awong-dev/pager/firmware/README.md

# School Pager Firmware

ESP-IDF 5.x project for the Walter device (ESP32-S3 + Sequans LTE-M modem).

**Status (8 Oct 2026): firmware v1.1.0 runs on the bench pager `sora1` (Soracom SIM).** Tag `v1.1.0`
was cut 8 Oct 2026 (the version string is `git describe`, so a tagged build reports `v1.1.0` and a
later commit `v1.1.0-N-g<sha>`); the release image is published to the OTA bucket. `rc1` runs a beta-82
build. What is measured and what is still an
estimate is tracked in `docs/HARDWARE_TESTING.md` ("Seen working on hardware" and "Not yet seen
working"). A `PENDING_HW` marker in the code means an estimate that has not been measured on a device.
See the measurement checklists and "Residual risks" section below before flashing a real device.
`docs/PROTOCOL.md` §12 has two still-open protocol decisions
(broker free-tier verification, LWT/clean-session) that aren't firmware bugs but do affect what
`net.cpp` can promise.

## Hardware

Rewired 30 Sep 2026; CardKB moved to IO5/IO4 on 3 Oct 2026; right header reworked 5 Oct 2026
(CardKB SDA/SCL IO10/IO9; wake button moved from IO1 to IO8) and again 8 Oct 2026 (button
hardware removed; LIS3DH moved to SCL IO18 / SDA IO17 / INT1 IO16). `main/pins.h` is the single
source of truth for every GPIO below;
nothing else in the firmware hardcodes a pin.

| Part | Role | Interface / power |
|---|---|---|
| Walter module (DPTechnics) | ESP32-S3-WROOM-1-N16R2 + Sequans GM02SP LTE-M modem + GNSS | — |
| Adafruit eInk Breakout Friend, panel Orient Display AES128296A00-2.9ENRS (SSD1680-compatible, 296×128; replaced the GDEY029T94-FT01 on 4 Oct 2026; partial-waveform OTP unverified, see HARDWARE_TESTING.md) | E-paper display | SPI via the GPIO matrix, 4 MHz: SCK IO2, MISO IO42, MOSI IO41, ECS IO40, D/C IO39, RST IO13, BUSY IO11; SRCS IO38 held high (SRAM unused); SDCS not wired. ENA IO12 is the Friend's regulator enable (active-high, pulled up on the Friend): low = panel unpowered. Friend VIN from the power board's always-on "3V" rail, not Walter VIN or Walter 3V3-OUT. |
| M5Stack CardKB | Keyboard | I2C_NUM_0 addr 0x5F, SDA IO10 / SCL IO9, scanned by the `kbd` task every 10 ms (see "Keyboard task" below). VCC from Walter's own switched 3V3-OUT (header pin 26, gated by IO0), so it switches with the attentive window independently of the display. |
| Adafruit LIS3DH breakout | Motion wake | I2C_NUM_1 addr 0x18 (SDO/SA0 open), SDA IO17 / SCL IO18; INT1 → IO16 (push-pull, active-high, 3.3 V, the only ext1 wake). VIN from the power board's always-on "3V" rail (not gated by any Walter GPIO), so it stays alive through every rail_off() and every light sleep/reset. |
| Push button (REMOVED 8 Oct 2026; disabled in firmware since 6 Oct, `PAGER_WAKE_BUTTON_ENABLED 0`; the shake replaces it) | — | No hardware. IO8 (header pin 23) is free. |
| Adafruit 6092 (bq25185 + TLV62569) power board + 3.7 V 2500 mAh LiPo (Adafruit 328) | Power | Board "4.5V" (SYS) → Walter VIN; board always-on "3V" buck → Friend VIN + LIS3DH VIN |

### Carrier v0.2

`hardware/carrier` replaces the breakouts. The firmware detects it at boot from the accelerometer
WHO_AM_I (0x33 breadboard, 0x11 carrier; `board` console command, NVS `board`/`kind` overrides).
Pins that differ (full design: `docs/CARRIER_V02_FIRMWARE_DESIGN.md`):

| Pin | Breadboard | Carrier v0.2 |
|---|---|---|
| IO12 | Friend ENA (display regulator) | FL_PWM (front light, high = on) |
| IO38 | Friend SRAM CS, held high | CHG_STAT1 (BQ25185, open-drain input) |
| IO42 | Friend MISO | CHG_STAT2 (input) |
| IO8 | free | EXT_LED (high = on) |
| IO4 | free | FL_BTN (active-low) |
| IO6 / IO7 | free | PIEZ_P / PIEZ_N |
| IO15 | free | VBUS_DET (high = USB present) |
| I2C | CardKB @0x5F (I2C_NUM_0), LIS3DH @0x18 (I2C_NUM_1) | adds DRV2605L @0x5A (I2C_NUM_0, gated), MAX17048 @0x36 (I2C_NUM_1); accel is a LIS2DW12 clone |
| Console | USB-Serial/JTAG | UART0 IO43/IO44 via CP2102N (see Build) |

### Walter header map

Top view, USB-C at the top, datasheet pin numbers. Left column is the display side, right column
is the input side.

```
                                        ┌─────── USB-C ───────┐
                  (unused)  RESET   1 ──┤                     ├── 28  VIN      ◄── power board SYS (4.5V) out
                  (unused)  IO44    2 ──┤                     ├── 27  GND      ◄── common ground (Friend, CardKB, LIS3DH, power board)
                  (unused)  IO43    3 ──┤                     ├── 26  3V3-OUT  ──► CardKB VCC (switched by IO0)
       CardKB supply gate  IO0     4 ──┤                     ├── 25  IO10     ◄─► CardKB SDA
                Friend ENA  IO12    5 ──┤                     ├── 24  IO9      ──► CardKB SCL
               Friend BUSY  IO11    6 ──┤                     ├── 23  IO8      (unused; button removed 8 Oct)
                Friend RST  IO13    7 ──┤        Walter       ├── 22  IO18     ──► LIS3DH SCL
               Friend SRCS  IO38    8 ──┤      (top view)     ├── 21  IO17     ◄─► LIS3DH SDA
                Friend D/C  IO39    9 ──┤                     ├── 20  IO16     ◄── LIS3DH INT1
                Friend ECS  IO40   10 ──┤                     ├── 19  IO15     (unused)
               Friend MOSI  IO41   11 ──┤                     ├── 18  IO7      (unused)
               Friend MISO  IO42   12 ──┤                     ├── 17  IO6      (unused)
                Friend SCK  IO2    13 ──┤                     ├── 16  IO5      (unused)
                  (unused)  IO1    14 ──┤                     ├── 15  IO4      (unused)
                                        └────────┤ SIM ├────────┘

   Off-board wires:  power board 3V ──► Friend VIN, LIS3DH VIN (always on)
                     all GNDs to Walter GND; no capacitors on the distribution board
```

Per-peripheral view of the same wiring:

| eInk Friend pin | Walter pin | | CardKB (Grove) | Walter pin | | LIS3DH breakout | Walter pin |
|---|---|---|---|---|---|---|---|
| VIN | power board 3V (off-board, always on) | | VCC | 26 3V3-OUT | | VIN | power board 3V (off-board, always on) |
| GND | 27 GND | | GND | 27 GND | | GND | 27 GND |
| ENA | 5 IO12 | | SDA | 25 IO10 | | SDA | 21 IO17 |
| SCK | 13 IO2 | | SCL | 24 IO9 | | SCL | 22 IO18 |
| MISO | 12 IO42 | | | | | INT1 | 20 IO16 |
| MOSI | 11 IO41 | | | | | SDO/SA0 | open (addr 0x18) |
| ECS | 10 IO40 | | | | | | |
| D/C | 9 IO39 | | | | | | |
| SRCS | 8 IO38 | | | | | | |
| SDCS | — | | | | | | |
| RST | 7 IO13 | | | | | | |
| BUSY | 6 IO11 | | | | | | |

Walter-internal, never available: IO14/IO48 (modem UART RX/TX), IO21/IO47 (RTS/CTS), IO45
(modem reset), IO46 (LTE_WAKE0), IO19/IO20 (USB), IO3 (strapping, testpoint only). IO44/IO43 are
UART0 and unused (the console is USB Serial/JTAG).

### Power domains

- **Power board always-on "3V".** The Adafruit 6092 (bq25185 + TLV62569) power board's buck
  output feeds the eInk Friend's VIN and the LIS3DH breakout's VIN directly, off-board, never
  gated by any Walter GPIO. Neither loses power across an ESP32 reset or any light sleep;
  `accel_init()` still re-programs the LIS3DH every boot (a chip-side reset, not a supply one).
  The board's "4.5V" (SYS) output feeds Walter VIN itself.
- **Walter 3V3-OUT (header pin 26, switched by IO0) and the Friend's ENA (IO12) — two gates,
  one rail.** `rail.c`'s `rail_on()`/`rail_off()` drive both together: IO0 switches the CardKB's
  VCC, ENA switches the Friend's MIC5225-3.3 regulator, which powers the panel only. Both are off
  outside the attentive window; the CardKB reboots on every rail-on (hence ui.c's boot guard) and
  the panel RAM is restored from the shadow frame by `disp_note_power_loss()`. Before dropping
  either gate the firmware drives the CardKB SDA/SCL and the display SPI pads low so the ESP32
  never back-feeds the unpowered parts.
- **USB power.** Walter ties USB-C VBUS to VIN, so VIN is 5 V on the bench (in place of the power
  board's SYS output). Nothing downstream of the Friend/LIS3DH/CardKB gates is referenced to VIN
  any more.

## Device behaviour contract

These are the project's fixed constraints. `docs/PROTOCOL.md` is authoritative for anything that
crosses the wire; this section covers the device-local behaviour the protocol doc does not specify.

- **SIM budget**: 100 MB/month data, 100 SMS/month. The pager sends SMS only through the modem path
  (`cfg.sms`, `sms.c`), which the US Mobile line did not carry (7 Oct 2026); the Soracom preset refuses
  it. Relay SMS runs through the family's bridge phone on the server, not on the pager (Twilio removed 9 Oct 2026, last at 05ec3ed). It keeps one
  persistent TLS+MQTT session and never reconnects on a timer.
- **Power**: the device sleeps most of the day. In **sleep mode** the modem uses eDRX (target
  20.48 s cycle) and the ESP32 light-sleeps; delivery within ~30 s is acceptable. In **active
  mode** the modem stays connected and messages must show within 5 s.
- **Modes**: boot in sleep mode. Enter active mode on an incoming message or a shake plus a key (the IO8 button was retired 6 Oct 2026); leave
  it after 10 minutes with no keyboard activity. The 10-minute timeout runs from mode
  *entry*, not from the last activity. The CardKB is read by the `kbd` task
  (see "Keyboard task" below), not by the main loop.
- **Display refresh**: partial refresh for the message pane. Full refreshes come from the refresh
  policy (`refreshpol.c`), not from a fixed count. Its defaults, relaxed 7 Oct 2026, are a floor of
  40 partials, an 8 s idle gap, a ceiling of 120 partials and a pre-sleep minimum of 6 (`refreshpol.h`).
- **Display orientation**: `disp_flip` (NVS, default off; console `flip on|off|status`, or the
  Device screen's "Rotate display" row)
  180-degree-rotates the whole 296x128 image at blit time, so every screen/partial/toast reads
  upside down together — not a per-screen setting.
- **Message bodies** are at most 160 characters.
- The vendored `walter-modem` component is patched only as recorded in its `PATCHES.md`. Anything the
  vendor API cannot express is either worked around in our own code or documented as a limitation.

## Carrier and bearer

The SIM picks a carrier preset (`firmware/main/carrier.c`, `carrier_effective()`), by IMSI prefix,
ICCID prefix or EF_GID1. A preset gives the APN, PDP credentials, the bearer and whether modem SMS
may be sent.

- **US Mobile Dark Star** and the other existing presets: bearer `direct`, no PDP auth.
- **Soracom** (`soracom.io`): matched by IMSI prefix `311588` or ICCID prefix `8942310`. PAP user
  `sora`, password `sora`, sent as `AT+CGAUTH=1,1,"sora","sora"` after `definePDPContext`. Bearer
  `beam`; modem SMS is refused.
- **`direct`**: TLS from the modem to the bundle's host and port, as before.
- **`beam`**: plain MQTT to `beam.soracom.io:1883`; Soracom Beam opens the TLS leg to EMQX. The
  bundle's host, port and CA URL are ignored, `/status` reports `tls: "proxy"`, and CA pushes are
  refused. See `docs/SORACOM_DESIGN.md` §3.

Verified on the bench 8 Oct 2026 on the `sora1` unit, on both bearers. Direct: PAP attach with roaming
on 310410 in about 17 s, eDRX granted, provisioning direct. Beam: plain MQTT to `beam.soracom.io:1883`,
session usable 17.4 s after boot, provisioning through Beam. Results: `docs/SORACOM_DESIGN.md` §6.

Console: `bearer [auto|direct|beam]` (NVS `carrier/bearer`) overrides the bearer for A/B tests. The
override is read at boot. `carrier` shows what was detected and what is in force. Gotchas are in
`docs/GOTCHAS.md`.

## Dependencies

- ESP-IDF 5.x
- `dptechnics/walter-modem` v1.5.0, vendored in `components/dptechnics__walter-modem/` (upstream
  commit `51b16ce`) with local patches 1.1-1.22 listed in that directory's `PATCHES.md`. Do not re-sync
  from upstream without re-reading the vendor source and re-applying the patches (each is marked
  `// PAGER PATCH:`). Two separate conclusions in `docs/PROTOCOL.md` turned out to depend on which
  version was actually checked out.
- Display driver (SSD1680): custom, in-tree (`main/ui.c`) — no external component. See
  `docs/PROTOCOL.md` §6 for why (the one registry candidate found requires a newer ESP-IDF than
  this project builds against).

## Hardware Acceptance Tests

- Sleep-mode current: PENDING_HW
- Acceptance test (message latency): PENDING_HW
- Full list of what to check on first hardware bring-up: the measurement checklists below (M1-M23)
  and the "Residual risks" section's cheapest-experiment column, roughly in priority order.

## Keyboard task (`kbd`, 9 Oct 2026)

The CardKB is scanned by a static FreeRTOS task, `kbd` (`ui.c`; priority 2, floating across both cores). It
polls every 10 ms while the keyboard rail is on and past the 1300 ms boot guard. While the rail is
off it blocks on a rail notification. The task is the only CardKB read path: `ui_poll_keyboard()`
and the refresh-time poll hook are deleted, and the main loop does not touch the CardKB. Keys go
to the input queue (`input.c`, 32 deep). A queue-full drop logs at WARN. Design and review
history: `docs/TASK_kbtask.md`. Why the main loop must not read the CardKB: `docs/GOTCHAS.md`.

- **Console:** `i2cscan` and `kbtime` pause the task and resume it after. `i2cscan swap` re-inits
  the bus only with the rail on.
- **Light sleep:** the task is parked around `esp_light_sleep_start()`, so a sleep never starts in
  the middle of an I2C read.
- **Main loop wake (10 Oct 2026):** the awake loop's 100 ms wait is `input_wait_event(100)`
  (`input.c`): a task-notification wait on the `modes_run()` task that `push_event()` signals after
  every successful enqueue, so a keystroke is seen at once; with nothing happening the period is
  still 100 ms. At the sleep edge `net_sleep()` parks `kbd`, then returns false (no sleep, no
  wake/RTS state touched; modes.c re-arms the awake window and loops) if `input_pending()`.
- **Wake status refresh (10 Oct 2026):** `ui_wake_status_refresh()` (two modem round trips) is
  deferred: the awake edge sets `s_wake_status_pending`, and `modes_run()` runs it right after that
  pass's `ui_render()`. The refreshed battery/RSSI show on the next partial.
- **Status:** built 9 Oct 2026. Burst verification is **pending** (the bench check below). On the
  bench unit sora1, the CardKB currently does not answer at 0x5F (`docs/GOTCHAS.md`), so no
  keystroke result from sora1 counts until that is fixed.

**Bench: keyboard burst test.** The owner types `abcdefgh` fast, three times in each scenario, on
each flash (the baseline, then the new build). Capture the `ui: CardKB: 0x..` DEBUG lines
(0x61-0x68):

- A. screen awake, idle chat;
- B. right after a shake, starting at the first draw (keys typed during the 1.3 s boot guard are
  lost on both builds, because the CardKB is still booting);
- C. within 2 s of sending a message.

Expected on the new build: 8 of 8 in A, B and C, and no `input event queue full` lines. The
baseline is expected to drop about the first and last keys in B and C. Also expect `kbd: task
started` at boot, `kbd: paused (rail off)` after about 120 s idle, and `kbd: boot guard` then
`kbd: polling` about 1300 ms after a shake.

## Measurement checklist: network and power (PENDING_HW unless a row says resolved)

These rows were written before any device was attached. A row marked **Resolved** has a bench result
in the handoff or the design docs. The other rows are still a number `net.cpp`/`modes.c` either
assumes or logs enough to compute, not yet measured. See `docs/PROTOCOL.md` §6.5, §8.2-§8.4 for the
arithmetic these numbers feed.

| # | What to measure | Why it matters |
|---|---|---|
| M1 | Sleep-mode average current, `T`=5s | Validates the ~1.8-2.1 mA / 43-50 mAh/day estimate (§8.4) |
| M2 | Per-wake awake time / current | Validates the ~50 ms, ~40 mA assumptions behind §8.2's `I_light(T)` model |
| M3 | End-to-end latency: `send.py` timestamp -> serial log line | Validates the 27.3 s (sleep) / 4.3 s (active) worst-case budget (§6.5) |
| M4 | Granted eDRX/PTW from `WALTER_MODEM_NETWORK_EVENT_EDRX_RECEIVED` | Assert granted eDRX == requested `"0010"` (20.48s); logged by `net.cpp`'s network event handler, and now confirmed on a real SIM and carrier. **Resolved 8 Oct 2026:** granted on AT&T 310410 (Soracom SIM on `sora1`): `+CEDRXRDP: 4,"0010","0010","0001"` (`docs/SORACOM_DESIGN.md` §6 B). |
| M5 | RTS hold-off: does the Sequans queue URCs while CTS is deasserted, or drop them? | The single riskiest assumption in the whole sleep design (§8.3); `net_sleep()`'s RTS choreography was unverified end to end. **Resolved 23-24 Sep 2026:** the modem queues URCs while CTS is deasserted and releases them only when the host speaks (23 Sep 17:50). The RTS pin was excluded from light-sleep pad isolation (`gpio_sleep_sel_dis()`, ab5927c); a `sleeptest 3` window then delivered a page 9 s after the relay stamped it, and the release build acked through sleep. See `docs/SLEEP_URC_DESIGN.md` §1 and `docs/RCA_SLEEP_URC.md`. |
| M6 | `MEMORY_FULL` event count over 24h | Direct evidence the wake-and-drain cycle is losing messages; counted in RTC (`mqtt_memfull_count`) but never exercised against real traffic |
| M7 | Does the modem send PINGREQ autonomously at the configured keepalive? | **Resolved on the wire 14-15 Oct 2026** (`PINGREQ.md`): yes, at 60-1200 s. AT&T silently drops idle flows between 240 and 360 s, so a longer keepalive's PINGREQ never arrives there |
| M8 | Clean-session behaviour across an ESP32-only reset (modem session survives?) | PROTOCOL.md §12 item 4 - the highest-value follow-up experiment; unresolved and load-bearing for whether §8.3(b) (deep sleep + forced redelivery) is ever worth revisiting |
| M16 | I²C CardKB polling (the `kbd` task in `ui.c`, which feeds `input_feed_key()`, F6.2) across repeated 100 ms light-sleep cycles | `DEVICE_PLAN.md` §10's own open assumption: whether the CardKB and its I2C bus survive `net_sleep()`'s light-sleep re-entry without a dropped or garbled byte while the composer is open. The plan's own cheapest experiment is "one afternoon with M1's current trace" |
| M17 | UI-awake window current draw (active mode, composer open, CardKB scanned every 10 ms by the `kbd` task, `PAGER_UI_AWAKE_S`=30s) | Validates `DEVICE_PLAN.md` §5.7's ≈ 7 mAh/day-at-20-interactions estimate and the "one more AT round trip per UI wake (signal + battery), ≈ 100 ms at 40 mA" it is built on |
| M18 | `bars_from_rssi_dbm()` bucket thresholds (`ui.c`: dBm ≥ -85/-95/-105/-115 → 4/3/2/1/0 bars) against a real cell | The dBm conversion itself is settled in source (F3.4: `WalterModem::getRSSI()`/AT+CSQ, `dBm = -113 + raw*2`, `raw==99` guarded off as "no reading" — `net.cpp`'s `net_get_rssi()`); the bucket boundaries chosen for the status-bar icon are engineering estimates that have never been seen against a live signal |
| M19 | `segs_from_batt_mv()` LiPo threshold calibration (`ui.c`: 4000/3850/3700/3550 mV → 4/3/2/1/0 segments) | `DEVICE_PLAN.md` §10: these thresholds were picked, not derived from a real discharge curve under the device's own load; pairs with M15's voltage-reading check |

Also unresolved and not measurable without hardware: whether the modem/broker silently clamp
a 1800s MQTT keepalive, and whether the carrier's NAT tolerates a 1800s idle TCP flow
(PROTOCOL.md §6.2). Partly measured since (`PINGREQ.md`, 15 Oct 2026): AT&T drops an idle flow
between 240 and 360 s; Soracom direct holds ≥1800 s; a 1200 s clamp through
Beam/EMQX is still open.

## Measurement checklist: display and input (PENDING_HW unless a row says resolved)

Same rule as above. The panel has been driven on the glass since 22 Sep 2026 (see
`docs/HARDWARE_TESTING.md`); the rows here are left as written.

| # | What to measure | Why it matters |
|---|---|---|
| M9 | DejaVu Sans / Noto Sans CJK SC legibility on the actual panel, at 12 px and 16 px | F6.1 replaced the earlier hand-authored 5x7 font with real pre-rasterised Noto Sans + Noto Sans CJK SC glyphs (`tools/mkassets.py`) at both sizes, packed into a 597,128-byte (583 KiB) `assets.bin` — comfortably under the 1 MiB `assets` partition (`partitions.csv`) — and already rendered to PNG on the host (`make png`) for eyeballing, but never seen on the actual e-paper panel. `DEVICE_PLAN.md` §10 flags 12 px CJK specifically as the assumption to check first ("Host-side PNG first, then M9 on glass; the fallback is 14 px for `normal`"). Separately, and not a panel-legibility question: `mkassets.py`'s own docstring notes its CJK glyph selection uses code-point order as a frequency stand-in (no offline GB2312 frequency table was available), so a few common hanzi are expected to render as tofu regardless of how legible the font itself is — don't conflate the two failure modes when reading the first photograph. **Update 2026-09-24 (TASK_ui_finish.md Do #2):** the Latin/Greek/Cyrillic face is now DejaVu Sans, not Noto Sans (`tools/fonts/dejavu/`, `build/images/assets-dejavu.bin`, 598,261 bytes) — this M9 row's own "never seen on the actual panel" caveat now applies to DejaVu specifically, not just CJK; the CJK face itself is unchanged. **Update 12 Oct 2026:** an emoji-capable asset-only variant is `build/images/assets-dejavu-emoji.bin` (DejaVu symbols + 3 aliases + Noto Emoji `tools/fonts/notoemoji/` wght 600 at 10/13 px + zero-width ZWJ/VS/skin-tone blanks; same format, works with the published app); build with `python3 tools/mkassets.py --lang sc --sans-font tools/fonts/dejavu/DejaVuSans.ttf --cjk-font ~/Library/Fonts/NotoSansCJK.ttc --emoji-font tools/fonts/notoemoji/NotoEmoji-wght.ttf --emoji-axes "wght=600" --emoji-px "12=10,16=13" --baseline "12=13,16=18" -o build/images/assets-dejavu-emoji.bin`, test sheet via `make emoji_png ASSETS=<image>` (not yet seen on the panel). |
| M10 | SSD1680 `0x22` display-update-control-2 values (`0xF7` full, `0xFF` partial) | Carried forward from PROTOCOL.md §6 as "inferred, not verified from the datasheet PDF" — this firmware transcribes them unchanged and adds no independent verification. |
| M11 | BUSY pin polarity (assumed active-high) | `ui.c`'s `disp_wait_busy()` assumes BUSY=1 means busy, a common but unconfirmed SSD1680 breakout convention for this exact panel. If wrong, every refresh will either return immediately (garbage on screen) or hit the 15s timeout and mark the display dead every boot. |
| M12 | SSD1680 partial-refresh RAM continuity across a VCC_EN power cycle | `ui.c` deliberately keeps `PAGER_PIN_DISP_VCC_EN` enabled continuously after `ui_init()` rather than gating it off between every refresh (PROTOCOL.md §8.4's "~0 mA between refreshes" assumption), because power-cycling the panel would very likely wipe the controller's internal old/new RAM planes that partial refresh diffs against — this could not be confirmed against a datasheet. The real display-domain current is therefore higher than §8.4's "~0 mA" figure by an unquantified amount until this is measured. |
| M13 | CardKB byte stream during real typing, including arrow keys and a held key | Confirms `input_decode_key()`'s table (F6.2, exhaustively host-tested over 0x00-0xFF in `firmware/host/test_input.c` but never against real hardware): `0x00`=no key, `0x20`-`0x7E`=printable, `0x08`=backspace, `0x09`=tab, `0x0D`=enter, `0x1B`=esc, and — the two `DEVICE_PLAN.md` §10 rows this line exists to settle — arrow codes `0xB4`/`0xB5`/`0xB6`/`0xB7`=left/up/down/right, and whether the CardKB holds the last key until read (the "key held until read" assumption that would enable key-to-wake; `input.h`'s `input_feed_key()` entry point for this is written but not yet called from anywhere, pending this measurement). Also separately confirms PROTOCOL.md §9.4's own open assumption that the CardKB never emits multi-byte sequences. |
| M14 | Partial-refresh timing per the 20-partial/1-full cadence | Confirms the 20-partial cadence (see "Device behaviour contract" above) doesn't visibly ghost/degrade the panel before the scheduled full refresh, and feeds PROTOCOL.md §6.5's M7 (partial refresh must complete in <1.5s). |
| M15 | `getVoltage()`/`AT+SQNVMON` reading vs. a multimeter across the actual battery | PROTOCOL.md §12 item 6: `net_get_battery_mv()` now publishes a real reading in `/status`'s `batt_mv`, inferred from Walter's public schematics to track `VBAT` rather than a fixed regulated rail, but never confirmed against real hardware. 5-minute check on first bring-up. |
| M20 | Typing ~50 mixed characters on the CardKB, timed against a stopwatch | `DEVICE_PLAN.md` §10: is this acceptable to a non-developer? First bring-up check; if not, revisit the input design (the Wi-Fi portal fallback is withdrawn; Wi-Fi removed, owner 16 Oct 2026). |

## Measurement checklist: firmware timing and storage (PENDING_HW unless a row says resolved)

Same rule as above. None of these three has a recorded bench result (the M21 figure is host-CPU only).
They come from `DEVICE_PLAN.md` §10 rows
that explicitly call for a device-side timing measurement (as opposed to the CPU-speed/host-only
numbers already available, cited below for comparison).

| # | What to measure | Why it matters |
|---|---|---|
| M21 | PBKDF2-HMAC-SHA256 timing on the actual ESP32-S3, 10 000 iterations (`lock.c`'s `lock_pbkdf2()`, via `mbedtls_pkcs5_pbkdf2_hmac_ext`) | `DEVICE_PLAN.md` §10 estimates ≈ 50-100 ms on the S3. The only number measured so far is **20.5 ms for 10 000 iterations on the host CPU** (F6.5, `firmware/host/test_lock.c`'s `test_pbkdf2_round_trip_and_timing()`, printed as `PBKDF2 (10000 iterations, host CPU): %.1f ms`) — this is explicitly a host-CPU number, not the S3's (no hardware crypto acceleration assumed, different core), and must not be read as an on-device result. Adjust the iteration count to land near 100 ms once the real number is in, per §10's own instruction. |
| M22 | NVS blob write time for a 320-byte blob (`msg.c`'s `msgq` namespace, full-fidelity reply/unread bodies moved off RTC in F6.4) | `DEVICE_PLAN.md` §10: must complete well under the 100 ms composer poll and never block the modem event task (it runs on the main task either way, so a slow write is a composer-lag bug, not a crash). No host-side substitute exists — NVS write timing is real-flash-dependent. |
| M23 | `esp_partition_mmap()` boot-time cost for the `assets` partition (`gfx.c`'s `gfx_init()`) | Static facts are already known and require no hardware: the partition is 1 MiB (`partitions.csv`, `0x100000`) and the real payload is 597,128 bytes (583 KiB, F6.1's `assets.bin`), so there is no size-fit risk. `gfx.c`'s own comment claims the mmap "draws no additional current and reads nothing until a glyph is blitted" — that is a design argument, not a measurement. What is still unmeasured: the actual wall-clock cost of the `esp_partition_mmap()` call itself at boot, and whether mapping ~583 KiB of flash consumes MMU page-table capacity the app's own IROM/DROM mappings need (two 2 MiB OTA slots already share that budget). |

## Build

Set up ESP-IDF, then:

```bash
idf.py build
```

Two images exist because the ESP-IDF REPL is bound to one console device at compile time
(`esp_console_new_repl_usb_serial_jtag` needs `CONFIG_ESP_CONSOLE_USB_SERIAL_JTAG`,
`esp_console_new_repl_uart` needs `CONFIG_ESP_CONSOLE_UART_DEFAULT`). The breadboard build above
uses the Walter's USB-JTAG port; the carrier v0.2 build uses UART0 (the carrier's CP2102N):

```bash
idf.py -B build-carrier -DSDKCONFIG=build-carrier/sdkconfig -DSDKCONFIG_DEFAULTS="sdkconfig.defaults;sdkconfig.carrier" build
```

`-DSDKCONFIG=build-carrier/sdkconfig` keeps the carrier's generated config out of the shared
`firmware/sdkconfig`; without it the carrier build silently reuses the breadboard config and the
UART0 console is not applied.

The board (breadboard vs carrier) is chosen at runtime, not by the image (`board` console command).

## Residual risks

A design review against `net.cpp` / `modes.c` / `msg.c` / `ui.c` as committed.
Build verified clean on `espressif/idf:release-v5.2` (`idf.py set-target esp32s3 && idf.py build`,
exit 0, only the vendor's own Kconfig style warning). `sizeof(pager_rtc_t)` = **928 B** from
`build/school_pager.map` (`.rtc.data.0` under `libmain.a`), inside the 1184 B ceiling of
PROTOCOL.md §9.1; the `_Static_assert` at `modes.c:138` is present and passing. `T` = 5 s sleep /
2 s active (`modes.c:45-46`), post-wake yield 50 ms ≥ the 30 ms floor (`modes.c:47`), keepalive
1800 s, eDRX `"0010"`/`"0001"`, PSM disabled, cert slot 12 / TLS profile 2 — all match the doc.

**This list was written against source before any hardware was attached.** It is reasoning, not
measurement, and it is not updated item by item. Check `.overnight-handoff.md` and
`docs/HARDWARE_TESTING.md` before acting on one. Ranked by risk to battery life and message latency, as written.

### Already fixed (both rebuilt clean)
- `net.cpp` + `net.h` + `modes.c`: `net_modem_busy()` interlock. `_eventProcessingTask` is
  priority 4 and `modes_run()` is priority 1, so every time the MQTT event handler blocks
  (`mqttReceive()`'s AT round trip, `ui.c`'s 10 ms `disp_wait_busy()` poll) `modes_run()` is
  scheduled and could call `esp_light_sleep_start()` — forcing RTS high *mid-response* instead of
  at an idle moment. That turns M5 ("does the Sequans queue or drop when CTS is deasserted") from
  a latency question into a message-loss one, on essentially every inbound message. `skip_sleep`
  now includes `net_modem_busy()`. Cost ≈ 0.02 mAh per message of 40 mA busy-polling (estimate).
- `modes.c:345-356` `on_incoming_message()`: copy `out->id` before rendering. `out` points into
  `msg.c`'s `s_thread`, which `thread_insert_locked()` memmoves; a reply submitted from the main
  task during the render would have made the `shown` ack carry the reply's `u_...` id.

### R1 — F4 hard-resets the modem on loss of *coverage*, not just on a wedged modem (battery, data, latency)
`net_check()` (`net.cpp:484-493`) returns false both when `checkComm()` fails **and** when the
registration state is not HOME/ROAMING. `run_modem_health_check()` (`modes.c:444-474`) treats that
as "modem unresponsive" and calls `net_recover_modem()` → `WalterModem::reset()` → full re-attach
→ new ~5 kB TLS handshake. A student indoors in a dead zone therefore gets a modem hard reset
every 10 minutes (the rate limit), each one destroying the persistent session the SIM budget
requires us to protect. Spec for the fix: `net_check()` should report *comm* only; add a separate
`net_is_registered()`; F4 resets only on `checkComm()` failure, and a registration loss is simply
waited out (the modem re-attaches on its own) with a counter in `/status`. Cheapest check: no
hardware needed — put the device in a Faraday bag / pull the antenna and watch for `modem_resets`
climbing in the serial log.

### R2 — a held or stuck button busy-polls at full power indefinitely (battery)

**Moot as of 8 Oct 2026:** the button hardware was removed, and `PAGER_WAKE_BUTTON_ENABLED` has been 0 since 6 Oct 2026, so the button cannot be held. Kept for the record.

`BTN_HELD` (`modes.c:585-589`) only exits when the button is released, and `modes_run()`'s
`skip_sleep` keeps `net_sleep()` out for as long as the FSM is not IDLE (`modes.c:704`). There is
no tickless idle in `sdkconfig.defaults`, so that is ~40 mA continuously: a button wedged in a
backpack flattens a 1500 mAh cell in roughly 1.5 days. (A worse version of this — a
level-triggered ext1 wake spinning `esp_light_sleep_start()` — is already fixed; the held-button
case is still a full-power loop.) It also makes the F4 health check fire every ~1.2 s instead of every
5 min, because that check counts wake cycles, not time (`modes.c:771-774`). Fix spec: add a
`BTN_STUCK` state entered after ~5 s in `BTN_HELD`, and a `net_sleep()` variant that arms the
button's ext1 wake on the release level (low, since the 3 Oct 2026 rewiring made the button
active-high) so the device can light-sleep while the button is down.
Cheapest check: tape the button down and watch the serial log's wake-cycle counter rate.

### R3 — display VCC is never gated off, and the panel is never put to sleep (battery)
`ui_shutdown()` (`ui.c:573`) is the only caller of `disp_power_off()` and **has no call site
anywhere in the firmware** — so the panel's VCC gate (now the eInk Friend's ENA on IO12; IO15 at the time) is driven on at `ui_init()` and stays on forever, and the
SSD1680 never receives its `0x10` deep-sleep command in normal operation. `ui.c:228-235`'s own
comment claims the rail is "gated off between refreshes", and PROTOCOL.md §8.4 budgets the display
at "~0 mA" on that basis. M12 already records the deliberate reason (a VCC cycle would wipe the
controller RAM planes that partial refresh diffs against), so this is a known trade, not a
surprise — but the size of the penalty is still unknown and it sits directly on the 1.8-2.1 mA
budget. Mitigating evidence: both `0x22` update sequences (`0xF7` full, `0xFF` partial) have the
disable-analog/disable-clock bits set, so the booster and oscillator should stop after each
refresh, leaving only standby leakage. Cheapest check: M1's current trace with the panel attached
vs. detached — one measurement answers it. If it is material, the fix is to issue `0x10`/`0x01`
(deep sleep mode 1) after each refresh and hardware-reset + re-init before the next, keeping VCC
on; only re-verify that the RAM planes survive it.

### R4 — `ui.c` has no cross-task mutual exclusion (crash / corrupt display)
`ui_render_thread()` / `ui_render_message_pane()` / `ui_show_toast()` run on **two** tasks:
`_eventProcessingTask` via `on_incoming_message()` (`modes.c:363`) and `modes_run()`'s task via the
button FSM, composer and toasts. They share `s_fb_new`/`s_fb_old`/`s_partial_count` and one
`spi_device_handle_t` with no lock (`ui.c:48-55`). A render is preemptible at every
`disp_wait_busy()` `vTaskDelay`, so two renders can interleave their SSD1680 command streams. The
likely trigger is exactly the common case: a message arrives while the student is pressing the
button. Expect a garbled panel or an SPI driver abort. Fix spec: one static mutex in `ui.c` taken
by every public entry point (never held across a call back into `msg.c`/`modes.c`).

### R5 — a message render occupies the modem's event task for 0.3-1.5 s, or up to 30 s if BUSY hangs (latency, message loss)
`on_incoming_message()` runs on `_eventProcessingTask` and synchronously does a full e-paper
refresh (`modes.c:363` → `ui.c:591`). While it runs, no other MQTT event is dispatched:
`_DISCONNECTED` edges are delayed, and further `_MESSAGE` events queue in the modem — which is
what `MEMORY_FULL` (M6) reports. Worst case, with a mis-wired BUSY pin (M11), each refresh path
burns two 15 s timeouts plus a re-init before `mark_display_dead()` latches, i.e. ~30 s of dead
event task for the first message. Fix spec: hand the render to `modes_run()` via a flag
(`s_render_pending`), leave the event handler doing ingest + dedup only, and move the
`msg_mark_shown()` call to after the render on the main task — which also preserves §4's
"ack only after BUSY deasserts". Cheapest check: log `esp_timer` deltas around
`ui_render_message_pane()` and around the handler; M7/M14 collect the same numbers.

### R6 — `msg_thread_at()` / `msg_newest_unread()` return unlocked pointers into a ring that moves (wrong-id ack, garbled render)
`msg.c:635-652` are the only accessors that do **not** take the lock that `msg.h`'s header comment
says guards `s_thread`, and they hand out raw `msg_t*`. `ui.c`'s `render_thread_frame()`
(`ui.c:440-466`) dereferences them across a multi-hundred-millisecond render, and
`button_action_short()` (`modes.c:531`) copies an id out of one, while the event task can memmove
the whole ring under both. Worst outcome is a `read` ack for the wrong id; most likely outcome is
one garbled line on screen. Fix spec: take the lock inside those accessors and return a
caller-supplied *copy*, not a pointer.

### R7 — `shown` is acked even when nothing was shown (false delivery reporting)
If `ui_init()` failed or a BUSY timeout latched `s_display_dead`, `ui_render_message_pane()`
returns immediately (`ui.c:593-595`) and `modes.c` still calls `msg_mark_shown()`. The parent is
then told the student saw a message that was never rendered — PROTOCOL.md §4 defines `shown` as
"after the e-paper refresh completes (BUSY deasserted), never before". Running headless is
correct; lying about `shown` is not. Options, none free: suppress the `shown` ack
while headless (the relay then re-publishes forever), or add a `disp` field to `/status` (a schema
change, so it needs an owner). Decide before a parent relies on the delivered state.

### R8 — retained `/status` is **not settable** from `walter-modem` v1.5.0 (parent-visible staleness)
`WalterModem::mqttPublish()` emits `AT+SQNSMQTTPUBLISH=0,<topic>,<qos>,<len>`
(`src/proto/WalterMQTT.cpp:97-103`) — there is no retain argument anywhere in the public API.
PROTOCOL.md §2 and §5 mark `/status` **retained = true (fixed)**, and §5.3 keys the relay's
behaviour on "a retained `offline`". §12 item 3 currently lists only LWT and clean session as
unreachable; **retain is a third one and should be added to it.** Consequence today: after a relay
restart the parent UI has no device state until the next event-driven publish or the ≤3600 s
heartbeat (§5.4d) — and the heartbeat is suppressed entirely while the device has no network clock
(`modes.c:253-256`), which is also the case where the device is least healthy. Cheapest check:
30 minutes with the Sequans AT manual, same session as §12 item 3's raw-`AT+SQNSMQTTCFG`
experiment for the LWT; if the AT command has a retain field, both are fixable via `sendCmd()`.

### R9 — a full refresh can land inside the message-delivery path (latency)
`set_mode()` → `ui_render_thread()` → `refresh_cadence()` (`ui.c:402-409`) does a **full** refresh
every 20th partial, and the sleep→active edge caused by an incoming message goes through exactly
that path (`modes.c:357`). PROTOCOL.md §6.5 budgets 0.5-1.5 s for the refresh against 2.7 s of
total margin; a 296x128 SSD1680 full refresh is typically 2-4 s at room temperature and colder at
a bus stop in winter. Sleep-mode worst case then lands at ~30-32 s, i.e. outside target. Also note
`ui_render_message_pane()` calls `partial_refresh()` directly and bypasses the cadence check, so
the full refresh tends to fire from whichever path happens to be a message. M7/M14 measure the two
refresh times; if the full refresh exceeds ~1.5 s, defer it (e.g. run it on the active→sleep
transition, never on the inbound path).

### R10 — `msg_pump()` can drop a `read` ack it raced with, and "published" is not "PUBACK'd" (ack loss)
`msg_pump()` (`msg.c:549-576`) drops the lock across `publish_ack()` and then clears `a->in_use`.
If `msg_mark_read()` upserted the same slot during that window (student presses the button while
the `shown` ack is in flight), the upgrade to `read` is silently discarded and the thread stays at
`shown` forever. Separately, and already documented at `msg.c:538-545`: `net_publish()` returning
true means the library accepted the call, not that a PUBACK arrived, so §4.1 rule 6's
"3 attempts then drop" retry counts attempts that may never have reached the broker. Fix spec for
the first: re-read the slot's `state` after re-acquiring the lock and only clear `in_use` if it
still matches what was published.

### R11 — ext1 pull-down across light sleep is unverified (battery, phantom presses)
The button pull-down is configured digitally (`input_init()`, `input.c`) but ext1 wake keeps
the RTC peripheral domain powered and reads the pad through RTC IO, whose own pull settings
default to off. If the digital pull-down is not in force during light sleep and there is no
external pull-down on IO8, the pin floats and the device wakes constantly (battery) with phantom
short presses (UX). I am not certain either way for light sleep on the ESP32-S3 and will not guess.
Cheapest check: log `esp_sleep_get_wakeup_cause()` after every `net_sleep()` and count non-timer
wakes over an idle hour; if it is real, the fix is one `rtc_gpio_pullup_en()` call, no GPIO change.

### R12 — the RX path mallocs (message loss under fragmentation)
`msg_ingest_down()` parses with cJSON (`msg.c:231`) on the event task. PROTOCOL.md §3.3's stated
reason for the 640-byte cap is that "the device never mallocs on the RX path"; it does. Low
probability on a 512 kB part, but the failure mode is silent (parse fails → counted as malformed →
message never acked, never rendered). Cheapest check: log the heap low-water mark in the `/status`
heartbeat and watch it over a 24 h soak.

### R13 — a boot that fails to attach has no retry path of its own (battery, availability)
`modes_boot()` increments `g_rtc.attach_fail_cycles` on a failed `net_init()` (`modes.c:638`) and
**nothing ever reads it again**; `modes_run()` only ever retries `net_session_up()`. A device
powered on out of coverage recovers only via R1's modem-reset path — the most expensive action in
the design — and only in sleep mode. Fix spec: retry `net_init()` on the F1 backoff schedule
before ever escalating to a reset, and delete or use the dead counter.

### R14 — `net_init()` / `net_recover_modem()` block the whole loop for up to 300 s (availability)
The attach wait (`net.cpp:350-362`) is a 300 s `vTaskDelay` loop on the caller's task. Called from
`run_modem_health_check()` it stalls `modes_run()`: no button FSM, no composer polling, no
`msg_pump()`, no light sleep for up to five minutes. The student sees a dead pager and 40 mA.
Cheapest check: falls out of R1's Faraday-bag test.

### R15 — F4 never runs in active mode, and counts cycles rather than time
`modes.c:771-774` gates the health check on `mode == SLEEP`, so a modem that wedges during an
active window is not noticed for up to 10 minutes, and the "every 60 wakes" period varies from
5 min (sleep) to 2 min (active) to ~1.2 s (R2's stuck button). Prefer a monotonic timestamp.
Low impact on its own; listed because it interacts with R1 and R2.

### `NEEDS HUMAN DECISION` items, current as of the last commit
- **§12 item 3 (LWT + clean session + retained `/status` not settable): still open.** Nothing
  worked around any of the three; `net.cpp` registers no will and passes no session flag, because
  the API has neither. All three would be settled (or not) by the same look at the Sequans AT
  manual plus the `sendCmd()` fallback PROTOCOL.md §12 already proposes.
- **§12 item 6 (battery voltage): resolved, one experiment remains.** `net.cpp` now reads the
  modem's own `AT+SQNVMON` supply-rail voltage via `WalterModem::getVoltage()` and reports it as
  `batt_mv` (`modes.c`'s `build_status_json()`), with a last-known-good fallback so a failed AT
  round trip never blocks a `/status` publish. This needed no GPIO change — see PROTOCOL.md §12
  item 6 for the schematic-based reasoning that this rail tracks the battery, not a fixed 3.3V
  rail. **Still open**: that reasoning is inference from Walter's public schematics, not a
  confirmed fact about Walter's own unpublished internal routing — compare `getVoltage()`'s reading
  against a multimeter on first hardware bring-up (5 min, M15 in the checklist above).
- **§12 item 2 (broker free-tier limits): overtaken by production, not re-checked.** Production runs on
  EMQX Cloud Serverless (`infra/README.md` §10), and the firmware keepalive is 480 s, 1200 s on the
  Soracom preset (`carrier.c`, PROTOCOL.md §6.2). Whether the free tier gives QoS 1 both ways, a retained topic and a
  persistent session is not recorded in the sources; confirm before relying on it.
