awong-dev/pager/docs/V02_DESIGN.md

# v0.2: modem library, replay counter, CA trust, location, device SMS

The specification of what v0.2 added, cited by section number from the code. For the big picture
read `OVERVIEW.md`; for what has been seen working on hardware, `HARDWARE_TESTING.md`; for what is
missing, `ROADMAP.md`. Where this differs from `PROTOCOL.md` or `DEVICE_PLAN.md` it records an
owner decision, and those documents have been edited to match.

Conventions: `UNVERIFIED` means "could not be tested on hardware while writing this; the code must
fail safe and log clearly". Hardware facts are for the Sequans GM02SP `LR8.2.1.0-61488`.

## 0. Ground rules

- Nothing here may break the receive path: attach → TLS → MQTT → verify → render →
  ack. Every new feature fails *open* for paging: if location, SMS or a CA push goes wrong, pages
  still arrive.
- The relay must keep accepting a v0.1 pager (no new field is required from the device; unknown
  `/status` fields from a newer device must not make an older relay reject the envelope, so **add
  the relay's acceptance of new fields before any firmware that sends them is flashed**).
- All new device→relay and relay→device messages are signed like every other envelope.
- New CBOR keys are allocated in §7 and nowhere else.

## 1. Vendored modem library

`dptechnics/walter-modem` v1.5.0 moves from the component manager (`managed_components/`,
git-ignored, hash-checked, cannot be patched) to a tracked local component,
`firmware/components/dptechnics__walter-modem/` (`src/`, `CMakeLists.txt`, `Kconfig`, `LICENSE`,
`README.md`, `CHANGELOG.md`; **no `examples/`**). The DPTechnics 5-clause licence permits
modified source redistribution with the notice retained and use restricted to Walter boards; keep
`LICENSE` and every file header. Remove the dependency from `main/idf_component.yml`, add the
component to `main`'s `REQUIRES`, delete `dependencies.lock` entries for it. Add
`firmware/components/dptechnics__walter-modem/PATCHES.md` listing every local change, each marked
with a `// PAGER PATCH:` comment in the source, so a future upstream update can re-apply them.

Patches:

1. **NULL command crash.** In `_processModemRSP()` after `after_processing_logic:`, never call
   `_finishModemCMD(NULL, ...)`. With no command pending, free the buffer and return.
2. **Receive bounds.** Wherever a response is copied into `cmd->payload`
   (`memcpy(cmd->payload, rspStr, cmd->payloadSize)` and siblings), copy at most the bytes
   actually present in the `WalterModemBuffer` and never more than `payloadSize`. `mqttReceive()`
   and `socketReceive` must not claim more than was delivered. If a payload larger than one
   buffer cannot be reassembled, fail the command cleanly.
3. **TLS profile range.** Kconfig `WALTER_MODEM_MAX_TLS_PROFILES`: allow up to 6 (the modem's real
   limit, `spId` 1-6). Profile 1 stays BlueCherry's, 2 is MQTT, **3 is the CA fetch** (§4.4).
4. **SMS** (§6): `smsSend()`, an SMS event handler for `+CMTI`, `smsRead()`, `smsDelete()`.

## 2. Firmware bug fixes

1. **Render queue.** `s_render_pending` (`modes.c`) is a single slot; a burst overwrites it and the
   earlier messages are never marked `shown`. After a successful `ui_incoming()` render, mark
   **every** `MSG_ACK_UNSHOWN` down message `shown` (`msg_mark_all_unshown()` already exists for
   the unlock path). The pending-ack queue is 8 deep (`MSG_PENDING_ACKS_MAX`); acks that do not
   fit must be retried on later cycles, not lost: keep marking until none are `UNSHOWN`.
2. **Epoch copy.** `ident_store()` must update the in-memory `s_ident` on success, so
   `ident_get_n_epoch()` is current immediately after a bump.
3. **Connect watchdog.** A connect that produces neither CONNECTED nor DISCONNECTED within 60 s:
   `mqttDisconnect()`, count it, back off as a transient failure. Three in a row:
   `net_recover_modem()`. This engine can wedge silently.
4. **Empty CA slot.** `UNVERIFIED` whether the MQTT engine does TLS when the named slot is empty.
   Make it not matter: when no CA is pinned, make sure slot 12 holds *a* certificate. Embed ISRG
   Root X2 (790 bytes PEM, public, EC, long-lived) in the firmware as a placeholder; on
   `net_init()` and in the bootstrap path, if nothing has been written this power session and the
   slot is not known to hold a cert, write the placeholder. It is never validated against
   (validation is off in that mode). One NVRAM write per device lifetime in practice: remember in
   NVS (`ident` namespace, key `slot12`) that the slot is populated.
5. **Oversize receive.** With patch 1.2, a `/down` or boot message larger than the library can
   deliver is logged at INFO with its size and counted as oversize; it must not corrupt memory.
6. **Log what is dropped.** "malformed down message dropped" becomes INFO (it was DEBUG and cost
   an evening). Include the length and first byte.
7. Keep `nettest`, `mqtttest`, the setup-stage logging and `PAGER_DEBUG_NO_LIGHT_SLEEP`. Add, in
   that debug build only, the console REPL in **normal** mode too (its own task, 16 kB stack), so
   diagnostics can run on a provisioned pager without erasing its identity. New debug commands:
   `gnsstest <seconds>`, `cafetch <url> <sha256hex>`, `smstest <number> <text>`.

## 3. Replay counter: keep it, widen the epoch (owner question, decided)

Question from the owner: is the counter needed at all, given TLS, and given that 4096 cold boots
is a realistic lifetime with a flaky battery?

- TLS covers only pager↔broker, and only when the server is authenticated. §4 makes that
  authentication optional and adds a deliberate fallback to *no* validation, so TLS cannot be the
  replay defence. The HMAC exists because the broker is a third party and the webhook is a shared
  secret; the counter is what stops that same party (or an on-path attacker during a fallback)
  replaying an old signed "come to the office now" page. The relay dedups `/up` by message id for
  ever, so `/up` replays are already harmless; the exposure is `/down`, where the pager's dedup
  ring is 16 ids in RTC memory and is lost on a cold boot.
- So the counter stays, but its failure mode must not be "pager silently dead". The 12-bit epoch
  was exactly that: guaranteed exhaustion.

**Change:** `n = (epoch << 20) | lo` stays, `lo` stays 20 bits, **`epoch` becomes 32 bits** and `n`
becomes a 52-bit unsigned integer (< 2^53, exact in JSON and in a Firestore int64). 4 billion cold
boots. CBOR encodes it at minimal length, so nothing grows until the epoch passes 4095.

- Firmware: `n` is `uint64_t` end to end on the up path (`auth_next_up_n`, signing, CBOR writer).
  `ident_t.n_epoch` becomes `uint32_t`; NVS key `n_epoch` (u16) is read for migration, the value
  is then kept in a new key `n_epoch32` (u32). On a wrap of `lo`, or on a cold boot, bump and
  persist (already implemented for u16). The down path may stay `uint32_t` internally (the relay's
  `downN` counts by one) but must *parse* a uint64 without rejecting it.
- Relay: `wire.py` accepts `0 <= n < 2**53`; the window code already uses Python ints; Firestore
  `upN` is an int64. `tools/authvectors.json` gains vectors with `n` above 2^32, and
  `pager_client.py` and the firmware host test consume them.
- `PROTOCOL.md` §3.1 (`n` row) and §14 (counter text) and `DEVICE_PLAN.md` §2.5 edited to match.
- Still parked: the signed resync handshake (`DEVICE_PLAN.md` §2.5 note). With a 32-bit epoch it
  is only needed if NVS itself is lost, and then the identity is gone too.

## 4. CA trust

### 4.1 Trust states (firmware)

`unpinned` (no CA in the identity; validation off) · `pinned` (CA set, last connect validated) ·
`broken` (CA set, validation failed, running with validation off). `broken` is one byte in NVS
(`ident` namespace, key `tls_broken`), cleared only by a connect that validates.

### 4.2 Fallback

On `NET_MQTT_RC_TLS_FAIL` while `pinned`: one more validated attempt, then reconfigure profile 2
with validation **off, slot 12 still named**, enter `broken`, connect. While `broken`, the first
connect after each 24 h boundary (and the first after a cold boot) is attempted validated; success
returns to `pinned`. `-8` also fires for non-certificate handshake failures, so the UI text is
"server not verified", never "attack".

### 4.3 Reporting

- `/status` gains optional `tls` (`unpinned`/`pinned`/`broken`) and `ca_fp` (first 16 hex chars of
  the SHA-256 of the pinned CA PEM, absent when unpinned).
- Pager status bar: a padlock icon when `pinned`, a **broken padlock** when `broken`, nothing when
  `unpinned`. Two new 12×12 icons in `gfx` (follow the existing icon mechanism in `gfx.h`).
- Relay: persist both on `devices/{id}`; log `SECURITY tls-broken device=…` on the transition into
  `broken`. Web: a chip per device on *Admin → Devices* (pinned / not verified / unpinned, plus
  `ca_fp`), tolerant of the fields being absent.

### 4.4 CA delivery: a pointer, fetched and hash-checked

The CA never travels inline again (a Let's Encrypt or Google root does not fit the modem
library's 1540-byte buffer; see `GOTCHAS.md`).

- **Relay** serves `GET /ca/{sha256hex}.pem`, public, no auth, `text/plain`, immutable cache
  headers, 404 unless the hash is one it knows. It knows the CA from `BROKER_CA_PEM`, else from
  `ca_resolve.get_broker_ca_pem()` (wire that resolver in at last), and keeps every CA it has
  ever served in Firestore `cas/{sha256hex}` so an old pointer keeps resolving. The public base
  URL comes from a new setting `PUBLIC_BASE_URL` (Terraform: the Cloud Run service URL).
- **Bootstrap bundle** carries `ca_url` + `ca_sha` instead of `ca` (both absent = unpinned). The
  firmware still accepts an inline `ca` (a v0.1-era bundle), preferring the pointer.
- **Push:** `/down` `kind:"cfg"` with `cfg.ca = {url, sha}`; `url` = `""` means un-pin. Admin-only
  `POST /api/admin/devices/{id}/ca` with body `{"action": "push"|"unpin"}`; like `cfg.lock`, only
  the newest unacked cfg is re-published.
- **Fetch (firmware, `cafetch.c`)**: a TLS socket on **TLS profile 3** (validation off, slot 12
  named), `GET <path> HTTP/1.1` with `Host` and `Connection: close`, read in ≤1500-byte chunks,
  follow no redirects, cap the body at 4096 bytes, require status 200, verify SHA-256 with
  mbedtls, require the body to contain exactly one PEM certificate. Trust comes from the hash,
  which arrived signed (or inside the encrypted bundle), so the transport needs no authentication.
  `UNVERIFIED`: a second socket while the MQTT session is up.
- **Apply, two-phase**: write the new CA to **slot 13**, disconnect, point profile 2 at slot 13
  with validation on, connect. CONNECTED within the watchdog → commit (`ident_store` the PEM and
  hash, copy to slot 12, state `pinned`, ack the cfg `shown`). Anything else → restore the
  previous profile and state, reconnect, **do not ack** (the relay re-publishes on the next online
  edge; after 3 failed applies of the same `sha` the pager acks it anyway and logs, so a bad CA
  cannot loop for ever). Un-pin: clear the identity's CA, validation off, state `unpinned`, ack.
- Setup uses the same fetch, over the bootstrap attach, before the identity is stored. A fetch
  failure during setup fails setup with "cannot reach broker" (never silently unpinned).

## 5. Location

Request-driven, short, always backed off. Owner guidance: the pager spends many hours a day inside
a building with no sky; even one attempt an hour is wasted there without evidence of movement; a
failed or wrong fix is an acceptable answer; battery matters more.

- **Dispatch**: `kind:"loc_req"` intercepted in `on_incoming_message()` after signature
  verification, before `msg_ingest_down_cbor()`; answered regardless of lock state; never a thread
  entry; never `shown`/`read`-acked. Works identically in sleep and active mode (it is just a
  `/down` message; do not switch the mode to active for it and do not wake the display).
- **Answer on `/loc`** exactly per `PROTOCOL.md` §13.2, signed, QoS 1, id `l_` + 8 hex.
- **Attempt budget**: `LOC_ATTEMPT_S = 20` normally; `LOC_FIRST_ATTEMPT_S = 40` for the first
  attempt after a cold boot or after assistance data was refreshed (no ephemeris in the receiver
  yet). Never longer. One attempt in flight; requests arriving meanwhile share its result.
- **Backoff**: after a failed attempt no new attempt is allowed for `backoff`: **5 min, doubling,
  capped at 12 h** (5, 10, 20, 40, 80, 160, 320, 640, 720 min). Reset to zero by a successful
  fix. A request inside the backoff is answered at once, without powering GNSS: the last fix with
  `cached:true` if one exists from this power session, else `loc:null, err:"no_fix"`. Worst case
  for a pager left in a drawer: about nine attempts on day one, then two a day, 20 s each.
- **Triggers that reset the backoff** (they never start an attempt by themselves):
  1. *Tracking-area or cell change* reported in `+CEREG` (the library's network event). Debounce:
     ignore changes within 10 min of the last one, because a stationary indoor modem flaps
     between cells.
  2. *Sustained motion* from the LIS3DH (I2C 0x18, INT1 on IO2): motion interrupts spanning at
     least 60 s within a 3 min window. Probe the chip at boot; if it is absent (it may not be
     wired yet) log once and run without it. Configure its low-power 10 Hz mode with the
     interrupt on a high-pass threshold; the ESP32 wakes on IO2 via `ext1` alongside the button's
     `ext0`.
  3. *Charger/USB power present*, if detectable: skip.
  A reset puts the backoff at zero but leaves a **floor of 10 min since the last attempt**, so a
  child walking between classrooms all day cannot turn every request into an attempt.
- **Battery floor**: below 3.55 V (LiPo, `batt_mv`), never power GNSS; answer cached/`no_fix`.
- **Route to the radio: in place only** (owner decision, 26 Sep 2026,
  `LOCATION_TRACKING_DESIGN.md`): ask for a fix while attached, in the eDRX idle gap, through the
  library `gnss*` API. **Any failure** — `LTE_CONCURRENCY` refusal, timeout, no fix, confidence
  > 100, failed assistance refresh — ends the attempt and produces a cell answer
  (`loc:null, err:"no_fix", cell`); there is no second route and no retry. The `CFUN=4` window
  (route 2) is removed: it left the pager unreachable ~2.5 min per fix. A PSM window stays rejected
  (`LOCATION_TRACKING_DESIGN.md` §8).
- **Assistance (mandatory)**: before any attempt, if the last refresh is ≥ 2 h old or
  `gnssGetAssistanceStatus()` says it is due, `gnssUpdateAssistance()` first, while connected. A
  failed refresh is a failed attempt. The refresh counts inside `PROTOCOL.md` §13.3 item 2's 60 s.
  Log the bytes it costs.
- **Accept only a good fix**: confidence ≤ 100 (the vendor demo's threshold); map it to `acc`.
- **`/status`**: `loc_min_s` = 600 (the floor), `loc_period_s` = 0 (no unsolicited fixes), and new
  `loc_backoff_s` = seconds until the next attempt is allowed (0 = now). With location tracking on
  (`LOCATION_TRACKING_DESIGN.md`), `loc_period_s` = 3600 (the maximum gap between unsolicited cell
  reports) and `loc_move_s` = the GNSS-while-moving interval (600, 0 = off).
- **Relay/protocol**: §13.3 item 1 is amended: the device's window is the growing backoff above,
  reported in `/status`; the relay's own mirrored 60 s rule is unchanged. `tools/pager_client.py`
  answers `loc_req` the same way (a `--loc lat,lon` option, else `no_fix`) so the e2e suite covers
  the lifecycle. On a `no_fix` answer the pager sends its serving cell (PROTOCOL.md §13.2, envelope
  key 49 `cell`), and the relay resolves it to a coarse position via pluggable geolocation (Google
  Geolocation API or OpenCelliD), stored as a fix with `src: "cell"`. This gives a coarse answer
  indoors; GNSS improves accuracy outdoors but is not the only source.

## 6. Device-direct SMS

Owner decision (2026-09-20): the pager may send and receive SMS directly through the modem, to a
**parent-managed allow-list of phone numbers**, as a delivery path that does not depend on the
relay. This reverses `PROTOCOL.md` §7.3's "no device-side SMS path"; edit it.

- **Who controls the list**: only the device's owner (or an admin), through Family → Contacts and the member's approved list. The pager has
  no UI to add, edit or remove a number. Max 8 entries `{name ≤ 16 chars, phone E.164}`.
  Stored on `devices/{id}.smsContacts`; delivered as `/down` `cfg` with `cfg.sms = [{n, p}, …]`
  (whole list each time, newest-wins, acked `shown` on apply). The pager keeps it in NVS.
- **Sending**: SMS contacts appear in the recipient picker and as `@name` in the composer, tagged
  `sms`. A message to one goes out with `smsSend()`; GSM 7-bit when every character is in the
  basic alphabet (≤160), otherwise UCS-2 (≤70 characters; the composer shows the tighter limit).
  No concatenated SMS. The thread entry shows `sent` / `FAILED` like any other reply.
- **Receiving**: `+CMTI` → read, delete from the SIM, then: sender on the list → insert into the
  thread as from that contact and alert like any message; sender not on the list → **never
  shown**, logged as `blocked`.
- **Audit, non-negotiable**: every SMS in either direction, including blocked ones, produces a
  signed `/up` envelope `kind:"sms_log"` with `id` (`s_` + 8 hex), `ts`, `peer` (E.164), `dir`
  (`out`/`in`), `st` (`sent`/`failed`/`recv`/`blocked`), `body`, `sms_ts`. QoS 1. If the pager is
  offline it is queued in NVS (same durability as an unsent reply, at least 16 entries, oldest
  dropped last resort with a counter reported in `/status`) and sent when the session is back. An
  SMS is **sent first, logged second**: the point of this path is that it works without the relay.
- **Relay**: `sms_log` is stored under `devices/{id}/smsLog/{logId}` (dedup on id), is not routed
  to anyone and is not a thread entry. Owner/admin API: `GET /api/devices/{id}/sms-log`,
  `GET/PUT /api/devices/{id}/sms-contacts` (PUT validates E.164, max 8, pushes the cfg).
  Firestore rules: readable by the device's owner and admins only.
- **Web**: on the device's page, an *SMS contacts* editor and an *SMS log* table (time, direction,
  number/name, status, text), blocked entries highlighted.
- **Owner decision 7 Oct 2026:** this is the only SMS path; the relay has no SMS backend. The list is
  derived, not hand-edited: the member's approved Family → Contacts plus, for an `open`/`any_sms`
  member, every family contact (max 8, by name). Contact names are unique per family because the
  pager matches by name. *(8 Oct 2026: this modem path now serves members without a relay SMS number; `cfg.sms` is pushed empty for members with a relay number who send/receive through it instead.)*
- `UNVERIFIED`: SMS on the production SIM at all (a Google Fi data-only SIM may not carry SMS);
  the modem's `+CMTI` behaviour under eDRX; text-mode UCS-2 on this firmware. `smstest` exists to
  find out. Everything fails safe: an SMS that cannot be sent is a `FAILED` thread entry plus an
  `sms_log` with `st:"failed"`.

**Malformed uploads leave a trail.** If a signature-verified `sms_log` from a registered, non-revoked device cannot be stored normally (the envelope does not decode, or a field such as `peer`/`dir`/`st`/`id`/`body` is invalid), the relay still writes `smsLog/bad_<sha256(unsigned)[:12]>` (deterministic, so a retry does not duplicate) with `malformed:true`, `reason`, `ts` (relay receive time), `rawHex` (unsigned bytes, capped at 512) and best-effort `peer`/`dir`/`st`/`msgId` pulled from the raw bytes; `body` is null. For undecodable payloads this applies only when the bytes contain `sms_log`. `GET /api/devices/{id}/sms-log` returns these rows with `malformed:true` and `reason`/`rawHex` (normal rows: `malformed:false`); `dir`/`peer`/`st`/`body` may be null on a flagged row.

## 7. Wire additions (the only place new keys are allocated)

Envelope keys:

| Key | Name | Type | Where |
|---|---|---|---|
| 39 | `tls` | tstr | `/status` |
| 40 | `ca_url` | tstr | bootstrap bundle |
| 41 | `ca_sha` | bstr(32) | bootstrap bundle |
| 42 | `ca_fp` | tstr(16) | `/status` |
| 43 | `loc_backoff_s` | int | `/status` |
| 44 | `peer` | tstr | `/up` `sms_log` |
| 45 | `dir` | tstr | `/up` `sms_log` |
| 46 | `st` | tstr | `/up` `sms_log` |
| 47 | `sms_ts` | int | `/up` `sms_log` |
| 48 | `sms_lost` | int | `/status` (audit entries dropped, normally 0) |
| 50 | `link` | int | `/status` (MQTT-session generation within a boot — §9.5; key 49 is `cell`) |
| 60 | `why` | tstr | `/loc`, unsolicited only: `still`/`cell`/`move`/`gnss`/`stop` (`LOCATION_TRACKING_DESIGN.md` §3; keys 51–59 are allocated in `PROTOCOL.md` §10) |
| 61 | `loc_move_s` | int | `/status` (GNSS-while-moving interval, 0 = off) |

`kind` gains `sms_log` (`/up`). `cfg` sub-map: `lock=0` (existing), **`ca=1`** `{url=0 tstr,
sha=1 bstr(32)}`, **`sms=2`** array of `{n=0 tstr name, p=1 tstr phone}`. In JSON the same names
are used; `ca_sha`/`sha` are base64url without padding, like `sig`.

`n` (key 12): uint, now up to 2^53-1 (§3).

## 8. Verification

- Firmware: `make -C firmware/host test` (add tests: counter ≥ 2^32 vectors, location backoff with
  a fake clock, SMS GSM-7/UCS-2 encoding and allow-list, CA fetch HTTP parsing and hash check,
  trust-state transitions, cfg `ca`/`sms` decode). `idf.py build` clean in both normal and
  `PAGER_DEBUG_NO_LIGHT_SLEEP` configurations.
- Relay: `pytest` (emulators), ruff; new tests for every new route and ingest kind; e2e scenarios
  `locate`, `ca_push`, `sms_log` with `pager_client.py`.
- Web: `npm run build`, lint.
- Hardware, by a person: everything marked `UNVERIFIED`, using the debug console.

## 9. Session liveness: the modem sends no PINGREQ (corrected 15 Oct 2026, see §9.1)

### 9.1 The finding (measured 2026-09-21, AT&T via US Mobile Dark Star)

> **Correction (15 Oct 2026, `PINGREQ.md`).** The modem does send PINGREQ at the keepalive. Idle
> probe sessions (modem `UE8.2.1.0`, eDRX, light sleep) against a capture broker: on AT&T it pinged
> at 60 and 240 s; at 360 s (twice) and 480 s no PINGREQ reached the broker and the capture showed
> the flow already dead (close_notify retransmitted, no ACK, no RST). On Soracom direct it pinged on
> the same connection at 360, 600, 900, 1200 and 1800 s. So the 21 Sep result below is
> real, but its cause is AT&T's network silently dropping idle TCP flows somewhere in 240–360 s,
> before the 480 s ping; the modem gets no RST and raises no URC. Item 1's 10–13 min "second
> killer" is the same cut. Items 2–4 stand. The host re-SUBSCRIBE (§9.2) stays the only liveness
> check, now with per-carrier timing.

`AT+SQNSMQTTCONNECT`'s fourth argument is documented as "Maximum period (in seconds) allowed
between communications with the broker. If no other messages are being exchanged, this parameter
controls the rate at which the client sends ping messages to the broker" (Monarch 2 AT manual,
`AT+SQNSMQTTCONNECT`). **On `LR8.2.1.0-61488` it does not.** Three consecutive idle sessions with
`keepalive=480` (confirmed negotiated by the broker) sent **no PINGREQ at the 8-minute mark**:
EMQX's `recv_pkt` for the client stayed at 1 (the CONNECT) for the whole session
(`build/bench-logs/r2-keepalive-poll.log`, sessions starting `02:35:20Z`, `02:51:37Z`,
`03:09:47Z`; polled every 30 s). The one `recv_pkt` 1→2 step was the device's own hourly
`/status` heartbeat, not a ping — it came with `recv_msg` 0→1, `recv_oct` +143 (a 113-byte
PUBLISH) and a 4-byte reply (PUBACK); a SUBSCRIBE would be ~28 octets with `recv_msg` unchanged
and a 5-byte SUBACK.

Consequences, in order of severity:

1. **Two independent killers of an idle flow.** The broker drops the client at 1.5 × keepalive
   (720 s; measured 12.4 min for session 2). Separately, something in the path kills the flow at
   **10–13 min** regardless: with `keepalive=1800` sessions still died in 10–13 min, far short of
   45 min, so this is not the broker. Assumed carrier NAT idle timeout (INFERRED).
2. **After a silent resume the pager is deaf.** The modem reconnects on its own ~6 min later and
   emits `+SQNSMQTTONCONNECT:0,0` with no preceding `AT+SQNSMQTTCONNECT` from us
   (`build/bench-logs/r2-keepalive-serial.log:646`, `:1566`). The AT manual is explicit: "If the
   MQTT connection was dropped by the server and automatically resumed by the modem … the MCU must
   re-subscribe to carry on receiving MQTT messages." Our handler tries, but
   `WalterModem::mqttSubscribe()` returns `OK` **without sending anything** when the topic is
   already in its local table (`src/proto/WalterMQTT.cpp:120-123`), and only `mqttConnect()` ever
   frees that table (`:86-88`) — which a modem-initiated resume never calls. Measured: no
   `AT+SQNSMQTTSUBSCRIBE` was sent in the whole 40-minute log, for either resume.
3. **No disconnect is ever reported.** No `+SQNSMQTTONDISCONNECT` in 40 minutes over three broker
   drops. The handler logs on every rc (`net.cpp:382-387`), so the URC simply is not raised.
   `s_mqtt_connected` therefore stays `true` from boot: no disconnect edge, no F1/F3 backoff, no
   `net_session_up()`, and no rising edge — which is why three resumes produced **no**
   `published /status online`, and the relay's §5.3 re-publish of unacked pages never ran.
4. **The session is not persistent.** While the client was gone, EMQX's `/clients/{id}` returned
   404 rather than a disconnected session, so the broker keeps nothing: the subscription and any
   queued QoS 1 `/down` are discarded on every drop (INFERRED from the 404s). Clean-session is not
   settable on this firmware; the vendor added `AT+SQNSMQTTCFG=…[,<retain>[,<clear>]]` only in
   `LR8.2.3.1-65130` (Sequans forum topic 606).

### 9.2 Decision

The host must keep the flow warm itself. **After `N` seconds of uplink silence, re-SUBSCRIBE to
`pager/{id}/down`** via a raw `AT+SQNSMQTTSUBSCRIBE`. Since 15 Oct 2026 `N` and the MQTT keepalive
are per carrier preset (`carrier.h` `mqtt_ping_s` / `mqtt_keepalive_s`), fixed per session at
connect: **Soracom (Beam and direct) `N` = 840 s, keepalive 1200 s; US Mobile Dark Star, Automatic,
Carrier default and custom or unknown APNs `N` = 240 s, keepalive 480 s.** Bootstrap keepalive stays
60 s. (Originally `PAGER_MQTT_PING_S` = 300 s and keepalive 480 s for all.)

Why a re-SUBSCRIBE and not a publish: the SUBACK proves the round trip (a QoS 0 publish proves
nothing), it needs no ACL change and no relay-side tolerance (the broker rule forwards `/up`,
`/status`, `/loc`, `boot/+/up` only), and it is *also* the repair item 2 above requires, so one
mechanism fixes both. It is safe to repeat: EMQX replaces the subscription, and `/down` is
published with `retain=False` (`relay/app/broker.py:193`), so no page is re-delivered.
Rejected: TCP keepalive (the library's socket `keep_alive` is "currently unused",
`WalterModem.h:5223`, and the built-in MQTT client has no socket handle anyway); reconnecting on a
9-minute timer (160 TLS handshakes/day ≈ 800 kB and ~80 mAh/day — worse on both axes);
a modem firmware upgrade (a forum report of RF loss after `LR8.2.1.0` → `LR8.2.2.1` makes that a
bench experiment, not a plan).

Originally `N` = 300 s halved the shortest observed death (10.5 min) and left 420 s of margin to the
broker's 720 s timeout. **Updated 15 Oct 2026:** AT&T's measured idle cut is 240–360 s, so 300 s was
not proven safe; 240 s is the longest proven AT&T value, and 2 × 240 < 720 keeps one missed ping
survivable. Soracom holds idle flows ≥1200 s, so it gets Beam's ceiling, keepalive 1200 s, with
`N` = 840 s: 2 × 840 < 1800, and a dead session goes unnoticed for at most ~15 min. An unknown
carrier gets the AT&T pair. "Broker declares a truly dead pager offline" is ≤12 min (AT&T and
others) or ≤30 min (Soracom).

### 9.3 Cost

| Term | Number | Assumption |
|---|---|---|
| Per ping | ~0.1 mAh (estimate) | §6.2's RRC figure: ~3 s at ~120 mA. **The weakest number here** — an RRC release tail of 10 s instead of 3 s would make it 0.28 mAh |
| Pings/day | ~103 (Soracom) / 360 (AT&T) worst case | 86400/840 and 86400/240 with no other uplink (was 288 at 300 s); every publish resets the timer |
| **Energy** | **~10 mAh/day → 0.43 mA (Soracom); ~36 mAh/day → 1.5 mA (AT&T)** | was ~28.8 mAh/day → 1.2 mA at 300 s; replaces `PROTOCOL.md` §8.4's 0.75 mA keepalive line |
| Sleep-mode total | 3.95–4.45 mA → **95–107 mAh/day** → 23–26 days on 2500 mAh LiPo | computed at the old 1.2 mA ping term; §8.4's other terms unchanged |
| Data | 360 × ~0.17 kB ≈ **61 kB/day** (AT&T); ~103 × ~0.17 kB ≈ 18 kB/day (Soracom, less over Beam with no TLS framing) | SUBSCRIBE ~28 B + SUBACK 5 B, each +29 B TLS +40 B TCP/IP (§7.1); the 10 MB bar holds |

If the per-ping measurement comes back at ≥0.25 mAh, raise Soracom's `N` toward its measured idle
survival; AT&T has no headroom above 240 s (cut at 240–360 s).

### 9.4 Mechanism

1. `net.cpp` tracks `s_last_uplink_us` (set on every successful publish and on every SUBACK) and
   a `s_resub_pending` flag.
2. `+SQNSMQTTONCONNECT` while the firmware already believes it is connected = a modem-initiated
   resume: log it, set `s_resub_pending`, do not touch `s_mqtt_connected` (nothing else is broken —
   publishes still work).
3. `net_service_session()`, called once per wake-and-drain iteration from `modes.c` (the ESP32 is
   already awake every 5 s in sleep mode, §8 — the timer check is free), sends the raw
   `AT+SQNSMQTTSUBSCRIBE=0,"pager/{id}/down",1` when `s_resub_pending`, or when
   `now - s_last_uplink_us >= N`. Skipped while the coverage duty cycle owns the radio and during
   a CA-apply trial (location route 2, the third suppression, was removed 26 Sep 2026 with the
   `CFUN=4` route, §5) — the suppressions the reconnect path already honours.
4. The `SUBSCRIBED` event clears the pending flag and, if it closed a resume, raises a
   **session-restart edge** so `modes.c` runs the existing `catrust_on_mqtt_connected()` +
   `publish_status_online()` block (`loc_flush_pending_answer()` goes with route 2, §5).
5. No SUBACK within 30 s (two wake cycles plus RRC setup) = the session is dead: mark
   disconnected and raise the ordinary disconnect edge, so F1/F3 backoff and `net_session_up()`
   run. `mqttConnect()` frees the topic table, so the subscribe after a real reconnect is a
   normal one. **This is the early death detection the firmware lacks today** — ≤30 s instead of
   the modem's ~6 min.

No new wake source; no new RTC state (`s_last_uplink_us` and the flags live in RAM, which the
5 s light sleep retains, and after a reset the session is rebuilt from scratch anyway).

### 9.5 Relay (P2, after the above)

A resume still leaves a ≤10 s window with no subscription at the broker, and a QoS 1 `/down`
published into it is discarded (§9.1 item 4). The relay re-publishes unacked pages only on a
`session` change or an offline→online edge (`relay/app/ingest.py:647-650`), and `session` is a
cold-boot id (§5.1), so a resume triggers neither. Fix: `/status` gains optional **`link`**
(key 50, §7) — a counter incremented on every MQTT session within a boot — and the relay treats a
changed `link` exactly like a changed `session`. Optional field, so an older relay is unaffected.

### 9.6 What to measure

1. **The ping works.** 2 h idle with the change: broker `recv_pkt` rises every ~`N` s, `connected_at`
   never changes, and a page sent at t+90 min arrives. This is the acceptance test.
2. **Per-ping energy.** Current trace across one ping: peak, duration to RRC release, mAh. Feeds
   §9.3 and decides whether the per-carrier `N` values survive.
3. **The real idle-death time.** `keepalive=1800` (removes the broker as a killer), no host ping,
   poll the broker every 10 s: gives the carrier's timeout directly, and with it the largest `N`
   that is safe. Run per carrier (AT&T today, T-Mobile/Google Fi next). **Done 14-15 Oct 2026 for
   AT&T (cut 240–360 s) and Soracom direct (≥1800 s)** with a capture broker
   (`PINGREQ.md`); Beam and T-Mobile remain.
4. **The resume repair.** Force a drop (broker-side kick), confirm `AT+SQNSMQTTSUBSCRIBE` goes out
   within one wake cycle, `+SQNSMQTTONSUBSCRIBE` returns, `/status online` is published, and a page
   sent 10 s later arrives.
