awong-dev/pager/docs/WIFI_DESIGN.md

# WiFi as an alternate MQTT transport

**Status:** design, nothing implemented. Companion task file: `docs/WIFI_TASKS.md`.
**Goal:** carry the same MQTT session — same broker, same client id, same credentials, same four
topics — over the ESP32-S3's own WiFi station instead of the Sequans modem, so that **the relay and
the web app need no change**. LTE-M stays the default and the fallback.
**Owner framing (2026-09-23):** "wifi is a cost-saving option. It is okay to require the user
actively turn it on instead of searching." The saving being bought is **LTE-M data and SIM cost**,
not latency and — see §3 — not obviously battery either. Every number below says which.

Conventions follow `PROTOCOL.md`: `(estimate)`, `(IDF doc)` = a figure read out of
`~/src/esp/esp-idf/docs` on this machine, `UNVERIFIED` = a hardware fact with a named experiment.

---

## 0. The three facts this design turns on

1. **WiFi is not free on battery.** ESP-IDF's own ESP32-S3 numbers
   (`docs/zh_CN/api-guides/sleep-current/esp32s3_summary.inc`, included by the English
   `low-power-mode.rst`, which is untranslated): an associated station at 160 MHz costs
   **40.1 / 38.7 / 38.2 mA** (DTIM 1 / 3 / 10) in plain Modem-sleep, **20.7 / 19.9 / 19.5 mA** with
   DFS, and **2.45 / 1.33 / 0.93 mA** with *automatic* Light-sleep. Only the third column is
   survivable: 38 mA on a 2500 mAh cell is **2.7 days**. Automatic light sleep needs
   `CONFIG_PM_ENABLE`, which is **off today** (`firmware/sdkconfig:918`).
2. **Manual light sleep and an associated station are mutually exclusive** as ESP-IDF documents it:
   "Wi-Fi connections are not maintained in Deep-sleep or Light-sleep mode"
   (`docs/en/api-reference/system/sleep_modes.rst:49-51`); the supported way to keep a connection
   is Modem-sleep + *automatic* light sleep. `net_sleep()` (`firmware/main/net.cpp:1315`) is a
   manual `esp_light_sleep_start()`. **UNVERIFIED:** whether a manual light sleep with
   `esp_sleep_enable_wifi_wakeup()` and `ESP_PD_DOMAIN_MODEM` kept on preserves the association in
   practice on IDF 5.x. Experiment in §9, 30 minutes on the bench; it decides whether task W9 is a
   day or a week.
3. **WiFi removes the two ugliest parts of the LTE path.** esp-mqtt sends real PINGREQs, so
   `V02_DESIGN.md` §9's 300 s re-SUBSCRIBE (≈28.8 mAh/day, ≈49 kB/day) is not needed; and there is
   no RTS hold-off, so the 200 ms wake-and-drain window (≈1.6 mA) is not needed either. Delivery
   latency on WiFi is ~1 s, not 27 s.

---

## 1. Transport seam

`net.h` stays the API `modes.c` sees. **No function in `net.h` gains a transport parameter.** The
dispatch is internal, on a single `s_active_xport` variable that only one function writes.

**Split the MQTT session out of `net.cpp`, do not rewrite it.** New files:

| File | Contents |
|---|---|
| `net_xport.h` | `typedef struct { bool (*up)(void); void (*down)(void); bool (*publish)(const char*, uint8_t*, uint16_t, uint8_t); void (*service)(void); void (*status)(net_mqtt_status_t*); ... } net_xport_ops_t;` plus `net_xport_t { NET_XPORT_LTE, NET_XPORT_WIFI }` |
| `xport_lte.cpp` | **moved verbatim** from `net.cpp`: `net_session_up/down`, `net_publish*`, `pager_mqtt_event_handler`, `net_service_session`, `classify_mqtt_rc`, the `s_resub_*`/`s_connect_guard`/`publish_quiet` state. Same code, new home, one review diff that is a pure move. |
| `xport_wifi.c` | esp-mqtt over `esp_tls`/mbedtls on the STA. Plain C. |
| `wifi_sta.c/.h` | `esp_netif` + `esp_wifi` bring-up, association, RSSI, scan. No MQTT. |
| `wifi_policy.c/.h` | **pure** selection state machine (§2). Host-tested. |
| `wificred.c/.h` | **pure** parser + NVS store (§4). Host-tested. |

**Stay in `net.cpp`, LTE-only, untouched:** `net_init`, `net_recover_modem`, `net_check`,
`net_get_clock`, `net_get_battery_mv`, `net_get_rssi`, `net_sleep` (see below), every `net_gnss_*`,
`net_radio_*`, `net_sms_*`, `net_get_cell_info`, `net_ca_fetch_*`, `net_write_ca*`,
`net_tls_configure`, `net_bootstrap_*`, `net_check_sim`. WiFi never touches the modem.

**Dispatched through the seam (signatures unchanged):** `net_session_up`, `net_session_down`,
`net_publish`, `net_publish_raw`, `net_get_mqtt_status`, `net_ack_disconnect_edge`,
`net_ack_session_restart_edge`, `net_service_session`, `net_modem_busy`, `net_connect_in_flight`,
`net_connect_fail_streak_maxed`, `net_take_memfull_delta`, `net_take_oversize_delta`,
`net_publish_quiet_wait_ms`. `net_set_msg_cb` registers one callback that both transports call.

**New, small:** `net_xport_t net_xport_active(void)` (for `/status`), `bool net_wifi_set_enabled(bool)`,
`void net_set_lte_suppressed(bool)`.

**What `modes.c` must not know:** which transport is up, TLS profiles vs mbedtls, keepalive vs
re-SUBSCRIBE, association state, DHCP, scan. Its only edits are three lines:

1. `/status` gains `xport` (§6).
2. The `net_service_session()` call site (`modes.c:2305`) drops its
   `!s_coverage_owns_radio && !s_loc_suppress && !s_ca_apply_suppress` guard and instead calls
   `net_set_lte_suppressed(...)` with the same expression. Those three suppressions are about the
   *modem*; they must not silence the WiFi transport's service tick.
3. `net_sleep(interval_ms)` is unchanged at the call site but becomes transport-aware inside (§3).

**LTE semantics stay exactly as they are** when `s_active_xport == NET_XPORT_LTE`: the connect
guard, the 30 s no-SUBACK death detector, the 300 s re-SUBSCRIBE, `s_disconnect_edge`,
`s_session_restart_edge`. Nothing in `xport_lte.cpp` changes behaviour.

### esp-mqtt equivalents

| LTE mechanism | WiFi equivalent |
|---|---|
| Per-carrier keepalive (`carrier.c`: 1200 s Soracom, 480 s others); the modem does ping, but carrier NATs can kill an idle flow silently (PINGREQ.md, 15 Oct 2026) | `esp_mqtt_client_config_t.session.keepalive = 60`, `disable_keepalive = false`. esp-mqtt really does ping. 60 s also survives any home NAT. |
| Raw re-SUBSCRIBE liveness ping (per carrier: 840 s Soracom, 240 s others) | **not implemented.** `service()` on WiFi only runs the policy tick and the connect timeout. |
| `net_connect_guard` 30 s "no CONNECTED/SUBSCRIBED" | keep it, verbatim — same struct, armed on `esp_mqtt_client_start()`, cleared on `MQTT_EVENT_SUBSCRIBED`. |
| `WALTER_MODEM_MQTT_EVENT_CONNECTED` → subscribe from the handler | `MQTT_EVENT_CONNECTED` → `esp_mqtt_client_subscribe(pager/{id}/down, 1)`. Same "connected is not usable, SUBSCRIBED is" rule: `mqtt_connected` is set only in `MQTT_EVENT_SUBSCRIBED`. |
| `NET_MQTT_RC_TRANSIENT` | `MQTT_EVENT_DISCONNECTED`; `MQTT_ERROR_TYPE_CONNECTION_REFUSED` with `connect_return_code` 0x01/0x02/0x03. |
| `NET_MQTT_RC_PERMANENT` | `connect_return_code` 0x04 (bad user/pass) / 0x05 (not authorized) — the `AUTH`/`ACL_DENIED` analogue. |
| `NET_MQTT_RC_TLS_FAIL` | `MQTT_ERROR_TYPE_TCP_TRANSPORT` with a non-zero `esp_tls_stack_err`/`esp_tls_cert_verify_flags`. Feeds `catrust_on_mqtt_tls_fail()` **only to report**, never to un-validate (§5). |
| `s_disconnect_edge` / `session_restart_edge` | identical flags, set from the esp-mqtt event handler. A WiFi reassociation that survives the TCP session is invisible; one that does not raises an ordinary disconnect edge. No "silent resume" case exists — esp-mqtt never reconnects behind our back because **`disable_auto_reconnect = true`**: `modes.c`'s F1/F3 backoff stays the single owner of reconnect policy, which is also what keeps two sessions from ever existing. |
| `publish_quiet` gate (display corruption) | same gate, armed in `publish()`, cleared on `MQTT_EVENT_PUBLISHED`. WiFi TX bursts are the same class of supply event as LTE ones (§8). |
| oversize drop (`> 640 B`) | esp-mqtt fragments payloads larger than `buffer.size`. Set `buffer.size = 1024` so a 640-byte envelope is never split; if `total_data_len != data_len` anyway, count it as oversize and drop, exactly like `net.cpp:455`. |

**LWT:** the modem cannot set one (`PROTOCOL.md` §6.1); esp-mqtt can. **Do not set it in phase 1.**
An LWT from a dropped WiFi session arrives at the broker's keepalive timeout (~90 s) and would
overwrite a newer retained `online` published from LTE. Making it safe needs a relay-side ordering
rule on `/status`; that is a separate change, recorded here, not taken.

---

## 2. Selection policy

Pure state machine in `wifi_policy.c`, no I/O, host-tested. Inputs: `user_enabled`, `have_creds`,
`sta_associated`, `rssi_dbm`, `now_us`, `wifi_fail_count`, `lte_session_ok`. Output: a desired
transport plus one action (`SCAN`, `ASSOCIATE`, `MQTT_UP`, `SWITCH_TO_LTE`, `NONE`).

- **Default is LTE.** WiFi is never preferred unless `user_enabled` is true (console, device menu,
  or `cfg.wifi.en`, §4). No background discovery at all in phase 1.
- **Prefer WiFi** when: `user_enabled && have_creds && sta_associated && rssi >= -70 dBm` and the
  CA is pinned (§5).
- **Fall back to LTE** on any of: 3 consecutive failures of {association, DHCP, TLS handshake, MQTT
  CONNECT}; 2 MQTT disconnects within 120 s; `rssi < -80 dBm` continuously for 30 s; loss of
  association for 20 s.
- **Hysteresis.** Entry needs −70 dBm, exit needs −80 dBm for 30 s (10 dB + 30 s of dwell). After a
  fallback, the next WiFi attempt is allowed only after a backoff of **10 / 30 / 60 minutes,
  capped**, reset by a successful 10-minute WiFi session or by any user toggle. This is the
  anti-flap: a switch costs one TLS handshake on each side (~5 kB of LTE data when going back).
- **The switch itself is one function** (`net_xport_switch(to)`): bring the *old* transport's MQTT
  session down and wait for its DISCONNECTED (bounded 2 s), then bring the new one up. A hard
  invariant, asserted: at most one MQTT client object exists at a time. EMQX kicks the older
  session on a client-id collision, which would show up as a delivery gap, so this is not merely
  tidy (§8).

**The modem while WiFi carries the session: stay attached, drop only the MQTT session.**
Numbers from `V02_DESIGN.md` §8.4/§9.3: the LTE terms are eDRX paging **0.2–0.5 mA**, modem idle
floor **0.01–0.05 mA**, and the host liveness ping **~1.2 mA**. Dropping the MQTT session removes
the 1.2 mA term (the big one) and all 49 kB/day of ping data. `CFUN=4` would remove a further
**0.2–0.5 mA (5–13 mAh/day)** but costs device-direct SMS (`V02_DESIGN.md` §6), the cell-change
location trigger (§5 trigger 1), the `/loc` `cell` sub-map, and turns fallback into a full
re-attach. **Decision: stay attached.** Revisit as a phase-3 flag only if a measured paging term
lands at the top of that range and the owner is not using SMS.

---

## 3. Power

All figures per day on a 2500 mAh LiPo cell. Today's LTE-only baseline is **4.0–4.5 mA →
95–107 mAh/day → 23–26 days** (`V02_DESIGN.md` §9.3).

| Configuration | ESP32+WiFi | Modem | MQTT keepalive | Total | Days |
|---|---|---|---|---|---|
| (a) WiFi, no `CONFIG_PM_ENABLE`, Modem-sleep only | 38.2 mA (IDF doc, DTIM10) | 0.2–0.5 | in the 38 | **≈38.5 mA → 925 mAh/day** | **2.7** |
| (b) WiFi, `PM_ENABLE` + DFS, no light sleep | 19.5 mA (IDF doc, DTIM10) | 0.2–0.5 | in the 19.5 | ≈20 mA → 480 mAh/day | 5 |
| (c) **WiFi, `PM_ENABLE` + auto light sleep, `WIFI_PS_MAX_MODEM`, listen_interval 10** | 0.93 mA (IDF doc, DTIM10) | 0.2–0.5 | 0.17 (est.) | **≈1.3–1.6 mA → 31–38 mAh/day** | **65–80** |
| (d) same, `WIFI_PS_MIN_MODEM` (active mode) | 2.45 mA (IDF doc, DTIM1) | 0.2–0.5 | 0.17 | ≈2.8–3.1 mA | — |
| (e) LTE today | 2.6 | 0.2–0.5 + 1.2 | — | 4.0–4.5 mA | 23–26 |

Keepalive estimate: 1440 PINGREQ/day × ~100 ms of radio at ~100 mA = 4 mAh/day = 0.17 mA
(estimate — measure it). The IDF rows are Espressif devkit measurements, not this board: the Walter
module, the e-paper domain and the CardKB pull-ups are all extra and are **not** in those numbers.

**Conclusion.** (a) and (b) are not battery configurations. So:

- **Phase 1 (a): WiFi runs only while the pager is on USB/charger power, or on the bench.** The
  console turns it on; nothing turns it on by itself. This is enough to bench the whole transport.
- **Phase 2 (c): `CONFIG_PM_ENABLE` + automatic light sleep is what makes WiFi usable on battery**,
  and it is also a **2.5–3× win over LTE** (31–38 vs 95–107 mAh/day) — if the modem UART survives
  it. That is the risk, not the WiFi part: with `PM_ENABLE` the APB clock moves and the system
  light-sleeps on its own, so `net.cpp`'s hand-rolled RTS choreography must be replaced by an
  `ESP_PM_NO_LIGHT_SLEEP` lock held around every AT transaction and while `net_modem_busy()` or
  `net_connect_in_flight()` is true. `esp_sleep_enable_uart_wakeup()` on the modem UART is the
  other half.
- **`net_sleep()` becomes transport-aware.** On LTE: today's code, unchanged. On WiFi: never call
  `esp_light_sleep_start()` — phase 1 does `vTaskDelay(ms)` (CPU on, USB alive, ≈38 mA); phase 2
  does `vTaskDelay(ms)` too and lets the PM framework light-sleep underneath it. `modes.c`'s call
  site does not change either way.
- The 200 ms `PAGER_POST_WAKE_YIELD_MS` exists only for the modem's held URCs
  (`GOTCHAS.md`, "Pages never arrive while the pager sleeps"). On WiFi it can drop to ~20 ms.

### 3b. Is sniffing for a known SSID ever sensible?

Assumptions, all `(estimate)` and all to be measured: radio-on current during a dwell **100 mA**
(IDF's S3 tables report 113–120 mA as the *max* with the radio active, so 100 mA is the honest
middle); `esp_wifi_start()` + PHY init/cal + stop overhead **200 ms at 80 mA**; US country code =
**11 channels**; default dwell **120 ms/channel** (`docs/en/api-guides/wifi.rst:567`); a passive
single-channel dwell of **150 ms** (one beacon interval is 102.4 ms) once the home channel has been
cached in NVS from the first successful association.

Per scan: single cached channel, passive = **0.009 mAh**. All 11 channels, active = **0.041 mAh**.

| Trigger | Scans/day | Single channel | All channels | % of the 100 mAh/day budget |
|---|---|---|---|---|
| on every 5 s wake | 17280 | 149 mAh | 709 mAh | **149% / 709% — ruled out outright** |
| every 60 s | 1440 | 12.4 mAh | 59 mAh | 12% / 59% |
| every 5 min | 288 | 2.5 mAh | 11.8 mAh | 2.5% / 12% |
| **every 15 min** | 96 | **0.83 mAh** | 3.9 mAh | **0.8%** / 4% |
| every 60 min | 24 | 0.21 mAh | 0.98 mAh | 0.2% / 1% |
| on `+CEREG` cell change (10-min debounce, `V02_DESIGN.md` §5 trigger 1) | 10–30 typical, 144 cap | 0.09–0.27 (1.2 cap) | 0.4–1.2 (5.9 cap) | 0.1–0.3% / 0.4–1.2% |
| on motion-settle (LIS3DH, sustained motion then 60 s quiet) | 10–20 | 0.09–0.18 | 0.4–0.8 | ~0.2% / ~0.8% |

**Verdict.** Sniffing *is* sensible, at a <1% budget hit, but only in the trigger-driven shape:
**scan when the serving cell changes or motion settles — both already have debounced triggers in
the firmware — plus a 15-minute single-cached-channel fallback while un-associated.** Combined
≈1–2 mAh/day, 1–2%. Scanning on the 5 s wake costs more than the entire current budget and is
ruled out permanently. Use a **passive** scan: it emits no probe request, so it produces no TX
burst, which matters given §8's supply-sag history. All of this is **phase 2, off by default**,
behind `cfg.wifi.scan_s` (0 = never scan; the manual-only default the owner asked for).

---

## 4. Provisioning

Three ways in, one store.

**Store.** NVS namespace `wifi`, separate from `ident` so a credential rotation never risks the
identity. Keys: `en` (u8), `n` (u8, 0–2), `s0`/`p0`, `s1`/`p1` (str), `ch0`/`ch1` (u8, the cached
home channel from the last successful association). **Up to 2 networks** (home and one other —
more is a UI problem, not a firmware one). SSID ≤32 bytes, PSK 8–63 bytes. **WPA2-PSK only**:
`threshold.authmode = WIFI_AUTH_WPA2_PSK`. WPA3-SAE is compiled in already
(`sdkconfig:1097-1098`) and a WPA2/WPA3 transition AP will associate as WPA2, so this costs
nothing; open and WEP networks are refused outright. Enterprise is out of scope.

**(1) `cfg` push** (`PROTOCOL.md` §10, `firmware/main/cfg.c`). New sub-map key `wifi = 3`:

```
cfg.wifi  = { en = 0 (bool), nets = 1 (array, <=2 of { s = 0 (tstr), p = 1 (tstr) }) }
```

Whole list every time, newest-wins, acked `shown` once written to NVS — identical to `cfg.sms`'s
contract (`PROTOCOL.md` §3.6). Size: 2 maximal entries ≈ 210 B CBOR, ≈ 250 B JSON, against the
640 B envelope cap — fits with room. `nets` absent means "leave the stored networks alone, apply
`en` only", so the web app can toggle WiFi without re-sending the PSK. `nets: []` clears them.
Relay work is one route and one validator; web work is one panel (`WIFI_TASKS.md` W7/W8).

**Security rules, non-negotiable:**
- A PSK is **never** in `/status`, never in any log line at any level, never in a `/loc` or `/up`
  envelope. `wificred.c` has no printing function; the console prints `<set>`/`<unset>`.
- The relay **refuses to push `cfg.wifi.nets`** to a device whose last `/status` reported
  `tls: "broken"` or `tls: "unpinned"` (`PROTOCOL.md` §5.1) — that is exactly the state in which
  the `/down` path is not confidential. `en` alone may still be pushed. This is the one new relay
  rule this design asks for.
- NVS is not encrypted on this device today. Recorded as a known limit, same as the broker
  password already stored in `ident`.

**(2) Setup console**, debug build only (`main.c`'s REPL): `wifi set <ssid> <psk>`, `wifi clear`,
`wifi on|off`, `wifi status` (prints SSID, RSSI, IP, transport, never the PSK), `wifi scan`.

**(3) Device menu** (`scr_device.c`): a WiFi row showing `off` / `<ssid> −62 dBm` / `LTE`, and an
on/off toggle. No text entry — there is no on-device SSID/PSK editor, deliberately (`DEVICE_PLAN.md`
§3.0 already rejected a SoftAP portal at "~450 kB of Wi-Fi stack"; that cost is now being paid for
a different reason, but the portal still is not worth it).

---

## 5. TLS

- **Reuse the CA bytes `catrust` already stores.** `ident_get_ca()` returns the pinned PEM
  NUL-terminated (`firmware/main/ident.h:95`); hand it straight to
  `esp_mqtt_client_config_t.broker.verification.certificate`. No second copy in the image, no
  `BROKER_CA_PEM` constant, and a `cfg.ca` push therefore repoints *both* transports at once.
- **Verification is mandatory and there is no plaintext fallback, ever.** This is a deliberate
  asymmetry with LTE: `V02_DESIGN.md` §4.2 lets the modem fall back to an *unvalidated* connect so
  that pages keep arriving, because on LTE that is the only path. On WiFi there is always another
  path — LTE — so an unverifiable broker is a **reason to switch transport**, not to lower the bar.
- Consequently **WiFi requires `catrust_get_state() == CATRUST_PINNED`.** `unpinned` (no CA in the
  identity at all) and `broken` both make the WiFi transport unavailable and the policy stays on
  LTE. Rejected alternative: ship ESP-IDF's certificate bundle
  (`CONFIG_MBEDTLS_CERTIFICATE_BUNDLE`, ~30–50 kB) as a fallback trust store — it would work
  against EMQX Cloud's public CA, but it introduces a second, weaker trust model and a `/status`
  `tls` value with two meanings. One rule is better.
- A WiFi TLS failure is reported (`NET_MQTT_RC_TLS_FAIL`, logged, counted) but **must not** call
  `catrust_on_mqtt_tls_fail()`'s state machine — that machine's job is to decide whether to give up
  validating on LTE, and a failure on a different transport is not evidence about the modem.
- TLS 1.2 minimum, SNI on (esp-tls does this from the hostname), no client certificate.

---

## 6. `/status`

Add **`xport`** (tstr, `lte` | `wifi`), **CBOR envelope key 52**, optional, `/status` only. Written
next to `link` in `build_status_cbor()` (`firmware/main/modes.c:691`).

`link` (key 50) already increments on every MQTT session within a boot and the relay already treats
a changed `link` like a changed `session` (`relay/app/ingest.py:649-658`). A transport switch *is* a
new MQTT session, so it bumps `link`, so **the relay's re-publish-on-link-change logic keeps working
with no change at all**. `xport` is display and diagnosis only — the relay stores it on
`devices/{id}` and the web app shows a chip. Reusing `link` alone was considered and rejected: it
cannot say *which* transport, which is the first thing anyone debugging a delivery gap wants.

Relay change: accept and persist `xport` (`relay/app/wire.py`, `relay/app/wirecbor.py` key 52,
`relay/app/ingest.py`), plus the `cfg.wifi` push route and its `tls == pinned` guard (§4). Per
`V02_DESIGN.md` §0, **the relay accepts the field before any firmware that sends it is flashed.**

---

## 7. Bench plan

1. **First WiFi session.** Debug build, pager on USB. `wifi set <ssid> <psk>` → `wifi on`. Expect,
   in order: `wifi: associating`, `wifi: got ip 192.168.x.y rssi -NN`, `xport: LTE -> WIFI`,
   `MQTT connect issued` from the WiFi transport, `MQTT session usable (subscribed to ...)`,
   `published /status online`. Then `tools/bench/send_test_page.py` → the page renders in **under
   2 s** (against 27 s worst case on LTE). Capture with `tools/bench/serial_capture.py`, foreground,
   bounded.
2. **Forced fallback.** Turn the AP off. Expect within 20 s: association lost → 3 failed re-associates
   → `xport: WIFI -> LTE` → LTE `MQTT connect issued` → `published /status online` with a bumped
   `link`. Send a page; it arrives over LTE. Turn the AP back on: nothing happens for 10 minutes
   (the policy backoff), then WiFi is retried.
3. **No double session.** `tools/bench/poll_emqx_client.py` every 5 s across both switches:
   `/clients/{id}` must never show two entries, and `connected_at` must change exactly once per
   switch. A collision shows as EMQX kicking the older client — the single most likely delivery
   bug in this design.
4. **Power.** Current trace on the battery rail, three 10-minute windows: LTE idle (baseline,
   expect 4.0–4.5 mA), WiFi idle phase 1 (expect ~38 mA — confirms §3(a) and why phase 2 exists),
   WiFi idle phase 2 with `PM_ENABLE` (expect 1.3–1.6 mA). Also one trace across a single scan
   (§3b) and one across a single WiFi publish (peak current, for §8).
5. **Data.** `poll_emqx_loop.py` byte counters over an hour on each transport: LTE ≈4.4 kB/h from
   pings alone, WiFi ≈0 on the SIM. That is the cost case, measured.

---

## 8. Risks

- **Supply sag / coexistence.** The e-paper controller reset three times during LTE uplink bursts
  on 2026-09-22. WiFi TX peaks (IDF's own tables show 113–120 mA maxima on a devkit; a real
  20 dBm TX burst is higher) are the same class of event. Mitigations, in order: reuse the existing
  `publish_quiet` gate for the WiFi transport so no panel SPI runs during a publish; never refresh
  the panel while associating or scanning; cap TX power with
  `esp_wifi_set_max_tx_power(52)` (13 dBm) — a real lever that trades range for peak current, and
  a home AP is close. **UNVERIFIED** whether the two radios on this module share an antenna path;
  no schematic statement was found in this repo. Cheapest check: associate and attach at once and
  watch RSSI on both.
- **Flash.** App is **0xa1730 (661 kB) of 0x200000 (2 MB)** today. WiFi libs + lwIP ≈350–450 kB,
  esp-tls/X.509/TLS record layer ≈120–180 kB (mbedtls is already linked for HKDF/PBKDF2/SHA but not
  the handshake), esp-mqtt ≈20 kB → **estimated 1.15–1.3 MB, ~40% headroom left**. Two 2 MB OTA
  slots and a 16 MB part, so no partition change. W0 measures the real delta before anything else
  is built.
- **RAM.** WiFi wants ~50–60 kB of heap on top of the ~23 kB of `.bss` already spent on the thread
  ring and the two frame buffers (`PROTOCOL.md` §9.5). 512 kB total, so it fits, but the current
  `sdkconfig` is generous (`ESP_WIFI_STATIC_RX_BUFFER_NUM=10`, `DYNAMIC_TX_BUFFER_NUM=32`) — trim
  to 6/16 if W0's heap watermark is uncomfortable.
- **Two clients, one client id.** EMQX kicks the older session on a collision, so a botched switch
  looks exactly like "pages stopped arriving" with both sides believing they are connected. The
  single-`s_active_xport`-writer rule, the bounded wait for DISCONNECTED, and
  `disable_auto_reconnect = true` are all there for this one failure. Bench step 3 is its test.
- **`CONFIG_PM_ENABLE` regressions.** It changes APB frequency and introduces automatic light
  sleep for *everything*, including the modem UART, the e-paper SPI and the CardKB I²C. This is the
  riskiest single change in the plan and is why it is a late, separately-benched task (W9/W10) with
  an A/B runtime flag rather than a prerequisite.
- **Latency is not the win.** WiFi delivery is ~1 s, but the pager's own e-paper refresh is
  0.45–1.5 s and the `shown` ack waits for BUSY (`PROTOCOL.md` §4). Do not sell WiFi as a latency
  feature; sell it as data cost, and as battery only after §9's experiment settles.

---

## 9. The one experiment that changes the plan

**Question:** does a manual `esp_light_sleep_start()` keep a WiFi association alive on IDF 5.x if
`esp_sleep_enable_wifi_wakeup()` is armed and `ESP_PD_DOMAIN_MODEM` is left on?

**Why it matters:** if yes, phase 2 is a small change to `net_sleep()` and `CONFIG_PM_ENABLE` is
never needed — the whole `PM_ENABLE` risk (W9) evaporates. If no, W9 is the only route to a
battery-viable WiFi.

**Cheapest experiment (~30 min, debug build, bench):** associate, connect MQTT, publish `/status`;
then `esp_sleep_enable_wifi_wakeup()` + `esp_sleep_pd_config(ESP_PD_DOMAIN_MODEM, ESP_PD_OPTION_ON)`
+ `esp_light_sleep_start()` for 5 s, ten times in a row. After each wake print
`esp_wifi_sta_get_ap_info()`'s return and the RSSI. Have the relay send a page during sleep cycle 6.
Pass = association survives all ten, the MQTT session is still up, and the page arrives. Do this
**before** W9 (it is task W5's last verify step in `WIFI_TASKS.md`).

Two smaller unknowns, same treatment: (a) whether the AP's DTIM is 1 or 3 (read it from
`wifi_ap_record_t` after association — it decides which row of §3's table applies); (b) the real
per-PINGREQ energy at keepalive 60 s, which is the only estimate in §3's winning row.

---

## 10. 2026-09-23: what the first W6 bench session changed (RAM, catrust, retry storm)

Sources: `build/bench-logs/phaseAG-wifi.log`, `phaseAG-wifioff.log`, `phaseAF-boot.log`;
`firmware/build/school_pager.elf` at `ea05271`; two builds made for this section under the
session scratchpad. Numbers marked `(measured)` come from one of those; `(estimate)` still names
its assumption and, now, the log line that will replace it.

### 10.1 The flash and the RAM the pager actually has

- **WiFi is in the debug image only, today** `(measured)`. Every caller of `wifi_sta_start()` /
  `net_xport_switch(NET_XPORT_WIFI)` is the console, and the console block is inside
  `#ifdef PAGER_DEBUG_NO_LIGHT_SLEEP` (`firmware/main/main.c:1113-1300`), so `--gc-sections` drops
  `esp_wifi`, `esp-tls`, mbedtls' TLS record layer and `esp-mqtt` from a release build entirely.
  Release app image **642,128 B (31 % of the 2 MB slot)**, no `esp_wifi_init` symbol; debug app
  image **1,239,200 B (59 %)**. The delta — **597 kB** — is the measured answer to §8's
  "490–650 kB" flash estimate. Consequence to plan for: the first non-console way to turn WiFi on
  (W3's `cfg.wifi`, or the device menu) moves that 597 kB and the whole RAM budget below into the
  **release** image too. That is the moment this section's configuration stops being optional.
- Static DRAM, debug image `(measured)`: `.dram0.data` 37,988 B + `.dram0.bss` **198,768 B**;
  `.iram0.text` 99,499 B. Heap left over: **132,684 B in three regions** (77,608 + 22,308 + 32,768;
  `phaseAF-boot.log:20-22`), no PSRAM. Free at `modes_boot()`: **80,212 B**
  (`phaseAF-boot.log:54`) — the other ~52 kB goes to the 16 kB main-task stack, the modem library,
  NVS, the console REPL and the event loop.
- Both cache levers are already spent or nearly free: `CONFIG_ESP32S3_INSTRUCTION_CACHE_16KB` is
  already set. `CONFIG_ESP32S3_DATA_CACHE_32KB` → `16KB` would add **one more 16 KiB DRAM region**
  at `0x3C000000` (`esp-idf/components/heap/port/esp32s3/memory_layout.c:94-99`) at the cost of
  halving the flash-rodata cache for *both* transports. **Held in reserve, not taken.**

### 10.2 Why `mbedtls_ssl_setup` returned `-0x7F00`

`MBEDTLS_ERR_SSL_ALLOC_FAILED`. With `CONFIG_MBEDTLS_ASYMMETRIC_CONTENT_LEN=y`,
`IN_CONTENT_LEN=16384` and `OUT_CONTENT_LEN=4096`, that one call wants **one contiguous 16,685 B
block** plus a second of 4,397 B, before any certificate is parsed. Peak at the handshake, old
configuration `(estimate)`:

| Term | Bytes | Note |
|---|---|---|
| mbedtls in buffer | 16,685 | **one contiguous block** — this is the alloc that failed |
| mbedtls out buffer | 4,397 | contiguous |
| esp-mqtt task stack + in/out buffers | ~8,200 | `MQTT_TASK_STACK` 6144 + 2 × `buffer.size` 1024 |
| pinned CA + peer chain as `mbedtls_x509_crt` | ~8,000 | EMQX leaf + one DigiCert intermediate, ~2.8 kB DER |
| ECDHE (secp256r1) + RSA-2048 verify working set | ~5,000 | transient |
| ssl context / config / entropy / ctr_drbg | ~2,000 | |
| **peak** | **≈44 kB** | of which 16,685 B must be one block |

Against it: `esp_wifi` + lwIP take **45–52 kB** `(estimate)` of the 80,212 B — 10 × 1600 B static RX
buffers (16,000), 5 static RX mgmt buffers, the 6,656 B driver task stack, PHY/RF calibration, the
3,072 B tcpip task, netif/DHCP, and WPA3-SAE state. That leaves **≈32 kB free** and a largest block
well under 16,685 B. The handshake could not start. Nothing about TLS was wrong.

**The estimate is now instrumented, not inferred.** `firmware/main/wifi_sta.c:124-129` logs
`heap free=… largest_8bit_block=…` the instant the driver is up, and
`firmware/main/xport_wifi.c:317-319` logs the same pair immediately before
`esp_mqtt_client_start()`. Those two lines decide between "not enough total" and "not enough
contiguous" without another guess. (`main.c:1009`'s existing heap line sits *after* the
`!st.mqtt_connected` early return, so the failing path never reached it.)

### 10.3 The configuration, and the honest verdict

Committed to `firmware/sdkconfig.defaults` (WiFi-path-only: `grep -n 'esp_tls\|mbedtls_ssl'
firmware/main/*.c*` finds no user outside `xport_wifi.c`'s error reporting — LTE does TLS inside
the Sequans modem, and `setup.c`/`auth.c` use mbedtls for HKDF/HMAC/SHA only, so **none of it can
regress LTE**):

| Symbol | Was | Now | Effect |
|---|---|---|---|
| `MBEDTLS_SSL_IN_CONTENT_LEN` | 16384 | **8192** | contiguous need 16,685 → **8,493 B** |
| `MBEDTLS_SSL_OUT_CONTENT_LEN` | 4096 | **2048** | 4,397 → 2,349 B |
| `MBEDTLS_DYNAMIC_BUFFER` | n | **y** | both buffers become per-record and are freed when idle; turns the two rows above from a peak into a transient |
| `MBEDTLS_CERTIFICATE_BUNDLE` | y (FULL) | **n** | **64,057 B of flash** (`build/esp-idf/mbedtls/x509_crt_bundle`), no RAM effect. §5 already rejects the bundle as a trust store and nothing calls `esp_crt_bundle_attach()` |
| `ESP_WIFI_STATIC_RX_BUFFER_NUM` | 10 | **6** | −6,400 B, permanently, at `esp_wifi_init()` |
| `ESP_WIFI_DYNAMIC_RX_BUFFER_NUM` | 32 | **12** | a cap: −~32 kB off the burst peak |
| `ESP_WIFI_DYNAMIC_TX_BUFFER_NUM` | 32 | **12** | a cap: −~30 kB off the TX peak |

The WiFi buffer numbers sit between ESP-IDF's own ESP32-S3 "Default" (8/32/32, 183.9 kB available)
and "Minimum" (3/6/6, 273.6 kB) ranks (`esp-idf/docs/en/api-guides/wifi.rst`, "How to Configure
Parameters"); `ESP_WIFI_RX_BA_WIN=6` stays legal (that table's rule: BA win ≤ min(2 × static_rx,
dynamic_rx) = min(12, 12)). Throughput is irrelevant here — one ≤640 B message every few minutes.
`MBEDTLS_DYNAMIC_FREE_CONFIG_DATA` is **not** set: its own Kconfig help says the caller must
re-register the certificate and key afterwards, which is a correctness risk on the reconnect path
for ~2 kB. `IN_CONTENT_LEN=4096` is **not** taken: EMQX's flight is ~3.3 kB, so 4096 has no margin
for a broker certificate rotation that adds a chain link; 8192 has 2.5×.

**Predicted after these changes** `(estimate — the two new log lines settle it)`: free after the
driver is up **≈38.6 kB**; handshake peak **≈27–32 kB**; margin **≈7–12 kB**. That fits, and it is
also the honest bad news:

> **WiFi TLS does not fit alongside the current static footprint with the ≥ 40 kB of headroom this
> review was asked for.** `sdkconfig` alone buys a thin pass. The 40 kB target needs 194 kB of
> `.bss` to give back ~31 kB, and two items carry all of it:
>
> - `firmware/main/msg.c:712` `static msg_t decoded[MSG_THREAD_DEPTH]` — **13,056 B**, used once,
>   inside the boot-time msghist restore. Heap-allocate and free it there: **+13.1 kB**, permanently.
> - five static `ident_t` scratch copies, **4,460 B each = 22,300 B**: `ident.c:133`,
>   `modes.c:489`, `setup.c:752`, `catrust.c:405`, `catrust.c:514`. Every one is a scratch buffer
>   inside one function, all on the main/console task, none reentrant with another. Collapse to one
>   shared scratch: **+17.8 kB**.
>
> Together **+30.9 kB** → free after the driver is up ≈**69 kB**, margin ≈**37–42 kB**. Both also
> hand the LTE-only release image the same 31 kB. Next tier if ever needed, in order:
> `cafetch.c:495 s_parser` 4,644 B (live only during a CA fetch), `setup.c:630 s_bundle_buf` +
> `setup.c:741 plain` 8,192 B (setup only), `catrust.c:320 s_apply_pem` + `setup.c:772 fetched_pem`
> 8,194 B (PEM scratch). `disp.c:57/:64`'s `s_fb_old`/`s_fb_snap` (9,472 B) are the e-paper diff
> planes and are **not** candidates.

Two open questions this section does not answer, with their cheapest experiments:
**(a)** does EMQX serverless honour RFC 6066 `max_fragment_length`? If it does, a 512 B fragment
makes `IN_CONTENT_LEN` a non-issue at any static footprint. Laptop-only check, no hardware:
`openssl s_client -maxfraglen 512 -connect <host>:8883` and look for the extension echoed in the
ServerHello. **UNVERIFIED.** **(b)** the exact `esp_wifi` + lwIP heap cost on this board — the two
new log lines, one `wifi on`.

### 10.4 Two firmware defects the session exposed

1. **A WiFi TLS failure drove the LTE CA state machine.** `xport_wifi.c` never calls
   `catrust_on_mqtt_tls_fail()` — but `modes.c`'s `handle_mqtt_loss()` (`modes.c:1497-1518`) calls
   it *for* any transport that reports `NET_MQTT_RC_TLS_FAIL`, which is what produced
   `modes: TLS handshake failed while pinned` (`phaseAG-wifi.log:262`) from an ESP32-side heap
   failure. One more failure would have run `net_tls_configure(slot, false)` on the **modem** and
   written `ident_set_tls_broken()` — i.e. `/status tls:"broken"`, which per §4 then refuses
   `cfg.wifi.nets` pushes. A WiFi RAM problem would have downgraded the LTE security posture and
   locked out WiFi provisioning. **§5's rule is therefore about the class reported, not only about
   who calls what**: the WiFi transport reports `NET_MQTT_RC_TRANSIENT` and keeps the TLS detail in
   its own log line and a counter (`xport_wifi.c:190-212`). This holds for `verify_flags != 0` too:
   a certificate the ESP32 cannot verify is still not evidence about the modem.
2. **A failed WiFi connect never backed off.** With `network.disable_auto_reconnect = true`,
   esp-mqtt's client task parks in `MQTT_STATE_WAIT_RECONNECT` after a failed connect and the client
   *handle* stays allocated (`esp-idf/components/mqtt/esp-mqtt/mqtt_client.c:1661-1680`). `wifi_up()`
   returned `true` for that handle, so `net_session_up()` reported success: `modes.c:2493`'s
   `up_ok` path never reaches `schedule_backoff()`, `next_session_retry_us` stayed in the past, and
   no connect guard was armed so `net_connect_in_flight()` (`modes.c:2486`) did not hold the branch
   either → **one retry log line per 100 ms loop pass for 75 s, and a WiFi transport that could not
   recover without `wifi off`**. Fixed where the lie was told, not in `modes.c`: `wifi_up()` now
   reaps a client that is neither connected nor in flight and issues a real connect
   (`xport_wifi.c:242-262`), so every WiFi attempt is observable to the existing 5/15/60/300 ladder
   exactly like `xport_lte.cpp`'s. §2's "3 consecutive failures → LTE" is now real too, counted on
   `MQTT_EVENT_DISCONNECTED`-without-SUBSCRIBED and acted on in `wifi_service_session()`
   (the only WiFi code that runs on `modes.c`'s task, which matters because
   `esp_mqtt_client_stop()` may not be called from the esp-mqtt event handler).
   **No `modes.c` edit was needed.**

Two costs this creates, both bounded and both worth a line in the next bench report:
`esp_mqtt_client_stop()` waits on `STOPPED_BIT` while the parked task is inside a poll of
`wait_timeout_ms / 2 / portTICK_PERIOD_MS` = 500 ticks, so **`wifi_down()` can block its caller up
to ~5 s** — once per retry, on the main loop, while WiFi is already down. If that shows up as a
delivery delay, `esp_mqtt_client_reconnect()` is the cheaper reap (no task churn, no 5 s wait) and
the fix becomes one line instead of a destroy/recreate. Second: after the §2 fallback, `modes.c`'s
`backoff_index` still holds whatever WiFi grew it to, so a *failing* LTE bring-up after a fallback
could wait out up to 300 s; the bring-up inside `net_xport_switch()` itself is immediate.

### 10.5 Corrections to earlier sections

- §4's "a WPA2/WPA3 transition AP will associate as WPA2" is **false on this AP** `(measured)`:
  `phaseAG-wifi.log:67` reports `security: WPA3-SAE` with `threshold.authmode = WIFI_AUTH_WPA2_PSK`
  set — the threshold is a floor, not a ceiling. `CONFIG_ESP_WIFI_ENABLE_WPA3_SAE` must stay `y`,
  and SAE's association-time heap is part of §10.2's WiFi term.
- §3's DTIM question is answered for this AP `(measured)`: `DTIM period = 1`, beacon 102400 µs
  (`phaseAG-wifi.log:73`), with `ps type: 1` (`WIFI_PS_MIN_MODEM`) and `li: 10`. So the §3 rows to
  plan against are the **DTIM 1** columns: 40.1 mA plain Modem-sleep, 2.45 mA with automatic light
  sleep — not the DTIM 10 figures row (c) quotes. `wifi status` still prints `dtim: n/a`.
  Re-read §3's conclusion with that substitution: phase 2 lands at ≈2.8–3.1 mA, which is **better
  than LTE's 4.0–4.5 mA but not the 2.5–3× win** row (c) claims.
- `WIFI_DESIGN.md` §8's "trim to 6/16 if W0's heap watermark is uncomfortable" is superseded by
  §10.3's table (6/12/12).
- `firmware/sdkconfig` **overrides** `sdkconfig.defaults` — an existing one keeps whatever it had
  (the same trap `CONFIG_WALTER_MODEM_MAX_TLS_PROFILES` documents in that file). It is why W5's own
  `CONFIG_ESP_WIFI_SOFTAP_SUPPORT=n` / `CONFIG_WS_TRANSPORT=n` were still `y` in the phaseAG image,
  and why they are worth **58,828 B of `.flash.text`** the moment the file is regenerated
  `(measured)`. Delete `firmware/sdkconfig` and `idf.py reconfigure` before the next bench build.
