awong-dev/pager/hardware/carrier/HANDOFF-v0.2.md

# Cassette / faceplate changes — summary (21 Oct 2026, late evening; uncommitted, for owner review)

Brief: make the carrier screw-mountable for the 3D-printed display cassette. Everything below is folded into the
v0.2c layout work (same pipeline, same files); nothing committed.

## 24 Oct 2026 early: outline closed, silk tidied, GND pours added (on the owner's hand-routed board 97e6cea)
- **Outline** rebuilt as one closed loop: x 74.3..113.15, y 57.4..106.3, SIM notch x 81.407..91.745 / y 89.916..106.3,
  1 mm corner arcs, tin arc top-left kept. The two 0.03 mm gaps and the stray stubs are gone.
- **Silk**: 51 0402/LGA parts now use `pager-carrier:*_NoSilk` footprints (library copies of the KiCad parts with the
  outline removed, so no lib-mismatch warnings); schematic Footprint fields updated to match. J6's silk box now stops
  short of the shield pads (library + board). Reference text re-placed for U3 U4 U5 U6 J2 J3 J7; hidden where no clear
  spot exists (U1 U2 U7 J4 J5 SW2). Stale "USB" / "KBD" / "SW2 travel" board texts deleted.
- **Pours**: GND on F.Cu and B.Cu, clearance 0.2, min width 0.2, thermal reliefs (gap 0.25, spoke 0.3), islands
  removed. Three stitching vias added where a top-side GND group had no path to the plane: (101.58, 85.84),
  (76.9, 83.3) and one on the U3 side. B.Cu is one plane piece apart from a 7.7 mm2 pocket under U4 fenced by the
  AON/AWK I2C jogs.
- DRC 278 -> 28. Left for the owner: 4 clearance errors (3V3 vs U7-SW at 93.3,80.2; EINK_BUSY vs GND track at
  97.7,87.8), H1/H2/H3 parked at the origin (6 errors), 4 hole-to-hole warnings between vias at (84.7,81.0),
  (91.2,75.3)/(91.7,75.9)/(92.5,75.8), (93.1,69.8)/(93.5,70.3); unrouted VBUS (R23) and ACC_INT1 (missing via at
  84.7,80.1); 8 self-overlap silk warnings inside the library SW2 and Q4 footprints; M1 lib mismatch.

## 22 Oct 2026 pm: J7 battery connector -> JST SH, netclasses for the hand layout
- **J7 BATTERY is now JST SH SM02B-SRSS-TB** (side entry, 2.9 mm tall, 1 A/contact), LCSC **C160402** (extended,
  79k in stock 22 Oct 2026), same part family as J3/J4/J5. Replaces the 5.5 mm PH S2B-PH-SM4-TB that collided with the
  display back; that open item is closed. Schematic + board footprint swapped (board J7 at 115.5, 84.75, 3D model from
  the KiCad library). Pad 1 = VBAT (+), pad 2 = GND, as before; check the battery lead polarity when crimping.
- Netclasses (commit 3b36a5f): Default 0.15/0.15, PWR 0.4 (VBUS, U5-IN, SYS, SYS_SW, VBAT), PWR_MED 0.25 (frontlight,
  haptic, 3V3_AWK, EXT_LED, buck SW node); one via 0.5/0.3 everywhere (JLC 2-layer minimum).
- Owner is redoing the layout by hand, all parts on the top side; the committed routing is a reference only.
- Noticed, not changed: J2 CARDKB has the SH SM04B footprint but MPN/LCSC say PH S4B-PH-SM4-TB (C265102). One of the
  two is wrong; SH 4-pin would be SM04B-SRSS-TB, LCSC C160404.

## Autorouter alternatives (assessed 22 Oct 2026, owner asked about OrthoRoute-Metal)
OrthoRoute (bbenchoff) is a GPU PathFinder router that lays a Manhattan lattice on many inner layers for backplanes
and BGA escapes; its README says "not a general-purpose PCB autorouter", and the PCBWorld benchmark (Song et al.)
measured a 1-2 % clean-pass rate / 30-51 % routability on ordinary boards. OrthoRoute-Metal (ParkWardRR) is only an
Apple-Metal port of its shortest-path kernel. On a 2-layer board with no inner lattice layers it cannot do better
than Freerouting here, so it was not tried. Freerouting stays the tool; its remaining gaps are hand-finished.

KiCadRoutingTools (atomic14, Rust A*, reads .kicad_pcb; scratchpad krt_src + ocpvenv) was tried three times on the
same base (22 Oct 2026, 00:00-00:10): defaults -> 7 open signal links but 10 micro-vias 0.25/0.15, 0.1 mm clearances,
tracks in the hole annuli and at the edge (its "fab tier ladder" escalates past JLC standard); JLC floors pinned with a
--fab-overrides file at 0.2 mm clearance -> 22 open; on the Freerouting routing copy (grown pads, 0.15 mm, via margin
1.3) -> 16 open + 41 track-to-via-hole (0.33 mm) violations, which it cannot express (one clearance value). Verdict:
not better than Freerouting under JLC rules; keep Freerouting + hand finishing. Recipe kept in scratchpad krt/ (jlc_fab*.txt,
annulus_zones.py adds board-level copies of the H1-H3 keep-outs, which KRT needs because it ignores footprint rule areas).

## Final state at 00:40 PDT 22 Oct 2026 (end of the overnight session)
Board = commit bd66a45: Freerouting top-biased variant 17 (via cost 20, B.Cu trace cost 2.2/4.0) + redundant GND via
pruning (19 removed, 17 kept) + grid repair of the five test-point links and a few others + pour-island stitching
(85 stitch vias added; thin them by hand if too many). **DRC 0 errors; 9 unconnected: 4 GND pour islands and 5 signal
links: Q1A-E1, U1-VBUS, U7-MODE, Q1B-B2, Q1B-E2** (all short, bottom side around U1/Q1 and under U7). Was 18 open +
TPs unrouted at bedtime. STEP re-exported. Snapshots: scratchpad layout2/pcb_run12_tpfix.kicad_pcb (final),
pcb_run10_bias_v17, pcb_run11_pruned. Freerouting settings file restored to defaults.
Pipeline fixes tonight: mkdsn_2.py keeps on-board test points routable (only parked ones are detached);
fixnet_tp.py = fixnet2 that also repairs TP pads; gndprune.py (verified pruning); biasrun.sh / freerouting.bias.json.
Not committed: pager-carrier.kicad_pro / .kicad_prl show edits (via size list, designators) that KiCad made in your
session, not mine; commit or discard as you like. J7 PH header height (5.5 mm) is still the open mechanical question.

## Morning summary (22 Oct 2026, automated)
```
23:53 variant 2: errors 0, open signal links 22 (295 wires)
23:55 variant 3: errors 1, open signal links 20 (263 wires)
23:58 variant 4: errors 0, open signal links 24 (266 wires)
00:00 variant 5: errors 0, open signal links 19 (300 wires)
best: variant -1 with 18 open (owner cut the plain trials to 4)
no plain variant beat 18; board unchanged
threshold to beat: 18 open links
00:03 variant 12: errors 0, open signal links 24 (283 wires)
00:07 variant 13: errors 0, open signal links 29 (245 wires)
00:09 variant 14: errors 2, open signal links 15 (313 wires)
00:12 variant 15: errors 0, open signal links 24 (290 wires)
00:14 variant 16: errors 2, open signal links 20 (286 wires)
00:18 variant 17: errors 0, open signal links 15 (316 wires)
best: variant 17 with 15 open (current board: 18)
installed board: errors 0 unconnected 20 {'GND': 6, 'TP': 5, 'VBUS': 1, 'Net-(Q1A-E1)': 2, 'Net-(U1-VBUS)': 2, 'Net-(U7-MODE)': 1, 'Net-(Q1B-B2)': 1, 'Net-(Q1B-E2)': 2}
committed 84e20c7 Carrier: top-biased re-route (via cost 20, B.Cu trace cost x2.2), Freerouting variant 17 (15 open signal links, was 18)
baseline unconnected: 20
removed 19 redundant GND vias: [(79.47, 71.3, ['C15.2']), (92.85, 63.46, ['R2.2']), (98.05, 59.14, ['R6.2']), (89.79, 65.51, ['U1.25']), (89.31, 72.05, ['R27.2']), (89.66, 58.2, ['R29.2']), (106.52, 69.89, ['Q3.2']), (80.14, 63.4, ['R31.2']), (92.08, 61.14, ['SW1.2']), (95.06, 62.4, ['R4.2']), (84.0, 72.8, ['U5.11']), (87.97, 69.0, ['C13.2']), (108.8, 82.92, ['C17.2']), (112.4, 82.85, ['J7.2']), (
kept 17 (needed for pour continuity): [['C6.2'], ['C10.2'], ['C11.2'], ['J2.1'], ['C9.2'], ['J4.2'], ['U6.9'], ['J1.2'], ['C16.2'], ['C8.2'], ['C1.2'], ['SW1.2'], ['R38.2'], ['R36.2'], ['R25.2'], ['C12.2'], ['R12.2']]
after prune: errors 0 unconnected 20 {'GND': 6, 'TP': 5, 'VBUS': 1, 'Net-(Q1A-E1)': 2, 'Net-(U1-VBUS)': 2, 'Net-(U7-MODE)': 1, 'Net-(Q1B-B2)': 1, 'Net-(Q1B-E2)': 2}
```
Redundant GND vias (pad already on the pour, verified one by one with a connectivity rebuild) were pruned on the
final board; the ones kept are needed for pour continuity. Snapshots: scratchpad layout2/pcb_run9_*, pcb_run10_*, pcb_run11_pruned.

## Night of 21/22 Oct 2026 (owner asleep): optimisation pass + ten more trials
- Committed: 3a4011e (USB-C model upright, pours refilled, owner's VBUS_DET to 0.127 mm), bacfce7 (switch model
  re-saved in mm via OpenCascade so the STEP export includes it; scratchpad ocpvenv + convstep.py).
- **Route "optimisation" pass rejected**: exporting the routed board with only the hand-routed nets + VBUS_DET
  fixed and letting Freerouting re-route/optimise the rest gave the same segment count and corner histogram
  (863 segments, 62 right angles vs 853/61) plus 2 shorts and 2 clearance errors. The jaggedness is inherent to
  Freerouting's output; smoothing needs a clearance-aware geometry pass (not written) or hand clean-up in KiCad.
  Useful numbers for that: 84 segments < 0.15 mm, 61 right-angle corners, 497 45-degree corners.
- **Ten more trials** (overnight.sh, seeds 2-11) on a pre-route base rebuilt from the owner's board (test points
  placed, VBUS_DET hand route and the board's GND items kept as fixed). Each variant is fully restored, poured and
  DRC'd; the best (0 errors, fewest open signal links) is installed, STEP re-exported, snapshotted as
  scratchpad layout2/pcb_run9_overnight_v<k>.kicad_pcb and committed. Log: scratchpad layout2/overnight.log.
  If no variant beats 18 open links nothing is installed.

## What changed
- **SW2 power switch**: MSK12C02 (right-angle knob) -> **C&K JS102011SAQN**, top-actuated SMD SPDT slide switch,
  LCSC **C221660** (extended part, 369 in stock on 21 Oct 2026). Body 9.0 x 3.6 mm, 2.0 mm housing, **3.2 mm overall
  with the 1.5 mm knob** (datasheet 3.5 max). Travel along X (silk text "SW2 travel <-->" below it). Footprint
  `Button_Switch_SMD:SW_SPDT_CK_JS102011SAQN` (KiCad lib; 3 gull-wing pads 1.25 x 2.5 on 2.5 mm pitch + two 0.9 mm
  locating pegs). 3D model: owner's `JS102011SAQN--3DModel-Eagle-1.STEP` copied to `pager-carrier.3dshapes/`
  (inch model, rotate -90 about X, no offset; pegs/feet verified on the pads by render). Schematic symbol value,
  footprint, MPN, LCSC and datasheet updated in power_components.kicad_sch.
- **Top-strip zone** (hinge side), left to right after the H1 hole: **J6 USB-C, SW1 (KMR2 button), SW2** — one
  contiguous zone. Courtyard extents: x 80.0..108.5, y 57.8..66.6 (J6 80.0..91.8 x 58.8..62.8; SW1 92.1..97.8 x 58.9..62.6; SW2 98.4..108.5 x 57.8..66.6) (board frame; the plate's step-down window goes over this).
  SW2 sits right of the Walter's header column because its 8.8 mm-deep courtyard would otherwise cover Walter pin 1.
- **Keyboard header J2** stays the topmost header of the right-edge column (hinge side): J2 at (117.1, 61.65),
  cable opening at the board edge x 120.5, so the cable turns straight into the plate's channel at kx 117-127.
  Column top->bottom: J2, J1, J7, J3, J4, J5, all facing +X.
- **Board grew to x 120.5** (was 115) to fit the two right-side holes beside the header column; outline otherwise as
  v0.2c (y 57.4..108.4, keepout step at y 106.3 over the Walter, SIM eject hole at (86.25, 93.2)).
- **Cassette screw holes H1-H3**: footprint `pager-carrier:MountingHole_2.2mm_M2_Cassette` = 2.2 mm NPTH + 4.5 mm
  courtyard both sides + 4.5 mm rule areas on F.Cu and B.Cu (no tracks/vias/pour). Schematic symbols H1-H3
  (Mechanical:MountingHole, not in BOM) in core_components.kicad_sch. DRC rules "Cassette standoff annulus H1..H3"
  (physical_hole_clearance 1.15 mm from the hole edge = 4.5 mm annulus, copper layers) added to pager-carrier.kicad_dru.
  **Hole centres (plate datum, board frame / Fusion frame):**
  | hole | board (x, y) | Fusion world (x, y) = (ky-101.27, kx-2.03) | where |
  |---|---|---|---|
  | H1 | (77.40, 60.90) | (-40.37, 75.37) | tin-corner end of the top strip, left of J6 |
  | H2 | (111.20, 59.95) | (-41.32, 109.17) | top edge, between SW2 and J2 |
  | H3 | (111.20, 105.85) | (4.58, 109.17) | bottom edge, left of J5 |
  H2/H3 could not go into the right-edge corners: the six headers fill the whole right edge (50.2 of 51 mm), so the
  holes sit 9.3 mm in from the right edge, on the top/bottom edges (allowed by the owner's "board may grow / headers
  need not be flush" note). H1 is as close to the tin corner as the arc + 0.3 mm edge rule allows.
- **Height check (step 5)**, from the STEP models (carrier top = z 10.6): outside the top strip everything is <= 1.25 mm
  (C6/C7 0805) except **J7 JST PH S2B-PH-SM4-TB: 5.5 mm tall -> top at z 16.1, above the display glass back (15.5)**.
  Not changed (part choice): swap it for a 2-pin SH (SM02B-SRSS-TB, 2.9 mm, 1 A, same as J3-J5, needs the battery
  lead re-terminated) or move the battery header into the top strip. Walter header pins: 5 mm -> trim (see note).
  Top strip: USB-C 6.5 mm (z 17.1), SW2 3.2 mm, SW1 1.9 mm, SH headers 2.96 mm.
- **F.Fab note** at (97, 103.5): trim the 28 Walter header pins flush with the solder fillets after soldering.
- **3D models added** (owner-supplied, in pager-carrier.3dshapes): MAX17048 (U6, rotate -90 X), JST PH (J7, rotate
  -90 X, offset y -4.45), JS102011SAQN (SW2). The USB-C real model was restored (the working copy had reverted to
  the placeholder).

## Verification
- ERC (kicad-cli sch erc, in hardware/carrier): before 0 violations -> after 0 violations.
- DRC: before (run-6 raw board) 15 clearance + 5 solder-mask-bridge errors, 20 unconnected; after: 0 errors (warnings only: 199 silk overlaps of 0402 outlines, 21 silk over copper, 4 silk-edge, 6 dangling vias, 1 lib mismatch); 28 unconnected = 11 parked TPs + 3 GND islands + 14 signal links: 3V3 x4, Q1B-E2 x3, Q1A-E1 x2, U1-VBUS x2, VBUS_DET, Q1B-B2, BRG_3V3 (all local, bottom side around U1/Q1 and the 3V3 rail near U7/U4).
  TP1-TP11 unconnected is the accepted pre-existing state. Annulus check: the three per-hole rules in pager-carrier.kicad_dru report no violation on the final board (pours and tracks are kept out by the footprint rule areas on both layers); the earlier draft rule flagged the hole's own courtyard, hence the copper-only, other-footprint-only form.
- STEP: `kicad-cli pcb export step` -> hardware/carrier/out/pager-carrier-v02c-cassette.step.
- Routing: re-routed from scratch (Freerouting, run 8, net-order variant 1 of 2 after the U7 ground via was removed; an earlier run with that via left SYS_SW entirely unrouted), light post-processing only (pours, no stitch/repair);
  remaining opens listed under DRC are for hand finishing, as agreed.

## Files touched (all uncommitted)
pager-carrier.kicad_pcb (snapshot: scratchpad layout2/pcb_run8_cassette_final.kicad_pcb), pager-carrier.kicad_dru,
power_components.kicad_sch (SW2), core_components.kicad_sch (H1-H3 + MountingHole lib symbol),
pager-carrier.pretty/MountingHole_2.2mm_M2_Cassette.kicad_mod (new), pager-carrier.3dshapes/ (SW_SPDT_CK_JS102011SAQN.step,
MAX17048_TDFN-8_2x2mm.step, JST_PH_S2B-PH-SM4-TB.step new; USB-C restored), out/pager-carrier-v02c-cassette.step (new).
Pipeline: scratchpad layout2 (base_v02c.py builds v02base.kicad_pcb from v01 + SW2 swap + H1-H3 + notes + models;
plan2.py anchors; handroute2.py corner routes follow J6; minipost.sh = light post-processing).

## Not met / to decide
- Hole positions H2/H3 are on the top/bottom edges 9.3 mm in from the right edge, not in the right-edge corners (the
  header column fills that edge). If you want true corner holes, the column must shrink (J7 -> SH saves 3.4 mm) or
  the board must grow further.
- J7 (JST PH, 5.5 mm) exceeds the 2.9 mm height limit outside the top strip and would touch the display back; part
  choice left to you.
- 14 signal links + 3 GND islands remain for hand routing (list above); Freerouting could not close them in the
  bottom-side bridge area.

---

# Carrier board v0.2c — handoff addendum (21 Oct 2026, afternoon)

Read this section first; the v0.2b notes below still describe the tools, but the outline, decisions and pipeline
location changed. Session scratchpad: `/private/tmp/claude-501/-Users-albert-src-pager/30499713-6299-4751-a029-fb918966b264/scratchpad/layout2/`
(scripts re-pointed there; `geom.py` = v0.2c outline, `plan2.py` = anchors, `clean.py` draws the outline + eject hole +
WiFi keep-out rule area, `handroute2.py` = 2-layer USB-C corner + BQ25185 escapes + BRG_3V3, `prep2.sh`/`search2.sh`/
`post2.sh`/`final_check2.sh` as before). Snapshots of the v0.2b versions: `geom_v02b.py`, `plan_v02b.py`, `clean_v02b.py`.

## Owner decisions (21 Oct pm, binding)
- Only hard constraint: fit the Altoids tin. X: board edge at the Walter's edge (74.3), not just hugging the header.
  Right edge may grow a little (now 115.0). The e-ink sits above the carrier: the board may extend under it.
- Y: into the WiFi keepout "only a little"; prefer covering the SIM holder with a pin-eject hole over covering the keepout.
  v0.2c: y 57.4..108.4 on the right strip (x > 99.2), 106.3 (= keepout line) over the Walter; the band y > 106.3 is a
  no-copper rule area. SIM notch removed; 2.0 mm eject hole at (86.25, 93.2) over the holder's inner end — **verify
  against the physical Walter** (card inserted from the antenna end, push-pull holder, 1.95 mm under it).
- The M8 antenna stub enters the far long wall right of the Walter (x > 99.2); exact x range not given, so the right
  strip's far edge stays at 108.4 (4.9 mm from the wall). Ask before growing it.
- Still: 2 layers only, six cable headers face +X on the right edge, keep v0.2 uncommitted until reviewed.

## Tin geometry (from "Assembled v0.1.step", replaces the eyeballed R19 arc)
Mapping STEP world -> KiCad: kx = world_y + 2.03, ky = world_x + 101.27. Tin inner walls y 56.13 / 113.32, end wall
x 68.47 (tin runs to x 160.8); all corners R 13.22 inner, the two near the Walter centred (81.69, 69.35) and (81.69, 100.1).
Board arc: centre (81.69, 69.35), R 12.22 (1 mm margin); the bottom-left corner (74.3, 108.4) is inside the lower arc.
Walter datasheet: 3.3 mm carrier-to-Walter gap, 1.95 mm under the SIM holder; keepout 24.8 x 6 mm from the antenna end.

## Placement (plan2.py)
Right edge top->bottom: J2 (111.6, 61.65), J1 (111.6, 72.85), J7 (109.8, 84.75), J3 (111.6, 92.65), J4 (111.6, 98.85),
J5 (111.6, 105.05), all rot 90 (JST SH cable opening is +y in footprint coords -> +x). Top strip J6/SW2/SW1 unchanged.
Q1 auto-reset cluster moved to the bottom next to Walter pin 1 (Q1 (94.0, 63.2) B). U5 at (84.0, 71.6), C13 right above
it (86.0, 69.0). Bridge channel y > 92 between the rows kept free of auto parts; bottom side reserved over the SIM holder.
KiCad flips footprints top/bottom (mirror y) — plan2.rot_xy now models that.

## USB-C corner, 2 layers (handroute2.py)
VBUS ties A4-B9 / B4-A9 straight on F; D+ row tie = 0.15 mm F diagonal between the rows (from the pad edges, 0.23 mm to
the neighbours); D- row tie B7 -> V4 (81.2, 58.5) -> B.Cu -> VD (79.4, 65.0) -> F through the middle of D1 into pad 1;
A6/A7 down on F into D1.3/D1.1; D1.4/D1.6 -> VA/VB -> B.Cu -> U1.3/U1.4; D1.5 -> VC (router continues); A9 -> VA9 -> U1.7;
BRG_3V3 hand-routed C9 -> U1.6/U1.5 (the router could not reach them). Pre-route DRC: 0 errors.

## State handed over 21 Oct 2026 ~22:00 PDT (owner finishes by hand)
`pager-carrier.kicad_pcb` = run 6 / Freerouting variant 9, **raw**: router output + hand routes + GND pours, no stitching,
no repair passes (snapshot: scratchpad layout2/pcb_run6_v9_raw.kicad_pcb). DRC: 0 errors; 11 parked TPs; open:
SYS_SW x7 (whole net: M1.28, Q4.3, C6/C7, U7.2, R13, R35, R37, C19), Q1A-E1 x2, VBUS, SYS, U1-VBUS, U7-MODE, Q4-G,
U7-VSET, Q1B-E2 (1 each), GND x3 (islands; stitching was skipped). **Root cause of SYS_SW:** the GND via + stub added
above U7 pin 1 (88.45, 75.65) walls off U7 pin 2 (SYS_SW) in the routing copy, so every variant dropped the net —
delete that via/stub (or move it left of pin 1) before re-routing, or route SYS_SW by hand into pin 2 from the left.
Runs 3-5 were wasted by (a) GND-link keep-outs blocking neighbouring pins (fixed: thin keep-outs, mkdsn_2.py) and
(b) editing search2.sh while it ran (corrupted run 5's post-processing). Run 2's board (4 opens) was overwritten.
Lesson recorded in memory: snapshot every run, never edit a running pipeline script.

## Routing runs
Run 1 (old C13/VD): 6 variants, 9 unrouted at the router, after re-insertion 0 DRC errors and 11 open signal connections
(BRG_3V3 x6 unreachable, VBUS x2, CHG_STAT2, VBUS_DET, Q1A-B1) — far better than v0.2b's 7-14 whole nets.
Run 2 (search_c2.log): in progress at hand-off time; see the end of that log / final_check2.sh.

## USB-C 3D model
GCT's real STEP (TraceParts usb4235-03-c.stp) is now `pager-carrier.3dshapes/USB_C_Receptacle_GCT_USB4235_Vertical.step`
with `(rotate (xyz -90 0 0))` in both the library footprint and the board's embedded copy; renders upright on its pads.

---

# Carrier board v0.2 — handoff (21 Oct 2026)

Read this first in a fresh session. It replaces everything learned in the 21 Oct session about the v0.2 layout.

## Goal

Re-lay-out the Walter kid-pager carrier (hardware/carrier, KiCad 10.0.6) as small as possible. v0.1 (63 × 46 mm,
2-layer, fully routed, DRC clean) is committed at 85414e1 / tag `v0.1-carrier`. v0.2 is NOT committed; do not
commit it until the owner reviews it. Never run gen/build.py main, gen/carrier_pcb.py or finish_pcb.py carrier
(they overwrite the hand-edited carrier). Only the panel board is still generated.

## Owner decisions (binding)

- **2 layers only.** Width may grow to the right. If routing still fails after ~6 pipeline iterations, abort and rediscuss.
- The hat may cover the **full Walter width** (x 74.3..99.2); no benefit in hugging the pin rows.
- **No header may face the top or bottom edge** (the board is nearly flush with both tin walls). All six cable
  headers (J1 panel, J2 keyboard, J3 haptic, J4 LED, J5 piezo, J7 battery) face +X on the right edge.
- **Top-left corner must follow the tin's rounded end-wall corner** with a manufacturing margin. From the owner's
  STEP the corner radius is ~15–20 mm; the chosen arc is concentric with centre (87.7, 74.1), radius 19 (1 mm margin).
- The right strip (x > 99.2) overhangs the Walter and sits flush on the battery: **no bottom-side parts there.**
  Bottom-side parts are fine inside the Walter shadow (≤ ~1.1 mm tall: 0402/0603/QFN/VSSOP/SOT).
- Switches SW1/SW2 and the vertical USB-C J6 stay in the top strip (hinge edge), beside the display's footprint.
- Test points TP1–TP11 stay parked off-board (DRC shows them unconnected; that is accepted).
- Open question for the owner: keep the vertical GCT USB4235 (custom footprint, now with a placeholder box STEP in
  pager-carrier.3dshapes; fetch GCT's real STEP when online) or switch to a horizontal library part (GCT USB4105,
  3.2 mm, plug through a wall slot).

## Mechanical facts

- Altoids bottom ~94 × 60 × 21 mm. The Walter (55 × 24.8) sits crosswise at one end, **header side up**, components
  facing down onto the 2500 mAh battery; the carrier is a hat on the Walter's pins, ~2.5–3.4 mm above its back
  (back = nano-SIM holder + test pads). E-ink in the middle on top, CardKB in the lid, M8 antenna stub 2–3 mm into
  the non-hinge long wall.
- Board frame (KiCad mm): Walter header rows at x 77.85 / 95.63, pads y 66.93..99.95 (1.7/1.02 THT); Walter body
  x 74.3..99.2, y 57.2..112.3; SIM holder under x 81.4..91.1, y 91.2..103.6 → SIM notch x 80.9..92.96, open to the
  bottom edge, starting at y 90.0 (owner's v0.1 notch started at 85.47; shortened to free the bridge over the pins
  for routing — mention it in the report).
- Tin walls in board frame: hinge-side long wall y ≈ 54.1, far long wall y ≈ 114.1, end wall x ≈ 67.7.
- v0.2b outline (geom.py): x 74.3..113.0, y 57.4..108.4, 1 mm convex corners, tin arc at the top-left.

## Where things are

- Pipeline: session scratchpad `/private/tmp/claude-501/-Users-albert-src-pager/<session>/scratchpad/layout2/`
  (if the scratchpad is gone, the scripts must be recreated; the 21 Oct session id was df4dc366-ba40-4c7e-83de-0bfb3a07db72).
  Key scripts: `geom.py` (outline), `plan.py` (anchors + numpy auto-placer → placement.json), `clean.py` +
  `apply_place.py` (v01.kicad_pcb → placed.kicad_pcb), `handroute2.py` (scripted escapes), `gndvias.py`,
  `mkdsn_2.py` (routing copy: GND/TP detached, pads grown +0.05/side so the router's 0.15 clearance gives 0.2
  track-to-pad, GND vias → keep-outs, inset outline), `prep2.sh` → `search2.sh` (Freerouting net-order variants,
  `SEEDS="0 1 2 3 4 5" MP=60`) → `post2.sh` (SES import, re-insert pre-routed items, padreach, pours, fixnet2 ×3,
  stitch2 ×4, sliverfix, gndclean, final DRC) → `final_check2.sh`. Freerouting jar: scratchpad/freerouting/freerouting-2.5.0.jar.
- The project board file currently holds the 4-layer attempt (0 DRC errors, 5 open nets). The 2-layer v0.1 is in git.
- Memory notes: carrier-v02-dense.md, carrier-layout-pipeline.md, carrier-kicad-hand-edited.md.

## State of v0.2b (2-layer, new outline) — what is done / not done

Done: geom.py with the new outline + tin arc; clean.py draws it and sets 2 copper layers; mkdsn_2/fixnet2 back to
2-layer. NOT done: plan.py anchors for the new outline; handroute2.py 2-layer USB-C corner; any routing run.

Placement plan for plan.py (anchors are (x, y, rot, side)):
- Top strip: J6 (82.7, 60.79, 0) — the tin arc clears it; SW2 (93.3, 60.7), SW1 (100.85, 60.7); Q1 auto-reset
  cluster (Q1 r180, R39, R7, R8) in the now-free top-right (x 103..113, y 58..65).
- Right edge, facing +X, top to bottom: J2 7.9, J1 13.9, J7 9.3, J3 5.9, J4 5.9, J5 5.9 (48.8 mm; place SH at
  x = 113 − 3.3, the PH2 J7 at x = 113 − 5.15).
- Between the rows (top): D1 ESD under J6, C13/R23, U5 BQ25185 + R26/R27/R25/R24 stack (x 87.6) + C15, Q4,
  C6/C7, U7 + L1 + C8 + R36/R37, U4 + C12. Shift U5 ~2 mm lower than before (to y ≈ 71.6) to free the band under D1
  for the D1→U1 vias. Keep y > 84.3 between the rows free (the bridge over the pins is the channel for the leg nets).
- Bottom (inside the Walter shadow): U1 CP2102N (≈ 85.9, 65.8), U2 LVC (≈ 91.6, 67.0, r180) with ≥1 mm between
  their courtyards, R3, C9, C4, R14, R4, R6, R15/R16 next to the Walter pins 24/25, C11 under U3 pin 1.
- Keep the left strip x < 77 free of parts on both sides (routing channel to the leg pins).
- Right strip top side: U3 DRV2605, Q2/Q3/R12/R9/R10/R13 front-light driver near J1 pins 9/10, R11, U6 + C16/C17
  beside J7, R21 near J4, R19/R20/R22 near J5.

Hand routes that must exist before the router (handroute2.py):
- BQ25185 escapes (0.4 mm pitch): IN up to C13, STAT1/ISET/ILIM/TS with vertical-first jogs to the R stack
  (R26 r180 so its STAT1 pad faces U5), SYS to C15, VBAT and CHG_STAT2 to vias.
- USB-C corner, 2-layer topology: A4↔B9 and B4↔A9 VBUS ties (vertical, between the rows); A9 → via → U1 pin 7;
  A6 → via → D1.3 and A7 → via → D1.1 on top; B6/B7 → vias above the B row; the two row ties cross, so D− ties
  on B.Cu under the rows and D+ ties on B.Cu looping around the connector's LEFT end (x ≈ 76.5, keep y ≥ 59.6 there
  because of the tin arc); CC2 → R29 above the B row; CC1 → via → R31 on the bottom (top side has no room);
  VBUS to D1.5 from below between the D+/D− vias; D1.4/D1.6 → vias → U1 pins 3/4 (enter QFN pads along their axis).
  Iterate with prep2.sh + DRC (≈1 min per cycle) until the pre-route board has 0 errors, then route.

## Tool gotchas (all verified)

- pcbnew: one LoadBoard per process; don't iterate GetTracks after Remove(); `PAD.GetLayer()` ignores the
  footprint flip — use `pad.IsOnLayer(B_Cu)`; `GetParent()` is a container, use `GetParentFootprint()`.
- kicad-cli DRC must run inside hardware/carrier (project-local .kicad_pro/.kicad_dru); elsewhere it uses defaults.
- KiCad's SES import deletes all existing tracks/vias → re-insert pre-routed items (dump to JSON first).
- Freerouting 2.5: chaotic per net order (run 6 variants); `(type power)` is ignored; an exported `(plane …)` zone
  is honoured; a full-layer `(keepout` blocks vias; it routes to the enlarged pads so some wire ends stop ~0.05 mm
  short (padreach.py); fixed wires near enlarged pads count as "violations" but are harmless.
- The JLC rules (pager-carrier.kicad_dru): track-pad 0.2, track-track 0.127 (net class 0.15), track-PTH hole 0.33,
  edge 0.3, hole-hole 0.5. Entering a 0.5 mm-pitch QFN pad with a 0.2 track along the pad axis is fine (0.275).
