awong-dev/pager/.overnight-handoff.md

# Overnight handoff — bridge phone (8→9 Oct 2026)

**Morning of 9 Oct 2026 (owner awake):** "remove twilio again" → commit 663168e (Twilio last present at
05ec3ed; Deploy run 37959279240 succeeded, so the TWILIO_* secrets are destroyed). "implement whats app,
both tiers" → WhatsApp is a third bridge source (WA1–WA9 in docs/BRIDGE_PHONE_DESIGN.md): DMs phone-keyed
through the held/approve path, groups through the Chat subscribe flow, tier 2 DM via wa.me, tier 2 group
via accessibility search by title (best-effort). Commit 8209141; relay 1291 tests, e2e 14 scenarios, Android
41 unit tests. Nothing WhatsApp has run on a phone.

**Afternoon 9 Oct 2026 (owner left mid-session):** CardKB keyboard scan moved to its own task (`kbd`, ui.c; spec
docs/TASK_kbtask.md, survey of other main-loop gaps at its end). Main-loop polling deleted per owner. Bench (sora1):
boots, `kbd: task started cpu1 prio2 period 10ms` at 1.06 s, boot guard -> polling at +1306 ms, loop period
unchanged (~100 ms), no crash. **sora1's CardKB does not answer on I2C** (`i2cscan` 0 devices, baseline and new
build alike), so the real burst test is yours: with a working keyboard type `abcdefgh` fast three times (screen
awake; right after a shake; within 2 s of sending) and expect all eight `CardKB: 0x..` DEBUG lines each time.
Pre-existing bench bug seen: `battstat reboot` spun for 60 s until the task watchdog reset the chip (the RTC WDT
it arms did not fire); not touched. The debug build (no light sleep) is left flashed on the bench unit.

**Evening 9 Oct 2026 (owner away):** "Make the two fixes" -> 897edbb: `/bridge/pair` 409s on a number held by any
member or other bridge (checked before the code is consumed, so the code survives), `get_by_sms_number(prefer_owner=)`,
transactional `record_channel`; 1303 relay tests. Firmware 9e29d50: `kbd` task floats (tskNO_AFFINITY) and wakes the
main loop via task notification (no more 100 ms wait), `net_sleep()` skips a sleep if input is queued at the edge,
wake status refresh deferred until after the first draw (41 ms measured after the first looptime line). Bench smoke on
sora1 passed (injected keys only; CardKB still silent). Architect evaluation of "network work in floating tasks" and
"UI on CPU1" requested: see `docs/TASK_cores_eval.md` (recommendation: neither now). On-demand OTA deltas landed as 4911fd3 (OTA_DESIGN D12): relay generates `fw-cache/` deltas at push time,
Terraform adds the 7-day lifecycle rule and the relay SA's objectCreator grant on the next deploy. First real
on-demand push is yours to verify (Update firmware on a device running an older published build; the dialog
says "delta (made at push)"). Soracom SIM enrollment from the admin UI landed (62e5ea8, rename 32bbcbb): Admin -> Devices -> "Soracom SIMs";
SAM user `relay` key uploaded to Secret Manager, ENABLE_SORACOM_SECRETS=true; both account SIMs already in pager-beam.
rc1 is on beta-82 (pre-Soracom): put the old SIM back, OTA to v1.1.0 (bootloader precondition unrecorded), then swap.

You went to bed after "Google Voice only setup should be possible." Everything below was done
autonomously; every decision taken without you is listed under **Decisions you may want to reverse**.

## What landed (23 commits on main, pushed as 05ec3ed; Deploy run 37905076487 completed successfully 9 Oct 2026 ~01:35 PDT: Terraform apply, hosting, rules + indexes)
- **Design:** `docs/BRIDGE_PHONE_DESIGN.md` (15 decisions, server-architect review applied, orchestrator
  decisions O1–O8 with O1 revised for Voice-only) and `docs/BRIDGE_PHONE_TASKS.md`.
- **Relay (B1–B10):** `bridges` store + pairing codes + bearer auth; `/bridge/*` (pair, events, outbox,
  ack, heartbeat); `bridge` backend kind with the Twilio→bridge transport switch keyed on the member's
  `smsNumber` matching a bridge SIM **or** Voice number; shared inbound text core for Twilio, SIM and
  Voice; Chat conversations (seen/held rows, one `chat_unknown` alert per conversation, subscribe /
  ignore / patch / pause / unsubscribe, roster nicks as `sndr`, groups as `t:"grp"`, DMs as `t:"chat"`);
  family bridges API; server-only rules; `tools/bridge_sim.py` + compose service; e2e `bridge` and
  `bridge_voice`. Code review (14 findings) fixed in B10. **1334 relay tests pass** (1217 before).
- **Web (W1–W6):** Family → Devices "Bridge phones" (pair code panel, SIM/Voice numbers, Voice-only chip,
  accept SIM, reassign, unpair); `/family/chat?uid=` Google Chat tab (subscribe dialog with O5 policy
  gating, roster editor, seen/ignored list, Add by link); `chat_unknown` alert card; address book chips.
  Lint, tsc, build green. **Not exercised against a live relay**, only the e2e-tested backend.
- **Android (A1–A8):** `bridge-android/` Kotlin app, `app.kidpager.bridge`. Builds; **30 unit tests pass**;
  APK at `bridge-android/app/build/outputs/apk/debug/app-debug.apk` (poll-only, FCM off).
  **Never run on a phone.**
- **Docs:** README status, ROADMAP, OVERVIEW, relay/README runbook + phone checklist, GOTCHAS (before-first-
  unlock, Voice contact names), PROTOCOL two additive notes, SERVER_PLAN D4 answered, TWILIO_ACCOUNTS parked.
- **Toolchain on this Mac:** JDK 17 (`/opt/homebrew/opt/openjdk@17`), Android SDK at `~/Library/Android/sdk`
  (platform 35, build-tools 35/34). `JAVA_HOME` must point at 17 for Gradle.

## Your steps (in order)
1. **Deploy is done** (success). It included `firestore.indexes.json` (two new `outbox` collection-group field
   overrides for the tick's stale-fail and sweep queries); nothing to do unless the relay logs show index errors.
2. **Firebase Android app** (for push wakes; optional — poll-only works with ≤60 s outbound latency):
   Firebase console → Add Android app `app.kidpager.bridge` → save `bridge-android/app/google-services.json`
   → rebuild. The build picks FCM up automatically.
3. **Phone setup** (checklist in `bridge-android/README.md` and relay/README "Bridge phones"): sign in the
   child's Google account, Chat + Voice installed with notifications on, **empty contacts list**, screen
   lock **None**, DND off, grant notification access / default SMS role / battery exemption / accessibility,
   enter relay URL + SIM and/or Voice number, pair with the 8-digit code from Family → Devices.
4. **First bench run** of the phone: the README lists what to verify (listener → `bridge in` log line,
   SIM text both ways, Chat alert → subscribe → group page with sender, tier-2 reply on a cold thread,
   Add by link inspect). Expect selector fixes in `Targets.kt` and field fixes in `NotificationMapper.kt`
   (shortcutId, Voice number source, own-message heuristic) — all flagged "verify on bench" in the README.

## Decisions you may want to reverse
- **O2** No long-poll from the phone (Cloud Run cost); 60-s poll + optional FCM.
- ~~**O3** Welcome text skipped for bridge numbers.~~ Moot: welcome text gone with Twilio.
- **O5** Outbound people rule `none` → Subscribe forces read-only instead of 409.
- ~~**O6** STOP numbers not blocked on the bridge SIM.~~ Moot: no opt-out registry any more.
- ~~**Twilio stays** for non-bridge numbers; docs/history/TWILIO_ACCOUNTS_DESIGN.md parked, not deleted.~~ Owner reversed this
  9 Oct 2026 ("remove twilio again"): Twilio removed; last present at commit 05ec3ed.
- **Reassign** unsubscribes every Chat conversation of that bridge (review fix 1), rather than migrating.
- **Group participants are names only** until "Add as contact" (needs a known DM or a pasted link).
- **Held Voice texts** approved later reply on the member's default channel (the hold row has no channel).
- Twilio inbound records no `via` channel (backend's call; avoids a write per Twilio text).

## Known gaps
- Delivery chips cannot tell Voice from Chat (deliveries carry no source). Small relay change if wanted.
- Web never run against a live relay; the simulator exists if you want a manual pass:
  `tools/bridge_sim.py` (see relay/README).
- The docs agent's e2e teardown ran `docker compose down -v`, which removed a `relay-firebase-1`
  emulator container that was running before the session. Restart it if you were using it.
- `relay/pyproject.toml` gained ruff F811 per-file ignores for tests importing `tests/bridge_world.py` fixtures.

## Where to look
Design `docs/BRIDGE_PHONE_DESIGN.md` · tasks `docs/BRIDGE_PHONE_TASKS.md` · relay runbook `relay/README.md`
"Bridge phones" · phone `bridge-android/README.md` · e2e `tools/e2e_v2.py bridge bridge_voice`.
