awong-dev/pager/PRIVACY.md

# Pager SMS Program Privacy Policy

**Operated by:** Albert Wong ("Pager")
**Contact:** awong.dev@gmail.com
**Last updated:** October 9, 2026

This policy covers the Pager SMS test program, in which Albert Wong relays text messages between a Pager device and the mobile phones of people who have agreed to take part.

## What we collect from SMS participants

If you have agreed to receive text messages from Pager, the only information we collect about you is:

- Your mobile phone number
- The content of the text messages you send to and receive from the Pager program

We do not collect any other information about you. We do not collect your location, contacts, or device information.

## How we use it

Your phone number and message content are used only to deliver messages between you and the Pager device you are communicating with, and to operate, test, and debug the Pager program.

## How long we keep it

Message content is retained for one week by default. Retention may be configured for up to one month. Your phone number is retained for as long as you are an opted-in participant.

## Sharing

We do not sell or share your SMS opt-in data or personal information with third parties for marketing purposes.

Your data is processed only by the infrastructure providers needed to run the program: the bridge phone that carries your texts (SMS delivery; Twilio removed 9 Oct 2026, last at 05ec3ed), Google Cloud and Firebase (hosting and storage), EMQX (message broker), and Soracom (device connectivity). These providers process data solely to deliver the service.

## Opting out

Texts come from a family's own phone number, person to person, so there is no automated keyword system. Reply to the family directly and ask them to stop, or block the number on your phone. A family admin can also block a number from the web app, after which no pager in that family can text it.

## Changes

Updates to this policy will be posted at this location.
