awong-dev/pager/TERMS.md

# Pager SMS Program Terms and Conditions

**Program name:** Pager
**Operated by:** Albert Wong
**Contact:** awong.dev@gmail.com
**Last updated:** October 8, 2026

## Program description

Pager is a test program run by Albert Wong. If you have agreed to participate, you will receive two-way conversational text messages relayed from a Pager device, such as messages coordinating where and when to meet, and your replies will be relayed back to that device. Messages are written by people, not generated automatically.

## Message frequency

Message frequency varies. Messages typically arrive in bursts on days when you are coordinating with the Pager user.

## Costs

Message and data rates may apply.

## Help and opt-out

**Reply HELP to any message for help, or email awong.dev@gmail.com.**

**Reply STOP to any message to opt out. You will receive one final confirmation message and no further messages.**

## Privacy

Your information is handled as described in our Privacy Policy: https://github.com/awong-dev/pager/blob/main/PRIVACY.md

## Carrier disclaimer

Mobile carriers are not liable for delayed or undelivered messages.

## Changes

Updates to these terms will be posted at this location.
