awong-dev/pager/docs/DEVICE_PLAN.md

# DEVICE_PLAN.md — device provisioning, device authentication, and the on-device UI

**Status:** design plan, nothing here is implemented. The task-by-task execution plan derived
from it is `docs/DEVICE_TASKS.md`. `docs/PROTOCOL.md` stays authoritative for the
wire; every wire change this plan needs is listed in §8 as an edit to that document and is made
there *first* when the phase that needs it starts. `docs/SERVER_PLAN.md` is the reference for the
server side this plan extends.

**Scope.** Six device-UI requirements and one security requirement:

1. status indicator for battery and LTE signal;
2. a device screen that shows and completes provisioning of *this* device;
3. an address book the student can add recipients to, including SMS numbers, where **the server
   approves every entry** before it becomes routable;
4. recipient selection when composing;
5. selection among active chats;
6. inside a chat, scrollable history and a composer;
7. a stronger authentication and authorization scheme between device and relay than the MQTT
   password the broker checks today, sized against bytes per message;
8. a device lock with a passcode, auto-locking after a configurable number of minutes.

**Conventions.** Same as `PROTOCOL.md`: `(see rationale)` marks a choice made here; `NEEDS HUMAN
DECISION` marks something that needs a paid service, an irreversible step, or a product judgement;
`UNVERIFIED` marks a hardware or vendor-library fact assumed but not confirmed, each with the
cheapest experiment. Line references to the vendor component are against `walter-modem` **v1.5.0**.

---

## 1. Where things stand (what this plan builds on)

Read from the working tree on 2026-09-15. These are the facts that constrain the design; none of
them is a criticism of the code, which is a faithful implementation of the v1 protocol.

**Trust today.**
- The broker is meant to authenticate the device by username/password over TLS and to enforce
  per-device topic ACLs (`PROTOCOL.md` §2). **Neither is provisioned anywhere**: `tools/e2e_v2.py`
  and `infra/README.md` both say the local EMQX accepts anonymous connections and enforces no ACLs,
  and `POST /api/admin/devices` (`relay/app/routers/admin.py:242-277`) stores a password hash it
  never pushes to the broker.
- The relay authenticates the *broker* with one shared header (`X-Relay-Webhook-Key`,
  `relay/app/broker.py:105-115`) and then **trusts the device id parsed off the topic**
  (`relay/app/ingest.py:52-57`; `SERVER_PLAN.md` §5.3 says so explicitly). The only per-device checks
  are "device doc exists" and "not revoked". Anyone holding the webhook key, the broker's REST
  publish key, or broker admin access can therefore forge any device's `/up`, `/status` and `/loc`,
  and can publish any `/down`.
- Replay protection is idempotency only: `wireIds`, `locWireIds`, and monotonic delivery states.
  Those are bounded by retention (4 weeks by default), after which an old envelope replays cleanly.

**Firmware today.**
- Credentials, device id, broker host and the CA are `static constexpr` in `net.cpp:56-94` with a
  "do not flash as-is" comment. There is **no NVS** in the firmware at all
  (`firmware/main/CMakeLists.txt` requires only `json driver esp_timer`).
- The display driver, font, framebuffer, composer and one hardcoded screen all live in `ui.c`. The
  font is a hand-authored 5×7, **upper-case only** (`ui.c:73-75` upcases), 6 px advance → 49
  columns. There is no screen, scroll, cursor, invert or icon primitive.
- The CardKB is polled only while the composer is open (`ui.c:676-678`); every byte ≥ 0x80 (arrows,
  Esc, Tab on the CardKB) is dropped (`ui.c:703-729`). The one button multiplexes cancel /
  mark-read / open-composer.
- Messages are one flat 10-deep ring with no `to` field (`msg.h:88-98`); `publish_reply()` never
  emits `to` (`msg.c:511-534`). The device has no notion of a recipient, an alias, or a chat.
- `/status` omits `rssi`; nothing in `net.cpp` reads signal strength. Battery is read once per
  `/status` publish only.
- RTC memory: 928 B used of 1184 B → **≈256 B headroom** for anything that must survive a reset.
- Rendering runs synchronously on whichever task calls it, including the modem's event task
  (`firmware/README.md` R4, R5, R6). Any multi-screen UI has to fix that first.

**Server today.** Every recipient is a `users/{uid}` with a unique alias; a phone number is only ever
a delivery *backend* (`users/{uid}/backends/{bid}` with `kind:'sms'`) attached to a user, never a
recipient in its own right. The allow-list is admin-only, replace-all, with no pending/request
concept (`PUT /api/admin/allowlist`). `devices/{d}` is **owner-readable** under `firestore.rules`,
so nothing secret may be stored in it. The repo already has the two idioms this plan reuses: a
server-only collection with no rules `match` block (`phoneIndex`, `smsVerifyCodes`, …) and a
single-use code that is read-then-deleted (`gchatLinkCodes`).

---

## 2. Device authentication and authorization

### 2.1 Threat model, stated so the byte budget has something to be sized against

| # | Threat | Today | After this plan |
|---|---|---|---|
| T1 | Passive eavesdropping on the air / Internet path | TLS to the broker | unchanged |
| T2 | Someone with **broker admin / REST-publish access** forges a `/down` to the student ("pickup behind the mall") | possible | device rejects unsigned or badly signed `/down` |
| T3 | Someone with broker access or the **webhook key** forges `/up` (fake "on my way"), `/loc` (fake position), `/status` | possible | relay rejects; logged as a security event |
| T4 | Replay of a captured envelope after the dedup marker has been retention-swept | possible | per-device monotonic counter with a sliding window |
| T5 | Cross-device / cross-topic replay (device A's ack on topic B, an `/up` payload on `/status`) | wrong-device ack check only | key is per device and the topic is inside the MAC |
| T6 | Stolen device | full impersonation until revoked | unchanged — `revokedAt` + broker credential removal is the answer; NVS encryption raises the bar for key extraction (§2.7) |
| T7 | Relay database leak | leaks password hashes | leaks the per-device MAC keys (symmetric). Accepted; §2.8 says why, and what Ed25519 would buy |
| T8 | Someone who can talk to the broker guessing a device's key | n/a | 2⁻⁶⁴ per attempt, rate-limited and alarmed at the relay |

The broker's password + ACL stays as the **first** gate (it stops junk before it costs the relay a
Cloud Run invocation, and it is what limits who can even *attempt* T8). The signature is the
**second**, end-to-end gate that the relay verifies itself, so the broker and the webhook key stop
being trust anchors. Both gates are needed; neither replaces the other.

### 2.2 Options considered, with bytes

All sizes are the extra bytes on the payload, before TLS/TCP framing (which does not change: the
same number of records is sent). `n` is the replay counter of §2.4, present in every option except
the first. Two columns because the wire is **CBOR** for devices (decided; §2.4) and JSON stays for
tooling and debugging.

| Option | Extra bytes / envelope, CBOR | …JSON | Defends | Verdict |
|---|---|---|---|---|
| A. Broker password + TLS only (status quo, once actually provisioned) | 0 | 0 | T1 | not enough: T2–T5 all remain |
| B. **HMAC-SHA256, tag truncated to 64 bits** + counter | **≈ 15** (`n` 2–6, `sig` 10) | ≈ 33 | T1–T5, T8 | **chosen** |
| C. HMAC-SHA256, 128-bit tag + counter | ≈ 23 | ≈ 44 | same, 2⁻¹²⁸ | 8 bytes buys nothing once forgery attempts are rate-limited |
| D. Ed25519 signature + counter | ≈ 71 | ≈ 101 | B + T7, non-repudiation | 4–5× the tag bytes for a threat (relay DB leak) that already yields the broker keys and the whole thread store; a `/down` would need a relay signing key and the device a 32 B public key. Kept as the documented upgrade path (§2.8) |
| E. AEAD (ChaCha20-Poly1305), nonce = counter | ≈ 17 (bstr body, no base64 in CBOR) | ≈ 22 + ⅓ of `body` | B + confidentiality from the broker | body becomes opaque to the relay's pre-store validation; nothing in the threat model needs it yet. Same key, same counter, so it can be added later without re-provisioning (§2.8) |

*(see rationale for B over C: a 64-bit tag is the smallest size NIST SP 800-107 accepts without
extra conditions, the relay counts and rate-limits verification failures per device, and a forger
has to get each attempt past the broker's password gate first. And for not going **below** 8
bytes: 4 bytes would save ≈ 0.8 kB/day — under 0.5 % of an exchange once framing is counted — at
the price of a 2⁻³² forgery bound that is only acceptable if the relay's failure counter and
lockout are configured and never disabled, and a lockout an attacker who can publish as the
device can trip on purpose. Sixty-four bits needs none of that reasoning. And for not going
**above** 8: the only forgery oracle is the relay itself, online, so 2⁶³ expected attempts is
infeasible even with the failure counter removed, truncation length has no bearing on recovering
the 256-bit key, and OSCORE (RFC 8613) — the IETF security layer for exactly this class of
device — defaults to a 64-bit tag. Twelve bytes would spend the same 4 bytes per envelope as the
4-byte option, in the other direction, for nothing measurable.)*

### 2.3 Key material

- `K_dev`: 32 random bytes, generated by the relay when the device is created, returned **exactly
  once** in the provisioning bundle (§3), stored server-side in a **server-only** collection
  `deviceSecrets/{deviceId}` (§2.6) — never in `devices/{d}`, which the owner's browser can read.
- One key per device, used in both directions. The topic is part of the MAC input, which is what
  separates directions and topics; no derived per-direction keys *(see rationale: one HMAC per
  message and one 32-byte blob on the device is simpler than an HKDF step for a property the topic
  binding already gives).*
- The MQTT password stays a separate secret. It is the broker's business; rotating one does not
  require rotating the other.
- Rotation is a new setup code (§3.5): the person types it on the device and the bootstrap fetch
  replaces the key. Silent over-the-air rotation would need a `cfg` down message carrying a key
  encrypted under the old one; not designed here.
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
