awong-dev/pager/hardware/carrier/production/bom.csv

Designator | Footprint | Quantity | Value | LCSC Part #
C1 | 0603 | 1 | 4.7uF | C19666
C10, C11 | 0402 | 2 | 1uF | C52923
C12, C14, C17, C18, C2, C3, C5, C9 | 0402 | 8 | 100nF | C1525
C13 | 0603 | 1 | 1uF/25V | C15849
C15, C16, C19 | 0402 | 3 | 10uF | C15525
C4 | 0402 | 1 | 4.7uF | C23733
C6, C7 | 0805 | 2 | 100uF | C141660
C8 | 0603 | 1 | 10uF | C19702
D1 | SOT-666 | 1 | USBLC6-2P6 | C2827693
J1 | JST_SH_SM08B-SRSS-TB_1x08-1MP_P1.00mm_Horizontal | 1 | PANEL | C160407
J2 | JST_SH_SM04B-SRSS-TB_1x04-1MP_P1.00mm_Horizontal | 1 | CARDKB | C160404
J3 | JST_SH_SM02B-SRSS-TB_1x02-1MP_P1.00mm_Horizontal | 1 | HAPTIC | C160402
J4 | JST_SH_SM02B-SRSS-TB_1x02-1MP_P1.00mm_Horizontal | 1 | EXT_LED | C160402
J5 | JST_SH_SM02B-SRSS-TB_1x02-1MP_P1.00mm_Horizontal | 1 | PIEZ | C160402
J6 | USB_C_Receptacle_ShouHan_TYPE-C-16PLT-H6.5_Vertical | 1 | TYPE-C 16PLT-H6.5 | C3151748
J7 | JST_SH_SM02B-SRSS-TB_1x02-1MP_P1.00mm_Horizontal | 1 | BATTERY | C160402
J8 | JST_SH_SM02B-SRSS-TB_1x02-1MP_P1.00mm_Horizontal | 1 | FRONTLIGHT | C160402
L1 | L_Murata_DFE201610P_NoSilk | 1 | 2.2uH | C5832344
M1 | Walter_Module_2x14_THT | 1 | Walter | Walter (DPTechnics)
Q1 | SOT-363_SC-70-6 | 1 | UMH3N | C62892
Q2 | SOT-323_SC-70 | 1 | SI1308EDL | C469327
Q3 | SOT-323_SC-70 | 1 | MMST3904 | C54879
Q4 | SOT-23 | 1 | AO3401A | C15127
R1 | 0402 | 1 | 22k | C25768
R10, R34, R37, R4, R5, R6 | 0402 | 6 | 100k | C25741
R11, R23, R39 | 0402 | 3 | 0R | C17168
R12 | 0603 | 1 | 15R | C22810
R14, R24, R26, R28, R30, R7, R8 | 0402 | 7 | 10k | C25744
R15, R16, R17, R18 | 0402 | 4 | 4.7k | C25900
R19, R20 | 0402 | 2 | 220R | C25091
R2 | 0402 | 1 | 47k | C25792
R21 | 0402 | 1 | 330R | C25104
R22, R32 | 0402 | 2 | 1M | C26083
R25 | 0402 | 1 | 18k | C25762
R27 | 0402 | 1 | 604R | C8369
R29, R31 | 0402 | 2 | 5.1k | C25905
R3, R9 | 0402 | 2 | 1k | C11702
R33 | 0402 | 1 | 56k | C25796
R38 | 0402 | 1 | 267k | C270622
SW1 | SW_Push_1P1T_NO_CK_KMR2 | 1 | KMR221GLFS | C72443
SW2 | SW_SPDT_ShouHan_MSS12C02LS_TopActuated | 1 | MSS12C02LS-HB2.0 | C3008584
U1 | QFN-24-1EP_4x4mm_P0.5mm_EP2.6x2.6mm | 1 | CP2102N-A02-GQFN24 | C969151
U2 | VSSOP-8_2.3x2mm_P0.5mm | 1 | SN74LVC2G126DCUR | C2652104
U3 | TSSOP-10_3x3mm_P0.5mm | 1 | DRV2605LDGSR | C527464
U4 | LGA-12_2x2mm_P0.5mm_NoSilk | 1 | LIS2DW12TR-MS | C50385411
U5 | BQ25185_WSON-10_DLH0010A_2.2x2mm_P0.4mm_EP0.9x1.5mm | 1 | BQ25185DLHR | C19725033
U6 | TDFN-8-1EP_2x2mm_P0.5mm_EP0.8x1.2mm | 1 | MAX17048G+T10 | C2682616
U7 | TPS62840_VSON-HR-8_DLC0008B_1.5x2mm_P0.5mm | 1 | TPS62840DLCR | C2071859
