awong-dev/pager/hardware/carrier/out/pager-carrier-bom.csv

Reference | Value | Footprint | MPN | LCSC | DNP | Qty
C1,C11,C16,C18,C19,C21,C24 | 100nF | Capacitor_SMD:C_0603_1608Metric | CL10B104KB8NNNC | C14663 |  | 7
C2 | 10uF/25V | Capacitor_SMD:C_0805_2012Metric | CL21A106KAYNNNE | C15850 |  | 1
C3 | 1uF/25V | Capacitor_SMD:C_0603_1608Metric | CL10A105KA8NNNC | C15849 |  | 1
C4 | 22uF | Capacitor_SMD:C_0805_2012Metric | CL21A226MAQNNNE | C45783 |  | 1
C5,C7,C8,C14,C20,C22,C23 | 10uF | Capacitor_SMD:C_0603_1608Metric | CL10A106KP8NNNC | C19702 |  | 7
C6 | 22nF | Capacitor_SMD:C_0603_1608Metric | CL10B223KB8NNNC | C21122 |  | 1
C9 | 1nF | Capacitor_SMD:C_0603_1608Metric | CL10B102KB8NNNC | C1588 |  | 1
C10 | 1uF | Capacitor_SMD:C_0603_1608Metric | CL10A105KA8NNNC | C15849 |  | 1
C12,C13 | 100uF | Capacitor_SMD:C_0805_2012Metric | GRM21BR60J107ME15L | C141660 |  | 2
C15,C17 | 4.7uF | Capacitor_SMD:C_0603_1608Metric | CL10A475KP8NNNC | C19666 |  | 2
C25,C27 | 1uF | Capacitor_SMD:C_0603_1608Metric | CL10A105KA8NNNC | C15849 | DNP | 2
C26 | 100nF | Capacitor_SMD:C_0603_1608Metric | CL10B104KB8NNNC | C14663 | DNP | 1
D4 | USBLC6-2SC6 | Package_TO_SOT_SMD:SOT-23-6 | USBLC6-2SC6 | C7519 |  | 1
D5 | RED | LED_SMD:LED_0603_1608Metric | KT-0603R | C2286 | DNP | 1
F1 | 2A PTC | Fuse:Fuse_1206_3216Metric | 1206L200/16SR | C151163 |  | 1
H1,H2,H3,H4 | M2 | MountingHole:MountingHole_2.2mm_M2 |  |  |  | 4
J1 | USB4235 | pager-carrier:USB_C_Receptacle_GCT_USB4235_Vertical | USB4235-03-C |  |  | 1
J2 | BATTERY | Connector_JST:JST_PH_S2B-PH-SM4-TB_1x02-1MP_P2.00mm_Horizontal | S2B-PH-SM4-TB | C295747 |  | 1
J3 | PANEL | Connector_JST:JST_SH_SM10B-SRSS-TB_1x10-1MP_P1.00mm_Horizontal | SM10B-SRSS-TB | C160409 |  | 1
J4 | CARDKB | Connector_JST:JST_PH_S4B-PH-SM4-TB_1x04-1MP_P2.00mm_Horizontal | S4B-PH-SM4-TB | C265102 |  | 1
J6 | MSG_LED | Connector_JST:JST_SH_SM02B-SRSS-TB_1x02-1MP_P1.00mm_Horizontal | SM02B-SRSS-TB | C160402 | DNP | 1
J7 | HAPTIC | Connector_JST:JST_SH_SM02B-SRSS-TB_1x02-1MP_P1.00mm_Horizontal | SM02B-SRSS-TB | C160402 | DNP | 1
JP1 | auto-boot | Jumper:SolderJumper-2_P1.3mm_Bridged_RoundedPad1.0x1.5mm |  |  |  | 1
L2 | 2.2uH | Inductor_SMD:L_Murata_DFE201610P | TFM201610ALMA-2R2MTAA | C404810 |  | 1
M1 | Walter | pager-carrier:Walter_Module_2x14_THT | Walter (DPTechnics) |  |  | 1
Q1 | DMG2305UX-7 | Package_TO_SOT_SMD:SOT-23 | DMG2305UX-7 | C150470 |  | 1
Q2 | UMH3N | Package_TO_SOT_SMD:SOT-363_SC-70-6 | UMH3N | C62892 |  | 1
Q4 | 2N7002 | Package_TO_SOT_SMD:SOT-23 | 2N7002 | C8545 |  | 1
R1,R2 | 5.1k | Resistor_SMD:R_0603_1608Metric | 0603WAF5101T5E | C23186 |  | 2
R3 | 56k | Resistor_SMD:R_0603_1608Metric | 0603WAF5602T5E | C23206 |  | 1
R4,R16,R24,R25,R35,R36 | 100k | Resistor_SMD:R_0603_1608Metric | 0603WAF1003T5E | C25803 |  | 6
R5,R6,R17,R20 | 0R | Resistor_SMD:R_0603_1608Metric | 0603WAF0000T5E | C21189 |  | 4
R7,R18 | 0R | Resistor_SMD:R_0603_1608Metric | 0603WAF0000T5E | C21189 | DNP | 2
R8,R12,R13,R14,R26,R27,R28 | 10k | Resistor_SMD:R_0603_1608Metric | 0603WAF1002T5E | C25804 |  | 7
R9 | 18k | Resistor_SMD:R_0603_1608Metric | 0603WAF1802T5E | C25810 |  | 1
R10 | 13k | Resistor_SMD:R_0603_1608Metric | 0603WAF1302T5E | C22797 | DNP | 1
R11 | 604R | Resistor_SMD:R_0603_1608Metric | 0603WAF6040T5E | C32183 |  | 1
R15 | 2.2M | Resistor_SMD:R_0603_1608Metric | 0603WAF2204T5E | C22938 |  | 1
R19 | 267k | Resistor_SMD:R_0603_1608Metric | RM06FTN2673 | C188011 |  | 1
R21 | 1k | Resistor_SMD:R_0603_1608Metric | 0603WAF1001T5E | C21190 |  | 1
R22 | 22.1k | Resistor_SMD:R_0603_1608Metric | RC0603FR-0722K1L | C137768 |  | 1
R23 | 47.5k | Resistor_SMD:R_0603_1608Metric | 0603WAF4752T5E | C23061 |  | 1
R29,R30,R31,R32 | 4.7k | Resistor_SMD:R_0603_1608Metric | 0603WAF4701T5E | C23162 |  | 4
R33 | 33R | Resistor_SMD:R_1206_3216Metric | 1206W4F330JT5E | C18005 |  | 1
R34 | 100R | Resistor_SMD:R_0603_1608Metric | 0603WAF1000T5E | C22775 |  | 1
R37 | 330R | Resistor_SMD:R_0603_1608Metric | 0603WAF3300T5E | C23138 | DNP | 1
R38 | 1k | Resistor_SMD:R_0603_1608Metric | 0603WAF1001T5E | C21190 | DNP | 1
R39 | 100k | Resistor_SMD:R_0603_1608Metric | 0603WAF1003T5E | C25803 | DNP | 1
SW1 | JS102011SAQN | Button_Switch_SMD:SW_SPDT_CK_JS102011SAQN | JS102011SAQN | C221660 |  | 1
SW2 | SKQGAFE010 | Button_Switch_SMD:SW_SPST_SKQG_WithoutStem | SKQGAFE010 | C202424 |  | 1
TP1,TP2 | GND | TestPoint:TestPoint_Pad_1.0x1.0mm |  |  |  | 2
TP3 | SYS | TestPoint:TestPoint_Pad_1.0x1.0mm |  |  |  | 1
TP4 | SYS_SW | TestPoint:TestPoint_Pad_1.0x1.0mm |  |  |  | 1
TP5 | VBAT | TestPoint:TestPoint_Pad_1.0x1.0mm |  |  |  | 1
TP6 | 3V3 | TestPoint:TestPoint_Pad_1.0x1.0mm |  |  |  | 1
TP7 | 3V3_EPD | TestPoint:TestPoint_Pad_1.0x1.0mm |  |  |  | 1
TP8 | ESP_TX0 | TestPoint:TestPoint_Pad_1.0x1.0mm |  |  |  | 1
TP9 | ESP_RX0 | TestPoint:TestPoint_Pad_1.0x1.0mm |  |  |  | 1
TP10 | ESP_EN | TestPoint:TestPoint_Pad_1.0x1.0mm |  |  |  | 1
TP11 | KBD_PWR_N | TestPoint:TestPoint_Pad_1.0x1.0mm |  |  |  | 1
TP12 | TP_IO1 | TestPoint:TestPoint_Pad_1.0x1.0mm |  |  |  | 1
TP13 | FL_BTN | TestPoint:TestPoint_Pad_1.0x1.0mm |  |  |  | 1
TP14 | TP_IO5 | TestPoint:TestPoint_Pad_1.0x1.0mm |  |  |  | 1
U1 | BQ25185DLHR | pager-carrier:BQ25185_WSON-10_DLH0010A_2.2x2mm_P0.4mm_EP0.9x1.5mm | BQ25185DLHR | C19725033 |  | 1
U3 | TPS62840DLCR | pager-carrier:TPS62840_VSON-HR-8_DLC0008B_1.5x2mm_P0.5mm | TPS62840DLCR | C2071859 |  | 1
U4 | TPS22917DBV | Package_TO_SOT_SMD:SOT-23-6 | TPS22917DBVR | C2681320 |  | 1
U5 | CP2102N-A02-GQFN24 | Package_DFN_QFN:QFN-24-1EP_4x4mm_P0.5mm_EP2.6x2.6mm | CP2102N-A02-GQFN24 | C969151 |  | 1
U6 | SN74LVC2G126DCUR | Package_SO:VSSOP-8_2.3x2mm_P0.5mm | SN74LVC2G126DCUR |  |  | 1
U7 | LIS2DW12TR | Package_LGA:LGA-12_2x2mm_P0.5mm | LIS2DW12TR | C189624 |  | 1
U9 | DRV2605LDGSR | Package_SO:TSSOP-10_3x3mm_P0.5mm | DRV2605LDGSR | C527464 | DNP | 1
U10 | MAX17048G+T10 | Package_DFN_QFN:TDFN-8-1EP_2x2mm_P0.5mm_EP0.8x1.2mm | MAX17048G+T10 | C2682616 |  | 1
