awong-dev/pager/hardware/carrier/panel/production/bom.csv

Designator | Footprint | Quantity | Value | LCSC Part #
C1 | 0402 | 1 | 10uF | C15525
C10, C3, C4, C7, C8, C9 | 0603 | 6 | 1uF/25V | C15849
C11 | 0603 | 1 | 4.7uF | C19666
C2, C6 | 0402 | 2 | 1uF | C52923
C5 | 0805 | 1 | 4.7uF/25V | C1779
D1, D2, D3 | D_SOD-123 | 3 | B5819W | C8598
J1 | HRS_FH34SRJ-24S-0.5SH_50_ | 1 | FH34SRJ-24S-0.5SH_50_ | C324726
J2 | JST_SH_SM08B-SRSS-TB_1x08-1MP_P1.00mm_Horizontal | 1 | CARRIER | C160407
J3 | HRS_FH34SRJ-6S-0.5SH_50_ | 1 | FH34SRJ-6S-0.5SH_50_ | C224194
J5 | JST_SH_SM02B-SRSS-TB_1x02-1MP_P1.00mm_Horizontal | 1 | FRONTLIGHT | C160402
L1 | L_Sunlord_SWPA3015S | 1 | 47uH | C83435
Q5 | SOT-323_SC-70 | 1 | SI1308EDL | C469327
R4 | 0603 | 1 | 2.2R | C22939
R6, R7 | 0402 | 2 | 10k | C25744
R8 | 0402 | 1 | 1M | C26083
