awong-dev/pager/hardware/carrier/panel/out/pager-panel-bom.csv

Reference | Value | Footprint | MPN | LCSC | DNP | Qty
C1 | 10uF | Capacitor_SMD:C_0603_1608Metric | CL10A106KP8NNNC | C19702 |  | 1
C2,C6 | 1uF | Capacitor_SMD:C_0603_1608Metric | CL10A105KA8NNNC | C15849 |  | 2
C3,C4,C7,C8,C9,C10 | 1uF/25V | Capacitor_SMD:C_0603_1608Metric | CL10A105KA8NNNC | C15849 |  | 6
C5,C11 | 4.7uF/25V | Capacitor_SMD:C_0805_2012Metric | CL21B475KAQNNNE | C1779 |  | 2
D1,D2,D3 | MBR0530 | Diode_SMD:D_SOD-123 | MBR0530 | C82046 |  | 3
J1 | GDEY029T94 FPC | pager-carrier:Hirose_FH34SRJ-24S-0.5SH_1x24-1MP_P0.50mm_Horizontal | FH34SRJ-24S-0.5SH(50) | C324726 |  | 1
J2 | CARRIER | Connector_JST:JST_SH_SM10B-SRSS-TB_1x10-1MP_P1.00mm_Horizontal | SM10B-SRSS-TB | C160409 |  | 1
J3 | FL-A FPC (FL03) | pager-carrier:Hirose_FH34SRJ-6S-0.5SH_1x06-1MP_P0.50mm_Horizontal | FH34SRJ-6S-0.5SH(50) | C224194 |  | 1
J4 | FL-B FPC (Orient) | pager-carrier:Hirose_FH34SRJ-6S-0.5SH_1x06-1MP_P0.50mm_Horizontal | FH34SRJ-6S-0.5SH(50) | C224194 | DNP | 1
L1 | 47uH | Inductor_SMD:L_Sunlord_SWPA3015S | SWPA3015S470MT |  |  | 1
Q5 | AO3400A | Package_TO_SOT_SMD:SOT-23 | AO3400A | C20917 |  | 1
R1,R2 | 0R | Resistor_SMD:R_0603_1608Metric | 0603WAF0000T5E | C21189 |  | 2
R3,R5 | 0R | Resistor_SMD:R_0603_1608Metric | 0603WAF0000T5E | C21189 | DNP | 2
R4 | 2.2R | Resistor_SMD:R_0603_1608Metric | 0603WAF2R20T5E |  |  | 1
R6,R7 | 10k | Resistor_SMD:R_0603_1608Metric | 0603WAF1002T5E | C25804 |  | 2
R8 | 1M | Resistor_SMD:R_0603_1608Metric | 0603WAF1004T5E | C22935 |  | 1
