awong-dev/pager/hardware/carrier/pager-carrier.csv

Reference | Qty | Value | DNP | Exclude from BOM | Exclude from Board | Exclude from Simulation | Exclude from Position Files | Footprint | Datasheet
C2,C34,C35,C37,C39,C42,C46 | 7 | 100nF |  |  |  |  | ${EXCLUDE_FROM_POS_FILES} | Capacitor_SMD:C_0402_1005Metric | ~
C9 | 1 | 1uF/25V |  |  |  |  | ${EXCLUDE_FROM_POS_FILES} | Capacitor_SMD:C_0603_1608Metric | ~
C10 | 1 | 22nF |  |  |  |  | ${EXCLUDE_FROM_POS_FILES} | Capacitor_SMD:C_0402_1005Metric | ~
C15,C16 | 2 | 100uF |  |  |  |  | ${EXCLUDE_FROM_POS_FILES} | Capacitor_SMD:C_0805_2012Metric | ~
C18,C19,C47 | 3 | 10uF |  |  |  |  | ${EXCLUDE_FROM_POS_FILES} | Capacitor_SMD:C_0402_1005Metric | ~
C38 | 1 | 10uF |  |  |  |  | ${EXCLUDE_FROM_POS_FILES} | Capacitor_SMD:C_0603_1608Metric | ~
C33 | 1 | 4.7uF |  |  |  |  | ${EXCLUDE_FROM_POS_FILES} | Capacitor_SMD:C_0603_1608Metric | ~
C36 | 1 | 4.7uF |  |  |  |  | ${EXCLUDE_FROM_POS_FILES} | Capacitor_SMD:C_0402_1005Metric | ~
C41,C44 | 2 | 1uF | DNP |  |  |  | ${EXCLUDE_FROM_POS_FILES} | Capacitor_SMD:C_0402_1005Metric | ~
D5 | 1 | USBLC6-2P6 |  |  |  |  | ${EXCLUDE_FROM_POS_FILES} | Package_TO_SOT_SMD:SOT-666 | https://www.st.com/resource/en/datasheet/usblc6-2.pdf
J5 | 1 | PANEL |  |  |  |  | ${EXCLUDE_FROM_POS_FILES} | Connector_JST:JST_SH_SM10B-SRSS-TB_1x10-1MP_P1.00mm_Horizontal | ~
J9 | 1 | CARDKB |  |  |  |  | ${EXCLUDE_FROM_POS_FILES} | Connector_JST:JST_SH_SM04B-SRSS-TB_1x04-1MP_P1.00mm_Horizontal | ~
J10 | 1 | HAPTIC | DNP |  |  |  | ${EXCLUDE_FROM_POS_FILES} | Connector_JST:JST_SH_SM02B-SRSS-TB_1x02-1MP_P1.00mm_Horizontal | ~
J11 | 1 | EXT_LED | DNP |  |  |  | ${EXCLUDE_FROM_POS_FILES} | Connector_JST:JST_SH_SM02B-SRSS-TB_1x02-1MP_P1.00mm_Horizontal | ~
J12 | 1 | PIEZ | DNP |  |  |  | ${EXCLUDE_FROM_POS_FILES} | Connector_JST:JST_SH_SM02B-SRSS-TB_1x02-1MP_P1.00mm_Horizontal | ~
J13 | 1 | USB4235 |  |  |  |  | ${EXCLUDE_FROM_POS_FILES} | pager-carrier:USB_C_Receptacle_GCT_USB4235_Vertical | https://www.usb.org/sites/default/files/documents/usb_type-c.zip
J14 | 1 | BATTERY |  |  |  |  | ${EXCLUDE_FROM_POS_FILES} | Connector_JST:JST_PH_S2B-PH-SM4-TB_1x02-1MP_P2.00mm_Horizontal | ~
JP3 | 1 | auto-boot |  |  |  |  | ${EXCLUDE_FROM_POS_FILES} | Jumper:SolderJumper-2_P1.3mm_Bridged_RoundedPad1.0x1.5mm | ~
L3 | 1 | 2.2uH |  |  |  |  | ${EXCLUDE_FROM_POS_FILES} | Inductor_SMD:L_Murata_DFE201610P | ~
M2 | 1 | Walter |  |  |  |  | ${EXCLUDE_FROM_POS_FILES} | pager-carrier:Walter_Module_2x14_THT | https://www.quickspot.io/datasheet/walter_datasheet.pdf
Q2 | 1 | AO3401A |  |  |  |  | ${EXCLUDE_FROM_POS_FILES} | Package_TO_SOT_SMD:SOT-23 | http://www.aosmd.com/pdfs/datasheet/AO3401A.pdf
Q6 | 1 | UMH3N |  |  |  |  | ${EXCLUDE_FROM_POS_FILES} | Package_TO_SOT_SMD:SOT-363_SC-70-6 | http://rohmfs.rohm.com/en/products/databook/datasheet/discrete/transistor/digital/emh3t2r-e.pdf
Q7 | 1 | SI1308EDL |  |  |  |  | ${EXCLUDE_FROM_POS_FILES} | Package_TO_SOT_SMD:SOT-323_SC-70 | https://www.vishay.com/docs/73390/si1308edl.pdf
Q8 | 1 | MMST3904 |  |  |  |  | ${EXCLUDE_FROM_POS_FILES} | Package_TO_SOT_SMD:SOT-323_SC-70 | https://www.onsemi.com/pdf/datasheet/pzt3904-d.pdf
R6,R21,R74 | 3 | 0R |  |  |  |  | ${EXCLUDE_FROM_POS_FILES} | Resistor_SMD:R_0402_1005Metric | ~
R7,R27 | 2 | 5.1k |  |  |  |  | ${EXCLUDE_FROM_POS_FILES} | Resistor_SMD:R_0402_1005Metric | ~
R10,R23,R25,R26,R56,R57,R62 | 7 | 10k |  |  |  |  | ${EXCLUDE_FROM_POS_FILES} | Resistor_SMD:R_0402_1005Metric | ~
R22 | 1 | 18k |  |  |  |  | ${EXCLUDE_FROM_POS_FILES} | Resistor_SMD:R_0402_1005Metric | ~
R24 | 1 | 604R |  |  |  |  | ${EXCLUDE_FROM_POS_FILES} | Resistor_SMD:R_0402_1005Metric | ~
R28 | 1 | 2.2M |  |  |  |  | ${EXCLUDE_FROM_POS_FILES} | Resistor_SMD:R_0402_1005Metric | ~
R50 | 1 | 22.1k |  |  |  |  | ${EXCLUDE_FROM_POS_FILES} | Resistor_SMD:R_0402_1005Metric | ~
R51 | 1 | 47.5k |  |  |  |  | ${EXCLUDE_FROM_POS_FILES} | Resistor_SMD:R_0402_1005Metric | ~
R52,R58 | 2 | 1k |  |  |  |  | ${EXCLUDE_FROM_POS_FILES} | Resistor_SMD:R_0402_1005Metric | ~
R53,R54,R55,R59,R72,R75 | 6 | 100k |  |  |  |  | ${EXCLUDE_FROM_POS_FILES} | Resistor_SMD:R_0402_1005Metric | ~
R60 | 1 | 15R |  |  |  |  | ${EXCLUDE_FROM_POS_FILES} | Resistor_SMD:R_0603_1608Metric | ~
R61 | 1 | 0R |  |  |  |  | ${EXCLUDE_FROM_POS_FILES} | Resistor_SMD:R_0402_1005Metric | ~
R63,R64,R65,R66 | 4 | 4.7k |  |  |  |  | ${EXCLUDE_FROM_POS_FILES} | Resistor_SMD:R_0402_1005Metric | ~
R67,R68 | 2 | 220R | DNP |  |  |  | ${EXCLUDE_FROM_POS_FILES} | Resistor_SMD:R_0402_1005Metric | ~
R69 | 1 | 330R | DNP |  |  |  | ${EXCLUDE_FROM_POS_FILES} | Resistor_SMD:R_0402_1005Metric | ~
R70 | 1 | 1M | DNP |  |  |  | ${EXCLUDE_FROM_POS_FILES} | Resistor_SMD:R_0402_1005Metric | ~
R71 | 1 | 56k |  |  |  |  | ${EXCLUDE_FROM_POS_FILES} | Resistor_SMD:R_0402_1005Metric | ~
R73 | 1 | 0R | DNP |  |  |  | ${EXCLUDE_FROM_POS_FILES} | Resistor_SMD:R_0402_1005Metric | ~
R76 | 1 | 267k |  |  |  |  | ${EXCLUDE_FROM_POS_FILES} | Resistor_SMD:R_0402_1005Metric | ~
SW3 | 1 | SKQGAFE010 |  |  |  |  | ${EXCLUDE_FROM_POS_FILES} | Button_Switch_SMD:SW_SPST_SKQG_WithoutStem | ~
SW4 | 1 | JS102011SAQN |  |  |  |  | ${EXCLUDE_FROM_POS_FILES} | Button_Switch_SMD:SW_SPDT_CK_JS102011SAQN | ~
TP12 | 1 | AWK_EN_N |  |  |  |  | ${EXCLUDE_FROM_POS_FILES} | TestPoint:TestPoint_Pad_1.0x1.0mm | ~
TP13 | 1 | TP_IO1 |  |  |  |  | ${EXCLUDE_FROM_POS_FILES} | TestPoint:TestPoint_Pad_1.0x1.0mm | ~
TP14 | 1 | TP_IO5 |  |  |  |  | ${EXCLUDE_FROM_POS_FILES} | TestPoint:TestPoint_Pad_1.0x1.0mm | ~
TP15 | 1 | FL_BTN |  |  |  |  | ${EXCLUDE_FROM_POS_FILES} | TestPoint:TestPoint_Pad_1.0x1.0mm | ~
TP16 | 1 | 3V3_AWK |  |  |  |  | ${EXCLUDE_FROM_POS_FILES} | TestPoint:TestPoint_Pad_1.0x1.0mm | ~
TP17 | 1 | GND |  |  |  |  | ${EXCLUDE_FROM_POS_FILES} | TestPoint:TestPoint_Pad_1.0x1.0mm | ~
TP18 | 1 | VBUS |  |  |  |  | ${EXCLUDE_FROM_POS_FILES} | TestPoint:TestPoint_Pad_1.0x1.0mm | ~
TP19 | 1 | SYS |  |  |  |  | ${EXCLUDE_FROM_POS_FILES} | TestPoint:TestPoint_Pad_1.0x1.0mm | ~
TP20 | 1 | SYS_SW |  |  |  |  | ${EXCLUDE_FROM_POS_FILES} | TestPoint:TestPoint_Pad_1.0x1.0mm | ~
TP21 | 1 | VBAT |  |  |  |  | ${EXCLUDE_FROM_POS_FILES} | TestPoint:TestPoint_Pad_1.0x1.0mm | ~
TP22 | 1 | 3V3 |  |  |  |  | ${EXCLUDE_FROM_POS_FILES} | TestPoint:TestPoint_Pad_1.0x1.0mm | ~
U2 | 1 | BQ25185DLHR |  |  |  |  | ${EXCLUDE_FROM_POS_FILES} | pager-carrier:BQ25185_WSON-10_DLH0010A_2.2x2mm_P0.4mm_EP0.9x1.5mm | https://www.ti.com/lit/ds/symlink/bq25185.pdf
U4 | 1 | TPS62840DLCR |  |  |  |  | ${EXCLUDE_FROM_POS_FILES} | pager-carrier:TPS62840_VSON-HR-8_DLC0008B_1.5x2mm_P0.5mm | https://www.ti.com/lit/ds/symlink/tps62840.pdf
U12 | 1 | CP2102N-A02-GQFN24 |  |  |  |  | ${EXCLUDE_FROM_POS_FILES} | Package_DFN_QFN:QFN-24-1EP_4x4mm_P0.5mm_EP2.6x2.6mm | https://www.silabs.com/documents/public/data-sheets/cp2102n-datasheet.pdf
U13 | 1 | SN74LVC2G126DCUR |  |  |  |  | ${EXCLUDE_FROM_POS_FILES} | Package_SO:VSSOP-8_2.3x2mm_P0.5mm | http://www.ti.com/lit/sg/scyt129e/scyt129e.pdf
U14 | 1 | DRV2605LDGSR | DNP |  |  |  | ${EXCLUDE_FROM_POS_FILES} | Package_SO:TSSOP-10_3x3mm_P0.5mm | https://www.ti.com/lit/ds/symlink/drv2605l.pdf
U15 | 1 | LIS2DW12TR |  |  |  |  | ${EXCLUDE_FROM_POS_FILES} | Package_LGA:LGA-12_2x2mm_P0.5mm | https://www.st.com/resource/en/datasheet/lis2dw12.pdf
U16 | 1 | MAX17048G+T10 |  |  |  |  | ${EXCLUDE_FROM_POS_FILES} | Package_DFN_QFN:TDFN-8-1EP_2x2mm_P0.5mm_EP0.8x1.2mm | https://www.analog.com/media/en/technical-documentation/data-sheets/max17048-max17049.pdf
