awong-dev/pager/hardware/carrier/out/pager-carrier-v02c-cassette.step

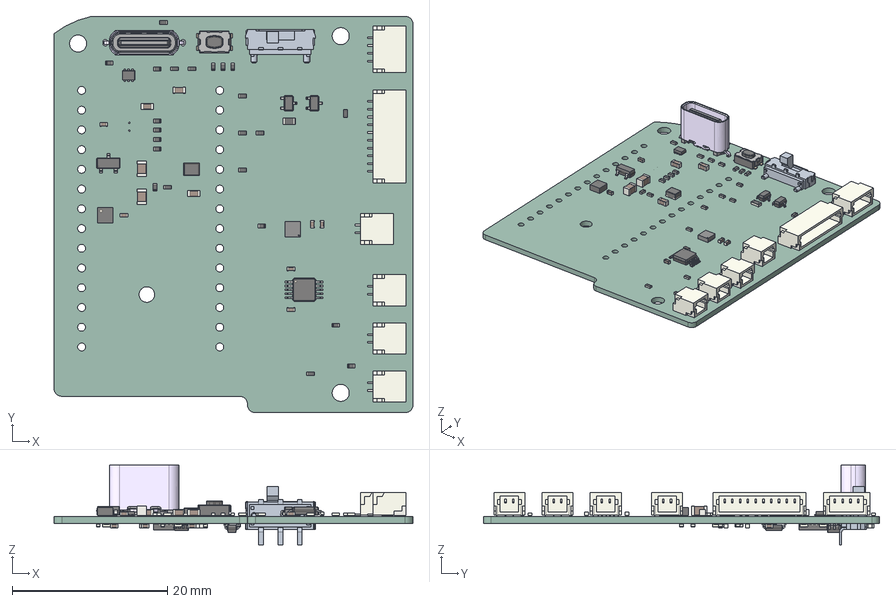
[picture p1: CAD file, 2026-10-22]
hardware/carrier/out/pager-carrier-v02c-cassette.step
46.2 x 51.0 x 10.3 mm
MAX17048G+T10
C_0402_1005Metric x 14
R_0402_1005Metric x 38
JST_SH_SM02B-SRSS-TB_1x02-1MP_P1.00mm_Horizontal x 4
SOT_666
C_0603_1608Metric x 3
C_0805_2012Metric x 2
SOT-323_SC-70 x 2
L_Murata_DFE201610P
TSSOP-10_3x3mm_P0.5mm
LGA_12_2x2mm_P05mm
R_0603_1608Metric
JST_SH_SM04B-SRSS-TB_1x04-1MP_P1.00mm_Horizontal
JST_SH_SM10B-SRSS-TB_1x10-1MP_P1.00mm_Horizontal
SOT-23
SW_Push_1P1T_NO_CK_KMR2
QFN-24-1EP_4x4mm_Pitch0.5mm
VSSOP-8_2.3x2mm_P0.5mm
SOT-363_SC-70-6
pager-carrier_PCB
