awong-dev/pager/hardware/carrier/pager-carrier.step

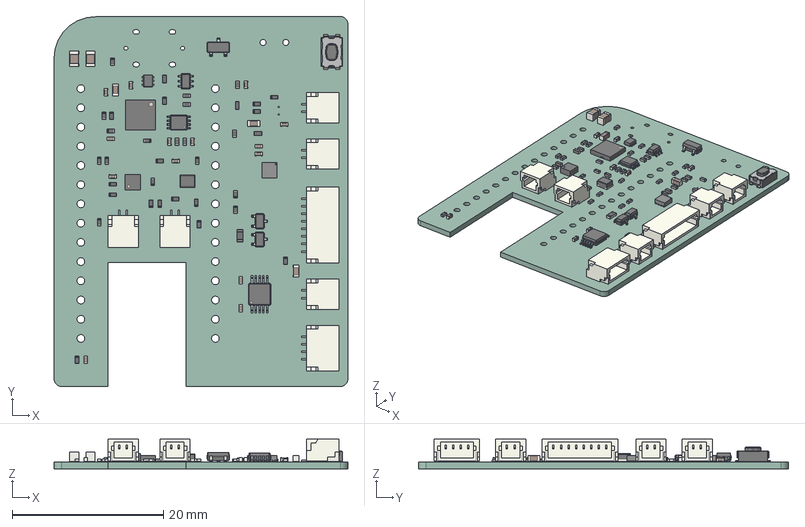
[picture p2: CAD file, 2026-10-26]
hardware/carrier/pager-carrier.step
38.9 x 48.9 x 3.96 mm
JST_SH_SM02B-SRSS-TB_1x02-1MP_P1.00mm_Horizontal x 5
C_0402_1005Metric x 14
C_0603_1608Metric x 3
MAX17048G+T10
R_0402_1005Metric x 35
C_0805_2012Metric x 2
SOT_666
SOT-323_SC-70 x 2
TSSOP-10_3x3mm_P0.5mm
SW_Push_1P1T_NO_CK_KMR2
LGA_12_2x2mm_P05mm
R_0603_1608Metric
JST_SH_SM04B-SRSS-TB_1x04-1MP_P1.00mm_Horizontal
L_Murata_DFE201610P
SOT-363_SC-70-6
JST_SH_SM08B-SRSS-TB_1x08-1MP_P1.00mm_Horizontal
VSSOP-8_2.3x2mm_P0.5mm
SOT-23
QFN-24-1EP_4x4mm_Pitch0.5mm
pager-carrier-unsaved-export-LWU9kY_PCB
