awong-dev/pager/hardware/carrier/panel/pager-panel.step

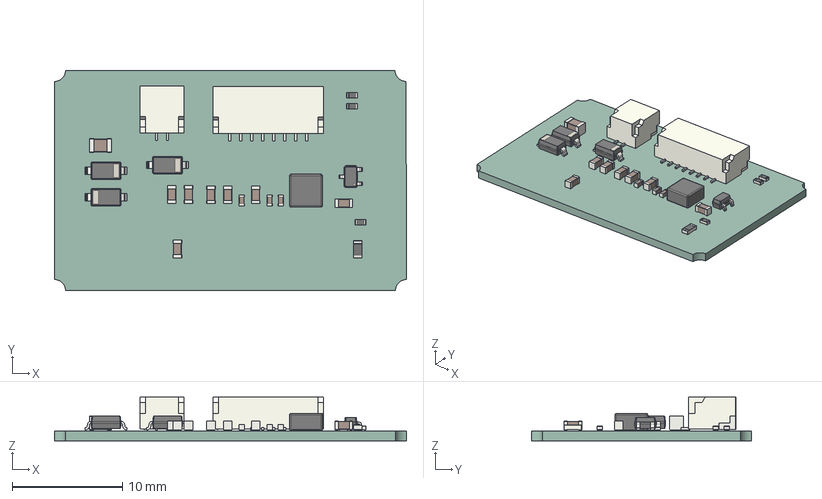
[picture p3: CAD file, 2026-10-26]
hardware/carrier/panel/pager-panel.step
32.0 x 20.0 x 3.96 mm
a65073d4-8551-11ed-a139-00155d22e2d7_part
a650750a-8551-11ed-a139-00155d22e2d7_part
a650758c-8551-11ed-a139-00155d22e2d7_part
C_0603_1608Metric x 7
JST_SH_SM08B-SRSS-TB_1x08-1MP_P1.00mm_Horizontal
JST_SH_SM02B-SRSS-TB_1x02-1MP_P1.00mm_Horizontal
R_0402_1005Metric x 3
C_0402_1005Metric x 3
D_SOD-123 x 3
SOT-323_SC-70
C_0805_2012Metric
R_0603_1608Metric
pager-panel_PCB
