awong-dev/pager/hardware/enclosure/out/panel_board_placed.step

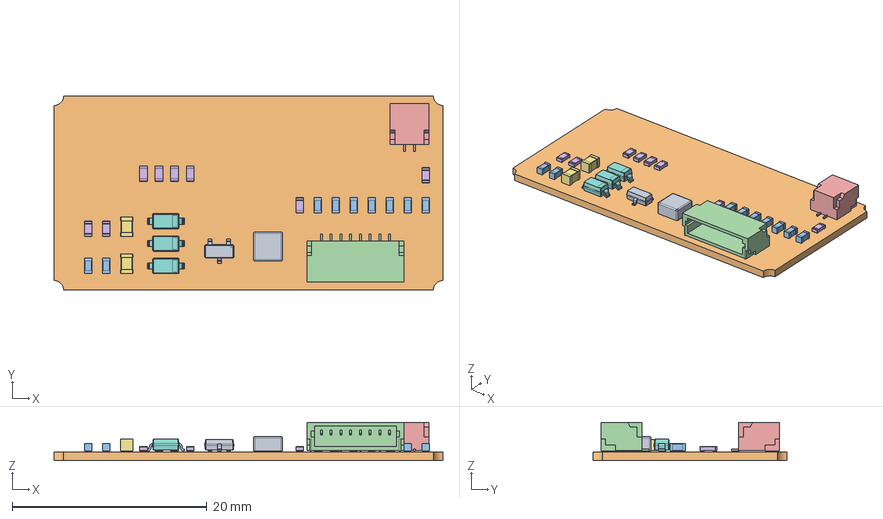
[picture p4: CAD file, 2026-10-24]
hardware/enclosure/out/panel_board_placed.step
40.0 x 20.0 x 3.96 mm
