awong-dev/pager/hardware/enclosure/out/slider_cap.step

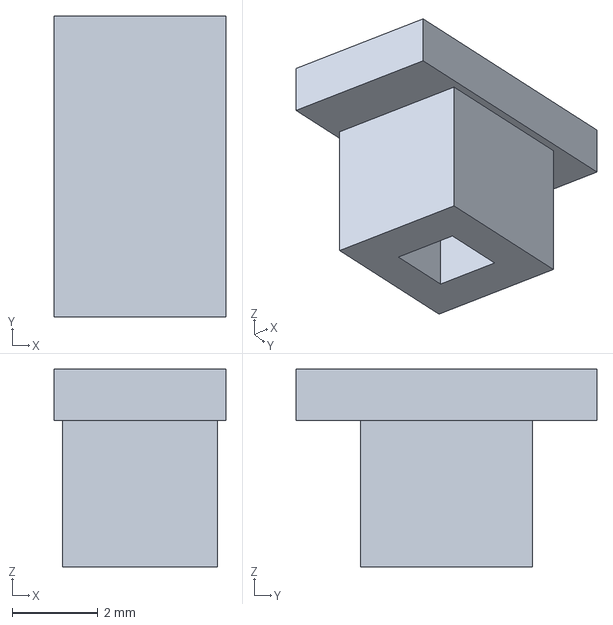
[picture p5: CAD file, 2026-10-24]
hardware/enclosure/out/slider_cap.step
4.00 x 7.00 x 4.60 mm
