awong-dev/pager/hardware/enclosure/out/fl_cap_print.stl

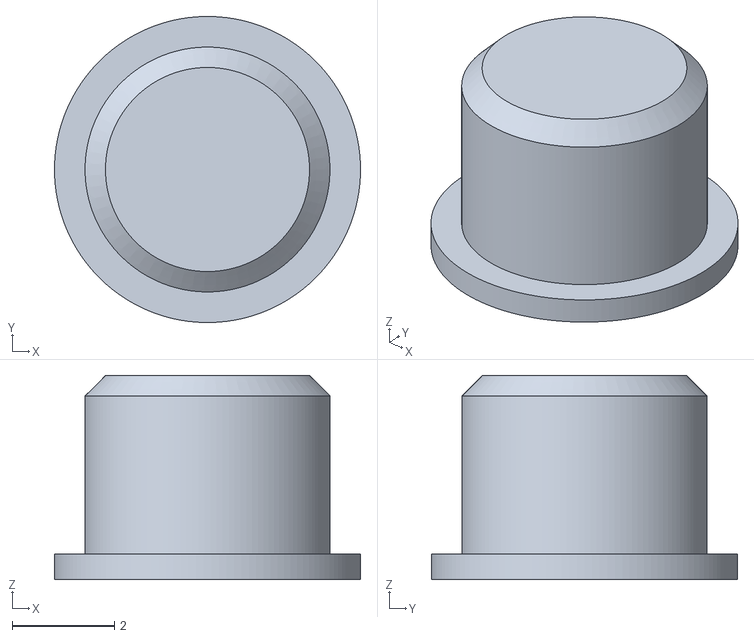
[picture p6: CAD file, 2026-10-24]
hardware/enclosure/out/fl_cap_print.stl
6.00 x 6.00 x 4.00
