awong-dev/pager/hardware/enclosure/out/faceplate_print.stl

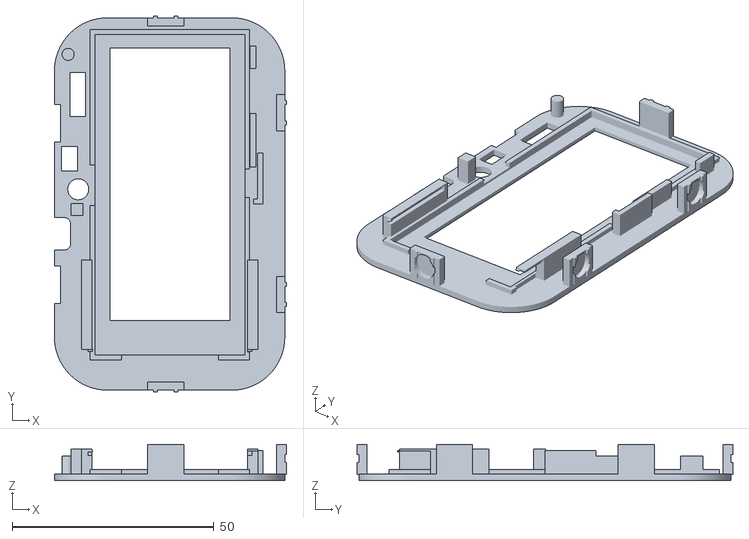
[picture p7: CAD file, 2026-10-24]
hardware/enclosure/out/faceplate_print.stl
57.5 x 93.1 x 9.00
