awong-dev/pager/hardware/enclosure/out/carrier_placed.step

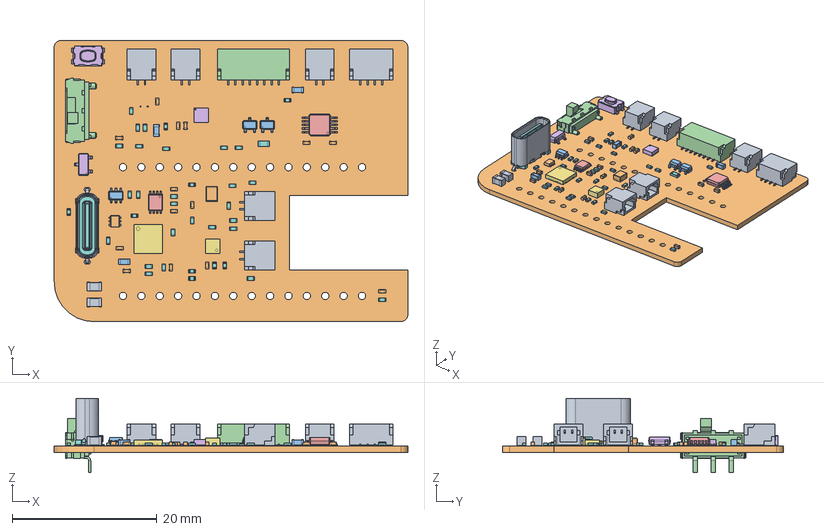
[picture p8: CAD file, 2026-10-24]
hardware/enclosure/out/carrier_placed.step
48.9 x 38.9 x 10.3 mm
