awong-dev/pager/hardware/carrier/Assembled v0.1.step

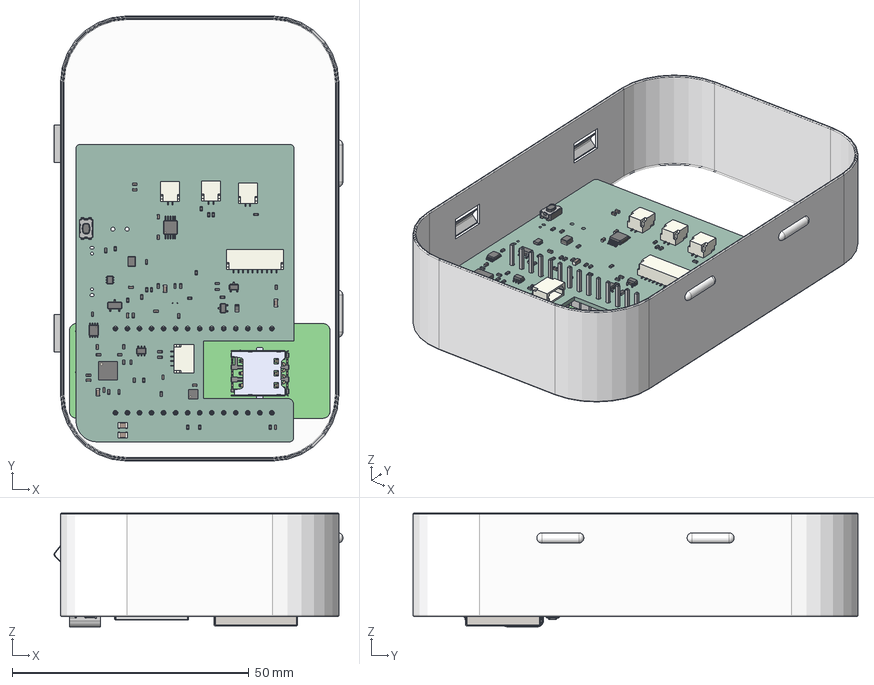
[picture p9: CAD file, 2026-10-22, an earlier design]
hardware/carrier/Assembled v0.1.step
61.0 x 93.9 x 24.0 mm
Altoids bottom lid
C_0402_1005Metric_14 x 14
R_0402_1005Metric_38 x 38
JST_SH_SM02B-SRSS-TB_1x02-1MP_P1.00mm_Horizontal_3 x 3
SOT_666
C_0603_1608Metric_3 x 3
C_0805_2012Metric_2 x 2
SOT-323_SC-70_2 x 2
L_Murata_DFE201610P_1
TSSOP-10_3x3mm_P0.5mm_1
QFN-24-1EP_4x4mm_Pitch0.5mm
LGA_12_2x2mm_P05mm
R_0603_1608Metric_1
VSSOP-8_2.3x2mm_P0.5mm_1
JST_SH_SM04B-SRSS-TB_1x04-1MP_P1.00mm_Horizontal_1
SOT-363_SC-70-6_1
JST_SH_SM10B-SRSS-TB_1x10-1MP_P1.00mm_Horizontal_1
SOT-23_1
SW_Push_1P1T_NO_CK_KMR2_1
pager-carrier-unsaved-export-rROF7T_PCB
