awong-dev/pager/(list of files, cad)

Other CAD files:
hardware/carrier/Assembled.step
hardware/enclosure/out/Assembled.step
hardware/enclosure/out/fl_cap.step
hardware/enclosure/out/slider_cap_print.stl
hardware/enclosure/out/faceplate.step
hardware/carrier/Assembled V0.2.step
