awong-dev/pager/hardware/carrier/core_components.pdf

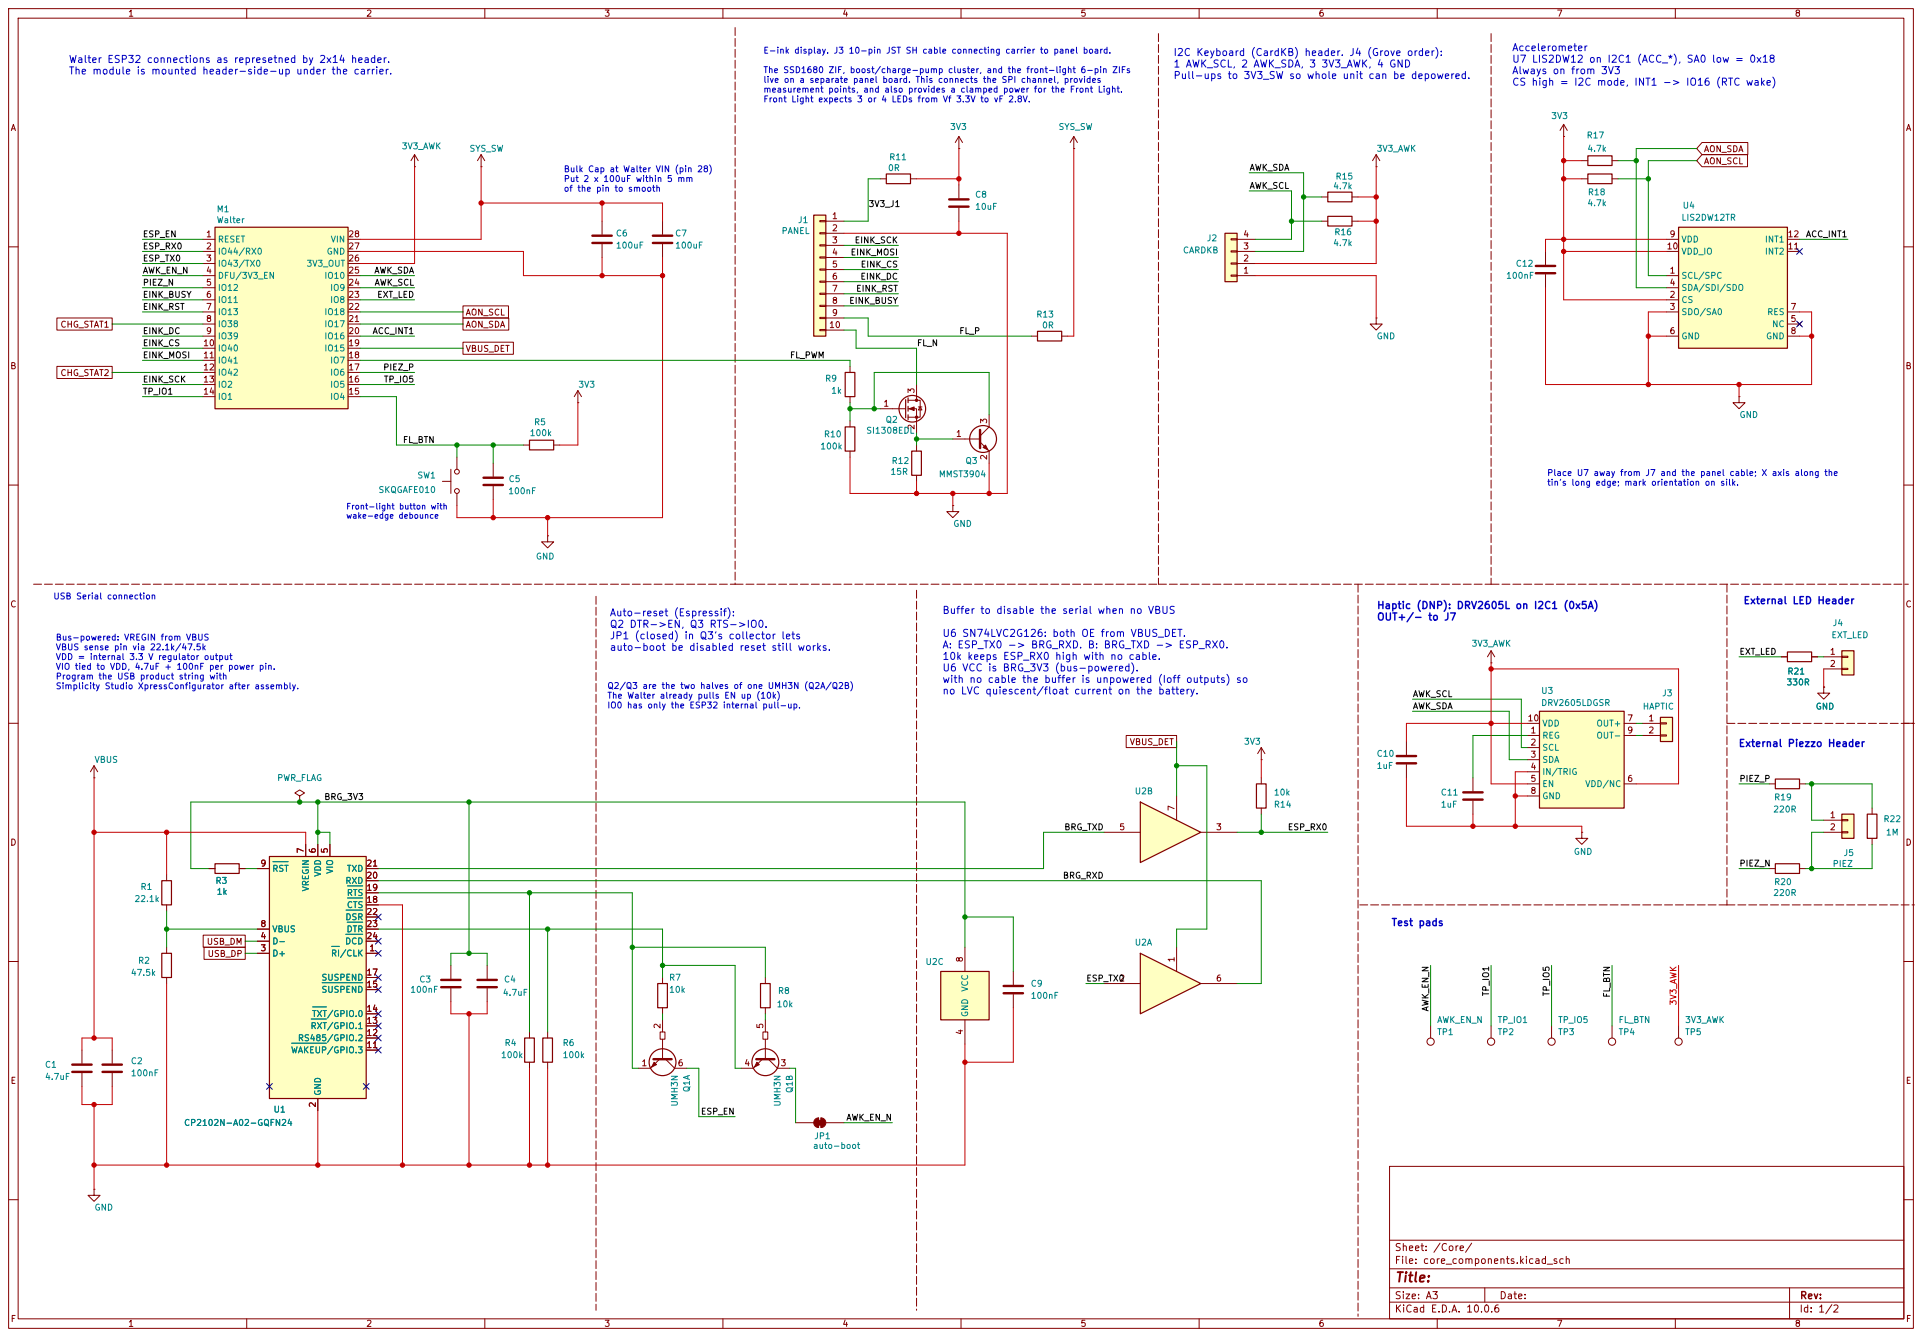
[picture p10: page 1]

CS high = I2C mode, INT1 -> IO16 (RTC wake) E-ink display. J3 10-pin JST SH cable connecting carrier to panel board. The SSD1680 ZIF, boost/charge-pump cluster, and the front-light 6-pin ZIFs

Walter ESP32 connections as represetned by 2x14 header.
The module is mounted header-side-up under the carrier. USB Serial connection Bus-powered: VREGIN from VBUS

of the pin to smooth

tin's long edge; mark orientation on silk. External LED Header

Auto-reset (Espressif):
Q2 DTR->EN, Q3 RTS->IO0.
JP1 (closed) in Q3's collector lets
auto-boot be disabled reset still works.

Buffer to disable the serial when no VBUS

Haptic (DNP): DRV2605L on I2C1 (0x5A) OUT+/- to J7

U6 SN74LVC2G126: both OE from VBUS_DET.
A: ESP_TX0 -> BRG_RXD. B: BRG_TXD -> ESP_RX0.
10k keeps ESP_RX0 high with no cable.
U6 VCC is BRG_3V3 (bus-powered).
with no cable the buffer is unpowered (Ioff outputs) so
no LVC quiescent/float current on the battery.

VBUS sense pin via 22.1k/47.5k VDD = internal 3.3 V regulator output VIO tied to VDD, 4.7uF + 100nF per power pin.

IO0 has only the ESP32 internal pull-up.

Size: A3 | Rev: | F Date:
KiCad E.D.A. 10.0.6 | Id: 1/2

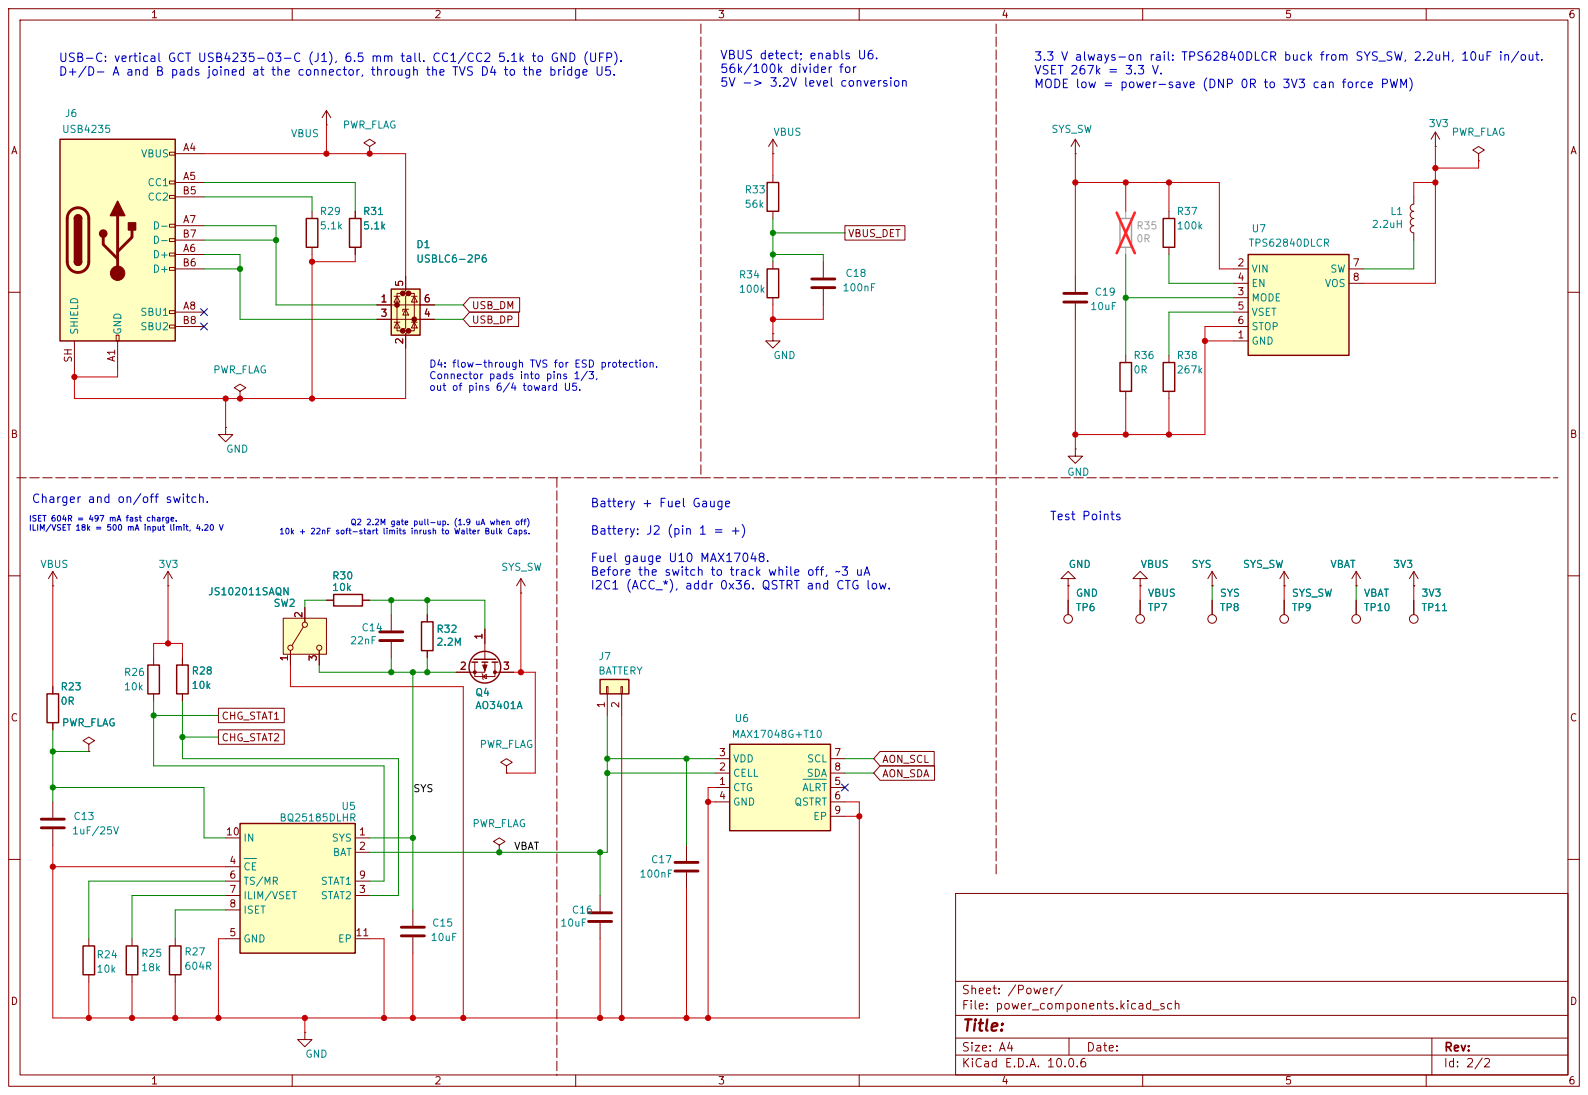
[picture p11: page 2]

Q2 2.2M gate pull-up. (1.9 uA when off) 10k + 22nF soft-start limits inrush to Walter Bulk Caps. USB-C: vertical GCT USB4235-03-C (J1), 6.5 mm tall. CC1/CC2 5.1k to GND (UFP).
D+/D- A and B pads joined at the connector, through the TVS D4 to the bridge U5.

VSET 267k = 3.3 V.
MODE low = power-save (DNP 0R to 3V3 can force PWM)

ISET 604R = 497 mA fast charge.
VBUS C13

Fuel gauge U10 MAX17048.
Before the switch to track while off, ~3 uA
I2C1 (ACC_*), addr 0x36. QSTRT and CTG low.
VBUS C16

ISET 8

Size: A4 | Rev:
KiCad E.D.A. 10.0.6 | Id: 2/2
