awong-dev/pager/hardware/carrier/out/pager-carrier-board.pdf

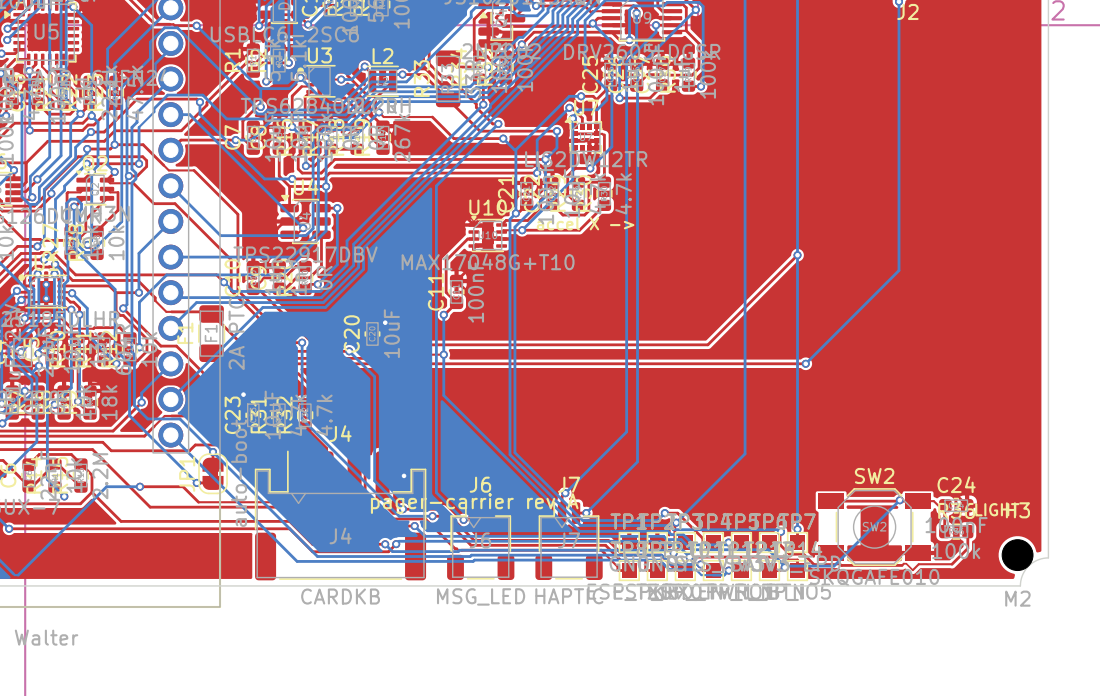
[picture p12: page 1]

Size: A4 | Rev:
KiCad E.D.A. 10.0.6 | Id: 1/1
