awong-dev/pager/hardware/carrier/out/pager-carrier-schematic.pdf

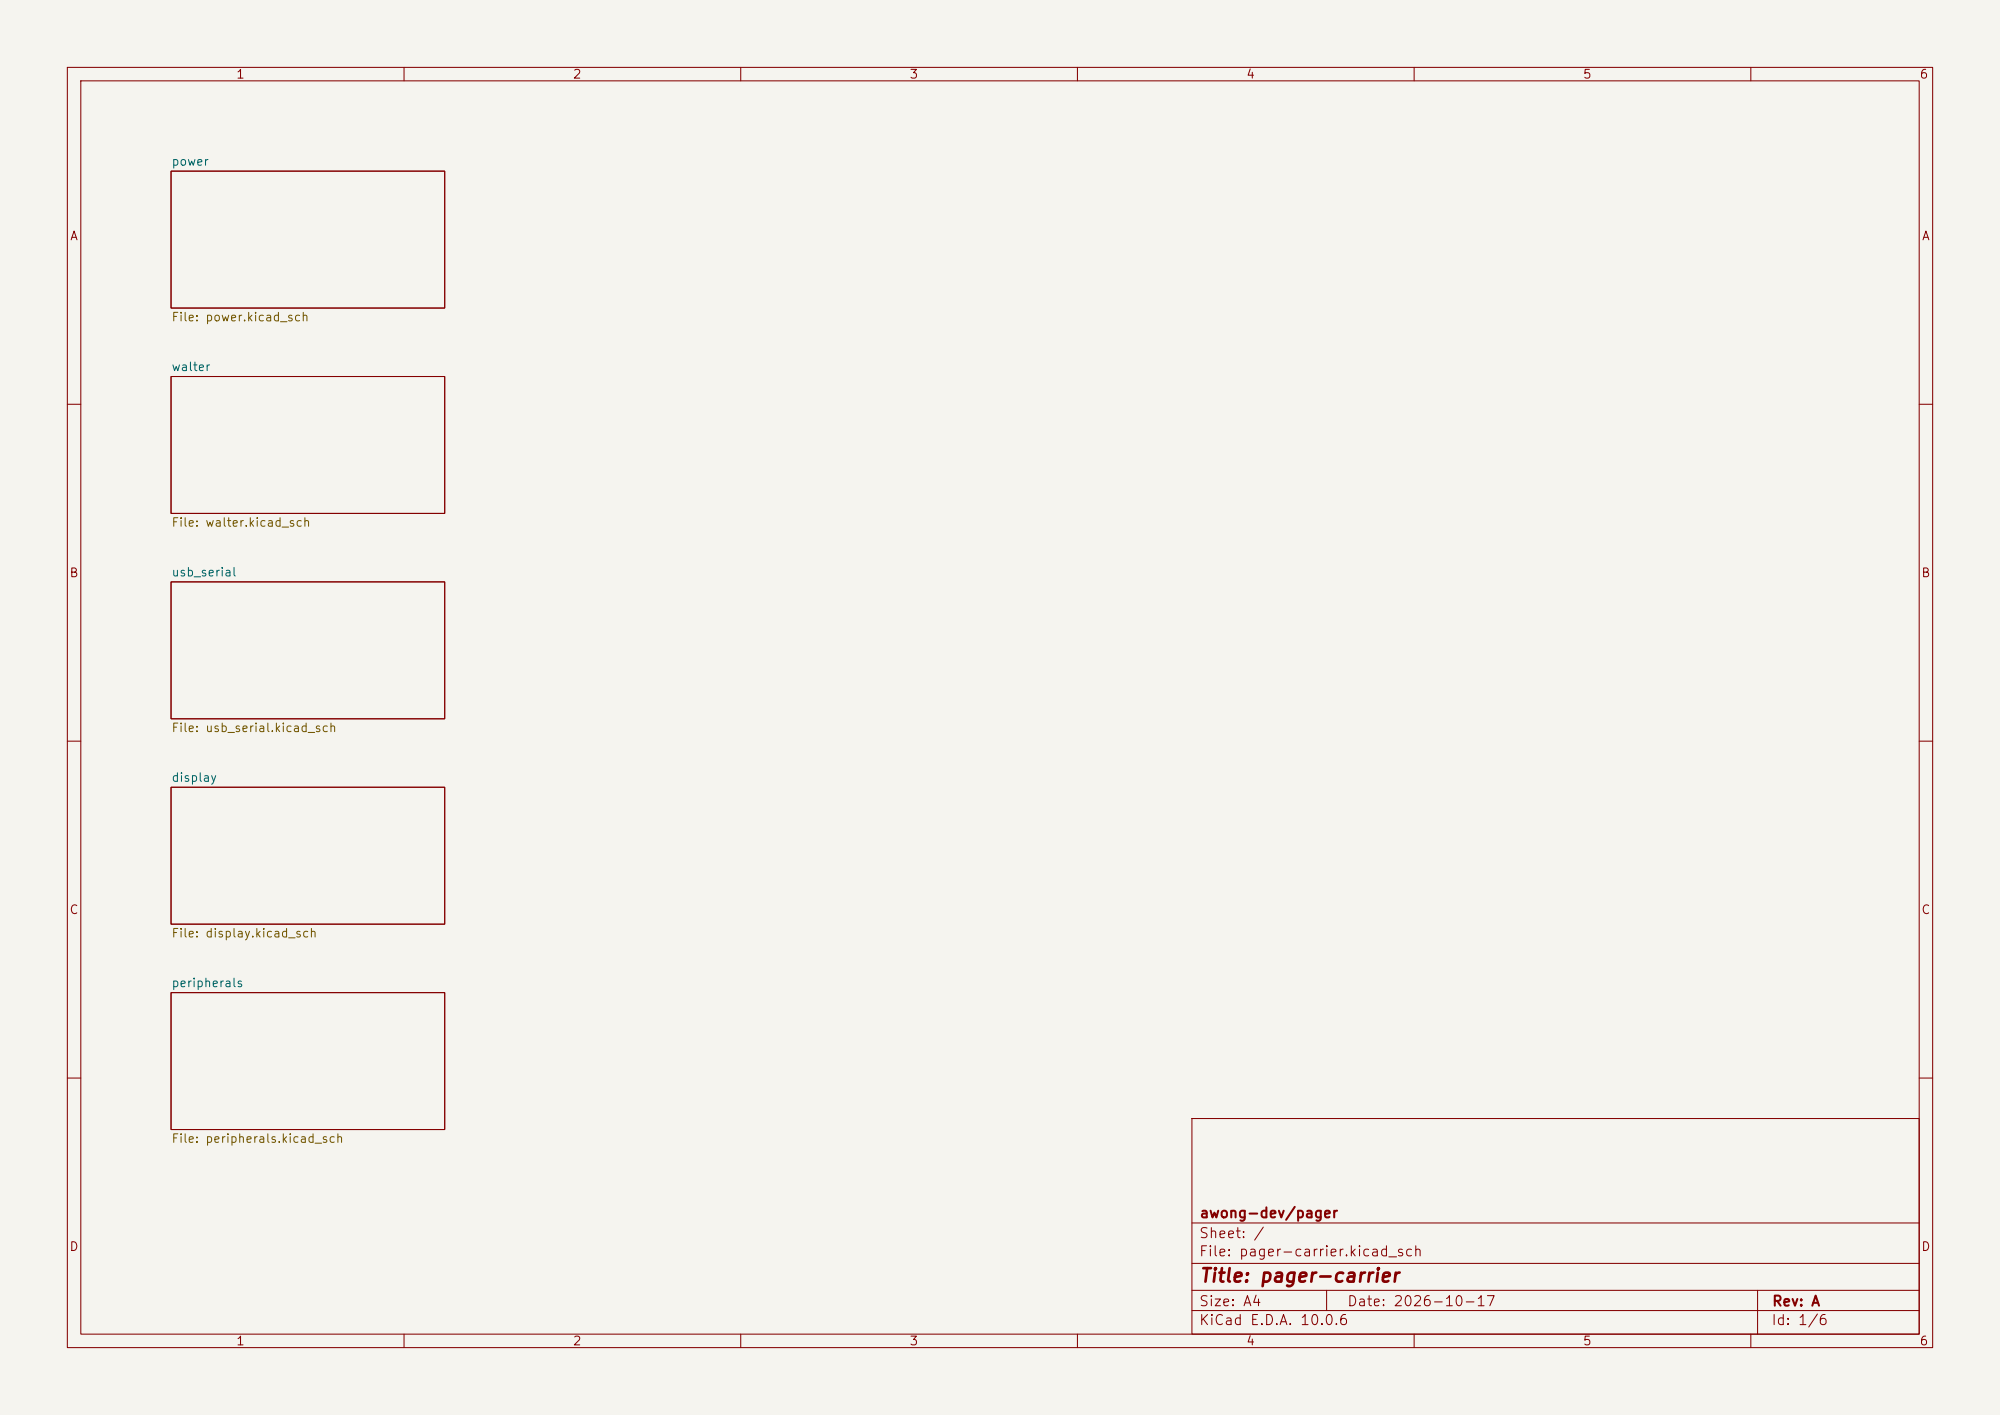
[picture p13: page 1]

power File: power.kicad_sch walter File: walter.kicad_sch

Size: A4 | Rev: A
KiCad E.D.A. 10.0.6 | Id: 1/6

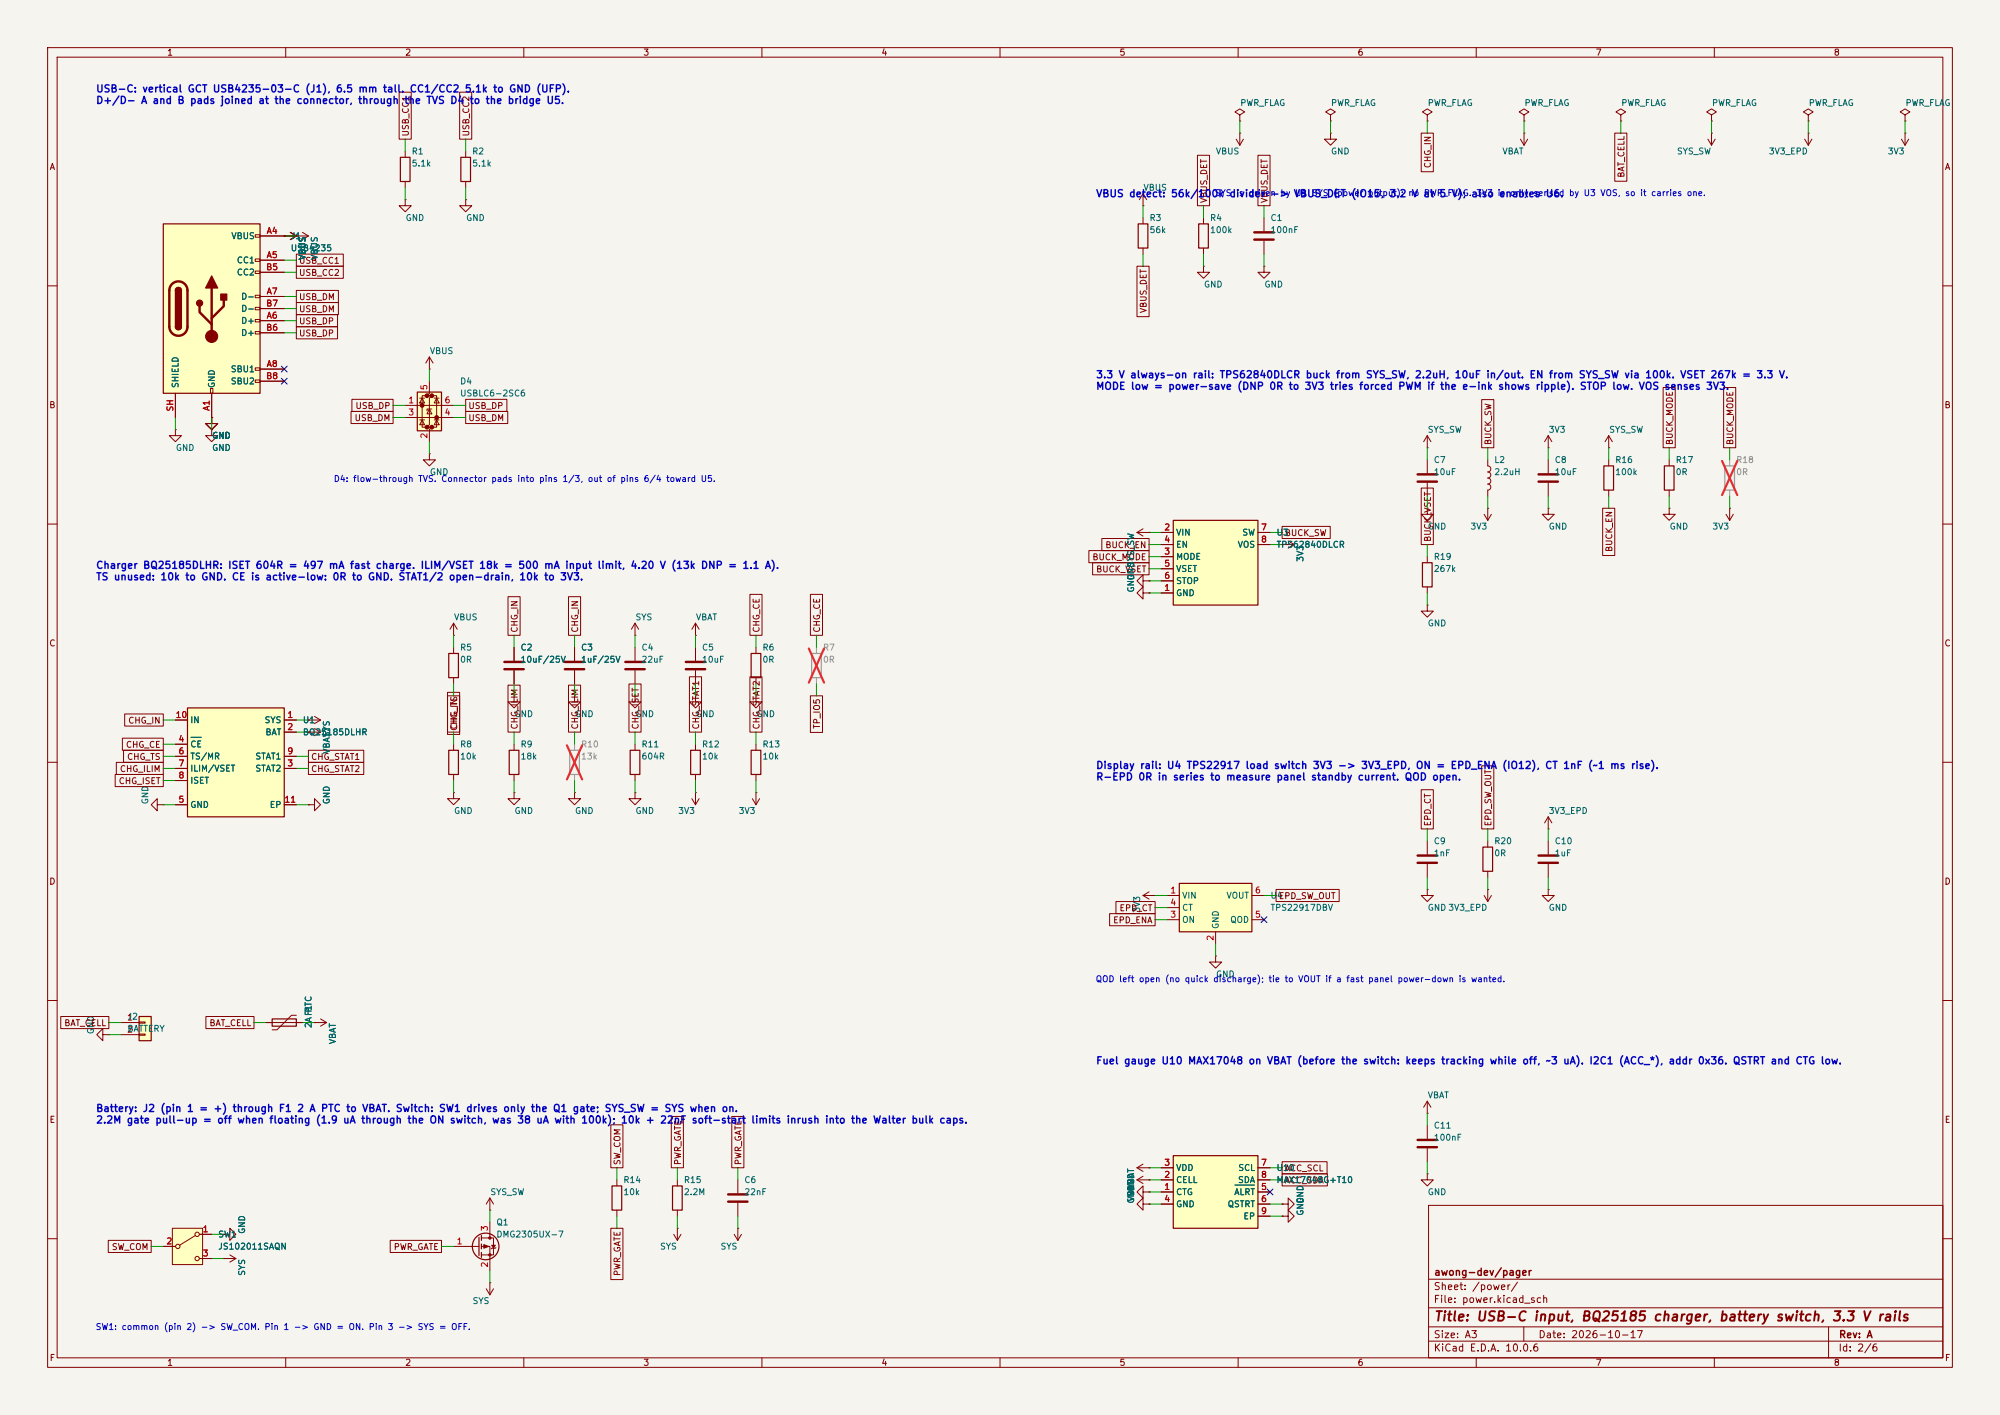
[picture p14: page 2]

3.3 V always-on rail: TPS62840DLCR buck from SYS_SW, 2.2uH, 10uF in/out. EN from SYS_SW via 100k. VSET 267k = 3.3 V.

Display rail: U4 TPS22917 load switch 3V3 -> 3V3_EPD, ON = EPD_ENA (IO12), CT 1nF (~1 ms rise).

CHG_ILIM
R-EPD 0R in series to measure panel standby current. QOD open. SW1: common (pin 2) -> SW_COM. Pin 1 -> GND = ON. Pin 3 -> SYS = OFF. Battery: J2 (pin 1 = +) through F1 2 A PTC to VBAT. Switch: SW1 drives only the Q1 gate; SYS_SW = SYS when on. 2.2M gate pull-up = off when floating (1.9 uA through the ON switch, was 38 uA with 100k); 10k + 22nF soft-start limits inrush into the Walter bulk caps.

awong-dev/pager
Sheet: /power/
File: power.kicad_sch
Title: USB-C input, BQ25185 charger, battery switch, 3.3 V rails

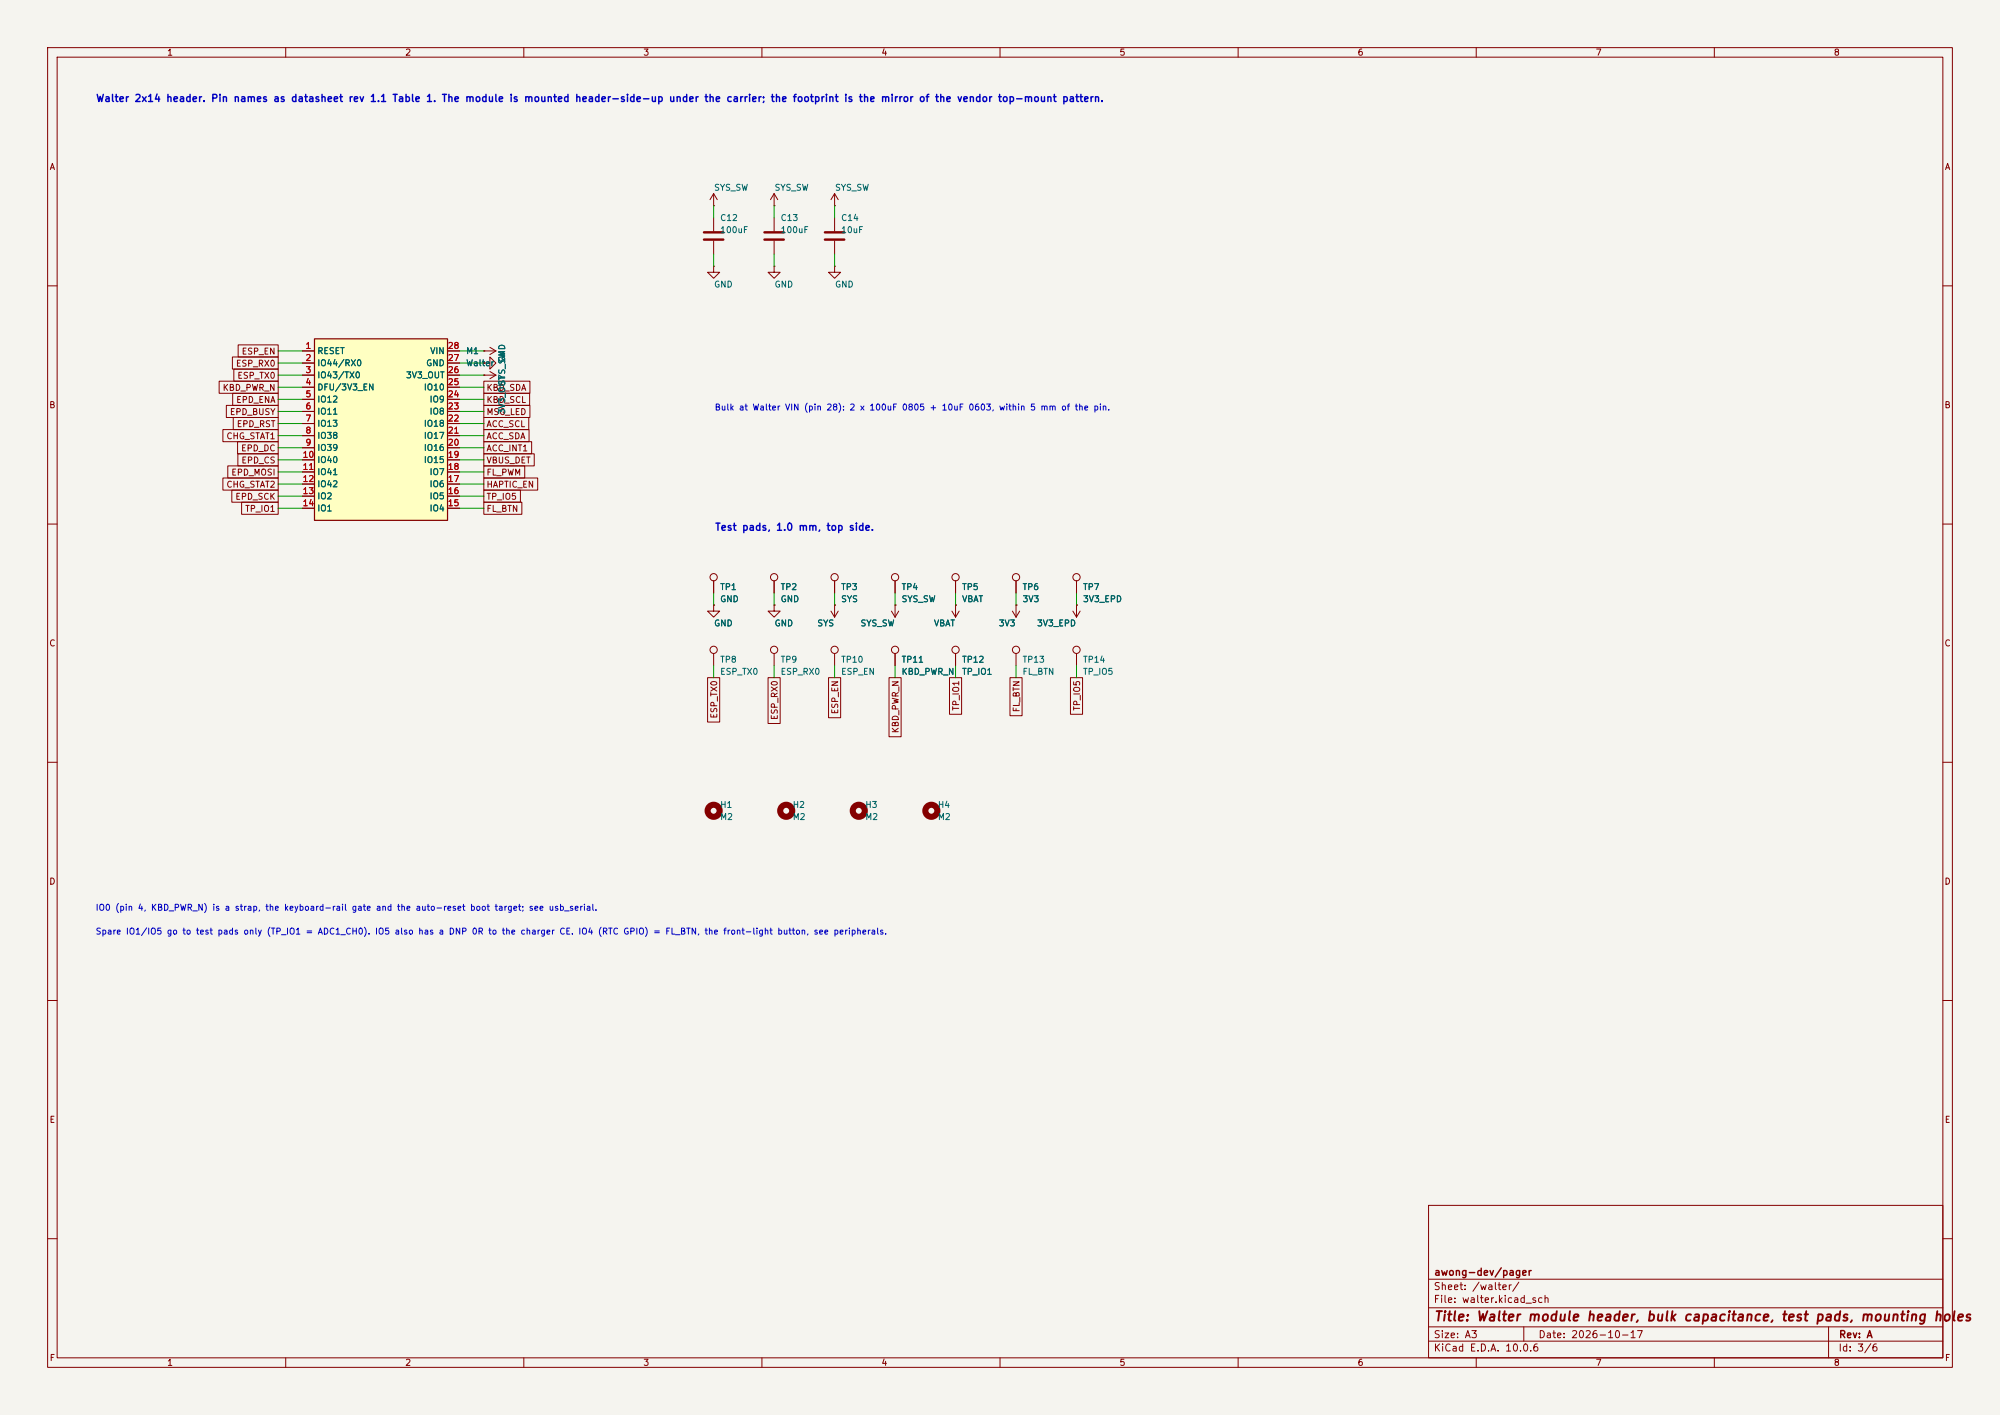
[picture p15: page 3]

Walter 2x14 header. Pin names as datasheet rev 1.1 Table 1. The module is mounted header-side-up under the carrier; the footprint is the mirror of the vendor top-mount pattern.

VBAT VBAT M1 Walter RESET 1

Test pads, 1.0 mm, top side. GND

IO0 (pin 4, KBD_PWR_N) is a strap, the keyboard-rail gate and the auto-reset boot target; see usb_serial. Spare IO1/IO5 go to test pads only (TP_IO1 = ADC1_CH0). IO5 also has a DNP 0R to the charger CE. IO4 (RTC GPIO) = FL_BTN, the front-light button, see peripherals.

awong-dev/pager
Sheet: /walter/
File: walter.kicad_sch
Title: Walter module header, bulk capacitance, test pads, mounting holes

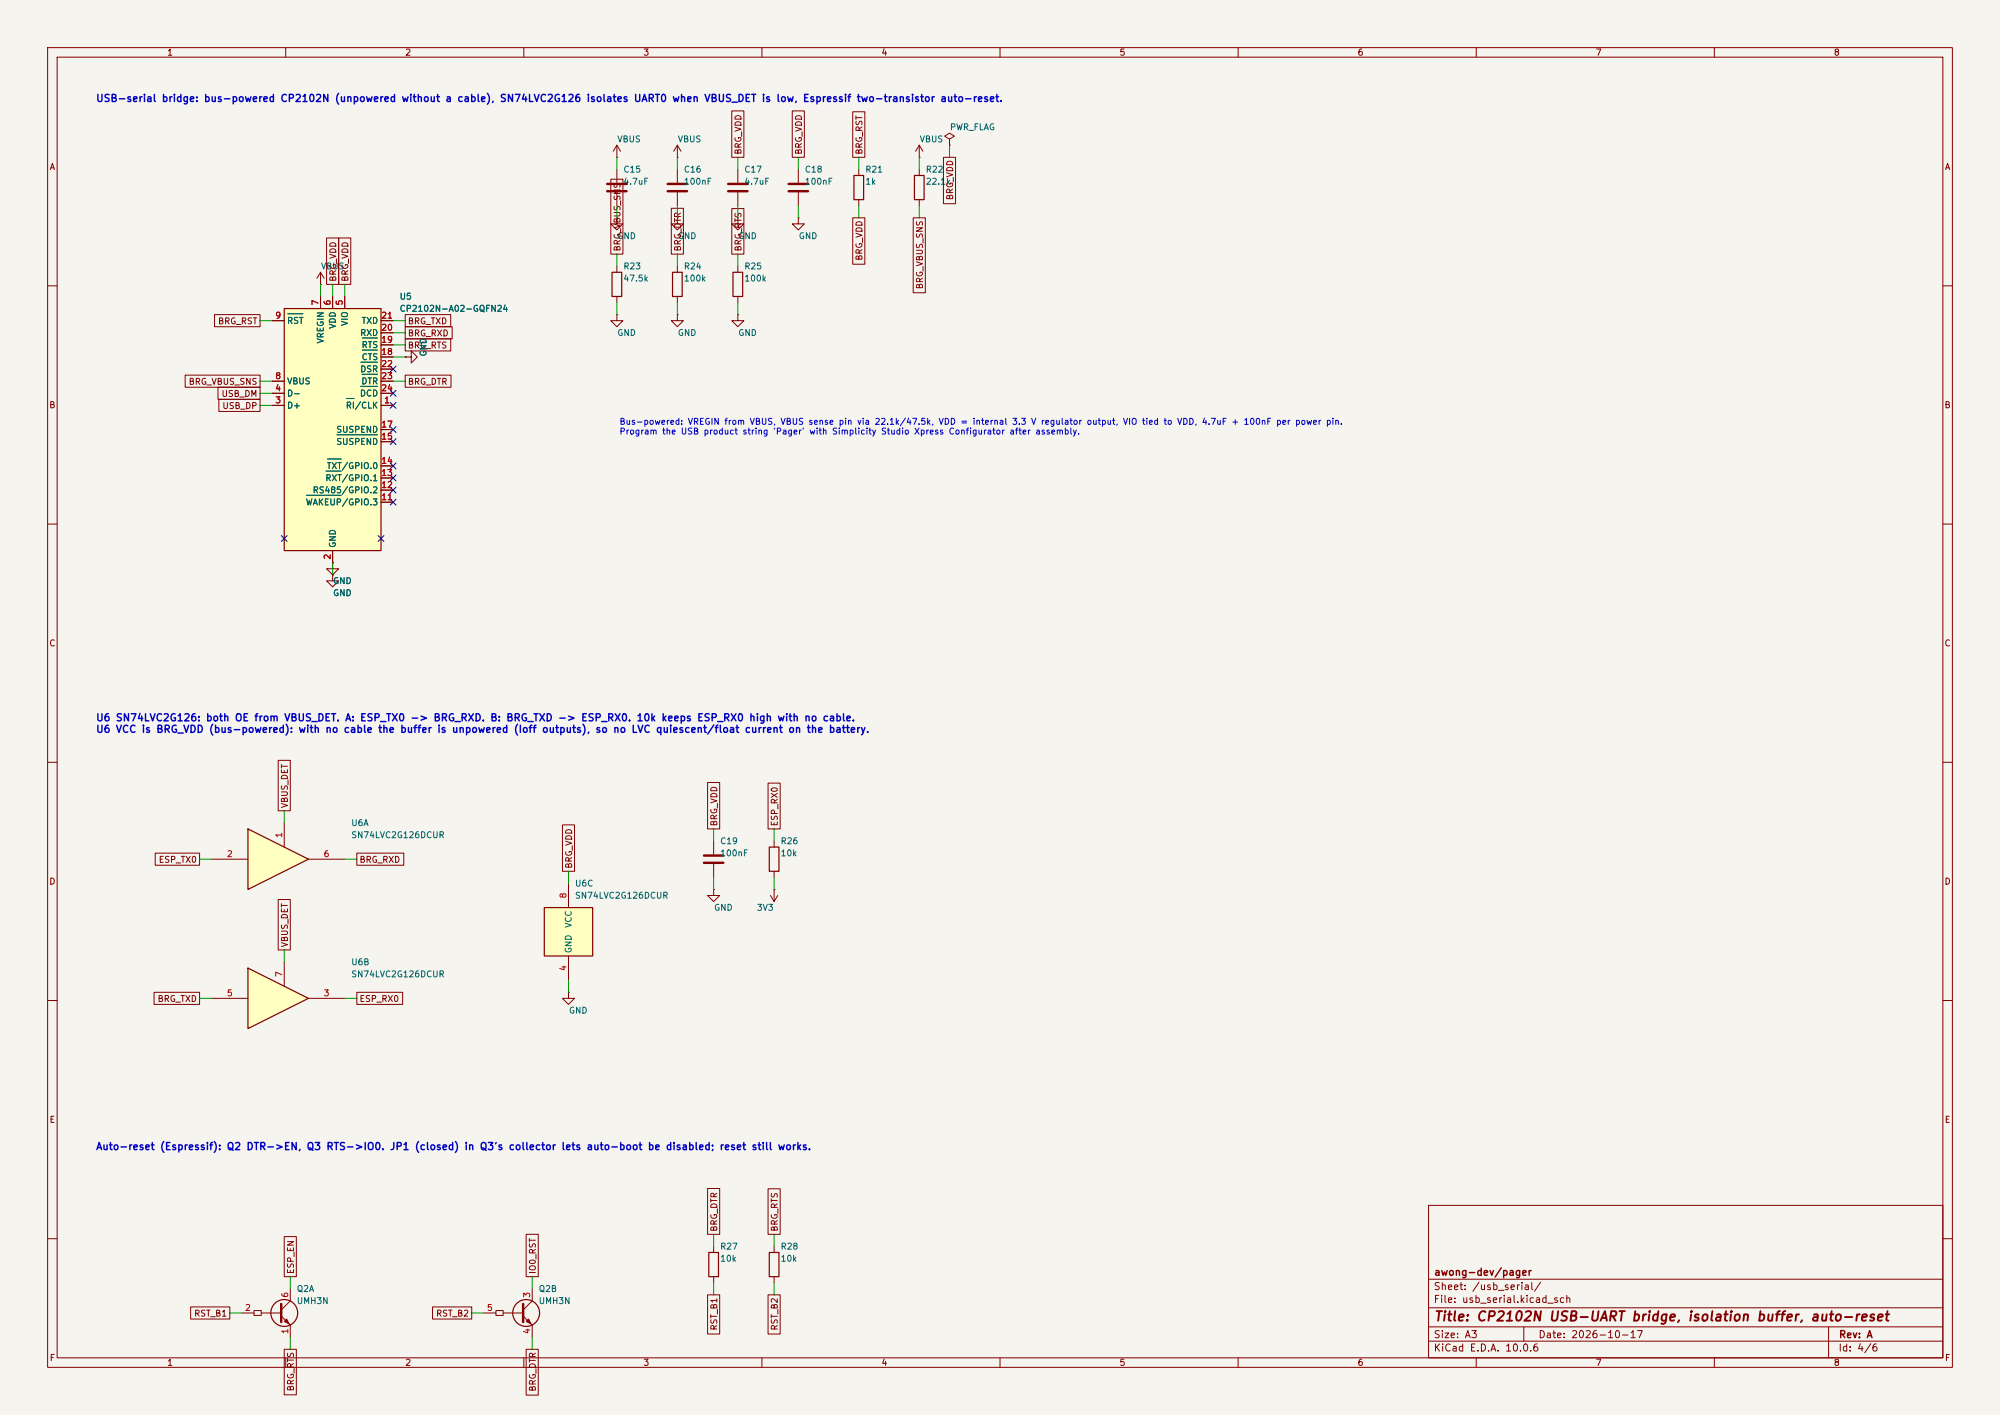
[picture p16: page 4]

USB-serial bridge: bus-powered CP2102N (unpowered without a cable), SN74LVC2G126 isolates UART0 when VBUS_DET is low, Espressif two-transistor auto-reset.
RST_B2 BRG_VDD ESP_EN BRG_RTS BRG_VBUS_SNS

SUSPEND 15 SUSPEND 17 CTS 18 RTS 19 RXD 20 TXD 21 DSR 22 DTR 23 DCD 24 U5CP2102N-A02-GQFN24 GND

Bus-powered: VREGIN from VBUS, VBUS sense pin via 22.1k/47.5k, VDD = internal 3.3 V regulator output, VIO tied to VDD, 4.7uF + 100nF per power pin.
Program the USB product string 'Pager' with Simplicity Studio Xpress Configurator after assembly.

U6 SN74LVC2G126: both OE from VBUS_DET. A: ESP_TX0 -> BRG_RXD. B: BRG_TXD -> ESP_RX0. 10k keeps ESP_RX0 high with no cable.
U6 VCC is BRG_VDD (bus-powered): with no cable the buffer is unpowered (Ioff outputs), so no LVC quiescent/float current on the battery.

Auto-reset (Espressif): Q2 DTR->EN, Q3 RTS->IO0. JP1 (closed) in Q3's collector lets auto-boot be disabled; reset still works.

awong-dev/pager
Sheet: /usb_serial/
File: usb_serial.kicad_sch
Title: CP2102N USB-UART bridge, isolation buffer, auto-reset

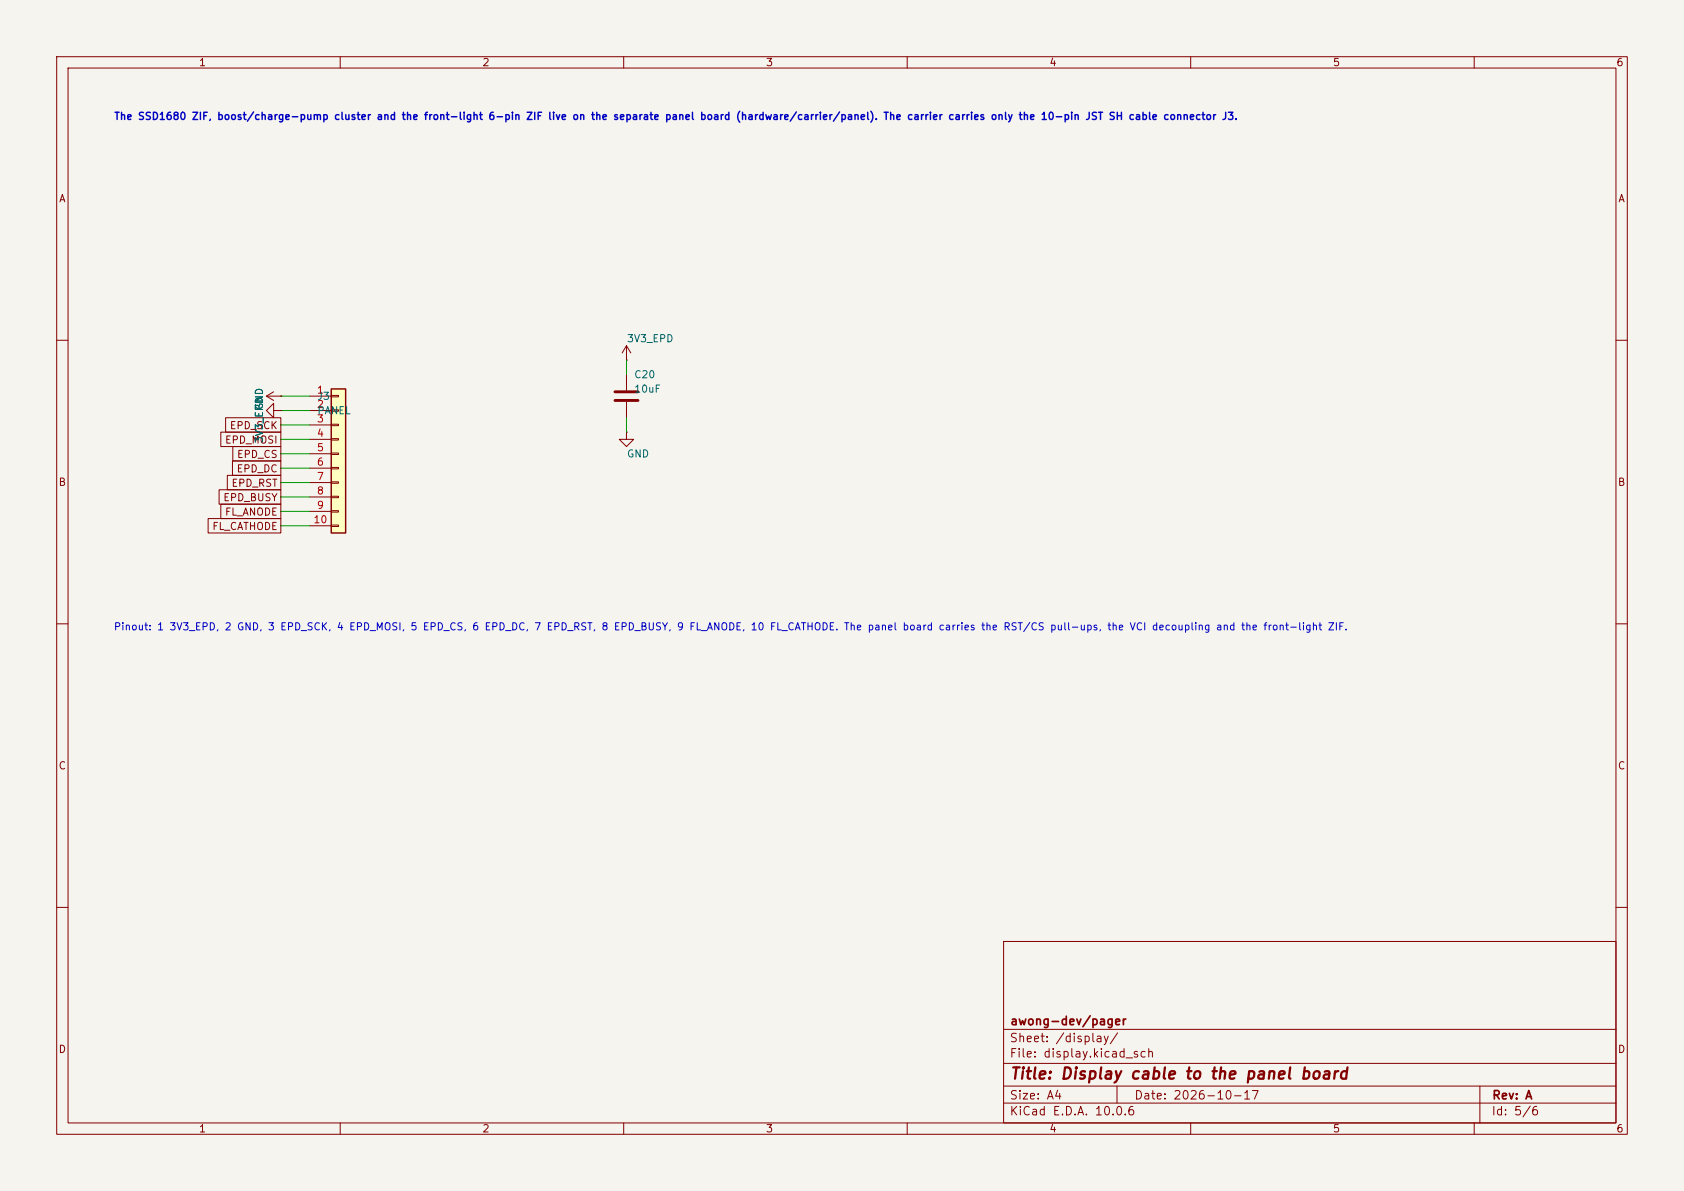
[picture p17: page 5]

The SSD1680 ZIF, boost/charge-pump cluster and the front-light 6-pin ZIF live on the separate panel board (hardware/carrier/panel). The carrier carries only the 10-pin JST SH cable connector J3. 3V3_EPDGND

FL_CATHODE Pinout: 1 3V3_EPD, 2 GND, 3 EPD_SCK, 4 EPD_MOSI, 5 EPD_CS, 6 EPD_DC, 7 EPD_RST, 8 EPD_BUSY, 9 FL_ANODE, 10 FL_CATHODE. The panel board carries the RST/CS pull-ups, the VCI decoupling and the front-light ZIF.

awong-dev/pager
Sheet: /display/
File: display.kicad_sch
Title: Display cable to the panel board

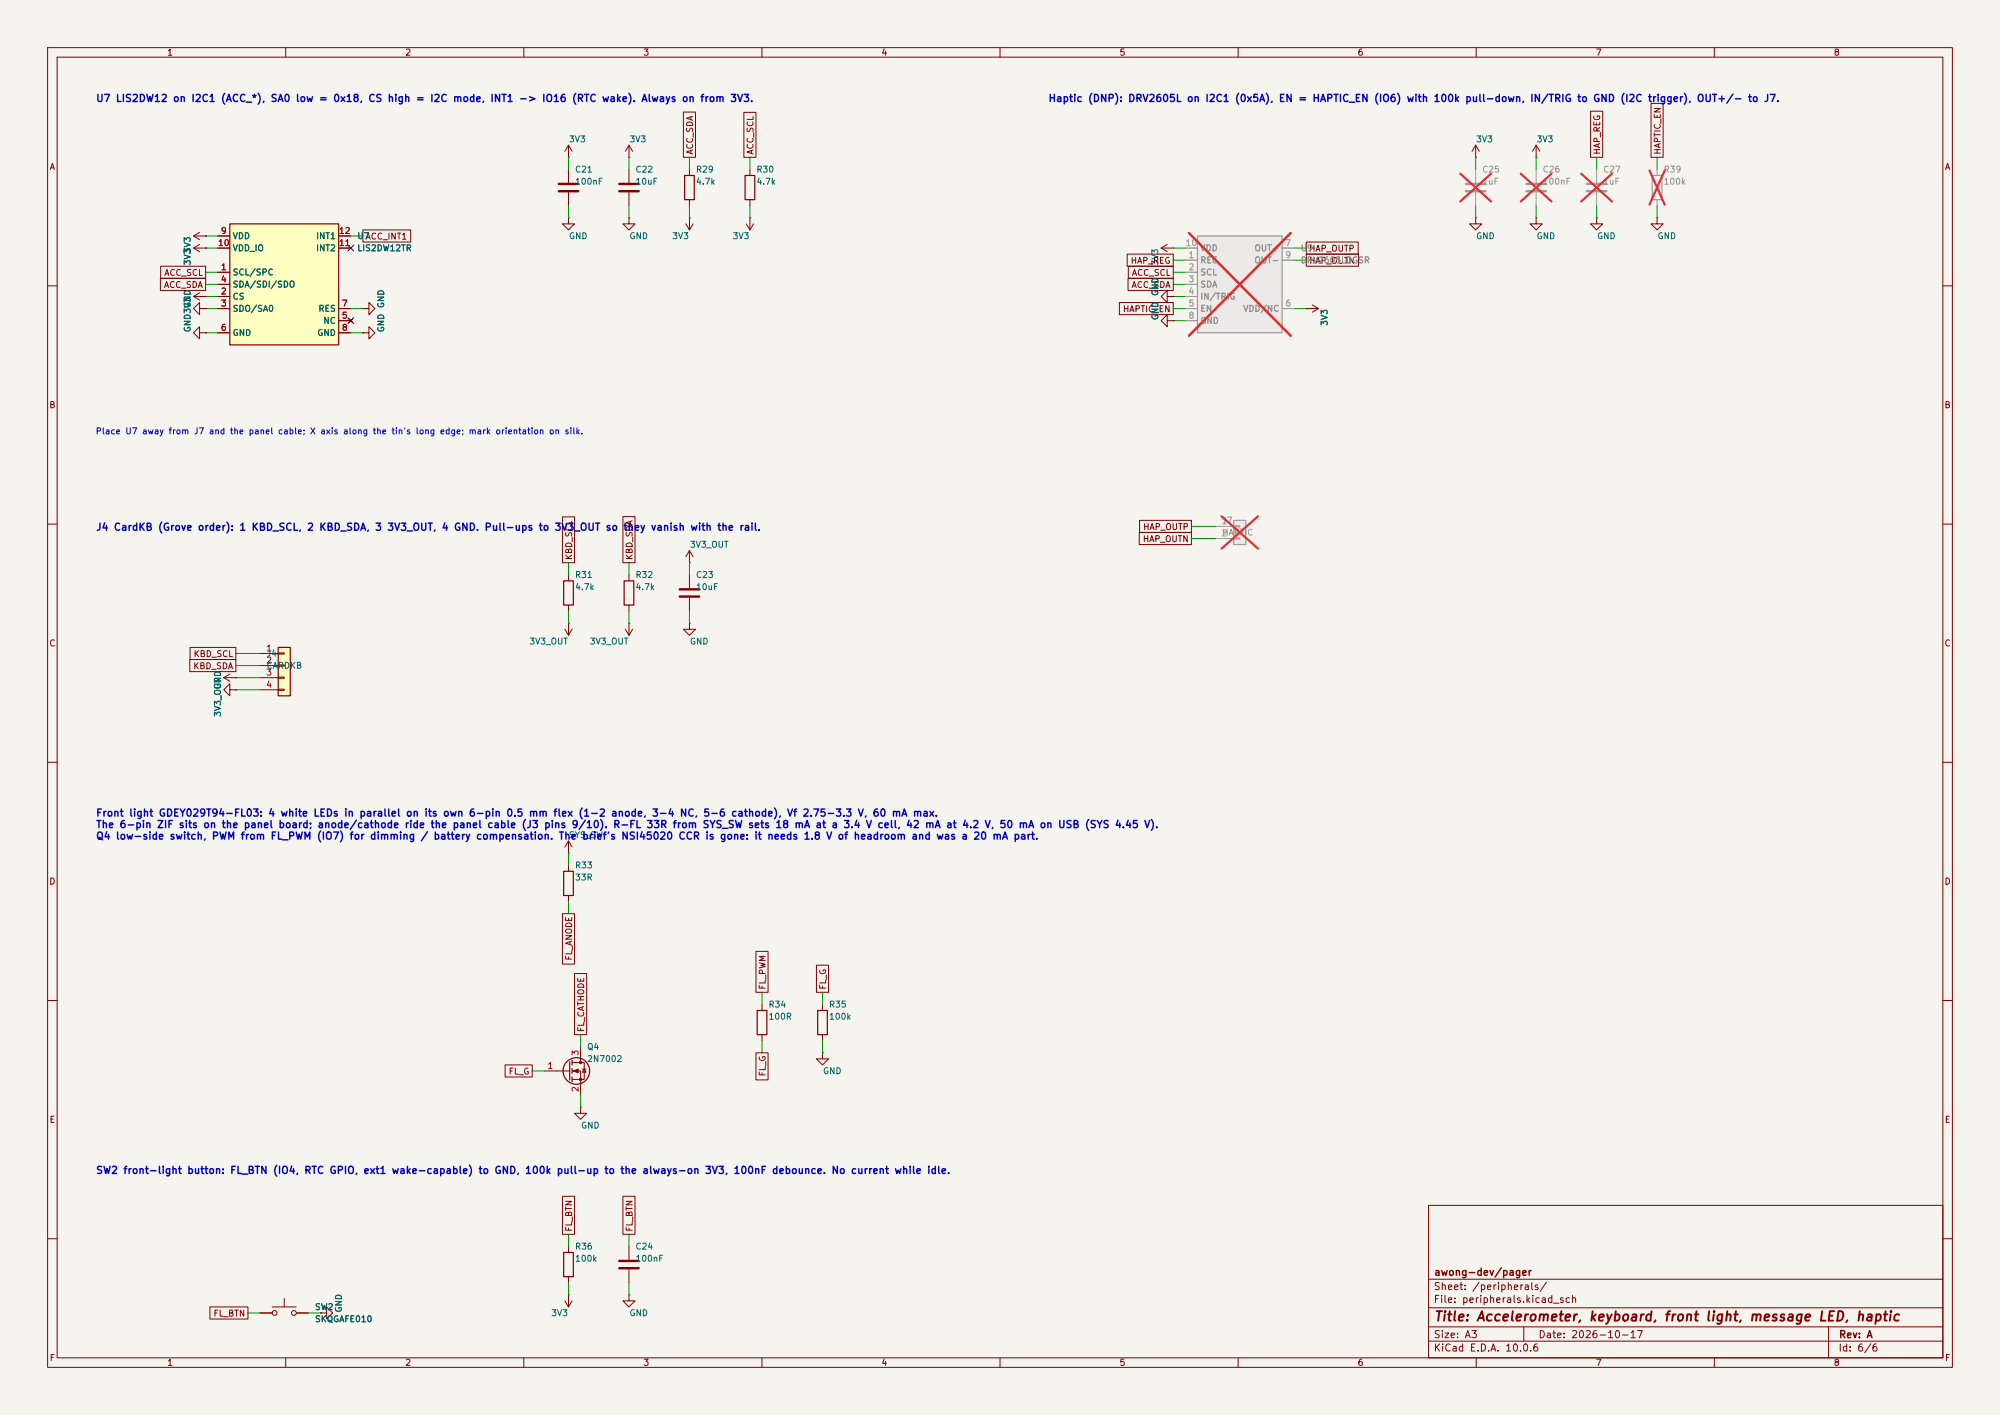
[picture p18: page 6]

Haptic (DNP): DRV2605L on I2C1 (0x5A), EN = HAPTIC_EN (IO6) with 100k pull-down, IN/TRIG to GND (I2C trigger), OUT+/- to J7. Place U7 away from J7 and the panel cable; X axis along the tin's long edge; mark orientation on silk. U7 LIS2DW12 on I2C1 (ACC_*), SA0 low = 0x18, CS high = I2C mode, INT1 -> IO16 (RTC wake). Always on from 3V3.

Front light GDEY029T94-FL03: 4 white LEDs in parallel on its own 6-pin 0.5 mm flex (1-2 anode, 3-4 NC, 5-6 cathode), Vf 2.75-3.3 V, 60 mA max. The 6-pin ZIF sits on the panel board; anode/cathode ride the panel cable (J3 pins 9/10). R-FL 33R from SYS_SW sets 18 mA at a 3.4 V cell, 42 mA at 4.2 V, 50 mA on USB (SYS 4.45 V). Q4 low-side switch, PWM from FL_PWM (IO7) for dimming / battery compensation. The brief's NSI45020 CCR is gone: it needs 1.8 V of headroom and was a 20 mA part.

SW2 front-light button: FL_BTN (IO4, RTC GPIO, ext1 wake-capable) to GND, 100k pull-up to the always-on 3V3, 100nF debounce. No current while idle.

awong-dev/pager
Sheet: /peripherals/
File: peripherals.kicad_sch
Title: Accelerometer, keyboard, front light, message LED, haptic
