awong-dev/pager/hardware/carrier/panel/out/pager-panel-board.pdf

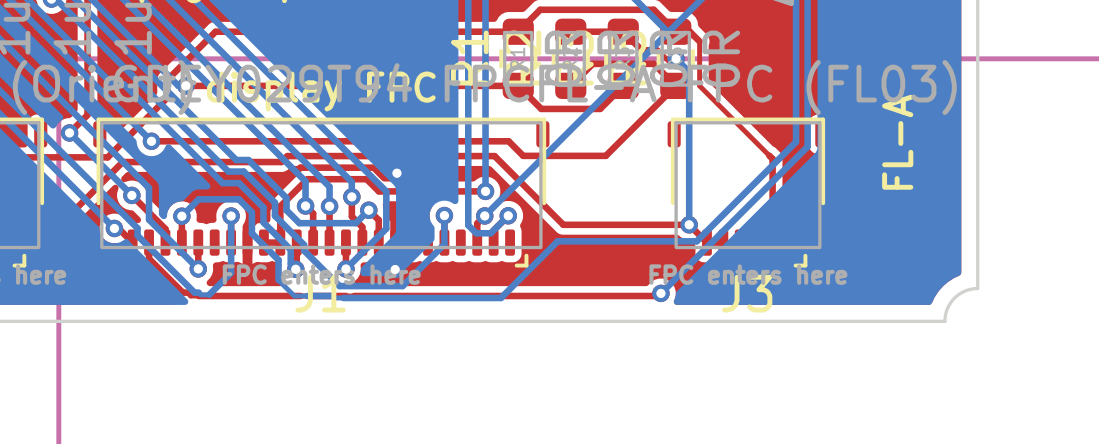
[picture p19: page 1]

FPC enters here MBR0530 D3 CARRIER

Size: A4 | Rev:
KiCad E.D.A. 10.0.6 | Id: 1/1
