awong-dev/pager/hardware/carrier/panel/out/pager-panel-schematic.pdf

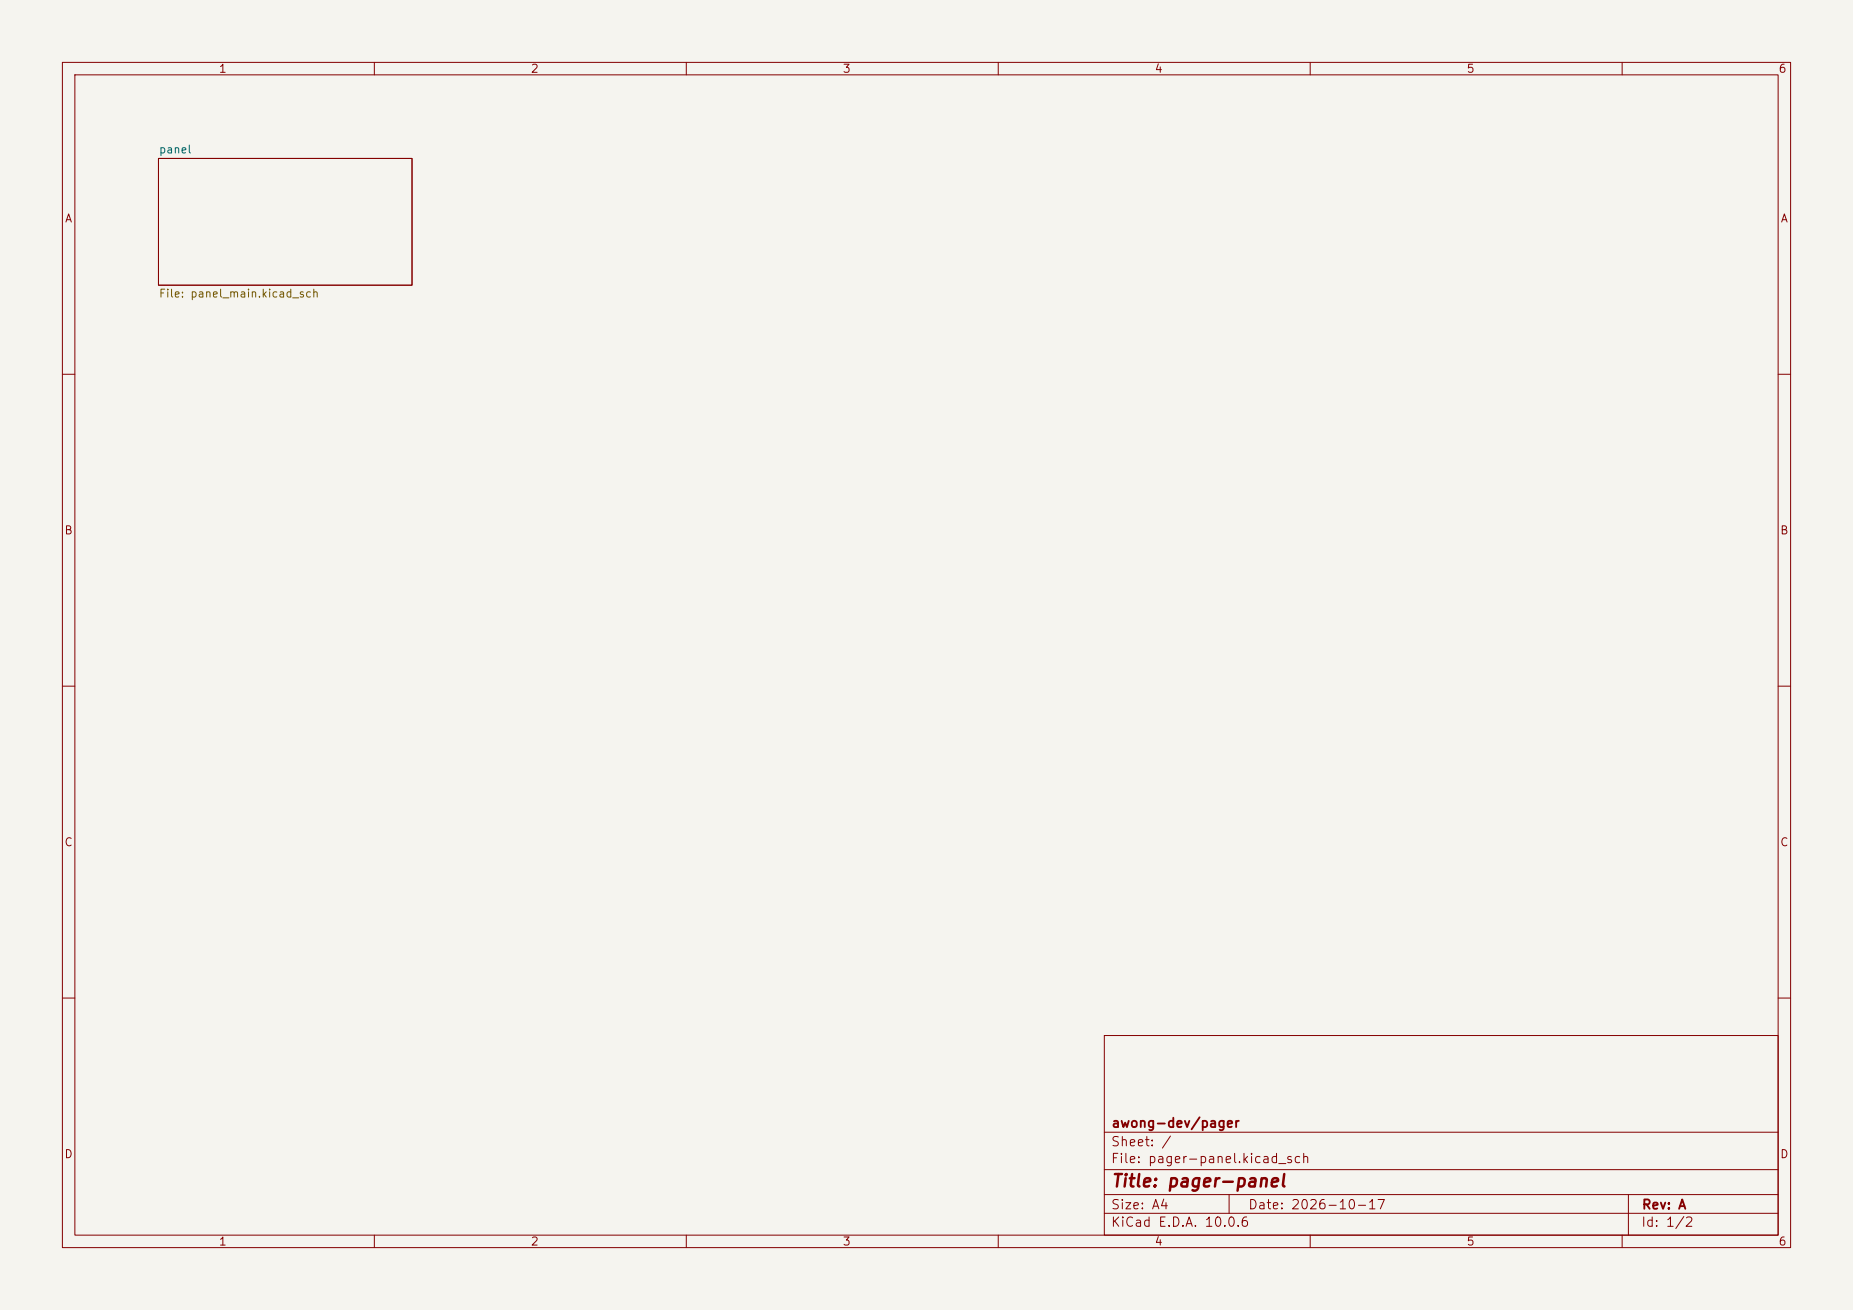
[picture p20: page 1]

Size: A4 | Rev: A
KiCad E.D.A. 10.0.6 | Id: 1/2

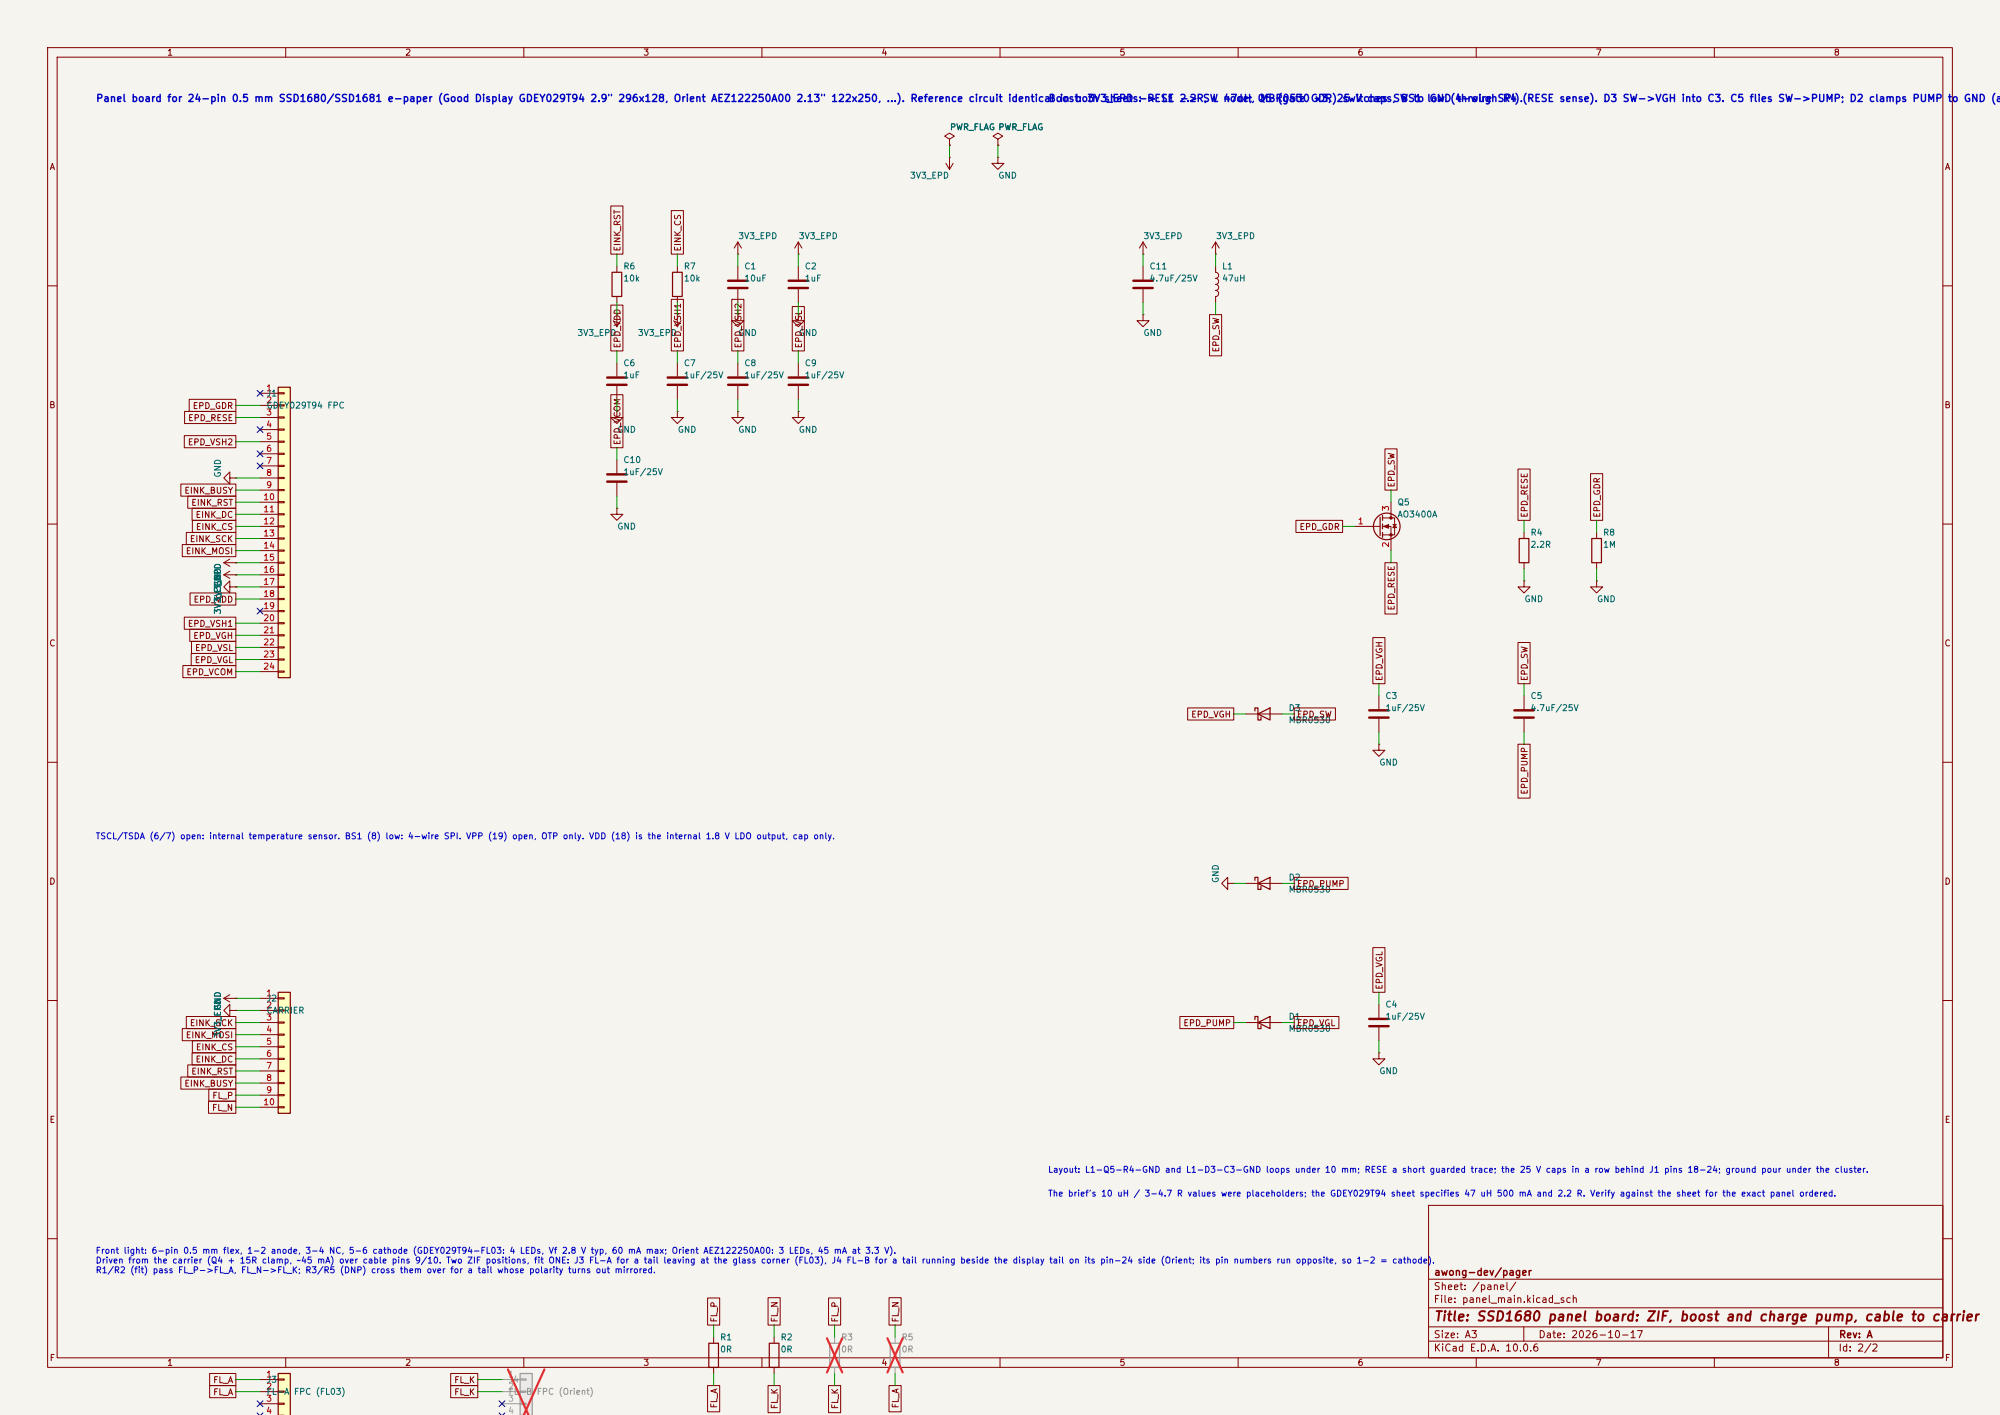
[picture p21: page 2]

Panel board for 24-pin 0.5 mm SSD1680/SSD1681 e-paper (Good Display GDEY029T94 2.9" 296x128, Orient AEZ122250A00 2.13" 122x250, ...). Reference circuit identical in both sheets: RESE 2.2R, L 47uH, MBR0530 x3, 25 V caps, BS1 low (4-wire SPI).

Boost: 3V3_EPD -> L1 -> SW node; Q5 (gate GDR) switches SW to GND through R4 (RESE sense). D3 SW->VGH into C3. C5 flies SW->PUMP; D2 clamps PUMP to GND (anode PUMP); D1 pumps PUMP into VGL (anode VGL) with C4.

R1/R2 (fit) pass FL_P->FL_A, FL_N->FL_K; R3/R5 (DNP) cross them over for a tail whose polarity turns out mirrored. 3V3_EPDGND GND 3V3_EPD

awong-dev/pager GND

Front light: 6-pin 0.5 mm flex, 1-2 anode, 3-4 NC, 5-6 cathode (GDEY029T94-FL03: 4 LEDs, Vf 2.8 V typ, 60 mA max; Orient AEZ122250A00: 3 LEDs, 45 mA at 3.3 V). Driven from the carrier (Q4 + 15R clamp, ~45 mA) over cable pins 9/10. Two ZIF positions, fit ONE: J3 FL-A for a tail leaving at the glass corner (FL03), J4 FL-B for a tail running beside the display tail on its pin-24 side (Orient; its pin numbers run opposite, so 1-2 = cathode).

Sheet: /panel/
File: panel_main.kicad_sch
Title: SSD1680 panel board: ZIF, boost and charge pump, cable to carrier

Size: A3 | Rev: A | F Date: 2026-10-17
KiCad E.D.A. 10.0.6 | Id: 2/2
