awong-dev/pager/(list of files, drawings)

Other design files:
hardware/carrier/out/pager-carrier.dsn
hardware/carrier/panel/out/pager-panel.dsn
