awong-dev/pager/hardware/carrier/pager-carrier.kicad_pcb

## KiCad design hardware/carrier/pager-carrier.kicad_pcb (2026-11-13)

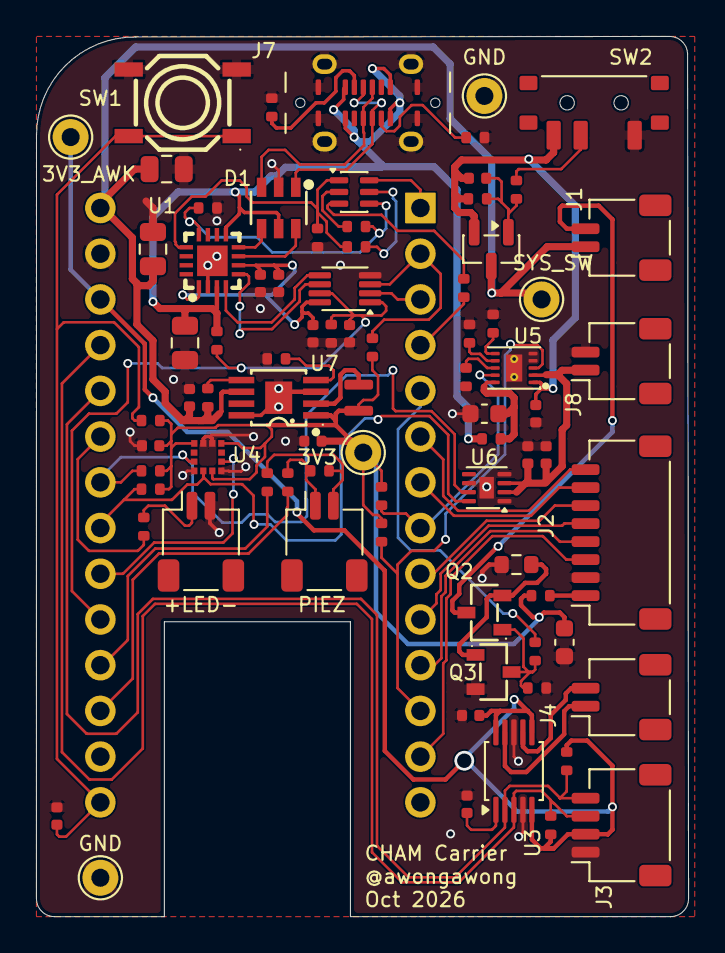
[picture p22: board pager-carrier.kicad_pcb from above]

Board: 2 copper layers, 36.2 x 48.9 mm, 81 parts (0 on the bottom side), 63 nets.

Parts:
C1: 10uF; C_0805_2012Metric
C2: 0.1uF; C_0402_1005Metric_NoSilk
C3, C9, C10: 1uF; C_0402_1005Metric_NoSilk
C4, C8, C11, C13, C16, C17: 100nF; C_0402_1005Metric_NoSilk
C5, C6: 22uF; C_0805_2012Metric
C7: 10uF; C_0603_1608Metric
C12: 1uF; C_0603_1608Metric
C14, C15, C18, C19: 10uF; C_0402_1005Metric_NoSilk
D1: USBLC6-2SC6_C2687116; SOT-23-6_L2.9-W1.6-P0.95-LS2.8-BL
J1, J4, J5, J6, J8: Conn_01x02; JST_SH_SM02B-SRSS-TB_1x02-1MP_P1.00mm_Horizontal
J2: Conn_01x08; JST_SH_SM08B-SRSS-TB_1x08-1MP_P1.00mm_Horizontal
J3: Conn_01x04; JST_SH_SM04B-SRSS-TB_1x04-1MP_P1.00mm_Horizontal
J7: USB_C_Receptacle_USB2.0_16P; USB_C_Receptacle_ShouHan_TYPE-C-16PLT-H6.5_Vertical
L1: 2.2uH; L_Murata_DFE201610P_NoSilk
M1: Walter; Walter_Module_2x14_THT
Q1: UMH3N; SOT-363_SC-70-6
Q2: AO3400A; SOT-23-3_L2.9-W1.3-P1.90-LS2.4-BR
Q3: MMBT3904-C20526; SOT-23-3_L2.9-W1.3-P1.90-LS2.4-BR
Q4: AO3401A; SOT-23
R1, R2, R3, R9, R31, R32: 100k; R_0402_1005Metric_NoSilk
R4, R5, R11, R21, R23, R25, R27: 10k; R_0402_1005Metric_NoSilk
R6, R7, R20: 0R; R_0402_1005Metric_NoSilk
R8: 1k; R_0402_1005Metric_NoSilk
R10: 15R; R_0603_1608Metric
R12, R13, R14, R15, R26, R28: 4.7k; R_0402_1005Metric_NoSilk
R16, R17, R18: 220R; R_0402_1005Metric_NoSilk
R19, R29: 1M; R_0402_1005Metric_NoSilk
R22: 18k; R_0402_1005Metric_NoSilk
R24: 620R; R_0402_1005Metric_NoSilk
R30, R33: 51k; R_0402_1005Metric_NoSilk
SW1: TS-1187A-S16; SW-SMD_4P-L5.2-W5.2-P3.70-LS6.4
SW2: SW_SPDT; SW_SPDT_ShouHan_MSS12C02LS_TopActuated
TP1: 3V3; TestPoint_THTPad_D2.0mm_Drill1.0mm
TP2: SYS_SW; TestPoint_THTPad_D2.0mm_Drill1.0mm
TP3, TP5: GND; TestPoint_THTPad_D2.0mm_Drill1.0mm
TP4: 3V3_AWK; TestPoint_THTPad_D2.0mm_Drill1.0mm
U1: CH343P; TQFN-16_L3.0-W3.0-P0.50-BL-EP1.7
U2: 74LVC2G126; VSSOP-8_2.3x2mm_P0.5mm
U3: DRV2605LDGSR; TSSOP-10_3x3mm_P0.5mm
U4: LIS2DW12TR-MS; LGA-12_2x2mm_P0.5mm_NoSilk
U5: BQ25185DLHR; BQ25185_WSON-10_DLH0010A_2.2x2mm_P0.4mm_EP0.9x1.5mm
U6: MAX17048G+T10; TDFN-8-1EP_2x2mm_P0.5mm_EP0.8x1.2mm
U7: TPS62842DGRR; HVSSOP-8_L3.0-W3.0-P0.65-LS4.9-BL-EP

Connections:
3V3: C7.1, C11.1, C19.1, L1.2, R3.2, R7.1, R11.2, R14.1, R15.1, R23.1, R25.1, TP1.1 (1_1), U4.3 (VDDIO), U4.7 (VDD), U4.10 (CS), U7.1 (VOS)
3V3_AWK: C9.1, J3.2, M1.26 (3V3_OUT), R12.1, R13.1, TP4.1 (1_1), U3.5 (EN), U3.6 (VDD/NC), U3.10 (VDD)
/Core/3V3_J1: J2.1, R7.2
/Core/ACC_INT1: M1.20 (IO16), U4.5 (INT1)
/Core/AWK_EN_N: M1.4 (DFU/3V3_EN), R6.2
/Core/AWK_SCL: J3.4, M1.24 (IO9), R13.2, U3.2 (SCL)
/Core/AWK_SDA: J3.3, M1.25 (IO10), R12.2, U3.3 (SDA)
/Core/BRG_3V3: C2.2, C3.2, C8.1, U1.1 (VIO), U1.6 (V3), U2.8 (VCC)
/Core/BRG_RXD: U1.5 (RXD), U2.6
/Core/BRG_TXD: U1.4 (TXD), U2.5
/Core/EINK_BUSY: J2.8, M1.6 (IO11)
/Core/EINK_CS: J2.5, M1.10 (IO40)
/Core/EINK_DC: J2.6, M1.9 (IO39)
/Core/EINK_MOSI: J2.4, M1.11 (IO41)
/Core/EINK_RST: J2.7, M1.7 (IO13)
/Core/EINK_SCK: J2.3, M1.13 (IO2)
/Core/ESP_EN: M1.1 (RESET), Q1.6 (C1)
/Core/ESP_RX0: M1.2 (IO44/RX0), R11.1, U2.3
/Core/ESP_TX0: M1.3 (IO43/TX0), U2.2
/Core/EXT_LED: M1.23 (IO8), R18.1
/Core/FL_BTN: C4.1, M1.15 (IO4), R3.1, SW1.1, SW1.2
/Core/FL_N: J1.2, Q2.3 (D)
/Core/FL_PWM: M1.5 (IO12), R8.1
/Core/PIEZ_N: M1.18 (IO7), R17.1
/Core/PIEZ_P: M1.17 (IO6), R16.1
/Power/SW: L1.1, U7.2 (SW)
/Power/SYS: C13.2, C14.1, Q4.2 (S), R29.2, SW2.3 (C), U5.1 (SYS)
/Power/SYS_GATE: C13.1, Q4.1 (G), R27.2, R29.1
/Power/VBAT: C15.1, C16.1, J8.1, U5.2 (BAT), U6.2 (CELL), U6.3 (VDD)
/Power/VSET: R33.1, U7.4 (VSET)
AON_SCL: M1.22 (IO18), R15.2, U4.12 (SCL), U6.7 (SCL)
AON_SDA: M1.21 (IO17), R14.2, U4.2 (SDA), U6.8 (SDA)
CHG_STAT1: M1.8 (IO38), R23.2, U5.9 (STAT1)
CHG_STAT2: M1.12 (IO42), R25.2, U5.3 (STAT2)
GND: C1.2, C2.1, C3.1, C4.2, C5.2, C6.2, C7.2, C8.2, C9.2, C10.2, C11.2, C12.2, C14.2, C15.2, C16.2, C17.2, C18.2, C19.2, D1.2 (GND), J2.2, J3.1, J5.2, J7.A1 (GND), J7.A12 (GND), J7.B1 (GND), J7.B12 (GND), J7.SH (SHIELD), J8.2, M1.27 (GND), Q3.2 (E), R1.2, R2.2, R9.2, R10.2, R21.2, R22.2, R24.2, R26.2, R28.2, R31.2, R33.2, SW1.3, SW1.4, SW2.1 (A), TP3.1 (1_1), TP5.1 (1_1), U1.2 (GND), U1.17 (EP), U2.4 (GND), U3.4 (IN/TRIG), U3.8 (GND), U4.1 (SDO/SA0), U4.4 (NC(GND)), U4.8 (GNDIO), U4.9 (GND), U5.4 (~CE), U5.5 (GND), U5.11 (EP), U6.1 (CTG), U6.4 (GND), U6.6 (QSTRT), U6.9 (EP), U7.3 (MODE), U7.8 (GND), U7.9 (EP)
unnamed: D1.1 (I/O1), J7.A6 (D+), J7.B6 (D+)
unnamed: D1.3 (I/O2), J7.A7 (D-), J7.B7 (D-)
unnamed: J4.1, U3.9 (OUT-)
unnamed: J4.2, U3.7 (OUT+)
unnamed: J5.1, R18.2
unnamed: J6.1, R16.2, R19.2
unnamed: J6.2, R17.2, R19.1
unnamed: J7.A5 (CC1), R28.1
unnamed: J7.B5 (CC2), R26.1
unnamed: Q1.2 (B1), R4.2
unnamed: Q1.1 (E1), R2.1, R5.1, U1.13 (RTS)
unnamed: Q1.5 (B2), R5.2
unnamed: Q1.3 (C2), R6.1
unnamed: Q1.4 (E2), R1.1, R4.1, U1.12 (DTRTNOW)
unnamed: Q2.1 (G), Q3.3 (C), R8.2, R9.1
unnamed: Q2.2 (S), Q3.1 (B), R10.1
unnamed: R27.1, SW2.2 (B)
unnamed: C10.1, U3.1 (REG)
unnamed: R22.1, U5.7 (ILIM/VSET)
unnamed: C12.1, R20.2, U5.10 (IN)
unnamed: R24.1, U5.8 (ISET)
unnamed: R21.1, U5.6 (TS/MR)
unnamed: R32.2, U7.5 (EN)
SYS_SW: C5.1, C6.1, C18.1, J1.1, M1.28 (VIN), Q4.3 (D), R32.1, TP2.1 (1_1), U7.6 (VIN)
USB_DM: D1.4 (I/O2), U1.8 (UD-)
USB_DP: D1.6 (I/O1), U1.7 (UD+)
VBUS: C1.1, D1.5 (VBUS), J7.A4 (VBUS), J7.A9 (VBUS), J7.B4 (VBUS), J7.B9 (VBUS), R20.1, R30.1, U1.3 (VDD5), U1.9 (VBUS)
VBUS_DET: C17.1, M1.19 (IO15), R30.2, R31.1, U2.1, U2.7
