awong-dev/pager/hardware/carrier/panel/pager-panel.kicad_pcb

## KiCad design hardware/carrier/panel/pager-panel.kicad_pcb (2026-11-13)

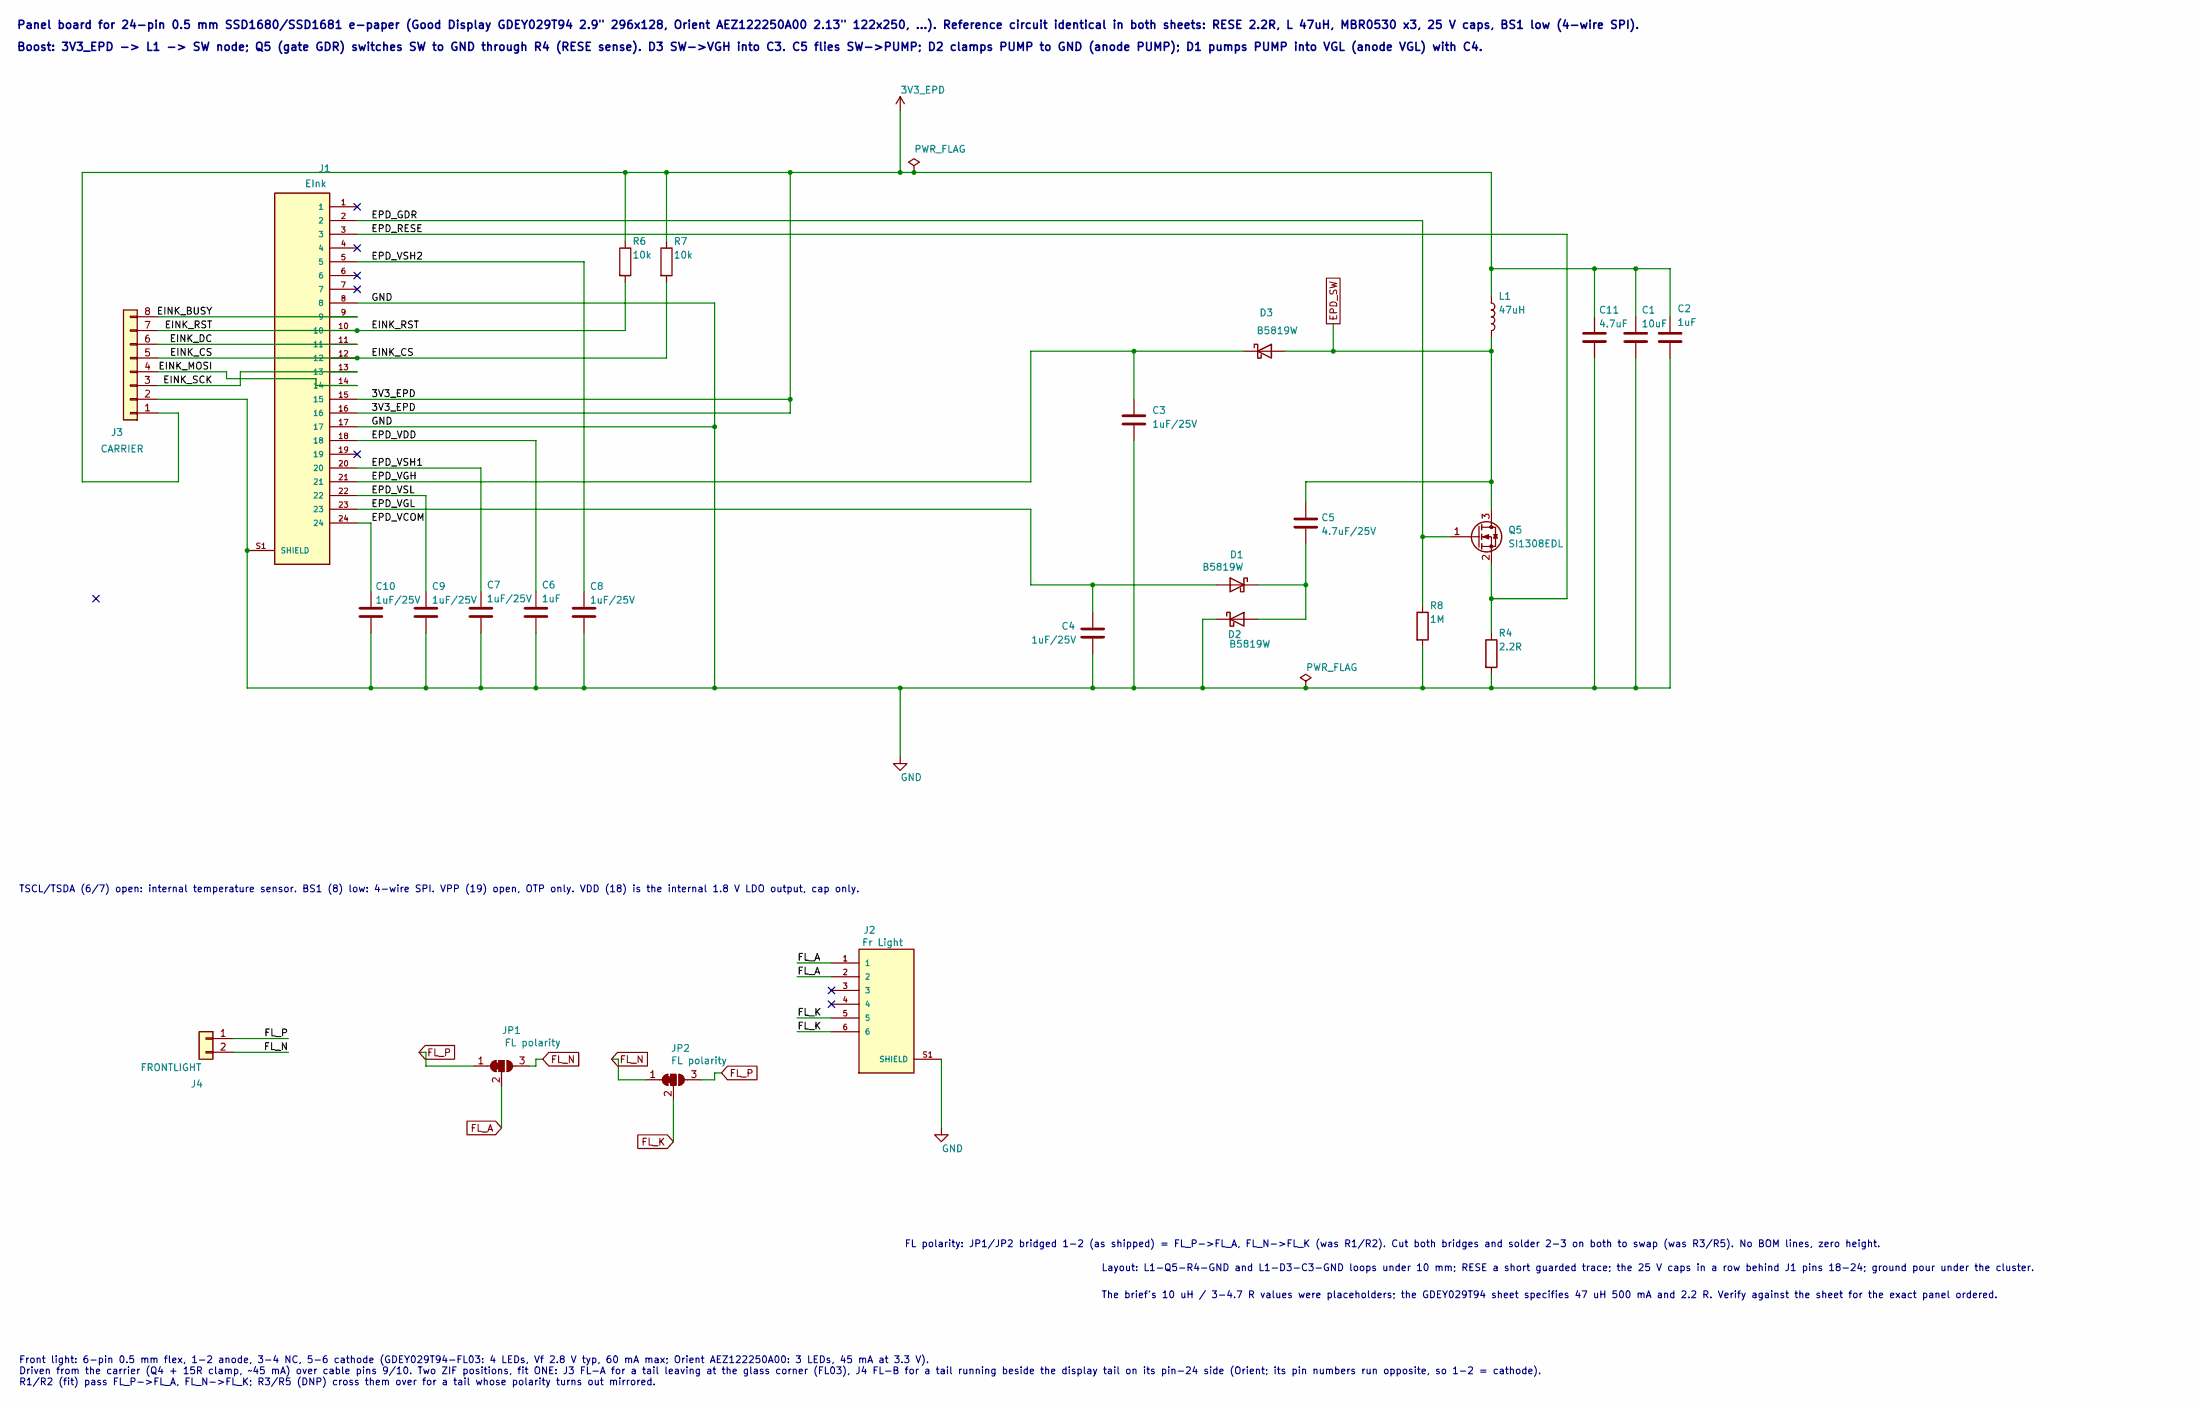
[picture p23: schematic pager-panel.kicad_sch]

Parts:
C1: 10uF; C_0402_1005Metric; MPN CL05A106MQ5NUNC; LCSC C15525
C2, C6: 1uF; C_0402_1005Metric; MPN CL05A105KA5NQNC; LCSC C52923
C3, C4, C7, C8, C9, C10: 1uF/25V; C_0603_1608Metric; MPN CL10A105KA8NNNC; LCSC C15849
C5: 4.7uF/25V; C_0805_2012Metric; MPN CL21B475KAQNNNE; LCSC C1779
C11: 4.7uF; C_0603_1608Metric; MPN CL10A475KP8NNNC; LCSC C19666
D1, D2, D3: B5819W; D_SOD-123; MPN B5819W; LCSC C8598
J1: EInk; HRS_FH34SRJ-24S-0.5SH_50_; MPN FH34SRJ-24S-0.5SH(50); LCSC C324726
J2: Fr Light; HRS_FH34SRJ-6S-0.5SH_50_; MPN FH34SRJ-6S-0.5SH(50); LCSC C224194
J3: CARRIER; JST_SH_SM08B-SRSS-TB_1x08-1MP_P1.00mm_Horizontal; MPN SM08B-SRSS-TB; LCSC C160407
J4: FRONTLIGHT; JST_SH_SM02B-SRSS-TB_1x02-1MP_P1.00mm_Horizontal; MPN SM02B-SRSS-TB; LCSC C160402
JP1, JP2: FL polarity; SolderJumper-3_P1.3mm_Bridged12_RoundedPad1.0x1.5mm
L1: 47uH; L_Sunlord_SWPA3015S; MPN SWPA3015S470MT; LCSC C83435
Q5: SI1308EDL; SOT-323_SC-70; MPN SI1308EDL-T1-GE3; LCSC C469327
R4: 2.2R; R_0603_1608Metric; MPN 0603WAF2R20T5E; LCSC C22939
R6, R7: 10k; R_0402_1005Metric; MPN 0402WGF1002TCE; LCSC C25744
R8: 1M; R_0402_1005Metric; MPN 0402WGF1004TCE; LCSC C26083

Connections:
3V3_EPD: C1.1, C2.1, C11.1, J1.15, J1.16, J3.1, L1.1, R6.1, R7.1
/EINK_BUSY: J1.9, J3.8
/EINK_CS: J1.12, J3.5, R7.2
/EINK_DC: J1.11, J3.6
/EINK_MOSI: J1.14, J3.4
/EINK_RST: J1.10, J3.7, R6.2
/EINK_SCK: J1.13, J3.3
/EPD_GDR: J1.2, Q5.1 (G), R8.1
/EPD_RESE: J1.3, Q5.2 (S), R4.1
/EPD_VCOM: C10.1, J1.24
/EPD_VDD: C6.1, J1.18
/EPD_VGH: C3.1, D3.1 (K), J1.21
/EPD_VGL: C4.1, D1.2 (A), J1.23
/EPD_VSH1: C7.1, J1.20
/EPD_VSH2: C8.1, J1.5
/EPD_VSL: C9.1, J1.22
EPD_SW: C5.1, D3.2 (A), L1.2, Q5.3 (D)
FL_A: J2.1, J2.2, JP1.2 (C)
FL_K: J2.5, J2.6, JP2.2 (C)
FL_N: J4.2, JP1.3 (B), JP2.1 (A)
FL_P: J4.1, JP1.1 (A), JP2.3 (B)
GND: C1.2, C2.2, C3.2, C4.2, C6.2, C7.2, C8.2, C9.2, C10.2, C11.2, D2.1 (K), J1.8, J1.17, J1.S1 (SHIELD), J1.S2 (SHIELD), J2.S1 (SHIELD), J2.S2 (SHIELD), J3.2, R4.2, R8.2; also elsewhere on the board
unnamed: C5.2, D1.1 (K), D2.2 (A)

Notes on the sheet:
Front light: 6-pin 0.5 mm flex, 1-2 anode, 3-4 NC, 5-6 cathode (GDEY029T94-FL03: 4 LEDs, Vf 2.8 V typ, 60 mA max; Orient AEZ122250A00: 3 LEDs, 45 mA at 3.3 V). Driven from the carrier (Q4 + 15R clamp, ~45 mA) over cable pins 9/10. Two ZIF positions, fit ONE: J3 FL-A for a tail leaving at the glass 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
TSCL/TSDA (6/7) open: internal temperature sensor. BS1 (8) low: 4-wire SPI. VPP (19) open, OTP only. VDD (18) is the internal 1.8 V LDO output, cap only.
Panel board for 24-pin 0.5 mm SSD1680/SSD1681 e-paper (Good Display GDEY029T94 2.9" 296x128, Orient AEZ122250A00 2.13" 122x250, ...). Reference circuit identical in both sheets: RESE 2.2R, L 47uH, MBR0530 x3, 25 V caps, BS1 low (4-wire SPI).
Layout: L1-Q5-R4-GND and L1-D3-C3-GND loops under 10 mm; RESE a short guarded trace; the 25 V caps in a row behind J1 pins 18-24; ground pour under the cluster.
FL polarity: JP1/JP2 bridged 1-2 (as shipped) = FL_P->FL_A, FL_N->FL_K (was R1/R2). Cut both bridges and solder 2-3 on both to swap (was R3/R5). No BOM lines, zero height.
Boost: 3V3_EPD -> L1 -> SW node; Q5 (gate GDR) switches SW to GND through R4 (RESE sense). D3 SW->VGH into C3. C5 flies SW->PUMP; D2 clamps PUMP to GND (anode PUMP); D1 pumps PUMP into VGL (anode VGL) with C4.
The brief's 10 uH / 3-4.7 R values were placeholders; the GDEY029T94 sheet specifies 47 uH 500 mA and 2.2 R. Verify against the sheet for the exact panel ordered.

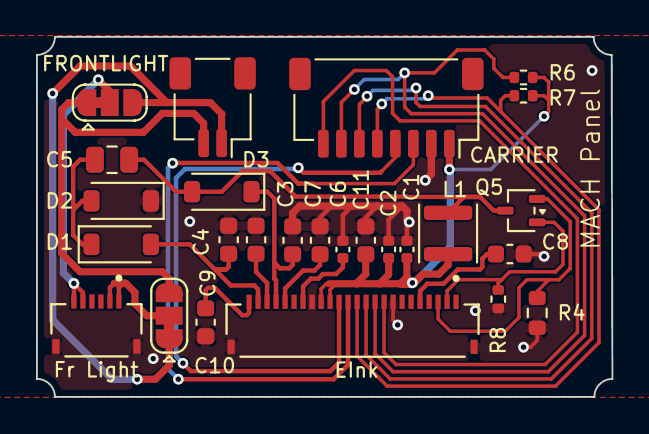
[picture p24: board pager-panel.kicad_pcb from above]

Board: 2 copper layers, 32.0 x 20.0 mm, 27 parts (1 on the bottom side), 23 nets.

Other parts of the board:
TP1: GND; TestPoint_Pad_D1.0mm

Their connections:
GND: TP1.1; also elsewhere on the board
