awong-dev/pager/firmware/main/main.c

#include <stdlib.h>
#include <string.h>
#include <time.h> /* setenv("TZ", ...)/tzset(), app_main()'s own Do #7 (TASK_ui_round2.md) */

#include "esp_console.h"
#include "esp_log.h"
#include "nvs_flash.h"
#include "nvs.h"
#include "esp_system.h"
#include "esp_sleep.h"
#include "esp_timer.h" // esp_timer_get_time(), cmd_railcycle()'s elapsed-ms measurement
#include "esp_rom_sys.h" // esp_rom_delay_us(), `rts fc`'s CTS sampling loop (debug build only)
#include "freertos/FreeRTOS.h"
#include "freertos/task.h"

#include "driver/gpio.h"
#include "driver/rtc_io.h"
#include "soc/gpio_reg.h"
#include "soc/io_mux_reg.h"
#include "soc/rtc_cntl_reg.h"
#include "soc/rtc_io_reg.h"
#include "driver/i2c.h"

#include <stdio.h>

#include "accel.h"
#include "battstat.h"
#include "board.h"
#include "buzzer.h"
#include "extled.h"
#include "frontlight.h"
#include "haptic.h"
#include "tunes.h"
#include "cafetch.h"
#include "catrust.h"
#include "mbedtls/sha256.h"
#include "ota.h"
#include "flightrec.h" // docs/SLEEP_PAGE_LOSS_BRIEF.md §6 item A; no-op stubs outside a debug build
#include "ident.h"
#include "watchdog.h"
#include "carrier.h"
#include "disp.h"
#include "gfx.h"
#include "input.h"
#include "loc.h"
#include "lock.h" // round 4: `attn` debug console command reads lock_is_set()/lock_is_locked()
#include "modes.h"
#include "refreshpol.h"
#include "net.h"
#include "pins.h"
#include "rail.h"
#include "setup.h"
#include "sms.h"
#include "ui.h"
#include "fuel.h"

static const char *TAG = "school_pager";

/* docs/DEVICE_TASKS.md F3.5: `setup <code>` over the USB serial console.
 * argtable3-free by design — the setup code itself contains a space
 * (" @ "), so this just re-joins every argv past argv[0] with single spaces,
 * which recovers the original string whether or not the caller quoted it
 * (docs/DEVICE_PLAN.md §3.1's `format_code()` never emits runs of more than
 * one space). */
#define SETUP_CMD_LINE_MAX 128

static int cmd_setup(int argc, char **argv)
{
    if (argc < 2) {
        printf("usage: setup <code>\n");
        return 1;
    }

    char code[SETUP_CMD_LINE_MAX];
    size_t len = 0;
    for (int i = 1; i < argc; i++) {
        if (i > 1) {
            if (len + 1 >= sizeof(code)) {
                printf("setup code too long\n");
                return 1;
            }
            code[len++] = ' ';
        }
        size_t alen = strlen(argv[i]);
        if (len + alen >= sizeof(code)) {
            printf("setup code too long\n");
            return 1;
        }
        memcpy(code + len, argv[i], alen);
        len += alen;
    }
    code[len] = '\0';

    // setup_run() esp_restart()s on success and never returns here; a false
    // return means it already logged/toasted one of the four
    // DEVICE_PLAN.md §3.2 error strings and the person may retry.
    if (!setup_run(code)) {
        printf("setup failed; see the SETUP log line above, retry with a fresh code if needed\n");
        return 1;
    }
    return 0; // unreachable: setup_run() only returns by not returning (esp_restart())
}

#ifdef PAGER_DEBUG_NO_LIGHT_SLEEP
// TEMPORARY diagnostic command: `nettest <host> <port>` dials a plain TCP
// socket (no TLS) via net_check_tcp() -- see that function's own doc
// comment in net.h for why. Remove once the broker-connect issue is
// root-caused. Debug build only (PAGER_DEBUG_NO_LIGHT_SLEEP): docs/
// ROADMAP.md's "temporary diagnostics" no longer ship in the release
// binary.
static int cmd_nettest(int argc, char **argv)
{
    esp_log_level_set("WalterModem", ESP_LOG_DEBUG); // raw AT TX:/RX: trace
    if (argc < 3 || argc > 4) {
        printf("usage: nettest <host> <port> [udp|tls|<bytes>]\n");
        return 1;
    }
    long port = strtol(argv[2], NULL, 10);
    if (port <= 0 || port > 65535) {
        printf("bad port\n");
        return 1;
    }
    bool udp = (argc == 4) && (strcmp(argv[3], "udp") == 0);
    bool tls = (argc == 4) && (strcmp(argv[3], "tls") == 0);
    long pad = (argc == 4 && !udp && !tls) ? strtol(argv[3], NULL, 10) : 0;
    bool ok = (pad > 0) ? net_check_tcp_sized(argv[1], (uint16_t) port, (size_t) pad)
                        : net_check_tcp(argv[1], (uint16_t) port, udp, tls);
    printf("nettest: %s\n", ok ? "CONNECTED" : "FAILED (see log above)");
    return ok ? 0 : 1;
}

// TEMPORARY diagnostic command: `mqtttest <host> <port>` issues a real
// AT+SQNSMQTTCONNECT (TLS, VALIDATION_NONE, dummy credentials) via
// net_check_mqtt() -- see net.h. Remove together with nettest. Debug build
// only (PAGER_DEBUG_NO_LIGHT_SLEEP), same as nettest above.
static int cmd_mqtttest(int argc, char **argv)
{
    esp_log_level_set("WalterModem", ESP_LOG_DEBUG); // raw AT TX:/RX: trace
    if (argc < 3 || argc > 4) {
        printf("usage: mqtttest <host> <port> [ca|noneca|emptyca|plain]\n");
        return 1;
    }
    long port = strtol(argv[2], NULL, 10);
    if (port <= 0 || port > 65535) {
        printf("bad port\n");
        return 1;
    }
    int tls_mode = 0;
    if (argc == 4 && strcmp(argv[3], "ca") == 0) tls_mode = 1;
    if (argc == 4 && strcmp(argv[3], "noneca") == 0) tls_mode = 2;
    if (argc == 4 && strcmp(argv[3], "emptyca") == 0) tls_mode = 3;
    if (argc == 4 && strcmp(argv[3], "plain") == 0) tls_mode = 4;
    bool ok = net_check_mqtt(argv[1], (uint16_t) port, tls_mode);
    printf("mqtttest: %s\n", ok ? "CONNECTED" : "NOT CONNECTED (see log above)");
    // RCA_SLEEP_PUBLISH.md §3 instrumentation: a natural place to glance at
    // the vendored library's four "orphaned prompt" counters (PATCHES.md
    // 1.12) alongside a manual MQTT probe.
    net_pager_counters_t pc = net_get_pager_counters();
    printf("modem counters: datatx_retx=%u prompt_orphan=%u buf_drop_queue=%u buf_drop_pool=%u\n",
           (unsigned) pc.datatx_retx, (unsigned) pc.prompt_orphan, (unsigned) pc.buf_drop_queue,
           (unsigned) pc.buf_drop_pool);
    return ok ? 0 : 1;
}

// Debug build only: raw AT passthrough.
// Debug build only: `sleeptest <minutes> [yield_ms] [interval_ms]` opens a
// window of real light sleep (modes.c); `sleeptest` alone prints the report
// again. yield_ms overrides the post-wake yield (default
// PAGER_POST_WAKE_YIELD_MS, 200); interval_ms overrides the wake interval
// (default: 2000/5000 by mode) -- task 3's "how long must the pager stay
// awake after a wake to receive a held URC" question. Either override may be
// given as 0, which means "use the build default" (the same thing omitting it
// does), so the documented `sleeptest 6 0 0` form works.
static int cmd_sleeptest(int argc, char **argv)
{
    if (argc == 1) {
        modes_debug_sleeptest_report();
        // docs/SLEEP_PAGE_LOSS_BRIEF.md §6 item A: let the bench operator
        // know a byte-level dump is available without having to guess.
        uint32_t n = flightrec_count();
        if (n > 0) {
            printf("flightrec: %u records held, run `flightrec` to dump\n", (unsigned) n);
        }
        return 0;
    }
    long m = strtol(argv[1], NULL, 10);
    if (m < 1 || m > 120) {
        printf("usage: sleeptest [<minutes 1..120> [yield_ms 0|30..10000] "
               "[interval_ms 0|200..60000] [probe_wait_ms 0|100..15000] "
               "[wake0_ms 0|0..2000]]   (0 = build default)\n");
        return 1;
    }
    long yield_ms = 0;    // 0 = use PAGER_POST_WAKE_YIELD_MS
    long interval_ms = 0; // 0 = use the normal active/sleep interval
    // 0 means "keep the build default" for both overrides, exactly as
    // modes_debug_sleeptest_start() already treats them (modes.c's
    // s_st_yield_ms/s_st_interval_ms are only applied when non-zero) and as
    // docs/RCA_SLEEP_PUBLISH.md §3's own console sequence assumes. Before
    // this, `sleeptest 6 0 0` was rejected by the range checks below and the
    // documented command line did not run at all.
    if (argc >= 3) {
        yield_ms = strtol(argv[2], NULL, 10);
        if (yield_ms != 0 && (yield_ms < 30 || yield_ms > 10000)) {
            printf("usage: sleeptest <minutes> [yield_ms 0|30..10000] [interval_ms 0|200..60000]\n");
            return 1;
        }
    }
    if (argc >= 4) {
        interval_ms = strtol(argv[3], NULL, 10);
        if (interval_ms != 0 && (interval_ms < 200 || interval_ms > 60000)) {
            printf("usage: sleeptest <minutes> [yield_ms 0|30..10000] [interval_ms 0|200..60000]\n");
            return 1;
        }
    }
    // S18 (docs/SLEEP_URC_DESIGN.md §10): the bound on how long each wake
    // holds RTS asserted waiting for the URC drain probe's answer. Only has
    // an effect together with a long interval_ms (modes.c's
    // PAGER_PROBE_WAIT_MIN_INTERVAL_MS), so the experiment is
    // `sleeptest 6 0 20000 4000`.
    long probe_wait_ms = 0; // 0 = use PAGER_PROBE_WAIT_MS
    if (argc >= 5) {
        probe_wait_ms = strtol(argv[4], NULL, 10);
        if (probe_wait_ms != 0 && (probe_wait_ms < 100 || probe_wait_ms > 15000)) {
            printf("usage: sleeptest <minutes> [yield_ms 0|30..10000] [interval_ms 0|200..60000] "
                   "[probe_wait_ms 0|100..15000] [wake0_ms 0..2000]\n");
            return 1;
        }
    }
    // docs/SLEEP_PAGE_LOSS_BRIEF.md §6 item F: 0 (default) leaves IO46
    // untouched, today's behaviour.
    long wake0_ms = 0;
    if (argc >= 6) {
        wake0_ms = strtol(argv[5], NULL, 10);
        if (wake0_ms < 0 || wake0_ms > 2000) {
            printf("usage: sleeptest <minutes> [yield_ms 0|30..10000] [interval_ms 0|200..60000] "
                   "[probe_wait_ms 0|100..15000] [wake0_ms 0..2000]\n");
            return 1;
        }
    }
    modes_debug_sleeptest_start((uint32_t) m, (uint32_t) yield_ms, (uint32_t) interval_ms,
                                (uint32_t) probe_wait_ms, (uint32_t) wake0_ms);
    return 0;
}

static int cmd_at(int argc, char **argv)
{
    if (argc < 2) {
        printf("usage: at <command>   e.g. at AT+CIMI  (quote arguments containing commas or spaces)\n");
        return 1;
    }
    char line[160];
    size_t n = 0;
    if (argv[1][0] == '+') { // `at +CIMI` and `at AT+CIMI` both work
        n += (size_t) snprintf(line, sizeof(line), "AT");
    }
    for (int i = 1; i < argc && n + 1 < sizeof(line); i++) {
        n += (size_t) snprintf(line + n, sizeof(line) - n, "%s%s", (i > 1) ? " " : "", argv[i]);
    }
    esp_log_level_set("WalterModem", ESP_LOG_DEBUG);
    bool ok = net_debug_at(line);
    printf("at: %s\n", ok ? "OK" : "ERROR/timeout");
    return ok ? 0 : 1;
}

// docs/SLEEP_PAGE_LOSS_BRIEF.md §6 item A: `flightrec` dumps the flight
// recorder ring (flightrec.h); `flightrec clear` resets it (same effect a
// fresh `sleeptest` start has) without dumping. Debug build only.
static int cmd_flightrec(int argc, char **argv)
{
    if (argc == 2 && strcmp(argv[1], "clear") == 0) {
        flightrec_clear();
        printf("flightrec: cleared\n");
        return 0;
    }
    if (argc != 1) {
        printf("usage: flightrec [clear]\n");
        return 1;
    }
    flightrec_dump();
    return 0;
}

// docs/SLEEP_PAGE_LOSS_BRIEF.md §6 items B/D: `rts <0|1|fc>` -- an awake,
// on-demand version of net_sleep()'s own RTS choreography, for the
// interface-wake-latency experiment. `rts 0`/`rts 1`: flow control off,
// RTS driven to that level as a plain GPIO (net_debug_rts(), net.cpp).
// `rts fc`: hardware CTS/RTS flow control restored, then CTS sampled every
// 1 ms for 300 ms (esp_rom_delay_us()), printing the initial level and
// every transition with its ms offset -- flightrec_cts_level() is a plain
// gpio_get_level() read, meaningful with or without a recording open.
static int cmd_rts(int argc, char **argv)
{
    if (argc != 2) {
        printf("usage: rts <0|1|fc>\n");
        return 1;
    }
    if (strcmp(argv[1], "0") == 0) {
        net_debug_rts(0);
        printf("rts: flow control off, RTS=0\n");
        return 0;
    }
    if (strcmp(argv[1], "1") == 0) {
        net_debug_rts(1);
        printf("rts: flow control off, RTS=1\n");
        return 0;
    }
    if (strcmp(argv[1], "fc") == 0) {
        net_debug_rts(2);
        int last = flightrec_cts_level();
        printf("rts: flow control restored; cts@0ms=%d\n", last);
        for (int ms = 1; ms <= 300; ms++) {
            esp_rom_delay_us(1000);
            int lvl = flightrec_cts_level();
            if (lvl != last) {
                printf("rts: cts@%dms=%d\n", ms, lvl);
                last = lvl;
            }
        }
        return 0;
    }
    printf("usage: rts <0|1|fc>\n");
    return 1;
}

// docs/SLEEP_PAGE_LOSS_BRIEF.md §6 item F: `wake0 <0|1|z>` -- IO46
// (LTE_WAKE0, pins.h's PAGER_PIN_WAKE0) driven low/high, or set back to a
// floating input. Independent of `sleeptest`'s own wake0_ms pulse
// (modes.c) -- this is the awake, on-demand version of the same
// experiment.
static int cmd_wake0(int argc, char **argv)
{
    if (argc != 2) {
        printf("usage: wake0 <0|1|z>\n");
        return 1;
    }
    if (strcmp(argv[1], "z") == 0) {
        gpio_config_t cfg = {
            .pin_bit_mask = 1ULL << PAGER_PIN_WAKE0,
            .mode = GPIO_MODE_INPUT,
            .pull_up_en = GPIO_PULLUP_DISABLE,
            .pull_down_en = GPIO_PULLDOWN_DISABLE,
            .intr_type = GPIO_INTR_DISABLE,
        };
        gpio_config(&cfg);
        printf("wake0: input, no pull\n");
        return 0;
    }
    if (strcmp(argv[1], "0") == 0 || strcmp(argv[1], "1") == 0) {
        gpio_set_direction((gpio_num_t) PAGER_PIN_WAKE0, GPIO_MODE_OUTPUT);
        gpio_set_level((gpio_num_t) PAGER_PIN_WAKE0, argv[1][0] - '0');
        printf("wake0: output %c\n", argv[1][0]);
        return 0;
    }
    printf("usage: wake0 <0|1|z>\n");
    return 1;
}

// `cts` -- print the current CTS level (IO47). Debug build only.
static int cmd_cts(int argc, char **argv)
{
    (void) argc;
    (void) argv;
    printf("cts: %d\n", flightrec_cts_level());
    return 0;
}

// Round 4 (bug report 25 Sep ~3am PDT, the attentive-edge fix): `attn` --
// bench visibility into modes.c's attentive window without waiting for the
// coarse, edge-only "wake cadence:" log line. `attentive` and `in_use` are
// printed as two separate fields per the task brief, but both read
// modes_in_use() -- modes.c's attentive_now() is the single source of truth
// both modes_run()'s attentive_service() and modes_in_use() call (round 4:
// no longer two hand-kept-in-sync copies), so they are the same value by
// construction; printed twice anyway so a bench log line matches what was
// asked for without the reader having to know that. Debug build only.
static int cmd_attn(int argc, char **argv)
{
    (void) argc;
    (void) argv;
    int64_t age_us = modes_debug_last_input_age_us();
    bool in_use = modes_in_use();
    printf("attn: last_input_age=%lld.%03llds attentive=%d in_use=%d locked=%d (lock_set=%d)\n",
           (long long) (age_us / 1000000), (long long) ((age_us / 1000) % 1000), (int) in_use,
           (int) in_use, (int) lock_is_locked(), (int) lock_is_set());
    return 0;
}

// Bench diagnostic (round 6, defect 1 triage, architect hypothesis 8a):
// `railcycle` -- drive the display/CardKB gated rails off exactly the
// way sleep entry does (modes.c's `if (attentive) rail_on(); else
// rail_off();` branch, this same file's rail.h include; the LIS3DH is on
// the power board's always-on "3V" rail and is untouched by this), hold it off 2s
// (long enough for the SSD1680 to actually lose its RAM/registers if it is
// going to, well past a "still back-powered through RST/DC/CS" near-miss),
// then bring it back up exactly the way the EXT0 (button) wake path does
// (ui_ensure_powered(), modes.c's rule (b)) and call ui_render() (which
// itself calls ui_ensure_powered() first, a no-op here since already on).
// Times only the rail_on()+ui_render() leg, i.e. the part a real button
// wake would pay after 2+ minutes asleep, and prints it alongside whatever
// the AT-trace-adjacent disp.c BUSY log already showed inline above it, so
// a bench read does not have to correlate two separate log lines by hand.
// Debug build only, same gating as `attn` above.
static int cmd_railcycle(int argc, char **argv)
{
    // Round 7 realism pass: `railcycle [seconds]` — seconds defaults to 2,
    // matching the original bench probe; pass a larger value (e.g. 150, ~2.5
    // min) to reproduce the "asleep 2+ minutes" scenario defect 1 actually
    // reported, rather than the acute 2s near-miss the first round tested.
    // The off-duration itself makes no electrical difference to rail_off()
    // (rail.c drives both gates to their off level once and is done;
    // nothing times out or degrades while they sit there) — it only changes
    // how long the
    // SSD1680 has been unpowered, which is the variable defect 1's own "2+
    // min" claim is actually about.
    //
    // What this command does and does not reproduce, checked against the
    // real sleep-entry/EXT0-wake path (modes.c modes_run(), rail.c, disp.c):
    // rail_off() itself is exactly the sleep-entry call (same function, same
    // ui_kb_bus_release() side effect on the I2C pins); rail_on() via
    // ui_ensure_powered() is exactly the EXT0-wake call (same function,
    // same ui_kb_bus_restore() side effect, same disp_note_power_loss()).
    // The display's RST/DC/CS pins are untouched by either rail_off() or
    // rail_on() in the real firmware — disp_gpio_init()'s own comment notes
    // they are deliberately excluded from ESP-IDF's sleep GPIO isolation
    // (gpio_sleep_sel_dis()) so they hold whatever level they were last
    // driven to (RST idle-high post-reset, DC whatever the last SPI byte
    // needed, CS SPI-peripheral-muxed) straight through a light sleep with
    // no code of this module's own re-driving them — so a bench call with no
    // real light sleep in between (this build never light-sleeps) leaves
    // those three pins in exactly the same state a real sleep/wake cycle
    // would: whatever disp_pre_refresh_reset()/disp_hw_reset() last set,
    // unchanged. Nothing here calls gpio_hold_en()/gpio_hold_dis() because
    // nothing in rail.c/disp.c does either — the mechanism this firmware
    // actually relies on is gpio_sleep_sel_dis() (opt out of isolation), not
    // an RTC GPIO hold latch. What this command does NOT reproduce: the
    // actual esp_light_sleep_start() call itself (irrelevant to the four
    // display/rail pins specifically, since they are excluded from
    // isolation either way) and the surrounding modes_run() loop context
    // (attentive-window bookkeeping, wake_is_input's now-shortened yield,
    // the input-event drain that would normally trigger the render) — this
    // command calls ui_render() directly instead, which is a reasonable
    // proxy for whatever render eventually happens post-wake, not a replay
    // of the whole loop iteration.
    long secs = 2;
    if (argc >= 2) {
        secs = strtol(argv[1], NULL, 10);
        if (secs < 0) {
            printf("usage: railcycle [seconds]\n");
            return 1;
        }
    }
    printf("railcycle: rail_off() for %lds\n", secs);
    rail_off();
    vTaskDelay(pdMS_TO_TICKS((uint32_t) secs * 1000));
    printf("railcycle: rail_on() + ui_render()\n");
    int64_t t0 = esp_timer_get_time();
    ui_ensure_powered(); // same call the EXT0 wake path makes (modes.c)
    ui_render();
    int64_t elapsed_ms = (esp_timer_get_time() - t0) / 1000;
    printf("railcycle: elapsed=%lld ms (rail_on + ui_render) busy_timeout_count=%u\n",
           (long long) elapsed_ms, (unsigned) disp_busy_timeout_count());
    return 0;
}

// Round 7, authorized: `btn` / `btn long` -- push a simulated button press
// through input.c's own queue (input_feed_button_short()/_long(), input.h),
// the same INPUT_EVT_BTN_DOWN+SHORT/LONG pair a real IO8 press resolves to
// and the same modes_run() drain path consumes (set_mode(ACTIVE, ...) on
// BTN_DOWN, ui_on_button_short()/ui_on_button_long() on the resolving
// event) -- there is no console equivalent of the physical debounce/hold
// timing, only of its outcome. Needed because scr_lock.c's unlock entry is
// deliberately reachable ONLY from a button short press ("Keys typed in
// state (a) are ignored ... unlocking starts ONLY from an IO8 short press",
// scr_lock.c's own comment) -- `key` alone cannot open the passcode field.
// Debug build only, same gating as `attn`/`railcycle`.
// Bench-only: `gpio <n> [sample <ms>]` -- read a pad level without touching
// its configuration. `sample` polls every 10 ms and reports high/low counts
// and transitions, so a floating pad shows as mixed and a stuck pad as
// all-one-level (added 5 Oct 2026 while chasing IO8 reading high).
// 5 Oct 2026 bench instrument (debug build): the button pad IO8 read 1 via
// gpio_get_level() while a meter had 0 V on header pin 23. Dump everything
// that decides what the digital read sees: IO MUX (function/pulls/input
// enable/sleep-select), RTC IO (rtc mux select, pulls, input enable), the
// RTC pad hold bit, the raw GPIO_IN bit, and both level readers.
static int cmd_padinfo(int argc, char **argv)
{
    (void) argc;
    (void) argv;
    uint32_t rtc = REG_READ(RTC_IO_TOUCH_PAD8_REG);
    uint32_t hold = REG_READ(RTC_CNTL_PAD_HOLD_REG);
    uint32_t mux = REG_READ(IO_MUX_GPIO8_REG);
    uint32_t in = REG_READ(GPIO_IN_REG);
    printf("padinfo IO8: gpio_get_level=%d rtc_gpio_get_level=%u GPIO_IN.bit8=%u\n",
           gpio_get_level((gpio_num_t) 8), (unsigned) rtc_gpio_get_level((gpio_num_t) 8),
           (unsigned) ((in >> 8) & 1u));
    printf("  RTC_IO_TOUCH_PAD8=0x%08x rtc_mux_sel=%u rtc_fun_ie=%u rue=%u rde=%u rtc_fun_sel=%u\n",
           (unsigned) rtc, (unsigned) !!(rtc & RTC_IO_TOUCH_PAD8_MUX_SEL),
           (unsigned) !!(rtc & RTC_IO_TOUCH_PAD8_FUN_IE), (unsigned) !!(rtc & RTC_IO_TOUCH_PAD8_RUE),
           (unsigned) !!(rtc & RTC_IO_TOUCH_PAD8_RDE),
           (unsigned) ((rtc >> RTC_IO_TOUCH_PAD8_FUN_SEL_S) & 3u));
    printf("  RTC_CNTL_PAD_HOLD=0x%08x pad8_hold=%u\n", (unsigned) hold,
           (unsigned) !!(hold & RTC_CNTL_TOUCH_PAD8_HOLD));
    printf("  IO_MUX_GPIO8=0x%08x mcu_sel=%u fun_ie=%u fun_pu=%u fun_pd=%u slp_sel=%u\n",
           (unsigned) mux, (unsigned) ((mux >> MCU_SEL_S) & 7u), (unsigned) !!(mux & FUN_IE),
           (unsigned) !!(mux & FUN_PU), (unsigned) !!(mux & FUN_PD), (unsigned) !!(mux & SLP_SEL));
    gpio_dump_io_configuration(stdout, 1ULL << 8);
    return 0;
}

// Companion: force IO8 back to a plain digital input with pull-down (hold off,
// digital mux, gpio_config as input_init() does) and dump again.
static int cmd_padfix(int argc, char **argv)
{
    rtc_gpio_hold_dis((gpio_num_t) 8);
    rtc_gpio_deinit((gpio_num_t) 8);
    gpio_config_t cfg = {
        .pin_bit_mask = 1ULL << 8,
        .mode = GPIO_MODE_INPUT,
        .pull_up_en = GPIO_PULLUP_DISABLE,
        .pull_down_en = GPIO_PULLDOWN_ENABLE,
        .intr_type = GPIO_INTR_DISABLE,
    };
    gpio_config(&cfg);
    printf("padfix: hold_dis + rtc_gpio_deinit + gpio_config(input, pull-down) applied to IO8\n");
    return cmd_padinfo(argc, argv);
}

// Refresh policy tuning (refreshpol.h): `refresh [floor N|ceil N|idle S|gap MS|psmin N|status]`.
// Knobs persist to NVS "disp" so they carry into the release build. Power effect: none.
static int cmd_refresh(int argc, char **argv)
{
    refreshpol_t *p = refreshpol_global();
    if (argc >= 3) {
        int v = atoi(argv[2]);
        if (v < 0) {
            printf("refresh: value must be >= 0\n");
            return 1;
        }
        if (strcmp(argv[1], "floor") == 0) p->floor = (uint32_t) v;
        else if (strcmp(argv[1], "ceil") == 0) p->ceiling = (uint32_t) v;
        else if (strcmp(argv[1], "idle") == 0) p->idle_s = (uint32_t) v;
        else if (strcmp(argv[1], "gap") == 0) p->gap_ms = (uint32_t) v;
        else if (strcmp(argv[1], "psmin") == 0) p->presleep_min = (uint32_t) v;
        else {
            printf("usage: refresh [floor N|ceil N|idle S|gap MS|psmin N|status]\n");
            return 1;
        }
        refreshpol_save_nvs();
    } else if (argc == 2 && strcmp(argv[1], "status") != 0) {
        printf("usage: refresh [floor N|ceil N|idle S|gap MS|psmin N|status]\n");
        return 1;
    }
    printf("refresh: dirty=%u floor=%u ceil=%u idle=%us gap=%ums psmin=%u\n", (unsigned) p->dirty,
           (unsigned) p->floor, (unsigned) p->ceiling, (unsigned) p->idle_s, (unsigned) p->gap_ms,
           (unsigned) p->presleep_min);
    return 0;
}

static int cmd_gpio(int argc, char **argv)
{
    if (argc < 2) {
        printf("usage: gpio <0-48> [sample <ms<=5000>]\n");
        return 1;
    }
    int n = atoi(argv[1]);
    if (n < 0 || n > 48) {
        printf("gpio: pin out of range\n");
        return 1;
    }
    printf("gpio %d: level=%d\n", n, gpio_get_level((gpio_num_t) n));
    if (argc >= 4 && strcmp(argv[2], "sample") == 0) {
        int ms = atoi(argv[3]);
        if (ms < 10) ms = 10;
        if (ms > 5000) ms = 5000;
        int hi = 0, lo = 0, trans = 0, last = -1;
        for (int t = 0; t < ms; t += 10) {
            int l = gpio_get_level((gpio_num_t) n);
            if (l) hi++; else lo++;
            if (last >= 0 && l != last) trans++;
            last = l;
            vTaskDelay(pdMS_TO_TICKS(10));
        }
        printf("gpio %d: %d ms sampled: high=%d low=%d transitions=%d\n", n, ms, hi, lo, trans);
    }
    return 0;
}

static int cmd_btn(int argc, char **argv)
{
    bool is_long = (argc >= 2) && (strcmp(argv[1], "long") == 0);
    if (is_long) {
        input_feed_button_long();
        printf("btn: long press simulated (BTN_DOWN, BTN_LONG)\n");
    } else {
        input_feed_button_short();
        printf("btn: short press simulated (BTN_DOWN, BTN_SHORT)\n");
    }
    return 0;
}

// Round 9 resume, bench-only: `lockclear`/`lockset` -- temporarily drop and
// restore the passcode so a real-sleep display test can use an incoming
// test page as the render trigger. ui_incoming()'s steal branch (ui.c) only
// fires for Home/Chat/greeting/was-asleep, and modes_alert_incoming()
// deliberately skips render_pending_set() entirely while locked (F6.5:
// "no `shown` published for a body received while locked") -- so a locked
// device never renders on an incoming page at all, by design, and cannot
// exercise disp.c's power-loss recovery path that way. Bench-only, not
// meant to leave the passcode off; restore with `lockset asdf` (never
// printed/logged) right after the test.
static int cmd_lockclear(int argc, char **argv)
{
    (void) argc;
    (void) argv;
    lock_clear_passcode();
    printf("lockclear: passcode cleared, device unlocked\n");
    return 0;
}

static int cmd_lockset(int argc, char **argv)
{
    if (argc != 2) {
        printf("usage: lockset <passcode>\n");
        return 1;
    }
    bool ok = lock_set_passcode(argv[1], strlen(argv[1]));
    printf("lockset: %s\n", ok ? "passcode set" : "failed (4-16 printable chars required)");
    return ok ? 0 : 1;
}

// Round 9 (the "6s from tap to password: on a real sleep wake" defect):
// `railsettle [ms]` -- read or set rail.c's universal post-rail-on settle
// (rail_debug_set_settle_ms()), for the bench sweep (15/20/30/50ms) on one
// flash instead of five separate builds.
static int cmd_railsettle(int argc, char **argv)
{
    if (argc < 2) {
        printf("railsettle: current = %u ms\n", (unsigned) rail_debug_get_settle_ms());
        return 0;
    }
    long ms = strtol(argv[1], NULL, 10);
    if (ms < 0) {
        printf("usage: railsettle <ms>\n");
        return 1;
    }
    rail_debug_set_settle_ms((uint32_t) ms);
    printf("railsettle: set to %ld ms\n", ms);
    return 0;
}

// `dispbusytrace` -- arm the one-shot ~200ms BUSY transition trace
// (disp_debug_arm_busy_trace(), disp.h) for the next power-loss recovery.
static int cmd_dispbusytrace(int argc, char **argv)
{
    (void) argc;
    (void) argv;
    disp_debug_arm_busy_trace();
    printf("dispbusytrace: armed for the next power-loss recovery\n");
    return 0;
}

// `kbtime [cycles]` -- owner's round 9 fallback ("measure it if the fuse
// setting can't be determined"): rail_off(), settle 2s fully off, then
// rail_on() with rail.c's own settle FORCED TO ZERO (so this measures the
// raw, undelayed time) and a tight I2C probe of the CardKB address
// (PAGER_I2C_ADDR_CARDKB, pins.h) every ~1ms up to 300ms, recording when it
// first ACKs. Repeats `cycles` times (default 5) and restores whatever
// rail.c settle was configured before this command ran. Bench aid: tells a
// genuinely slow CardKB boot from a wiring/address fault the same way
// i2cscan does, just timed against the rail edge instead of a one-shot scan.
static int cmd_kbtime(int argc, char **argv)
{
    int cycles = 10; // owner, round 9 resume: "about 10 cycles"
    if (argc >= 2) {
        cycles = (int) strtol(argv[1], NULL, 10);
        if (cycles < 1) {
            cycles = 1;
        }
    }
    int64_t sum_ms = 0;
    long long min_ms = -1, max_ms = -1;
    int got = 0;
    // Round 9 resume: ui_debug_pause_kb_poll(true) stops modes_run()'s own
    // concurrent kbd-task CardKB read from touching I2C_NUM_0 for the
    // duration -- the actual fix for the contention the first attempt at
    // this measurement hit ("CardKB: I2C read failed post-restore" on
    // every cycle, both sides reinitializing the driver at once). Settle
    // forced to 0 so t0 is the raw rail_on() call, not rail_on()-plus-
    // whatever settle padding is configured -- this measures the CardKB's
    // own boot time in isolation, which is what sets the guard's floor.
    uint32_t saved_settle = rail_debug_get_settle_ms();
    rail_debug_set_settle_ms(0);
    ui_debug_pause_kb_poll(true);
    for (int i = 0; i < cycles; i++) {
        rail_off();
        vTaskDelay(pdMS_TO_TICKS(2000));
        int64_t t0 = esp_timer_get_time();
        rail_on();
        int64_t ack_us = -1;
        bool reinit_done = false;
        while (esp_timer_get_time() - t0 < 8000000) { // 8s: wide enough to find the real ceiling
            i2c_cmd_handle_t cmd = i2c_cmd_link_create();
            i2c_master_start(cmd);
            i2c_master_write_byte(cmd, (uint8_t) ((PAGER_I2C_ADDR_CARDKB << 1) | I2C_MASTER_WRITE),
                                   true);
            i2c_master_stop(cmd);
            esp_err_t err = i2c_master_cmd_begin(I2C_NUM_0, cmd, pdMS_TO_TICKS(2));
            i2c_cmd_link_delete(cmd);
            if (err == ESP_OK) {
                ack_us = esp_timer_get_time() - t0;
                break;
            }
            // Round 9 resume finding: the bus does not reliably answer on
            // the very first i2c_kb_init() after rail_on() -- every attempt
            // NACKs (ESP_FAIL) for the whole window without this, yet
            // the kbd task's own production recovery (ui.c: delete +
            // re-init the driver after a few failed reads, "the bus could
            // have been left mid-transaction when the rail dropped") is
            // exactly what makes real keystrokes work after a real wake
            // (round 8 log: "I2C read failed post-restore... re-initializing
            // the driver" followed by "answering again"). Mirrors that same
            // one-shot recovery here, at the same ~50ms trigger point, so
            // this measures the real end-to-end time a keystroke would
            // need -- not an idealized number a production wake never gets.
            if (!reinit_done && esp_timer_get_time() - t0 >= 50000) {
                reinit_done = true;
                ui_kb_i2c_reinit(); // exactly the kbd task's own one-shot recovery
            }
            vTaskDelay(pdMS_TO_TICKS(1)); // owner: "probe... every 1ms"
        }
        if (ack_us < 0) {
            printf("kbtime: cycle %d: CardKB never acked within 8000ms (reinit_done=%d)\n", i + 1,
                   (int) reinit_done);
        } else {
            if (reinit_done) {
                printf("kbtime: cycle %d: needed the bus re-init\n", i + 1);
            }
            long long ack_ms = ack_us / 1000;
            printf("kbtime: cycle %d: CardKB first ACK at +%lld ms\n", i + 1, ack_ms);
            sum_ms += ack_ms;
            got++;
            if (min_ms < 0 || ack_ms < min_ms) {
                min_ms = ack_ms;
            }
            if (ack_ms > max_ms) {
                max_ms = ack_ms;
            }
        }
        vTaskDelay(pdMS_TO_TICKS(500)); // let this cycle settle before the next rail_off()
    }
    ui_debug_pause_kb_poll(false);
    rail_debug_set_settle_ms(saved_settle);
    if (got > 0) {
        printf("kbtime: min=%lld ms max=%lld ms avg=%lld ms over %d/%d cycle(s) acked\n", min_ms,
               max_ms, (long long) (sum_ms / got), got, cycles);
    }
    return 0;
}

#endif

// `carrier` -- the pager-side APN choice (carrier.h). Available in Setup mode
// (it must be, the APN is needed before anything can be fetched) and in the
// debug build's normal-mode console.
//   carrier              list the presets, mark the current one
//   carrier <n>          choose preset n
//   carrier custom <apn> any other APN
static int cmd_carrier(int argc, char **argv)
{
    if (argc == 1) {
        // SIM identity as the firmware reads it, then the preset it resolves to.
        char imsi[20], gid1[40], iccid[24];
        bool have = net_sim_identity(imsi, sizeof(imsi), gid1, sizeof(gid1), iccid, sizeof(iccid));
        printf("sim: imsi=%s gid1=%s iccid=%s\n", have && imsi[0] ? imsi : "-", gid1[0] ? gid1 : "-",
               iccid[0] ? iccid : "-");
        const carrier_preset_t *inforce = carrier_effective(imsi, gid1, iccid, NULL);
        carrier_bearer_ovr_t ovr = carrier_bearer_override_get();
        printf("bearer: %s -> %s\n", carrier_bearer_ovr_name(ovr),
               carrier_bearer_resolve(inforce, ovr) == CARRIER_BEARER_BEAM ? "beam" : "direct");
        printf("pdp auth: %s\n", carrier_auth_name(inforce ? inforce->auth_proto : CARRIER_AUTH_NONE));
        bool is_auto = carrier_get_mode() == CARRIER_MODE_AUTO;
        int cur = is_auto ? CARRIER_PRESET_AUTO
                          : (carrier_get_apn()[0] == '\0' ? CARRIER_PRESET_BLANK
                                                          : carrier_preset_index_for(carrier_get_apn()));
        for (size_t i = 0; i < carrier_preset_count(); i++) {
            const carrier_preset_t *p = carrier_preset_at(i);
            printf(" %c %u  %-22s %s\n", ((int) i == cur) ? '*' : ' ', (unsigned) i, p->label,
                   i == CARRIER_PRESET_AUTO ? "(detect from the SIM)" : (p->apn[0] ? p->apn : "(blank)"));
        }
        if (cur < 0) {
            printf(" *    custom                 %s\n", carrier_get_apn());
        }
        {
            const carrier_preset_t *d = carrier_detect(imsi, gid1, iccid);
            printf("detected: %s\n", d ? d->label : "(none)");
        }
        printf("carrier <n> | carrier custom <apn>\n");
        return 0;
    }
    bool ok = false;
    if (argc == 3 && strcmp(argv[1], "custom") == 0) {
        ok = carrier_set_custom(argv[2]);
    } else if (argc == 2) {
        char *end = NULL;
        long n = strtol(argv[1], &end, 10);
        ok = (end && *end == '\0' && n >= 0) && carrier_select_preset((size_t) n);
    }
    if (!ok) {
        printf("carrier: not a preset number or a valid APN\n");
        return 1;
    }
    printf("carrier: %s. Used from the next attach: run `setup <code>` now, or restart.\n",
           carrier_get_label());
    return 0;
}

// `bearer [auto|direct|beam]` -- NVS override of the carrier's MQTT bearer
// (carrier.h); read once at the next attach. Bare `bearer` shows it.
static int cmd_bearer(int argc, char **argv)
{
    if (argc == 2) {
        carrier_bearer_ovr_t o = CARRIER_BEARER_OVR_AUTO;
        if (strcmp(argv[1], "direct") == 0) {
            o = CARRIER_BEARER_OVR_DIRECT;
        } else if (strcmp(argv[1], "beam") == 0) {
            o = CARRIER_BEARER_OVR_BEAM;
        } else if (strcmp(argv[1], "auto") != 0) {
            printf("usage: bearer [auto|direct|beam]\n");
            return 1;
        }
        if (!carrier_bearer_override_set(o)) {
            printf("bearer: NVS write failed\n");
            return 1;
        }
    } else if (argc != 1) {
        printf("usage: bearer [auto|direct|beam]\n");
        return 1;
    }
    printf("bearer override: %s (beam is honoured only when the carrier in force is a Beam preset); "
           "used from the next attach\n",
           carrier_bearer_ovr_name(carrier_bearer_override_get()));
    return 0;
}

// `wake`: arm the UI-awake window so the CardKB is polled (a bench with no
// button). `key <text>`: feed bytes as if typed; "\n" = enter, "\e" = esc.
static int cmd_wake(int argc, char **argv)
{
    (void) argc;
    (void) argv;
    input_arm_awake();
    printf("wake: UI awake; the keyboard is polled now\n");
    return 0;
}

static int cmd_key(int argc, char **argv)
{
    input_arm_awake();
    for (int i = 1; i < argc; i++) {
        if (i > 1) {
            input_feed_key(' ');
        }
        for (const char *p = argv[i]; *p; p++) {
            if (p[0] == '\\' && p[1] == 'n') {
                input_feed_key(0x0D);
                p++;
            } else if (p[0] == '\\' && p[1] == 'e') {
                input_feed_key(0x1B);
                p++;
            } else {
                input_feed_key((uint8_t) *p);
            }
        }
    }
    return 0;
}

// `i2cscan`: probe every 7-bit address on the keyboard bus (IO10/IO9) and
// print who ACKs. Bench aid: tells wiring faults from a dead keyboard.
static int cmd_i2cscan(int argc, char **argv)
{
    bool swap = (argc >= 2) && (strcmp(argv[1], "swap") == 0);
    // 5 Oct 2026: `i2cscan accel` scans the LIS3DH's own bus (I2C_NUM_1,
    // accel.c installs the driver at boot) -- wire vs. wedged-chip triage.
    bool accel = (argc >= 2) && (strcmp(argv[1], "accel") == 0);
    i2c_port_t port = accel ? I2C_NUM_1 : I2C_NUM_0;
    if (!accel) {
        ui_debug_pause_kb_poll(true); // kbd task owns I2C_NUM_0 otherwise; power effect: none
    }
    int sda = accel ? PAGER_PIN_ACCEL_SDA : (swap ? PAGER_PIN_KB_SCL : PAGER_PIN_KB_SDA);
    int scl = accel ? PAGER_PIN_ACCEL_SCL : (swap ? PAGER_PIN_KB_SDA : PAGER_PIN_KB_SCL);
    if (swap) {
        i2c_driver_delete(I2C_NUM_0);
        i2c_config_t conf = {
            .mode = I2C_MODE_MASTER,
            .sda_io_num = sda,
            .scl_io_num = scl,
            .sda_pullup_en = GPIO_PULLUP_ENABLE,
            .scl_pullup_en = GPIO_PULLUP_ENABLE,
            .master.clk_speed = 100000,
        };
        i2c_param_config(I2C_NUM_0, &conf);
        i2c_driver_install(I2C_NUM_0, conf.mode, 0, 0, 0);
    }
    int found = 0, nack = 0, timeout = 0, other = 0;
    for (uint8_t a = 0x08; a <= 0x77; a++) {
        i2c_cmd_handle_t cmd = i2c_cmd_link_create();
        i2c_master_start(cmd);
        i2c_master_write_byte(cmd, (uint8_t) ((a << 1) | I2C_MASTER_WRITE), true);
        i2c_master_stop(cmd);
        esp_err_t err = i2c_master_cmd_begin(port, cmd, pdMS_TO_TICKS(20));
        i2c_cmd_link_delete(cmd);
        if (err == ESP_OK) {
            printf("i2cscan: device at 0x%02x%s\n", a,
                   a == PAGER_I2C_ADDR_CARDKB ? " (CardKB)" : a == PAGER_I2C_ADDR_LIS3DH ? " (LIS3DH)" : "");
            found++;
        } else if (err == ESP_FAIL) {
            nack++; // nobody answered: a normal empty address
        } else if (err == ESP_ERR_TIMEOUT) {
            timeout++; // the bus never completed: a line held low or floating
        } else {
            other++;
            if (other == 1) {
                printf("i2cscan: error %s at 0x%02x\n", esp_err_to_name(err), a);
            }
        }
    }
    printf("i2cscan: %d device(s) on SDA=IO%d SCL=IO%d; %d no-answer, %d timeout, %d other. "
           "Lines idle: SDA=%d SCL=%d (1 = pulled up, as they should be)\n",
           found, sda, scl, nack, timeout, other, gpio_get_level((gpio_num_t) sda),
           gpio_get_level((gpio_num_t) scl));
    if (swap) {
        if (rail_is_on()) {
            ui_kb_i2c_reinit(); // back to the real pins (driver was reinstalled on the swapped ones)
        } else {
            ui_kb_bus_release(); // rail off: no driver on dead pins; drive the bus low again
        }
    }
    if (!accel) {
        ui_debug_pause_kb_poll(false); // kbd task resumes
    }
    if (timeout > 0) {
        printf("i2cscan: timeouts mean a line is stuck: check for a short, a swapped pair, or a "
               "keyboard powered from the wrong rail\n");
    }
    return 0;
}

static void register_input_cmds(void)
{
    const esp_console_cmd_t scan_cmd = {
        .command = "i2cscan",
        .help = "i2cscan -- list the devices that answer on the keyboard I2C bus",
        .hint = NULL,
        .func = &cmd_i2cscan,
    };
    ESP_ERROR_CHECK(esp_console_cmd_register(&scan_cmd));
    const esp_console_cmd_t wake_cmd = {
        .command = "wake",
        .help = "wake -- arm the UI-awake window so the keyboard is polled",
        .hint = NULL,
        .func = &cmd_wake,
    };
    ESP_ERROR_CHECK(esp_console_cmd_register(&wake_cmd));
    const esp_console_cmd_t key_cmd = {
        .command = "key",
        .help = "key <text> -- type text as if on the keyboard (\\n enter, \\e esc)",
        .hint = NULL,
        .func = &cmd_key,
    };
    ESP_ERROR_CHECK(esp_console_cmd_register(&key_cmd));
}

// `board` -- which PCB variant this is (board.h). `board auto|breadboard|carrier` persists the
// choice (NVS board/kind); reboot to apply. Power effect: none (one NVS write when setting).
static int cmd_board(int argc, char **argv)
{
    if (argc == 2) {
        board_kind_t k = BOARD_AUTO;
        if (strcmp(argv[1], "breadboard") == 0) {
            k = BOARD_BREADBOARD;
        } else if (strcmp(argv[1], "carrier") == 0) {
            k = BOARD_CARRIER_V02;
        } else if (strcmp(argv[1], "auto") != 0) {
            printf("board [auto|breadboard|carrier]\n");
            return 1;
        }
        printf("%s\n", board_set_kind(k) ? "saved; reboot to apply" : "save failed");
        return 0;
    }
    uint8_t who = 0;
    bool who_ok = board_who_am_i(&who);
    printf("board: %s (%s), stored kind %d\n", board_name(), board_source_name(), (int) board_stored_kind());
    if (who_ok) {
        printf("WHO_AM_I: 0x%02x\n", (unsigned) who);
    } else {
        printf("WHO_AM_I: read failed\n");
    }
    if (board_is_carrier()) {
        int vbus, s1, s2;
        board_read_charger_pins(&vbus, &s1, &s2);
        printf("IO%d VBUS_DET=%d  IO%d CHG_STAT1=%d  IO%d CHG_STAT2=%d\n", PAGER_PIN_VBUS_DET, vbus,
               PAGER_PIN_CHG_STAT1, s1, PAGER_PIN_CHG_STAT2, s2);
    }
    return 0;
}

#ifdef PAGER_DEBUG_NO_LIGHT_SLEEP
// fuel [quick|shutdown] -- carrier battery gauge (fuel.h). Debug console only.
static int cmd_fuel(int argc, char **argv)
{
    if (!board_has_fuel_gauge()) {
        printf("fuel: no gauge on this board (%s)\n", board_name());
        return 1;
    }
    if (argc > 1 && strcmp(argv[1], "quick") == 0) {
        printf("fuel: quick-start %s\n", fuel_quick_start() ? "sent" : "failed");
        return 0;
    }
    if (argc > 1 && strcmp(argv[1], "shutdown") == 0) {
        int vbus, s1, s2;
        fuel_pins(&vbus, &s1, &s2);
        printf("fuel: running the low-battery Shutdown now (IO15=%d: %s)\n", vbus,
               vbus ? "USB present, so it will restart after the screen draws" : "unplugged, deep sleep until USB is plugged in");
        modes_power_off_lowbatt();
    }
    fuel_t f;
    bool ok = fuel_read(&f);
    int vbus, s1, s2;
    fuel_pins(&vbus, &s1, &s2);
    if (ok) {
        printf("fuel: %d mV  %d%%  crate %c%d.%03d %%/h  state %s\n", f.mv, f.pct, f.crate_milli < 0 ? '-' : '+',
               (f.crate_milli < 0 ? -f.crate_milli : f.crate_milli) / 1000,
               (f.crate_milli < 0 ? -f.crate_milli : f.crate_milli) % 1000, fuel_state_name(fuel_state()));
    } else {
        printf("fuel: gauge read failed\n");
    }
    printf("IO%d VBUS_DET=%d  IO%d CHG_STAT1=%d  IO%d CHG_STAT2=%d\n", PAGER_PIN_VBUS_DET, vbus,
           PAGER_PIN_CHG_STAT1, s1, PAGER_PIN_CHG_STAT2, s2);
    return ok ? 0 : 1;
}
#endif // PAGER_DEBUG_NO_LIGHT_SLEEP

static void register_carrier_cmd(void)
{
    const esp_console_cmd_t board_cmd = {
        .command = "board",
        .help = "board [auto|breadboard|carrier] -- show the PCB variant, or set it (reboot to apply)",
        .hint = NULL,
        .func = &cmd_board,
    };
    ESP_ERROR_CHECK(esp_console_cmd_register(&board_cmd));
    const esp_console_cmd_t carrier_cmd = {
        .command = "carrier",
        .help = "carrier [<n> | custom <apn>] -- choose the carrier APN (presets are built in)",
        .hint = NULL,
        .func = &cmd_carrier,
    };
    ESP_ERROR_CHECK(esp_console_cmd_register(&carrier_cmd));
    const esp_console_cmd_t bearer_cmd = {
        .command = "bearer",
        .help = "bearer [auto|direct|beam] -- override how MQTT reaches the broker (see `carrier`)",
        .hint = NULL,
        .func = &cmd_bearer,
    };
    ESP_ERROR_CHECK(esp_console_cmd_register(&bearer_cmd));
}


// ---- Carrier v0.2 peripheral consoles: buzz / haptic / light / led (no-ops with a message on the breadboard).
// All run on the console task. Power effect: each drives its peripheral while it runs; nothing persists
// except `light <pct>` (NVS board/fl_duty) and `haptic cfg` (NVS haptic).
static int cmd_buzz(int argc, char **argv)
{
    if (!board_has_piezo()) {
        printf("no piezo on this board\n");
        return 0;
    }
    if (argc >= 2 && strcmp(argv[1], "off") == 0) {
        buzzer_stop();
    } else if (argc >= 2 && strcmp(argv[1], "msg") == 0) {
        buzzer_play(BUZZ_NEW_MSG);
    } else if (argc >= 2 && strcmp(argv[1], "mario") == 0) {
        size_t n = argc >= 3 ? (size_t) atoi(argv[2]) : TUNE_MARIO_DEFAULT_NOTES;
        printf("mario: %u notes\n", (unsigned) (n > TUNE_MARIO_NOTES ? TUNE_MARIO_NOTES : n));
        buzzer_play_mario(n);
    } else if (argc >= 3 && atoi(argv[1]) > 0) {
        buzzer_note_t one = {.hz = (uint16_t) atoi(argv[1]), .ms = (uint16_t) atoi(argv[2])};
        buzzer_play(&one, 1);
    } else {
        printf("buzz <hz> <ms> | msg | mario [n] | off\n");
        return 1;
    }
    return 0;
}

static int cmd_haptic(int argc, char **argv)
{
    if (!board_has_haptic()) {
        printf("no haptic driver on this board\n");
        return 0;
    }
    char line[160];
    if (argc >= 2 && strcmp(argv[1], "status") == 0) {
        haptic_status(line, sizeof(line));
        printf("%s\n", line);
    } else if (argc >= 2 && strcmp(argv[1], "calibrate") == 0) {
        haptic_calibrate(line, sizeof(line));
        printf("%s\n", line);
    } else if (argc >= 5 && strcmp(argv[1], "cfg") == 0) {
        printf("%s\n", haptic_set_cfg((uint32_t) atoi(argv[2]), (uint32_t) atoi(argv[3]), (uint32_t) atoi(argv[4]))
                           ? "saved"
                           : "bad values");
    } else if (argc >= 2 && strcmp(argv[1], "msg") == 0) {
        printf("%s\n", haptic_play(HAPTIC_NEW_MSG) ? "ok" : "failed (rail off or no chip)");
    } else if (argc >= 2 && atoi(argv[1]) > 0) {
        printf("%s\n", haptic_play(atoi(argv[1])) ? "ok" : "failed (rail off or no chip)");
    } else {
        printf("haptic <effect> | msg | calibrate | status | cfg <rated_mv> <clamp_mv> <f_hz>\n");
        return 1;
    }
    return 0;
}

static int cmd_light(int argc, char **argv)
{
    if (!board_has_frontlight()) {
        printf("no front light on this board\n");
        return 0;
    }
    if (argc >= 2 && strcmp(argv[1], "on") == 0) {
        frontlight_set(true);
    } else if (argc >= 2 && strcmp(argv[1], "off") == 0) {
        frontlight_off();
    } else if (argc >= 2 && atoi(argv[1]) >= 1 && atoi(argv[1]) <= 100) {
        frontlight_set_pct((uint8_t) atoi(argv[1]));
        frontlight_set(true);
    } else {
        printf("light on|off|<duty%%>   (now %s, %u%%)\n", frontlight_is_on() ? "on" : "off",
               (unsigned) frontlight_get_pct());
        return argc >= 2 ? 1 : 0;
    }
    return 0;
}

static int cmd_led(int argc, char **argv)
{
    if (!board_has_ext_led()) {
        printf("no external LED on this board\n");
        return 0;
    }
    if (argc >= 2 && strcmp(argv[1], "on") == 0) {
        extled_hold(true);
    } else if (argc >= 2 && strcmp(argv[1], "off") == 0) {
        extled_hold(false);
    } else if (argc >= 2 && strcmp(argv[1], "pulse") == 0) {
        extled_pulse(true);
    } else if (argc >= 2 && strcmp(argv[1], "breath") == 0) {
        extled_pulse(false);
    } else {
        printf("led on|off|pulse|breath\n");
        return 1;
    }
    return 0;
}

static void register_peripheral_cmds(void)
{
    static const esp_console_cmd_t cmds[] = {
        {.command = "buzz", .help = "buzz <hz> <ms> | msg | mario [n] | off -- carrier piezo", .hint = NULL, .func = &cmd_buzz},
        {.command = "haptic", .help = "haptic <effect> | msg | calibrate | status | cfg <rated_mv> <clamp_mv> <f_hz>", .hint = NULL, .func = &cmd_haptic},
        {.command = "light", .help = "light on|off|<duty%> -- carrier front light", .hint = NULL, .func = &cmd_light},
        {.command = "led", .help = "led on|off|pulse|breath -- carrier external LED", .hint = NULL, .func = &cmd_led},
    };
    for (size_t i = 0; i < sizeof(cmds) / sizeof(cmds[0]); i++) {
        ESP_ERROR_CHECK(esp_console_cmd_register(&cmds[i]));
    }
}

// No modem/radio access of its own; starts the USB-serial REPL task that
// waits for a person to type `setup <code>` (docs/DEVICE_PLAN.md §3.2 step
// 5's Setup mode). Power effect: none beyond the idle CPU/UART-RX floor
// until a command is typed — everything that actually touches the modem
// happens inside setup_run() (setup.c), not here.
static void start_setup_console(void)
{
    esp_console_repl_t *repl = NULL;
    esp_console_repl_config_t repl_config = ESP_CONSOLE_REPL_CONFIG_DEFAULT();
    repl_config.prompt = "pager>";
    // Default (4096) overflows: confirmed on real hardware -- `setup <code>`
    // crashed (Guru Meditation LoadProhibited, corrupted-pointer signature
    // several frames deep in vfprintf/xRingbufferSend) on the very first
    // ESP_LOGI call inside ui_init()->gfx_init(), before setup_run() even
    // reaches its own mbedtls AES-GCM/HKDF and MQTT work, which use
    // meaningfully more stack still.
    repl_config.task_stack_size = 16384;

    // esp_console_new_repl_uart() binds to UART0's own RX/TX pins, a
    // physically separate peripheral from the native USB-Serial/JTAG port
    // this board's single USB connector actually exposes (confirmed on
    // real hardware: typing `setup <code>` over the flashing/monitor cable
    // reached nowhere -- the REPL's stdin was listening on unconnected
    // UART0 pins the whole time). USB-Serial/JTAG is this project's
    // sdkconfig CONFIG_ESP_CONSOLE_SECONDARY_USB_SERIAL_JTAG, already used
    // for boot/log output; using it here too makes the console reachable
    // over the same cable used to flash and monitor.
#if CONFIG_ESP_CONSOLE_USB_SERIAL_JTAG
    esp_console_dev_usb_serial_jtag_config_t usb_config =
        ESP_CONSOLE_DEV_USB_SERIAL_JTAG_CONFIG_DEFAULT();
    ESP_ERROR_CHECK(esp_console_new_repl_usb_serial_jtag(&usb_config, &repl_config, &repl));
#else // carrier build (sdkconfig.carrier): UART0 -> CP2102N is the primary console
    esp_console_dev_uart_config_t uart_config = ESP_CONSOLE_DEV_UART_CONFIG_DEFAULT();
    ESP_ERROR_CHECK(esp_console_new_repl_uart(&uart_config, &repl_config, &repl));
#endif

    esp_console_register_help_command();

    const esp_console_cmd_t setup_cmd = {
        .command = "setup",
        .help = "setup <code> -- docs/DEVICE_PLAN.md section 3.2 bootstrap fetch from a typed setup code",
        .hint = NULL,
        .func = &cmd_setup,
    };
    ESP_ERROR_CHECK(esp_console_cmd_register(&setup_cmd));
    register_carrier_cmd();
    register_input_cmds();
    register_peripheral_cmds();

#ifdef PAGER_DEBUG_NO_LIGHT_SLEEP
    // Debug build only: docs/ROADMAP.md's "temporary diagnostics" no longer
    // ship in the release binary's Setup console.
    const esp_console_cmd_t nettest_cmd = {
        .command = "nettest",
        .help = "nettest <host> <port> -- TEMPORARY: plain TCP (no TLS) connectivity probe",
        .hint = NULL,
        .func = &cmd_nettest,
    };
    ESP_ERROR_CHECK(esp_console_cmd_register(&nettest_cmd));

    const esp_console_cmd_t mqtttest_cmd = {
        .command = "mqtttest",
        .help = "mqtttest <host> <port> -- TEMPORARY: modem MQTT-engine TLS connect probe",
        .hint = NULL,
        .func = &cmd_mqtttest,
    };
    ESP_ERROR_CHECK(esp_console_cmd_register(&mqtttest_cmd));

    // Bench: read the SIM on an unprovisioned unit (same handler as the normal-mode console).
    const esp_console_cmd_t at_cmd = {
        .command = "at",
        .help = "at <command> -- send one raw AT command; the reply shows in the AT trace",
        .hint = NULL,
        .func = &cmd_at,
    };
    ESP_ERROR_CHECK(esp_console_cmd_register(&at_cmd));
#endif

    ESP_ERROR_CHECK(esp_console_start_repl(repl));
}

#ifdef PAGER_DEBUG_NO_LIGHT_SLEEP
// v0.2 §2.7 (docs/V02_DESIGN.md item 7): the same USB-serial REPL Setup mode
// uses (start_setup_console()), but reachable in normal (provisioned) mode
// too -- PAGER_DEBUG_NO_LIGHT_SLEEP builds only -- so `nettest`/`mqtttest`
// diagnostics can run against a provisioned pager's real SIM/APN without
// erasing its identity to get back into Setup mode first. Deliberately does
// NOT register `setup`: re-running it here would overwrite the very
// identity being diagnosed.
//
// Caveat, debug-build-only and worth stating plainly: nettest/mqtttest both
// call net_bootstrap_attach() (net.cpp), which is documented as safe to
// share process-global state with the production session (s_down_topic,
// the MQTT event handler registration) only because bootstrap and
// production "never run in the same power cycle" outside of this REPL. Once
// this REPL exists in normal mode, that stops being strictly true: running
// either command while the production MQTT session is up re-attaches the
// modem (setOpState(NO_RF) then FULL) and, for mqtttest, repoints
// s_down_topic at a test topic, which will disrupt (and, for mqtttest,
// mis-subscribe) live paging until the next full reconnect. Acceptable for
// a debug build that already carries CMakeLists.txt's "never ship a build
// made this way" warning and is only ever run by a person deliberately
// diagnosing a bench unit, not for anything that reaches a real pager in
// the field.
//
// Own task (esp_console_start_repl() spawns one internally and returns;
// this function does not block app_main()), 16 kB stack -- same overflow
// finding start_setup_console() documents (ui_init()/gfx_init()'s first
// ESP_LOGI call overflowed the default 4 kB stack).
//
// `gnsstest <seconds>` (docs/V02_DESIGN.md §2.7/§5) and `cafetch <url>
// <sha256hex>` (§4.4, this task) are added below. `smstest <number> <text>`
// still depends on §6 (SMS), not started by this task -- left for the task
// that adds it.
//
// Power effect: none beyond the idle CPU/UART-RX floor until a command is
// typed, same as start_setup_console(); nettest/mqtttest's own modem use is
// documented at their definitions above; gnsstest's is documented at
// loc_debug_run() (loc.h).

// v0.2 §5: `gnsstest <seconds>` -- runs one location-fix attempt through the
// exact same route/state-machine code a real loc_req uses, bypassing the
// backoff/battery-floor gate. Blocks this console task (never modes_run()'s
// -- see loc_debug_run()'s own doc comment) until the attempt finishes or
// `seconds` elapses.
static int cmd_gnsstest(int argc, char **argv)
{
    if (argc != 2) {
        printf("usage: gnsstest <seconds>\n");
        return 1;
    }
    long seconds = strtol(argv[1], NULL, 10);
    if (seconds <= 0 || seconds > 120) {
        printf("seconds must be 1..120\n");
        return 1;
    }
    bool ok = loc_debug_run((uint32_t) seconds);
    printf("gnsstest: %s (see the log above for confidence/satellite/session detail)\n",
           ok ? "FIX" : "no fix / refused / already running - see log");
    return ok ? 0 : 1;
}

// LOCATION_TRACKING_DESIGN.md §9 test plan (task F3): `loctrack on|off` --
// A/B switch for the whole background tracker (STILL/MOVING classifier,
// report scheduler, GNSS-while-moving schedule), so it can be A/B'd on one
// flash. Bare `loctrack` prints the current setting. RAM-only, no modem/
// sleep-state effect of its own (loc_set_track_enabled()'s own doc comment).
// docs/GNSS_DISABLE_DESIGN.md D7: `gnss [on|off]` -- bare form prints, with an
// argument persists loc/gnss to NVS (one NVS write, no modem effect).
static int cmd_gnss(int argc, char **argv)
{
    if (argc == 2 && (strcmp(argv[1], "on") == 0 || strcmp(argv[1], "off") == 0)) {
        if (!loc_set_gnss_enabled(strcmp(argv[1], "on") == 0)) {
            printf("gnss: NVS write failed\n");
            return 1;
        }
    } else if (argc != 1) {
        printf("usage: gnss [on|off]\n");
        return 1;
    }
    printf("gnss: %s\n", loc_gnss_enabled() ? "on" : "off");
    return 0;
}

static int cmd_loctrack(int argc, char **argv)
{
    if (argc == 1) {
        printf("loctrack: %s\n", loc_get_track_enabled() ? "on" : "off");
        return 0;
    }
    if (argc != 2 || (strcmp(argv[1], "on") != 0 && strcmp(argv[1], "off") != 0)) {
        printf("usage: loctrack [on|off]\n");
        return 1;
    }
    loc_set_track_enabled(strcmp(argv[1], "on") == 0);
    printf("loctrack: %s\n", loc_get_track_enabled() ? "on" : "off");
    return 0;
}

// LOCATION_TRACKING_DESIGN.md §9 test plan (task F3): `locmove <s>` -- the
// GNSS-while-moving interval (0 = off). Bare `locmove` prints the current
// value. RAM-only (loc_set_move_gnss_s()'s own doc comment).
static int cmd_locmove(int argc, char **argv)
{
    if (argc == 1) {
        printf("locmove: %us\n", (unsigned) loc_get_move_gnss_s());
        return 0;
    }
    if (argc != 2) {
        printf("usage: locmove [<seconds>]\n");
        return 1;
    }
    long seconds = strtol(argv[1], NULL, 10);
    if (seconds < 0) {
        printf("locmove: seconds must be >= 0 (0 disables GNSS-while-moving)\n");
        return 1;
    }
    loc_set_move_gnss_s((uint32_t) seconds);
    printf("locmove: %us%s\n", (unsigned) seconds, seconds == 0 ? " (off)" : "");
    return 0;
}

// Owner request, 2026-09-20: `coverage` -- prints the coverage duty-cycle
// policy's current state. Plain reads only, no modem/sleep-state effect.
static int cmd_coverage(int argc, char **argv)
{
    (void) argc;
    (void) argv;
    modes_coverage_debug_print();
    return 0;
}

// v0.2 §4.4: `cafetch <url> <sha256hex>` -- runs the CA fetch only (no
// apply), via catrust_debug_cafetch()/cafetch_run_blocking(). Blocks this
// console task (never modes_run()'s -- see catrust_debug_cafetch()'s own
// doc comment) for up to the fetch's own 30s budget.
static int cmd_cafetch(int argc, char **argv)
{
    if (argc != 3) {
        printf("usage: cafetch <url> <sha256hex>\n");
        return 1;
    }
    bool ok = catrust_debug_cafetch(argv[1], argv[2]);
    printf("cafetch: %s (see the log above for bytes/http_status/elapsed/mqtt_survived detail)\n",
           ok ? "OK (hash matched)" : "FAILED - see log");
    return ok ? 0 : 1;
}

// docs/OTA_DESIGN.md section 7.2: `otafetch <url> <size>` -- streams the object through cafetch's body sink
// into a sink that only hashes and counts (no flash writes), resuming with Range after a broken transfer
// exactly like ota.c does. Prints bytes, elapsed_ms, B/s, short-read count, resumes, sha16 and
// mqtt_survived. Blocks this console task (never modes_run()'s) for up to 900 s.
typedef struct {
    mbedtls_sha256_context sha;
    size_t n;
} otafetch_sink_t;

static bool otafetch_sink(void *arg, const uint8_t *data, size_t len)
{
    otafetch_sink_t *s = (otafetch_sink_t *) arg;
    mbedtls_sha256_update(&s->sha, data, len);
    s->n += len;
    return true;
}

static int cmd_otafetch(int argc, char **argv)
{
    if (argc != 3) {
        printf("usage: otafetch <url> <size>\n");
        return 1;
    }
    size_t total = (size_t) strtoul(argv[2], NULL, 10);
    if (total == 0) {
        printf("otafetch: size must be > 0\n");
        return 1;
    }
    if (cafetch_in_progress() || ota_transfer_active()) {
        printf("otafetch: a fetch is already in progress\n");
        return 1;
    }
    net_mqtt_status_t before = { 0 }, after = { 0 };
    net_get_mqtt_status(&before);
    otafetch_sink_t s;
    mbedtls_sha256_init(&s.sha);
    mbedtls_sha256_starts(&s.sha, 0);
    s.n = 0;
    int shorts = 0, resumes = 0;
    bool ok = false;
    int64_t t0 = esp_timer_get_time();
    for (;;) {
        if (!cafetch_begin_stream(argv[1], s.n, total - s.n, otafetch_sink, &s)) {
            break;
        }
        cafetch_status_t st;
        while ((st = cafetch_poll(esp_timer_get_time())) == CAFETCH_PENDING) {
            vTaskDelay(pdMS_TO_TICKS(20)); // FreeRTOS primitive, not a busy-wait
        }
        if (st == CAFETCH_OK) {
            cafetch_end();
            ok = (s.n == total);
            break;
        }
        bool transport = false, was_short = false;
        cafetch_fail_info(NULL, NULL, &transport, &was_short);
        cafetch_end();
        if (was_short) {
            shorts++;
        }
        if (!transport || s.n >= total || ++resumes > 20) {
            break;
        }
    }
    uint32_t ms = (uint32_t) ((esp_timer_get_time() - t0) / 1000);
    uint8_t h[32];
    mbedtls_sha256_finish(&s.sha, h);
    mbedtls_sha256_free(&s.sha);
    net_get_mqtt_status(&after);
    printf("otafetch: %s bytes=%u elapsed_ms=%u B/s=%u short=%d resumes=%d sha16=%02x%02x%02x%02x%02x%02x%02x%02x "
           "mqtt_survived=%d\n",
           ok ? "OK" : "FAILED", (unsigned) s.n, (unsigned) ms, (unsigned) (ms ? (uint64_t) s.n * 1000u / ms : 0),
           shorts, resumes, h[0], h[1], h[2], h[3], h[4], h[5], h[6], h[7],
           (int) (before.mqtt_connected && after.mqtt_connected));
    return ok ? 0 : 1;
}

// v0.2 §6 (docs/V02_DESIGN.md, this task): `smstest <number> <text>` -- sends
// one SMS bypassing the allow-list (an arbitrary number), via
// sms_debug_send() (main/sms.c). Blocks this console task (never
// modes_run()'s) for the AT+CMGS round trip; still produces an audit entry
// (sms_debug_send()'s own doc comment: the audit trail has no debug
// carve-out).
static int cmd_smstest(int argc, char **argv)
{
    if (argc != 3) {
        printf("usage: smstest <number> <text>\n");
        return 1;
    }
    bool ok = sms_debug_send(argv[1], argv[2]);
    printf("smstest: %s (see the log above for the encoding chosen and the raw modem result)\n",
           ok ? "OK" : "FAILED - see log");
    return ok ? 0 : 1;
}

// v0.2 §6: `smslist` -- logs the allow-list and the audit queue depth
// (sms.c's own sms_debug_list() does the ESP_LOGI calls).
static int cmd_smslist(int argc, char **argv)
{
    (void) argc;
    (void) argv;
    sms_debug_list();
    printf("smslist: see the log above\n");
    return 0;
}

// A2 (docs/DEVICE_NEXT_TASKS.md): `acceltest` -- LIS3DH register/sample
// dump and runtime tuning, entirely through accel.h's accel_debug_*() API
// (this file never touches I2C or the LIS3DH's registers directly). Every
// form re-probes WHO_AM_I first (accel_debug_status()'s own contract), so
// the owner can wire the chip and start typing without a reboot -- if it
// now answers and had not been configured yet, this prints that once.
// Runs on this console task; the IDF I2C driver is per-port mutexed, so
// concurrent kbd task / accel_poll() (modes_run()'s task) is safe.
// `acceltest samples 600` blocks THIS task (never modes_run()'s) for ~60s
// (one sample per ODR period, 40ms at the default 25Hz).
static const char *ACCELTEST_USAGE =
    "acceltest                 -- WHO_AM_I, CTRL_REG1-5, INT1/INT2 CFG/THS/DURATION/SRC, THS in mg, "
    "the shake settings and counters, the refractory setting, edges reported, and ext1 wake count\n"
    "acceltest samples <n>     -- n (1..600) live x/y/z samples paced at the current ODR, plus "
    "INT1_SRC/INT2_SRC when an IA bit is set\n"
    "acceltest ths <0-127>     -- write INT1_THS, echo the read-back\n"
    "acceltest dur <0-127>     -- write INT1_DURATION, echo the read-back\n"
    "acceltest ths2 <0-127>    -- write INT2_THS, echo the read-back\n"
    "acceltest dur2 <0-127>    -- write INT2_DURATION, echo the read-back\n"
    "acceltest shake on|off    -- shake-to-wake on (default) or off (IA2 off the pin, classifier idle)\n"
    "acceltest shake <n 1-50> <gap_ms 20-2000> <span_ms 0-5000> <holdoff_s 0-600> -- classifier settings\n"
    "acceltest cfg <ctrl1> <ctrl4> -- write CTRL_REG1 and CTRL_REG4 (0-255, hex ok, e.g. 0x2F 0x00)\n"
    "acceltest refr <seconds>  -- set A1's refractory window (0 = off, reproduces the wake storm)\n"
    "acceltest budget spent|full -- set the accel reboot budget (spent: the ladder ends in the halt screen)\n"
    "acceltest fail <n> [pend] -- fail the next n INT1/INT2_SRC reads in accel_poll() (recovery ladder test); pend = only while a shake chain is pending; 0 cancels\n";

static int cmd_acceltest(int argc, char **argv)
{
    accel_debug_status_t st;
    bool newly_configured = false;
    bool present = accel_debug_status(&st, &newly_configured);
    if (newly_configured) {
        printf("acceltest: LIS3DH now answers WHO_AM_I -- configured\n");
    }

    if (argc == 1) {
        if (!present) {
            printf("acceltest: not present (WHO_AM_I read: %s)\n", esp_err_to_name(accel_debug_last_err()));
            return 1;
        }
        printf("acceltest: present=1 WHO_AM_I=0x%02x\n", (unsigned) st.who_am_i);
        printf("acceltest: CTRL_REG1=0x%02x CTRL_REG2=0x%02x CTRL_REG3=0x%02x CTRL_REG4=0x%02x "
               "CTRL_REG5=0x%02x\n",
               (unsigned) st.ctrl_reg1, (unsigned) st.ctrl_reg2, (unsigned) st.ctrl_reg3,
               (unsigned) st.ctrl_reg4, (unsigned) st.ctrl_reg5);
        printf("acceltest: INT1_CFG=0x%02x INT1_THS=0x%02x (%u mg) INT1_DURATION=0x%02x "
               "INT1_SRC=0x%02x\n",
               (unsigned) st.int1_cfg, (unsigned) st.int1_ths, (unsigned) st.ths_mg,
               (unsigned) st.int1_duration, (unsigned) st.int1_src);
        printf("acceltest: INT2_CFG=0x%02x INT2_THS=0x%02x (%u mg) INT2_DURATION=0x%02x "
               "INT2_SRC=0x%02x\n",
               (unsigned) st.int2_cfg, (unsigned) st.int2_ths, (unsigned) st.ths2_mg,
               (unsigned) st.int2_duration, (unsigned) st.int2_src);
        printf("acceltest: shake=%s n=%u gap=%ums span=%ums holdoff=%us candidates=%u rejected=%u "
               "fired=%u\n",
               st.shake_enabled ? "on" : "off", (unsigned) st.shake_n, (unsigned) st.shake_gap_ms,
               (unsigned) st.shake_span_ms, (unsigned) (st.shake_holdoff_ms / 1000),
               (unsigned) st.shake_candidates, (unsigned) st.shake_rejected,
               (unsigned) st.shake_fired);
        printf("acceltest: refractory=%llds edges_reported=%u ext1_wakes=%u\n",
               (long long) (st.refractory_us / 1000000), (unsigned) st.edges_reported,
               (unsigned) st.ext1_wakes);
        return 0;
    }

    if (strcmp(argv[1], "samples") == 0) {
        if (argc != 3) {
            printf("usage: acceltest samples <n>\n");
            return 1;
        }
        char *end = NULL;
        long n = strtol(argv[2], &end, 10);
        if (!end || *end != '\0' || n < 1 || n > 600) {
            printf("acceltest: n must be 1..600\n");
            return 1;
        }
        if (!present) {
            printf("acceltest: not present (WHO_AM_I read: %s)\n", esp_err_to_name(accel_debug_last_err()));
            return 1;
        }
        uint32_t period_ms = accel_debug_sample_period_ms();
        for (long i = 0; i < n; i++) {
            int16_t x_mg = 0, y_mg = 0, z_mg = 0;
            uint8_t src = 0, src2 = 0;
            if (!accel_debug_sample(&x_mg, &y_mg, &z_mg, &src, &src2)) {
                printf("acceltest: sample %ld: I2C read failed\n", i);
            } else {
                printf("acceltest: x=%d y=%d z=%d mg\n", (int) x_mg, (int) y_mg, (int) z_mg);
                if ((src & 0x40) || (src2 & 0x40)) { // IA
                    printf("acceltest: INT1_SRC=0x%02x INT2_SRC=0x%02x\n", (unsigned) src,
                           (unsigned) src2);
                }
            }
            vTaskDelay(pdMS_TO_TICKS(period_ms)); // one sample per ODR period
        }
        return 0;
    }

    if (strcmp(argv[1], "ths") == 0) {
        if (argc != 3) {
            printf("usage: acceltest ths <0-127>\n");
            return 1;
        }
        char *end = NULL;
        long v = strtol(argv[2], &end, 10);
        if (!end || *end != '\0' || v < 0 || v > 127) {
            printf("acceltest: ths must be 0..127\n");
            return 1;
        }
        uint8_t readback = 0;
        if (!accel_debug_set_ths((uint8_t) v, &readback)) {
            printf("acceltest: not present, or the write failed\n");
            return 1;
        }
        printf("acceltest: INT1_THS=0x%02x (%u mg)\n", (unsigned) readback,
               (unsigned) readback * 16);
        return 0;
    }

    if (strcmp(argv[1], "dur") == 0) {
        if (argc != 3) {
            printf("usage: acceltest dur <0-127>\n");
            return 1;
        }
        char *end = NULL;
        long v = strtol(argv[2], &end, 10);
        if (!end || *end != '\0' || v < 0 || v > 127) {
            printf("acceltest: dur must be 0..127\n");
            return 1;
        }
        uint8_t readback = 0;
        if (!accel_debug_set_dur((uint8_t) v, &readback)) {
            printf("acceltest: not present, or the write failed\n");
            return 1;
        }
        printf("acceltest: INT1_DURATION=0x%02x\n", (unsigned) readback);
        return 0;
    }

    if (strcmp(argv[1], "ths2") == 0 || strcmp(argv[1], "dur2") == 0) {
        bool is_ths = argv[1][0] == 't';
        if (argc != 3) {
            printf("usage: acceltest %s <0-127>\n", argv[1]);
            return 1;
        }
        char *end = NULL;
        long v = strtol(argv[2], &end, 10);
        if (!end || *end != '\0' || v < 0 || v > 127) {
            printf("acceltest: %s must be 0..127\n", argv[1]);
            return 1;
        }
        uint8_t readback = 0;
        if (!(is_ths ? accel_debug_set_ths2((uint8_t) v, &readback)
                     : accel_debug_set_dur2((uint8_t) v, &readback))) {
            printf("acceltest: not present, or the write failed\n");
            return 1;
        }
        if (is_ths) {
            accel_debug_status_t st2;
            accel_debug_status(&st2, NULL);
            printf("acceltest: INT2_THS=0x%02x (%u mg)\n", (unsigned) readback,
                   (unsigned) st2.ths2_mg);
        } else {
            printf("acceltest: INT2_DURATION=0x%02x\n", (unsigned) readback);
        }
        return 0;
    }

    if (strcmp(argv[1], "shake") == 0) {
        if (argc == 3 && (strcmp(argv[2], "on") == 0 || strcmp(argv[2], "off") == 0)) {
            bool on = argv[2][1] == 'n';
            accel_debug_set_shake(on);
            printf("acceltest: shake=%s\n", on ? "on" : "off");
            return 0;
        }
        if (argc != 6) {
            printf("usage: acceltest shake on|off | acceltest shake <n 1-50> <gap_ms 20-2000> "
                   "<span_ms 0-5000> <holdoff_s 0-600>\n");
            return 1;
        }
        long vals[4];
        for (int k = 0; k < 4; k++) {
            char *end = NULL;
            vals[k] = strtol(argv[2 + k], &end, 10);
            if (!end || *end != '\0') {
                printf("acceltest: shake arguments must be numbers\n");
                return 1;
            }
        }
        if (vals[0] < 1 || vals[0] > 50 || vals[1] < 20 || vals[1] > 2000 || vals[2] < 0 ||
            vals[2] > 5000 || vals[3] < 0 || vals[3] > 600) {
            printf("acceltest: n 1-50, gap_ms 20-2000, span_ms 0-5000, holdoff_s 0-600\n");
            return 1;
        }
        accel_debug_set_shake_cfg((uint8_t) vals[0], (uint16_t) vals[1], (uint16_t) vals[2],
                                  (uint32_t) vals[3]);
        printf("acceltest: shake n=%ld gap=%ldms span=%ldms holdoff=%lds\n", vals[0], vals[1],
               vals[2], vals[3]);
        return 0;
    }

    if (strcmp(argv[1], "cfg") == 0) {
        if (argc != 4) {
            printf("usage: acceltest cfg <ctrl1> <ctrl4>\n");
            return 1;
        }
        char *e1 = NULL, *e4 = NULL;
        long c1 = strtol(argv[2], &e1, 0);
        long c4 = strtol(argv[3], &e4, 0);
        if (!e1 || *e1 != '\0' || !e4 || *e4 != '\0' || c1 < 0 || c1 > 255 || c4 < 0 || c4 > 255) {
            printf("acceltest: ctrl1 and ctrl4 must be 0..255 (hex ok)\n");
            return 1;
        }
        if (!accel_debug_set_cfg((uint8_t) c1, (uint8_t) c4)) {
            printf("acceltest: not present, the write failed, or the read-back differs\n");
            return 1;
        }
        printf("acceltest: CTRL_REG1=0x%02x CTRL_REG4=0x%02x\n", (unsigned) c1, (unsigned) c4);
        return 0;
    }

    if (strcmp(argv[1], "refr") == 0) {
        if (argc != 3) {
            printf("usage: acceltest refr <seconds>\n");
            return 1;
        }
        char *end = NULL;
        long v = strtol(argv[2], &end, 10);
        if (!end || *end != '\0' || v < 0) {
            printf("acceltest: seconds must be >= 0 (0 disables the refractory guard)\n");
            return 1;
        }
        accel_debug_set_refractory_s((uint32_t) v);
        printf("acceltest: refractory=%lds\n", v);
        return 0;
    }

    if (strcmp(argv[1], "budget") == 0 && argc >= 3) {
        accel_debug_set_budget_spent(strcmp(argv[2], "spent") == 0);
        printf("acceltest: accel reboot budget %s\n", strcmp(argv[2], "spent") == 0 ? "spent (2/2)" : "full (0/2)");
        return 0;
    }
    if (strcmp(argv[1], "fail") == 0) {
        // Debug-only: fail the next n INT1/INT2_SRC reads in accel_poll() (recovery ladder test).
        char *end = NULL;
        long v = argc >= 3 ? strtol(argv[2], &end, 10) : -1;
        if (argc < 3 || !end || *end != '\0' || v < 0 || v > 100000) {
            printf("acceltest: fail <n 0-100000> [pend]\n");
            return 1;
        }
        accel_debug_inject_fail((uint32_t) v, argc >= 4 && strcmp(argv[3], "pend") == 0);
        printf("acceltest: next %ld accel_poll() reads will fail%s\n", v,
               (argc >= 4 && strcmp(argv[3], "pend") == 0) ? " (only while a shake chain is pending)" : "");
        return 0;
    }

    printf("%s", ACCELTEST_USAGE);
    return 1;
}

// Bench harness for the garbled-bands bug (disp.c's partial_refresh_locked()
// comment, docs task-disp-fix.md): a deterministic, keyboard-free,
// network-free reproduction. Paints a known pattern and drives
// disp_partial_refresh()/disp_full_refresh() directly instead of typing on
// the CardKB, so the bench can correlate "the band that went wrong" (a
// screen-x range) against disp.c's own "partial: native rows ..." log line
// with nothing else moving. No modem/sleep-state effect; every refresh call
// below has its own documented panel-VCC power effect at its definition in
// disp.c.
#define DISPTEST_COL_PX 8
#define DISPTEST_MAX_STEP (GFX_SCREEN_W / DISPTEST_COL_PX) /* n must be < this */
#define DISPTEST_SEQ_MAX_COUNT 36
#define DISPTEST_SEQ_MIN_MS 200
#define DISPTEST_SEQ_MAX_MS 5000

static const char *DISPTEST_USAGE =
    "disptest                     -- same as `disptest info`\n"
    "disptest info                -- print again-mode, partial count, disp_dirty_rows()\n"
    "disptest again <0|1>         -- set the partial-write-again A/B flag\n"
    "disptest lut [0|1]           -- show/set (persisted) the host-written partial LUT A/B flag (0x32 "
    "WF_PARTIAL_2IN9 + 0x22=0xCF vs. today's 0x22=0xFF)\n"
    "disptest tp0a [N]            -- show/set (persisted, 1..31) host LUT group-0 phase-A frames (default 7)\n"
    "disptest bars                -- paint the baseline pattern and FULL refresh\n"
    "disptest step <n>            -- invert the 8px screen column at x=n*8 (full height), then "
    "ONE partial refresh; n must be 0..(GFX_SCREEN_W/8 - 1)\n"
    "disptest seq [n0] [n1] [ms]  -- `step` for n = n0..n1, ms apart (defaults 2 12 1500; "
    "count clamped to 36, ms clamped to 200..5000)\n"
    "disptest full                -- force one full refresh of whatever is in the framebuffer\n"
    "disptest black|white         -- paint every pixel one colour and full refresh (wiring check)\n"
    "disptest swreset             -- fault injector: send SW reset (0x12) alone, wait BUSY, "
    "nothing else -- leaves the controller on power-on register defaults (23 Sep field failure)\n"
    "NOTE: do not use `wake` or `key` while disptest is running -- the UI render task would "
    "repaint over the test pattern.\n";

// Baseline test pattern: 8px black, 8px white, repeating across the full
// 296px screen width, full screen height. Nested gfx_set_pixel() loops --
// gfx.h has no filled-rect primitive (gfx_rect() is an outline only).
static void disptest_paint_bars(void)
{
    gfx_clear();
    for (int x0 = 0; x0 < GFX_SCREEN_W; x0 += 2 * DISPTEST_COL_PX) {
        for (int dx = 0; dx < DISPTEST_COL_PX && x0 + dx < GFX_SCREEN_W; dx++) {
            for (int y = 0; y < GFX_SCREEN_H; y++) {
                gfx_set_pixel(x0 + dx, y, true);
            }
        }
    }
}

// One `disptest step`/`seq` iteration: invert the n'th 8px screen column
// (full height) and fire ONE partial refresh. Prints the screen-x range and
// the native-row range gfx_set_pixel()'s x -> (GFX_FB_ROWS-1)-x mirror maps
// it to, so the log reads as "asked for x 16..23 => native rows 272..279"
// right next to disp.c's own "partial: native rows ..." line for the same
// request.
static void disptest_step(int n)
{
    int x = n * DISPTEST_COL_PX;
    int x_hi = x + DISPTEST_COL_PX - 1;
    int native_lo = (GFX_FB_ROWS - 1) - x_hi;
    int native_hi = (GFX_FB_ROWS - 1) - x;
    printf("disptest: step %d asked for x %d..%d => native rows %d..%d\n", n, x, x_hi, native_lo,
           native_hi);
    gfx_invert_rect(x, 0, DISPTEST_COL_PX, GFX_SCREEN_H);
    disp_partial_refresh();
}

static int cmd_disptest(int argc, char **argv)
{
    if (argc < 2 || strcmp(argv[1], "info") == 0) {
        printf("disptest: again=%d lut=%d partial_count=%u dirty_rows=%d\n",
               (int) disp_partial_write_again(), (int) disp_get_partial_lut(),
               (unsigned) disp_partial_count(), disp_dirty_rows());
        return 0;
    }
    if (strcmp(argv[1], "again") == 0) {
        if (argc != 3 || (strcmp(argv[2], "0") != 0 && strcmp(argv[2], "1") != 0)) {
            printf("usage: disptest again <0|1>\n");
            return 1;
        }
        disp_set_partial_write_again(strcmp(argv[2], "1") == 0);
        printf("disptest: again=%d\n", (int) disp_partial_write_again());
        return 0;
    }
    if (strcmp(argv[1], "lut") == 0) {
        if (argc == 2) {
            printf("disptest: lut=%d (%s)\n", (int) disp_get_partial_lut(),
                   disp_get_partial_lut() ? "host LUT" : "OTP");
            return 0;
        }
        if (argc != 3 || (strcmp(argv[2], "0") != 0 && strcmp(argv[2], "1") != 0)) {
            printf("usage: disptest lut [0|1]\n");
            return 1;
        }
        disp_set_partial_lut(strcmp(argv[2], "1") == 0);
        printf("disptest: lut=%d\n", (int) disp_get_partial_lut());
        return 0;
    }
    if (strcmp(argv[1], "tp0a") == 0) {
        if (argc == 2) {
            printf("disptest: tp0a=%u\n", (unsigned) disp_get_lut_tp0a());
            return 0;
        }
        char *end = NULL;
        long v = argc == 3 ? strtol(argv[2], &end, 10) : 0;
        if (argc != 3 || *end != '\0' || v < 1 || v > 31 || !disp_set_lut_tp0a((uint8_t) v)) {
            printf("usage: disptest tp0a [1..31]\n");
            return 1;
        }
        printf("disptest: tp0a=%u\n", (unsigned) disp_get_lut_tp0a());
        return 0;
    }
    if (strcmp(argv[1], "bars") == 0) {
        if (argc != 2) {
            printf("usage: disptest bars\n");
            return 1;
        }
        disptest_paint_bars();
        disp_full_refresh();
        printf("disptest: bars painted, full refresh done\n");
        return 0;
    }
    if (strcmp(argv[1], "step") == 0) {
        if (argc != 3) {
            printf("usage: disptest step <n>\n");
            return 1;
        }
        char *end = NULL;
        long n = strtol(argv[2], &end, 10);
        if (!end || *end != '\0' || n < 0 || n >= DISPTEST_MAX_STEP) {
            printf("disptest: n must be 0..%d\n", DISPTEST_MAX_STEP - 1);
            printf("usage: disptest step <n>\n");
            return 1;
        }
        disptest_step((int) n);
        return 0;
    }
    if (strcmp(argv[1], "seq") == 0) {
        if (argc > 5) {
            printf("usage: disptest seq [n0] [n1] [ms]\n");
            return 1;
        }
        long n0 = 2, n1 = 12, ms = 1500;
        char *end = NULL;
        if (argc >= 3) {
            n0 = strtol(argv[2], &end, 10);
            if (!end || *end != '\0') {
                printf("usage: disptest seq [n0] [n1] [ms]\n");
                return 1;
            }
        }
        if (argc >= 4) {
            n1 = strtol(argv[3], &end, 10);
            if (!end || *end != '\0') {
                printf("usage: disptest seq [n0] [n1] [ms]\n");
                return 1;
            }
        }
        if (argc >= 5) {
            ms = strtol(argv[4], &end, 10);
            if (!end || *end != '\0') {
                printf("usage: disptest seq [n0] [n1] [ms]\n");
                return 1;
            }
        }
        if (n0 < 0 || n0 >= DISPTEST_MAX_STEP || n1 < 0 || n1 >= DISPTEST_MAX_STEP || n1 < n0) {
            printf("disptest: n0/n1 must be 0..%d with n1 >= n0\n", DISPTEST_MAX_STEP - 1);
            printf("usage: disptest seq [n0] [n1] [ms]\n");
            return 1;
        }
        if (n1 - n0 + 1 > DISPTEST_SEQ_MAX_COUNT) {
            n1 = n0 + DISPTEST_SEQ_MAX_COUNT - 1;
            printf("disptest: clamped to %d steps (n0=%ld n1=%ld)\n", DISPTEST_SEQ_MAX_COUNT, n0,
                   n1);
        }
        if (ms < DISPTEST_SEQ_MIN_MS) {
            ms = DISPTEST_SEQ_MIN_MS;
        } else if (ms > DISPTEST_SEQ_MAX_MS) {
            ms = DISPTEST_SEQ_MAX_MS;
        }
        printf("disptest: seq n=%ld..%ld, %ld ms apart\n", n0, n1, ms);
        for (long n = n0; n <= n1; n++) {
            disptest_step((int) n);
            if (n != n1) {
                vTaskDelay(pdMS_TO_TICKS(ms));
            }
        }
        return 0;
    }
    if (strcmp(argv[1], "full") == 0) {
        if (argc != 2) {
            printf("usage: disptest full\n");
            return 1;
        }
        disp_full_refresh();
        printf("disptest: full refresh done\n");
        return 0;
    }
    if (strcmp(argv[1], "black") == 0 || strcmp(argv[1], "white") == 0) {
        // Wiring sanity check (owner, 24 Sep): the dumbest possible image,
        // every pixel one colour, then a full refresh. Anything but a
        // uniform panel afterwards is the SPI/DC/RST/BUSY path, not the
        // renderer.
        if (argc != 2) {
            printf("usage: disptest black|white\n");
            return 1;
        }
        gfx_clear();
        if (argv[1][0] == 'b') {
            gfx_invert_rect(0, 0, GFX_SCREEN_W, GFX_SCREEN_H);
        }
        disp_full_refresh();
        printf("disptest: %s painted, full refresh done\n", argv[1]);
        return 0;
    }
    if (strcmp(argv[1], "swreset") == 0) {
        if (argc != 2) {
            printf("usage: disptest swreset\n");
            return 1;
        }
        disp_fault_inject_swreset();
        printf("disptest: swreset sent (SW reset only, no re-init) -- controller now on "
               "power-on register defaults\n");
        return 0;
    }
    printf("%s", DISPTEST_USAGE);
    return 1;
}

// Owner request: persistent 180-degree display rotation so the pager can be
// read upside down (NVS `disp_flip`, disp.c's disp_get_flip()/
// disp_set_flip()). `flip on`/`off` persists immediately and forces one
// full refresh right away (disp_set_flip() itself does not refresh — see
// its own comment) so the new orientation is visible as a single clean
// frame instead of partials tearing between old and new. `flip status`
// only reads, no refresh. Registered the same way as every other config
// command here (carrier/lockset) — no debug-build gating.
static int cmd_flip(int argc, char **argv)
{
    if (argc == 2 && strcmp(argv[1], "status") == 0) {
        printf("flip: %s\n", disp_get_flip() ? "on" : "off");
        return 0;
    }
    if (argc == 2 && (strcmp(argv[1], "on") == 0 || strcmp(argv[1], "off") == 0)) {
        bool on = strcmp(argv[1], "on") == 0;
        disp_set_flip(on);
        disp_full_refresh(); // power effect: ~2-4s panel refresh, disp_full_refresh()'s own comment
        printf("flip: %s (full refresh done)\n", on ? "on" : "off");
        return 0;
    }
    printf("usage: flip on|off|status\n");
    return 1;
}

static int cmd_airplane(int argc, char **argv)
{
    if (argc == 2 && strcmp(argv[1], "status") == 0) {
        printf("airplane: stored %s, this boot %s\n", net_airplane_stored() ? "on" : "off",
               net_airplane() ? "on" : "off");
        return 0;
    }
    if (argc == 2 && (strcmp(argv[1], "on") == 0 || strcmp(argv[1], "off") == 0)) {
        net_set_airplane(strcmp(argv[1], "on") == 0); // power effect: one NVS write; applies at next boot
        printf("airplane: %s (takes effect at the next boot)\n", net_airplane_stored() ? "on" : "off");
        return 0;
    }
    printf("usage: airplane on|off|status\n");
    return 1;
}

// docs/BATTERY_STATS_DESIGN.md §7: `battstat` prints the live window (seconds) with the dt vs sl+aw check and
// the per-wake awake ms; `battstat reboot` prints it, then hard-resets to prove the RTC_NOINIT window survives.
static int cmd_battstat(int argc, char **argv)
{
    if (argc > 2 || (argc == 2 && strcmp(argv[1], "reboot") != 0)) {
        printf("usage: battstat [reboot]\n");
        return 1;
    }
    char line[320];
    battstat_format(line, sizeof(line));
    printf("%s\n", line);
    if (argc == 2) {
        fflush(stdout);
        watchdog_hard_reset(); // power effect: reboots the ESP32; the modem keeps its state
    }
    return 0;
}

static void start_normal_console(void)
{
    esp_console_repl_t *repl = NULL;
    esp_console_repl_config_t repl_config = ESP_CONSOLE_REPL_CONFIG_DEFAULT();
    repl_config.prompt = "pager>";
    repl_config.task_stack_size = 16384;

#if CONFIG_ESP_CONSOLE_USB_SERIAL_JTAG
    esp_console_dev_usb_serial_jtag_config_t usb_config =
        ESP_CONSOLE_DEV_USB_SERIAL_JTAG_CONFIG_DEFAULT();
    ESP_ERROR_CHECK(esp_console_new_repl_usb_serial_jtag(&usb_config, &repl_config, &repl));
#else // carrier build (sdkconfig.carrier): UART0 -> CP2102N is the primary console
    esp_console_dev_uart_config_t uart_config = ESP_CONSOLE_DEV_UART_CONFIG_DEFAULT();
    ESP_ERROR_CHECK(esp_console_new_repl_uart(&uart_config, &repl_config, &repl));
#endif

    esp_console_register_help_command();

    const esp_console_cmd_t nettest_cmd = {
        .command = "nettest",
        .help = "nettest <host> <port> -- TEMPORARY: plain TCP (no TLS) connectivity probe",
        .hint = NULL,
        .func = &cmd_nettest,
    };
    ESP_ERROR_CHECK(esp_console_cmd_register(&nettest_cmd));

    const esp_console_cmd_t mqtttest_cmd = {
        .command = "mqtttest",
        .help = "mqtttest <host> <port> -- TEMPORARY: modem MQTT-engine TLS connect probe",
        .hint = NULL,
        .func = &cmd_mqtttest,
    };
    ESP_ERROR_CHECK(esp_console_cmd_register(&mqtttest_cmd));

    const esp_console_cmd_t sleeptest_cmd = {
        .command = "sleeptest",
        .help = "sleeptest [<minutes> [yield_ms] [interval_ms] [probe_wait_ms] [wake0_ms]] -- really "
                 "light-sleep for a while (optionally overriding the post-wake yield, the wake "
                 "interval, the probe wait, and pulsing IO46/WAKE0 on every wake), then report "
                 "what arrived; bare `sleeptest` re-prints the last report plus the flightrec "
                 "summary if one is held",
        .hint = NULL,
        .func = &cmd_sleeptest,
    };
    ESP_ERROR_CHECK(esp_console_cmd_register(&sleeptest_cmd));

    const esp_console_cmd_t at_cmd = {
        .command = "at",
        .help = "at <command> -- send one raw AT command; the reply shows in the AT trace",
        .hint = NULL,
        .func = &cmd_at,
    };
    ESP_ERROR_CHECK(esp_console_cmd_register(&at_cmd));

    const esp_console_cmd_t flightrec_cmd = {
        .command = "flightrec",
        .help = "flightrec [clear] -- dump (or reset) the flight recorder's raw UART/wake/probe/"
                 "sleep ring (docs/SLEEP_PAGE_LOSS_BRIEF.md §6 item A)",
        .hint = NULL,
        .func = &cmd_flightrec,
    };
    ESP_ERROR_CHECK(esp_console_cmd_register(&flightrec_cmd));

    const esp_console_cmd_t rts_cmd = {
        .command = "rts",
        .help = "rts <0|1|fc> -- awake RTS/CTS experiment: 0/1 = flow control off, RTS driven low/"
                 "high; fc = flow control restored, CTS sampled for 300 ms",
        .hint = NULL,
        .func = &cmd_rts,
    };
    ESP_ERROR_CHECK(esp_console_cmd_register(&rts_cmd));

    const esp_console_cmd_t wake0_cmd = {
        .command = "wake0",
        .help = "wake0 <0|1|z> -- drive IO46/LTE_WAKE0 low/high, or float it as an input",
        .hint = NULL,
        .func = &cmd_wake0,
    };
    ESP_ERROR_CHECK(esp_console_cmd_register(&wake0_cmd));

    const esp_console_cmd_t cts_cmd = {
        .command = "cts",
        .help = "cts -- print the current CTS (IO47) level",
        .hint = NULL,
        .func = &cmd_cts,
    };
    ESP_ERROR_CHECK(esp_console_cmd_register(&cts_cmd));

    const esp_console_cmd_t attn_cmd = {
        .command = "attn",
        .help = "attn -- print the attentive window's raw state (last_input_age, attentive, "
                 "in_use, locked/lock_set), for bench diagnosis of the attentive edge",
        .hint = NULL,
        .func = &cmd_attn,
    };
    ESP_ERROR_CHECK(esp_console_cmd_register(&attn_cmd));

    const esp_console_cmd_t railcycle_cmd = {
        .command = "railcycle",
        .help = "railcycle [seconds] -- rail_off() (sleep-entry style), wait <seconds> (default "
                 "2), rail_on()+ui_render() (EXT0-wake style), print elapsed ms; bench triage "
                 "for defect 1 (architect hypothesis 8a, back-powered display during rail-off) "
                 "-- use a larger seconds value (e.g. 150) to reproduce a real 2+ minute sleep",
        .hint = NULL,
        .func = &cmd_railcycle,
    };
    ESP_ERROR_CHECK(esp_console_cmd_register(&railcycle_cmd));

    const esp_console_cmd_t gpio_cmd = {
        .command = "gpio",
        .help = "gpio <n> [sample <ms>] -- read a pad level (and poll it) without reconfiguring it",
        .hint = NULL,
        .func = &cmd_gpio,
    };
    ESP_ERROR_CHECK(esp_console_cmd_register(&gpio_cmd));

    const esp_console_cmd_t refresh_cmd = {
        .command = "refresh",
        .help = "refresh [floor N|ceil N|idle S|gap MS|psmin N|status] -- full-refresh policy knobs (persist to NVS)",
        .hint = NULL,
        .func = &cmd_refresh,
    };
    ESP_ERROR_CHECK(esp_console_cmd_register(&refresh_cmd));

    const esp_console_cmd_t padinfo_cmd = {
        .command = "padinfo",
        .help = "padinfo -- dump IO8's IO MUX / RTC IO / hold registers and both level readers",
        .hint = NULL,
        .func = &cmd_padinfo,
    };
    ESP_ERROR_CHECK(esp_console_cmd_register(&padinfo_cmd));
    const esp_console_cmd_t padfix_cmd = {
        .command = "padfix",
        .help = "padfix -- IO8: hold off, digital mux, input+pull-down, then padinfo",
        .hint = NULL,
        .func = &cmd_padfix,
    };
    ESP_ERROR_CHECK(esp_console_cmd_register(&padfix_cmd));

    const esp_console_cmd_t btn_cmd = {
        .command = "btn",
        .help = "btn [long] -- push a simulated IO8 button press (BTN_DOWN + BTN_SHORT, or "
                 "BTN_LONG with `long`) through input.c's real event queue, same path a "
                 "physical press takes downstream; needed to reach scr_lock.c's passcode entry "
                 "from the console",
        .hint = NULL,
        .func = &cmd_btn,
    };
    ESP_ERROR_CHECK(esp_console_cmd_register(&btn_cmd));

    const esp_console_cmd_t lockclear_cmd = {
        .command = "lockclear",
        .help = "lockclear -- bench-only: clear the passcode so a real-sleep render test can "
                 "use an incoming page as the trigger (ui_incoming() never renders while "
                 "locked); restore with `lockset <passcode>` after",
        .hint = NULL,
        .func = &cmd_lockclear,
    };
    ESP_ERROR_CHECK(esp_console_cmd_register(&lockclear_cmd));

    const esp_console_cmd_t lockset_cmd = {
        .command = "lockset",
        .help = "lockset <passcode> -- bench-only: set/restore the passcode",
        .hint = NULL,
        .func = &cmd_lockset,
    };
    ESP_ERROR_CHECK(esp_console_cmd_register(&lockset_cmd));

    const esp_console_cmd_t railsettle_cmd = {
        .command = "railsettle",
        .help = "railsettle [ms] -- read or set rail.c's universal post-rail-on settle delay "
                 "(round 9 bench sweep: 15/20/30/50ms)",
        .hint = NULL,
        .func = &cmd_railsettle,
    };
    ESP_ERROR_CHECK(esp_console_cmd_register(&railsettle_cmd));

    const esp_console_cmd_t dispbusytrace_cmd = {
        .command = "dispbusytrace",
        .help = "dispbusytrace -- arm a one-shot ~200ms BUSY transition trace for the next "
                 "power-loss recovery (round 9)",
        .hint = NULL,
        .func = &cmd_dispbusytrace,
    };
    ESP_ERROR_CHECK(esp_console_cmd_register(&dispbusytrace_cmd));

    const esp_console_cmd_t kbtime_cmd = {
        .command = "kbtime",
        .help = "kbtime [cycles] -- measure how long after rail-on the CardKB first ACKs on "
                 "I2C, averaged over `cycles` (default 5) off/on cycles (round 9)",
        .hint = NULL,
        .func = &cmd_kbtime,
    };
    ESP_ERROR_CHECK(esp_console_cmd_register(&kbtime_cmd));

    register_carrier_cmd();
    register_input_cmds();
    register_peripheral_cmds();

    const esp_console_cmd_t gnsstest_cmd = {
        .command = "gnsstest",
        .help = "gnsstest <seconds> -- one location-fix attempt, bypassing backoff/battery floor",
        .hint = NULL,
        .func = &cmd_gnsstest,
    };
    ESP_ERROR_CHECK(esp_console_cmd_register(&gnsstest_cmd));

    const esp_console_cmd_t loctrack_cmd = {
        .command = "loctrack",
        .help = "loctrack [on|off] -- A/B switch for the background location tracker "
                "(docs/LOCATION_TRACKING_DESIGN.md); bare form prints the current setting",
        .hint = NULL,
        .func = &cmd_loctrack,
    };
    ESP_ERROR_CHECK(esp_console_cmd_register(&loctrack_cmd));

    const esp_console_cmd_t gnss_cmd = {
        .command = "gnss",
        .help = "gnss [on|off] -- persist the cfg.loc.gnss flag (docs/GNSS_DISABLE_DESIGN.md); "
                "bare form prints it",
        .hint = NULL,
        .func = &cmd_gnss,
    };
    ESP_ERROR_CHECK(esp_console_cmd_register(&gnss_cmd));

    const esp_console_cmd_t locmove_cmd = {
        .command = "locmove",
        .help = "locmove [<seconds>] -- GNSS-while-moving interval, 0 = off; bare form prints the "
                "current value",
        .hint = NULL,
        .func = &cmd_locmove,
    };
    ESP_ERROR_CHECK(esp_console_cmd_register(&locmove_cmd));

    const esp_console_cmd_t coverage_cmd = {
        .command = "coverage",
        .help = "coverage -- print the coverage duty-cycle policy's state (registered/dark-for/"
                "phase/step/next-action)",
        .hint = NULL,
        .func = &cmd_coverage,
    };
    ESP_ERROR_CHECK(esp_console_cmd_register(&coverage_cmd));

    const esp_console_cmd_t cafetch_cmd = {
        .command = "cafetch",
        .help = "cafetch <url> <sha256hex> -- fetch-only CA-over-HTTPS probe (V02_DESIGN.md §4.4), no apply",
        .hint = NULL,
        .func = &cmd_cafetch,
    };
    ESP_ERROR_CHECK(esp_console_cmd_register(&cafetch_cmd));

    const esp_console_cmd_t otafetch_cmd = {
        .command = "otafetch",
        .help = "otafetch <url> <size> -- stream an OTA object into a hash+count sink (no flash writes): "
                "bytes, B/s, short reads, resumes, sha16 (OTA_DESIGN.md section 7.2)",
        .hint = NULL,
        .func = &cmd_otafetch,
    };
    ESP_ERROR_CHECK(esp_console_cmd_register(&otafetch_cmd));

    const esp_console_cmd_t smstest_cmd = {
        .command = "smstest",
        .help = "smstest <number> <text> -- send one SMS bypassing the allow-list (V02_DESIGN.md §6)",
        .hint = NULL,
        .func = &cmd_smstest,
    };
    ESP_ERROR_CHECK(esp_console_cmd_register(&smstest_cmd));

    const esp_console_cmd_t smslist_cmd = {
        .command = "smslist",
        .help = "smslist -- print the SMS allow-list and audit queue depth",
        .hint = NULL,
        .func = &cmd_smslist,
    };
    ESP_ERROR_CHECK(esp_console_cmd_register(&smslist_cmd));

    const esp_console_cmd_t acceltest_cmd = {
        .command = "acceltest",
        .help = "acceltest [samples <n>|ths|dur|ths2|dur2 <0-127>|shake on|off|<n> <gap> <span> <holdoff_s>|cfg <c1> <c4>|refr <seconds>] -- LIS3DH "
                 "register/sample dump and runtime tuning (docs/DEVICE_NEXT_TASKS.md A2); run "
                 "`acceltest` with no args for the full usage",
        .hint = NULL,
        .func = &cmd_acceltest,
    };
    ESP_ERROR_CHECK(esp_console_cmd_register(&acceltest_cmd));

    const esp_console_cmd_t disptest_cmd = {
        .command = "disptest",
        .help = "disptest [info|again <0|1>|lut [0|1]|bars|step <n>|seq [n0] [n1] [ms]|full|"
                 "swreset] -- "
                 "deterministic e-paper partial-refresh bench harness (docs task-disp-fix.md); "
                 "run `disptest` with no args for the full usage. NOTE: do not use `wake` or "
                 "`key` while this is running -- the UI render task would repaint over the test "
                 "pattern.",
        .hint = NULL,
        .func = &cmd_disptest,
    };
    ESP_ERROR_CHECK(esp_console_cmd_register(&disptest_cmd));

    const esp_console_cmd_t flip_cmd = {
        .command = "flip",
        .help = "flip on|off|status -- persist and apply a 180-degree display rotation (NVS "
                 "disp_flip) so the pager can be read upside down; `on`/`off` force one full "
                 "refresh immediately",
        .hint = NULL,
        .func = &cmd_flip,
    };
    ESP_ERROR_CHECK(esp_console_cmd_register(&flip_cmd));
    const esp_console_cmd_t airplane_cmd = {
        .command = "airplane",
        .help = "airplane on|off|status -- NVS net/airplane: hold the modem in reset and skip all "
                "network bring-up; takes effect at the next boot",
        .hint = NULL,
        .func = &cmd_airplane,
    };
    ESP_ERROR_CHECK(esp_console_cmd_register(&airplane_cmd));
    const esp_console_cmd_t battstat_cmd = {
        .command = "battstat",
        .help = "battstat [reboot] -- live battery-stats window (BATTERY_STATS_DESIGN.md): dt vs sl+aw and "
                "per-wake awake ms; `reboot` hard-resets afterwards to check the window survives",
        .hint = NULL,
        .func = &cmd_battstat,
    };
    ESP_ERROR_CHECK(esp_console_cmd_register(&battstat_cmd));
    const esp_console_cmd_t fuel_cmd = {
        .command = "fuel",
        .help = "fuel [quick|shutdown] -- carrier gauge: mV, percent, crate, charger state, raw IO levels; "
                "`quick` = MAX17048 quick-start; `shutdown` runs the low-battery Shutdown on purpose",
        .hint = NULL,
        .func = &cmd_fuel,
    };
    ESP_ERROR_CHECK(esp_console_cmd_register(&fuel_cmd));

    ESP_ERROR_CHECK(esp_console_start_repl(repl));
    ESP_LOGD(TAG, "debug console REPL started in normal mode (PAGER_DEBUG_NO_LIGHT_SLEEP)");
}
#endif

void app_main(void)
{
    ESP_LOGI(TAG, "school_pager boot");
#ifdef PAGER_OTA_TEST_ABORT
    // Bench-only rollback test image: panic before anything could mark this slot valid.
    ESP_LOGE(TAG, "PAGER_OTA_TEST_ABORT build: aborting on purpose so the bootloader rolls back");
    vTaskDelay(pdMS_TO_TICKS(300));
    abort();
#endif

    // TASK_ui_round2.md Do #7: local time for every on-glass HH:MM (status
    // clock, Home/Chat rows) — hardcoded per owner 25 Sep 2026; a cfg field
    // later. Set once, here, before anything below can call localtime_r()
    // (ui.c's ui_format_hhmm()/compute_status_clock_text()): tzset() only
    // needs to have run once by the time any localtime_r() call happens, not
    // specifically "after the network seeds the clock" — the network clock
    // itself (net.cpp's configure_session()) is just an epoch value with no
    // TZ concept of its own, so setting this once, early, at boot already
    // covers every render both before and after that seed arrives, without
    // a second call site inside net.cpp. No modem or sleep-state effect: an
    // env var + a libc timezone-table load.
    setenv("TZ", "PST8PDT,M3.2.0,M11.1.0", 1);
    tzset();

    watchdog_boot(); // logs why we reset and where the loop was; arms the RTC watchdog

    // docs/SLEEP_PAGE_LOSS_BRIEF.md §6 item A: installs the library's UART
    // trace hook (PATCHES.md 1.17) before any path below can reach
    // WalterModem::begin() (net_check_sim() in the IDENT-missing branch
    // just below, or modes_boot() otherwise) -- the hook itself is inert
    // (every flightrec_* call is a no-op) until a `sleeptest` window arms
    // recording, so this is safe this early. No modem/sleep-state effect:
    // one PSRAM allocation and one function-pointer store. No-op stub
    // outside a debug build.
    flightrec_init();

    // Owner request, beta feedback 2026-09-23: flag a crash/watchdog/brownout
    // reset in the status bar until the first key press (ui.c's
    // GFX_ICON_CRASH slot) -- set here, before ui_init() even runs, since the
    // flag only gates a render-time icon, not any ui.c init ordering. No
    // modem or sleep-state effect.
    if (watchdog_last_reset_was_crash()) {
        ESP_LOGI(TAG, "boot crash indicator: %s", watchdog_last_reset_reason_str());
        ui_set_crash_indicator(true);
    }

    // NVS init only; no modem/radio access, no power effect beyond the
    // flash read/erase-and-retry below (DEVICE_PLAN.md §3.4/§2.7). Moved ahead of
    // rail_init() (6 Nov 2026) because board_init() reads the board kind from NVS.
    esp_err_t nvs_err = nvs_flash_init();
    if (nvs_err == ESP_ERR_NVS_NO_FREE_PAGES || nvs_err == ESP_ERR_NVS_NEW_VERSION_FOUND) {
        ESP_ERROR_CHECK(nvs_flash_erase());
        nvs_err = nvs_flash_init();
    }
    ESP_ERROR_CHECK(nvs_err);

    // Decides breadboard vs carrier (board.h) before anything touches IO12/IO38/IO42.
    // Power effect: one I2C read on the always-on bus, at most one NVS write.
    board_init();
    fuel_init(); // carrier only: release the IO15 ext1 hold, charger pins as inputs, log MAX17048 VERSION

    rail_init(); // 3V3 peripheral rail on -- must precede any display/I2C use; rail.h

    if (!ident_load()) {
        // No valid identity in NVS: docs/DEVICE_TASKS.md F3.5, Setup mode.
        // Reuses scr_greeting.c (the same "Hi ...!" banner shown post-setup)
        // as a generic pre-provisioning splash, with a status footer that
        // walks booting -> sim missing/found -> shutting down -- added at
        // the user's request so a device sitting on a shelf with no SIM
        // fitted yet shows *something* legible instead of the noise-pattern
        // blank shadow plane a never-painted panel shows.
        //
        // The SIM check runs unconditionally, once, every boot (not gated
        // behind a console command) -- the user's explicit choice over
        // waiting for a person to notice and type something first. It is a
        // single net_check_sim() call, never retried: also the user's
        // explicit choice over a periodic recheck loop, since nothing about
        // a missing SIM changes without a person physically opening the
        // device, and this design never deep sleeps (§8.3) to wake back up
        // for one anyway.
        //
        // start_setup_console() still always runs afterward regardless of
        // the SIM result: `setup <code>` is the one and only way this device
        // ever leaves this branch (a fresh net_bootstrap_attach() inside
        // setup_run() will simply fail its own way if the SIM is genuinely
        // absent), and typing it requires nothing this check could have
        // broken.
        ESP_LOGI(TAG, "IDENT missing; starting Setup mode console");

        bool ui_ok = ui_init();
        if (ui_ok) {
            scr_greeting_set_mode(GREETING_HELLO);
            scr_greeting_set_status("booting");
            ui_push(&g_scr_greeting);
            ui_render_boot();
        }
        modes_fuel_boot_check(); // carrier: low unplugged battery goes to Shutdown; the modem is not started yet

        bool sim_ok = net_check_sim();
        ESP_LOGI(TAG, "SIM check: %s", sim_ok ? "found" : "missing");
        if (ui_ok) {
            scr_greeting_set_status(sim_ok ? "type: setup <code>" : "sim missing");
            ui_render();
        }

        if (!sim_ok) {
            // Best-effort pause so "sim missing" is actually readable before
            // the panel moves on -- not a retry wait, just legibility.
            vTaskDelay(pdMS_TO_TICKS(4000));
            if (ui_ok) {
                scr_greeting_set_status("shutting down");
                ui_render();
            }
        }

        // net_check_sim() leaves the modem parked at NO_RF (no RRC, no
        // teardown call) rather than touching it further here -- harmless,
        // since net_bootstrap_attach() (setup_run(), setup.c) unconditionally
        // re-issues setOpState(NO_RF) then setOpState(FULL) itself on the
        // way to a real attach, regardless of the opstate it finds. Power
        // effect from here: current stays at the CPU-idle-loop floor (plus
        // the modem's own NO_RF floor) until a person types `setup <code>`.
        start_setup_console();
        for (;;) {
            vTaskDelay(pdMS_TO_TICKS(1000));
        }
    }
    ESP_LOGI(TAG, "IDENT %s sig=%d claimed=%d", ident_get_dev_id(),
             (ident_get_flags() & IDENT_FLAG_REQ_SIG) ? 1 : 0, ident_get_claimed() ? 1 : 0);

#ifdef PAGER_DEBUG_NO_LIGHT_SLEEP
    // v0.2 §2.7: see start_normal_console()'s own comment. Started before
    // modes_boot()/modes_run() (which never returns) so the console task
    // exists for the rest of the device's life; esp_console_start_repl()
    // does not block here.
    start_normal_console();
    esp_log_level_set("ui", ESP_LOG_DEBUG); // 4 Oct 2026: raw CardKB bytes (ui.c's ESP_LOGD "CardKB: 0x..") for the wrong-character report
#endif

    // modes_boot() decides cold-boot vs. reset-recovery internally by
    // validating the RTC struct (PROTOCOL.md §9); it is the only wake-cause
    // dispatch that happens at app_main() entry, because this design never
    // deep sleeps (§8.3) - a light-sleep wake never re-runs app_main() at
    // all, it just resumes inside modes_run()'s loop.
    modes_boot();
    modes_run(); // never returns
}
