awong-dev/pager/firmware/main/modes.c

// modes.c — mode state machine, RTC memory contract, wake-and-drain loop,
// button/key event dispatch.
//
// Authority: docs/PROTOCOL.md §4.1 (ack rules), §5.4 (status cadence), §8
// (wake sources), §9 (RTC memory), §11 (mode funnel).
//
// modes.c is the only place that touches the RTC struct and the only place
// that changes `mode` (funnelled through set_mode(), per §11). It drains
// input.c's event queue and wires msg.c/ui.c together; input.c itself owns
// the button GPIO/FSM and the CardKB key decode table (F6.2,
// docs/DEVICE_PLAN.md §5.3).
//
// All power-effect comments are PENDING_HW.

#include "modes.h"
#include "msg.h"
#include "net.h"
#include "watchdog.h"
#include "ui.h"
#include "disp.h" // S12: disp_busy_timeout_count() for the sleeptest report; rail gate: disp_note_power_loss()
#include "flightrec.h" // docs/SLEEP_PAGE_LOSS_BRIEF.md §6 item A; no-op outside a debug build's sleeptest window
#include "board.h"
#include "pins.h" // PAGER_PIN_WAKE0, the sleeptest wake0_ms experiment (§6 item F)
#include "battstat.h" // docs/BATTERY_STATS_DESIGN.md: time-in-state counters, /status key 68 `bs`
#include "refreshpol.h"
#include "gfx.h"
#include <time.h>
#include "buzzer.h"
#include "haptic.h"
#include "frontlight.h"
#include "extled.h"
#include "rail.h" // docs/ROADMAP.md rail gate (owner, 24 Sep 10:30 pm PDT): rail_on()/rail_off()

// F6.2 (docs/DEVICE_PLAN.md §5.3): CardKB decode + button FSM (+BTN_STUCK)
// + the UI-awake window + one input event queue, moved out of this file
// and ui.c respectively. ime.h is included (but not yet called from
// anywhere - see its own module comment) purely so idf.py build actually
// compiles the header; F6.3 wires the first real text field to it.
#include "input.h"
#include "ime.h"

// F3.6 (docs/PROTOCOL.md §14, §10 keymap; docs/DEVICE_PLAN.md §2.5/§2.7):
// signing, the CBOR /status codec, and the auth_rtc_t sub-struct embedded
// below.
#include "auth.h"
#include "cbor.h"
#include "ident.h"

// F6.5 (docs/DEVICE_PLAN.md §5.8): the passcode lock — RTC fields and the
// restart->locked and defer-shown-while-locked wiring below. Its `cfg.lock`
// sub-map handler is now reached through cfg.c's dispatcher (below), not
// called directly from this file (v0.2 §4.4: a single `cfg` push can also
// carry `ca`, cfg.c is what decodes the envelope once and hands each
// sub-map to its own owner).
#include "lock.h"

// v0.2 §4.4 (docs/V02_DESIGN.md, docs/V02_DESIGN.md §4): the `cfg` envelope
// dispatcher (cfg.c) and CA trust state/fallback/two-phase-apply (catrust.c)
// — the `cfg` interception ahead of msg_ingest_down_cbor() (same slot the
// old direct lock_ingest_cfg_cbor() call used to occupy), the `/status`
// `tls`/`ca_fp` fields below, and catrust_service() driven from this file's
// own wake-and-drain loop, alongside loc_service()/accel_poll().
#include "cfg.h"
#include "catrust.h"

// F7.1 (docs/DEVICE_PLAN.md §4.3): book.c's NVS-backed address book — the
// `kind:"book"` dispatch ahead of msg_ingest_down_cbor() (alongside lock.c's
// `cfg` dispatch, same interception pattern), and the real `bv` for
// build_status_cbor() below. book.c has no RTC sub-struct of its own (see
// book.h's module comment) — it only needs the EXISTING g_rtc.auth binding,
// wired via book_bind() in modes_boot().
#include "archive.h"
#include "book.h"
#include "ota.h"       // docs/OTA_DESIGN.md: cfg.ota job, status fields, ota_service() below
#include "cafetch.h"   // cafetch_in_progress() for the OTA start gate
#include "bookpull.h" // v0.4 §3.7: bookpull_bind()/bookpull_service() below, alongside catrust's own

// v0.2 §5 (docs/V02_DESIGN.md, docs/PROTOCOL.md §3.2/§13): loc.c's
// `kind:"loc_req"` dispatch ahead of msg_ingest_down_cbor() (same
// interception slot as lock.c/book.c above), its own tiny RTC-resident route
// hint (loc_rtc_t, embedded below), and its `/status` fields
// (loc_min_s/loc_period_s/loc_backoff_s). accel.c's LIS3DH poll is driven
// from modes_run()'s loop alongside input_poll() (the CardKB is read by ui.c's kbd task).
#include "accel.h"
#include "loc.h"

// Owner request, 2026-09-20: coverage.c's own duty-cycle policy (pure,
// host-tested, see coverage.h's own module comment) — this file is the only
// caller of net_radio_off()/net_radio_on()/net_session_down() on its behalf,
// same "policy decides, modes.c/net.c act" split loc.c's route 2 established.
#include "coverage.h"

// v0.2 §6 (docs/V02_DESIGN.md, docs/PROTOCOL.md §3.6): sms.c's device-direct
// SMS allow-list/audit/send-receive state machine, driven from this file's
// own wake-and-drain loop (sms_service(), alongside loc_service()/
// accel_poll()/catrust_service() above) and from cfg.c's `cfg.sms`
// dispatch. No RTC sub-struct of its own (allow-list + audit queue both
// live in NVS, per this task's own "prefer NVS/RAM" instruction) — sms_bind()
// only hands over the shared cross-task mutex, same two-argument pattern
// catrust_bind() uses.
#include "sms.h"

#include <assert.h>
#include <stdbool.h>
#include <stddef.h>
#include <stdint.h>
#include <stdarg.h>
#include <stdio.h>
#include <string.h>

#include "driver/gpio.h" // PAGER_DEBUG_NO_LIGHT_SLEEP's sleeptest wake0_ms experiment (§6 item F) only
#include "esp_attr.h"
#include "esp_app_desc.h" // esp_app_get_description(): the `fw` status field
#include "esp_log.h"
#include "esp_random.h"
#include "esp_rom_crc.h"
#include "esp_sleep.h"
#include "esp_system.h"
#include "nvs.h"
#include "esp_private/esp_clk.h" /* esp_clk_rtc_time() */
#include "esp_timer.h"
#include "freertos/FreeRTOS.h"
#include "freertos/semphr.h"
#include "freertos/task.h"
#include "fuel.h"       // carrier fuel gauge + charger pins (docs/CARRIER_V02_FIRMWARE_DESIGN.md §4)
#include "driver/rtc_io.h" // rtc_gpio_hold_dis(): IO15 ext1 wake pad of modes_power_off()

static const char *TAG = "modes";

// ---------------------------------------------------------------------------
// Compile-time constants. PAGER_WAKE_INTERVAL_* / PAGER_ACTIVE_IDLE_TIMEOUT_S
// are deliberately named to match PROTOCOL.md §8.2 so they can be retuned
// against a real current trace without touching logic.
// ---------------------------------------------------------------------------

// 24 Sep 2026 (docs/SLEEP_URC_DESIGN.md §10, bench phaseAO): the modem
// releases a held page URC only when it accepts a host command, and it does
// not accept one inside a 200 ms window after RTS is re-asserted. The one
// configuration that delivered both mid-window pages with no session loss
// was a 20 s cadence with the post-wake probe held open until answered
// (wait_for_probe_answer(), armed at intervals >= PAGER_PROBE_WAIT_MIN_INTERVAL_MS).
// Both modes use an interval that arms it. Typical delivery ~26-47 s;
// measured asleep 83% (SLEEP), estimated ~190 mAh/day at a 3 s modem answer.
// PROTOCOL.md §8.2's T=5 s / T=2 s are superseded by this until a cheaper
// wake (WAKE0/IO46, or RTS asserted through sleep) is proven.
#define PAGER_WAKE_INTERVAL_SLEEP_MS 20000u  // T=20s sleep mode (was 5 s)
#define PAGER_WAKE_INTERVAL_ACTIVE_MS 20000u // T=20s active mode too: the only configuration that delivered both pages (phaseAV); 10 s lost a page on the release (phaseAW)
// pump_blocked no longer keys on ui_awake/btn_busy/btn_stuck (see its doc
// comment above), so msg_pump() now runs on every loop iteration once
// connected, not just once per wake-and-drain cycle. On the 2s/5s wake
// cadence this limit never binds; on the 100ms UI-awake busy-poll cadence
// it caps the pump rate at 5 Hz instead of one AT transaction per 100ms.
#define PAGER_PUMP_MIN_INTERVAL_US (200 * 1000)
// Owner request, 2026-09-20: nothing to receive while unregistered (no MQTT
// session at all) -- sleep mode's own wake interval can lengthen well past
// the registered T=5s without costing any latency that matters, since there
// is nothing to poll for. Still keeps the button (ext1) wake via net_sleep()
// unchanged. UNVERIFIED exact current saving (see coverage.h's own estimate
// block); 30s is a conservative middle ground, not a measured optimum.
#define PAGER_WAKE_INTERVAL_UNREGISTERED_MS 30000u
// docs/ROADMAP.md "24 Sep evening finding" / rail hold task: the 20 s wake
// cadence above is tuned for URC delivery, not for a person typing right
// now. Once the rail hold (main.c board_power_init()) keeps the keyboard
// powered through sleep, a key/button event or an ext1 wake starts a
// PAGER_ATTENTIVE_S window in which the wake interval is shortened to this
// instead, so the next keypress is picked up promptly rather than after up
// to 20 s. 1000 ms is well below PAGER_PROBE_WAIT_MIN_INTERVAL_MS (10000 ms),
// so it does NOT arm wait_for_probe_answer()'s wait -- the probe stays
// fire-and-forget, only the fixed PAGER_POST_WAKE_YIELD_MS awake per
// attentive wake, which is the point (§10's wait is for amortising a long
// cadence; a short one has nothing to amortise). Power effect: up to
// PAGER_ATTENTIVE_S / (PAGER_WAKE_INTERVAL_ATTENTIVE_MS / 1000) wakes per
// window at the normal per-wake awake cost, instead of one -- a real but
// bounded and input-gated increase, same shape as the UI-awake busy-poll
// cadence already costs.
#define PAGER_WAKE_INTERVAL_ATTENTIVE_MS 1000u
// How long the attentive cadence stays armed after the last input.
#define PAGER_ATTENTIVE_S 120
// How long the pager stays awake, with RTS asserted, after each timer wake.
// Measured on hardware 2026-09-21 (`sleeptest`, GM02SP LR8.2.1.0): while RTS is
// deasserted the modem HOLDS its URCs (nothing is lost), but with 50 ms awake
// it never hands them over: pages sent to a sleeping pager were not received
// at all, across a whole boot. With 150 ms they were delivered during real
// light sleep (35 s and 136 s after sending, against a 20.48 s eDRX cycle, so
// 150 is probably marginal). 200 ms until it has been bisected and the long
// tail explained. Power effect: 200 ms per 5 s wake = 4% awake, against the
// 1% the design assumed; this is now the dominant term of the sleep budget.
// UNVERIFIED: the minimum, and whether an AT poke right after the wake would
// let it be shorter (docs/ROADMAP.md).
#define PAGER_POST_WAKE_YIELD_MS 200u
// UI-first fix (25 Sep, "10s from tap to `password:`"): an EXT1 wake IS
// real user input (input_note_button_wake() above already seeds the button
// FSM with it), and input.c's arm_awake_window() (called from the same wake
// path, modes_run()'s `input_note_button_wake()` call above and input_poll()'s own
// resolution below) arms a PAGER_UI_AWAKE_S (119 s, input.c) window in which
// every subsequent loop iteration has ui_awake==true, so skip_sleep is true
// and the loop never calls net_sleep() again for that whole window --
// RTS/hardware flow control stays asserted (net.cpp's net_sleep() is the only
// place that forces RTS high) for far longer than PAGER_PROBE_WAIT_MS (15 s)
// ever would. Whatever this wake's net_urc_probe() (just above) is waiting
// on gets all the time it needs from that ordinary busy-poll cadence, not
// from wait_for_probe_answer()'s dedicated wait -- so skipping the wait (and
// cutting the yield) on an input wake loses no URC-delivery guarantee, it
// only stops blocking the render behind a wait that was never necessary in
// the first place. L4/F7's >=30ms floor below is still respected. Power
// effect: an EXT1 wake stays awake ~40 ms here instead of up to
// PAGER_POST_WAKE_YIELD_MS + PAGER_PROBE_WAIT_MS (~15.2 s) before it does
// anything else -- more current for those 40 ms (no change, this iteration
// was already fully awake), far less current summed over the old wait, which
// is gone entirely on this path.
#define PAGER_INPUT_WAKE_YIELD_MS 40u
// S18 (docs/SLEEP_URC_DESIGN.md §10). The yield above is a fixed guess; this
// is the bound on the *conditional* extra awake time that keeps RTS asserted
// until the drain probe has actually been answered. The modem only releases a
// held URC once it accepts a command, and (phaseAD/phaseAK) it does not
// accept one within 200 ms of the host re-asserting RTS, so a 200 ms window
// delivers nothing: 95% asleep and zero pages. Waiting for the answer costs
// real current -- see the duty table in §10 -- which is why it is bounded and
// why it is only armed on a lengthened wake cadence.
#define PAGER_PROBE_WAIT_MS 15000u
// Armed only when this wake's interval is at least this long. At the 5 s
// SLEEP / 2 s ACTIVE cadence a 4 s wait would be a 44-67% duty cycle, which
// is not a power budget, it is a wall socket; the wait only makes sense
// paired with a cadence long enough to amortise it (§10's table recommends
// 20 s). Keying on interval_ms rather than on g_rtc.mode is deliberate: it
// means `sleeptest <min> 0 20000` exercises the wait in BOTH modes, so the
// second page of a window -- which lands after the first has already forced
// ACTIVE mode for 10 minutes -- is measured under the same policy as the
// first. With the shipped 5000/2000 constants this gate is closed and the
// release image behaves exactly as it does today.
#define PAGER_PROBE_WAIT_MIN_INTERVAL_MS 10000u
// S18's own accounting (see wait_for_probe_answer() below). Declared here so
// modes_debug_sleeptest_start() can clear them; counted in release builds too,
// since the wait itself is release behaviour once the cadence is lengthened.
#ifdef PAGER_DEBUG_NO_LIGHT_SLEEP
static uint32_t s_probe_wait_ms_override = 0; // sleeptest arg 4, 0 = build default
// docs/SLEEP_PAGE_LOSS_BRIEF.md §6 item F: sleeptest arg 5, 0 = pin
// untouched (today's behaviour). GPIO_NUM_46/PAGER_PIN_WAKE0 is configured
// as an output the first time this is non-zero and stays that way for the
// rest of the boot (main.c's `wake0` command may also reconfigure it --
// see that command's own comment).
static uint32_t s_st_wake0_ms = 0;
static bool s_wake0_configured = false;
#endif
static uint32_t s_probe_wait_n = 0, s_probe_wait_giveups = 0;
static int64_t s_probe_wait_total_us = 0, s_probe_wait_max_us = 0;
#define PAGER_ACTIVE_IDLE_TIMEOUT_S (10 * 60) // 10 min, firmware/README.md
#define PAGER_STATUS_HEARTBEAT_S 3600u         // §5.4(d)
#define PAGER_CHECKCOMM_EVERY_N_WAKES 60u      // F4: ~5 min at T=5s
#define PAGER_MODEM_RESET_MIN_INTERVAL_US ((int64_t) 10 * 60 * 1000000) // F4 rate limit
// docs/OTA_DESIGN.md section 5: `fw` is the app descriptor's version string (the project version /
// git describe baked in by the build), truncated to 16 characters. Filled once, on first use.
static const char *fw_version_str(void)
{
    static char s_fw[17];
    if (s_fw[0] == '\0') {
        const esp_app_desc_t *d = esp_app_get_description();
        strncpy(s_fw, d ? d->version : "?", sizeof(s_fw) - 1);
        s_fw[sizeof(s_fw) - 1] = '\0';
        if (s_fw[0] == '\0') {
            s_fw[0] = '?';
        }
    }
    return s_fw;
}

// F6.2: the button FSM itself (short/long/BTN_STUCK, debounce, long-press
// threshold) moved to input.c; this is only the outer loop's own polling
// granularity while input_button_busy() is true (needs to be frequent
// enough for input.c's debounce/hold-duration timing to resolve well - see
// input.c's PAGER_BTN_DEBOUNCE_MS/PAGER_BTN_LONG_PRESS_MS).
#define PAGER_BTN_POLL_MS 20u

// F1/F3 backoff schedule: 5s, 15s, 60s, 300s, then steady at 300s.
static const uint32_t k_backoff_s[] = { 5, 15, 60, 300 };
#define PAGER_BACKOFF_STEPS (sizeof(k_backoff_s) / sizeof(k_backoff_s[0]))

// ---------------------------------------------------------------------------
// RTC memory contract (PROTOCOL.md §9). The dedup/ack/
// reply/unread state lives in msg_rtc_t (msg.h), embedded here as a
// nested `msg` field; modes.c remains the sole owner of the enclosing
// struct, its magic/crc32 pair and rtc_save() (§9.3), and hands msg.c a
// typed pointer plus lock/unlock/save callbacks via msg_bind_rtc().
//
// The measured 7003-byte walter-modem RTC footprint (see
// sdkconfig.defaults) leaves only ~1184 of the 8192-byte RTC_SLOW region
// for this struct, far short of what storing full message bodies here would
// need. §9.3 resolves that by keeping full bodies out of RTC entirely (they
// live in msg.c's RAM-resident s_thread, §9.5) and only mirroring the
// single newest-unread message plus small id-only queues in RTC.
// ---------------------------------------------------------------------------

#define PAGER_ID_MAX_LEN 17 // 16 chars + NUL, PROTOCOL.md §1/§3.1

// magic encodes both validity and a layout version tag (per CLAUDE.md's RTC
// convention: "a version tag and a CRC"). Bump it on any layout change: a
// stale-but-CRC-valid struct read across an incompatible change would
// otherwise decode as garbage.
// F3.6: bumped 2 -> 3 for the new `auth` (auth_rtc_t, +12 B) field below,
// docs/DEVICE_PLAN.md §2.7's "RTC changes".
// F6.4: bumped 3 -> 4 — msg_rtc_t's pending_up/unread sub-structs dropped
// their inline bodies (moved to NVS namespace `msgq`, docs/PROTOCOL.md
// §9.2-§9.4) and pending_up/unread gained/lost fields; a stale layout-3
// struct would otherwise decode msg_pending_up_t.to as garbage bytes that
// used to be the middle of a body.
// F6.5: bumped 4 -> 5 — new `lock` field (lock_rtc_t, +16 B, docs/PROTOCOL.md
// §9.3's table row); a stale layout-4 struct has no such field at all, so
// reading it unversioned would decode 16 bytes of whatever used to be past
// the end of the old struct as `locked`/`fail_count`/`backoff_until_us`.
// v0.2 §5: bumped 5 -> 6 — new `loc` field (loc_rtc_t, +8 B, PROTOCOL.md
// §9.3's table row): the single route-to-the-radio byte loc.c remembers
// (V02_DESIGN.md §5). Everything else location-related is deliberately
// RAM-only (loc.h's own module comment), so this is the whole addition.
// Beta feedback, 2026-09-23: bumped 6 -> 7 — lock_rtc_t shrank 16 -> 8 B
// (`fail_count`/`backoff_until_us` dropped along with the wrong-passcode
// retry lockout, docs/DEVICE_PLAN.md §5.8/lock.h's own comment); a stale
// layout-6 struct would decode 8 bytes of whatever now follows `lock` in
// memory as its old `fail_count`/`backoff_until_us`.
#define PAGER_RTC_MAGIC 0x50475237u // "PGR" + layout version 7

typedef enum {
    PAGER_MODE_SLEEP = 0,
    PAGER_MODE_ACTIVE = 1,
} pager_mode_t;

typedef enum {
    MODE_REASON_BOOT = 0,
    MODE_REASON_BUTTON,
    MODE_REASON_INCOMING_MSG,
    MODE_REASON_IDLE_TIMEOUT,
} pager_mode_reason_t;

typedef struct {
    uint32_t magic;
    uint32_t crc32;

    uint32_t boot_count;
    char session_id[12]; // "s_" + 8 hex + NUL, PROTOCOL.md §1

    uint8_t mode; // pager_mode_t
    // This is a MONOTONIC deadline (esp_timer_get_time()
    // microseconds), not wall-clock epoch seconds. Comparing against
    // approx_epoch() would not work: it reads 0 until the network
    // clock arrives (§3.5) — combined with the "!=0" guard on the exit
    // check, that meant a device with no clock yet never left active mode
    // (stuck at 7-17mA instead of 1.8-2.1mA), and then the window could
    // slam shut instantly once epoch time first became available and
    // happened to already exceed the stale deadline computed against 0.
    // A monotonic clock has no "not available yet" state, so this class of
    // bug cannot recur here.
    int64_t active_until_us;

    uint32_t status_pub_count;
    int64_t last_status_epoch;

    msg_rtc_t msg; // PROTOCOL.md §9.3 — owned in layout by modes.c, in
                    // behaviour by msg.c via msg_bind_rtc().

    uint32_t mqtt_memfull_count; // §8.4 M6, cumulative
    uint32_t oversize_drop_count; // F6, cumulative

    uint32_t modem_resets;         // F4, cumulative
    int64_t last_modem_reset_us;   // esp_timer_get_time() at last reset, for the 10min rate limit

    uint32_t attach_fail_cycles; // F1
    uint32_t wake_cycle_count;   // drives the "every 60 wakes" F4 check

    auth_rtc_t auth; // PROTOCOL.md §14.2/§9.3, DEVICE_PLAN.md §2.5/§2.7 —
                      // owned in layout by modes.c, in behaviour by auth.c
                      // via the pointer msg_bind_auth() hands msg.c and the
                      // direct &g_rtc.auth uses in this file's own /status
                      // publish path below.

    lock_rtc_t lock; // PROTOCOL.md §9.3, DEVICE_PLAN.md §5.8 — owned in
                      // layout by modes.c, in behaviour by lock.c via the
                      // pointer lock_bind_rtc() hands it in modes_boot().

    loc_rtc_t loc; // v0.2 §5 (docs/V02_DESIGN.md, PROTOCOL.md §9.3) — owned
                    // in layout by modes.c, in behaviour by loc.c via the
                    // pointer loc_bind() hands it in modes_boot().
} pager_rtc_t;

// F6.5: sizeof(pager_rtc_t) was 512 bytes (see firmware/build/school_pager.map's
// `.rtc.data.0` entry for esp-idf/main/libmain.a(modes.c.obj), PROTOCOL.md
// §9.1's own methodology) before this change.
// v0.2 §5: +8 B for the new `loc` field (loc_rtc_t) -> 520 bytes, 664 B
// under the 1184-byte budget below. modes_boot()'s own ESP_LOGI of
// sizeof(g_rtc) is the authoritative figure — see the report this task
// ships with for the number it actually printed.
_Static_assert(sizeof(pager_rtc_t) <= 1184,
               "pager_rtc_t exceeds the measured 1184-byte RTC_SLOW budget "
               "left after walter-modem's own ~7003 bytes (PROTOCOL.md §9.1)");

RTC_DATA_ATTR static pager_rtc_t g_rtc;

// Guards g_rtc against the race between the wake-and-drain loop below and
// the MQTT MESSAGE callback (WalterModem's _eventProcessingTask), and is
// reused (msg.h's header comment explains why) to guard msg.c's RAM-resident
// thread/composer state too. Statically allocated: no heap use after init.
static StaticSemaphore_t s_rtc_mutex_buf;
static SemaphoreHandle_t s_rtc_mutex;

static void rtc_lock(void) { xSemaphoreTake(s_rtc_mutex, portMAX_DELAY); }
static void rtc_unlock(void) { xSemaphoreGive(s_rtc_mutex); }

static bool s_was_mqtt_connected = false;
static bool s_wake_status_pending = false; // ui_wake_status_refresh() owed after the next render
static bool s_ui_awake_prev = false; // F6.3: edge-detects input_awake() for ui_wake_status_refresh()

#ifdef PAGER_DEBUG_NO_LIGHT_SLEEP
// TASK_looptime.md: awake-loop timing, debug builds only. RAM-only statics,
// modes_run()'s task only (same reasoning s_ui_awake_prev above uses).
// s_dbg_looptime_prev_us is the esp_timer_get_time() this same loop reached
// its one marked point (just below bool ui_awake_now = input_awake();) on
// the PREVIOUS iteration, awake or not — so the first iteration after a
// UI-awake edge-in still reports a real (large) period spanning however
// long the device was asleep, which is deliberate: that is the iteration
// where the first-key cost (including ui_wake_status_refresh()) is paid and
// this task wants it visible, not folded into "rest" as zero. No power
// effect of its own (RAM reads only).
static int64_t s_dbg_looptime_prev_us = 0;
// Rate limit for the steady-state (non-edge-in) log line — see the log call
// site's own comment for why the edge-in iteration bypasses this.
static int64_t s_dbg_looptime_last_log_us = 0;
#endif

// Rail hold task (docs/ROADMAP.md "24 Sep evening finding"): esp_timer_get_time()
// of the most recent key event, button short/long event, or ext1 wake.
// RAM-only, modes_run()'s task only (same reasoning s_ui_awake_prev above
// uses) -- the attentive window is a UX nicety, not state that needs to
// survive a reset, so it is deliberately not in g_rtc/RTC_DATA_ATTR.
//
// TASK_ui_round2.md Do #6: starts at -(PAGER_ATTENTIVE_S+1)*1e6, not 0 —
// esp_timer_get_time() itself starts near 0 at boot, so a literal 0 here
// made `now - s_last_input_us` (modes_in_use()/modes_run()'s own `attentive`
// local, both below) read as a small, in-window value for the whole first
// PAGER_ATTENTIVE_S (120s) of every boot, spuriously treating "no input
// seen yet" as "attentive" (rail held on, 1s wake cadence) until the first
// real key/button/ext1 event. This sentinel is far enough in the past
// that `now - s_last_input_us` already exceeds PAGER_ATTENTIVE_S*1e6 on the
// very first modes_run() iteration, so the window reads closed at boot and
// s_attentive_prev's own edge-detect (below) never fires a spurious
// attentive-true edge before the first real input.
static int64_t s_last_input_us = -(int64_t) (PAGER_ATTENTIVE_S + 1) * 1000000;
// Edge-detects the attentive/normal cadence transition so the ESP_LOGI below
// fires once per transition, not once per attentive wake.
static bool s_attentive_prev = false;

// Sleep indicator (owner, 5 Oct 2026): the release build has no console, so
// the glass shows "zz" in the status bar while in the normal 20 s sleep
// cadence, and on the next awake stretch the number of ext1 wakes that
// happened meanwhile (an interrupt storm shows as a large count). One extra
// partial per sleep-stretch entry (after each awake stretch), none per 20 s
// cycle. Pages arriving asleep render while s_sleep_shown is still true.
static bool s_sleep_shown = false;
static uint32_t s_sleep_entry_ext1 = 0;
static uint32_t s_last_sleep_ext1_wakes = 0;

bool modes_sleep_indicator(void)
{
    return s_sleep_shown;
}

uint32_t modes_last_sleep_ext1_wakes(void)
{
    return s_last_sleep_ext1_wakes;
}

// Key-render coalescing removed 4 Oct 2026 (TASK_keylat.md): it added up to
// ~300ms of latency per keystroke. The bug it was written against (a key
// typed mid-refresh was lost outright) is prevented by ui.c's kbd task,
// which polls the CardKB independently of this loop; a key that arrives
// during a refresh is queued by that task and drained on
// the next modes_run() iteration, where it renders together with whatever
// else drained that iteration.

// v0.2 §9.5/§7 key 50: per-MQTT-session counter within this boot, incremented
// in the rising-edge block below on every session start (including a
// modem-initiated resume the firmware repaired, `st.session_restart_edge`)
// before publish_status_online() runs, so the session's first online status
// already carries the new value. RAM-only by design (§9.5 doesn't need it to
// survive a reset: a reset starts a new boot and the relay's `session` id
// changes too, which already forces the re-publish this counter is for).
// No modem/sleep-state effect of its own — a plain counter read/write.
static uint32_t s_mqtt_link_counter = 0;

// v0.2 bug fix #3 (docs/V02_DESIGN.md §2.3): connect watchdog. mqttConnect()
// can "wedge silently" -- neither CONNECTED nor DISCONNECTED ever fires
// (GOTCHAS.md documents this engine doing exactly that for the
// original `setup` hang). s_connect_attempt_us records when the outstanding
// attempt was issued (0 = none outstanding) so modes_run() can notice 60s
// of silence and force the issue instead of retrying (or doing nothing)
// forever. s_connect_watchdog_count is consecutive silent timeouts, reset by
// any real CONNECTED/DISCONNECTED event. Both RAM-only, same reasoning as
// s_was_mqtt_connected above: this design never deep sleeps, and a watchdog
// timeout mid-boot after a real reset just becomes an ordinary F3 backoff
// retry, nothing needs to survive a reset here.
static int64_t s_connect_attempt_us = 0;
static uint32_t s_connect_watchdog_count = 0;
#define PAGER_CONNECT_WATCHDOG_US ((int64_t) 60 * 1000000) // §2.3: 60s

// Rate limit for msg_pump(), now that pump_blocked no longer keys on
// ui_awake/btn_busy/btn_stuck (see that variable's doc comment): 0 means "no
// call yet, run immediately". RAM-only, same reasoning as
// s_connect_attempt_us above.
static int64_t s_next_pump_us = 0;

// v0.2 §4.4: catrust.c's own independent suppression window — see modes.h's
// own doc comment (modes_set_ca_apply_suppress()).
static volatile bool s_ca_apply_suppress = false;

void modes_set_ca_apply_suppress(bool suppress)
{
    if (suppress != s_ca_apply_suppress) {
        ESP_LOGI(TAG, "CA apply %s the ordinary MQTT reconnect/F4 health-check machinery",
                 suppress ? "suppressing" : "releasing");
    }
    s_ca_apply_suppress = suppress;
}

// Owner request, 2026-09-20: coverage.c's duty-cycle policy state + the one
// RAM flag that mirrors "the radio is deliberately off right now" for every
// other module to check (modes_coverage_owns_radio(), modes.h). RAM-only,
// same reasoning as s_ca_apply_suppress above: this design
// never deep sleeps, so nothing here needs to survive a reset — a reboot
// mid-cycle just restarts the policy from GRACE_S, the same conservative
// default coverage_policy_init() gives a cold boot anyway.
static coverage_policy_t s_coverage;
static volatile bool s_coverage_owns_radio = false;

bool modes_coverage_owns_radio(void) { return s_coverage_owns_radio; }

void modes_note_motion_reset(void) { coverage_on_motion(&s_coverage); }

void modes_coverage_debug_print(void)
{
    bool registered = (net_unregistered_for_s() == 0);
    uint32_t dark_s = net_unregistered_for_s();
    uint32_t remaining_s = coverage_phase_remaining_s(&s_coverage, esp_timer_get_time());
    const char *phase_str = (s_coverage.phase == COVERAGE_PHASE_OFF)
                                 ? "OFF (radio deliberately off)"
                             : (s_coverage.phase == COVERAGE_PHASE_SEARCH)
                                 ? "SEARCH (radio full, hunting)"
                                 : "NONE (registered, or still inside the grace window)";
    printf("coverage: registered=%d dark_for=%us phase=%s off_step=%u/3 (%us) next_action_in=%us "
           "owns_radio=%d last_dark=%us cycles=%u\n",
           (int) registered, (unsigned) dark_s, phase_str, (unsigned) coverage_off_step_index(&s_coverage),
           (unsigned) s_coverage.off_period_s, (unsigned) remaining_s, (int) s_coverage_owns_radio,
           (unsigned) coverage_last_dark_s(&s_coverage), (unsigned) s_coverage.cycles);
}

// ---------------------------------------------------------------------------
// RTC helpers
// ---------------------------------------------------------------------------

static uint32_t rtc_compute_crc(void)
{
    // CRC over everything except the magic+crc32 header itself.
    const uint8_t *start = (const uint8_t *) &g_rtc.boot_count;
    size_t len = sizeof(g_rtc) - offsetof(pager_rtc_t, boot_count);
    return esp_rom_crc32_le(0, start, len);
}

static bool rtc_is_valid(void)
{
    return g_rtc.magic == PAGER_RTC_MAGIC && g_rtc.crc32 == rtc_compute_crc();
}

static void rtc_save(void)
{
    g_rtc.magic = PAGER_RTC_MAGIC;
    g_rtc.crc32 = rtc_compute_crc();
}

static void gen_session_id(char *out, size_t out_size)
{
    // "s_" + 8 lowercase hex, PROTOCOL.md §1.
    snprintf(out, out_size, "s_%08x", (unsigned) esp_random());
}

static void rtc_cold_init(void)
{
    memset(&g_rtc, 0, sizeof(g_rtc));
    g_rtc.boot_count = 1;
    gen_session_id(g_rtc.session_id, sizeof(g_rtc.session_id));
    g_rtc.mode = (uint8_t) PAGER_MODE_SLEEP;
    rtc_save();
}

// Best-effort wall clock; returns 0 if the network clock was never obtained
// (PROTOCOL.md §3.5 - the caller must then treat ts as 0, not retry SNTP).
static int64_t approx_epoch(void)
{
    int64_t e;
    if (net_get_clock(&e)) {
        return e;
    }
    return 0;
}

// ---------------------------------------------------------------------------
// F3.6 (docs/PROTOCOL.md §14/§2.7): NVS persistence for the /up,/status,/loc
// counter's epoch half. Called only when auth_next_up_n() reports `up_lo`
// just wrapped (~once per 1M signed publishes) — never on the hot path.
// ---------------------------------------------------------------------------

static void on_auth_epoch_wrap(void)
{
    // Power effect: one NVS (flash) write. No modem or sleep-state effect.
    // ident_t has no per-field setter, so this snapshots every getter into a
    // scratch copy, bumps n_epoch, and writes the whole struct back via
    // ident_store() (same contract setup.c's own first-time write uses).
    // ident_scratch() is the one shared 4,460 B
    // buffer, not a private static; released before every return below.
    ident_t *snap = ident_scratch();
    strncpy(snap->dev_id, ident_get_dev_id(), sizeof(snap->dev_id) - 1);
    strncpy(snap->mqtt_pw, ident_get_mqtt_pw(), sizeof(snap->mqtt_pw) - 1);
    memcpy(snap->kdev, ident_get_kdev(), sizeof(snap->kdev));
    strncpy(snap->host, ident_get_host(), sizeof(snap->host) - 1);
    snap->port = ident_get_port();
    strncpy(snap->ca, ident_get_ca(), sizeof(snap->ca) - 1);
    snap->ca_len = ident_get_ca_len();
    strncpy(snap->apn, ident_get_apn(), sizeof(snap->apn) - 1);
    snap->flags = ident_get_flags();
    strncpy(snap->label, ident_get_label(), sizeof(snap->label) - 1);
    memcpy(snap->ca_hash, ident_get_ca_hash(), sizeof(snap->ca_hash));
    snap->n_epoch = (uint16_t) (ident_get_n_epoch() + 1);
    snap->claimed = ident_get_claimed();

    if (!ident_store(snap)) {
        ESP_LOGI(TAG, "failed to persist n_epoch=%u after up_lo wrap (§2.5) - "
                      "next boot's replay window may see a gap",
                 (unsigned) snap->n_epoch);
    } else {
        ESP_LOGI(TAG, "n_epoch bumped to %u after up_lo wrap (§14.2)", (unsigned) snap->n_epoch);
    }
    ident_scratch_release();
}

// ---------------------------------------------------------------------------
// Status (/status) publishing - PROTOCOL.md §5, §14.
// ---------------------------------------------------------------------------

// PROTOCOL.md §10 envelope keymap — the subset this file writes for /status.
#define STK_V 0
#define STK_TS 2
#define STK_N 12
#define STK_BV 14
#define STK_STATE 21
#define STK_MODE 22
#define STK_BATT_MV 23
#define STK_RSSI 24
#define STK_SESSION 25
#define STK_FW 26
#define STK_LOC_PERIOD_S 27
#define STK_LOC_MIN_S 28
#define STK_LOC_BACKOFF_S 43 // v0.2 §7
#define STK_CAR 70 // docs/SORACOM_DESIGN.md 3.4: carrier preset label (<= 24 B)
#define STK_TEMP_DC 71 // modem temperature, tenths of a degree C (signed), omitted until a reading exists
#define STK_GNSS 69 // docs/GNSS_DISABLE_DESIGN.md D4: cfg.loc.gnss as applied (0/1)
#define STK_LOC_MOVE_S 61 // LOCATION_TRACKING_DESIGN.md §5 P3, this task: the `locmove` runtime
                          // tunable (0 = GNSS-while-moving off)
#define STK_TLS 39           // v0.2 §4.3/§7: "unpinned"/"pinned"/"broken"
#define STK_CA_FP 42         // v0.2 §4.3/§7: absent when unpinned
#define STK_SMS_LOST 48      // v0.2 §6/§7: sms_log audit entries dropped for lack of NVS space
#define STK_LINK 50           // v0.2 §9.5/§7: MQTT-session generation within this boot
// /status key 52 (`xport`) retired (Wi-Fi removed, owner 16 Oct 2026), do not reuse.
// Crash diagnostics so a crash can be read off the relay when the USB port
// stays dead after a watchdog/panic reset (it only re-enumerates after a
// power cycle) -- watchdog.c's watchdog_boot() computes all three. NOTE: the
// task that requested these asked for keys 52/53/54, but 52 was already
// the retired xport key above (PROTOCOL.md §9.5's key table); using it again would put
// two different fields under the same CBOR map key. Took the next free keys,
// 53/54/55, instead -- flagged for server-architect review alongside the
// PROTOCOL.md rows below.
#define STK_RST 53             // esp_reset_reason_t of this boot (watchdog_last_reset_reason())
#define STK_STAGE 54           // previous boot's stage breadcrumb, 0 if none (watchdog_last_reset_stage())
#define STK_ABN 55             // abnormal resets since power-on (watchdog_abnormal_reset_count())
#define STK_BPULL 58           // v0.4 §3.7/§5.1: book-pull capability gate — present (1) once Do
                               // steps 1-5 are all in, per this task's own instruction; absent
                               // means the relay keeps sending the legacy full `/down book`.
// wdt-stage8, added 25 Sep 2026, pending server-architect review (docs/PROTOCOL.md §5.1/§10):
// previous boot's stalled-command breadcrumb (watchdog_last_stall_cmd()), omitted when empty.
#define STK_STALLCMD 59
// docs/OTA_DESIGN.md section 5 (envelope keys 62-67): the running image id and the OTA job. Display only,
// except `img` (the relay's delta-vs-full choice) and `ota` (the capability gate).
#define STK_IMG 62     // 16 hex chars of the running image id; always present once ota_boot() ran
#define STK_OTA 63     // 1 = cfg.ota supported and a rollback bootloader is confirmed
#define STK_OTA_T 64   // 16 hex chars of the job target
#define STK_OTA_ST 65  // wait/dl/ready/inst/ok/fail/rb
#define STK_OTA_PCT 66 // 0-100
#define STK_OTA_ERR 67 // short error code, omitted when none
#define STK_AST 72     // font source: 0 = no assets_ota row, 1 = factory, 2 = assets_ota (docs/ASSETS_OTA_DESIGN.md section 3)
#define STK_AST_ID 73  // 16 hex chars of the active font image, only when ast == 2

#define PAGER_RSSI_UNSET (-1000) // outside net_get_rssi()'s valid [-113,-51] range

// Last known-good battery/RSSI readings, so a single failed AT command
// doesn't block a /status publish. Plain static (not RTC_DATA_ATTR): this
// design never deep sleeps, only light sleeps, and light sleep retains
// ordinary RAM (same reasoning net.cpp's own module-static state uses).
// Reset to the fallback below only on a real reboot.
static int s_last_batt_mv = 0;              // 0 = no good reading yet this boot (raw mV, unclamped: ~5200 on USB)
static int s_last_pct = -1;                 // carrier gauge percent, -1 = no reading (breadboard: always -1)
static int s_last_charge_state = 0;         // fuel_state_t (carrier); FUEL_ON_BATTERY on the breadboard
static bool s_gauge_fresh = false;          // set by refresh_batt_mv() when it did a new gauge read (fuel_shutdown_check())
static int64_t s_last_gauge_us = 0;         // esp_timer time of the last gauge I2C read, 0 = none yet
static int s_last_temp_dc = 0;              // modem temperature, tenths of C; valid only if s_have_temp
static bool s_have_temp = false;
static int s_last_rssi_dbm = PAGER_RSSI_UNSET; // unset = no good reading yet this boot

// `v` MUST be non-negative for cbor_w_uint(); dBm readings are not, so
// /status's `rssi` field needs the signed form.
static bool cbor_w_int(cbor_w_t *w, uint32_t key, int64_t v)
{
    return (v < 0) ? cbor_w_nint(w, key, v) : cbor_w_uint(w, key, (uint64_t) v);
}

// F6.3 (docs/DEVICE_PLAN.md §5.4): factored out of build_status_cbor() so
// the status bar's UI-wake refresh (ui_wake_status_refresh(), below) shares
// the exact same fetch-with-fallback logic instead of duplicating it - one
// AT round trip each, no RRC of its own beyond net_get_battery_mv()/
// net_get_rssi()'s own documented cost (net.h).
static void refresh_batt_mv(void)
{
    if (board_has_fuel_gauge()) {
        // Carrier: the MAX17048 replaces AT+SQNVMON (same s_last_batt_mv, so /status key 23 and every
        // consumer follow). One I2C read set (~1 ms, no modem), at most one per 10 s; the charger pins
        // are plain GPIO reads and always refreshed. A failed read invalidates the percent (no shutdown
        // decision on stale data) but keeps the last good mV.
        s_last_charge_state = (int) fuel_state();
        int64_t now = esp_timer_get_time();
        if (s_last_gauge_us != 0 && now - s_last_gauge_us < 10 * 1000000LL) {
            return;
        }
        s_last_gauge_us = now;
        s_gauge_fresh = true;
        fuel_t f;
        if (fuel_read(&f) && f.mv > 0) {
            s_last_batt_mv = f.mv;
            s_last_pct = f.pct;
            battstat_note_mv(f.mv);
        } else {
            s_last_pct = -1;
        }
        return;
    }
    // Raw AT+SQNVMON millivolts, reported as measured (owner, 14 Oct 2026). A failed or zero read
    // is "no reading": it never overwrites the last good value.
    int batt_mv;
    if (net_get_battery_mv(&batt_mv) && batt_mv > 0) {
        s_last_batt_mv = batt_mv;
        battstat_note_mv(batt_mv); // window minimum for `bs.mvn` (battstat ignores values outside 2000..5000)
    }
}

// Modem temperature, tenths of C, same cadence and failure rule as the battery (one bounded AT
// round trip; a failure keeps the last good value, and none yet means key 71 is omitted).
static void refresh_temp_dc(void)
{
    int dc;
    if (net_get_temp_dc(&dc)) {
        s_last_temp_dc = dc;
        s_have_temp = true;
    }
}

static int refresh_rssi_dbm(void)
{
    int rssi_dbm;
    if (!net_get_rssi(&rssi_dbm)) {
        rssi_dbm = (s_last_rssi_dbm != PAGER_RSSI_UNSET) ? s_last_rssi_dbm : -113;
    } else {
        s_last_rssi_dbm = rssi_dbm;
    }
    return rssi_dbm;
}

// F6.3 (docs/DEVICE_PLAN.md §5.4/§5.7): "Read at every /status publish...
// and at every UI wake" / "Battery... at every UI wake and hourly" - this
// is the one new AT round trip per UI wake §5.7 budgets (~100ms at 40mA).
// Called from modes_run() on the sleep->awake edge of input_awake(). The
// "hourly" half rides the existing maybe_publish_heartbeat() cadence
// instead of a second timer (build_status_cbor() below calls the same two
// refresh_*() functions on every /status publish, including the ~hourly
// heartbeat) - a separate hourly-only timer would just re-read the same
// cache for no reason whenever a network clock is available; the one gap
// this leaves is a device with *both* no UI activity *and* no network
// clock for a long stretch (heartbeat suppressed, PROTOCOL.md §3.5),
// accepted as a minor cosmetic staleness rather than a second always-on
// timer for that edge case.
static void ui_wake_status_refresh(void)
{
    refresh_batt_mv();
    refresh_temp_dc();
    refresh_rssi_dbm();
}

// Round 4 (bug report 25 Sep ~3am PDT, the attentive-edge fix): the single
// source of truth for "is the pager inside its PAGER_ATTENTIVE_S (120s)
// attentive window" - previously duplicated (modes_in_use() below, and a
// separate `attentive` local in modes_run()'s loop, "kept in sync by hand,
// not shared" per that comment's own words) - now both call this one
// function instead. Plain RAM read, no modem/sleep-state effect of its own.
static bool attentive_now(void)
{
    return (esp_timer_get_time() - s_last_input_us) < (int64_t) PAGER_ATTENTIVE_S * 1000000;
}

// TASK_clock.md Do #2: "in use" for the status bar's live clock is the
// attentive window (PAGER_ATTENTIVE_S = 120s from the last key/button/ext1
// event, s_last_input_us above), NOT input.c's shorter PAGER_UI_AWAKE_S (119 s)
// input_awake() UI-awake window ui_awake_now/render_now gate off of below --
// the rail hold task keeps the display/CardKB rail on for the whole of the
// attentive window (see the `if (attentive) rail_on()` comment further down
// this file), so a status-bar partial refresh is safe for the full 120s,
// not just the first 30. Same predicate modes_run()'s own attentive_service()
// call uses each iteration (attentive_now() above, round 4: no longer
// duplicated by hand) - plain RAM read, no modem/sleep-state effect of its own.
bool modes_in_use(void)
{
    return attentive_now();
}

// Bench diagnostic (round 4, `attn` debug console command, main.c): raw
// microsecond age of the last recorded key/button/ext1 event, so a
// bench session can watch s_last_input_us tick up (or, if it never does,
// see exactly what is re-arming it) without guessing from the "wake
// cadence:" log's coarse edge-only transitions. Plain RAM read.
int64_t modes_debug_last_input_age_us(void)
{
    return esp_timer_get_time() - s_last_input_us;
}

// F6.3: status-bar/Device-screen getters (modes.h) - plain cache reads, no
// AT round trip of their own; see modes.h's own doc comment.
int modes_get_rssi_dbm(void) { return (s_last_rssi_dbm != PAGER_RSSI_UNSET) ? s_last_rssi_dbm : -113; }
int modes_get_batt_mv(void) { return s_last_batt_mv; } // raw mV; 0 = no reading yet (check modes_batt_mv_known())
// s_last_batt_mv stays 0 until net_get_battery_mv() (AT+SQNVMON) returns a non-zero reading, see
// refresh_batt_mv() above; callers must treat 0 as "unknown", not as a voltage.
bool modes_batt_mv_known(void) { return s_last_batt_mv != 0; }
int modes_get_batt_pct(void) { return s_last_pct; }          // -1 = unknown (always on the breadboard)
int modes_get_charge_state(void) { return s_last_charge_state; } // fuel_state_t
bool modes_get_temp_dc(int *temp_dc)
{
    if (temp_dc && s_have_temp) {
        *temp_dc = s_last_temp_dc;
    }
    return s_have_temp;
}
const char *modes_get_fw_version(void) { return fw_version_str(); }
const char *modes_get_session_id(void) { return g_rtc.session_id; }
uint32_t modes_get_memfull_count(void) { return g_rtc.mqtt_memfull_count; }
uint32_t modes_get_oversize_drop_count(void) { return g_rtc.oversize_drop_count; }
uint32_t modes_get_modem_resets(void) { return g_rtc.modem_resets; }

// F3.6: builds the CBOR /status envelope (docs/PROTOCOL.md §2.4/§10), adding
// `rssi` (now published every time, §5.1) and `bv` (book version; F7.1:
// book_get_bv() — 0 until the first `book` has ever been applied, which is
// exactly what makes §4.3's "relay sees `bv` lower than `bookVersion` ->
// push again" rule self-heal a factory reset or a never-provisioned
// device), then signs it with auth_sign() when ident's IDENT_FLAG_REQ_SIG
// is set. No modem or sleep-state effect of its own beyond the
// net_get_battery_mv()/net_get_rssi() AT round trips already documented at
// their call sites (book_get_bv() is a plain RAM read, no NVS I/O).
// The window snapshot the last build_status_cbor() encoded; publish_status_online() commits it (subtracts
// it from the counters) only when the publish succeeds. Loop task only.
static bs_snap_t s_bs_snap;
static bool s_bs_have = false;

static bool build_status_cbor(uint8_t *out, size_t cap, size_t *out_len, const char *state)
{
    int64_t ts = approx_epoch();
    const char *mode_str = (g_rtc.mode == (uint8_t) PAGER_MODE_ACTIVE) ? "active" : "sleep";

    // batt_mv/rssi_dbm: F6.3 factored these out into refresh_batt_mv()/
    // refresh_rssi_dbm() (above) so the status bar's UI-wake refresh could
    // share the exact fetch-with-fallback logic instead of duplicating it —
    // net.cpp's AT+SQNVMON/AT+CSQ reads, falling back to the last
    // known-good value and finally to a fixed placeholder, never blocking
    // or failing this publish.
    refresh_batt_mv();
    refresh_temp_dc();
    const bool have_batt = s_last_batt_mv != 0;
    const int batt_mv = s_last_batt_mv;
    const bool have_temp = s_have_temp;
    const int temp_dc = s_last_temp_dc;
    int rssi_dbm = refresh_rssi_dbm();

    bool signed_env = (ident_get_flags() & IDENT_FLAG_REQ_SIG) != 0;

    // v0.2 §4.3: `tls` is always present (one of unpinned/pinned/broken);
    // `ca_fp` only when a CA is actually pinned (PINNED or BROKEN) — "absent
    // when unpinned". Both are plain reads of already-resident state (ident's
    // cached ca_len/ca_hash and catrust.c's own RAM-cached broken flag), no
    // AT round trip or NVS I/O of their own.
    // SORACOM_DESIGN 3.4: on the LTE xport over the Beam bearer TLS ends at Beam ("proxy").
    const bool via_beam = net_bearer_beam();
    const char *tls_str = via_beam ? "proxy" : catrust_state_name(catrust_get_state());
    char ca_fp[17];
    bool have_ca_fp = !via_beam && catrust_get_ca_fp(ca_fp);
    // key 70 `car`: preset label, <= 24 printable ASCII, absent when no preset is in force.
    char car[25];
    snprintf(car, sizeof(car), "%s", net_carrier_label());
    const bool have_car = car[0] != '\0';

    // wdt-stage8 (docs/PROTOCOL.md §5.1/§10 key 59, pending server-architect
    // review): previous boot's stalled-command breadcrumb, "" when there was
    // none -- plain read of watchdog.c's this-boot-only static, no AT round
    // trip or NVS I/O of its own.
    const char *stall_cmd = watchdog_last_stall_cmd();
    bool have_stall_cmd = stall_cmd[0] != '\0';

    // v0.2 §5/§7: +3 for loc_period_s/loc_min_s/loc_backoff_s (loc.c's own
    // getters — plain reads of already-resident policy state, no AT round
    // trip of their own beyond what batt_mv/rssi above already cost).
    // LOCATION_TRACKING_DESIGN.md §5 P3: +1 for loc_move_s (key 61), same
    // "plain read" cost class.
    uint32_t nfields = 8 + 3 + 1 + 1 + 1 + 1 + 3 + 1; // + gnss (key 69, GNSS_DISABLE_DESIGN.md D4), + tls, + sms_lost, + link,
                                          // + loc_move_s, + rst/stage/abn;
                                          // v,state,mode,rssi, (batt_mv and temp_dc are optional, counted above)
                                          // session,ts,fw,bv,loc_period_s,loc_min_s,loc_backoff_s,
                                          // tls,sms_lost,link,loc_move_s,rst,stage,abn
    if (have_batt) {
        nfields += 1; // key 23 batt_mv: omitted until the modem has returned a reading this boot
    }
    if (have_temp) {
        nfields += 1; // key 71 temp_dc: likewise
    }
    if (have_ca_fp) {
        nfields += 1;
    }
    if (have_car) {
        nfields += 1; // key 70 car
    }
    if (have_stall_cmd) {
        nfields += 1; // wdt-stage8: STK_STALLCMD key 59, omitted when empty
    }
    // docs/OTA_DESIGN.md section 5: img (when known), ota gate, and the job fields while a job exists.
    ota_status_t ost;
    ota_get_status(&ost);
    bool have_ota_err = ost.have_job && ost.err != OTA_ERR_NONE;
    if (ost.img[0] != '\0') {
        nfields += 1;
    }
    if (ost.gate) {
        nfields += 1;
    }
    nfields += 1; // key 72 ast: always sent
    if (ost.ast == 2) {
        nfields += 1; // key 73 ast_id
    }
    if (ost.have_job) {
        nfields += 3; // ota_t, ota_st, ota_pct
        nfields += have_ota_err ? 1 : 0;
    }
    // docs/BATTERY_STATS_DESIGN.md B5: key 68 `bs`, CBOR-only (this function only ever writes CBOR), once the
    // window holds at least 1 s. Snapshot taken here, committed by publish_status_online() on success.
    battstat_snapshot(&s_bs_snap);
    s_bs_have = s_bs_snap.dt >= 1;
    if (s_bs_have) {
        nfields += 1;
    }
    if (signed_env) {
        nfields += 1; // v0.4 §3.7/§5.1: `bpull` — see its own cbor_w_uint() call below for the gate
        nfields += 2; // n (written below) + sig (appended by auth_sign())
    }

    cbor_w_t w;
    cbor_w_init(&w, out, cap);
    cbor_w_map(&w, nfields);
    cbor_w_uint(&w, STK_V, 1);
    cbor_w_tstr(&w, STK_STATE, state, strlen(state));
    cbor_w_tstr(&w, STK_MODE, mode_str, strlen(mode_str));
    if (have_batt) {
        cbor_w_uint(&w, STK_BATT_MV, (uint64_t) batt_mv);
    }
    if (have_temp) {
        cbor_w_int(&w, STK_TEMP_DC, temp_dc);
    }
    cbor_w_int(&w, STK_RSSI, rssi_dbm);
    cbor_w_tstr(&w, STK_SESSION, g_rtc.session_id, strlen(g_rtc.session_id));
    cbor_w_uint(&w, STK_TS, (uint64_t) ts);
    cbor_w_tstr(&w, STK_FW, fw_version_str(), strlen(fw_version_str()));
    cbor_w_uint(&w, STK_BV, book_get_bv()); // §4.3: book version, F7.1
    cbor_w_uint(&w, STK_LOC_PERIOD_S, loc_get_period_s()); // v0.2 §5: always 0, periodic fixes parked
    cbor_w_uint(&w, STK_LOC_MIN_S, loc_get_min_s());        // v0.2 §5: the 10-minute trigger floor
    cbor_w_uint(&w, STK_LOC_BACKOFF_S, loc_get_backoff_remaining_s()); // v0.2 §7 key 43
    cbor_w_uint(&w, STK_LOC_MOVE_S, loc_get_move_gnss_s()); // LOCATION_TRACKING_DESIGN.md §5 P3 key 61
    cbor_w_uint(&w, STK_GNSS, loc_gnss_enabled() ? 1 : 0); // docs/GNSS_DISABLE_DESIGN.md D4 key 69
    cbor_w_tstr(&w, STK_TLS, tls_str, strlen(tls_str));                // v0.2 §4.3
    if (have_ca_fp) {
        cbor_w_tstr(&w, STK_CA_FP, ca_fp, strlen(ca_fp));              // v0.2 §4.3
    }
    cbor_w_uint(&w, STK_SMS_LOST, sms_get_lost_count());               // v0.2 §6/§7 key 48
    // v0.2 §9.5/§7 key 50: always present because build_status_cbor() is
    // only ever reached with mqtt_connected already true (every caller
    // guards on it, and the rising-edge block below increments the counter
    // before its own call), so s_mqtt_link_counter is always >= 1 here.
    cbor_w_uint(&w, STK_LINK, s_mqtt_link_counter);

    // Crash diagnostics (docs/PROTOCOL.md §9.5 keys 53/54/55): so a crash
    // can be diagnosed from the relay when the USB port is dead (it never
    // re-enumerates after a watchdog or panic reset, only after a power
    // cycle). Plain reads of watchdog.c's this-boot-only statics/RTC
    // counter, no AT round trip or NVS I/O of their own.
    cbor_w_uint(&w, STK_RST, (uint64_t) (unsigned) watchdog_last_reset_reason());
    cbor_w_uint(&w, STK_STAGE, (uint64_t) (unsigned) watchdog_last_reset_stage());
    cbor_w_uint(&w, STK_ABN, (uint64_t) watchdog_abnormal_reset_count());
    if (have_stall_cmd) {
        cbor_w_tstr(&w, STK_STALLCMD, stall_cmd, strlen(stall_cmd)); // wdt-stage8, key 59
    }

    // docs/OTA_DESIGN.md section 5: plain reads of ota.c's RAM state, no AT round trip or NVS I/O.
    if (ost.img[0] != '\0') {
        cbor_w_tstr(&w, STK_IMG, ost.img, strlen(ost.img));
    }
    if (ost.gate) {
        cbor_w_uint(&w, STK_OTA, 1);
    }
    cbor_w_uint(&w, STK_AST, ost.ast);
    if (ost.ast == 2) {
        cbor_w_tstr(&w, STK_AST_ID, ost.ast_id, strlen(ost.ast_id));
    }
    if (ost.have_job) {
        const char *ost_st = ota_state_str(ost.state);
        cbor_w_tstr(&w, STK_OTA_T, ost.target, strlen(ost.target));
        cbor_w_tstr(&w, STK_OTA_ST, ost_st, strlen(ost_st));
        cbor_w_uint(&w, STK_OTA_PCT, ost.pct);
        if (have_ota_err) {
            const char *ost_err = ota_err_str(ost.err);
            cbor_w_tstr(&w, STK_OTA_ERR, ost_err, strlen(ost_err));
        }
        if (ost.state == OTA_ST_OK || ost.state == OTA_ST_RB) {
            ota_status_included();
        }
    }

    if (have_car) {
        cbor_w_tstr(&w, STK_CAR, car, strlen(car));
    }
    if (s_bs_have) {
        battstat_encode(&w, &s_bs_snap);
    }

    // v0.4 §3.7/§5.1: "sends `bpull: 1` in every online `/status`" — gated on
    // `signed_env` (IDENT_FLAG_REQ_SIG) the same way book pull itself is
    // gated: the relay only ever nudges a device whose `authMode` is `hmac`
    // (§3.7's capability gate), and every §14.7 request/response this
    // firmware sends depends on K_dev signing being live. Present with
    // value 1 only, never present-but-0 (matches every other "optional,
    // display/diagnosis" §5.1 field's own convention of omitting rather
    // than sending a false-ish value).
    if (signed_env) {
        cbor_w_uint(&w, STK_BPULL, 1);
    }

    if (!signed_env) {
        *out_len = w.len;
        return !w.err;
    }

    // §14.2: n for /up,/status,/loc; RTC-resident in g_rtc.auth (this file
    // owns that storage directly, unlike msg.c which goes through the
    // msg_bind_auth() pointer).
    bool wrapped = false;
    rtc_lock();
    uint64_t n = auth_next_up_n(&g_rtc.auth, ident_get_n_epoch(), &wrapped);
    rtc_save();
    rtc_unlock();
    cbor_w_uint(&w, STK_N, n);
    if (w.err) {
        return false;
    }
    if (wrapped) {
        on_auth_epoch_wrap();
    }

    char topic[48];
    snprintf(topic, sizeof(topic), "pager/%s/status", net_get_device_id());
    size_t len = w.len;
    if (!auth_sign(topic, out, &len, cap)) {
        return false;
    }
    *out_len = len;
    return true;
}

#define PAGER_STATUS_PUBLISH_DEFER_MAX_MS 30000
// Set by set_mode() (event task or loop task), consumed by modes_run().
static volatile bool s_status_publish_pending = false;
static volatile int64_t s_status_publish_pending_since_us = 0;

static void publish_status_online(void)
{
    uint8_t buf[480] /* 14 Oct 2026: 448 -> 480 for bs sa/sr/sp (+18 B worst case = 440 B total); 7 Oct 2026: OTA fields (278 B max) + bs counters (121 B max) = 399 B; was 384; + ast/ast_id 23 B = 422 B */; // 256 before the OTA fields (img + ota + ota_t/st/pct/err add up to ~75 B)
    size_t len = 0;
    if (!build_status_cbor(buf, sizeof(buf), &len, "online")) {
        ESP_LOGI(TAG, "status CBOR build failed (buffer too small or auth_sign failed)");
        return;
    }
    char topic[48];
    snprintf(topic, sizeof(topic), "pager/%s/status", net_get_device_id());

    if (net_publish_raw(topic, buf, (uint16_t) len, 1)) {
        rtc_lock();
        g_rtc.status_pub_count++;
        g_rtc.last_status_epoch = approx_epoch();
        rtc_unlock();
        if (s_bs_have) {
            battstat_commit(&s_bs_snap); // window carried: subtract it, sq++
            s_bs_have = false;
        }
        ESP_LOGI(TAG, "published /status online (mode=%s, %u B)",
                 g_rtc.mode == (uint8_t) PAGER_MODE_ACTIVE ? "active" : "sleep", (unsigned) len);
        ota_on_status_published(true); // rollback confirmation + end-of-job bookkeeping
    } else {
        ESP_LOGI(TAG, "publish /status online failed");
    }
}

// F6.3 (docs/DEVICE_PLAN.md §5.5): Device screen's "Re-sync address book"
// bullet — "publishes a /status now (it carries bv), which is the sync
// trigger." Refuses (returns false, no publish) if the session is not
// currently connected, same guard set_mode() already applies before
// calling publish_status_online() on a real mode edge.
// Halt screen text lines (see modes_accel_halt()). Power effect: none.
static void halt_screen_paint(const accel_halt_info_t *h)
{
    char l[80];
    gfx_clear();
    gfx_text(4, 2, GFX_FONT_LARGE, "Shake sensor failed (I2C)");
    gfx_hline(0, GFX_SCREEN_W - 1, 21);
    int y = 25;
    snprintf(l, sizeof(l), "read %s failed: %s (0x%x)", h->reg, esp_err_to_name((esp_err_t) h->err), (unsigned) h->err);
    gfx_text(4, y, GFX_FONT_NORMAL, l);
    y += 13;
    snprintf(l, sizeof(l), "consecutive fails %u   bus resets %u", (unsigned) h->consec_fails, (unsigned) h->bus_resets);
    gfx_text(4, y, GFX_FONT_NORMAL, l);
    y += 13;
    snprintf(l, sizeof(l), "accel reboots used %u of %u", (unsigned) h->reboots_used, (unsigned) h->reboot_budget);
    gfx_text(4, y, GFX_FONT_NORMAL, l);
    y += 13;
    if (h->who_err == ESP_OK) {
        snprintf(l, sizeof(l), "last WHO_AM_I 0x%02x (expect 0x33)", (unsigned) h->who);
    } else {
        snprintf(l, sizeof(l), "last WHO_AM_I read failed: %s", esp_err_to_name((esp_err_t) h->who_err));
    }
    gfx_text(4, y, GFX_FONT_NORMAL, l);
    y += 13;
    unsigned up = (unsigned) (h->uptime_us / 1000000);
    int64_t epoch = approx_epoch();
    char wall[28] = "clock unknown";
    if (epoch > 0) {
        time_t t = (time_t) epoch;
        struct tm tm;
        gmtime_r(&t, &tm);
        strftime(wall, sizeof(wall), "%Y-%m-%d %H:%M UTC", &tm);
    }
    snprintf(l, sizeof(l), "up %uh%02um%02us   %s", up / 3600, (up / 60) % 60, up % 60, wall);
    gfx_text(4, y, GFX_FONT_NORMAL, l);
    y += 13;
    snprintf(l, sizeof(l), "fw %s   id %s", fw_version_str(), ident_get_dev_id());
    gfx_text(4, y, GFX_FONT_NORMAL, l);
    y += 13;
    gfx_text(4, y, GFX_FONT_NORMAL, "Press RESET to retry.");
}

static void halt_publish_task(void *arg)
{
    publish_status_online();
    xSemaphoreGive((SemaphoreHandle_t) arg);
    vTaskDelete(NULL);
}

#define HALT_PUBLISH_WAIT_MS 5000

// Accel I2C ladder's last rung (accel.h). Power effect: one full panel
// refresh (~2-4 s), an optional /status publish capped at 5 s of waiting,
// then modem radio off, rails off and deep sleep with no wake source (~uA).
void modes_accel_halt(const accel_halt_info_t *h)
{
    ESP_LOGI(TAG, "accel halt: drawing error screen");
    ui_ensure_powered();
    halt_screen_paint(h);
    disp_full_refresh(); // the panel keeps the image unpowered
    watchdog_feed();

    net_mqtt_status_t st;
    net_get_mqtt_status(&st);
    if (st.mqtt_connected) {
        watchdog_set_reported_stage(WD_ACCEL_RESTART); // /status STK_STAGE shows the accel stage
        SemaphoreHandle_t done = xSemaphoreCreateBinary();
        if (done && xTaskCreate(halt_publish_task, "halt_pub", 6144, done, 5, NULL) == pdPASS) {
            bool sent = xSemaphoreTake(done, pdMS_TO_TICKS(HALT_PUBLISH_WAIT_MS)) == pdTRUE;
            ESP_LOGI(TAG, "accel halt: /status %s", sent ? "attempted" : "not finished in 5 s, giving up");
        }
    }
    watchdog_feed();

    ESP_LOGI(TAG, "accel halt: powering down (RESET or power cycle to retry)");
    net_session_down();
    net_radio_off();
    rail_off();
    gpio_hold_en((gpio_num_t) PAGER_PIN_3V3_EN); // keep both rails off through deep sleep; rail_init() releases
    if (board_disp_vcc_en_pin() >= 0) { // carrier: IO12 is FL_PWM, not a display gate
        gpio_hold_en((gpio_num_t) PAGER_PIN_DISP_VCC_EN);
    }
    gpio_deep_sleep_hold_en();
    esp_sleep_disable_wakeup_source(ESP_SLEEP_WAKEUP_ALL);
    esp_deep_sleep_start();
    for (;;) {
        vTaskDelay(portMAX_DELAY); // unreachable
    }
}

// Plain "title / line2" shutdown screen. Power effect: none.
static void power_off_screen_paint(const char *title, const char *line2)
{
    gfx_clear();
    gfx_text(4, 30, GFX_FONT_LARGE, title);
    if (line2 && line2[0]) {
        gfx_text(4, 62, GFX_FONT_NORMAL, line2);
    }
}

// Carrier low-battery Shutdown. Deliberately NOT modes_accel_halt()'s sequence: no /status publish and
// no MQTT teardown (no radio time); the modem goes to MINIMUM and is then held in reset. Power effect:
// one full panel refresh (~2-4 s) plus <= 2 s modem wait, then deep sleep (~uA), wake only on IO15 high.
void modes_power_off_lowbatt(void)
{
    ESP_LOGI(TAG, "shutdown: start");
    // a. light / ext LED / buzzer / haptic off
    frontlight_off();
    extled_pause();
    buzzer_stop();
    /* haptic: the DRV2605L sits on 3V3_AWK, which rail_off() drops in step d. */
    // b. modem to MINIMUM (best effort, <= 2 s), then reset held low (survives deep sleep via gpio_deep_sleep_hold_en)
    net_modem_minimum(2000);
    net_airplane_hold_modem();
    watchdog_feed();
    // c. screen, full refresh (returns after BUSY clears), then SSD1680 deep sleep
    ui_ensure_powered();
    power_off_screen_paint("Shutdown", "Charge me");
    disp_full_refresh();
    disp_panel_deep_sleep();
    watchdog_feed();
    // d. rails off, keep them off through deep sleep (rail_init() releases)
    rail_off();
    gpio_hold_en((gpio_num_t) PAGER_PIN_3V3_EN);
    // e. USB arrived during the draw: the ext1 level wake would fire at once anyway, restart cleanly
    if (gpio_get_level((gpio_num_t) PAGER_PIN_VBUS_DET) == 1) {
        ESP_LOGI(TAG, "shutdown: USB present at the end, restarting instead of sleeping");
        net_modem_uart_unblock();
        esp_restart();
    }
    // f. deep sleep, only VBUS_DET wakes it
    ESP_LOGI(TAG, "shutdown: entering deep sleep, wake on IO%d high", PAGER_PIN_VBUS_DET);
    esp_sleep_disable_wakeup_source(ESP_SLEEP_WAKEUP_ALL);
    esp_sleep_pd_config(ESP_PD_DOMAIN_RTC_PERIPH, ESP_PD_OPTION_OFF);
    esp_sleep_enable_ext1_wakeup(1ULL << PAGER_PIN_VBUS_DET, ESP_EXT1_WAKEUP_ANY_HIGH);
    gpio_deep_sleep_hold_en();
    esp_deep_sleep_start();
    for (;;) {
        vTaskDelay(portMAX_DELAY); // unreachable
    }
}

// Carrier low-battery decision (fuel_fmt.h rule, VOLTAGE based; percent is display only). Runs on the
// modes_run() task only. `booting`: one fresh read, shut down at VCELL <= FUEL_BOOT_SHUTDOWN_MV. Periodic
// (timer-wake) call: counts consecutive low reads, one per fresh gauge read (<= one per 10 s), and shuts
// down on FUEL_SHUTDOWN_READS in a row at VCELL <= FUEL_SHUTDOWN_MV. Never plugged in, never on a failed
// read (resets the count), no-op on the breadboard. Power effect: ~1 ms of I2C; on a low battery it does
// not return (modes_power_off_lowbatt()).
static void fuel_shutdown_check(bool booting)
{
    if (!board_has_fuel_gauge()) {
        return;
    }
    static int low_count = 0;
    s_gauge_fresh = false;
    refresh_batt_mv();
    if (!booting) {
        if (!s_gauge_fresh) {
            return; // rate-limited: nothing new to count
        }
        low_count = (s_last_pct >= 0 && s_last_batt_mv <= FUEL_SHUTDOWN_MV) ? low_count + 1 : 0;
    }
    const bool plugged = s_last_charge_state != (int) FUEL_ON_BATTERY;
    const int mv = (s_last_pct >= 0) ? s_last_batt_mv : 0; // pct < 0 marks a failed read: no decision on stale mV
    if (fuel_should_shutdown(mv, plugged, low_count, booting)) {
        ESP_LOGI(TAG, "low battery %d mV (%d%%), unplugged%s: shutting down", mv, s_last_pct, booting ? ", at boot" : "");
        modes_power_off_lowbatt();
    }
}

// Setup (unprovisioned) boot: the same boot-time low-battery check, before the Setup console starts.
// Power effect: ~1 ms of I2C; on a low unplugged battery it does not return.
void modes_fuel_boot_check(void)
{
    fuel_shutdown_check(true);
}

bool modes_publish_status_now(void)
{
    net_mqtt_status_t st;
    net_get_mqtt_status(&st);
    if (!st.mqtt_connected) {
        return false;
    }
    publish_status_online();
    return true;
}

static void maybe_publish_heartbeat(void)
{
    // §5.4(d): heartbeat rides an ordinary poll wake, at most once per
    // 3600s - not an independent timer (that would cost an extra radio
    // wake for nothing, per §5.4's own rationale).
    int64_t now = approx_epoch();
    if (now == 0) {
        return; // no clock yet; don't spam ts:0 heartbeats
    }
    if (now - g_rtc.last_status_epoch < (int64_t) PAGER_STATUS_HEARTBEAT_S) {
        return;
    }
    net_mqtt_status_t st;
    net_get_mqtt_status(&st);
    if (!st.mqtt_connected) {
        return;
    }
    publish_status_online();
}

// ---------------------------------------------------------------------------
// set_mode() — the single transition funnel required by PROTOCOL.md §11.
// ---------------------------------------------------------------------------

static const char *mode_name(pager_mode_t m)
{
    return (m == PAGER_MODE_ACTIVE) ? "active" : "sleep";
}

static void set_mode(pager_mode_t new_mode, pager_mode_reason_t reason)
{
    rtc_lock();
    bool changed = ((pager_mode_t) g_rtc.mode != new_mode);
    if (changed) {
        ESP_LOGI(TAG, "mode: %s -> %s (reason=%d)", mode_name((pager_mode_t) g_rtc.mode),
                 mode_name(new_mode), (int) reason);
        g_rtc.mode = (uint8_t) new_mode;
    }
    if (new_mode == PAGER_MODE_ACTIVE) {
        // Refresh the deadline on every call while active, not only on the
        // sleep->active edge: an early return on "mode unchanged" would
        // measure the 10 minutes from mode *entry* rather than from the
        // last activity, and firmware/README.md requires the latter. modes_note_activity() below is the lightweight path
        // for this; set_mode() also refreshes it here so a fresh incoming
        // message or button press extends the window even though it also
        // happens to already be active.
        g_rtc.active_until_us = esp_timer_get_time() + (int64_t) PAGER_ACTIVE_IDLE_TIMEOUT_S * 1000000;
    }
    rtc_save();
    rtc_unlock();

    if (!changed) {
        return;
    }

    // §5.4(b): publish on every mode change, but only if the session is
    // actually usable - otherwise this just becomes a queued publish that
    // races the next connect's own online announcement.
    net_mqtt_status_t st;
    net_get_mqtt_status(&st);
    // Deferred (5 Oct 2026, UI first): never publish synchronously on a mode
    // edge -- the render would queue behind the publish-quiet gate. The loop
    // sends it after the render (s_status_publish_pending). The relay learns
    // the new mode a little late; incoming pages are unaffected (the session
    // is up either way). publish_status_online() keeps its own session guard
    // via the mqtt_connected check at send time.
    if (st.mqtt_connected) {
        if (!s_status_publish_pending) {
            s_status_publish_pending_since_us = esp_timer_get_time();
            s_status_publish_pending = true;
        }
    }
    // F6.3: no direct render here any more. README R5's fix funnels every
    // render through modes_run()'s own task (ui_render(), called once per
    // wake-and-drain iteration while input_awake()) instead of whichever
    // task happened to call set_mode() (this function runs on both the
    // event task, via handle_ingest_result(), and modes_run()'s task, via
    // the button dispatch below). docs/DEVICE_PLAN.md §5.4's status bar
    // also dropped the old "active"/"sleep" word entirely, so a mode edge
    // alone no longer has anything of its own to repaint — whatever event
    // caused this edge (button, incoming message) already drives its own
    // render through render_pending/ui_render() below.
}

void modes_note_activity(void)
{
    rtc_lock();
    bool active = (g_rtc.mode == (uint8_t) PAGER_MODE_ACTIVE);
    if (active) {
        g_rtc.active_until_us = esp_timer_get_time() + (int64_t) PAGER_ACTIVE_IDLE_TIMEOUT_S * 1000000;
        rtc_save();
    }
    rtc_unlock();
}

// ---------------------------------------------------------------------------
// F6.3 (docs/DEVICE_PLAN.md §5.3/§5.4, firmware/README.md R5): the incoming-
// message render moves off WalterModem's _eventProcessingTask and onto
// modes_run()'s own task. handle_ingest_result() below (still running on
// the event task) only records what to render; modes_run() drains it via
// service_render_pending(), which calls ui_incoming() (only ui.c entry
// point allowed to render off the render_pending path, since it must run
// synchronously with the msg_mark_shown() that follows) and marks `shown`
// strictly after that render returns — closing R5 and R7 together: shown
// is never claimed before BUSY deasserts, and the event task never blocks
// on the panel.
// ---------------------------------------------------------------------------
typedef struct {
    bool pending;
    bool was_asleep;
    char id[MSG_ID_MAX];
    char from[MSG_FROM_MAX];
} render_pending_t;

// RAM-only (not RTC_DATA_ATTR): a cross-task handoff flag, not state that
// needs to survive a reset — this design never deep sleeps (only light
// sleeps, which retain ordinary RAM), same reasoning s_was_mqtt_connected
// above uses. Guarded by s_rtc_mutex (the same "the only cross-task
// primitive in this design" lock msg.h's own module comment describes).
static render_pending_t s_render_pending;

static void render_pending_set(const char *id, const char *from, bool was_asleep)
{
    rtc_lock();
    s_render_pending.pending = true;
    s_render_pending.was_asleep = was_asleep;
    strncpy(s_render_pending.id, id, sizeof(s_render_pending.id) - 1);
    s_render_pending.id[sizeof(s_render_pending.id) - 1] = '\0';
    strncpy(s_render_pending.from, from, sizeof(s_render_pending.from) - 1);
    s_render_pending.from[sizeof(s_render_pending.from) - 1] = '\0';
    rtc_unlock();
}

// Called only from modes_run()'s own task. Copies out and clears the
// pending flag under the lock, then renders *outside* the lock — ui_incoming()
// can take tens to hundreds of ms (disp_wait_busy()), and holding
// s_rtc_mutex across that would block the event task's next ingest (and
// every other g_rtc access) for no reason; disp.c's own mutex (F6.1,
// closes README R4) is what actually serialises the panel.
static void service_render_pending(void)
{
    rtc_lock();
    if (!s_render_pending.pending) {
        rtc_unlock();
        return;
    }
    render_pending_t p = s_render_pending;
    s_render_pending.pending = false;
    rtc_unlock();

    bool displayed = ui_incoming(p.from, p.was_asleep);
    if (displayed) {
        // §4: "after the e-paper refresh completes (BUSY deasserted), never
        // before" - ui_incoming() only returns true once that render has
        // already happened.
        //
        // v0.2 bug fix #1 (docs/V02_DESIGN.md §2.1): this used to be
        // msg_mark_shown(p.id), acking only the single id this render_pending_t
        // slot remembered. render_pending_set() is a single slot: a burst of
        // messages arriving faster than this task drains it collapses down to
        // "render the last one", and every earlier MSG_ACK_UNSHOWN message in
        // that burst was never acked at all (p.id was already overwritten).
        // ui_incoming() shows the current state of the whole thread, not just
        // `p.from`, so once it renders, every still-UNSHOWN down message is
        // fair to ack in one pass. msg_mark_shown()'s new queued-before-
        // advanced contract (msg.h) means anything that does not fit this
        // pass's MSG_PENDING_ACKS_MAX (8) queue stays UNSHOWN and is retried
        // on the next successful render instead of being lost.
        msg_mark_all_unshown();
    }
    // displayed == false: §5.5's "incoming while typing/on another screen"
    // toast-only path - the message stays MSG_ACK_UNSHOWN on purpose.
    // PROTOCOL.md §4.1 rule 2's "read without a prior shown promotes and
    // back-fills" is what makes that safe once the student actually opens
    // the chat later (scr_chat.c calls msg_mark_read() directly there,
    // never msg_mark_shown() first, for exactly this reason - see its own
    // comment).
}

#ifdef PAGER_DEBUG_NO_LIGHT_SLEEP
// ---------------------------------------------------------------------------
// Debug build only: `sleeptest <minutes>` (main.c). The debug build never
// light-sleeps, which is exactly why it cannot answer the design's biggest
// open question (PROTOCOL.md section 8.3, M5): does a page arrive while the ESP32
// light-sleeps with RTS deasserted, waking only every few seconds? This opens
// a timed window in which the normal sleep decision applies, records what
// happened in RAM (the USB log is dead while asleep), and prints a report
// when the window closes and the log is alive again.
// ---------------------------------------------------------------------------
#include "esp_sleep.h"

typedef struct {
    int32_t t_s;     // seconds since the window opened
    char kind;       // 'M' new message, 'D' duplicate, 'X' malformed, 'C' connected, 'L' session lost
    int32_t a;       // 'M'/'D': seconds between the relay stamping it and the pager parsing it
    char id[12];
    bool after_window; // task 3: noted during the post-close grace, not the window itself
} st_event_t;

#define ST_EVENTS_MAX 48
static st_event_t s_st_events[ST_EVENTS_MAX];
static volatile uint32_t s_st_n_events = 0;
static volatile int64_t s_st_start_us = 0;
static volatile int64_t s_st_until_us = 0;
static volatile bool s_st_report_due = false;
// Task 3 (how long must the pager stay awake after a wake to receive a held
// URC): 0 = use the build's normal PAGER_POST_WAKE_YIELD_MS / active-or-sleep
// interval; sleeptest <minutes> <yield_ms> <interval_ms> overrides both for
// the window's duration.
static uint32_t s_st_yield_ms = 0;
static uint32_t s_st_interval_ms = 0;
// 0 until the window closes; then window-close + ST_GRACE_S, so events that
// arrive right after closure (the modem catching up once the pager stays
// awake) are still recorded, and the deliberate restart waits for them and
// their acks instead of cutting them off.
static volatile int64_t s_st_grace_until_us = 0;
#define ST_GRACE_S 25
// Coordinator addendum, 2026-09-24: the flight recorder (flightrec.h) lives
// in PSRAM, which survives light sleep, but not a reset -- the old
// unconditional "print the report, wait 3s, watchdog_hard_reset()" post-
// window sequence would destroy it before anyone could type `flightrec`.
// When the window's recorder holds >0 records, hold awake (no light sleep;
// skip_sleep is already forced true for the whole post-window period, see
// the `if (!sleeptest_active())` block below) for ST_HOLD_S instead of
// resetting immediately, printing a status line every
// ST_HOLD_PRINT_INTERVAL_S so the operator knows both that a dump is
// available and how long they have left -- the console `flightrec` command
// works throughout (its task is independent of this one). 0 records: today's
// behaviour (report, 3s, reset) is unchanged.
static int64_t s_st_hold_until_us = 0;
static int64_t s_st_hold_last_print_us = 0;
#define ST_HOLD_S (15 * 60)
#define ST_HOLD_PRINT_INTERVAL_S 60
static uint32_t s_st_sleeps = 0, s_st_wake_timer = 0, s_st_wake_other = 0;
// Rail hold task: wakes whose net_sleep() interval was the attentive 1 s
// cadence rather than the normal SLEEP/ACTIVE/UNREGISTERED one -- lets a
// bench window prove the cadence actually engaged.
static uint32_t s_st_wake_attentive = 0;
// Rail gate (docs/ROADMAP.md, owner 24 Sep 10:30 pm PDT): how many of this
// window's sleeps went in with the 3V3 rail off vs. kept on (the attentive
// window) -- counted at the same rail-decision call site that drives
// rail_off()/rail_on(), so off_sleeps + kept_on_sleeps == s_st_sleeps.
static uint32_t s_st_rail_off_sleeps = 0, s_st_rail_kept_on_sleeps = 0;
// TASK_ui_round2.md Do #4 (lazy rail): how many wakes brought the rail up
// via rule (b) — an EXT1 wake cause — counted at that wake-path call
// site (modes_run()). The complementary "lazy_on" count (rule (c), a render
// that needed the rail up on its own, e.g. a page arriving on a timer wake)
// is ui.c's own free-running ui_rail_lazy_on_count(), not window-scoped like
// this one (ui.c has no sleeptest-window-reset hook) — both are printed
// together in the "rail:" report line below.
static uint32_t s_st_rail_on_wakes = 0;
// Where the awake time goes, per wake: cumulative microseconds per loop segment.
// S0 (docs/SLEEP_URC_DESIGN.md §1 item 4): bucket 0 used to be charged both
// the post-wake yield of iterations that actually called net_sleep() AND the
// whole ST_MARK(7)->ST_MARK(0/1) span of iterations that skipped it (loop
// top, the skipped net_sleep(), the 20/100 ms poll delay) -- two different
// things sharing one bucket, and every bucket's printed avg divided by
// s_st_sleeps (the sleep-only count) even for buckets that run on every
// iteration. Split into two buckets (index 0 = post-wake yield, sleeping
// iterations only; index 1 = awake-loop (no sleep), skip_sleep iterations
// only) and give every bucket its own sample count (s_st_seg_n) so avg
// divides by the count that actually contributed to it.
#define ST_SEG_N 8
static const char *const k_st_seg_name[ST_SEG_N] = { "post-wake yield", "awake-loop (no sleep)",
                                                    "input+ui+render", "mqtt status/retry",
                                                    "msg_pump+health", "accel+loc", "sms",
                                                    "catrust+heartbeat+rtc_save" };
static int64_t s_st_seg_us[ST_SEG_N];
static int64_t s_st_seg_max_us[ST_SEG_N];
static uint32_t s_st_seg_n[ST_SEG_N];
// Longest single iteration's total awake work (sum of that iteration's own
// segment spans, i.e. excluding the actual light-sleep duration) -- S0's
// "longest single iteration" summary line.
static int64_t s_st_iter_max_us = 0;
// S1 / RCA_SLEEP_URC.md fix 1's discriminator: bytes buffered in the modem
// UART's RX ring 50 ms after each wake.
static uint32_t s_st_wake_bytes_max = 0;
static uint32_t s_st_wake_bytes_nonzero = 0;
static int64_t s_st_mark_us = 0;
// Raw per-cycle timestamps for the first cycles: esp_timer before and after
// net_sleep(), and the RTC's own clock across the same call, to tell real
// sleep from time spent entering/leaving it.
#define ST_CYC_MAX 10
typedef struct { int64_t before_us, after_us, rtc_before_us, rtc_after_us; } st_cycle_t;
static st_cycle_t s_st_cyc[ST_CYC_MAX];
static uint32_t s_st_ncyc = 0;
#define ST_MARK_BEGIN() do { s_st_mark_us = esp_timer_get_time(); } while (0)
#define ST_MARK(i)                                                                                  \
    do {                                                                                            \
        if (sleeptest_active_flag()) {                                                              \
            int64_t _n = esp_timer_get_time();                                                      \
            int64_t _d = _n - s_st_mark_us;                                                         \
            s_st_seg_us[i] += _d;                                                                   \
            s_st_seg_n[i]++;                                                                        \
            if (_d > s_st_seg_max_us[i]) s_st_seg_max_us[i] = _d;                                   \
            s_st_mark_us = _n;                                                                      \
        }                                                                                           \
    } while (0)
static bool sleeptest_active_flag(void);
static int64_t s_st_asleep_us = 0;

static bool sleeptest_active(void);
static bool sleeptest_active_flag(void) { return sleeptest_active(); }

static bool sleeptest_active(void)
{
    return s_st_until_us != 0 && esp_timer_get_time() < s_st_until_us;
}

// True during the window itself AND during the ST_GRACE_S after it closes
// (once armed by modes_run() -- see the !sleeptest_active() block there).
// sleeptest_note() uses this instead of sleeptest_active() so a URC that
// only arrives once the pager stays fully awake after closure is still
// recorded, not silently dropped.
static bool sleeptest_recording(void)
{
    if (s_st_grace_until_us != 0) {
        return esp_timer_get_time() < s_st_grace_until_us;
    }
    return sleeptest_active();
}

static void sleeptest_note(char kind, int32_t a, const char *id)
{
    if (!sleeptest_recording() || s_st_n_events >= ST_EVENTS_MAX) {
        return;
    }
    st_event_t *e = &s_st_events[s_st_n_events];
    e->t_s = (int32_t) ((esp_timer_get_time() - s_st_start_us) / 1000000);
    e->kind = kind;
    e->a = a;
    e->after_window = !sleeptest_active();
    snprintf(e->id, sizeof(e->id), "%s", id ? id : "");
    s_st_n_events = s_st_n_events + 1;
}

void modes_debug_sleeptest_start(uint32_t minutes, uint32_t yield_ms_override,
                                 uint32_t interval_ms_override, uint32_t probe_wait_ms_override,
                                 uint32_t wake0_ms)
{
    s_st_wake0_ms = wake0_ms;
    // flightrec.h: a no-op outside a debug build (it always is one here,
    // this whole function is PAGER_DEBUG_NO_LIGHT_SLEEP-only) -- starts a
    // fresh recording so ordinary boot/idle traffic before this point was
    // never captured.
    flightrec_clear();
    flightrec_set_recording(true);
    s_st_n_events = 0;
    s_st_sleeps = s_st_wake_timer = s_st_wake_other = 0;
    s_st_wake_attentive = 0;
    s_st_rail_off_sleeps = s_st_rail_kept_on_sleeps = 0;
    s_st_rail_on_wakes = 0;
    s_st_asleep_us = 0;
    s_st_ncyc = 0;
    s_st_mark_us = esp_timer_get_time();
    memset(s_st_seg_us, 0, sizeof(s_st_seg_us));
    memset(s_st_seg_max_us, 0, sizeof(s_st_seg_max_us));
    memset(s_st_seg_n, 0, sizeof(s_st_seg_n));
    s_st_iter_max_us = 0;
    s_st_wake_bytes_max = 0;
    s_st_wake_bytes_nonzero = 0;
    s_st_start_us = esp_timer_get_time();
    s_st_until_us = s_st_start_us + (int64_t) minutes * 60 * 1000000;
    s_st_grace_until_us = 0;
    s_st_yield_ms = yield_ms_override;
    s_st_interval_ms = interval_ms_override;
    s_probe_wait_ms_override = probe_wait_ms_override;
    disp_reset_refresh_stats(); // so this window's report is only this window's refreshes
    s_probe_wait_n = s_probe_wait_giveups = 0;
    s_probe_wait_total_us = s_probe_wait_max_us = 0;
    s_st_report_due = true;
    // The AT trace is hundreds of lines a minute, and a USB console with no
    // host listening (the port dies in light sleep) can stall each write;
    // that would stretch the short wake window this test is measuring.
    esp_log_level_set("WalterModem", ESP_LOG_WARN);
    ESP_LOGI(TAG,
             "sleeptest: light sleep ENABLED for %u min (yield=%u ms, interval=%u ms, "
             "wake0_ms=%u, 0=build default/untouched). The USB log goes quiet now. Send pages; "
             "a report prints %u s after the window closes.",
             (unsigned) minutes, (unsigned) yield_ms_override, (unsigned) interval_ms_override,
             (unsigned) wake0_ms, (unsigned) ST_GRACE_S);
}

// The report as text, so it can be kept in NVS: after a sleep window the USB
// port often does not re-enumerate until the pager is reset, and a reset
// would otherwise lose everything that was recorded.
// RCA_SLEEP_PUBLISH.md §3: raised from 1800 to 2400 for the ~400 chars the
// four library counters and the 12-entry publish ring add below.
// S0: raised from 2400 to 2800 for the new "awake-loop (no sleep)" bucket
// line, the "(n=%u)" suffix added to all eight bucket lines, and the new
// "awake total ... longest single iteration ..." summary line.
// S18: raised from 2800 to 2950 for the new "probe answer:" line.
// phaseBG-report.log fix: raised from 2950 to 3050 for the new "resub
// holds:" line.
// disp refresh-count instrumentation: raised from 3050 to 3350 for the new
// "disp refreshes:" line, whose ring can add up to 8 * "F@4294967295/255 "
// (~19 chars each).
// Rail gate instrumentation: raised from 3350 to 3450 for the new "rail:"
// line.
static char s_st_text[3450];

static void st_appendf(size_t *n, const char *fmt, ...)
{
    if (*n >= sizeof(s_st_text) - 1) {
        return;
    }
    va_list ap;
    va_start(ap, fmt);
    int w = vsnprintf(s_st_text + *n, sizeof(s_st_text) - *n, fmt, ap);
    va_end(ap);
    if (w > 0) {
        *n += (size_t) w;
        if (*n > sizeof(s_st_text) - 1) {
            *n = sizeof(s_st_text) - 1;
        }
    }
}

static void sleeptest_save(void)
{
    nvs_handle_t h;
    if (nvs_open("dbg", NVS_READWRITE, &h) != ESP_OK) {
        return;
    }
    nvs_set_str(h, "sleeprep", s_st_text);
    nvs_commit(h);
    nvs_close(h);
}

static void modes_debug_sleeptest_print_saved(void)
{
    nvs_handle_t h;
    if (nvs_open("dbg", NVS_READONLY, &h) != ESP_OK) {
        return;
    }
    size_t len = sizeof(s_st_text);
    if (nvs_get_str(h, "sleeprep", s_st_text, &len) == ESP_OK && s_st_text[0]) {
        ESP_LOGI(TAG, "saved sleeptest report from before this boot:\n%s", s_st_text);
    }
    nvs_close(h);
}

void modes_debug_sleeptest_report(void)
{
    if (s_st_start_us == 0) {
        ESP_LOGI(TAG, "sleeptest: no window has been run since boot");
        modes_debug_sleeptest_print_saved();
        return;
    }
    size_t n = 0;
    int64_t now = esp_timer_get_time();
    int64_t end = (now < s_st_until_us) ? now : s_st_until_us;
    int64_t span_us = end - s_st_start_us;
    st_appendf(&n, "window %lld s%s, yield=%u ms interval=%u ms (0=build default), %u light sleeps, "
                    "asleep %lld s (%d%%), wakes: %u timer / %u other, attentive wakes: %u\n",
               (long long) (span_us / 1000000), (now < s_st_until_us) ? " (still open)" : "",
               (unsigned) s_st_yield_ms, (unsigned) s_st_interval_ms, (unsigned) s_st_sleeps,
               (long long) (s_st_asleep_us / 1000000),
               span_us > 0 ? (int) (s_st_asleep_us * 100 / span_us) : 0, (unsigned) s_st_wake_timer,
               (unsigned) s_st_wake_other, (unsigned) s_st_wake_attentive);
    // S0: avg now divides by the count that actually contributed to that
    // bucket (s_st_seg_n[i]), not s_st_sleeps -- buckets 2-7 run on every
    // iteration (sleep or not), while bucket 0 (post-wake yield) only runs
    // on iterations that slept and bucket 1 (awake-loop) only on iterations
    // that did not. A bucket with no samples yet is skipped rather than
    // dividing by zero.
    int64_t st_awake_total_us = 0;
    for (int i = 0; i < ST_SEG_N; i++) {
        st_awake_total_us += s_st_seg_us[i];
        if (s_st_seg_n[i] == 0) {
            continue;
        }
        st_appendf(&n, "  awake in %-28s avg %5lld ms/wake, max %5lld ms  (n=%u)\n", k_st_seg_name[i],
                   (long long) (s_st_seg_us[i] / 1000 / s_st_seg_n[i]),
                   (long long) (s_st_seg_max_us[i] / 1000), (unsigned) s_st_seg_n[i]);
    }
    // Bucket 2 ("input+ui+render") runs unconditionally on every loop
    // iteration, sleeping or not, so its sample count is the total
    // iteration count; bucket 1's count is how many of those did not sleep.
    st_appendf(&n, "  awake total %lld s over %u iterations (%u without a sleep); longest single "
                    "iteration %lld ms\n",
               (long long) (st_awake_total_us / 1000000), (unsigned) s_st_seg_n[2],
               (unsigned) s_st_seg_n[1], (long long) (s_st_iter_max_us / 1000));
    for (uint32_t i = 0; i < s_st_ncyc; i++) {
        const st_cycle_t *c = &s_st_cyc[i];
        st_appendf(&n, "  cycle %u: net_sleep %lld ms by esp_timer, %lld ms by the RTC; awake before it %lld ms\n",
                   (unsigned) i, (long long) ((c->after_us - c->before_us) / 1000),
                   (long long) ((c->rtc_after_us - c->rtc_before_us) / 1000),
                   i ? (long long) ((c->before_us - s_st_cyc[i - 1].after_us) / 1000) : 0LL);
    }
    uint32_t ne = s_st_n_events;
    for (uint32_t i = 0; i < ne; i++) {
        const st_event_t *e = &s_st_events[i];
        switch (e->kind) {
        case 'M':
            st_appendf(&n, "  +%4d s  page %s received, %d s after the relay stamped it%s\n", (int) e->t_s,
                       e->id, (int) e->a, e->after_window ? "  (after the window closed)" : "");
            break;
        case 'D':
            st_appendf(&n, "  +%4d s  duplicate of %s (a re-publish)%s\n", (int) e->t_s, e->id,
                       e->after_window ? "  (after the window closed)" : "");
            break;
        case 'X':
            st_appendf(&n, "  +%4d s  malformed /down dropped\n", (int) e->t_s);
            break;
        case 'C':
            st_appendf(&n, "  +%4d s  MQTT session (re)connected\n", (int) e->t_s);
            break;
        case 'L':
            st_appendf(&n, "  +%4d s  MQTT session LOST (rc=%d)\n", (int) e->t_s, (int) e->a);
            break;
        default:
            break;
        }
    }
    if (ne == 0) {
        st_appendf(&n, "  no events: nothing was received during the window or the %u s after it closed\n",
                   (unsigned) ST_GRACE_S);
    }
    // RCA_SLEEP_PUBLISH.md §3 instrumentation: the vendored library's four
    // "orphaned prompt" counters (PATCHES.md 1.12) and xport_lte.cpp's
    // publish ring, appended so a bench run's evidence survives the
    // USB-dead sleep window -- this text (not just the log line below) is
    // what sleeptest_save() writes to NVS.
    net_pager_counters_t pc = net_get_pager_counters();
    // S7b post-mortem (docs/SLEEP_URC_DESIGN.md §9): modem_resets is the F4
    // counter g_rtc already keeps (rate_limited_modem_recover()). Printing it
    // here is what turns "an F4 must have run inside this window, because the
    // probe counters do not otherwise add up" into a reading.
    // Patch 1.18 (docs/SLEEP_PAGE_LOSS_BRIEF.md, build/bench-logs/
    // phaseBB-report.log c01/c08): glitch_dropped counts the stray leading
    // 0xFF _parseRxData() now drops on every wake, printed here so a bench
    // run's evidence survives the USB-dead light-sleep window like the rest
    // of this line.
    st_appendf(&n, "modem counters: datatx_retx=%u prompt_orphan=%u buf_drop_queue=%u buf_drop_pool=%u "
                    "modem_resets=%u glitch_dropped=%u\n",
               (unsigned) pc.datatx_retx, (unsigned) pc.prompt_orphan, (unsigned) pc.buf_drop_queue,
               (unsigned) pc.buf_drop_pool, (unsigned) g_rtc.modem_resets, (unsigned) pc.glitch_dropped);
    // S3 (patch 1.13, docs/RCA_SLEEP_URC.md §5 fix 3-4): attribution for the
    // two 30s stalls fix 1's arithmetic could not tell apart -- which write
    // path actually moved bytes, whether uart_wait_tx_done() ever timed out,
    // and which command was outstanding the last time one ran >= 5s.
    st_appendf(&n, "tx counters: prompt_handled=%u payload_bytes_written=%u txdone_timeouts=%u\n",
               (unsigned) pc.prompt_handled, (unsigned) pc.payload_bytes_written,
               (unsigned) pc.txdone_timeouts);
    if (pc.stall_cmd[0] != '\0') {
        st_appendf(&n, "stalled command: \"%.24s\" elapsed=%u ms cts=%d tx_ring_free=%u B\n",
                   pc.stall_cmd, (unsigned) pc.stall_elapsed_ms, (int) pc.stall_cts_level,
                   (unsigned) pc.stall_tx_ring_bytes);
    }
    // S1: the URC drain probe's own counters, next to the modem counters
    // above, plus RCA_SLEEP_URC.md fix 1's discriminator (bytes buffered in
    // the modem UART's RX ring, sampled 50 ms after each wake).
    net_probe_counters_t probec = net_get_probe_counters();
    // S7b post-mortem: skip_busy/skip_down are cumulative since BOOT and are
    // deliberately not cleared by net_recover_modem()'s net_probe_guard_init(),
    // unlike the four above -- `probe_issued=0 probe_answered=2` was only
    // explainable by an F4 reset zeroing the first four while probes were
    // still live in the library, and these two are what makes that readable
    // without the arithmetic (docs/SLEEP_URC_DESIGN.md §9).
    st_appendf(&n, "probe counters: probe_issued=%u probe_answered=%u probe_stuck=%u probe_noqueue=%u "
                    "probe_timedout=%u probe_skip_busy=%u probe_skip_down=%u\n",
               (unsigned) probec.issued, (unsigned) probec.answered, (unsigned) probec.stuck,
               (unsigned) probec.noqueue, (unsigned) probec.timedout, (unsigned) probec.skip_busy,
               (unsigned) probec.skip_down);
    // S10 (docs/SLEEP_URC_DESIGN.md §8.2, docs/SLEEP_URC_TASKS.md S10): three
    // counters, not a trace -- light sleep kills the USB CDC, so this is what
    // has to settle the stall mechanism. rsp_no_cmd/payload_stuck_ms come
    // from the vendored library (WalterDefines.h); probe_first_attempt_ms
    // from the probe's own issue-to-answer timing (net.cpp). See each field's
    // doc comment in net.h for what each hypothesis predicts.
    // wdt-stage8 (PATCHES.md 1.19): rsp_stale_cmd printed right after
    // rsp_no_cmd -- a non-zero count is direct confirmation the 1.19 fix
    // actually fired (a response that would otherwise have re-finished an
    // already-finished command and wedged the slot).
    st_appendf(&n, "stall discriminator: rsp_no_cmd=%u rsp_stale_cmd=%u payload_stuck_ms=%u "
                    "probe_first_attempt_ms=%u\n",
               (unsigned) pc.rsp_no_cmd, (unsigned) pc.rsp_stale_cmd, (unsigned) pc.payload_stuck_ms,
               (unsigned) probec.first_attempt_ms);
    // S18 (docs/SLEEP_URC_DESIGN.md §10). probe_answer_ms is the number the
    // wake-window length is chosen from and it has never been measured:
    // unlike probe_first_attempt_ms above it is recorded only on the
    // ANSWERED branch, with a max and a count. wait_* is what that answer
    // latency cost in awake time -- avg/max per wake that actually waited,
    // plus how many hit the bound without an answer (cheap: the guard still
    // owns the probe, nothing is reset).
    st_appendf(&n, "probe answer: answer_ms last=%u max=%u n=%u; wait avg=%lld ms max=%lld ms n=%u "
                    "gaveup=%u\n",
               (unsigned) probec.answer_ms_last, (unsigned) probec.answer_ms_max,
               (unsigned) probec.answer_n,
               (long long) (s_probe_wait_n ? (s_probe_wait_total_us / 1000 / s_probe_wait_n) : 0),
               (long long) (s_probe_wait_max_us / 1000), (unsigned) s_probe_wait_n,
               (unsigned) s_probe_wait_giveups);
    st_appendf(&n, "post-wake UART bytes (50ms sample): max=%u wakes_with_bytes=%u\n",
               (unsigned) s_st_wake_bytes_max, (unsigned) s_st_wake_bytes_nonzero);
    // S2 (docs/SLEEP_URC_DESIGN.md §6): how often a liveness ping's first
    // re-SUBSCRIBE was swallowed (rescued by downlink proof or a second
    // re-SUBSCRIBE, never by a teardown) -- zero MQTT session LOST lines
    // alongside a non-zero count here is this fix working.
    st_appendf(&n, "resub_first_swallowed=%u\n", (unsigned) net_get_resub_swallowed_count());
    // phaseBG-report.log fix (net_resub_hold(), net.h): holds/max_hold_ms/
    // suback_in_hold let a bench run confirm the hold actually caught the
    // SUBACK instead of just burning 3s every liveness cycle -- suback_in_hold
    // approaching holds, alongside zero new `MQTT session LOST` lines, is this
    // fix working.
    uint32_t resub_holds = 0, resub_hold_max_ms = 0, resub_suback_in_hold = 0;
    net_get_resub_hold_stats(&resub_holds, &resub_hold_max_ms, &resub_suback_in_hold);
    st_appendf(&n, "resub holds: %u, max hold ms: %u, suback in hold: %u\n", (unsigned) resub_holds,
               (unsigned) resub_hold_max_ms, (unsigned) resub_suback_in_hold);
    // S12 (docs/SLEEP_URC_DESIGN.md §8.3, docs/SLEEP_URC_TASKS.md S12): so
    // "the panel wedged" is this number, not an inference from a bucket max
    // (phaseAF's `input+ui+render max 31551 ms` used to be the only clue).
    st_appendf(&n, "disp_busy_timeout_count=%u\n", (unsigned) disp_busy_timeout_count());
    // Bench instrumentation: attributes unexplained full refreshes (see
    // disp.h's own comment on disp_get_refresh_stats()/
    // disp_refresh_ring_format()) instead of just counting the 3.4s events.
    {
        uint32_t disp_full = 0, disp_partial = 0, disp_upgraded = 0;
        disp_get_refresh_stats(&disp_full, &disp_partial, &disp_upgraded);
        char ring_str[160];
        disp_refresh_ring_format(ring_str, sizeof(ring_str));
        st_appendf(&n, "disp refreshes: full=%u partial=%u upgraded=%u; last: %s\n", (unsigned) disp_full,
                   (unsigned) disp_partial, (unsigned) disp_upgraded, ring_str);
    }
    // Rail gate (docs/ROADMAP.md, owner 24 Sep 10:30 pm PDT): off_sleeps +
    // kept_on_sleeps should equal the `light sleeps` count in the summary
    // line above; kb_skipped_reads is ui.c's own count of rail-restore
    // edges whose CardKB boot guard the kbd task waited out
    // (ui_kb_skipped_read_count(), ui.h). kb_bus_releases (owner, 24 Sep 11:15 pm PDT
    // fix) is ui_kb_bus_release_count() — should track off_sleeps 1:1 (one
    // release per rail_off() edge, ui.c/rail.c). on_wakes/lazy_on
    // (TASK_ui_round2.md Do #4, the lazy-rail rewrite): on_wakes is this
    // window's count of EXT1 wakes that brought the rail up (rule (b),
    // this file's own wake-path comment); lazy_on is ui.c's free-running
    // ui_rail_lazy_on_count() (rule (c), a render that needed the rail up on
    // its own — not window-scoped, so it only reads zero here if none have
    // happened since boot, not since this window opened).
    st_appendf(&n, "rail: off_sleeps=%u kept_on_sleeps=%u kb_skipped_reads=%u kb_bus_releases=%u "
                    "on_wakes=%u lazy_on=%u\n",
               (unsigned) s_st_rail_off_sleeps, (unsigned) s_st_rail_kept_on_sleeps,
               (unsigned) ui_kb_skipped_read_count(), (unsigned) ui_kb_bus_release_count(),
               (unsigned) s_st_rail_on_wakes, (unsigned) ui_rail_lazy_on_count());
    net_publish_ring_entry_t ring[NET_PUBLISH_RING_MAX];
    uint32_t nring = net_get_publish_ring(ring, NET_PUBLISH_RING_MAX);
    if (nring == 0) {
        st_appendf(&n, "publish ring: empty\n");
    } else {
        st_appendf(&n, "publish ring (%u entr%s, oldest first):\n", (unsigned) nring, nring == 1 ? "y" : "ies");
        for (uint32_t i = 0; i < nring; i++) {
            const net_publish_ring_entry_t *r = &ring[i];
            const char *outcome = (r->outcome == NET_PUBLISH_RING_OK)        ? "OK"
                                  : (r->outcome == NET_PUBLISH_RING_TIMEOUT) ? "TIMEOUT"
                                                                              : "ERROR";
            st_appendf(&n, "  +%4d s  ...%-7s %4u B  %-7s %4u ms\n",
                       (int) ((r->issued_us - s_st_start_us) / 1000000), r->topic_tail, (unsigned) r->len,
                       outcome, (unsigned) r->elapsed_ms);
        }
    }
    ESP_LOGI(TAG, "sleeptest report:\n%s", s_st_text);
    if (now >= s_st_until_us) {
        sleeptest_save(); // power effect: one NVS write, debug build only
    }
}
#endif // PAGER_DEBUG_NO_LIGHT_SLEEP

// ---------------------------------------------------------------------------
// Incoming message hook — wired to msg.c's ingest/dedup/ack state machine.
// ---------------------------------------------------------------------------

// v0.2 §6 (device-direct SMS, sms.c): factored out of handle_ingest_result()'s
// MSG_INGEST_NEW branch below so sms.c's own inbound-SMS path (an
// allow-listed sender, msg_insert_sms_in() already run) can alert exactly
// the same way a real `/down` message does, including the lock-screen rule,
// without duplicating this logic or (worse) sms.c reaching into modes.c's
// static render_pending_set()/set_mode() directly. See modes.h's own doc
// comment for the full contract.
// Carrier new-message alert (buzzer + haptic): set on the modem event task, serviced on the modes
// loop task next to service_render_pending(). Fires whether or not the device is locked.
static bool s_alert_pending = false;

// Modes loop task. Power effect: powers the rail (CardKB/haptic/panel) if it was off, a ~150 ms piezo
// chirp and two haptic clicks; nothing on the breadboard.
static bool s_haptic_pending = false; // modes loop task only: haptic waits for the kbd/rail boot guard

static void service_alert_pending(void)
{
    if (__atomic_exchange_n(&s_alert_pending, false, __ATOMIC_ACQ_REL) &&
        (board_has_piezo() || board_has_haptic())) {
        ui_ensure_powered();
        buzzer_play(BUZZ_NEW_MSG); // buzzer plays at once
        s_haptic_pending = board_has_haptic();
    }
    if (s_haptic_pending) {
        if (!rail_is_on()) {
            s_haptic_pending = false; // rail went off first: drop it
        } else if (esp_timer_get_time() >= ui_kb_ready_us()) {
            s_haptic_pending = false;
            haptic_play(HAPTIC_NEW_MSG);
        }
    }
}

void modes_alert_incoming(const char *id, const char *from)
{
    __atomic_store_n(&s_alert_pending, true, __ATOMIC_RELEASE);
    // Captured BEFORE set_mode(ACTIVE, ...) below flips it — this is the
    // "was the device asleep" input ui_incoming()'s steal-the-screen policy
    // needs (docs/DEVICE_PLAN.md §5.5). Unlocked read of g_rtc.mode, same as
    // several other spots in this file already do.
    bool was_asleep = (g_rtc.mode == (uint8_t) PAGER_MODE_SLEEP);
    set_mode(PAGER_MODE_ACTIVE, MODE_REASON_INCOMING_MSG);
    // F6.5 (docs/DEVICE_PLAN.md §5.8): "no `shown` is published" for a body
    // received while locked — the message is already inserted into msg.c's
    // s_thread by the caller regardless; skipping render_pending_set() here
    // is what keeps it that way, rather than relying on ui_incoming()'s own
    // screen-top check (was_asleep alone would otherwise force the "steal"
    // branch and push Chat right over the Locked screen — see
    // ui_incoming()'s `steal = was_asleep || ...`). msg_mark_all_unshown()
    // (scr_lock.c, on a successful unlock) is what eventually surfaces
    // these; for sms.c's own callers that call is a no-op for this id
    // (ack_state is already MSG_ACK_READ, never MSG_ACK_UNSHOWN) but still
    // correctly surfaces the render on unlock via ui_incoming()'s own
    // "whole thread" redraw.
    if (id && id[0] != '\0' && !lock_is_locked()) {
        render_pending_set(id, from ? from : "", was_asleep);
    }
}

static void handle_ingest_result(msg_ingest_t r, const msg_t *out, uint16_t len,
                                  const uint8_t *body)
{
    switch (r) {
    case MSG_INGEST_NEW: {
        // Copy the id/from BEFORE handing off. `out` points into msg.c's
        // s_thread ring, which thread_insert_locked() memmoves on every
        // insert; a reply submitted from modes_run()'s task while this is
        // in flight would shift s_thread[0] and make out->id the reply's
        // "u_..." id, acking a message the relay has never heard of (§4.1
        // rule 3) and leaving the real down message un-acked forever.
        char id[MSG_ID_MAX] = "";
        char from[MSG_FROM_MAX] = "";
        if (out) {
            strncpy(id, out->id, sizeof(id) - 1);
            strncpy(from, out->from, sizeof(from) - 1);
        }
#ifdef PAGER_DEBUG_NO_LIGHT_SLEEP
        {
            int64_t now_s = 0;
            int32_t lat = -1;
            if (out && net_get_clock(&now_s) && out->ts > 0) {
                lat = (int32_t) (now_s - out->ts);
            }
            sleeptest_note('M', lat, id);
            flightrec_event('M', lat, 0);
        }
#endif
        modes_alert_incoming(id, from);
        break;
    }

    case MSG_INGEST_DUPLICATE: {
#ifdef PAGER_DEBUG_NO_LIGHT_SLEEP
        sleeptest_note('D', 0, out ? out->id : msg_last_ingest_id());
#endif
        // §4.1 rule 7: re-ack only, MUST NOT re-render/re-alert/re-enter
        // active mode. *out is NULL if the entry already scrolled out of
        // the 10-deep RAM thread (routine: the 16-deep dedup ring is
        // intentionally wider) - fall back to the id msg.c just parsed.
        // F6.5: while locked, a duplicate re-delivery of a body this device
        // never displayed (§5.8) must not be re-acked either — same rule as
        // the MSG_INGEST_NEW branch above, just for the relay's retry of a
        // message it never got a `shown` for the first time either.
        const char *id = out ? out->id : msg_last_ingest_id();
        if (id[0] != '\0' && !lock_is_locked()) {
            if (out && out->ack_state == MSG_ACK_READ) {
                msg_mark_read(id);
            } else {
                msg_mark_shown(id);
            }
        }
        break;
    }

    case MSG_INGEST_MALFORMED:
    default:
#ifdef PAGER_DEBUG_NO_LIGHT_SLEEP
        sleeptest_note('X', 0, "");
#endif
        // §3.4: log, count (already counted by whichever of
        // msg_ingest_down_cbor()/msg_count_malformed() rejected it), do not
        // ack, do not render, do not reboot.
        // v0.2 bug fix #6 (docs/V02_DESIGN.md §2.6): this was ESP_LOGD, which
        // meant a run of malformed drops was invisible unless debug logging
        // was already on — "cost an evening" on real hardware. INFO plus the
        // length and first byte gives enough to tell "truncated CBOR" from
        // "not CBOR at all" without turning on full chatter. No power/modem
        // effect: logging only.
        ESP_LOGI(TAG, "malformed down message dropped (%u bytes, first byte 0x%02x)",
                 (unsigned) len, (unsigned) ((len > 0 && body) ? body[0] : 0));
        break;
    }
}

// F3.6 (docs/PROTOCOL.md §14.3/§14.4), F6.4 (docs/DEVICE_PLAN.md H14 "CBOR
// for devices"): every device decodes CBOR now — the JSON/cJSON RX path
// that used to cover req_sig==0 devices is gone (cJSON dropped from
// CMakeLists.txt entirely). auth_verify() still only runs when ident's
// IDENT_FLAG_REQ_SIG is set; msg_ingest_down_cbor() itself only requires
// the `n` replay counter (and checks the replay window) in that same case
// — see its own doc comment in msg.h. No modem or sleep-state effect: pure
// computation on the already-received buffer.
static void on_incoming_message(const char *topic, const char *body, uint16_t len)
{
    bool req_sig = (ident_get_flags() & IDENT_FLAG_REQ_SIG) != 0;
    size_t vlen = len;

    if (req_sig) {
        // `body` points at net.cpp's own static RX buffer (s_mqtt_rx_buf):
        // mutable memory exposed through this callback's const-qualified
        // parameter. Nothing else touches it while this callback runs
        // (net.cpp's s_handler_busy guard covers exactly this window), so
        // trimming the trailing `sig` suffix in place here is safe.
        if (!auth_verify(topic, (uint8_t *) (uintptr_t) body, &vlen)) {
            msg_count_malformed();
            ESP_LOGD(TAG,
                     "signature verify failed on %s (%u bytes) - dropped, not acked (§3.4/§14.3)",
                     topic, (unsigned) len);
            return;
        }
    }

    // F6.5/v0.2 §4.4 (docs/PROTOCOL.md §3.2/§5.8, docs/V02_DESIGN.md §4.4):
    // `cfg` is not a content message — it has neither `from` nor `body`,
    // which msg_ingest_down_cbor() below requires — so it must be
    // intercepted here, before that call, exactly like auth_verify() already
    // gates what reaches it. cfg.c's cfg_ingest_cbor() decodes the envelope
    // once and dispatches whichever of `lock`/`ca` sub-maps it carries (a
    // single push can carry both) to lock.c/catrust.c respectively. Returns
    // true only for a well-formed `kind:"cfg"` envelope; false covers both
    // "not cfg" and "cfg but malformed", both of which correctly fall
    // through to the normal path below (msg.c's own MSG_INGEST_MALFORMED
    // handling covers the latter).
    if (cfg_ingest_cbor((const uint8_t *) body, (uint16_t) vlen)) {
        return;
    }

    // F7.1 (docs/DEVICE_PLAN.md §4.3, docs/PROTOCOL.md §3.2): `book` is the
    // other non-content down kind — same "neither `from` nor `body`" reason
    // `cfg` is intercepted above, before msg_ingest_down_cbor() ever sees it.
    // Returns true only for a well-formed `kind:"book"` envelope (applied +
    // acked already); false covers both "not book" and "book but
    // malformed", both of which correctly fall through to the normal path
    // below.
    if (book_ingest_cbor((const uint8_t *) body, (uint16_t) vlen)) {
        return;
    }

    // v0.2 §5 (docs/PROTOCOL.md §3.2/§13, docs/V02_DESIGN.md §5): `loc_req`
    // is the third non-content down kind — same "neither `from` nor `body`"
    // reason `cfg`/`book` are intercepted above, before
    // msg_ingest_down_cbor() ever sees it. Never a thread entry, never
    // shown/read-acked, answered regardless of lock state or mode
    // (loc_ingest_req_cbor() itself never touches ui.c/set_mode() — see
    // loc.h's own doc comment). Returns true only for a well-formed
    // `kind:"loc_req"` envelope (queued/answered/started already); false
    // covers both "not loc_req" and "loc_req but malformed", both of which
    // correctly fall through to the normal path below.
    if (loc_ingest_req_cbor((const uint8_t *) body, (uint16_t) vlen)) {
        return;
    }

    const msg_t *out = NULL;
    msg_ingest_t r = msg_ingest_down_cbor((const uint8_t *) body, (uint16_t) vlen, &out);
    handle_ingest_result(r, out, (uint16_t) vlen, (const uint8_t *) body);
}

// ---------------------------------------------------------------------------
// F1/F3: MQTT session backoff
// ---------------------------------------------------------------------------

static void schedule_backoff(uint32_t *backoff_index, int64_t *next_retry_us)
{
    uint32_t idx = *backoff_index;
    uint32_t delay_s = k_backoff_s[idx < PAGER_BACKOFF_STEPS ? idx : PAGER_BACKOFF_STEPS - 1];
    *next_retry_us = esp_timer_get_time() + (int64_t) delay_s * 1000000;
    if (idx < PAGER_BACKOFF_STEPS) {
        (*backoff_index)++;
    }
}

static void pin_to_steady_backoff(uint32_t *backoff_index, int64_t *next_retry_us)
{
    *backoff_index = PAGER_BACKOFF_STEPS; // steady 300s from here on
    *next_retry_us = esp_timer_get_time() + (int64_t) k_backoff_s[PAGER_BACKOFF_STEPS - 1] * 1000000;
}

static void handle_mqtt_loss(const net_mqtt_status_t *st, uint32_t *backoff_index,
                              int64_t *next_retry_us)
{
    switch (st->last_class) {
    case NET_MQTT_RC_PERMANENT:
        ESP_LOGI(TAG, "MQTT permanently refused (rc=%d): CONN_REFUSED/AUTH/ACL_DENIED - "
                      "steady 300s backoff, check broker credentials/ACLs",
                 st->last_rc);
        pin_to_steady_backoff(backoff_index, next_retry_us);
        break;
    case NET_MQTT_RC_TLS_FAIL: {
        // v0.2 §4.2 (docs/V02_DESIGN.md, docs/V02_DESIGN.md §4.2): a
        // pinned device gets one more validated attempt before falling back
        // to unvalidated (state -> broken) — "no CA problem may ever stop
        // pages arriving" (§0), so both of those cases use the ordinary
        // backoff schedule, not the steady 300s this branch used
        // unconditionally before. The steady 300s reasoning ("provisioning
        // bug") only still holds where there is nothing left to fall back to:
        // already unpinned, or already broken and still failing TLS.
        if (catrust_apply_in_progress()) {
            // A two-phase CA-push apply's own scratch-slot trial failing is a
            // different event from the pinned production CA breaking —
            // catrust_service() (called later this same iteration) resolves
            // it directly; conflating the two would let a bad *pushed* CA
            // incorrectly mark the still-working, currently-pinned CA broken.
            schedule_backoff(backoff_index, next_retry_us);
            ESP_LOGI(TAG, "TLS handshake failed during a CA apply trial (rc=%d) - "
                          "catrust_service() will resolve it",
                     st->last_rc);
            break;
        }
        catrust_tls_action_t action = catrust_on_mqtt_tls_fail();
        switch (action) {
        case CATRUST_TLS_RETRY_VALIDATED:
            schedule_backoff(backoff_index, next_retry_us);
            ESP_LOGI(TAG, "TLS handshake failed while pinned (rc=%d): one more validated attempt "
                          "before falling back",
                     st->last_rc);
            break;
        case CATRUST_TLS_FALL_BACK:
            schedule_backoff(backoff_index, next_retry_us);
            ESP_LOGI(TAG, "TLS handshake failed twice while pinned (rc=%d): falling back to "
                          "unvalidated MQTT (state -> broken)",
                     st->last_rc);
            break;
        case CATRUST_TLS_STEADY:
        default:
            pin_to_steady_backoff(backoff_index, next_retry_us);
            ESP_LOGI(TAG, "TLS handshake failed (rc=%d), already unpinned or broken - steady 300s "
                          "backoff, nothing left to fall back to",
                     st->last_rc);
            break;
        }
        break;
    }
    case NET_MQTT_RC_TRANSIENT:
    default:
        schedule_backoff(backoff_index, next_retry_us);
        ESP_LOGI(TAG, "MQTT session lost (rc=%d), transient - retrying with backoff", st->last_rc);
        break;
    }
    net_ack_disconnect_edge();
}

// ---------------------------------------------------------------------------
// F4: modem health check / recovery, shared with the §2.3 connect watchdog
// below (both are "the modem engine looks wedged" triggers and must share
// one rate limit, not each get their own 1-per-10-min budget).
// ---------------------------------------------------------------------------

// Records that net_session_up() was just called, so the watchdog below knows
// when to start counting; `ok` is net_session_up()'s own return value (only
// "the AT command was queued", not "it connected" -- that is exactly what
// the watchdog is for). Power effect: none of its own, bookkeeping only.
static void note_session_up_attempt(bool ok)
{
    s_connect_attempt_us = ok ? esp_timer_get_time() : 0;
}

// Shared F4 recovery action: rate-limited (1 per PAGER_MODEM_RESET_MIN_INTERVAL_US,
// "a wedged modem being reset in a loop is a battery fire") full modem reset
// via net_recover_modem(). `reason` is a human-readable trigger name for the
// log line only. Returns true if a reset was actually attempted (regardless
// of whether net_recover_modem() itself succeeded), so the caller knows
// whether to also try net_session_up() again.
static bool rate_limited_modem_recover(const char *reason)
{
    int64_t now_us = esp_timer_get_time();
    if (g_rtc.last_modem_reset_us != 0 &&
        (now_us - g_rtc.last_modem_reset_us) < PAGER_MODEM_RESET_MIN_INTERVAL_US) {
        ESP_LOGI(TAG, "%s but reset is rate-limited (last reset %lld s ago) - not resetting again yet",
                 reason, (long long) ((now_us - g_rtc.last_modem_reset_us) / 1000000));
        return false;
    }

    ESP_LOGI(TAG, "%s; resetting (F4)", reason);
    rtc_lock();
    g_rtc.modem_resets++;
    g_rtc.last_modem_reset_us = now_us;
    rtc_save();
    rtc_unlock();

    if (!net_recover_modem()) {
        ESP_LOGI(TAG, "modem recovery failed");
    }
    return true;
}

#define PAGER_NO_NETWORK_RESET_S (30u * 60u)

static void run_modem_health_check(void)
{
    watchdog_kick(WD_HEALTH);
    for (int attempt = 0; attempt < 3; attempt++) {
        if (net_check()) {
            uint32_t dark_s = net_unregistered_for_s();
            if (dark_s >= PAGER_NO_NETWORK_RESET_S && !s_ca_apply_suppress &&
                rate_limited_modem_recover("no network for 30 min")) {
                note_session_up_attempt(net_session_up());
            }
            return;
        }
        vTaskDelay(pdMS_TO_TICKS(1000));
    }

    // net_check() now means "the modem answers". Out of coverage is normal and
    // resets nothing (net.cpp, "Coverage loss and recovery"). The long stop
    // below is for a modem that answers but has been unable to register for
    // so long that a radio restart is worth its cost; the 10-minute rate
    // limit still applies.
    if (rate_limited_modem_recover("modem unresponsive after 3 retries over 3s")) {
        note_session_up_attempt(net_session_up());
    }
}

// S1 (docs/SLEEP_URC_DESIGN.md §5(3)(i)): net_urc_probe() itself never
// touches rate_limited_modem_recover() -- it only counts `stuck` (a probe
// unanswered for 3 wake intervals) and clears its own flag so probing
// resumes. This is "run_modem_health_check()'s owner" driving the existing
// F4 path after 6 CONSECUTIVE stuck probes (any answered probe in between
// resets the streak, mirroring run_modem_health_check()'s own "any success
// returns early" shape) -- no new recovery machinery, same rate limit.
// Called every wake, right after net_urc_probe(); cheap (a struct return and
// two comparisons) and not gated on mode/loc_suppress/ca_apply_suppress/
// coverage_owns_radio: a bare "AT" going unanswered six times running means
// the modem's command path is wedged, which none of those states explain.
// 23 Sep S7b post-mortem (docs/SLEEP_URC_DESIGN.md §9.2): `stuck` deliberately
// does NOT include a probe the library failed inside its own 2 s budget any
// more (that is `timedout`, net_probe_guard.h) -- six cheap 2 s timeouts, i.e.
// twelve seconds in ACTIVE mode, must never reach the F4 reset below. What is
// counted here is still the original signal this escalation was written
// against: the library had not released the command after 3 wake intervals,
// six times running.
static void check_probe_stuck_escalation(void)
{
    static uint32_t s_last_answered = 0, s_last_stuck = 0, s_consecutive_stuck = 0;
    net_probe_counters_t pc = net_get_probe_counters();
    // Counters going BACKWARDS means net_probe_guard_init() zeroed them (a F4
    // recovery, net.cpp's net_recover_modem()). Resynchronise instead of
    // subtracting: `s_consecutive_stuck += (0 - 6)` underflows an unsigned to
    // ~4.3e9, which is >= 6, which escalated again on the very next wake --
    // absorbed only by rate_limited_modem_recover()'s 10 minute limit.
    if (pc.answered < s_last_answered || pc.stuck < s_last_stuck) {
        s_last_answered = pc.answered;
        s_last_stuck = pc.stuck;
        s_consecutive_stuck = 0;
        return;
    }
    if (pc.answered != s_last_answered) {
        s_last_answered = pc.answered;
        s_consecutive_stuck = 0;
    }
    if (pc.stuck != s_last_stuck) {
        s_consecutive_stuck += (pc.stuck - s_last_stuck);
        s_last_stuck = pc.stuck;
        if (s_consecutive_stuck >= 6) {
            s_consecutive_stuck = 0;
            if (rate_limited_modem_recover("URC probe stuck 6x in a row")) {
                note_session_up_attempt(net_session_up());
            }
        }
    }
}
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
