awong-dev/pager/firmware/components/dptechnics__walter-modem/src/WalterModem.cpp

/**
 * @file WalterModem.cpp
 * @author Daan Pape <daan@dptechnics.com>
 * @author Arnoud Devoogdt <arnoud@dptechnics.com>
 * @date 16 January 2026
 * @version 1.5.0
 * @copyright DPTechnics bv <info@dptechnics.com>
 * @brief Walter Modem library
 *
 * @section LICENSE
 *
 * Copyright (C) 2026, DPTechnics bv
 * All rights reserved.
 *
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
 *   3. Neither the name of DPTechnics bv nor the names of its contributors may be used to endorse
 *      or promote products derived from this software without specific prior written permission.
 *
 *   4. This software, with or without modification, must only be used with a Walter board from
 *      DPTechnics bv.
 *
 *   5. Any software provided in binary form under this license must not be reverse engineered,
 *      decompiled, modified and/or disassembled.
 *
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
 * @section DESCRIPTION
 *
 * This file contains Walter's modem library implementation.
 */

#include <WalterDefines.h>

#ifdef ARDUINO

#include <Arduino.h>

#endif

#include <esp_log.h>
#include <esp_sleep.h>
#include <esp_system.h>
#include <esp_timer.h>

#if CONFIG_WALTER_MODEM_ENABLE_MOTA || CONFIG_WALTER_MODEM_ENABLE_BLUECHERRY

#include <esp_ota_ops.h>

#endif

#include <driver/gpio.h>
#include <driver/uart.h>
#include <esp_task_wdt.h>

#if CONFIG_WALTER_MODEM_ENABLE_MOTA || CONFIG_WALTER_MODEM_ENABLE_BLUECHERRY

#include <esp_image_format.h>
#include <esp_partition.h>

#endif

// PAGER PATCH: 1.10 — weak default for the application-level breadcrumb/
// watchdog-feed hook declared in WalterDefines.h, so this component still
// builds and links standalone (without firmware/main/watchdog.c's strong
// override) when vendored elsewhere.
extern "C" __attribute__((weak)) void walter_modem_block_tick(void) {}

// PAGER PATCH: (RCA_SLEEP_PUBLISH.md §3 / PATCHES.md 1.12) storage for the
// four counters declared in WalterDefines.h. Plain uint32_t, not atomics:
// every increment site runs on this component's own single UART/URC
// processing task, never concurrently with this accessor's read (a torn
// 32-bit read on ESP32-S3 is not a correctness concern for a diagnostic
// counter that only needs to be "close enough" once per sleeptest report).
static uint32_t s_pagerCntDataTxRetx = 0;
static uint32_t s_pagerCntPromptOrphan = 0;
static uint32_t s_pagerCntBufDropQueue = 0;
static uint32_t s_pagerCntBufDropPool = 0;

// PAGER PATCH: 1.13 (docs/RCA_SLEEP_URC.md §5 fix 3-4) -- see
// WalterDefines.h's own comment on walter_modem_pager_counters_t for what
// each of these means. Same "plain uint32_t, no atomics" reasoning as the
// four counters above.
static uint32_t s_pagerCntPromptHandled = 0;
static uint32_t s_pagerCntPayloadBytesWritten = 0;
static uint32_t s_pagerCntTxdoneTimeouts = 0;
static char s_pagerStallCmd[25] = { 0 };
static uint32_t s_pagerStallElapsedMs = 0;
static int32_t s_pagerStallCtsLevel = -1;
static uint32_t s_pagerStallTxRingBytes = 0;

// PAGER PATCH: 1.15 (docs/SLEEP_URC_DESIGN.md §8.2, docs/SLEEP_URC_TASKS.md
// S10) -- see WalterDefines.h's own comment on walter_modem_pager_counters_t.
// Same "plain uint32_t, no atomics" reasoning as the counters above:
// s_pagerCntRspNoCmd is only ever written from _cmdProcessingTask (inside
// _processModemRSP()); s_pagerPayloadStuckMs is only ever written from the
// same task (inside _processModemCMD()'s timeout paths).
static uint32_t s_pagerCntRspNoCmd = 0;
static uint32_t s_pagerPayloadStuckMs = 0;

// PAGER PATCH: 1.19 (see PATCHES.md 1.19). Same "plain uint32_t, no atomics"
// reasoning as the counters above -- only ever written from
// _cmdProcessingTask, right where a response is about to be re-paired with
// an already-finished _curCmd instead of being handed to it a second time.
static uint32_t s_pagerCntRspStaleCmd = 0;

// PAGER PATCH: 1.17 (docs/SLEEP_PAGE_LOSS_BRIEF.md §6 item A) -- the trace
// hook installed by WalterModem::setPagerTraceHook(), NULL until a caller
// installs one (firmware/main/flightrec.c, debug build only). Same "plain
// static, single UART/URC processing task" reasoning as the counters above;
// read (never written) from the three call sites below.
static walter_pager_trace_fn s_pagerTraceHook = NULL;

// PAGER PATCH: 1.18 (docs/SLEEP_PAGE_LOSS_BRIEF.md, build/bench-logs/
// phaseBB-report.log c01/c08) -- see WalterDefines.h's own comment on
// walter_modem_pager_counters_t. Same "plain uint32_t, no atomics"
// reasoning as the counters above: only ever written from _parseRxData(),
// which runs on this component's own single UART/URC processing task.
static uint32_t s_pagerCntGlitchDropped = 0;

void WalterModem::setPagerTraceHook(walter_pager_trace_fn fn)
{
  s_pagerTraceHook = fn;
}

extern "C" walter_modem_pager_counters_t walter_modem_pager_counters(void)
{
  walter_modem_pager_counters_t c;
  c.datatx_retx = s_pagerCntDataTxRetx;
  c.prompt_orphan = s_pagerCntPromptOrphan;
  c.buf_drop_queue = s_pagerCntBufDropQueue;
  c.buf_drop_pool = s_pagerCntBufDropPool;
  c.prompt_handled = s_pagerCntPromptHandled;
  c.payload_bytes_written = s_pagerCntPayloadBytesWritten;
  c.txdone_timeouts = s_pagerCntTxdoneTimeouts;
  memcpy(c.stall_cmd, s_pagerStallCmd, sizeof(c.stall_cmd));
  c.stall_elapsed_ms = s_pagerStallElapsedMs;
  c.stall_cts_level = s_pagerStallCtsLevel;
  c.stall_tx_ring_bytes = s_pagerStallTxRingBytes;
  c.rsp_no_cmd = s_pagerCntRspNoCmd;
  c.payload_stuck_ms = s_pagerPayloadStuckMs;
  c.glitch_dropped = s_pagerCntGlitchDropped;
  c.rsp_stale_cmd = s_pagerCntRspStaleCmd;
  return c;
}

#pragma region CONFIG

/**
 * @brief The RX pin on which modem data is received.
 */
CONFIG_INT(WALTER_MODEM_PIN_RX, 14)

/**
 * @brief The TX to which modem data must be transmitted.
 */
CONFIG_INT(WALTER_MODEM_PIN_TX, 48)

/**
 * @brief The RTS pin on the ESP32 side.
 */
CONFIG_INT(WALTER_MODEM_PIN_RTS, 21)

/**
 * @brief The CTS pin on the ESP32 size.
 */
CONFIG_INT(WALTER_MODEM_PIN_CTS, 47)

/**
 * @brief The active low modem reset pin.
 */
CONFIG_INT(WALTER_MODEM_PIN_RESET, 45)

/**
 * @brief The baud rate used to talk to the modem.
 */
CONFIG_INT(WALTER_MODEM_BAUD, 115200)

/**
 * @brief The maximum number of milliseconds to wait.
 */
CONFIG_INT(WALTER_MODEM_CMD_TIMEOUT_MS, 180000)

/**
 * @brief The maximum duration of an event in milliseconds.
 */
CONFIG_INT(WALTER_MODEM_MAX_EVENT_DURATION_MS, 500)

/**
 * @brief UART buffer size.
 * The size of the UART hardware FIFO buffer.
 */
CONFIG_INT(UART_BUF_SIZE, 128)

/**
 * @brief UART buffer threshold.
 * When the hardware UART buffer reaches a certain threshold,
 * an interrupt will get triggered.
 * We had issues with a lower treshold, which would seem to indicate that we're not processing
 * something fast enough, in order to deal with the more frequent interrupts.
 * We need to test this hypothesis.
 */
CONFIG_INT(UART_BUF_THRESHOLD, 122)

#pragma endregion

/**
 * @brief Any modem time below 1 Jan 2023 00:00:00 UTC is considered an invalid time.
 */
#define WALTER_MODEM_MIN_VALID_TIMESTAMP 1672531200

/**
 * @brief The command timeout expressed in system ticks.
 */
#define WALTER_MODEM_CMD_TIMEOUT_TICKS pdMS_TO_TICKS(WALTER_MODEM_CMD_TIMEOUT_MS)

#pragma region RTC_MEMORY
#if CONFIG_WALTER_MODEM_ENABLE_MOTA

struct WalterModemStpRequest stpRequest;
struct WalterModemStpResponseSessionOpen stpResponseSessionOpen;
struct WalterModemStpRequestTransferBlockCmd stpRequestTransferBlockCmd;
struct WalterModemStpResponseTransferBlock stpResponseTransferBlock;

#endif

RTC_DATA_ATTR walter_modem_pdp_context_t _pdpCtxSetRTC[WALTER_MODEM_MAX_PDP_CTXTS] = {};

#if CONFIG_WALTER_MODEM_ENABLE_COAP

RTC_DATA_ATTR WalterModemCoapContext _coapCtxSetRTC[WALTER_MODEM_MAX_COAP_PROFILES] = {};

#endif
#if CONFIG_WALTER_MODEM_ENABLE_BLUECHERRY

RTC_DATA_ATTR WalterModemBlueCherryState blueCherryRTC = {};

#endif
#if CONFIG_WALTER_MODEM_ENABLE_MQTT

RTC_DATA_ATTR WalterModemMqttTopic _mqttTopicSetRTC[WALTER_MODEM_MQTT_MAX_TOPICS] = {};

#endif
#if CONFIG_WALTER_MODEM_ENABLE_SOCKETS

RTC_DATA_ATTR WalterModemSocket _socketCtxSetRTC[WALTER_MODEM_MAX_SOCKETS] = {};

#endif
#pragma endregion
#if CONFIG_LOG_MAXIMUM_LEVEL >= ESP_LOG_DEBUG

/**
 * @brief Static buffer for escaping data for logging purposes.
 * Size is twice WALTER_MODEM_RSP_BUF_SIZE to handle worst-case escaping.
 */
static uint8_t _logEscapeBuffer[WALTER_MODEM_RSP_BUF_SIZE * 2];

#endif
#pragma region HELPER_FUNCTIONS

/**
 * @brief Convert a digit to a string literal.
 *
 * This function converts a digit [0,9] into a string literal so that it can be passed as an AT
 * command element.
 *
 * @param val The value to convert.
 *
 * @return The resulting string literal or an empty string when the value is not in the [0,9] range.
 */
const char* _digitStr(int val)
{
  switch(val) {
  case 0:
    return "0";

  case 1:
    return "1";

  case 2:
    return "2";

  case 3:
    return "3";

  case 4:
    return "4";

  case 5:
    return "5";

  case 6:
    return "6";

  case 7:
    return "7";

  case 8:
    return "8";

  case 9:
    return "9";
  }

  return "";
}

/**
 * @brief Convert a digit at a certain position in a number to a string literal.
 *
 * This function will convert the digit from a certain integer into a string literal. The position
 * starts at 0 which is the leftmost digit of the number. When position is bigger than the number of
 * digits in the number an empty string literal is returned.
 *
 * @param num The number to get the digit from.
 * @param pos The position of the digit, 0 is the leftmost digit.
 *
 * @return The string literal which represents the digit.
 */
const char* _intToStrDigit(int num, int pos)
{
  pos += 1;
  int pow = 1;
  int tmp = num;
  int digitCount = 1;

  while(tmp >= 10) {
    pow *= 10;
    tmp /= 10;
    digitCount += 1;
  }

  if(pos > digitCount) {
    return "";
  }

  tmp = num;
  int digit = 0;

  for(int i = 1; i <= pos; ++i) {
    digit = tmp / pow;
    tmp %= pow;
    pow /= 10;
  }

  return _digitStr(digit);
}

/**
 * @brief Convert a PDP type to a string
 *
 * @param type The PDP type to convert.
 *
 * @return The resulting string literal.
 */
const char* _pdpTypeStr(WalterModemPDPType type)
{
  switch(type) {
  case WALTER_MODEM_PDP_TYPE_X25:
    return "X.25";

  case WALTER_MODEM_PDP_TYPE_IP:
    return "IP";

  case WALTER_MODEM_PDP_TYPE_IPV6:
    return "IPV6";

  case WALTER_MODEM_PDP_TYPE_IPV4V6:
    return "IPV4V6";

  case WALTER_MODEM_PDP_TYPE_OSPIH:
    return "OSPIH";

  case WALTER_MODEM_PDP_TYPE_PPP:
    return "PPP";

  case WALTER_MODEM_PDP_TYPE_NON_IP:
    return "Non-IP";
  }

  return "";
}

/* PAGER PATCH: (1.21, PATCHES.md) `mktime()` converts a struct tm using the
 * CALLING PROCESS's current `TZ` (see <time.h>), not UTC -- both strTotime()
 * below and the AT+CCLK? handler further down this file build a struct tm
 * from a value that is already known to be UTC (or, for CCLK, is explicitly
 * re-based to UTC by the caller's own tz_offset arithmetic right after this
 * call) and relied on mktime() behaving like the POSIX `timegm()` -- which
 * this toolchain's newlib does not provide (not declared in <time.h>) --
 * true only as long as the application never called `setenv("TZ", ...)`.
 * firmware/main/main.c's app_main() now does exactly that (TASK_ui_round2.md
 * Do #7, a Pacific-time on-glass clock), which silently coupled this
 * library's own UTC-epoch math to whatever TZ the application happens to
 * have set -- see PATCHES.md 1.21 for a live capture proving this (a CCLK-
 * seeded epoch that decoded 8h into the future of the true time). This
 * small TZ-independent UTC calendar conversion (Howard Hinnant's public-
 * domain "days from civil" algorithm) replaces mktime() at both call sites
 * instead of touching process TZ state: tzset() is documented non-thread-
 * safe, and this file's own RX/queue-processing tasks (xTaskCreateStatic...
 * in begin(), above) are not necessarily the application's TZ-owning task
 * anyway, so a push/pop of `TZ` around mktime() would not be safe either.
 */
static time_t _pagerTimegm(const struct tm* tm)
{
  int64_t y = tm->tm_year + 1900;
  int m = tm->tm_mon + 1; // 1-12
  int d = tm->tm_mday;
  y -= (m <= 2);
  int64_t era = (y >= 0 ? y : y - 399) / 400;
  int64_t yoe = y - era * 400;                                   // [0, 399]
  int64_t doy = (153 * (m + (m > 2 ? -3 : 9)) + 2) / 5 + d - 1;   // [0, 365]
  int64_t doe = yoe * 365 + yoe / 4 - yoe / 100 + doy;            // [0, 146096]
  int64_t days = era * 146097 + doe - 719468;                    // days since 1970-01-01 UTC
  return (time_t) (days * 86400 + tm->tm_hour * 3600 + tm->tm_min * 60 + tm->tm_sec);
}

/**
 * @brief Convert a time string to a unix timestamp.
 *
 * No time zone is taken into consideration. If the time string is a local time, the time zone
 * offset must be compensated afterwards.
 *
 * @param timeStr The string to convert.
 * @param format The time format to parse.
 *
 * @return The unix timestamp or -1 on error.
 */
int64_t strTotime(const char* timeStr, const char* format = "%Y-%m-%dT%H:%M:%S")
{
  struct tm tm {};
  if(strptime(timeStr, format, &tm) == NULL) {
    return -1;
  }

  /* PAGER PATCH: (1.21) was `std::mktime(&tm)` -- see _pagerTimegm()'s own
   * doc comment just above for why that is TZ-dependent and wrong here. */
  time_t utcTime = _pagerTimegm(&tm);
  return (int64_t) utcTime;
}

/**
 * @brief Convert a unix timestamp to a formatted time string.
 *
 * The time string is in UTC (no time zone offset applied).
 *
 * @param timestamp The unix timestamp to convert.
 * @param buffer The output buffer to hold the formatted string.
 * @param buffer_len The length of the output buffer.
 * @param format The time format to use (default: "%Y-%m-%dT%H:%M:%S").
 *
 * @return true on success, false on error.
 */
bool timeToStr(uint64_t timestamp, char* buffer, size_t buffer_len, const char* format)
{
  if(buffer == NULL || buffer_len == 0) {
    return false;
  }

  // Use gmtime_r to convert timestamp to UTC broken-down time
  time_t time_val = (time_t) timestamp;
  struct tm tm_utc;

  if(gmtime_r(&time_val, &tm_utc) == NULL) {
    return false;
  }

  // Format time according to format string
  size_t written = strftime(buffer, buffer_len, format, &tm_utc);
  if(written == 0) {
    // Buffer too small or formatting error
    return false;
  }

  return true;
}

/**
 * @brief Convert a string into an unsigned 32-bit integer.
 *
 * This function will convert a string into a 32-bit unsigned integer.
 *
 * @param str The 0-terminated string to convert.
 * @param len The length of the string or -1 to use strlen internally.
 * @param result Pointer to save the result in.
 * @param radix The radix to convert with, 10 by default.
 * @param max The function will fail if the number is bigger than max, UINT32_MAX by default.
 *
 * @return True when the conversion was successful, false if the conversion failed.
 */
bool strToUint32(const char* str, int len, uint32_t* result, int radix = 10,
                 uint32_t max = UINT32_MAX)
{
  size_t l = len == -1 ? strlen(str) : (size_t) len;

  /* Create a temp stack buffer to make the string 0-terminated */
  char buff[l + 1];
  memcpy(buff, str, l);
  buff[l] = '\0';

  char* end;
  errno = 0;
  long long int sl = strtol(buff, &end, radix);

  if(end == buff) {
    return false;
  } else if('\0' != *end) {
    return false;
  } else if(errno == ERANGE) {
    return false;
  } else if(sl > max) {
    return false;
  } else if(sl < 0) {
    return false;
  } else {
    *result = (uint32_t) sl;
    return true;
  }

  return false;
}

/**
 * @brief Convert a string into an unsigned 16-bit integer.
 *
 * This function will convert a string into a 16-bit unsigned integer.
 *
 * @param str The 0-terminated string to convert.
 * @param len The length of the string or -1 to use strlen internally.
 * @param result Pointer to save the result in.
 * @param radix The radix to convert with, 10 by default.
 *
 * @return True when the conversion was successful, false if the conversion failed.
 */
bool strToUint16(const char* str, int len, uint16_t* result, int radix = 10)
{
  uint32_t tmpResult = 0;

  if(!strToUint32(str, len, &tmpResult, radix, UINT16_MAX)) {
    return false;
  }

  *result = (uint16_t) tmpResult;
  return true;
}

/**
 * @brief Convert a string into an unsigned 8-bit integer.
 *
 * This function will convert a string into a 8-bit unsigned integer.
 *
 * @param str The 0-terminated string to convert.
 * @param len The length of the string or -1 to use strlen internally.
 * @param result Pointer to save the result in.
 * @param radix The radix to convert with, 10 by default.
 *
 * @return True when the conversion was successful, false if the conversion failed.
 */
bool strToUint8(const char* str, int len, uint8_t* result, int radix = 10)
{
  uint32_t tmpResult = 0;

  if(!strToUint32(str, len, &tmpResult, radix, UINT8_MAX)) {
    return false;
  }

  *result = (uint8_t) tmpResult;
  return true;
}

/**
 * @brief Convert a string into an IEEE754 float.
 *
 * This function will convert a string into an IEEE754 float.
 *
 * @param str The 0-terminated string to convert.
 * @param len The length of the string or -1 to use strlen internally.
 * @param result Pointer to save the result in.
 *
 * @return True when the conversion was successful, false if the conversion failed.
 */
bool strToFloat(const char* str, int len, float* result)
{
  size_t l = len == -1 ? strlen(str) : (size_t) len;

  /* Create a temp buffer to make the string 0-terminated */
  char buff[l + 1];
  memcpy(buff, str, l);
  buff[l] = '\0';

  char* end;
  errno = 0;
  *result = strtof(buff, &end);

  if(end == buff) {
    return false;
  } else if('\0' != *end) {
    return false;
  } else if(errno == ERANGE) {
    return false;
  }

  return true;
}

/**
 * @brief Escape a binary buffer into a printable format.
 *
 * This function will escape non-printable characters in the input buffer
 * using C-style escape sequences.
 *
 * @param input The input binary buffer.
 * @param input_len The length of the input buffer.
 * @param max_len The maximum length of the output buffer. (Output buffer can be up to twice this
 * size)
 * @param static_out Optional pre-allocated output buffer to use instead of malloc.
 * @param static_out_size Size of the static output buffer if provided.
 *
 * @return A pointer to a Buffer struct containing the escaped data and its size, or NULL on error.
 */
Buffer* escapeBuffer(const uint8_t* input, size_t input_len, size_t max_len,
                     uint8_t* static_out = nullptr, size_t static_out_size = 0)
{
  if(!input || input_len == 0)
    return NULL;

  // Use static buffer if provided, otherwise allocate
  uint8_t* out = nullptr;
  bool use_static = (static_out != nullptr && static_out_size > 0);

  if(use_static) {
    out = static_out;
  } else {
    // Worst-case: every byte becomes two chars
    out = static_cast<uint8_t*>(malloc(max_len * 2));
    if(!out)
      return nullptr;
  }

  size_t j = 0;
  size_t max_out = use_static ? static_out_size : (max_len * 2);

  for(size_t i = 0; i < input_len && j < max_out - 5; i++) {
    uint8_t c = input[i];
    switch(c) {
    case '\n':
      out[j++] = '\\';
      out[j++] = 'n';
      break;
    case '\r':
      out[j++] = '\\';
      out[j++] = 'r';
      break;
    case '\t':
      out[j++] = '\\';
      out[j++] = 't';
      break;
    case '\0':
      out[j++] = '\\';
      out[j++] = '0';
      break;
    default:
      if(isprint(c)) {
        out[j++] = c;
      } else {
        // Fallback: hex escape for other non-printable chars
        int n = snprintf((char*) &out[j], 5, "\\x%02X", c);
        j += n;
      }
      break;
    }
  }

  if(use_static) {
    // For static buffer, use a static Buffer struct
    static Buffer buff;
    buff.data = out;
    buff.size = j;
    return &buff;
  } else {
    // For dynamic allocation, allocate Buffer struct too
    Buffer* buff = static_cast<Buffer*>(malloc(sizeof(Buffer)));
    if(!buff) {
      free(out);
      return NULL;
    }
    buff->data = out;
    buff->size = j;
    return buff;
  }
}

#pragma endregion
#pragma region PRIVATE_METHODS
#pragma region MODEM_UPGRADE
#if CONFIG_WALTER_MODEM_ENABLE_MOTA

uint16_t WalterModem::_modemFirmwareUpgradeStart(void)
{
  char* atCmd[WALTER_MODEM_COMMAND_MAX_ELEMS + 1] = { NULL };
  int len;

  _rxHandlerInterrupted = true;

  /* reboot to recovery */
  vTaskDelay(pdMS_TO_TICKS(5000));
  tickleWatchdog();
  atCmd[0] = (char*) "AT+SMSWBOOT=3,1";
  atCmd[1] = NULL;
  _transmitCmd(WALTER_MODEM_CMD_TYPE_TX, atCmd);
  ESP_LOGD("WalterModem", "sent reboot to recovery command, waiting 10 seconds");
  vTaskDelay(pdMS_TO_TICKS(10000));
  tickleWatchdog();

  /* check if booted in recovery mode */
  atCmd[0] = (char*) "AT";
  atCmd[1] = NULL;
  _transmitCmd(WALTER_MODEM_CMD_TYPE_TX, atCmd);

  len = _uartRead(_blueCherry.ota_buffer, 6);
  _blueCherry.ota_buffer[len] = 0;
  ESP_LOGD("WalterModem", "sent AT, got %d:%s", len, _blueCherry.ota_buffer);

  atCmd[0] = (char*) "AT+SMLOG?";
  atCmd[1] = NULL;
  _transmitCmd(WALTER_MODEM_CMD_TYPE_TX, atCmd);

  len = _uartRead(_blueCherry.ota_buffer, 25);
  _blueCherry.ota_buffer[len] = 0;
  ESP_LOGD("WalterModem", "sent AT+SMLOG?, got %d:%s", len, _blueCherry.ota_buffer);

  atCmd[0] = (char*) "AT+SMOD?";
  atCmd[1] = NULL;
  _transmitCmd(WALTER_MODEM_CMD_TYPE_TX, atCmd);

  len = _uartRead(_blueCherry.ota_buffer, 7);
  _blueCherry.ota_buffer[len] = 0;
  ESP_LOGD("WalterModem", "sent AT+SMOD?, got %d:%s", len, _blueCherry.ota_buffer);

  /* prepare modem firmware data transfer - must wait for OK still!! */
  atCmd[0] = (char*) "AT+SMSTPU=\"ON_THE_FLY\"";
  atCmd[1] = NULL;
  _transmitCmd(WALTER_MODEM_CMD_TYPE_TX, atCmd);

  vTaskDelay(pdMS_TO_TICKS(2000));
  len = _uartRead(_blueCherry.ota_buffer, 64);
  _blueCherry.ota_buffer[len] = 0;
  ESP_LOGD("WalterModem", "started STP mode, got %d:%s", len, _blueCherry.ota_buffer);

  size_t bytesSent, bytesReceived;

  stpRequest.signature = _switchEndian32(WALTER_MODEM_STP_SIGNATURE_REQUEST);
  stpRequest.operation = WALTER_MODEM_STP_OPERATION_RESET;
  stpRequest.sessionId = 0;
  stpRequest.payloadLength = 0;
  stpRequest.transactionId = 0;
  stpRequest.headerCrc16 = 0;
  stpRequest.payloadCrc16 = 0;
  stpRequest.headerCrc16 = _calculateStpCrc16(&stpRequest, sizeof(stpRequest));

  bytesSent = _uartWrite((uint8_t*) &stpRequest, sizeof(stpRequest));

  ESP_LOGD("WalterModem",
           "sent STP reset: tx=%d header: 0x%" PRIx32 " 0x%x 0x%x %d %" PRIu32 " 0x%x 0x%x",
           bytesSent, _switchEndian32(stpRequest.signature), stpRequest.operation,
           stpRequest.sessionId, _switchEndian16(stpRequest.payloadLength),
           _switchEndian32(stpRequest.transactionId), _switchEndian16(stpRequest.headerCrc16),
           _switchEndian16(stpRequest.payloadCrc16));

  bytesReceived = _uartRead((uint8_t*) &stpRequest, sizeof(stpRequest), true);

  ESP_LOGD("WalterModem",
           "received STP reset ack: rx=%d header: 0x%" PRIx32 " 0x%x 0x%x %d %" PRIu32 " 0x%x 0x%x",
           bytesReceived, _switchEndian32(stpRequest.signature), stpRequest.operation,
           stpRequest.sessionId, _switchEndian16(stpRequest.payloadLength),
           _switchEndian32(stpRequest.transactionId), _switchEndian16(stpRequest.headerCrc16),
           _switchEndian16(stpRequest.payloadCrc16));

  stpRequest.signature = _switchEndian32(WALTER_MODEM_STP_SIGNATURE_REQUEST);
  stpRequest.operation = WALTER_MODEM_STP_OPERATION_OPEN_SESSION;
  stpRequest.sessionId = 1;
  stpRequest.payloadLength = 0;
  stpRequest.transactionId = _switchEndian32(1);
  stpRequest.headerCrc16 = 0;
  stpRequest.payloadCrc16 = 0;
  stpRequest.headerCrc16 = _calculateStpCrc16(&stpRequest, sizeof(stpRequest));

  bytesSent = _uartWrite((uint8_t*) &stpRequest, sizeof(stpRequest));

  ESP_LOGD("WalterModem",
           "sent STP open session: tx=%d header: 0x%" PRIx32 " 0x%x 0x%x %d %" PRIu32 " 0x%x 0x%x",
           bytesSent, _switchEndian32(stpRequest.signature), stpRequest.operation,
           stpRequest.sessionId, _switchEndian16(stpRequest.payloadLength),
           _switchEndian32(stpRequest.transactionId), _switchEndian16(stpRequest.headerCrc16),
           _switchEndian16(stpRequest.payloadCrc16));

  bytesReceived = _uartRead((uint8_t*) &stpRequest, sizeof(stpRequest), true);

  ESP_LOGD("WalterModem",
           "received STP open session ack: rx=%d header: 0x%" PRIx32 " 0x%x 0x%x %d %" PRIu32
           " 0x%x 0x%x",
           bytesReceived, _switchEndian32(stpRequest.signature), stpRequest.operation,
           stpRequest.sessionId, _switchEndian16(stpRequest.payloadLength),
           _switchEndian32(stpRequest.transactionId), _switchEndian16(stpRequest.headerCrc16),
           _switchEndian16(stpRequest.payloadCrc16));

  bytesReceived =
      _uartRead((uint8_t*) &stpResponseSessionOpen, sizeof(stpResponseSessionOpen), true);

  ESP_LOGD("WalterModem", "received STP open session ack data: rx=%d payload: %d %d %d",
           bytesReceived, stpResponseSessionOpen.success, stpResponseSessionOpen.version,
           _switchEndian16(stpResponseSessionOpen.maxTransferSize));

  tickleWatchdog();

  return _switchEndian16(stpResponseSessionOpen.maxTransferSize) - sizeof(stpRequest);
}
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
