awong-dev/pager/firmware/main/accel.c

// accel.c — see accel.h for the module comment (bus ownership, why this is
// the path most likely to run first, what accel_poll() does and does not
// touch).
//
// Register map / values below are the standard LIS3DH datasheet layout
// (STMicroelectronics AN/DS, publicly documented, not vendor-specific to
// this board). Every threshold is UNVERIFIED — this hardware has never
// produced a real INT1 edge while writing this — and is the first thing to
// retune once a chip is actually on the bus (look for "LIS3DH found" in the
// boot log, then use the accelerometer's own INT1_SRC/threshold registers
// via a debug build if retuning is needed; no debug command exists for that
// yet, it was not asked for by this task).

#include "accel.h"

#include <stddef.h>

// ---------------------------------------------------------------------------
// Pure function (no ESP-IDF dependency) -- host-tested by
// firmware/host/test_accel_rate.c. See accel.h's own doc comment for the
// contract; the split sms.c/loc.c use.
// ---------------------------------------------------------------------------

bool accel_edge_wanted(int64_t now_us, int64_t last_reported_us, int64_t refractory_us)
{
    if (last_reported_us == 0) {
        return true; // no edge reported yet this power cycle
    }
    int64_t elapsed_us = now_us - last_reported_us;
    if (elapsed_us < 0) {
        return true; // backwards clock: fail open rather than wedge forever
    }
    return elapsed_us >= refractory_us;
}
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
