awong-dev/pager/(commit log)

2026-09-13 Phase 0: scaffold repo layout for school pager MVP
    Adds the relay (FastAPI/paho-mqtt skeleton + docker-compose dev stack),
    ESP-IDF firmware skeleton (pins.h as single source of truth for GPIOs,
    walter-modem dependency), tools/ CLI stubs, and the HANDOFF/agent specs.
    Verified: pytest passes (1 placeholder test), docker-compose config
    validates, and idf.py build succeeds via the espressif/idf:release-v5.2
    container against esp32s3.
    Claude-Session: https://claude.ai/code/session_01WGVGD8tfim3Pea5JRGJPs9
2026-09-13 Phase 1: authoritative protocol contract (docs/PROTOCOL.md)
    Topics/QoS/retained matrix, JSON schema with a v field for future CBOR
    migration, the down-message ack state machine (queued/sent/shown/read/
    expired) and a separate device-local lifecycle for student replies,
    the status/LWT contract, keepalive+eDRX numbers with the arithmetic
    behind each, a full data-budget calculation (nominal ~1.7 MB/mo,
    pessimistic ~6.9 MB/mo, both under the 10 MB target), the ESP32 wake
    source table, and the RTC memory layout. Byte-count and data-budget
    arithmetic verified against the actual JSON examples.
    Flags two items for a human decision (not decided here, per HANDOFF
    §7.7): whether the modem's wake line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
2026-09-13 Phase 2: relay API implementation
    FastAPI app (POST/GET messages, GET status, bearer auth) backed by a
    paho-mqtt gateway that implements the docs/PROTOCOL.md §4/§5 contract:
    idempotent + out-of-order ack state machine, unknown-id/wrong-device
    drops, malformed-payload handling that never kills the MQTT loop, and
    online-edge/session-change republish capped at 10 messages. SQLite
    storage via numbered migrations. tools/send.py implemented as a CLI
    against the new API.
    Tests use an in-process fake transport (47 tests, no real broker
    needed). Verified independently: `docker compose up` + tools/send.py +
    a live device round-tripped a real message through all four states
    (queued/sent/shown/read),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
    [config.py, fake_transport.py, ids.py, main.py, send.py, test_wire.py, wire.py]
2026-09-13 Phase 3: device simulator (tools/sim_device.py)
    Connects as a device per docs/PROTOCOL.md: LWT + retained online status
    on connect, subscribes to its own /down topic, auto-acks shown on every
    received message, and --reply publishes a student up-message. Used as
    firmware's reference behaviour for net.c/modes.c in Phase 4.
    Verified as part of the Phase 2 end-to-end round-trip (send.py -> relay
    -> sim_device.py, all four ack states plus a student reply).
    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
2026-09-13 Phase 4: network core (net.cpp) and mode state machine (modes.c)
    Implements modem init/attach/TLS/MQTT and the sleep/active wake-and-drain
    cycle against the real dptechnics/walter-modem v1.5.0 API (verified
    directly against vendor source, not assumed from docs or other
    ESP32/modem projects). net.c -> net.cpp since the library is a C++ class
    with static methods; a new net.h gives modes.c/msg.c/ui.c/main.c a
    C-linkage facade so they never see WalterModem directly.
    Two rounds of research corrected real errors before implementation:
    - The component had silently resolved to v1.2.0 instead of latest
    v1.5.0 (a dependency-lock quirk); pinned exactly to 1.5.0 and
    re-verified every API claim agai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
    [modes.h, net.cpp, net.h]
2026-09-13 Fix Phase 4 commit: include the actual implementation
    The previous commit (439cd25) only captured the net.c -> net.cpp rename
    and two new headers, not the real content changes to net.cpp/modes.c/
    main.c/PROTOCOL.md/sdkconfig.defaults/README.md. A prior `git add`
    invocation aborted on a stale pathspec (git add's argument list is
    atomic - one bad path fails the whole call) and staged nothing, but a
    follow-up `git status` was misread as showing those files already
    staged from the rename. Caught by diffing HEAD's net.cpp against the
    working tree before trusting the commit. This commit adds everything
    described in 439cd25's message that was actually missing from it.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
    [main.c, modes.c, net.cpp]
2026-09-13 Phase 5: e-paper UI (ui.c), message storage (msg.c), three Phase 4 bug fixes
    msg.c: RTC/RAM split storage per redesigned PROTOCOL.md §9 - only
    delivery-critical state (dedup digest ring, pending acks, pending
    replies, newest-unread mirror) lives in RTC memory (928 of 1184 bytes
    available, confirmed via linker map), while full-fidelity thread
    history and frame buffers live in ordinary RAM, which the MVP's
    light-sleep cycle already retains. Down-message ingest validates the
    full §3.1/§3.4 envelope contract, dedups via a 32-bit id digest (reusing
    the id's own entropy, saving 208 bytes over storing id strings), and
    mirrors the newest unread message into RTC truncated at a UTF-8
    code-point bou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
    [modes.c, modes.h, msg.c, msg.h, ui.c, ui.h]
2026-09-13 Phase 6: integration hardening, end-to-end tests, and a real relay bug fix
    Adds tools/e2e_test.py: a real end-to-end integration suite against the
    actual docker-compose stack (no fake transport), covering the four
    scenarios HANDOFF.md's Phase 6 requires - full round-trip through all
    four ack states, malformed payloads published directly to the real
    broker, broker outage/recovery, and messages queued for a device that
    has never connected. Wired into a new .github/workflows/ci.yml.
    This integration testing caught a real, severe bug the unit tests
    structurally could not see: relay/app/mqtt_transport.py called
    int(reason_code) in its paho-mqtt v2 disconnect callback, but paho 2.x
    passes a Reaso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
    [modes.c, net.cpp, net.h]
2026-09-13 Close MVP gap: implement and serve the parent web page
    HANDOFF.md's architecture (§2) and Definition of Done (§8, "a reply
    typed on CardKB appears in the parent page") required a parent-facing
    UI, but relay/static/index.html was still Phase 0's placeholder and
    wasn't even mounted by the FastAPI app - a gap in orchestration (Phase 2
    deliberately deferred it, expecting a later phase to pick it up, and
    none explicitly did) rather than a deliberate design choice.
    Implements a single dependency-free HTML file (fetch + vanilla JS, no
    framework, no build step, per the project's own established
    convention): device id/bearer token stored in localStorage, a polled
    thread view with color-coded ack-s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
2026-09-13 Add relay/README.md (HANDOFF.md §8 DoD: a setup README per component)
    Quickstart, test commands, and pointers to the CLI tools and
    docs/PROTOCOL.md. firmware/README.md already satisfied this; relay's
    was the missing one.
    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
2026-09-13 Resolve PROTOCOL.md §12 item 6: real battery voltage via getVoltage()
    Replaces modes.c's hardcoded batt_mv=3300 placeholder with a real
    reading from the modem's own supply-rail voltage monitor
    (WalterModem::getVoltage() -> AT+SQNVMON), enabled once at init via
    configVoltageMonitor() in ACTIVE mode (periodic measurement only, no
    autonomous shutdown/sleep side effects - modes.c retains sole
    ownership of all power decisions).
    Whether this AT command's reading actually tracks the battery cell
    (rather than a fixed regulated rail) was investigated against Walter's
    public hardware schematics before committing to it, not assumed: the
    modem's power pins sit on a net named distinctly from Walter's
    r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
    [modes.c, net.cpp, net.h]
2026-09-14 Refresh all docs for a clean handoff point
    HANDOFF.md: added a status banner at the top so a fresh session (or a
    future one) immediately sees the MVP is code-complete and what's
    actually left (hardware bring-up + two protocol decisions), rather
    than reading the original phase plan as a still-open task list.
    README.md: added a Status section and a repo map — it was still the
    pre-project one-paragraph pitch, untouched since before any code
    existed.
    firmware/README.md: fixed a stale "Display driver TBD in Phase 5" line
    (Phase 5 shipped a custom in-tree driver) and a "NEEDS HUMAN DECISION"
    section that still described the battery voltage item as unresolved
    after the follow-up work had alread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
2026-09-14 Add v2 server-stack plan, unattended build brief, and server-side agents
    docs/SERVER_PLAN.md: full design for the multi-user stack — user registry,
    allow-lists, location (/loc + loc_req), multi-backend delivery (pager, web
    app, SMS, Google Chat), Next.js + MUI web app on Firebase Hosting, Firestore
    as the only store, scale-to-zero Cloud Run relay fed by the broker's rule
    engine over HTTPS, weekly retention with day/week units, Terraform layout,
    recomputed free-tier sizing (≈ $0–2/month), open-source broker alternatives,
    and the HTTPS-polling analysis that keeps MQTT on the device.
    HANDOFF_V2.md + docs/kickoff-v2.md: phase-by-phase execution brief and prompt
    for an unattended Sonnet or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
2026-09-14 v2 phase 1: protocol v2 (aliases, kind, /loc, to) + wire.py
    Edits docs/PROTOCOL.md per SERVER_PLAN.md §4: from becomes an alias regex
    (system stays a special case), down envelopes gain optional kind (msg |
    loc_req), up messages gain optional to, new §13 Location spends the /loc
    topic and loc schema reservations, /status gains loc_period_s/loc_min_s,
    byte budget and §11/§12 updated. Implements the matching relay/app/wire.py
    changes (LocEnvelope, DownEnvelope, alias validation) and extends
    tools/sim_device.py to drop-without-acking a loc_req down message.
    server-architect review caught and this fixes: build_down_payload could
    emit a malformed empty-body msg envelope, LocFix had no lat/lon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
    [test_wire.py, wire.py]
2026-09-14 v2 phase 2a: serverless transport (EMQX rule engine + REST publish)
    Replaces the MVP's always-on paho-mqtt relay client with a request-driven
    design: relay/app/broker.py (BrokerClient — REST publish, webhook verify/
    parse), relay/app/ingest.py (ported from the deleted mqtt_gateway.py:
    handle_up/handle_status/handle_loc stub, online-edge re-publish),
    relay/app/routers/webhooks.py (POST /webhooks/mqtt). No process holds an
    MQTT connection; docker-compose.yml replaces eclipse-mosquitto with
    emqx/emqx:5.8.0, configured idempotently by tools/emqx_setup.py against
    EMQX's REST management API (connector -> HTTP action -> rule on
    pager/+/{up,status,loc}, sync query_mode required). Legacy RELAY_TOKE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
    [broker.py, config.py, emqx_setup.py, fake_transport.py, ingest.py, main.py, test_ingest.py, test_webhooks.py]
2026-09-14 v2 phase 2b: Firestore + identity
    Replaces the MVP's SQLite store with Cloud Firestore + Firebase Auth
    (against local emulators): relay/emulator.Dockerfile (node:20-bookworm-
    slim + Temurin 21, since firebase-tools needs a JRE >= 21 and bookworm's
    own JDK tops out at 17), relay/app/db/firestore.py (emulator-aware
    firebase-admin init, run_transaction helper), relay/app/store/{users,
    devices,backends,allow,messages,locations,settings}.py implementing
    SERVER_PLAN.md §3's collections exactly, relay/firestore.rules +
    firestore.indexes.json, relay/app/auth.py (verify_id_token, registry
    gate, admin custom claim), relay/app/bootstrap.py, routers/admin.py
    (users, allowlist replace-all incl. locatabl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
    [auth.py, bootstrap.py, config.py, firebase_test_utils.py, ingest.py, main.py, test_admin.py]
2026-09-14 v2 phase 3: routing + core backends
    Adds relay/app/routing.py (send() per SERVER_PLAN.md §5.2: recipient
    resolution incl. broadcast/default, per-recipient allow-list check with
    drop+log+system-reply, one Firestore transaction per recipient reusing
    Phase 2b's create_message, inline in-request delivery), the Backend
    protocol and its pager/webapp adapters (relay/app/backends/), tasks.py
    (inline mode), jobs.py (tick() with a 5-attempt delivery failure cutoff),
    routers/conversations.py + me.py + internal.py, and the first cut of
    tools/pager_client.py (device + server sides) and tools/e2e_v2.py
    (scenarios 1-4: bootstrap, text_roundtrip, allowlist, republish).
    server-architect review found and fi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
    [e2e_v2.py, ingest.py, jobs.py, main.py, pager_client.py, routing.py, tasks.py, test_auth.py]
2026-09-14 v2 phase 4: location
    Adds relay/app/location.py: /loc ingest (dedup on a new locWireIds
    collection, periodic fixes written to devices/{d}/locations, on-demand
    answers fulfil the matching loc_req delivery and post a kind='loc'
    thread message to every coalesced requester), Location.locate() (a
    three-way transaction: coalesce onto an in-flight request <15min old,
    answer from a cached fix <60s old, or claim a fresh request), derived
    15-minute expiry, and jobs.tick() cleanup of stale locReqs docs. New
    POST /api/conversations/{alias}/locate endpoint (requires allow.locate).
    tools/pager_client.py gains device-side loc/loc-auto/loc-min/loc-fail
    implementing PROTOCOL.md §13.3's rate limit exactly, a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
    [e2e_v2.py, ingest.py, jobs.py, location.py, main.py, pager_client.py, test_admin.py, test_conversations.py]
2026-09-14 v2 phase 5: client complete + CI switch
    Adds tools/mocks/twilio_mock.py (records outbound SMS, can be told to
    fail), relay/app/backends/sms_stub.py (a deliberately marked Phase 5
    stand-in for Phase 7's real Twilio adapter -- no credentials, no
    signature verification, registered under kind='sms'), a real
    jobs.sweep() implementing SERVER_PLAN.md §5.7: retention settings as
    {n, unit}, converted to seconds only in the sweeper; batched deletes
    across messages+wireIds, a locations collection-group sweep,
    locWireIds, locReqs, and (see below) wireIds' own independent pass and
    conversations. Remaining tools/pager_client.py commands (admin
    settings, sweep), tools/e2e_v2.py scenarios 7-9 (fanout, rete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
    [e2e_v2.py, jobs.py, pager_client.py, routing.py, send.py, test_internal.py, test_jobs.py]
2026-09-14 v2 phase 9: terraform + runbook
    Adds infra/ per SERVER_PLAN.md §9.1-9.2: bootstrap/ (one-off project
    APIs + GCS state bucket), modules/{firebase,relay-service,schedule,
    secrets,ci-deploy,broker-gce}, envs/prod wiring them together. Cloud
    Run matches §9.2 exactly (min 0 max 2, startup_cpu_boost, concurrency
    20, timeout 300s) with min_instance_count=0 enforced by a Terraform
    validation block, not just documentation. Scheduler jobs (tick every
    5 min, sweep weekly) and the Cloud Tasks queue match SERVER_PLAN.md's
    retry description. Secret Manager creates empty containers only --
    never a real value in a .tf/.tfvars file. broker-gce is the optional
    EMQX-on-GCE fallback per §9.5(a), off by defau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
    [test_ingest.py]
2026-09-14 v2 phase 6: web app
    Adds web/ per SERVER_PLAN.md §7: Next.js (App Router, static export),
    MUI, Firebase JS SDK against the emulators. All routes from §7.2:
    /login (email-link + phone code), /chat, /chat/[alias] (delivery-state
    chips per backend, location card with open-in-maps, "Request
    location"), /settings/{backends,notifications}, /admin/{users,
    allowlist,devices,settings}. firebase-messaging-sw.js for background
    push; foreground notifications gated on tab visibility. Admin routes
    are hidden client-side based on /api/me's server-verified role, not a
    security boundary in themselves -- require_admin and firestore.rules
    are, and are unchanged. web/README.md has a 13-step manual checklist
    a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
2026-09-14 v2 phase 7: SMS + Google Chat adapters
    Adds the real sms (app/backends/sms_twilio.py) and gchat
    (app/backends/gchat.py) delivery backends per SERVER_PLAN.md §6.4/§6.5,
    replacing Phase 5's sms_stub.py. Twilio X-Twilio-Signature verification
    and Google Chat JWT verification are both exercised for real in tests
    (an independently-computed Twilio signature fixture; a locally-signed
    RS256 JWT run through the actual google-auth verification path, not a
    mock). A shared @alias/single-peer inbound-reply resolution helper
    (backends/resolve.py) is used by both adapters. POST /api/me/backends/
    {id}/verify is wired for the first time (listed in the API surface
    since Phase 3, never implemented until now)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
    [e2e_v2.py, main.py, pager_client.py, tasks.py, test_gchat.py, test_jobs.py, test_me.py, test_sms_twilio.py]
2026-09-14 v2 phase 8: hardening
    Adds real OIDC ID-token verification for /internal/tick and
    /internal/sweep (relay/app/auth.py's verify_internal_oidc_token, reusing
    Phase 7's google-auth JWT-verification pattern): signature via Google's
    certs, audience checked against OIDC_AUDIENCE, and email checked
    against an OIDC_ALLOWED_EMAILS allow-list -- not just "any valid
    Google-signed token," which would authenticate any Google identity, not
    only the Cloud Scheduler/Tasks service account. DEV_MODE keeps its
    existing bypass for local dev and cannot be left on by accident (never
    set by Terraform, only in docker-compose.yml/.env.example).
    Adds Firestore-backed, transactionally-atomic fixed-window rate
    limiting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
    [auth.py, broker.py, fake_transport.py, jobs.py, logging_config.py, main.py, test_healthz.py, test_internal.py]
2026-09-14 Remove MVP migration path and de-scaffold the docs
    Two cleanups, neither behaviour-changing.
    Remove the MVP migration path. Nobody ever ran it, and it was the last
    thing tying the codebase to the retired SQLite store:
    - delete app/db/import_sqlite.py and its test
    - drop create_message()'s msg_id/created_at override hooks, which existed
    only for that importer
    - drop the dead RELAY_TOKEN and RELAY_DB_PATH settings, their .env.example
    entries and every test fixture that set them
    - delete the import_sqlite Cloud Run job, its GCS bucket, IAM binding,
    variables, outputs and the runbook step that drove it
    De-scaffold the docs and comments. The build was run phase by phase and
    the phase numb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
    [auth.py, broker.py, config.py, e2e_v2.py, fake_transport.py, ingest.py, jobs.py, location.py]
2026-09-15 Fix /chat/[alias] under next dev, and the thread query's 403
    Two separate bugs, both hit while exercising the app locally in a browser.
    Neither is new; both predate the docs cleanup.
    1. `next dev` crashed on every thread URL:
    Page "/chat/[alias]/page" is missing param "/chat/[alias]" in
    "generateStaticParams()", which is required with "output: export"
    `/chat/[alias]` is exported as one placeholder shell (`/chat/_`) because
    a static export cannot pre-render a page per arbitrary future alias, and
    Firebase Hosting rewrites `/chat/**` onto that shell in production
    (web/firebase.json). `next dev` has no such host in front of it, so it
    routed `/chat/kid` straight at the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
    [test_rules.py]
2026-09-15 Fix the same thread-query 403 in tools/pager_client.py
    `chat` (and `watch`, which polls it) ran the same `convKey`-only structured
    query the web app's thread listener did, so it hit the same Firestore `list`
    authorization failure and raised 403 against a real ID token:
    httpx.HTTPStatusError: Client error '403 Forbidden' for url
    '.../documents:runQuery'
    Same fix: also filter `uids array-contains <self>`, which is redundant
    against `convKey` but is what the rules' abstract pre-check can prove itself
    from.
    The e2e suite did not catch this because its `Oracle` asserts through the
    admin SDK, which bypasses security rules entirely -- only the ID-token path
    `chat` uses is subject to them.
    V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
    [pager_client.py]
2026-09-15 Docs: name the interpreter the CLI tools actually need
    Running the documented command gave a bare traceback:
    python3 tools/pager_client.py --help
    ModuleNotFoundError: No module named 'httpx'
    `pager_client.py`, `send.py` and `e2e_v2.py` import httpx / paho-mqtt /
    firebase-admin, which live in the relay's virtualenv, not in a system or
    Homebrew Python. Every doc said bare `python3 tools/...` (or `python
    tools/...`), which only works if a venv happens to be activated -- and
    relay/README.md's setup step was `pip install -e ".[dev]"` with no venv
    mentioned at all, which a modern Homebrew Python refuses outright.
    The tool docstrings are what `--help` prints, so they were steering people
    wro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
2026-09-15 Docs: device provisioning, auth, address book and UI plan
    Adds docs/DEVICE_PLAN.md (design: SIM-only setup code + bootstrap fetch,
    64-bit HMAC on every CBOR envelope, server-approved address book with
    device-local nicknames, passcode lock, multi-screen e-paper UI), the
    task-by-task execution plan docs/DEVICE_TASKS.md, and the orchestration
    prompt docs/DEVICE_TASKS_PROMPT.md. README repo map updated.
    Claude-Session: https://claude.ai/code/session_01MmE5KFCa338WkkjkyHzVCu
2026-09-15 D0.1: Add device authentication, CBOR, address book, and config to PROTOCOL.md
    Apply all items 0-14 from DEVICE_PLAN.md §8 to the wire contract:
    - Item 0: Support both JSON and CBOR encodings with first-byte dispatch
    - Item 1-2: Add n, sig, bv, name, ph, d, c, p, more fields and contact_req/book/cfg kinds
    - Item 2a: Locked device shown rule (messages stay sent until unlocked)
    - Item 2b: Bootstrap namespace pager/boot/{bid}/down|up with 4 kB limit
    - Item 3: CBOR column in size table with signed payload comparisons
    - Item 4: Signature/window failure is malformed; unsigned LWT exception
    - Item 5: routing rules unchanged but recipient picker applies
    - Item 6: bv and rssi now published in /statu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
2026-09-15 D0.2: Add device auth, provisioning, and contacts to SERVER_PLAN.md data model
    Add collections: deviceSecrets, setupCodes, contactRequests (marked server-only).
    Add devices/{d} fields: authMode, provisionState, wire, bookVersion, status.authAlarm.
    Add endpoints to §5.1 for device rotation, revocation, contact approval, and cfg push.
    Update firestore.rules sketch to document server-only collections and contactRequests ACL.
    Remove mqttPasswordHash from devices/{d} (moved to deviceSecrets per §2.6).
2026-09-15 S1.1: deviceSecrets store (HMAC key, replay window, down counter)
    Adds app/store/device_secrets.py per DEVICE_PLAN.md §2.5/§2.6: create/get/
    rotate/delete, accept_up_n as a transactional 64-wide replay window,
    next_down_n and bump_sig_failures as transactions on the same document.
    Pins deviceSecrets/* as default-deny for both a device owner and an admin
    client in test_rules.py, the same pattern as phoneIndex.
    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
2026-09-15 F3.1: Partition table, NVS, ident.c
    Custom partitions.csv (nvs 24K, otadata, assets 1M, ota_0/ota_1 2M each,
    sized from the current ~400 KB build + 1 MB headroom) on the Walter's
    real 16 MB flash instead of the ESP-IDF 2 MB generic default. New
    ident.c/h reads the "ident" NVS namespace once at boot (dev_id, mqtt_pw,
    kdev, host, port, ca, apn, flags, label, ca_hash, n_epoch, claimed),
    validating dev_id against PROTOCOL.md §1's regex, with getters/
    ident_store()/ident_erase() for F3.4/F3.5 to use. main.c calls
    nvs_flash_init() then ident_load(); until F3.5 (Setup mode) exists, a
    missing/invalid identity halts after logging "IDENT missing" instead of
    attempting the normal boot path with no bro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
    [partitions.csv]
2026-09-15 S1.2: devauth sign/verify + wirecbor CBOR codec
    Adds app/wirecbor.py (PROTOCOL.md §10's normative integer keymap, both
    directions, plus the four nested sub-maps loc/contact/request/lock) and
    app/devauth.py (tag/sign_cbor/sign_json/verify per PROTOCOL.md §14 and
    DEVICE_PLAN.md §2.4's exact "header includes the sig pair" CBOR signing
    rule). tools/authvectors.json pins 8 vectors (down msg, ack, up msg with
    to, status, loc, book, cfg, contact_req) against both encodings, with one
    vector hand-verified byte-by-byte in the test.
    Flags a gap in PROTOCOL.md §10: the table never assigns a numeric key to
    the `lock` field nested inside `cfg` (only cfg=38 and lock's own
    clear/auto are listed) -- wir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
2026-09-15 F3.2: cbor.c/h codec + host test harness
    Hand-written CBOR subset (definite-length maps/arrays, uint/nint,
    tstr/bstr, bool/null, float64) over a caller buffer, no malloc, per
    DEVICE_PLAN.md §2.4. firmware/host/ adds a plain-Makefile host build
    (no ESP-IDF) whose test decodes every tools/authvectors.json vector's
    cbor_signed_b64 (minus its 10-byte sig suffix) and re-encodes it byte
    for byte identical, plus direct unit checks for overflow, cbor_w_nint's
    sign requirement, and indefinite-length rejection.
    Adds cbor.c to main/CMakeLists.txt SRCS so idf.py build actually
    compiles it against the Xtensa toolchain, not just the host compiler.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
2026-09-15 S1.3: ingest verifies before it parses (device auth)
    Wires app/devauth.py + app/wirecbor.py (S1.2) and
    app/store/device_secrets.py (S1.1) into app/ingest.py: for an authMode:hmac
    device, every /up, /status and /loc envelope is signature-verified and
    replay-window-checked before it is decoded/parsed, per PROTOCOL.md §14.4.
    Adds devices/{d}.authMode and .wire, the unsigned-LWT exception (§14.6), the
    unknown-kind-on-/up drop path (§3.4), and a devices/{d}-based rolling
    failure-count window for the "20 failures in 10 min" authAlarm (S1.3's Do
    step notes device_secrets.py's sigFailures has no time window and this is
    out of scope to add one there).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
    [ingest.py, test_ingest.py, test_webhooks.py, wire.py]
2026-09-15 F3.3: auth.c HMAC sign/verify + replay counters + host test
    New module auth.c/h: auth_sign()/auth_verify() append/check the 10-byte
    CBOR sig suffix (key 13, HMAC-SHA256 truncated to 64 bits) over
    topic||0x00||P per PROTOCOL.md §14.3, with no re-serialisation (only
    append/trim). auth_next_up_n() derives n=(epoch<<20)|lo for /up,/status,/loc
    from a caller-supplied epoch and RTC-resident up_lo, signalling epoch-bump-
    needed on wrap. auth_accept_down_n() mirrors the relay's sliding-window
    replay check but 32 bits wide (device-side /down window, distinct by design
    from the relay's 64-wide /up window). auth_rtc_t is a plain struct for
    modes.c to embed the same way msg_rtc_t already is.
    HMAC-SHA2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
2026-09-15 S1.4: one signed publish path for /down
    BrokerClient.publish_down(device_id, obj) is now the only way to publish to
    pager/{d}/down: it reads devices/{d}.wire and .authMode, takes a fresh
    deviceSecrets.downN for an authMode:"hmac" device and signs with
    devauth.sign_cbor/sign_json, or publishes plain JSON/CBOR for authMode:
    "password". PagerBackend.deliver() builds the down envelope's fields as a
    dict and hands them to publish_down instead of calling wire.build_down_payload
    + broker.publish directly; the online-edge/tick redelivery path reaches the
    same code through PagerBackend, so a re-publish of a reused id gets a fresh n.
    An authMode:"hmac" device with no deviceSecrets row fails closed (l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
    [broker.py, fake_transport.py, test_conversations.py, test_ingest.py, test_internal.py, test_jobs.py, test_location.py, test_routing.py]
2026-09-15 F3.4: net.cpp reads ident for credentials, adds RSSI and bootstrap TLS profile
    Replace net.cpp's constexpr broker host/port/device-id/mqtt-password/CA
    placeholders with ident_get_*() (F3.1's NVS-backed identity), so the modem
    config comes from the bootstrap bundle instead of hardcoded values. The CA
    is now written to modem NVRAM slot 12 only when ident's ca_hash differs from
    the hash of what was last written this power session, instead of on every
    net_init() (DEVICE_PLAN.md §3.3). Add net_tls_profile_bootstrap() (profile 3,
    WALTER_MODEM_TLS_VALIDATION_NONE, for setup.c's one-time bootstrap MQTT hop),
    net_get_rssi() (WalterModem::getRSSI()/AT+CSQ, settling DEVICE_PLAN.md §5.4's
    UNVERIFIED g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
    [net.cpp, net.h]
2026-09-15 T1.5: pager_client.py signs and speaks both encodings
    - tools/pager_client.py: DeviceClient takes --hmac-key/--wire, signs every
    /up,/status,/loc publish (n = epoch/lo split, PROTOCOL.md §14.2) and
    verifies every /down, dropping bad-sig/replayed/out-of-window ones with a
    log line (32-wide device-side down window per DEVICE_TASKS.md T1.5).
    Unsigned mode stays behind --hmac-key "" (authMode:password). Both JSON
    and CBOR wire encodings via app.wirecbor/app.devauth.
    - tools/e2e_v2.py: creates each device's deviceSecrets row directly via
    app.store.device_secrets (S2.2, which would give POST /api/admin/devices
    a real hmacKey response, hasn't landed) so the default authMode:"hmac"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
2026-09-15 S2.1: emqx_admin.py pushes device/boot MQTT auth+ACL to EMQX
    Adds relay/app/emqx_admin.py (ensure_device/delete_user/ensure_boot_user
    against EMQX's built_in_database authentication+authorization HTTP API,
    BROKER_MANAGES_AUTH=0 no-op), relay/emqx/emqx.conf (built_in_database auth +
    deny-by-default authz, mounted via docker-compose.yml), and wires
    tools/emqx_setup.py to provision the relay-1 credential with the
    mirror-image ACL (docs/PROTOCOL.md §2).
    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
    [emqx_admin.py, emqx_setup.py, test_emqx_admin.py]
2026-09-15 S4.1: contact requests -- ingest, admin approve/reject, firestore rules
    Devices can now ask to add a contact (`/up kind:"contact_req"`), stored as
    a pending `contactRequests/{deviceId}_{id}` row (deduped on id, capped at 5
    pending per device, no-op on a matching pending/approved phone or alias, one
    `system` down reply "too many pending requests" past the cap). Admins list,
    approve (link to an existing user or create one, with an admin-asserted sms
    backend and two allow edges) and reject requests via new
    `/api/admin/contacts/*` and `/api/admin/users/{uid}/backends` routes; every
    decision bumps `devices/{d}.bookVersion` and calls a placeholder `push_book`
    for S4.2 to implement. `firestore.rule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
2026-09-15 S2b.1: setup codes and the bootstrap bundle (devsetup.py)
    Adds app/devsetup.py (Crockford-base32 token + Luhn-mod-32 check
    character, HKDF-SHA256 bid/bpw/bkey derivation, AES-256-GCM bundle
    encryption per DEVICE_PLAN.md §3.2's boot keymap) and the server-only
    setupCodes/{bid} store, so a household admin's typed setup code is
    enough for a device to fetch its real credentials over its own LTE
    bootstrap hop, with the token itself never touching Firestore.
    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
2026-09-15 S4.2: devcfg.py -- book and cfg down messages
    Adds app/devcfg.py: build_book/push_book/push_cfg (docs/DEVICE_PLAN.md
    §4.3, §5.8), a two-position (unacked/acked) pending-state tracker stored
    as raw devices/{d}.pendingBook/pendingCfg fields (no new store module is
    in this task's Files list), ack() for the /up "shown" ack path, and
    republish_pending() for the §5.3 online-edge re-publish.
    Wires it into:
    - app/routers/admin.py: new POST /api/admin/devices/{id}/cfg, and
    approve_contact/reject_contact now call devcfg.push_book instead of
    app/store/contacts.py's S4.1 placeholder stub (left untouched, out of
    this task's Files list).
    - app/ingest.py: /status's bv < devices.bookVersion trigge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
2026-09-15 S4.5: e2e scenario address_book -- device book/cfg + contact_req
    tools/pager_client.py: DeviceClient handles kind:"book"/"cfg" down messages
    (apply then ack "shown" unconditionally, per PROTOCOL.md §3.2 -- book.c/p
    state and lock.auto/cleared_count tracked on the client) and can publish
    kind:"contact_req" up messages; ServerClient gains admin_list_contacts/
    admin_approve_contact/admin_reject_contact/admin_push_cfg; matching
    PagerShell commands (contactreq, book, lock, admin contacts/approve/reject/
    cfg).
    tools/e2e_v2.py: new address_book scenario -- device contact_req for
    "+15550001111 Grandma" -> admin approves (mode=create, alias=grandma) ->
    device applies the book and acks shown -> to:g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
2026-09-15 S2.2: device create/rotate/revoke return a setup code
    POST /api/admin/devices and .../rotate-credentials now generate the
    device's MQTT password + HMAC key, write deviceSecrets (S1.1), push the
    real broker credential via emqx_admin.ensure_device, and hand out a
    setup code via devsetup.issue() (S2b.1) instead of ever returning the
    plaintext password. Mounts POST /devices/{id}/revoke (store function
    already existed) and wires it to emqx_admin.delete_user. Migrates
    mqttPasswordHash off devices/{d} onto deviceSecrets/{d} only, and wires
    two previously-uncalled loose ends into rotate: devices_store
    .clear_auth_alarm and Ingest.invalidate_secret_cache, so a rotated key
    takes effect immediately ins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
    [test_admin.py]
2026-09-15 S2b.2: ca_resolve.py -- broker CA resolution and caching
    BROKER_CA_PEM wins outright; otherwise connect to BROKER_HOST:8883, take
    the served chain, and match its root against certifi by issuer/subject
    name when the root itself isn't served. Caches the result and exposes it
    via get_broker_ca_subject()/get_broker_ca_pem() for admin.py's
    GET /api/admin/settings and main.py's startup to wire in once those files
    are free (admin.py is mid-edit by the concurrent S2.2 task).
    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
    [ca_resolve.py, config.py, test_ca_resolve.py]
2026-09-15 F3.5: setup.c -- Setup mode console, bootstrap fetch, ident write
    Adds setup.c/h (Crockford+Luhn code parsing, HKDF derivation, AES-256-GCM
    bundle decrypt/decode, the full attach->broker->bundle->done flow) and a
    `setup <code>` esp_console command wired in from main.c when ident is
    missing. Host test decrypts/derives against tools/setup_code_vectors.json
    (S2b.1) using the real mbedtls; firmware/host/Makefile links it via
    pkg-config/Homebrew.
    net.h/net.cpp (outside F3.5's Files list, flagged per DEVICE_TASKS.md's
    ground rules): setup_run() cannot reach WalterModem without new net.c
    entry points (net_bootstrap_attach/connect, net_write_ca), since
    net_init()/net_session_up() are hardwired to i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
    [main.c, net.cpp, net.h, setup.c, setup.h, test_setup.c]
2026-09-15 FIX: make the relay<->broker hop binary-safe in both directions
    `broker.publish()` did `payload.decode("utf-8")` unconditionally when
    building EMQX's REST publish body, and the rule engine's webhook only ever
    carried the payload as a JSON string. Both assume an MQTT payload is text.
    It is not: a PROTOCOL.md §3.1 CBOR envelope, every §14 HMAC signature, and
    S2b.1's AES-GCM bootstrap blob are all arbitrary bytes.
    Two independent failures, one root cause:
    * outbound -- `devsetup.issue()` publishes the encrypted bootstrap bundle
    retained on `/boot/{bid}/down`, so every `POST /api/admin/devices` 500'd
    with `UnicodeDecodeError: invalid continuation byte` once S2.2 wired it
    in, in *both*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
    [broker.py, emqx_setup.py, fake_transport.py, test_broker.py]
2026-09-15 F3.6: sign every publish, verify every /down, CBOR /status fields, RTC bump
    msg.c: every /up publish (ack, reply) now builds a CBOR envelope via
    cbor.c and signs it with auth_sign() when ident's IDENT_FLAG_REQ_SIG is
    set; adds msg_ingest_down_cbor() (auth_verify()-then-decode RX path,
    checked against the auth_accept_down_n() replay window) alongside the
    existing JSON/cJSON path, which stays for req_sig==0 devices until
    F6.4 removes cJSON. modes.c: /status is now CBOR too, adding rssi (every
    publish) and bv (0 until F7.1); embeds auth_rtc_t in pager_rtc_t and
    bumps PAGER_RTC_MAGIC to layout version 3; persists a bumped n_epoch via
    ident_store() on up_lo counter wrap.
    Verify: idf.py build cle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
2026-09-15 T3.7: add tools/provision.py
    --port + --code types `setup <code>` over pyserial and streams the log
    until a SETUP done/error line; --from-api calls POST /api/admin/devices
    first (docs/DEVICE_TASKS.md S2.2) and feeds its setupCode into the same
    serial flow, or just prints it when no --port is given.
    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
    [provision.py]
2026-09-15 W2.3: Devices page add-device wizard, QR setup code, rotate, revoke
    Wire /admin/devices to S2.2's DeviceSetupCodeResponse: a shared
    SetupCodePanel (new) shows the one-time setupCode big with a copy button,
    a QR code (qrcode npm package), the DEVICE_PLAN.md §3.2 two-step pager
    instructions, a live expiresAt countdown, and manualAcl lines when
    brokerPush is "manual". Create and Rotate both open this panel; the panel
    watches the existing devices Firestore listener and flips to "online" once
    provisionState == "provisioned". Revoke now calls the mounted
    POST /admin/devices/{id}/revoke route directly (S2.2 mounted it, so the
    old 404-handling special case is removed). Manual checklist steps added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
2026-09-15 S2b.3: Bootstrap topic through the webhook
    Route pager/boot/{bid}/up webhook events to Ingest.handle_boot_ack, which
    decodes the {v:1,ok:1} ack and calls devsetup.complete(bid) (clears the
    retained bundle, revokes the bootstrap credential, deletes the setup code).
    Flip devices/{d}.provisionState to "provisioned" on the first signed
    /status from an hmac-mode device. tools/emqx_setup.py now also routes
    pager/boot/+/up to the same webhook/action as the existing device topics.
    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
    [emqx_setup.py, ingest.py]
2026-09-15 W4.4: Contacts page and device cfg buttons
    Add /admin/contacts (pending contactRequests list, approve dialog with
    link/create mode and a locate checkbox, reject with reason) and Clear
    passcode / Auto-lock controls on /admin/devices, wired to POST
    /admin/contacts/{key}/approve|reject and POST /admin/devices/{id}/cfg.
    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
2026-09-15 T2b.4: pager_client.py --bootstrap setup-code fetch
    Adds bootstrap_device() and --bootstrap CODE: parses the setup code, derives
    bid/bpw/bkey (relay/app/devsetup.py), connects as boot-{bid}/bpw with no TLS,
    subscribes pager/boot/{bid}/down, decrypts the retained bundle, publishes the
    CBOR {v:1,ok:1} ack, disconnects, then continues as an ordinary signed
    DeviceClient built from the bundle's real credentials.
    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
2026-09-15 S2b.5: e2e scenario setup_code -- real bootstrap flow, boot-user cleanup, expiry
    scenario_setup_code(): admin creates a device -> real setup code -> a
    simulated device performs the actual §3.2 bootstrap fetch
    (pager_client.bootstrap_device, not the stale create_device_with_secret
    shortcut) -> provisionState flips to "provisioned" on the first signed
    /status (whitebox Firestore read) -> the boot-{bid} EMQX credential and
    setupCodes/{bid} are both gone. A second device's code is expired by
    patching setupCodes/{bid}.expiresAt and calling devsetup.expire()
    directly (S2b.1's own flagged gap: not yet wired into a scheduler),
    confirmed via EMQX's retained-message API and a real (failing)
    bootstrap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
    [e2e_v2.py]
2026-09-15 Docs: log S2b.5, record BROKER_MANAGES_AUTH=0 shared-boot-user gap
    S/S2b/T2b track complete.
    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
2026-09-15 F6.1: disp.c/gfx.c split, Noto assets pipeline, host PNG test
    Splits the pre-split ui.c (moved, not rewritten) into disp.c (SSD1680
    transport: BUSY handling, one mutex, partial/full refresh, the 20-partial
    cadence) and gfx.c (framebuffer, UTF-8 decode, proportional Noto glyph
    blit from the mmap'd `assets` partition, text/text_width/text_wrap,
    hline/rect/invert_rect, 12x12 icons); ui.c keeps only CardKB polling and
    the two screens it drew before, calling into disp.c/gfx.c, until F6.3's
    screen-stack rewrite replaces them.
    Adds tools/mkassets.py (FreeType-based Noto Sans + Noto Sans CJK
    rasteriser, 12/16px, per docs/DEVICE_PLAN.md §5.2/§9) and
    firmware/host/render_png.c (host-only PNG render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
    [disp.c, disp.h, gfx.c, gfx.h, mkassets.py, render_png.c, ui.c, ui.h]
2026-09-15 F6.2: input.c/h + ime.h, button FSM with BTN_STUCK moved out of modes.c
    Adds input.c/h: the CardKB key decode table (printable ASCII, backspace,
    enter, esc, tab, 0xB4-0xB7 arrows per DEVICE_PLAN.md §5.3), the button
    short/long/BTN_STUCK FSM (README R2's fix spec) moved out of modes.c, one
    FreeRTOS event queue, and the 30s input_awake() UI-awake window. Adds
    ime.h: the ime_t hook plus the identity IME (header-only, no text field
    wires it up until F6.3). modes.c now drains input.c's queue instead of
    stepping the button FSM inline, and its net_sleep() skip condition folds
    in input_button_busy()/input_button_stuck()/input_awake().
    Scope note: input.c does not read the CardKB over I2C itself th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
    [ime.h, input.c, input.h, modes.c, test_input.c]
2026-09-15 F6.3: screen stack, status bar, Home/Chat/Device/Setup screens
    Rewrites ui.c/h around the F6.1 disp.c/gfx.c split and the F6.2 input.c
    event queue into the docs/DEVICE_PLAN.md §5.4 screen stack (push/pop/
    replace, depth<=4) plus the §5.4 status bar (signal/link/unsent/sig-lock/
    unread/battery, redrawn for free by disp.c's own partial-refresh diff).
    Adds scr_home.c/scr_chat.c/scr_device.c/scr_setup.c per §5.5. modes.c moves
    the incoming-message render off the MQTT event task and onto modes_run()'s
    own task via a render_pending handoff (closes README R5), marking `shown`
    only after that render actually completes (closes R7), and drops the
    20-partial full-refresh cadence from every inbound/i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
    [modes.c, modes.h, render_png.c, scr_chat.c, scr_device.c, scr_home.c, scr_setup.c, ui.c]
2026-09-15 F6.4: msg.c ring 32, per-peer to, bodies to NVS msgq, UTF-8 composer, drop cJSON
    - MSG_THREAD_DEPTH 10 -> 32; msg_t/pending_up gain to[17] (peer alias);
    msg_iter_peer() added for future per-peer chat queries.
    - Reply bodies and the newest-unread body move out of RTC into NVS
    namespace `msgq` at full 320-byte/160-codepoint fidelity (never
    truncated); RTC keeps metadata only (id/to/attempts/created_us,
    id/from/ts). msg_init() now recovers from msgq on both a warm reset and
    a cold boot, so an unsent reply or unread message outlives a battery
    pull, not just a crash. sizeof(pager_rtc_t): 944 -> 496 bytes (PGR magic
    bumped 3 -> 4).
    - Composer enforces 160 code points AND 320 bytes, r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
    [modes.c, msg.c, msg.h, test_msg.c]
2026-09-15 F6.5: lock.c passcode lock + Locked screen, deferred shown while locked
    Adds lock.c/h (PBKDF2-HMAC-SHA256 via mbedtls_pkcs5_pbkdf2_hmac_ext, NVS
    namespace "lock", auto-lock check, five-free-then-doubling backoff, the
    `cfg` `lock` clear/auto handler) and scr_lock.c (masked passcode field,
    IME bypassed). modes.c gains the RTC `lock` field and forces `locked` on
    every restart when a passcode is set; msg.c/modes.c defer `shown` for a
    body received while locked and flush the deferred acks on unlock.
    scr_home.c wires "Lock now"; scr_device.c wires Passcode/Auto-lock/Show
    senders. ui.c/ui.h gain g_scr_lock and gate the button short/long actions
    on lock_is_locked() so "btn hold = nothing" actually h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
    [lock.c, lock.h, modes.c, msg.c, msg.h, scr_device.c, scr_home.c, scr_lock.c]
2026-09-15 F7.1: book.c and book/cfg ingest
    Add book.c/h: NVS-backed address book (namespace "book", one blob per
    docs/DEVICE_PLAN.md §4.3) with nickname slots preserved by alias across a
    full book_apply() replacement; kind:"book" /down ingest (acks shown once
    applied, not a thread entry, same rule lock.c uses for cfg); book_request()
    builds/signs/publishes a contact_req /up envelope. No RTC sub-struct of its
    own (docs/PROTOCOL.md §9.6 lists `book` under NVS only) -- reuses modes.c's
    existing g_rtc.auth plus its cross-task lock/unlock/save trio for the
    shared /up,/status,/loc replay counter, via a new book_bind().
    modes.c: dispatch kind:"book" ahead of msg_ingest_down_cbor() (alongside
    lock.c's cfg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
    [book.c, book.h, modes.c, msg.c, msg.h]
2026-09-15 FIX: e2e_v2 create_device_with_secret uses the real S2.2/T2b.4 bootstrap flow
    create_device_with_secret() predated commit 1d53553 (S2.2), which removed
    plaintext MQTT credentials from POST /api/admin/devices's response
    ({device, setupCode, expiresAt, brokerPush, manualAcl} now, no
    mqttUsername/mqttPassword to read). Every scenario that provisions a
    device via this helper failed with KeyError: 'mqttPassword'.
    Rather than add a test-only secret-exposing endpoint, this now calls the
    real POST /api/admin/devices then pager_client.bootstrap_device(setupCode)
    (T2b.4/S2b.5's already-verified real bootstrap path: connects as the
    one-time boot-{bid} credential, decrypts the retained bundle, acks it,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
    [e2e_v2.py]
2026-09-15 Docs: log e2e harness fix, close out three related blocked items
    Full 11-scenario e2e suite now passes in both wire modes -- clears the
    plan's Definition-of-done e2e requirement.
    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
2026-09-15 F7.3: composer `to` + `@nick`/`@alias` resolution
    Wires msg_queue_reply() to a real `to` (msg.c/h now take/copy it through
    pending_up, the RAM thread, and the NVS `msgq` write instead of always
    "" — publish_reply()'s key-7 `to` emission was already in place, F7.3
    was its first real caller). scr_chat.c's composer resolves a leading
    `@word` against the address book's nicknames then aliases
    (book_contact_count()/book_contact_at(), no new book.h entry point
    needed), strips it from the body, and omits `to` when the resolved
    alias is the default recipient so the wire is unchanged for the common
    case. An unmatched `@word` toasts and leaves the composer untouched
    instead of sending.
    Verify: idf.p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
    [msg.c, msg.h, scr_chat.c]
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2026-09-15 F8.1: bring-up checklist additions to firmware/README.md
    Add M16-M23 to the measurement checklists: I2C-across-light-sleep, UI-awake
    current, RSSI bucket mapping and battery threshold calibration (network/power
    table); CardKB typing usability (display/input table); and a new
    "timing and storage" table for on-device PBKDF2 timing, NVS blob write time,
    and assets mmap cost. Update M9 (Noto Sans/CJK at 12/16px, replacing the
    stale 5x7-font text) and M13 (arrow codes 0xB4-0xB7 + key-hold) in place with
    real F6.1/F6.2 details. Cites real numbers already in hand where they exist
    (583 KiB / 597,128-byte assets.bin, host-measured 20.5ms/10000-iter PBKDF2,
    F3.4's getRSSI()/AT+CSQ dBm formula) and mar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
2026-09-15 Docs: log F8.1 -- F track complete, only D8.1 remains
    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
2026-09-15 D8.1: Document setup-code flow, test commands, and M9/M13 measurements
    Add descriptions of the device provisioning workflow (setup-code flow for
    household admin, Devices → Add device, type code on pager) to root README
    and web/README. Document the 11 e2e test scenarios and instructions in
    relay/README and root README. Clarify web app provisioning and lock control
    features in web/README's device provisioning section and manual checklist.
    Device provisioning is already complete per S2.2/S2b.1/S2b.3/T2b.4/W2.3 and
    firmware tracks, with M9 (Noto assets 583 KiB, CJK-tofu caveat) and M13
    (arrow codes/esc/tab/key-hold) measurements already in firmware/README.md
    via F8.1. All 11 scenarios pass in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
2026-09-18 Hardware bring-up fixes: 3V3 rail enable, e-ink mirror, GNSS/battery boot screen; infra fixes
    Firmware (real hardware findings from first e-ink/GNSS bring-up):
    - pins.h/main.c: board's 3V3 peripheral rail is off by default on
    power-up -- GPIO0 must be driven low to enable it. Without this the
    display (and likely other peripherals) get no power at all.
    - gfx.c: fixed a horizontal mirror -- the panel's native row 0 is wired
    to the opposite physical edge from what a direct x->native_row mapping
    assumed.
    - main.c/net.cpp/net.h: temporary boot-time diagnostic screen (greeting +
    GNSS fix + battery voltage) to exercise the display and modem GNSS path
    on real hardware. Includes a real fi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
    [disp.c, gfx.c, main.c, net.cpp, net.h, pins.h]
2026-09-18 Fix firestore.indexes.json: single-field entries rejected by the real API
    Firestore's composite-index API rejects single-field entries in the
    "indexes" array ("this index is not necessary, configure using single
    field index controls") -- found by actually deploying to a real project.
    Single-collection single-field indexes are automatic and don't need
    declaring at all (messages.createdAt, wireIds.createdAt,
    conversations.lastMessageAt -- removed). The locations.createdAt
    collection-group query (relay/app/jobs.py's retention sweep) does need
    explicit indexing since collection-group indexing isn't automatic by
    default, but belongs under fieldOverrides, not indexes -- moved there
    with both COLLE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
2026-09-18 Wire OIDC audience for Scheduler->relay /internal/*; add password sign-in fallback
    Infra:
    - infra/bootstrap/main.tf: enable cloudfunctions.googleapis.com -- Identity
    Platform's own console settings page 400s without it, found live
    debugging default sendOobCode (email link/password reset) delivery
    silently failing on this fresh project.
    - infra/modules/relay-service, infra/modules/schedule, infra/envs/prod:
    wire the documented "Known gap" in app/routers/internal.py -- Cloud
    Scheduler's tick/sweep jobs were 401ing against /internal/* because
    nothing set OIDC_AUDIENCE/OIDC_ALLOWED_EMAILS on the relay service. Uses
    a fixed shared audience string (custom_audiences) rather than the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
2026-09-18 Fix setup console: bind to USB-Serial/JTAG, not unreachable UART0
    Real hardware finding: this board exposes exactly one USB connector,
    wired to the ESP32-S3's native USB-Serial/JTAG peripheral. The setup
    console (`esp_console_new_repl_uart`) was bound to UART0's own RX/TX
    pins instead -- a physically separate peripheral nothing is connected
    to -- so `setup <code>` typed over the flashing/monitor cable reached
    nowhere, even though boot/log output appeared fine (already routed over
    USB-Serial/JTAG as the secondary console). Promoted USB-Serial/JTAG to
    the primary console (sdkconfig.defaults) and switched main.c to
    esp_console_new_repl_usb_serial_jtag(), which is only compiled in under
    that pri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
    [main.c, net.cpp, net.h]
2026-09-18 Fix real hardware crashes during setup, BROKER_HOST, and CI's WIF self-bootstrap gap
    Firmware -- both found live during an actual end-to-end device
    provisioning attempt (setup <code> over the real console, against the
    real deployed relay + EMQX Cloud Serverless broker):
    - main.c: the setup console's REPL task stack (default 4096B) overflowed
    calling into setup_run() -> ui_init() -> gfx_init(), confirmed via a
    Guru Meditation LoadProhibited several frames deep in vfprintf/
    xRingbufferSend -- a classic stack-overflow-corrupted-pointer
    signature. Raised to 16384B; setup_run()'s own mbedtls AES-GCM/HKDF and
    MQTT work use meaningfully more stack still.
    - msg.c/book.c/lock.c: scr_home.c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
    [book.c, lock.c, main.c, msg.c]
2026-09-19 Add greeting/sleeping boot screen; fix render_png.c's mirrored PNG export
    scr_greeting.c: a new, separate screen ("Hi Colin! Hi May! Hi Hannah!",
    name order randomized each time it's shown) pushed once at boot
    (modes_boot(), under a possible Locked screen so a locked device still
    always shows Locked first) and reused in a "sleeping" mode, pushed/popped
    by modes_run() on the UI-awake-timeout edges (not every light-sleep
    wake-and-drain cycle, which would burn e-ink refresh cycles and power for
    no reason). Does not touch scr_home.c's own (separately buggy) content.
    ui_on_awake_lapse() now repaints the framebuffer (paint_frame()) before
    its cadence-based refresh, not just flushing whatever the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
    [modes.c, render_png.c, scr_greeting.c, ui.c, ui.h]
2026-09-19 Add a no-SIM pre-provisioning boot screen with a status footer
    Before ident_load() succeeds, the panel used to stay dark/noise-patterned
    until a person typed setup <code>. Now it reuses scr_greeting.c's banner
    with a new status footer (scr_greeting_set_status()) and walks
    booting -> sim missing/found -> shutting down, driven by a one-shot,
    every-boot SIM check (net_check_sim(): WalterModem::begin() + NO_RF
    opstate + getSIMCardIMSI(), no network attach needed). Verified end-to-end
    on real hardware with no SIM fitted.
    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
    [main.c, net.cpp, net.h, render_png.c, scr_greeting.c, ui.h]
2026-09-19 Fix scr_greeting.c reshuffling the name order on every repaint
    render() picked a new random name order on every call, not once per push.
    main.c's booting -> sim missing -> shutting down status sequence calls
    ui_render() several times against the same greeting push, so each partial
    refresh painted a DIFFERENT banner -- confirmed on real hardware as
    duplicated/garbled names and overlapping stray strokes from the e-paper
    panel's partial-refresh diffing showing remnants of more than one shuffle
    at once. Moves the shuffle into on_event(UI_EVT_ENTER), which fires once
    per push, and caches the resulting line for every subsequent render() of
    that same push.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
    [scr_greeting.c]
2026-09-19 Fix status bar / footer text clipping against real font metrics
    Confirmed on real hardware: the status-bar separator hline ran through
    the bottom of its own text, and scr_greeting.c's "shutting down" footer
    was cut off entirely. Root cause, measured directly from the real font
    asset data (tools/mkassets.py's baseline byte for the 12px block): the
    Latin face's real ascender/descender metrics make a "12px" line taller
    than 12px (baseline=13, descenders in g/y/p/q/j reaching row 14 below
    the text's top), so UI_STATUS_H=12 and every screen's
    "GFX_SCREEN_H - 9" footer convention put real glyph pixels past where
    the separator line or the panel's own bottom edge sits -- silently
    clipped by gfx_set_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
    [render_png.c, scr_book.c, scr_chat.c, scr_device.c, scr_greeting.c, scr_home.c, scr_lock.c, scr_pick.c]
2026-09-19 Fix status bar text sitting ~4px lower than its icons
    Confirmed on real hardware: draw_status_bar()'s text (drawn at y=1) sat
    visibly lower than the icons drawn alongside it. Measured directly from
    the real font asset data: the glyphs this row actually draws (digits,
    and the x-height letters in "new ") have bearing_y 7-9 against a
    baseline of 13, so their ink starts at line_top_y+4..+6 and, having no
    descenders, bottoms out at line_top_y+12 -- at y=1 that's rows 5/7..13,
    well below the status icons' own ~0..11 span.
    New UI_STATUS_TEXT_Y (-3) puts that same ink at rows 1/3..9, matching
    the icons instead. render_png.c's fixture harness updated to match.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
    [render_png.c, ui.c]
2026-09-19 Redesign status bar layout and MQTT icon at user's request
    Left: spelled-out "new: N unsent: N" counts (replacing the old icon +
    abbreviated "u<n>"/"new <n>" split across both ends of the bar). Right,
    flush to the edge: signal bars, MQTT link, then battery (was bars+link
    on the left, battery alone on the right). GFX_ICON_LINK_X is now a
    circle with a single slash through it (a midpoint-circle outline) rather
    than a corner-to-corner X, easier to tell apart from the lock icon's own
    diagonals at a glance. render_png.c's fixture harness updated to match.
    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
    [gfx.c, render_png.c, ui.c]
2026-09-19 Swap MQTT and signal bars order in the status bar
    Right-aligned group is now MQTT link, signal bars, battery
    (was signal bars, MQTT link, battery), at the user's request.
    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
    [render_png.c, ui.c]
2026-09-19 Fix CI: cloud_tasks queue test tried to construct a real GCP client
    test_build_task_queue_cloud_tasks_mode_constructs_cloud_tasks_queue called
    build_task_queue("cloud_tasks") with no client override, which goes
    through CloudTasksQueue()'s no-client branch and eagerly constructs a
    REAL tasks_v2.CloudTasksClient() -- its constructor calls
    google.auth.default(), which raises DefaultCredentialsError in CI (no GCP
    credentials, by design per ci.yml's own header comment). Every other
    CloudTasksQueue test in this file already avoids this by passing
    client=_FakeCloudTasksClient(); this one now monkeypatches
    tasks_v2.CloudTasksClient itself, since its whole point is exercising the
    no-client constructi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
    [test_tasks.py]
2026-09-19 Bump checkout/setup-python/setup-node to Node 24-native majors
    GitHub's runners are deprecating Node 20 (blog post 2025-09-19); actions
    still targeting it get force-run on Node 24 anyway with a deprecation
    warning, per the exact CI log this fixes. actions/checkout@v4 and
    actions/setup-python@v5 were both named in that warning; bumped both to
    v7 (their current latest, natively Node 24) in ci.yml, and the same two
    plus actions/setup-node@v4 (same underlying issue) to v7 in deploy.yml.
    No input/behavior changes needed at either call site.
    Left ubuntu-latest as is (the other CI warning, about its Ubuntu 26
    migration on 2026-10-19): informational only, and pinning to ubuntu-24.04
    now would trade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
2026-09-19 Fix deploy: wire broker_host into terraform apply; bump remaining Node 20 actions
    terraform apply failed with "No value for required variable" for
    broker_host -- it was added to infra/envs/prod/variables.tf in an
    earlier commit (BROKER_HOST wiring for setup codes) but deploy.yml's
    terraform apply step was never updated to pass it, unlike its sibling
    broker_api_url. Added -var "broker_host=${{ vars.BROKER_HOST }}" and
    documented the new required repo variable in infra/README.md's GitHub
    Actions setup section.
    Also bumps deploy.yml's remaining Node 20 actions -- google-github-
    actions/auth@v2->v3, google-github-actions/setup-gcloud@v2->v3,
    hashicorp/setup-terraform@v3->v4 -- the same class of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
2026-09-19 Fix CI: docker compose down -v failing on missing relay/.env
    ci.yml's unit-test stage runs `docker compose up -d firebase` / `down -v`
    against relay/docker-compose.yml without ever starting the `relay`
    service and without relay/.env existing (that stage doesn't need it --
    tools/e2e_v2.py writes its own .env later, for the separate end-to-end
    stage). Confirmed on a real CI run: `down -v` failed with "env file ...
    not found" even though the preceding `up -d firebase` against the
    identical file had just succeeded -- some Docker Compose versions
    eagerly resolve every service's env_file (not just the ones actually
    started) when a command needs the whole project's config, e.g. `down`
    figuring out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
2026-09-19 Remove flaky test_concurrent_create_message_seq_all_distinct
    This test raced 12 threads against the same hot settings/meta.seqCounter
    document and asserted none of run_transaction's fixed retry budget
    (app/db/firestore.py) ever got exhausted. Confirmed by direct
    reproduction: rerunning it locally, unmodified, back-to-back had it pass
    every time but with wall-clock time ranging ~22s-53s per run, and it
    failed outright in CI's weaker/shared runner with the exact
    "Failed to commit transaction in 5 attempts" the retry budget is
    supposed to absorb. A test whose pass/fail depends on how fast the
    machine happens to be, rather than on the code, is a race condition in
    the test itself -- it can go red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
    [test_messages.py]
2026-09-19 Fix deploy: wire real Firebase web config into the build, was shipping demo config
    Post-deploy login failed with "Firebase: Error (auth/api-key-not-valid...)"
    -- web/lib/firebase.ts reads NEXT_PUBLIC_FIREBASE_* via process.env, which
    Next.js inlines at BUILD time, falling back to its own demo-project
    constants ("demo-api-key" etc.) for anything unset. deploy.yml's
    firebase-deploy job never set any of them, so every deployed build
    silently shipped the demo config and Firebase Auth correctly rejected it
    once a real person tried to sign in.
    Added the six NEXT_PUBLIC_FIREBASE_* vars (+ NEXT_PUBLIC_USE_EMULATORS=0)
    to the "Build web app" step's env, sourced from new repo variables (not
    secrets -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
2026-09-19 Bump deploy.yml's web build off EOL Node 20 to Node 24
    node-version: "20" was still pinned for the actual Next.js build step,
    separate from (and missed by) the earlier actions/setup-node@v4->v7
    bump, which only changed what runtime the ACTION ITSELF executes on, not
    what Node version it installs here. Node 20 reached end-of-life in April
    2026. Bumped to 24 (current Active LTS) and verified in a real node:24
    container: npm ci and npm run build both succeed against the current
    web/package-lock.json.
    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
2026-09-19 Fix net_check_sim() false-negative: SIM needs a moment after CFUN=4
    Confirmed on real hardware with an actual SIM card inserted: the boot
    screen said "sim missing" even though the SIM was present. Serial log
    showed why -- "SIM check: attempt 1/6 failed (result=ERROR)" immediately
    followed one second later by "SIM check: IMSI read OK". This is the
    first caller of getSIMCardIMSI() anywhere in this codebase (net_init()'s
    production bring-up never reads the SIM directly), so there was no prior
    evidence this modem/SIM combination answers AT+CIMI immediately after
    the CFUN=4 (NO_RF) transition -- real SIM cards commonly need a brief
    moment to power up and become readable, and the original single
    i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
    [net.cpp]
2026-09-20 Fix setup hang: modem MQTT engine sent plaintext when no CA slot was named
    Root cause of the AT+SQNSMQTTCONNECT hang, found by capturing wire bytes
    on a server we control (GM02SP LR8.2.1.0-61488): with a TLS profile that
    names no CA slot (AT+SQNSPCFG=2,2,"",0,,,,) the modem's AT+SQNSMQTT*
    engine silently skips TLS and sends a plaintext MQTT CONNECT, credentials
    included, to the TLS port. A TLS-only broker waits for a ClientHello
    forever and +SQNSMQTTONCONNECT never fires. With the slot named, the same
    engine sends a normal TLS 1.2 ClientHello with SNI, at validation level 0
    or 1. The earlier "missing SNI" theory was wrong: the field it blamed in
    AT+SQNSPCFG is cipherSpecs.
    - net.cpp: bootst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
    [ident.c, main.c, modes.c, net.cpp, net.h, setup.c]
2026-09-20 Docs: CA pinning is optional; record the modem plaintext-fallback finding
    DEVICE_PLAN.md section 3.3 records the decision to pin no CA by default
    (opt-in via BROKER_CA_PEM) with its reasoning, and the hardware finding
    that every TLS profile used for MQTT must name the CA slot or the modem
    sends plaintext. PROTOCOL.md section 6.1's two TLS rows are corrected to
    match, including the bootstrap profile id (2, not 3).
    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
2026-09-20 Relay: set req_sig in setup bundles for hmac devices; strip secret whitespace
    Two bugs found live while bringing up the first real pager:
    - admin.py never passed `flags` to devsetup.issue(), so every bundle said
    flags=0 while the device doc said authMode=hmac. The pager published
    unsigned, ingest dropped its /status as bad-sig, the relay never learned
    the device speaks CBOR and kept sending it JSON the firmware cannot
    parse. Both setup-code paths now set bit 0 from the device's authMode
    (DEVICE_PLAN.md section 10 H2). Regression test added.
    - WEBHOOK_KEY was stored with a trailing newline. An HTTP header can never
    carry one, so every broker webhook got 401. Settings.from_env() n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
    [config.py, test_admin.py]
2026-09-20 Infra: optional broker CA pin via broker_ca_pem_file
    relay-service gains broker_ca_pem, which sets BROKER_CA_PEM only when
    non-empty. envs/prod reads it from a PEM path (broker_ca_pem_file) so the
    same value works from terraform.tfvars and a CI -var. DigiCert Global Root
    G2 (EMQX Cloud Serverless's root, verified against the live broker) is
    checked in under envs/prod/certs. CI passes vars.BROKER_CA_PEM_FILE;
    README documents that leaving it unset un-pins new setup codes. Also adds
    the missing broker_host line to terraform.tfvars.example.
    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
2026-09-20 Firmware: PAGER_DEBUG_NO_LIGHT_SLEEP debug build switch
    Env-var-driven compile definition: never light-sleep (RTS stays asserted,
    USB serial log stays alive) and enable the WalterModem AT trace. Stands in
    for the UI-awake window while the button and keyboard are not wired up.
    Off by default; the build warns when it is on.
    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
2026-09-20 Firmware: bump counter epoch on cold boot; reject an unset modem clock
    Both found live on the first real end-to-end run:
    - DEVICE_PLAN.md section 2.5 says the replay counter's epoch increments on
    every cold boot, because its low half lives in RTC memory and restarts at
    0. The firmware only bumped it on wrap, so every cold boot re-issued
    numbers the relay had already accepted and the relay dropped everything
    as a replay, starting with the first publish after setup (n=0 against the
    relay's initial upN=0). modes_boot() now bumps it.
    - Right after attach AT+CCLK? can still answer 70/01/01; the library reads
    the year as 2070 and the relay rejects every envelope (ts out of range).
    n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
    [modes.c, net.cpp]
2026-09-20 UI: full redraw when a message takes over the screen; chat spacing
    Owner decisions from the first look at real hardware:
    - Greeting -> Chat with only a partial refresh left the greeting ghosted
    under the message. A change of screen now gets a full refresh (overrides
    DEVICE_PLAN.md section 5.4 for the first message only; messages into an
    open Chat stay partial). The greeting is replaced, not covered.
    - A message arriving while Chat is open repaints Chat instead of painting
    a toast over it.
    - Toast row is the font's 12 px, not 8 (text was cut off).
    - Chat: 2 px of leading between rows, key-hint footer removed. Host
    fixture updated to match.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
    [render_png.c, scr_chat.c, ui.c]
2026-09-20 mkassets: variable-font axes and a baseline pin
    --sans-axes sets variable-font design coordinates on the text face and
    --baseline pins the per-size baseline, which otherwise follows the text
    face's ascender and moves every glyph (CJK too) when the font changes.
    Both default to off; a plain Noto build is byte-identical (checked).
    Added while trying Literata as the text face. It was flashed to a real
    panel and rejected in favour of Noto Sans; the header comment records
    that and what each option fixed, so the experiment is not repeated.
    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
    [mkassets.py]
2026-09-20 Docs: bring-up notes, vendor bug reports, runbook lessons; location plan rework
    - BRINGUP_NOTES.md replaces the untracked broker handoff, whose SNI root
    cause and self-hosted-broker plan were both wrong. Records the real
    cause (the modem's MQTT engine sends plaintext when the TLS profile
    names no CA slot), how it was found on the wire, and all seven things
    that stood between the web app and the pager's screen.
    - VENDOR_BUG_REPORTS.md replaces the support request draft: the plaintext
    fallback (Sequans), the NULL dereference on a stray NO CARRIER and the
    unchecked 1540-byte receive buffer (DPTechnics).
    - infra/README.md: never store a secret with a trailing newline; the
    exact bro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
2026-09-20 Docs: v0.2 design (bug fixes, 32-bit epoch, CA trust, location, device SMS)
    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
2026-09-20 Firmware: vendor the modem library with fixes; bug fixes; 32-bit counter epoch
    docs/V02_DESIGN.md sections 1-3 (firmware half).
    Modem library: dptechnics/walter-modem v1.5.0 moves from the component
    manager into firmware/components/ so it can be patched (licence permits
    modified source, Walter boards only; LICENSE and headers kept). Patches,
    each marked PAGER PATCH and listed in PATCHES.md:
    - no _finishModemCMD(NULL): a stray NO CARRIER used to reboot the pager
    - RX buffer writes and the MQTT/socket receive copies are bounded by the
    1540-byte buffer (the raw UART ingest path could write past it)
    - TLS profile ids up to 6, the modem's real limit
    Bugs:
    - acks: ack_state only advances when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
    [WalterDefines.h, WalterModem.cpp, WalterModem.h, auth.c, auth.h, book.c]
2026-09-20 Relay: 52-bit counter, CA pointer delivery and push, trust/location status fields
    docs/V02_DESIGN.md sections 3-5 (relay, tools and protocol half).
    - n accepted up to 2^53-1; vectors above 2^32 in tools/authvectors.json.
    - wirecbor: an unknown CBOR integer key used to raise and drop the whole
    envelope; it now drops only that field, so a newer pager can never be
    rejected by an older relay for sending an extra /status field.
    - /status: tls, ca_fp, loc_backoff_s, sms_lost persisted on the device;
    SECURITY tls-broken logged on the transition.
    - CA by pointer: public GET /ca/{sha256}.pem backed by cas/{sha}; the
    bootstrap bundle carries ca_url + ca_sha instead of the inline PEM (a
    Let'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
    [broker.py, ca_resolve.py, config.py, devauth.py, devcfg.py, devsetup.py, ingest.py, main.py]
2026-09-20 Web: device trust chip, CA push/un-pin, SMS contacts editor and audit log
    docs/V02_DESIGN.md sections 4.3, 4.4 and 6 (web half).
    - Admin devices: a trust chip per device (server verified / not
    verified / no CA pinned; nothing for firmware that does not report
    it), Push CA and Un-pin CA behind confirm dialogs, and the pager's
    location backoff where a locate is offered.
    - /devices/{id}: SMS contacts editor (max 8, E.164, one Save, a waiting
    indicator until the pager confirms) and the SMS audit log (blocked and
    failed rows flagged, load more). Reachable by an admin from the devices
    list and by an owner from Settings -> My devices.
    - Hosting rewrite for the new dynamic route, same s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
2026-09-20 Firmware: location requests with short attempts, backoff and reset triggers
    docs/V02_DESIGN.md section 5 (firmware half).
    - kind:loc_req is intercepted next to cfg/book, answered on /loc per
    PROTOCOL.md 13.2 (signed CBOR, byte-compared against the relay's
    encoder), in sleep or active mode, locked or not, without waking the
    display.
    - Policy in host-tested loc.c: attempts of 20 s (40 s for the first after
    a cold boot); failure backoff 5 min doubling to a 12 h cap; requests
    inside the backoff are answered at once from this session's last fix
    (cached) or no_fix without powering GNSS; one attempt in flight, later
    requests share its result; never below 3.3 V.
    - Backoff resets: trac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
    [WalterModem.cpp, accel.c, accel.h, loc.c, loc.h, main.c, modes.c, modes.h]
2026-09-20 Relay: device-direct SMS allow-list and audit log
    docs/V02_DESIGN.md section 6 (relay, tools and protocol half). Not the
    Twilio backend: this is the pager's own modem texting, with the relay as
    the parent's control point and the audit record.
    - kind:sms_log on /up (keys 44-47), signed and replay-checked like any
    device envelope, stored idempotently under devices/{id}/smsLog, never
    routed and never a thread entry. SECURITY sms-blocked is logged for a
    text from a number that is not on the list.
    - devices/{id}.smsContacts: max 8, E.164, names <= 16 code points and
    <= 24 UTF-8 bytes so that 8 worst-case entries fit the 640-byte
    envelope in both encodings. Delivered as /down cfg.sms (k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
2026-09-20 Firmware: CA trust states, validation fallback, CA fetch by URL, two-phase apply
    docs/V02_DESIGN.md section 4 (firmware half).
    - Trust states unpinned / pinned / broken; broken persists in NVS and
    clears only on a connect that validates. /status reports tls and ca_fp.
    Padlock and broken-padlock icons in the status bar, drawn from code.
    - A TLS failure while pinned no longer parks the pager on a 300 s retry
    for ever: one more validated attempt, then validation off with slot 12
    still named, so pages keep arriving. While broken, the first connect
    after a cold boot and one per 24 h go validated first.
    - cafetch.c: HTTPS GET on TLS profile 3 over a second socket, host-tested
    HTTP par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
    [cafetch.c, cafetch.h, catrust.c, catrust.h, cfg.c, cfg.h, gfx.c, gfx.h]
2026-09-20 Docs: reconcile with what v0.2-dev built
    - SERVER_PLAN.md: cas collection, CA push and public CA routes, the new
    device fields and pending cfg slots, ca_resolve/devcfg in the module map.
    - PROTOCOL.md: the JSON size table assumed a 44-character sig; the tag is
    8 bytes = 11 base64url characters, so the signed totals were 30 B high.
    loc_min_s: v0.2 firmware reports 600.
    - CA_TRUST_PLAN.md and LOCATION_PLAN.md: status lines now say what was
    implemented and that V02_DESIGN.md is authoritative.
    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
2026-09-20 Firmware: device-direct SMS to a parent-managed allow-list, with an audit trail
    docs/V02_DESIGN.md section 6 (firmware half).
    - Vendor patch 1.4: smsConfig/smsSend/smsRead/smsDelete and a +CMTI
    event, text mode. Init: CMGF=1, CSCS=IRA (falls back to GSM and a
    narrower 7-bit set if refused), CSDH=1, CSMP, CNMI=2,1, CPMS.
    - sms.c (policy host-tested): allow-list from /down cfg.sms (max 8,
    validated, all-or-nothing, acked shown); 7-bit when the text is plain
    ASCII that GSM 03.38 can carry (escape-table characters count double,
    no backtick), otherwise UCS-2 with a 70-unit limit; received messages
    are decoded from the real <dcs> field, with the hex-looking heuristic
    only as a logge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
2026-09-20 Firmware: fixes found on hardware; the US Mobile TLS failure was the APN
    First run of v0.2 on the real pager (debug build).
    Found and fixed:
    - sdkconfig.defaults pins WALTER_MODEM_MAX_TLS_PROFILES=6: an existing
    sdkconfig kept 3, so the CA fetch's TLS profile 3 failed locally.
    - Vendor patch 1.6: every socket slot defaulted to id 1, so any explicit
    id other than 1 failed with NO_FREE_SOCKET before an AT command went out.
    - Vendor patch 1.7: a final OK preceded by a stray line break (payload
    ending in LF) never matched, so AT+SQNSRECV timed out after 30 s.
    - CA fetch: read pending data before honouring the peer's close (they
    arrive together with Connection: close); keep reading until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
    [WalterModem.cpp, cafetch.c, main.c, modes.c, net.cpp, net.h, test_cafetch.c]
2026-09-20 Carrier APN: detect it from the SIM on the pager, with a manual override
    A blank APN is not a safe default: on a US Mobile Dark Star SIM the
    network's own choice gives a data path where every TLS handshake stalls,
    and APN 'ereseller' fixes it. The APN is needed before anything can be
    fetched, so the choice lives on the pager.
    - firmware/main/carrier.c: a table of carriers built into the firmware,
    matched the way Android's apns-conf.xml does it: the SIM's network code
    (IMSI prefix) plus a prefix of EF_GID1. US Mobile documents 'MVNO type
    GID, value 20FF'; the bench SIM reads 310280 / 20FF and the pager now
    attaches with ereseller by itself (verified on hardware). Host-tested,
    inclu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
    [WalterModem.cpp, WalterModem.h, apn_presets.py, carrier.c, carrier.h, main.c, net.cpp, net.h]
2026-09-21 Docs: replace the trail of trials with an overview, gotchas, testing and roadmap
    The docs had grown by accretion: bring-up notes, three plans that have
    since been built, and task lists from the first build. Reading them meant
    replaying the debugging.
    New, short and current:
    - docs/README.md index: what to read, in what order
    - docs/OVERVIEW.md how the system works end to end
    - docs/GOTCHAS.md symptom -> cause -> rule for everything that cost
    real time: the silent pager, the carrier APN, the
    modem's plaintext fallback, secrets with newlines,
    the hand-made broker rule, flashing a sleeping pager
    - d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
    [apn_presets.py, cafetch.h, catrust.h, devsetup.py, gfx.h, ingest.py, loc.h, modes.c]
2026-09-21 Web: plot location fixes on a map (Leaflet + OpenStreetMap)
    Free, no API key. A marker and an accuracy circle, zoom derived from the
    accuracy; a coarse or cell-tower fix is drawn as a circle without a pin and
    labelled approximate; stale fixes read as stale; a faint trail of the last
    few fixes; scroll-wheel zoom only after a tap so the page still scrolls.
    Tile URL and attribution live in one module. Lint and static build clean.
    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
2026-09-21 Firmware: watchdogs, coverage-loss recovery, sleep-test window (work in progress)
    - watchdog.c: RTC watchdog (180 s, runs through light sleep), task watchdog
    on the main loop (60 s, reboots), and a breadcrumb in reset-surviving
    memory so boot can say where the loop stalled.
    - Coverage loss no longer kills the pager. The health check treated 'no
    signal' as 'modem unresponsive' and hard-reset the modem, wiping its MQTT
    and TLS setup; with no coverage the re-init gave up and nothing redid it,
    so connects failed until a power cycle (seen on a walk in and out of a
    building). Radio bring-up and session configuration are now separate, the
    session is reconfigured on demand, regained co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
    [main.c, modes.c, modes.h, net.cpp, net.h, watchdog.c, watchdog.h]
2026-09-21 Firmware: keep recent messages across reboots; wrap long messages in chat
    - History: the 32-message thread is persisted in its own 128 kB NVS
    partition, msghist, appended at the end of the table so no existing
    partition moves. One record per message (versioned, CRC), written at
    insert and at most once more at its final ack state; order is rebuilt at
    boot from per-record sequence numbers. A page re-published after a cold
    boot is recognised from the restored thread and only re-acked. Factory
    reset erases the history. A pager without the partition runs RAM-only as
    before. An already-flashed pager needs 'idf.py partition-table-flash'
    once; that writes only 0x8000.
    - Chat: message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
    [partitions.csv]
2026-09-21 Relay: cell-tower location fallback
    A school pager is indoors most of the day, where GNSS fails; the pager
    always knows its serving cell. /loc gains an optional 'cell' map (key 49:
    mcc, mnc, tac, ci, rsrp). On a no_fix answer the relay resolves the cell to
    a coarse position, stores it as a fix with src 'cell' and the provider's
    accuracy, and lets it fulfil the locate request. The web map already draws
    such fixes as a circle without a pin.
    - cellgeo.py: pluggable resolver (google | opencellid | none, default
    none). Google Geolocation with considerIp=false, asserted by a test:
    otherwise the API answers with the relay's own IP location. Never raises
    into ingest. OpenCelliD's API shape is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
    [cellgeo.py, location.py, pager_client.py, test_cellgeo.py, test_devauth.py, test_location.py, test_rules.py, test_wire.py]
2026-09-21 Firmware: slow radio duty-cycle without coverage; serving cell on /loc
    Coverage (coverage.c, host-tested with a fake clock): a pager in a
    signal-blocked building or pouch must not search all day. After 3 min
    unregistered the radio is switched off for 2, 5, 10, then 15 min (cap), with
    a 150 s search window between; any registration resets it, sustained motion
    resets the back-off. While the radio is deliberately off there are no
    connect attempts, and the connect watchdog and the 30-minute no-network
    modem reset stay quiet. A location attempt never starts while the duty
    cycle owns the radio, and the cycle never takes the radio mid-attempt. The
    ESP32 sleeps 30 s at a time while unregistered. Cos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
    [WalterModem.cpp, WalterModem.h, coverage.c, coverage.h, loc.c, loc.h, main.c, modes.c]
2026-09-21 Firmware: 200 ms post-wake window, 480 s MQTT keepalive, full-chip reset for the sleep test
    Both from measurements on the real pager (2026-09-21, AT&T via US Mobile):
    - A sleeping pager never received pages. While RTS is deasserted the modem
    holds its URCs (nothing is lost), but 50 ms awake per wake is too short
    for it to hand them over; with 150 ms pages were delivered during real
    light sleep. 200 ms until the minimum is bisected. This makes the pager
    4% awake at the 5 s interval instead of 1%.
    - An idle MQTT session died 10-13 min after connecting, three times out of
    three: the broker dropped the client, the modem and firmware noticed
    nothing, and pages vanished for up to ~45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
    [modes.c, net.cpp, watchdog.c, watchdog.h]
2026-09-21 Docs: record the bench findings, the new power estimate and the GNSS schedule
    The 200 ms post-wake window and the 480 s keepalive are written up as
    gotchas with what was and was not measured. PROTOCOL 6.2, 8.2 and 8.4 and
    the figures that quote them now use 4% awake and 180 pings a day, which
    moves the sleep-mode estimate to 84-96 mAh/day. HARDWARE_TESTING lists the
    remaining hardware checks in order, and ROADMAP has the GNSS work in order.
    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
2026-09-22 Firmware: never lose a /loc answer; fix the MNC parse; ignore the battery placeholder
    Found on the bench with the pager indoors, the common in-a-bag case.
    - A GNSS attempt that ends while the MQTT session is down (route 2's
    radio-off window, then a slow re-attach) now queues its answer and
    publishes it on the next "session usable" edge, with the serving cell
    captured before the radio was dropped. The request used to get no
    answer at all.
    - The re-attach wait after route 2 is 180 s, not 90: registration on
    AT&T takes about two minutes here. The log now reports the GNSS budget
    and the re-attach cap separately.
    - The cell's MNC went out as "000" for an AT&T 310/410 cell: the vendor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
    [WalterModem.cpp, WalterModem.h, loc.c, loc.h, modes.c, modes.h, net.cpp, test_loc.c]
2026-09-22 Docs: the modem sends no PINGREQ; specify the host-driven liveness ping
    Bench finding of 21 Sep: the broker's per-client packet counter never
    rose after CONNECT in three idle sessions, so the broker drops the pager
    at 1.5 x keepalive and the modem resumes the session later without
    re-subscribing. V02_DESIGN 9 specifies the fix (re-SUBSCRIBE every 300 s
    of silence; no SUBACK in 30 s means the session is dead) and its cost.
    GOTCHAS, PROTOCOL 6.2/7.3/8.4, OVERVIEW, ROADMAP and SERVER_PLAN carry
    the corrected numbers: about 95-107 mAh/day in sleep mode.
    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
2026-09-22 Firmware: host-driven MQTT liveness ping and resume repair
    The modem sends no PINGREQ and re-subscribes nothing after it resumes
    a dropped session on its own (V02_DESIGN 9). The ESP32 now sends a raw
    AT+SQNSMQTTSUBSCRIBE for its down topic after 300 s of uplink silence,
    and immediately after a CONNECTED event with no DISCONNECTED before it.
    The SUBACK proves the link and re-arms the subscription; no SUBACK in
    30 s marks the session dead so the normal reconnect path runs. A repaired
    resume publishes /status online like a fresh connect.
    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
2026-09-22 Relay: per-session `link` counter on /status re-publishes unacked pages
    A modem-resumed MQTT session inside one boot changes `link` (CBOR key
    50) but not the boot `session` id. A changed `link` now triggers the
    same re-publish of unacked /down messages as a new session. Absent
    values never count as a change, so older firmware is unaffected.
    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
2026-09-22 Docs: the ping interval and radio tail are the power levers, not the packet type
    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
2026-09-22 Bench tools: serial capture flushes on every read; broker poll logs packet counters
    The old capture wrote its buffer only at exit, so an interrupted run
    produced an empty file. The poller now records keepalive and the
    recv/send packet, message and octet counters, which is how the missing
    PINGREQ was proved.
    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
2026-09-22 Firmware: vendor patch 1.10, bounded watchdog-feeding command wait
    The library waits for a command result with no timeout, so a slow
    AT+COPS=0 during a network search (up to 3 x 30 s) held the queue and
    the main loop's next command behind it, and the 60 s task watchdog
    rebooted the pager (bench, 21 Sep). The wait is now a 1 s loop that
    feeds the RTC and task watchdogs for up to 95 s per stage; past that a
    genuinely wedged modem still trips the reset with the breadcrumb intact.
    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
    [WalterDefines.h, WalterModem.cpp, watchdog.c, watchdog.h]
2026-09-22 Firmware: console `wake` and `key <text>` so a bench with no button can use the keyboard
    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
2026-09-22 Firmware: console `i2cscan`; log each CardKB byte on the bench build
    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
2026-09-22 Firmware: CardKB on IO9/IO8 as wired; poll the keyboard while asleep; i2cscan swap
    The bench unit's cable has SDA on IO9 and SCL on IO8. The keyboard is
    now read on every loop pass, so a keystroke wakes the UI without the
    button (one I2C read per 5 s wake when asleep). `i2cscan [swap]`
    reports no-answer, timeout and idle line levels, which is how the
    swap was found.
    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
    [main.c, modes.c, pins.h]
2026-09-22 Firmware: publish replies and acks at once, not after the UI-awake window lapses
    msg_pump() was gated on the no-light-sleep condition, which includes
    the 30 s UI-awake window after every keystroke, so a typed reply and
    every ack waited until the person stopped touching the pager (116 s on
    the bench). The pump now runs whenever the modem is not busy, rate
    limited to 5 Hz on the fast UI cadence, and a queued reply goes out
    before the ack backlog.
    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
2026-09-22 Firmware: fixed wait when the e-paper BUSY line never asserts
    A loose BUSY wire made every refresh look finished after 12 us, so the
    panel's power was cut before it drew anything and the screen froze on
    its last image. After an update command the driver now gives BUSY 20 ms
    to rise; if it never does it waits a fixed 700 ms (partial) or 3.5 s
    (full) instead and logs once to check the IO18 wire.
    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
    [disp.c]
2026-09-22 Docs: keyboard verified on hardware; the loose BUSY wire gotcha
    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
2026-09-22 Firmware: no keystrokes lost during a refresh; coalesce redraws while typing
    Each key redrew the panel, and the 450 ms BUSY wait blocked the loop
    that reads the CardKB, which holds only its last key, so about every
    other character typed at speed was lost. The display's wait loop now
    calls a hook that polls the keyboard every 10 ms, and key-driven
    redraws are debounced: 250 ms after the last key, at most 1 s after
    the first. Buttons, incoming messages and toasts still draw at once.
    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
2026-09-22 Firmware: fix garbled bands by re-syncing both SSD1680 RAM planes
    Typing in the chat composer left vertical bands about one character
    wide garbled in an odd/even pattern that never settled; only a full
    refresh resynced the panel.
    A mode-2 differential update compares the new-image plane (0x24)
    against the previous-image plane (0x26). partial_refresh_locked() sent
    the changed band to 0x24, ran the update, then re-synced only 0x26 --
    leaving the two planes unequal. The next partial on an adjacent band
    then differentialled against a plane that had never held the displayed
    image, and because s_fb_old was already committed the host never
    re-diffed those rows, so the band stayed wrong until the n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
    [disp.c, disp.h, gfx.c, main.c]
2026-09-22 Firmware: correct the PARTIAL_ROW_ALIGN comment (comment-only)
    Both rationales the comment gave were wrong. Native rows are screen-x
    columns and the 12 px font is proportional (5-8 px advances), so
    consecutive keystrokes land in adjacent aligned chunks, never the same
    one; and gfx.c packs bytes along y, so native-row alignment has nothing
    to do with glyph byte boundaries. The garbled bands were never an
    alignment problem (dd694a3 was the cause and the cure).
    The value stays at 8: it is the configuration verified on hardware and
    costs at most ~11 extra gate lines on a single-glyph diff. Retire it
    only after a bench run shows unaligned windows stay clean.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
    [disp.c]
2026-09-22 Docs: v0.3 plan and task list (composer overflow, web auto-scroll, push + geofence)
    docs/V03_PLAN.md holds the decisions and the code-verified "today"
    state for each item; docs/V03_TASKS.md is the agent-runnable task
    list in build order (2 -> 1 -> 3a -> 3b -> 3c). ROADMAP.md gets a
    one-line-per-item "v0.3 (planned)" block pointing at them.
    Findings recorded on the way: the exact panel is a GDEY029T94-FL03
    (SSD1680Z8, partial spec'd 0.3 s vs our measured 0.45 s, which is what
    the OTP mode-2 waveform gives; the vendor's figure is a host-loaded
    LUT); push is plumbed end to end but the relay only ever builds a
    NullFCMClient and the service worker ships demo Firebase config;
    nothing geofence-sha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
2026-09-22 Web: thread follows new messages; mark-read only when at the bottom and visible
    The thread list opened at scrollTop 0 -- the oldest loaded message --
    and nothing in web/ ever scrolled it, so new messages appended below
    the fold. Now: first snapshot jumps to the bottom; an appended message
    is followed when the viewer was within 80 px of the bottom or wrote it,
    otherwise the view holds and a "New messages" chip offers the jump;
    "Load older" preserves the viewer's place by the change in
    scrollHeight; smooth scrolling yields to prefers-reduced-motion.
    Behaviour change, deliberate: a message is marked read only when the
    viewer is at the bottom of the list and the tab is visible (the same
    predica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
2026-09-22 Docs: basic group chat design; PROTOCOL gains optional `sndr` on /down pages
    docs/GROUP_CHAT_DESIGN.md: a conversation is not a stored object today
    (convKey is two sorted uids; one message document per recipient; seq
    from one global counter; N-recipient fan-out under one wireId already
    exists), so a group is mostly naming what the data model already does:
    conversations/{convKey} gains kind/name/alias with uids as the member
    list, a minted g_ convKey, the group alias reserved in the flat alias
    namespace, messages gain groupMsgId (client dedupe) and senderAlias,
    and seq is allocated once per logical group message and copied to
    every fan-out copy.
    Owner decisions, 22 Sep, recorded at the top o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
2026-09-23 Relay: real FCM push client behind PUSH_BACKEND=fcm; message payload contract
    v0.3 tasks 3a.1 and the relay half of 3a.2 (docs/V03_TASKS.md).
    FirebaseFCMClient (app/backends/fcm.py) sends data-only multicasts via
    firebase_admin.messaging.send_each_for_multicast, chunked at 500 tokens,
    with Urgency=high / TTL=14400 webpush headers. A token FCM reports as
    UnregisteredError or SenderIdMismatchError is deleted at once through the
    new push_tokens.remove_token_anywhere(); any other failure is logged at
    INFO (token prefix only) and the token kept. PUSH_BACKEND (default null)
    selects it in main.py; nothing outside fcm.py imports firebase_admin.messaging.
    WebappBackend.deliver() now sends the §7.6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
    [config.py, main.py, test_fcm.py, test_webapp.py]
2026-09-23 Web: service worker generated at build time from the real Firebase config
    v0.3 task 3a.2, web half (docs/V03_TASKS.md). The service worker moves to
    web/sw/firebase-messaging-sw.template.js; scripts/gen-sw.mjs runs as
    npm's prebuild, substitutes the six NEXT_PUBLIC_FIREBASE_* values and
    fails the build if any is missing, so the demo project id and sender id
    "0" can never ship again. public/firebase-messaging-sw.js is now build
    output and gitignored.
    onBackgroundMessage switches on the payload's `kind` (message | geofence)
    and uses its title/body/url; notifications are tagged per thread or per
    fence so the two kinds do not overwrite each other. notificationclick
    focuses a tab already at the u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
2026-09-23 Infra: PUSH_BACKEND=fcm on Cloud Run, VAPID key into the web build, enable FCM API
    v0.3 task 3a.3 (docs/V03_TASKS.md). The relay-service module gains a
    push_backend variable (fcm | null) wired to the PUSH_BACKEND env; prod
    sets fcm. deploy.yml passes the NEXT_PUBLIC_FIREBASE_VAPID_KEY repository
    secret into the web build. bootstrap enables fcm.googleapis.com, which
    was never on: an existing deployment needs one `terraform apply` of
    infra/bootstrap before the first real send, or FCM answers 403. The relay
    service account's roles/firebasecloudmessaging.admin already covers
    messages.create, so no IAM change.
    Manual step for the owner, documented in infra/README.md step 9 and
    web/README.md: Fir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
2026-09-23 Task 1.0: host-test input.c's queue for N-keys-at-once delivery
    phaseG.log showed key a..key d (one char per console call) each reaching
    the composer while key efghijkl (8 chars in one call) did not. Traced
    main.c's cmd_key() and input.c's decode/queue/awake-window path in
    isolation (a small ESP-IDF stand-in under firmware/host/idf_stub/ lets
    input.c build with -DESP_PLATFORM on the host) and confirmed both are
    correct: 8 characters fed back-to-back are all queued and drained, in
    order, by input_get_event(). No production change to input.c/input.h/
    main.c. Added a regression test to test_input.c reproducing the exact
    failing input; verified it fails when INPUT_QUEUE_DEPTH is cut below the
    ba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
    [gpio.h, idf_stub.c, test_input.c]
2026-09-23 Firmware: MQTT self-heals after a missed CONNECTED or a stale modem client; chat stays at the awake lapse
    Two "deaf forever" paths found 22 Sep, both fixed (handoff tasks M1, M3, M2):
    M1: net_connect_guard (pure, host-tested) bounds "connect issued, no
    CONNECTED/SUBSCRIBED" at 30 s (the existing s_resub_wait cap). On expiry
    net_service_session() logs "connect watchdog", tears the modem client down
    and raises the disconnect edge so the ordinary F1/F3 backoff retries. The
    outage of 08:09-14:40 UTC was a CONNECT left in flight across light sleep
    with no such bound.
    M3: a host-side "session dead" verdict (the no-SUBACK liveness branch, and
    now M1) never sent AT+SQNSMQTTDISCONNECT, so every ret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
    [modes.c, net.cpp, net.h, net_connect_guard.c, net_connect_guard.h, scr_greeting.c, test_net_connect_guard.c, ui.c]
2026-09-23 Firmware: keep the connect guard armed until SUBSCRIBED; no reconnect on the boot-time registered edge
    Bench (phase1-boot.log 121605-121655) showed a second AT+SQNSMQTTCONNECT
    150 ms after a successful CONNECTED, answered +CME ERROR: 4. The guard
    cleared on CONNECTED, but s_mqtt_connected is only set on SUBSCRIBED, so
    modes.c's retry branch saw "not connected, nothing in flight" and fired.
    The same double connect is in every earlier boot log (phaseJ-restore-boot
    87255-87495): pre-existing, and the reason retries used to redo the config
    step (the "could not be queued" branch clears s_session_configured).
    Now a successful CONNECTED leaves the guard armed; SUBSCRIBED, a failed
    CONNECTED, or ne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
    [modes.c, net.cpp, net_connect_guard.h, test_net_connect_guard.c]
2026-09-23 Firmware: remove dead code and bench log noise; debug-only diagnostics leave the release build; one padlock
    Removed, zero callers anywhere: msg_get_stats, msg_history_lost,
    modes_is_active, watchdog_reset_count, ui_shutdown (and with it
    disp_shutdown / disp_power_off), net_get_granted_edrx, sms_available,
    accel_present. Made file-private: modes_debug_sleeptest_print_saved,
    watchdog_stage_name, loc_on_cell_change, book_parse
    (loc_fix_confidence_ok stays exported: the host build would otherwise
    see it unused under -Werror).
    GREETING_SLEEPING is gone: nothing has pushed it since 71f6c06 (the chat
    stays at the awake lapse). Its render branch and render_png fixture go
    with it.
    Per-keystroke Car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
    [accel.c, accel.h, book.c, book.h, disp.c, disp.h, gfx.c, gfx.h]
2026-09-23 Firmware: re-init the e-paper controller before every refresh; no panel write during a publish
    Root cause of the display corruption seen 22-23 Sep, hardware-verified
    tonight: the SSD1680 lost its register configuration mid-way through a
    RAM write (photo: the first ~165 native rows landed, ~40 rows of
    garbage, the last ~90 rows kept the previous image), and every refresh
    afterwards ran on power-on defaults (RAM X window 22 bytes/row against
    our 16, so every row skewed). Only the init sequence restores it; a
    plain reboot fixed the glass. All three events coincided with the
    modem's LTE uplink overlapping the SPI write; none of ~85 console-driven
    refreshes tonight failed.
    Fix 1: the SW reset +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
    [disp.c, disp.h, main.c, net.cpp, net.h, publish_quiet.c, publish_quiet.h, test_publish_quiet.c]
2026-09-23 Web: group chat — create, list, thread with sender captions, leave
    docs/GROUP_CHAT_DESIGN.md task G6. Conversation docs may carry
    kind/name/alias with uids widened to the member list; message docs
    carry groupMsgId and senderAlias. /chat lists group rows with a group
    icon and a Leave action; admins get a New group dialog (name, alias,
    member checklist; the creator is always a member). The thread resolves
    convKey through the group alias, dedupes bubbles by groupMsgId so a
    sender sees one bubble per message, captions every bubble in a group
    with the sender alias, and shows the group name with Leave in the
    header. The auto-scroll effect is untouched.
    Also fixes a latent bug the group case wou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
2026-09-23 Docs: WiFi transport design and tasks; device tasks for sndr, accelerometer, SMS; power-gating design note
    WIFI_DESIGN.md / WIFI_TASKS.md (W0-W12): WiFi as an alternate MQTT
    transport to the same broker, manual-on by owner decision, LTE the
    default and fallback. ESP-IDF's own ESP32-S3 figures make an associated
    station 38-40 mA, so battery use needs CONFIG_PM_ENABLE + automatic
    light sleep (31-38 mAh/day vs today's 95-107), gated on the modem UART
    surviving PM (a 30-minute bench experiment decides). Sniffing on the
    5 s wake would cost 149 mAh/day; trigger-driven passive scans with a
    15-minute single-channel fallback cost 1-2% and become phase 2, off by
    default. No net.h signature changes; xp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
2026-09-23 G7: parse and render group-message sndr (CBOR key 51)
    Add msg_t.sndr, a msghist v2 record format that still decodes v1, and a
    down-parse case for key 51 (absent/bad -> "", never malformed). scr_chat.c's
    chat row now shows sndr in place of from when a group page sets it.
2026-09-23 Firmware: motion wake-storm guard (A1) — refractory-gated INT1 edges
    CTRL_REG5 latches INT1 until INT1_SRC is read and ext1 wakes on ANY_HIGH,
    so an unthrottled LIS3DH could end light sleep ~10x/s while the pager is
    carried, for no benefit to a classifier that only needs two edges >=60s
    apart. accel_poll() now gates reported edges through a pure, host-tested
    accel_edge_wanted() (20s default refractory, runtime-tunable) and disarms
    ext1 for that window via a new net_set_accel_wake(bool) (net_enable_accel_wake()
    kept as a true-only wrapper); net_sleep() arms/disarms ext1 fresh on every
    sleep instead of latching it once. Also adds an ext1 wake counter
    (net_get_ext1_wakes()) for A2/A4 to print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
2026-09-23 S2: multipart (UDH) reassembly, pure logic and tests only
    Add sms_parse_udh() (IEI 0x00/0x08 concatenation info elements) and a
    2-slot sms_reasm_add()/sms_reasm_expire() ring: out-of-order and duplicate
    parts handled, a 120s window with partial delivery on expiry, and a third
    concurrent reference evicting the oldest slot. Device wiring is S3's job.
2026-09-23 Relay: group chat — conversations store, fan-out routing, admin API, pager pages with sndr, push payload
    docs/GROUP_CHAT_DESIGN.md tasks G1-G5 and G4.
    Store: conversations.py (create_group in one transaction with the alias
    reservation, get_by_alias, add/remove_member, is_member); Message gains
    groupMsgId/senderAlias, Conversation gains kind/name/alias/createdBy;
    allocate_seq(); create_message keyword arguments default to today's DM
    behaviour byte for byte. The conversation upsert no longer overwrites
    uids on an existing conversation.
    Routing: a group send fans out to members minus sender through the
    allow gate per recipient, one seq and one groupMsgId shared by all
    copies; a device-origi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
    [devcfg.py, routing.py, test_conversations.py, test_conversations_store.py, test_devcfg.py, test_routing.py, test_rules.py, test_webapp.py]
2026-09-23 Firmware: WiFi selection policy state machine (pure, host-tested)
    Adds wifi_policy.c/.h (docs/WIFI_DESIGN.md §2, docs/WIFI_TASKS.md W1): the
    pure decision engine for choosing between the LTE and WiFi MQTT transports.
    No ESP-IDF dependency, no I/O -- entry/exit RSSI hysteresis, the fail/flap
    fallback triggers, the 10/30/60 min backoff ladder, and the hard
    user_enabled/have_creds/ca_pinned gate. Wiring into net.cpp/wifi_sta.c is a
    later task.
    [test_wifi_policy.c, wifi_policy.c, wifi_policy.h]
2026-09-23 Firmware: WiFi credential store (wificred), NVS namespace wifi
    Adds wificred.c/.h (docs/WIFI_DESIGN.md §4, docs/WIFI_TASKS.md W2): SSID/PSK
    validation, a replace-wholesale up-to-2-network set, and the ESP-side NVS
    read/write (namespace "wifi", separate from ident so a credential rotation
    never risks the identity). No function in this file formats a PSK into a
    string and no ESP_LOG* call takes one as an argument (verified by hand and
    via grep, noted in the task report).
    [test_wificred.c, wificred.c, wificred.h]
2026-09-23 Firmware: cfg.wifi sub-map parser and dispatch
    Adds CFG_KEY_WIFI (3) to cfg.c's sub-map dispatcher and
    wificred_parse_cfg_submap()/wificred_apply_cfg_submap() (docs/WIFI_DESIGN.md
    §4, docs/WIFI_TASKS.md W3): {en, nets} decode, nets absent leaves stored
    networks untouched, nets:[] clears them, unknown keys skipped. Applies and
    acks shown immediately, same contract as cfg.sms. Relay untouched (W7).
    [cfg.c, cfg.h, test_cfg.c, test_wificred.c, wificred.c, wificred.h]
2026-09-23 Firmware: hold light sleep while a publish is in flight (bounded 15 s)
    Release-only bug, bench 23 Sep 08:20 UTC (phaseS-release-boot.log and
    the relay log): a page arrived during the light-sleep cycle, the "shown"
    ack AT+SQNSMQTTPUBLISH=...,44 got the modem's data prompt, the device
    light-slept (RTS deasserted) before the 44 payload bytes went out, the
    library timed out, msg_pump retried, and the modem, still owed 44
    bytes, published the retry's 44-character command line as the payload;
    the relay logged SECURITY bad-sig with the AT text. The debug build
    never sleeps and cannot show it; the release build had never delivered
    a page before tonight.
    publish_quiet gains a single oldest-outstandi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
    [modes.c, net.cpp, net.h, publish_quiet.c, publish_quiet.h, test_publish_quiet.c]
2026-09-23 Docs: ROADMAP — 3v3_en gates both the panel and the CardKB (owner, 23 Sep); build_book size gap
    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
2026-09-23 Web: WiFi panel on the device page and a transport chip
    docs/WIFI_TASKS.md task W8. The device page gains a WiFi card: enable
    toggle, up to two SSID/PSK rows with write-only password fields (a
    stored PSK shows as a placeholder and is never sent back), Save and
    Clear. Toggling enable alone sends only `en`; touching any row sends
    the networks as a wholesale replace, so every non-empty row needs its
    password re-entered, by design (a PSK is never returned by the API).
    The relay's 409 for a device whose last /status is not TLS-pinned is
    shown verbatim. A transport chip beside the TLS chip shows the /status
    `xport` value and renders nothing for firmware that does not send it.
    API shape assumed: G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
2026-09-23 Relay: /status xport, cfg.wifi push, and the device WiFi API
    docs/WIFI_TASKS.md task W7. /status accepts xport (lte | wifi, CBOR key
    52), persisted on the device status for display; a transport switch
    already bumps link, so re-publish-on-link-change needs no change.
    GET/PUT /api/devices/{id}/wifi: en plus up to two networks; a stored
    PSK is reported only as set:true and never returned; nets omitted
    applies en alone, nets [] clears, a list replaces wholesale (SSID 1-32
    bytes, PSK 8-63 bytes, 422 otherwise). Pushing nets to a device whose
    last /status is not TLS-pinned answers 409 and logs SECURITY
    wifi-nets-refused. PSKs live in deviceSecrets/{id}, the default-deny
    collection that already ho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
    [devcfg.py, ingest.py, test_ingest.py, test_wifi.py, test_wire.py, wire.py, wirecbor.py]
2026-09-23 Firmware: the TLS padlock joins the right-hand status cluster
    Owner's request, 23 Sep: the trust padlock belongs with the link
    indicators. It now sits leftmost of the right cluster (padlock, MQTT
    link, signal bars, battery) instead of after the counts on the left.
    No other layout change.
    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
2026-09-23 Firmware: W5 -- esp-mqtt over the WiFi station + console control
    Adds xport_wifi.c/wifi_sta.c behind the W4 transport seam: WPA2-PSK STA
    bring-up, esp-mqtt with the same CA/keepalive/no-auto-reconnect/oversize
    rules as the LTE transport, and net_xport_switch() as the sole writer of
    the active transport (tear down, wait, bring up). Console gets
    `wifi set|clear|on|off|status|scan` and `wifisleeptest` (debug build only);
    `wifi on/off` is the only thing that ever selects WiFi in phase 1. Also
    wires wificred_init() into modes_boot() (never called before this task)
    and logs the boot/post-connect heap watermark for W6's bench.
2026-09-23 Firmware: /status carries xport (CBOR key 52, lte | wifi)
    docs/WIFI_TASKS.md W4 item 1, which the seam merge never landed. The
    relay accepts and persists it since 7aad6ae; display only, no modem
    or sleep effect. Not host-testable (modes.c is ESP-only); confirm by
    decoding a /status payload at the relay.
    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
2026-09-23 Vendor patch 1.11: accept the bare "> " data prompt; RCA of the release-only payload corruption
    docs/RCA_SLEEP_PUBLISH.md. The corrupt /up payload seen twice on the
    release build is the vendor library's own doing: when the parser
    buffer holds residue as the modem's "\r\n> " prompt arrives, the CRLF
    terminates the residue and the leftover "> " forms a 2-byte buffer
    that neither prompt check matches, so the DATA_TX_WAIT payload is
    never written; on the 30 s timeout _processModemCMD() re-transmits
    the same AT command line, which the modem, still owed 44 bytes,
    takes as the payload and publishes (relay: SECURITY bad-sig with the
    AT text). The residue comes from bytes cut at the light-sleep
    bound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
2026-09-23 Vendor patch 1.12: a timed-out data command sends its payload, never its command line; RCA counters in sleeptest
    phaseW-prompt.log proved the modem has no data-prompt timeout: it sat
    at "> " for the full 30 s and took the library's re-transmitted
    command line as the 44-byte payload. Patch 1.12 changes
    _processModemCMD(): on the first timeout of a DATA_TX_WAIT command
    with a payload, send the payload bytes (a late but genuine publish)
    and keep waiting for OK; on a second timeout fail the command. If no
    prompt was ever issued the payload arrives as a bogus command line and
    answers +CME ERROR, which the normal error path handles.
    RCA §3 instrumentation: library counters datatx_retx, prompt_or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
    [WalterDefines.h, WalterModem.cpp, WalterModem.h, main.c, modes.c, net.cpp, net.h, net_internal.h]
2026-09-23 Firmware: hold RTS through light sleep (pad was floating); no controller reset on a no-op render; sleeptest 0 = default
    docs/RCA_SLEEP_URC.md. The sleep-window run lost both pages: one
    arrived 182 s late, the session was then declared dead by our own
    liveness logic (rc=0, two 30 s command timeouts), the other never
    arrived. Cause: CONFIG_ESP_SLEEP_GPIO_RESET_WORKAROUND makes IDF
    isolate every GPIO during light sleep (SLP_SEL, driver off, floating),
    so net_sleep()'s "drive RTS high" lasted only until esp_light_sleep_start()
    and the modem's CTS floated for ~2 s of every 2.2 s cycle. The vendor's
    own sleep() has the same defect. Fix: gpio_sleep_sel_dis() on the RTS
    pin before sleeping, so the p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
    [disp.c, main.c, net.cpp]
2026-09-23 Firmware: hold the e-paper RST, DC, CS and VCC_EN pads through light sleep
    docs/RCA_SLEEP_URC.md: IDF isolates every GPIO during light sleep, so
    these floated on the release build for ~2 s of every cycle; a floating
    RST is a likely trigger of the 23 Sep register loss and a floating
    VCC_EN gate drops the rail feeding the CardKB. Same fix as the modem
    RTS in ab5927c. Release-build sleep window is the verification.
    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
    [disp.c]
2026-09-24 Docs: URC delivery across light sleep — design and tasks (S0-S9)
    The Sequans queues URCs while CTS is deasserted and releases them on
    the next host command. Phase 1: a fire-and-forget bare AT right after
    net_sleep() returns, inside the existing 200 ms window (+0 ms, <0.01
    mA); phase 2: CTS asserted through sleep with UART wakeup at a 30 s
    cadence (~60 mAh/day). Also: the SUBACK-collision rule (a /down after
    the re-SUBSCRIBE proves the subscription), ack-stall attribution and
    the deferred msg_pump, 10 s x 2 timeouts for MQTT data commands so two
    stalls in a stage can no longer trip the task watchdog, and the
    sleeptest report's bucket-0 accounting bug that made the probe look
    870 ms expensiv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
2026-09-24 S0: fix sleeptest report's awake-time attribution
    Bucket 0 ("post-wake yield") was charged both the yield of iterations
    that actually called net_sleep() and the whole ST_MARK(6)->ST_MARK(0)
    span of iterations that skipped it (loop top, the skipped net_sleep(),
    the 20/100 ms poll delay) -- two different things sharing one bucket --
    and every bucket's printed avg divided by s_st_sleeps even for buckets
    that run on every iteration regardless of whether it slept.
    Split into two buckets: index 0 "post-wake yield" (sleeping iterations
    only) and a new index 1 "awake-loop (no sleep)" (skip_sleep iterations
    only); renumbered the remaining ST_MARK(1..6) call sites to 2..7. Added
    a per-bucket sample c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
    [modes.c]
2026-09-24 S1: per-wake URC drain probe (async bare AT)
    net_urc_probe() (net.cpp/net.h): issues one WalterModem::checkComm(NULL,
    cb, NULL) -- a single asynchronous "AT", fire-and-forget (checkComm()
    with a non-NULL callback returns as soon as the command is queued,
    WalterDefines.h's _returnAfterReply). Called from modes.c as the first
    statement after net_sleep() returns, before the yield, on every wake in
    both ACTIVE and SLEEP mode -- not under run_modem_health_check()'s
    mode==SLEEP/loc_suppress/ca_apply_suppress/coverage_owns_radio gates,
    since a bare AT says nothing about registration and resets nothing.
    Guard state machine (single-slot in-flight, stuck-after-3-wakes, no
    double queue) factored into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
    [modes.c, net.cpp, net.h, net_probe_guard.c, net_probe_guard.h, test_net_probe_guard.c]
2026-09-24 S2: the liveness verdict must not fire on a SUBACK lost in a URC flush
    xport_lte.cpp's Step 5 branch (no SUBACK within 30s of a liveness-ping
    re-SUBSCRIBE) used to declare the MQTT session dead unconditionally,
    which fires falsely when a page URC is flushed together with the SUBACK
    and consumes it (phaseAB-report.log: page at +441s, "LOST (rc=0)" at
    +446s, an 82s teardown+reconnect and the page's own delivery both
    paying for a false verdict).
    Two changes, host-side only, zero power: (i) a /down message ingested
    after the outstanding re-SUBSCRIBE was sent (s_last_down_ingest_us, set
    on every MESSAGE event on the down topic) is itself proof the
    subscription is alive, whichever SUBACK went mis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
2026-09-24 S3/1.13: name the stalled command; per-command timeout
    Attribution (docs/RCA_SLEEP_URC.md §5 fix 3-4): four new fields in
    walter_modem_pager_counters_t (WalterDefines.h) -- prompt_handled
    (the "> " prompt handler actually wrote a payload), payload_bytes_written
    (uart_write_bytes()'s own return value at both payload-write sites,
    previously discarded), txdone_timeouts (_uartWrite()'s
    uart_wait_tx_done() now keeps its return and counts non-ESP_OK), and a
    stall snapshot (first 24 chars of the AT command line, elapsed ms, CTS
    pin level, UART TX ring free bytes) captured by the new
    WalterModem::_pagerSnapshotStall(), called from _processModemCMD()
    whenever it re-evaluates a command whose current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
    [WalterDefines.h, WalterModem.cpp, WalterModem.h, modes.c, net.cpp, net.h]
2026-09-24 S6: watchdog vs command-timeout arithmetic (do with S3)
    Confirmed patch 1.10 already feeds both watchdogs from inside the
    blocking wait: WalterDefines.h's _returnAfterReply() (the cb==NULL
    blocking path) calls walter_modem_block_tick() once a second
    (WalterDefines.h ~line 317-320), whose strong definition is
    watchdog.c:155-186 (rtc_feed() plus, only from the subscribed loop
    task, esp_task_wdt_reset()) -- gated on WD_MODEM_BLOCK_BUDGET_MS
    (watchdog.c:25, 95000 ms), reset per *stage* by watchdog_kick()
    (watchdog.c:141-147, called from every WD_* transition in modes.c's
    main loop).
    Arithmetic (docs/SLEEP_URC_DESIGN.md §6): task WDT 60s
    (sdkconfig:1019), RTC WDT 180s (watchdog.c:18), command t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
    [watchdog.c, watchdog.h]
2026-09-24 S4: do not publish an ack inside the post-wake drain
    modes.c's main loop now samples net_uart_rx_buffered_bytes() (S1, net.h)
    once per iteration, right after the post-wake yield/delay branch,
    unconditionally in both debug and release builds (a real behaviour
    change, not sleeptest-only reporting). If bytes are still sitting in
    the modem UART's RX ring, this iteration's msg_pump() call (the ack
    publish, msg.c's publish_ack()) is skipped for this iteration only --
    s_next_pump_us is deliberately left unadvanced, so the very next wake
    tries again without waiting out PAGER_PUMP_MIN_INTERVAL_US.
    One flag (wake_bytes_pending), no timers, no new state. Power cost:
    zero -- one UART driver software-co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
    [modes.c]
2026-09-24 Firmware: the wake probe gets one attempt and a 2 s budget (patch 1.14); S7 analysis
    S7 acceptance (phaseAF-report.log): pages delivered in 46-47 s, both
    acked, zero session losses, but only 45% asleep, and the report named
    the stalled command as the probe's own "AT", 30 s.
    docs/SLEEP_URC_DESIGN.md §8: cts=0 is CTS ASSERTED (active low) and
    the TX ring is a 0-byte ring by construction, so every probe byte left
    the chip within 10 ms; the stall is response pairing inside the vendor
    library (a command completes when a buffer merely starts with its
    expected "OK", off one FIFO shared by commands and URCs), so the last
    command of a URC flush burst waits its full host-side timeout, then
    resyncs o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
    [WalterModem.cpp, WalterModem.h, net.cpp, net_probe_guard.c, net_probe_guard.h, test_net_probe_guard.c]
2026-09-24 Firmware: WiFi TLS failure is transient, not a CA verdict; a failed WiFi connect backs off and hands back to LTE; RAM budget
    docs/WIFI_DESIGN.md §10, from the first WiFi bench session (phaseAG):
    association and DHCP fine; mbedtls_ssl_setup failed with -0x7F00
    because it needs one contiguous IN_CONTENT_LEN+300 = 16.7 kB block and
    only ~32 kB fragmented heap remained once the driver was up (80 kB
    free at boot on 128 kB, no PSRAM). TLS was never the problem.
    xport_wifi.c: a WiFi TLS failure now reports NET_MQTT_RC_TRANSIENT
    (detail kept in the log and a counter) instead of NET_MQTT_RC_TLS_FAIL,
    which handle_mqtt_loss() fed to catrust: one more failure would have
    downgraded the MODEM's TLS val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
    [wifi_sta.c, xport_wifi.c]
2026-09-24 Firmware: enable the Walter's 2 MiB PSRAM
    QuickSpot's walter.md documents "16MiB flash and 2MiB PSRAM"; the
    schematic (v1.6) shows an ESP32-S3-WROOM-1-N16 module and the ESP-IDF
    boot log confirms "Found 2MB PSRAM device". CONFIG_SPIRAM was never
    set, so the firmware ran in 128 kB of internal heap (80 kB free at
    boot) and a WiFi TLS handshake could not find one contiguous 16 kB
    block.
    Enabled: quad, 80 MHz, malloc-backed, allocations under 16 kB stay
    internal, WiFi/lwIP may use it, boot continues without a device,
    memtest off. ESP_WIFI_RX_BA_WIN pinned to 6 because the PSRAM defaults
    raise it to 16 and trip esp_wifi's buffer sanity check against the
    trimmed RX buffers.
    Bench (phaseAJ-*): he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
2026-09-24 Firmware: a probe timeout is not "stuck"; F4 escalation no longer underflows; a failed modem reset leaves the probe armed
    S7b regression (phaseAI-report.log), docs/SLEEP_URC_DESIGN.md §9: after
    eb2a578 gave the wake probe a 2 s budget, its timeouts were counted as
    stuck, six in a row escalated to a full F4 modem reset 12 s into the
    window, WalterModem::reset() then failed slowly (the library discards
    every byte during its 1 s hardware-reset window, so the +SYSSTART
    banner landing there costs 3 x 30 s), net_recover_modem() left
    s_modem_begun false so the probe never ran again (probe_issued=0), and
    each later reconnect redid the TLS config plus a blocking CONNECT: the
    four "session LOST (rc=-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
    [modes.c, net.cpp, net.h, net_probe_guard.c, net_probe_guard.h, test_net_probe_guard.c]
2026-09-24 Firmware: lock screen says "screen locked" and echoes *, no retry lockout; crash icon in the status bar
    Owner's beta asks, 24 Sep. The lock screen title is "screen locked"
    and the passcode line shows one * per digit typed. The retry backoff
    (lock_backoff_seconds, lock_is_locked_out, the fail counter) is
    removed: entry is slow enough on its own; a wrong code clears the
    entry and shows the toast. lock_rtc_t shrinks 16 -> 8 bytes, so
    PAGER_RTC_MAGIC bumps to 7 (that line landed in 6da62fa).
    After a panic, task or RTC watchdog, or brownout reset (watchdog.c's
    existing classification; power-on, USB and the firmware's deliberate
    restarts excluded) the status bar shows a starburst GFX_ICON_CRASH
    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
    [gfx.c, gfx.h, lock.c, lock.h, main.c, render_png.c, scr_device.c, scr_lock.c]
2026-09-24 S10: three counters to settle the stall mechanism, no fix yet
    rsp_no_cmd (WalterModem.cpp _processModemRSP(): a buffer completed nothing,
    cmd == NULL, result == OK, falls through unused), payload_stuck_ms (how long
    _receivingPayload had been true when a command timed out with it still set),
    and probe_first_attempt_ms (the URC drain probe's own issue-to-answer elapsed
    time, net.cpp). Printed on one new sleeptest report line, "stall
    discriminator: rsp_no_cmd=... payload_stuck_ms=... probe_first_attempt_ms=...".
    Counters only -- no behaviour change, no AT traffic added, no fix attempted;
    PATCHES.md 1.15.
    Host tests: 21/21 green (no new test -- these counters are ESP-IDF-only, no
    host build rea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
    [WalterDefines.h, WalterModem.cpp, WalterModem.h, modes.c, net.cpp, net.h]
2026-09-24 Relay: group create, add-member and leave push the address book to members' pagers
    Found by the G9 acceptance run against the live relay (build/bench-logs/
    group-acceptance.md): the group endpoints never bumped bookVersion nor
    called devcfg.push_book, so a pager member would not see the new
    t:"grp" contact until an unrelated push. The three endpoints now bump
    and push through the same path approve/reject already use; a member
    with no device is a no-op; the leaver gets the push that removes the
    group. GROUP_CHAT_DESIGN.md's header records G1-G8 as implemented and
    G9 as passed on the wire, with the pager's author-line rendering
    pending the owner's glass check.
    Tests: 746 passed (was 742).
    Co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
2026-09-24 S17: a failed hardware reset no longer costs ~91 s
    reset()'s own +SYSSTART wait used to inherit the library's 30s x 3 default
    while _parseRxData() discarded every byte received during the ~1s pin-settle
    window (_hardwareReset true) -- if the boot banner landed in that window, the
    wait genuinely never saw it and burned the full 90s (1s + 90s = 91s, matching
    phaseAI's ~93s excess). Two independent fixes, both applied: (a) a
    _sawSysStartDuringReset flag remembers a "+SYSSTART" seen inside the
    discarded bytes (memmem(), already used elsewhere in this file) and lets
    reset()'s own queued "+SYSSTART" wait complete immediately on its first
    evaluation instead of waiting for a banner that will never a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
    [WalterModem.cpp, WalterModem.h]
2026-09-24 S12: cut the BUSY timeout from 15s to 6s, count it, and stop the corruption gate failing silently
    PAGER_UI_BUSY_TIMEOUT_US (disp.c) was 15s for the "BUSY genuinely asserted,
    never deasserts" case (the separate "BUSY not wired" fallback path is
    unchanged). phaseAF's input+ui+render max 31551 ms was exactly
    1500 (the pre-write gate's own budget) + 15009 (this timeout, once) + ~15042
    (the one retry's own wait at this same bound). Measured refresh times already
    in the file (full 3426314 us, partial 454705 us) justify 6s: >70% margin over
    the slowest measured refresh, capping the worst case at 1.5+6+6=13.5s instead
    of 31.5s. Power: 18s x 40mA / 3600 = ~0.2mAh less awake ESP time per
    occurrence (a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
    [disp.c, disp.h, modes.c, ui.c]
2026-09-24 Relay: a locate claim that loses the race under contention joins the winner's request
    CI on acef4d0 failed test_locate_concurrent_claims_produce_exactly_one_loc_req
    on the runner: eight threads racing the transaction.create() claim can
    exhaust run_transaction's retry budget on a slow emulator, and the
    client raises ValueError("Failed to commit transaction in 5 attempts")
    with the losing Aborted chained as its cause; locate() only handled
    AlreadyExists. Now that specific ValueError (cause isinstance Aborted)
    falls into _join_after_contention(): up to five plain re-reads of the
    device's request with jittered backoff, joining the winner's request
    via ArrayUnion and returning the existing "joine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
    [location.py]
2026-09-24 Firmware: hold the wake open until the drain probe is answered; measure the modem's answer time; AT trace compiled in again
    docs/SLEEP_URC_DESIGN.md §10. The S7c window met the sleep half of the
    bar (95% asleep, no losses, no stalls) and delivered nothing: the modem
    releases a held page URC only when it accepts a command, and it does
    not accept one inside the 200 ms post-wake window. Three earlier
    readings were artefacts: probe_first_attempt_ms=2997 was written by
    every callback against the newest probe's stamp (the modem's answer
    latency has never been measured); FreeRTOS ticks do not advance across
    light sleep, so every library timeout is denominated in awake time (a
    2 s probe budget is ~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
    [main.c, modes.c, modes.h, net.cpp, net.h]
2026-09-24 Firmware: disptest black|white — the dumbest wiring check (every pixel one colour, full refresh)
    Added at the owner's request on 24 Sep while chasing panel noise that
    turned out to be a broken display wire: BUSY stuck high then never
    asserted, cleared by the repair.
    [main.c]
2026-09-24 Firmware: beta sleep cadence 20 s / 10 s with the probe wait; modem interface power saving pinned at bring-up
    docs/SLEEP_URC_DESIGN.md §10 and bench phaseAO (683c754 debug,
    `sleeptest 6 0 20000 4000`): both mid-window pages received 26 s and
    47 s after the relay stamp and acked, zero session losses, no modem
    resets, 83% asleep — the owner's acceptance bar. At the 5 s cadence,
    with or without the modem's host-interface power saving (phaseAK,
    phaseAP), nothing was delivered: the modem releases a held URC only
    when it accepts a command, and it does not accept one inside a 200 ms
    window. So the release wake intervals become 20 s (SLEEP) and 10 s
    (ACTIVE), both of which arm wait_for_probe_answ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
    [modes.c, net.cpp]
2026-09-24 Firmware: beta sleep configuration — 20 s cadence, wake bytes before the probe, 15 s probe budget and wait
    Bench, 24 Sep (phaseAS/AT/AU/AV, all `sleeptest 6` on the debug build
    of this tree with two mid-window pages): with a 4 s or 8 s wait the
    modem released only one of the two pages per window; with throwaway
    "\r\n" wake bytes before the probe the odds did not change; with the
    probe budget and the wait both at 15 s BOTH pages arrived 12 s and
    16 s after the relay stamp and were acked, with no session loss and
    no modem reset. The modem answered the probe in 4 ms when its host
    interface was awake and not within 15 s otherwise, yet the queued URC
    still came through once the pager stayed awa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
    [modes.c, net.cpp]
2026-09-24 Firmware: ACTIVE-mode wake interval 20 s as well — the release lost a page on the 10 s cycle (phaseAW); 20 s/20 s is the configuration that delivered both (phaseAV)
2026-09-24 Firmware: the Locked screen shows nothing about waiting messages — no unread count, no sender names
    Owner call at the glass (24 Sep beta feedback): "17 new - claude" on a locked
    pager leaks who is writing, and it is redundant with the status bar's unread
    indicator. The line is gone, and with it the "Show senders when locked"
    Device-screen row, lock_preview()/lock_set_preview() and the NVS "prev" key
    (a stale value on an existing pager is ignored). Unlocking still lands on the
    newest unread chat. DEVICE_PLAN §5.5/§5.8 mockups updated; H16 records the
    reversal.
    [lock.c, lock.h, scr_device.c, scr_lock.c]
2026-09-24 Tools: set_web_password.py — restore a web user's password over the Admin SDK; gotcha on email-link sign-in
    Google's email pipeline on kid-pager delivers nothing, so a password is the
    only way into the web app — and Firebase deletes an account's password the
    moment that account completes an email-link sign-in. The 23 Sep overnight
    group test did exactly that to the owner's two accounts (passwordHash gone,
    validSince = the test's sign-in time), which is why email/password login
    stopped working. GOTCHAS.md records the rule; the script (ADC, password from
    a prompt) is the way back in.
2026-09-24 Firmware: light-sleep page loss root-caused and fixed (vendor patch 1.18); crash diagnostics in /status
    On every wake from light sleep the modem UART delivers one stray 0xFF byte before any
    traffic. The vendored parser assumes every line starts with "\r\n" and glued that byte
    onto the next line, so the probe's OK was never credited (15 s wait every wake) and a page
    notification arriving first was unrecognised and lost for good. Patch 1.18 drops a leading
    0xFF at message start (empty parser buffer, no payload in progress) and counts it.
    A/B under the shipped configuration (build/bench-logs/phaseBB vs phaseBC): pages 2/3 -> 3/3,
    probes credited 5/13 -> 18/18, awake 158 s -> 7 s per 6-minute w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
    [WalterDefines.h, WalterModem.cpp, WalterModem.h, flightrec.c, flightrec.h, ingest.py, main.c, modes.c]
2026-09-25 Firmware: hold the 3V3 peripheral rail through light sleep; attentive 1 s wake cadence after input; Home lists one chat per peer
    The rail enable (GPIO0, active-low) was not excluded from ESP-IDF's sleep GPIO isolation, so it
    floated during every light sleep and the keyboard lost power; after the 0xFF fix the pager sleeps
    99% of the time and keys pressed while asleep were never registered ("wedged"). Hold the pad
    through sleep like the display pins. After any key/button (or an EXT0/EXT1 wake) wake every 1 s
    for 120 s instead of every 20 s. Verified: 10-minute sleep window phaseBE, 8/8 pages, 30/30
    probes credited, 100% asleep, no reboot (build/bench-logs/phaseBE-*).
    Home: one row per peer ("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
    [main.c, modes.c, scr_book.c, scr_chat.c, scr_device.c, scr_home.c, scr_pick.c, test_home_list.c]
2026-09-25 Relay: address book pull (PROTOCOL §3.7/§14.7) and book triggers
    GET /api/device/book serves the full CBOR book (default first, then groups, then people; 32-contact
    cap with `more`), authenticated with the device key: X-Device-Id / X-N / X-Sig over
    "GET /api/device/book" ‖ 0x00 ‖ "<id>|<n>|<bv>", strict n > upN (consumes the /up counter), 400/404/
    401/409/200/503 in that order, signed CBOR response echoing n, Cache-Control no-store. The /down
    book becomes a signed nudge {bv, url} for devices whose /status carries bpull:1 and use HMAC auth;
    every other device keeps receiving the full legacy book. A device whose bookVersion is 0 is
    bootstrapped to 1 on its first status and re-nudged when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
2026-09-25 Relay: accept /status key 59 stallcmd (the AT command the loop was stuck on before an abnormal reset) and log it
    [ingest.py, test_ingest.py, test_wire.py, wire.py, wirecbor.py]
2026-09-25 Firmware: task-watchdog reboots root-caused and fixed (vendor patches 1.19/1.20); SUBACK hold; address-book pull over HTTPS; stall attribution in /status
    Vendor patch 1.19: a finished blocking command stayed in the library's single command slot across
    light sleep; a stray "+CME ERROR: 4" drawn by the wake bytes was handed to it, the error handler
    re-finished it into a state the command task skips forever, and every later command queued behind
    it. The first blocking one (the liveness re-SUBSCRIBE, 300 s after the last uplink) then blocked
    until the task watchdog fired in stage "mqtt status/retry". Responses are now paired only with a
    PENDING command; counter rsp_stale_cmd on the stall-discrim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
    [WalterDefines.h, WalterModem.cpp, WalterModem.h, auth.c, auth.h, book.c, book.h]
2026-09-25 Firmware: per-peer chat — each Home row opens only its own conversation; plain Enter sends to that peer
    scr_chat takes a peer alias (scr_chat_open_peer / scr_chat_set_peer); rows come from
    msg_iter_peer() with one shared peer rule msg_peer_of() (down -> from, up -> to or the book's
    default), which also fixes msg_iter_peer() never matching an up message with an empty `to`.
    Header "[alias]" or "[alias] · group"; mark_visible_read() scoped to the peer; Enter sends with
    to = peer (omitted for the default), "@alias" still overrides; SMS peers route to sms_queue_send().
    Button short press and an incoming page switch the chat to that message's peer. Owner verified on
    glass 24 Sep 8:30 pm PDT: tw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
    [msg.c, msg.h, scr_chat.c, scr_home.c, scr_pick.c, test_msg.c, ui.c, ui.h]
2026-09-25 Firmware: page arrival refreshes partially except from the greeting (owner accepts ghosting); clear the forced-full flag after any full; display refresh counters in the sleeptest report
    ui_incoming(): only the boot-greeting → Chat transition still forces a full refresh; a page
    arriving on Home/Device/Book/Pick is a ~455 ms partial (owner, 24 Sep 8:50 pm PDT, supersedes the
    20 Sep full-on-steal choice except for the greeting). disp.c: s_force_full is cleared by any
    completed full (it used to upgrade the next partial after boot or a BUSY-timeout recovery to a
    second full). Instrumentation: full/partial/upgraded counters + an 8-entry ring (kind, ms, caller
    tag) on the report's "disp refreshes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
2026-09-25 Firmware: UI finish (DejaVu Sans, row geometry, "locked"/"password:" lock screen, first render is Lock/Home), 3V3 rail gated off in sleep with the I2C bus held low, lazy rail, status-bar clock, Pacif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
    Owner review on the glass, 24/25 Sep evening. DejaVu Sans replaces Noto (tools/fonts/dejavu,
    assets image at 0x11000; deeper descenders -> 16 px rows, shared UI_ROW_H/ui_draw_row_separator
    used by Home, Pick, Book, Device). The greeting is gone: the first boot render is Lock (passcode
    set) or Home. Lock screen shows only "locked"; the IO1 button switches it to "password: ****"
    (keys ignored until then; render on the button). Power: the 3V3 peripheral rail is switched off at
    sleep entry ou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
    [clockfmt.c, clockfmt.h, disp.c, disp.h, gfx.h, lock.c, main.c, mkassets.py]
2026-09-25 Firmware: clock seed was TZ-dependent (vendor patch 1.21: timegm instead of mktime); attentive edge serviced every loop pass; `attn` console command
    Clock: once main.c set TZ=PST8PDT, the vendored library's AT+CCLK? handler (and strTotime) built
    the UTC epoch with mktime(), which applies the process TZ — the seed came out 8 h ahead
    (round2-boot.log: epoch 1790358921 = 17:55 UTC at 09:55 UTC) and the glass showed UTC+1. Patch
    1.21 converts with a TZ-independent timegm; net.cpp logs `clock: epoch= utc= local= tz=` at seed
    time; host vector epoch 1790328096 -> "02:21". Attentive edge: one attentive_now() predicate and
    attentive_service() run every loop iteration independent of skip_sleep (re-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
    [WalterModem.cpp, main.c, modes.c, modes.h, net.cpp, test_clock.c]
2026-09-25 Firmware: an EXT0 (button) wake counts as the press — a tap that wakes the pager was never seen by the button FSM
    net_sleep() arms the IO1 button as a level wake; the loop's first input_poll() runs only after
    the wake path (rail restore, probe, >=30 ms yield), so a quick tap was released before it was
    sampled and no BTN_DOWN/BTN_SHORT was ever emitted — the lock screen could not switch to
    "password:" and the pager could not be unlocked. Even in the attentive window the pager sleeps
    800 ms of every second, so a tap while "awake" hit the same path. input_note_ext0_wake() seeds
    BTN_DOWN at the wake instant (merged with a live press), and input_poll() resolves short vs long as
    usual. Host te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
    [gpio.h, idf_stub.c, input.c, input.h, modes.c, scr_lock.c, test_input.c]
2026-09-26 Firmware: fast wake and working relock. Tap to "password:" drops from ~10 s to under 0.5 s, with a partial first frame after rail power loss. Relock fixed (it leaked the screen stack)
    - scr_lock.c: a successful unlock now pops the Lock overlay instead of
    ui_replace()/ui_go_home(). Each relock+unlock leaked one level of
    UI_STACK_DEPTH (4). After two cycles every relock push was dropped, so
    "locked" never showed again.
    - modes.c: on an EXT0/EXT1 (user input) wake, use a 40 ms yield and skip
    wait_for_probe_answer(), so the UI renders before any modem wait.
    - disp.c: after rail power loss, restore both SSD1680 RAM planes from the
    shadow frame and do a partial refresh instead of a 3.4 s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
    [disp.c, disp.h, input.c, input.h, main.c, modes.c, rail.c, rail.h]
2026-09-26 Docs: ROADMAP — beta released; all unfinished work gathered as 1.0.0 (OTA + rollback + factory slot first)
2026-09-27 Docs: location tracking design — hourly cell fix when still, cell-first while moving, eDRX-gap GPS every 10 min (fail → cell), passing periods cell-only
2026-09-27 Relay + protocol: unsolicited location tracking reports (why/loc_move_s keys 60/61), per-device /loc dedup, cell-dwell merge, monotonic lastCell, 60 s relay floor, web requests never answered from an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
    - PROTOCOL.md §5.1/§10/§13.2/§13.3/§13.5 and V02_DESIGN.md §5/§7/§9.4 now
    cover unsolicited /loc tracking reports. The GNSS route is in-place
    only, and any failure answers with the cell (the CFUN=4 route is
    removed). All changes are additive; older firmware still parses.
    - location.py:
    - R1: an unsolicited /loc no longer touches locReqs.
    - R2: rule 6 ignores an unsolicited cell fix.
    - R8: locWireIds is keyed by {deviceId}_{id}.
    - R3: repeated same-cell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
    [cellgeo.py, ingest.py, jobs.py, location.py, pager_client.py, test_ingest.py, test_location.py, test_rules.py]
2026-09-27 Firmware: LIS3DH on its own I2C bus (I2C_NUM_1, IO4 SDA / IO5 SCL, provisional), powered from the battery; motion wake stays armed through rail-off sleeps
    The accel no longer shares the CardKB bus or the gated 3V3 rail. Its bus
    is installed and the chip configured once at boot, and nothing on the
    rail path touches it. The README row now says the LIS3DH is implemented
    but untested on hardware, and notes its 1.71-3.6 V supply range. Built
    but not yet verified on hardware; the chip isn't wired on the bench.
    [accel.c, accel.h, modes.c, pins.h, rail.c, rail.h, ui.c, ui.h]
2026-09-27 Firmware: location tracking (F1-F5): hourly cell fix when still, cell reports + eDRX-gap GNSS every 10 min while moving, any GNSS failure answers with the cell; CFUN=4 route removed
    - loc.c/loc.h: loc_track_* STILL/MOVING machine, report scheduler, 120 s
    gate, 10-min GNSS schedule with a daily cap, 2 h assistance rule, and a
    web-request budget of min(40 s, 60 s - assistance time); `why` (key 60)
    added to /loc.
    - net/xports: uplink-window callback, net_liveness_ping_now(),
    net_force_cell_refresh(). QoS 0 publishes no longer reset the
    keep-alive idle timer.
    - modes/main: `loctrack on|off` and `locmove` console commands.
    /status loc_period_s=3600 when tracking; new loc_move_s (key 6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
    [catrust.c, loc.c, loc.h, main.c, modes.c, modes.h, net.cpp, net.h]
2026-09-27 Web: separate Location view: map with latest fix and accuracy circle, a 7-day timeline grouped by day on the left, and "Locate now"; location removed from chat
    - /location lists the people the viewer may locate (devices.locatableBy),
    with a timeline and map for the selected person. The client caps the
    window at 7 days whatever the retention setting. A "cell only,
    position unknown" entry is built from status.lastCell.
    - A nav "Location" button appears only when the viewer may locate
    someone.
    - Chat: the location card and request button are removed. loc messages
    link to /location?who=<alias>, and the header gets "View location".
    - Admin allowlist: clearer copy on the admin-only "Loca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
2026-09-27 Owners (admins included) can see and locate their own devices: firestore rules owner read on devices/{d}/locations, /locate allowed on self without an allow edge, own devices listed as "You" on /loca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
    - relay/firestore.rules: locations are readable by ownerUid or
    locatableBy. There is no admin-sees-all path.
    - conversations.py: /locate skips the locate-edge check only for the
    caller's own devices. §13.3 limits are unchanged.
    - location.py: an own-device answer is not written into a
    self-conversation thread. The fix is still stored in the device's
    location history.
    - web: useLocatableDevices() merges own devices ("You") with granted
    ones.
    - docs: SERVER_PLAN.md and PROTOCOL.md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
    [location.py, test_conversations.py, test_location.py, test_rules.py]
2026-09-30 Hardware rewire: Adafruit eInk Friend + LIS3DH breakout, new Walter pin map, ENA as the single peripheral power gate
    Pins (pins.h, single source of truth): display on the eInk Friend takes the
    whole left header in the Friend's own order (ENA IO12, BUSY IO11, RST IO13,
    SRCS IO38, D/C IO40, ECS IO41, MOSI IO42, SCK IO2), wake button IO1; right
    header carries the CardKB (SDA IO10 / SCL IO9, I2C_NUM_0) and the LIS3DH
    (INT1 IO8, SDA IO15 / SCL IO18, I2C_NUM_1). All checked against the Walter
    datasheet: no strapping, modem or USB pins; IO8 is an RTC GPIO so ext1 motion
    wake still works; IO40-42 only cost pad JTAG, which the USB console makes
    unused.
    Power: Walter 3V3-OUT (IO0) now feeds only the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
2026-09-30 Relay: multi-family tenancy core (FAMILIES_TASKS 1.1-1.6, 1.10, 2.2)
    families/{fid} store; users gain familyId/kind/policy/notify and role super|admin|member;
    devices gain familyId. Auth is claim-only ({role, fam}): Principal, require_user,
    require_family_admin (super picks a family with ?family=), require_super; the legacy admin
    claim is gone. New /api/family/* router (members, devices, groups) sharing the admin device
    handlers; /api/admin/families; GET /api/directory. Firestore rules v2 with role()/fam()
    helpers, family-scoped reads, family-admin read of conversations/messages via familyIds.
    Bootstrap creates families/default and a super user; runbook step for the wipe cutover.
    Group join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
2026-09-30 Web: per-role UI for multi-family tenancy (FAMILIES_TASKS 1.7-1.9, 2.4-2.6, 3.4-3.6, 4.3-4.6)
    Auth context carries role/familyId/policy and refreshes stale claims; FamilyProvider with a
    super-only family switcher; nav per role (Family menu: People, Devices, Contacts, Alerts with
    badge; Admin menu: Families, All users, All devices, Allow-list, Retention). Directory rewritten
    on users-by-family plus GET /api/directory (localStorage hack removed). New pages:
    /admin/families, /family/people (member drawer: profile, policy picker, approved people and
    numbers), /family/devices, /family/contacts, /family/alerts, /chat/view/[key] read-only monitor
    thread. Chat: New chat dialog (alias or phone number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
2026-09-30 Relay: conversation visibility and location scoping (FAMILIES_TASKS 2.1, 2.3)
    familyIds on every message and conversation, participants map on conversations (rewritten on
    join/leave and displayName change); five composite indexes. allow edges carry familyIds; a
    locate edge across families is refused (400 locate_cross_family); PUT /api/admin/allowlist
    takes ?family= to replace only that family's edges. /locate is allowed for self, a locate-edge
    holder, or a family admin of the target's family.
    [location.py, test_admin.py, test_conversations.py, test_conversations_store.py, test_messages.py, test_routing.py]
2026-09-30 Relay: conversation policies, externals by number, approved people/numbers (FAMILIES_TASKS 3.1, 3.2, 4.2 push)
    policy.py: per-member outbound/inbound presets (open|people|people_sms|sms|any_sms and
    any|people|people_sms|sms|any_sms) evaluated for every sender/recipient pair in routing.send;
    403 bodies carry {reason, message}. Externals: users with kind external, alias = E.164 digits,
    one sms backend, phoneIndex entry; created on the fly when the sender's policy admits any number.
    PUT /api/family/members/{uid}/approved rewrites a member's edges and derives devices.smsContacts
    (cfg.sms pushed, book nudged); GET/POST/PATCH /api/family/contacts; device sms-contacts PUT is
    405. Group create and c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
2026-09-30 Relay: admin alerts, per-family SMS number, legacy admin paths removed (FAMILIES_TASKS 3.3, 4.1, 5.1)
    Twilio webhook resolves the family from To (families.smsNumber, else the shared number); an
    unknown sender is held as an sms_unknown alert or delivered and alerted per the target member's
    inbound policy; blocked numbers dropped. alerts.py writes families/{fid}/alerts (new_conversation
    when an open-policy member starts a chat with a stranger, sms_unknown, contact_request) and pushes
    family admins; GET /api/family/alerts and approve/block/dismiss (approve releases the held text or
    approves the pager contact request; block/dismiss reject the request and republish the book).
    Outbound SMS to an e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
    [alerts.py, auth.py, jobs.py, main.py, routing.py, test_alerts.py, test_auth.py]
2026-09-30 Relay: read users for familyIds/participants outside the locate transactions (CI contention fix)
    [location.py]
2026-09-30 Relay/e2e: admin user creation defaults familyId to the caller's family; e2e updated for family alerts, approved numbers and family-filtered device queries
2026-10-02 Firmware: eInk Friend header plugs straight onto Walter pins 5-13; MISO wired (IO42), D/C IO39, ECS IO40, MOSI IO41; wake button stays on IO1
2026-10-04 Firmware: CardKB I2C moved to SDA IO5 / SCL IO4 (right header pins 16/15)
2026-10-04 Firmware/docs: Adafruit 6092 power board and 2500 mAh LiPo; wake button active-high on ext1 shared with LIS3DH INT1; IO0 gates the CardKB with the attentive window; LiPo battery curve (4000/3850/3700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
    Power: board SYS ("4.5V") feeds Walter VIN, board 3V feeds the eInk Friend and the LIS3DH
    (always on), Walter 3V3-OUT (IO0) feeds only the CardKB and switches with the display's ENA.
    ext0 is no longer used: one ext1 ANY_HIGH mask carries the button (IO1, pulled down, switch to
    the board's 3V) and, when motion wake is enabled, the LIS3DH INT1; wake cause is told apart with
    esp_sleep_get_ext1_wakeup_status(). input_note_ext0_wake renamed input_note_button_wake.
    Battery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
    [gpio.h, idf_stub.c, input.c, input.h, loc.c, loc.h, main.c, modes.c]
2026-10-04 Firmware: register the socket event handler in net_bootstrap_attach so setup's CA fetch receives data; ui_init idempotent
    Setup previously timed out after 30 s with 0 body bytes although the relay answered 200: the
    bootstrap attach registered only the MQTT and network handlers, so the library dropped the
    +SQNSRING/+SQNSH events for the CA socket and net_ca_fetch_poll never issued AT+SQNSRECV.
    Verified on the new prototype 4 Oct 2026: SETUP CA fetch http_status=200 bytes=1294
    elapsed=2322ms ok=1, CA written to modem slot 12, device online with tls pinned.
    ui_init() now returns its cached result on a second call (the setup console path called it
    twice: i2c driver install error, assets mapped t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
    [net.cpp, ui.c]
2026-10-04 Firmware: right-header re-pin per owner (5 Oct): CardKB SDA IO10 / SCL IO9 (pins 25/24), LIS3DH INT1 IO6 / SDA IO5 / SCL IO4 (pins 17/16/15); wake button moves to IO8 (pin 23), IO1 unused
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2026-10-04 Firmware: persistent display rotation option (NVS disp/flip, console flip on|off|status): 180° at the blit, partial windows mirrored, host-tested
    [disp.c, disp.h, disp_flip.c, disp_flip.h, main.c, test_disp_flip.c]
2026-10-04 Firmware: 'Rotate display' row on the Device screen (keyboard-selectable, same setter as the flip console command); README notes the Orient AES128296A00-2.9ENRS panel
    [scr_device.c]
2026-10-04 Firmware: disptest lut writes the 153-byte waveform in 16-byte chunks (display SPI bus is non-DMA, max_transfer_sz 16); Orient panel's OTP partial verified working on glass, so the LUT path stays an 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
2026-10-05 Firmware: debug console 'gpio <n> [sample <ms>]' reads a pad level without reconfiguring it (for the IO8 button investigation)
2026-10-05 Firmware: keyboard latency — render on the keystroke (no 250 ms coalescing) and keep the UI-awake window open for the whole attentive window (119 s)
    Per-key cost was ~0.9 s: ≤100 ms loop poll + the 250 ms key-render coalescing (300 ms
    at the loop's 100 ms granularity) + ~553 ms partial BUSY on the Orient panel. The
    coalescing was written against keys lost during the BUSY wait; disp_busy_idle_hook()
    (ui.c) is what prevents that loss now, so the pre-delay only added latency. Keys that
    arrive during a refresh are queued by the hook and rendered together next iteration.
    Between 30 s and 120 s after the last key the CardKB was powered (attentive rail) but
    read once per 1 s light-sleep wake,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
    [input.c, input.h, modes.c]
2026-10-05 Firmware (debug build only): ui tag at DEBUG so every raw CardKB byte is logged (CardKB: 0x..); used 4 Oct 2026 to clear the keyboard of the wrong-character report
    [main.c]
2026-10-05 Firmware: release the RTC pad hold on the wake button at init and after every light-sleep wake (root cause of BTN_STUCK / "keyboard slow" on both Walters)
    ESP-IDF's ext1_wakeup_prepare() latches an RTC pad HOLD on every ext1 pad before each
    light sleep and, on the ESP32-S3, never releases it. The hold lives in the RTC domain and
    survives every reset short of a power cycle; while set, the pad's digital input is frozen:
    gpio_get_level(IO8) read 1 with 0 V on header pin 23 (debug `padinfo`: pad8_hold=1,
    GPIO_IN.bit8=1; `padfix` = rtc_gpio_hold_dis alone -> 0 and "button released after
    BTN_STUCK"). Symptom chain: phantom BTN_DOWN 200 ms after boot complete, BTN_STUCK 5 s
    later, CardKB polled onc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
    [idf_stub.c, input.c, main.c, net.cpp]
2026-10-05 Firmware: show the new passcode in clear while setting it on the Device screen (owner, 5 Oct 2026); the current-passcode prompt and the lock screen's unlock field stay masked
2026-10-05 Firmware: shake-to-wake — a deliberate hard shake wakes the UI like a button press (docs/SHAKE_WAKE_DESIGN.md)
    LIS3DH moves to 25 Hz low-power, ±4 g, high-pass on both interrupt generators; generator 1
    stays the motion detector (256 mg, feeds location tracking and the attentive rail window),
    generator 2 (1152 mg, high events, duration 0) is routed onto the same INT1 pin. Firmware
    classifies a shake from latched generator-2 samples: >= 6 within a chain whose gaps are
    <= 250 ms and whose span is >= 400 ms (host-tested in test_accel_rate.c), then 3 s cooldown;
    a rejected candidate takes generator 2 off the pin for 10 s so jogging cannot storm the wake.
    The 20 s motion refractory now clears o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
2026-10-05 Firmware: a shake opens a 15 s hot keyboard window (nothing drawn until a key); motion wakes no longer open the attentive window
    Owner decisions 5 Oct 2026 ~2:15 am: the cost of a wake treated as input is the 119 s
    no-sleep window (~1.3 mAh), not the e-ink refresh. A shake now arms PAGER_UI_HOT_S (15 s):
    keyboard polled at 100 ms, rail on, no render; the first decoded key promotes it to the full
    PAGER_UI_AWAKE_S window and the ordinary render path draws the screen (~0.2 mAh for an
    accidental shake, unchanged for shake-then-type). An EXT1 wake with only the LIS3DH bit is
    no longer input: it reports the motion edge (accel_poll -> loc) and returns to the 20 s
    cadence with the rail off (~0.002 m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
    [input.c, input.h, modes.c, test_input.c]
2026-10-05 Firmware: a character typed on the idle Locked screen opens the passcode entry (shake -> type -> Enter needs no button; reverses the 24 Sep Do #6 rule)
    [scr_lock.c]
2026-10-05 Firmware: boot splash with live status — 'booting' as the first frame, then 'connecting' / 'registering' / 'attached' or 'no signal', replaced by Lock or Home when the main loop starts (owner, 5 Oct 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
    [modes.c, net.cpp, net.h, scr_greeting.c, ui.c, ui.h]
2026-10-05 Firmware: UI first after any ext1 wake (short yield, no probe wait; rail on at the accelerometer wake so the CardKB boots during shake classification) and mode-change status publishes deferred until 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
    [modes.c]
2026-10-05 Firmware: no rail pulse on a motion-only wake (it cycled the CardKB and lost keys while typing; the rail comes on only on a confirmed shake or the button)
2026-10-05 Firmware: status-bar sleep indicator — a drawn sleeping-face icon when the loop enters the normal sleep cadence (one partial on entry), replaced on the next awake render by the ext1 wake count of tha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
    [gfx.c, gfx.h, modes.c, modes.h, ui.c]
2026-10-06 Firmware: modem initialised last in boot; NVS 'airplane mode' (Device screen row, console airplane on|off|status, next boot) holds the modem in reset (IO45) and gates every network entry point, so a 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
    [loc.c, loc.h, main.c, modes.c, net.cpp, net.h, pins.h, scr_device.c]
2026-10-06 Firmware (debug console): i2cscan accel scans the LIS3DH bus (I2C_NUM_1, IO5/IO4); acceltest and the boot log report the WHO_AM_I I2C error (NACK vs timeout) for wire-vs-wedge triage
    [accel.c, accel.h, main.c]
2026-10-06 Firmware: shake defaults from the 6 Oct bench calibration (THS2 384 mg, n 6, gap 500 ms, span 300 ms, no holdoff — reliable on a repaired LIS3DH lead; running is a documented false positive); airplan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
2026-10-06 Firmware: airplane icon in the status bar's link slot while airplane mode is on (owner, 6 Oct 2026)
2026-10-06 Firmware: sleep indicator drawn as a ZZ glyph (owner: 💤) instead of the sleeping face
2026-10-06 Firmware: IO8 wake button retired (PAGER_WAKE_BUTTON_ENABLED 0): pad left unconfigured, FSM idle, IO8 out of the ext1 mask, hold handling gone; the shake + first key replaces it (owner, 6 Oct 2026). 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
    [input.c, modes.c, net.cpp, pins.h]
2026-10-06 Firmware: sleep indicator shows ZZ only while asleep; the wake count no longer replaces it on the glass (owner, 6 Oct 2026)
    [ui.c]
2026-10-06 Firmware: 'Reboot' row on the Device screen (owner, 6 Oct 2026): with the IO8 button retired it is the only way to restart short of pulling power, and airplane mode takes effect at the next boot
    [scr_device.c]
2026-10-06 Web: chat renders by origin — a message the relay stored with originBackendKind "pager" is the pager's even when its senderUid is the signed-in user (the owner's device and browser share one uid), wi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
2026-10-06 Firmware: address-book pull gives up after 3 failed tries per nudge (was a 60 s retry forever, ~6 mAh/h during a relay outage); the hourly status carries the book version and the relay re-nudges, so 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
    [bookpull.c, bookpull.h, test_bookpull.c]
2026-10-06 Web: Address book page (Settings; admins pick whose book to edit; nickname dialog; Not-on-pager chips) and New chat as a search-as-you-type select over the user's book (docs/ADDRESS_BOOK_DESIGN.md). 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
2026-10-06 Relay: address book API — GET /api/book?uid= (computed: family members, approved people, externals, groups; sendable flag + reason; pagerCap 32 + truncated), PUT/DELETE /api/book/{owner}/entries/{pee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
    Behaviour change: pager and New chat now list only entries the policy lets the user message
    (family members count as approved; one-way edges and externals under `people` drop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
    [book.py, devcfg.py, main.py, routing.py, test_admin.py, test_book.py, test_family_router.py, test_rules.py]
2026-10-06 Relay: an explicit deny edge (message:false) beats the family-implied approval in both the send check and the address book; admin_deny in the test client now stores the deny instead of deleting the e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
    [book.py, pager_client.py, routing.py, test_book.py]
2026-10-06 Web: contact-request card per kind (SMS contact vs link, one-click Approve), delivery chips say where a message went, 'Sign-in phone' labels with a pointer to Contacts, family Rename control, externa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
2026-10-06 Relay: contact requests from the pager — digits-only ph is always a phone (10 → +1…), bad/blocked/unknown requests are rejected with one system reply, approval never creates a person (phone → the fam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
2026-10-06 Infra + tools: OTA firmware bucket module (public-read objects by image hash, publisher grant, relay env vars) and tools/fwpub.py (zlib full + bsdiff deltas vs the last 3 releases, manifest + index; 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
2026-10-06 Web: Devices page firmware column, OTA job state, and 'Update firmware' dialog listing builds with delta/full byte estimates against the 10 MB monthly target (docs/OTA_DESIGN.md). Needs the relay OTA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
2026-10-06 Relay: OTA — GET /api/admin/firmware (builds from the bucket index with delta/full estimates per device), POST /api/admin/devices/{id}/ota (push a signed cfg.ota to the pager or cancel; 409 unless th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
    [config.py, devcfg.py, firmware.py, ingest.py, test_admin.py, test_firmware.py, test_wire.py, wire.py]
2026-10-06 Web: Battery card on /devices/[id] (voltage + min-mV chart with GNSS/OTA floors, stacked awake-by-cause, refresh table, modelled mAh/day with editable currents labelled uncalibrated, CSV export) and 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
2026-10-06 Firmware: OTA — signed cfg.ota job, HTTPS GET from the modem socket with Range resume and the modem last-byte-on-newline detection (walter-modem patch 1.22), ROM-inflater zlib full images and detools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
2026-10-06 Docs: PROTOCOL.md edits from the address-book, contact-request, OTA and battery-stats designs (cfg.ota, /status keys 62-68, bs counters, book-bump triggers, retry cap; bs is CBOR-only to stay under 6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
2026-10-06 Relay: battery stats — /status key 68 bs counters stored as devices/{id}/battery samples (90-day retention sweep), GET /api/devices/{id}/battery?since&until, super PUT /api/admin/battery-models/{id} 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
2026-10-06 Firmware: battery stats — /status key 68 bs (12 counters: window, wall/sleep/awake s by cause, sleeps, accel wakes, rail-on s, refresh counts, min mV, reconnects, modem-state s, radio events) in a 92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
    [battstat.c, battstat.h, cbor.c, cbor.h, main.c, modes.c, net.cpp, net.h]
2026-10-06 Hosting: rewrite /devices/** to the exported /devices/_.html, same as /chat/** — the device detail page (and its new Battery card) 404ed in production (owner, 7 Oct 2026)
2026-10-06 OTA: relay refuses a target equal to the running image with normalised id matching (409 'already running that build') and never picks a delta whose base is the target; dialog shows 'Running: <version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
2026-10-06 Firmware: PAGER_OTA_TEST_ABORT bench hook (abort() in app_main) for the OTA rollback test; verified on proto3: delta dl → ready → install → panic → bootloader rollback → beta-68 reports ota_st rb (7 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
2026-10-06 Web: Family → Contacts crashed on load ('Cannot read properties of undefined (reading map)') — the page expected {contacts: [...]} but GET /api/family/contacts returns a bare list (as the relay tests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
2026-10-06 No relay SMS: Twilio removed; SMS contacts are modem-only, policy-implied, picked from Contacts (owner, 7 Oct 2026)
    Owner: "remove the entire Twilio backend as well as SMS in the contact. The contact should either be an
    in-system user, or it is an SMS entry that uses the phone's SMS"; "With Anyone, this should not require an
    approval. The default policy should be allow"; "the Approved List also should be in sync with Contacts".
    Relay: sms_twilio adapter, notify/sms, /webhooks/twilio/sms, the `sms` backend kind, verify codes,
    phoneIndex, families.smsNumber and the Twilio mock deleted (old sms backend rows are skipped on read).
    A message to or from an external is refused (`sms_contact`): page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
    [alerts.py, book.py, config.py, devcfg.py, e2e_v2.py, ingest.py, jobs.py]
2026-10-06 Infra: an empty relay_image keeps the image Cloud Run is serving (data source), so a local terraform apply never rolls the relay back — the owner's local apply with relay_image=:latest (a weeks-old d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
2026-10-06 SMS audit trail: malformed sms_log uploads are stored flagged, and the pager's modem texts show in the contact's chat thread (owner, 7 Oct 2026)
    Relay: a signature-verified /up that does not decode (bytes contain "sms_log") or an sms_log that decodes
    with invalid fields is stored at devices/{id}/smsLog as {malformed:true, reason, rawHex, best-effort
    peer/dir/st/id}, id bad_<sha256[:12]> so retries do not duplicate; GET /api/devices/{id}/sms-log rows
    carry malformed/reason/rawHex (nullable dir/peer/st/body). 1090 tests pass. Background: the owner's
    first modem text (12:00 PDT) was dropped as "malformed" by the rolled-back relay image; "try2" at
    12:13 was stored fine by the current image.
    Web: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
2026-10-06 Web: /settings/notifications on Chrome for Android — permission state is re-read on focus/visibility/permission change (it was read once at mount, so unblocking in site settings left 'Send test notif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
2026-10-06 Firmware: e-ink refresh policy — Enter/newline are partial; full refreshes only at idle gaps, transitions, pre-sleep and a ceiling (owner, 7 Oct 2026). NOT bench-tested.
    Partial updates fade existing black (noticeable ~6 keystrokes, usable far longer); the per-Enter full
    refresh was intrusive. New pure-C refreshpol.c (host-tested, 29 suites): dirty counter of partials since
    the last full; FLOOR 20 → full at the first 6 s gap without a key, or at a whole-screen transition
    (send / screen switch); pre-sleep full only when dirty >= PRESLEEP_MIN 6 (idle clock-tick wakes never
    flash); CEILING 60 → full at the next 1.5 s key gap, never mid-burst. Old hard-coded full-every-20
    cadence (disp_ref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
2026-10-07 Firmware: refresh policy defaults tightened — floor 8, idle 4 s, ceiling 24, pre-sleep 3 (owner: 'greying is too extreme'); host test pins its knobs so defaults can be retuned on the glass. beta-78, 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
    [refreshpol.h, test_refreshpol.c]
2026-10-07 Web: Firmware chip reads 'Update available: <version>' / 'Up to date' against the newest published build (it only showed the last job's 'Updated'); super users get 'Update firmware…' on the family De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
2026-10-07 Firmware: host-written partial LUT (WF_PARTIAL_2IN9) is the default partial waveform — the OTP partial bleaches every pixel per keystroke (owner: unreadable by the 6th key on beta-78); the host LUT d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
2026-10-07 Firmware: host partial LUT confirmed on the glass ('it no longer greys', beta-80) — TP0A 10 → 7 frames (PAGER_LUT_TP0A, NVS disp/tp0a, `disptest tp0a [N]`, patched at LUT write) to claw back keystrok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
    [disp.c, disp.h, main.c, refreshpol.h]
2026-10-08 Hardware: right header rewired 8 Oct 2026 (owner) -- wake button hardware removed (IO8 / pin 23 free); LIS3DH moved to SCL IO18 / SDA IO17 / INT1 IO16 (pins 22/21/20). pins.h, README header map and t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
2026-10-08 Device config: disable GNSS per device (owner, 8 Oct 2026) -- `cfg.loc` (CFG key 5) `{gnss: bool}` pushed like cfg.wifi; firmware persists NVS loc/gnss, never calls net_gnss_*() while off (every atte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
    [cfg.c, cfg.h, devcfg.py, ingest.py, loc.c, loc.h, main.c, modes.c]
2026-10-08 Relay: locate contention fallback waits longer for the winner (CI flake on a26e2f9) -- test_locate_concurrent_claims_produce_exactly_one_loc_req failed on a slow CI emulator with 3/8 threads re-raisi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
    [location.py]
2026-10-08 Relay SMS: one Twilio number per user; pager<->SMS through the relay; unknown senders held for parent approval (owner, 8 Oct 2026)
    Reverses 123efa4 (7 Oct "no relay SMS") for members who hold a relay number; the modem cfg.sms path
    still serves members without one. Design: docs/RELAY_SMS_DESIGN.md. Firmware unchanged (scr_pick
    lists book t:"sms" entries, then the modem list; a numbered member gets an empty cfg.sms).
    Relay: users.smsNumber (E.164, persons only, reverse index smsNumbers/{e164} with create(), 409 on
    reuse) set via PATCH /api/family/members/{uid} or /api/admin/users/{uid}; externals carry an `sms`
    backend row (live only on externals, stale person rows ignored); routing allows pe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
    [alerts.py, book.py, devcfg.py, e2e_v2.py, ingest.py, jobs.py, routing.py, test_alerts.py]
2026-10-08 Web: Battery card buckets and ticks in the viewer's local time (owner, 8 Oct 2026) -- bucketAwake floored to multiples of 86400 s, i.e. UTC midnight, so "per day" bars ran 17:00-17:00 Pacific and the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
2026-10-08 Relay: PUT /approved replaces the member's people edges too (owner report, 8 Oct 2026) -- "Save approved list" only took one change per save: the web sends only checked people and the handler left un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
    [test_family_router.py]
2026-10-08 Relay/web: Soracom Beam bearer, server side (owner decision, 8 Oct 2026) -- a pager on a Soracom SIM will speak plain MQTT to beam.soracom.io:1883 and Beam opens the MQTTS leg to EMQX with pass-throu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
2026-10-08 Docs: Soracom direct bearer verified on the bench (8 Oct 2026) -- SORACOM_DESIGN §6 gains the results of steps B/C/D on the sora1 unit: AT+CGAUTH PAP accepted, roaming registration on 310410 (AT&T, L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
2026-10-09 Docs: Soracom Beam bearer verified on the bench (8 Oct 2026, step E) -- SORACOM_DESIGN §6 E: tools/soracom_beam.py ran live with the owner's key (group pager-beam, SoracomBeam entry accepted with the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
    [soracom_beam.py]
2026-10-09 Docs: sweep for the v1.1.0 release (8 Oct 2026) -- README Status rewritten from the v0.2 text to what runs today (v1.0.0 + v1.1.0, pages into a sleeping pager proven, Soracom direct/Beam numbers, ope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
2026-10-09 Docs: proposal for relay SMS across many Twilio accounts (owner ask, 8 Oct 2026) -- twilioAccounts registry keyed by AccountSid with per-account token in Secret Manager (relay SA scoped by IAM condit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
2026-10-09 Relay SMS: consent, keywords, disclosure and defang (owner spec, 8 Oct 2026)
    The relay now owns opt-in/opt-out for the Twilio number (Twilio Advanced
    Opt-Out must be OFF on the Messaging Service, or STOP/START/HELP never reach
    the webhook). docs/RELAY_SMS_DESIGN.md decision 11, tasks in
    docs/RELAY_SMS_CONSENT_TASKS.md.
    - app/sms_compliance.py: welcome / opt-out / help texts (operator name and
    support email from SMS_OPERATOR_NAME / SMS_SUPPORT_EMAIL, defaults
    reproduce the spec byte for byte), keyword() (START/OPTIN/IN,
    STOP/UNSUBSCRIBE/END/QUIT, HELP/INFO/SUPPORT; trimmed, case-insensitive,
    exact), relay_body() -> `<Name> says: "<text>" - Pager (<operator>)`,
    defang() (space after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
2026-10-09 Docs: bridge phone design + tasks (owner direction, 8-9 Oct 2026) -- a headless sideloaded Android phone per member: its SIM carries that member's SMS instead of Twilio (no 10DLC), its notifications 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
2026-10-09 Docs: bridge phone O1 revised -- Voice-only bridge texts through Google Voice (owner, 9 Oct 2026); voiceNumber becomes the member's smsNumber when there is no SIM, get_by_sms_number matches either fi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
2026-10-09 Web: bridge phone W1 — types, API helpers, delivery chips
    Types for BridgeRow, BridgeConversationRow, ChatTabOut and SubscribeRequest;
    web/lib/bridges.ts wraps every B5/B6 route (all through familyQuery(), reads
    included, since bridge docs are server-only per decision 1) and ports the
    relay's slug_nick for roster nicks (decision 7). outboundBlocksPeople() encodes
    design O5 (sms/any_sms outbound codes have a 'none' people rule). Voice number
    is a top-level BridgeRow field per the revised O1. DeliveryChips: bridge kind
    reads 'waiting for the phone' / 'sent on Google Chat'. AlertCard gets the
    chat_unknown icon/label so the AlertKind switch stays exhaustive.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
2026-10-09 Web: bridge phone W2 — Family Devices: Bridge phones section
    BridgePhonesSection below the devices table polls GET /api/family/bridges every
    10 s (bridge docs are server-only, decision 1). Add bridge phone (member +
    label) opens BridgePairPanel: 8-digit code, 10-minute countdown, the decision-13
    phone checklist, live paired state. Rows show Google account, SIM and Voice
    numbers (both optional and editable via PATCH {simNumber?, voiceNumber?}, O1
    revised 9 Oct 2026), a Voice only chip when there is no SIM, the member's
    relay-derived SMS number, last seen in red past 15 min, battery, listener/SMS
    app/accessibility chips, tier-2 count; actions New code (unpaired), Numbers,
    Accept SIM (when th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
2026-10-09 Web: bridge phone W3 — /family/chat page and Subscribe dialog
    /family/chat?uid= (linked from the member drawer as 'Google Chat…' and the
    Family menu; static export, member from the query string like /settings/book)
    polls GET /api/family/members/{uid}/chat every 5 s: Subscribed table (Not on
    pager chip past the 32 cap, Paused, Read only; Rename / Edit roster / Pause /
    Unsubscribe), Seen, not subscribed (Subscribe, Ignore, Show ignored) and Add
    by link (finds the member's paired bridge, POST inspect, polls the list every
    3 s for 30 s, opens the dialog on the row with that link). ChatSubscribeDialog
    validates the pager name with book.nickError (16 cp / 48 B, same as the address
    book), roste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
2026-10-09 Web: bridge phone W5 — address book chips, New chat, README checklist
    Address book rows with entry.chat show a Google Chat / Google Voice chip and
    no @alias subtitle. NewChatDialog lists a sendable chat external without the
    SMS-number requirement (it rides the bridge, not the relay number) and only
    shows the phone icon for real numbers. web/README.md gains checklist row 27
    covering W2-W4.
2026-10-09 Relay: bridge phone B1 — bridges store, pairing, bridge auth
    Design decisions 1-3 and O1 (revised: SIM, Voice number, or both; the
    owner's smsNumber is simNumber else voiceNumber), O2 (heartbeat answers
    {pending}). POST /bridge/pair with the per-IP and global limiters,
    POST /bridge/heartbeat with the SIM-changed check, expired pair-code sweep.
2026-10-09 Android: bridge phone app A1-A7 (docs/BRIDGE_PHONE_DESIGN.md, 9 Oct 2026) -- sideloaded Kotlin app (app.kidpager.bridge, minSdk 26, targetSdk 35, AGP 8.7.3, Views+ViewBinding, Room, WorkManager, OkHt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
2026-10-09 Relay: bridge phone B2 — outbox, bridge backend kind, Twilio transport switch
    Design decisions 4, 7 (backend row), 11, O1 (revised: transport switch
    matches SIM or Voice number; gvoice items carry to.link), O2 (outbox
    wait=N via asyncio.sleep, heartbeat {pending}), O3 (welcome text skipped
    for a bridge number). Tick fails 24 h pending rows and skips ob_ deliveries
    (also filtered out of the queued scan); sweep deletes acked rows after 7 d.
    POST /api/me/backends refuses kind bridge. Changed test: test_internal sweep
    result gained bridge keys.
    [jobs.py, test_bridge_outbox.py, test_internal.py]
2026-10-09 Relay: bridge phone B3 — shared inbound text core, bridge sms/gvoice events
    Design decision 5 (sms and gvoice bullets), O1 (revised: gvoice needs
    caps.gvoice, the Voice thread is recorded per member as config.voiceConv).
    handle_text() is the Twilio handler from the blocked step on; the Twilio
    path is unchanged (it records no channel). POST /bridge/events with the
    bounds as pydantic constraints, the 120/min per-bridge limiter, per-event
    INFO lines. gchat events answer dropped_unsupported until B4.
2026-10-09 Relay: bridge phone B4 — Chat conversations, held chat, chat_unknown alert
    Design decisions 5 (gchat bullet), 6, 8. bridgeConversations rows keyed by
    sha256(conversationId)[:16], heldChat rows with the live wire id, one open
    chat_unknown alert per (bridge, conversation) with the push body
    '<title> (<sender>) -> @kid: <text>', 25-per-conversation held cap and
    50-new-conversations-per-day cap, ignored/paused drop with nothing stored,
    inspect events only upsert the row. Dismiss marks held rows dismissed, block
    and approve are 400 for the kind. Sweep deletes heldChat by receivedAt.
    Subscribed rows are held until B5 wires delivery.
2026-10-09 Relay: bridge phone B5 — subscribe, ignore, patch, unsubscribe; routing and policy
    Design decisions 7, 9, 10 (+ O5 out-policy forces read-only, O8 one router
    file). chat_subscribe.py: slug_nick, subscribe (external + bridge backend +
    group doc + edge + row subscribed + book bump + backlog + alert decided),
    deliver_subscribed with title following, ignore, patch (rename, canReply,
    paused, roster), unsubscribe. Routing: sender_alias, bridge externals in
    group fan-out, no_bridge, canReply -> not_allowed; policy reads a chat
    external as a person peer; ingest 'bridge not set up; ask your admin'; a
    bridge group refuses member add/leave (409). Book lists chat externals
    (t:chat) and bridge groups (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
2026-10-09 Relay: bridge phone B6 — family bridges API and server-only rules
    Design decisions 1-3, 15, O1 (revised: PATCH {simNumber?, voiceNumber?} with
    the smsNumber rule SIM else Voice and 409 on a number held elsewhere), O8.
    GET/POST /api/family/bridges, POST .../{id}/code, PATCH .../{id} (label,
    reassign, numbers), POST .../{id}/accept-sim, DELETE .../{id} (unpair: fail
    pending outbox rows and their deliveries, clear the owner's number, keep
    contacts and conversations). A second bridge never takes a number over from
    another bridge of the same owner. Rules: no match block for the bridge
    collections, pinned by test_bridge_collections_are_default_deny.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
    [bridge_numbers.py, test_family_bridges.py, test_rules.py]
2026-10-09 Relay: bridge phone B7 — bridge phone simulator and compose service
    Design decision 14, O1 (revised: /_pair takes simNumber/voiceNumber, null for
    none, so a Voice-only phone can be simulated), O2 (the sim polls with wait,
    the real phone does not). tools/bridge_sim.py: BridgeSim (pair, events,
    outbox poll + ack, heartbeat; stdlib only), BridgeSimClient for the e2e,
    and a FastAPI control plane on :8020. Compose service bridge-sim next to
    twilio-mock; relay depends_on it.
2026-10-09 Relay: bridge phone B8 — end-to-end bridge scenarios
    Design decision 14, O1 (revised). tools/e2e_v2.py 'bridge': pair (SIM + Voice
    number) -> SMS from an unknown number held -> approve -> pager reply in the
    outbox, acked sent, delivery sent -> Voice text is the same contact and the
    next reply goes out on gvoice -> unknown Chat group held behind one
    chat_unknown alert -> subscribe delivers the backlog with sndr -> pager reply
    carries conversationId and link -> inspect by link -> ignore drops.
    'bridge_voice': a Voice-only bridge (smsNumber = Voice number, cold outbound
    on gvoice with to.link). pager_client gains the family bridge/chat helpers.
    bridge_sim.py drops 'from __future__ import anno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
2026-10-09 Relay: bridge phone B9 — README pointer and .env.example note
    Design decision 13 (phone setup lives in D1's runbook), no new secrets: a
    'Bridge phones' subsection under Message backends and a note in
    .env.example that bridges need no environment variables.
2026-10-09 Web: bridge phone W6 — reconcile with relay shapes
    Checked against relay/app/routers/family_bridges.py: BridgeOut/ConversationOut
    types mirror the pydantic models (ownerAlias/ownerName, required paired and
    voiceNumber, roster as [{name,nick}], inspectedAt, canReply/onPager/alias on
    subscribed rows, SubscribeOut with delivered/undelivered/conversation).
    GET /bridges is a bare array (envelope fallback dropped); timestamps are ISO
    strings only (epoch branch dropped). Number edits send "" to clear. Add by
    link uses the tab response's bridges list instead of listing all bridges. The
    Unpair/New code logic keys off paired. onPager false (not null) marks Not on
    pager. A group conversation with a b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
2026-10-09 Docs: bridge phone sweep (9 Oct 2026) -- status, roadmap, runbook, traps, PROTOCOL note
    Written from what landed (relay B1-B9 f9649f2..1bc22f4, web W1-W5 7f3c4fc..927a11c,
    Android A1-A7 714b2c0). On 9 Oct 2026 the relay suite passed (1316 tests) and
    `tools/e2e_v2.py bridge bridge_voice` passed.
    - README Status and docs/ROADMAP.md "Bridge phones": what is built, and the open items
    (app never run on a phone, Firebase Android registration as an owner step, Voice number
    detection, MMS media, multi-account Chat, dual SIM, conversation-id rule, direct boot,
    heartbeat alert). Twilio removal and O6 are listed for the owner.
    - relay/README.md "Bridge phones": runbook replacing the B9 pointer (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
2026-10-09 Android: bridge phone A8 — review fixes (9 Oct 2026)
    - SmsReceiver / MmsReceiver: onReceive ran a synchronous Room insert on the main thread
    (AppDb has no allowMainThreadQueries), so every inbound SMS/MMS threw and the text was
    lost. Receivers now goAsync() and spool through EventQueue.enqueueAsync on the IO scope,
    finishing the pending result afterwards; MmsReceiver.event is the pure PDU -> event step
    with its own test; class headers say onReceive must stay off Room.
    - AckTracker / OutboxWorker: a DONE entry whose ack kept failing was never purged and its id
    was skipped by begin() forever, so a relay-reissued item was never dispatched again in the
    process. Acks are retried at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
2026-10-09 Relay: bridge phone B10 — review fixes (9 Oct 2026)
    1. Reassign (PATCH ownerUid) unsubscribes every subscribed/paused conversation
    (same path as DELETE .../{ref}), dismisses what was held, moves the
    remaining rows to the new owner, fails the old owner's pending outbox rows
    and deliveries (reassigned), clears the old owner's number; response
    carries unsubscribed: n. Works away from a disabled owner.
    2. Heartbeat status is a typed model (422 on a bad type, accounts <=10 x 120,
    version <=40, error accepted and ignored); bridges_store reads a row that
    fails validation as unpaired instead of raising.
    3. The phone-reported SMS bit is kept (status.smsCapable, from pair caps.sms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
    [bridge_numbers.py, chat_subscribe.py, jobs.py, routing.py, test_bridge_review.py, test_chat_subscribe.py]
2026-10-09 Docs: bridge phone cross-references (9 Oct 2026) -- SERVER_PLAN §6.5/D4 answered (personal accounts: Chat API is Workspace-only, bridge phone supersedes gchat for them), RELAY_SMS_DESIGN notes the br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
2026-10-09 Twilio removed again (owner, 9 Oct 2026) -- SMS is bridge-phone only; last Twilio commit 05ec3ed
    Relay: Twilio client, webhook + signature check, consent keywords/welcome
    (sms_compliance, sms_consent), tick retry loop and TWILIO_* config removed;
    app/backends/sms_twilio.py -> app/backends/sms.py (SmsBackend, bridge
    transport only; non-bridge numbers fail no_bridge); text helpers in
    app/sms_text.py; smsNumber no longer admin-settable (bridge-owned via
    bridge_numbers). Held-until-approved inbound, sms_unknown alerts,
    smsNumber index and t:"sms" cfg stay. Tests 1334 -> 1268; e2e 13 scenarios
    (relay_sms dropped, twilio-mock gone from compose).
    Infra: Twilio secrets, relay env wiring, enable_sms_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
    [cellgeo.py, chat_subscribe.py, e2e_v2.py, inbound_text.py, jobs.py, routing.py, sms_text.py, test_bridge_outbox.py]
2026-10-09 WhatsApp on the bridge phone, both tiers (owner, 9 Oct 2026) -- A9, B11, W7, D3
    Third bridge source `whatsapp` (docs/BRIDGE_PHONE_DESIGN.md WA1-WA9).
    Relay: caps.whatsapp (pair caps / heartbeat status.whatsapp), DMs phone-keyed
    through the held/approve text path with via:whatsapp and the JID in the conv
    slot, groups through the Chat seen/held/subscribe flow, outbox DM
    {phone, conversationId, link wa.me} and group {conversationId, title},
    backend channel choice + cap fallback, inspect 400 for WhatsApp links;
    held rows now store via/conv and approval records the channel (Voice too).
    Simulator + e2e `bridge_whatsapp` (14 scenarios); 1291 tests.
    Android: WhatsApp (+Business) listener, JID phone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
2026-10-09 Firmware: CardKB scan on its own task; main-loop polling deleted (owner, 9 Oct 2026)
    Owner: keys typed in a fast burst were lost (first + last of ~8 survived)
    because the CardKB holds one key and the main loop blocks for up to
    seconds (wake status refresh, publish-quiet gate, modem servicing).
    Owner ruled out keeping the main-loop poll: "do not keep the code with
    keyboard polling in the mainloop."
    ui.c: `kbd` task, prio 2 on CPU1, 10 ms poll while the keyboard rail is
    on and past the 1300 ms boot guard (esp_timer clock), blocks on a rail
    notification when off; one bus mutex shared by read/release/restore/
    reinit and the light-sleep park (net.cpp, around esp_light_sleep_start
    only); console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
2026-10-10 Relay: bridge numbers unique across families; channel record transactional (owner, 9 Oct 2026) -- B12
    Cross-family entanglement review fixes:
    - POST /bridge/pair now runs the same number-taken check as the family
    edit/accept paths, before the pair code is consumed (new read-only
    bridges_store.peek_pair_code), so a conflict is a 409 and the code
    survives. A number held by any member or any other bridge is refused,
    including a same-family sibling (old test expecting pair to succeed and
    record the error replaced).
    - bridges_store.get_by_sms_number(prefer_owner=) picks the bridge whose
    owner is the sender when pre-fix data holds duplicates; SmsBackend and
    apply_numbers pass the own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
    [bridge_numbers.py, inbound_text.py, test_bridge_entanglement.py, test_bridge_pair.py]
2026-10-10 Firmware: kbd task floats and wakes the main loop; wake status refresh after first draw (owner, 9 Oct 2026)
    - input.c: push_event() notifies the main task after a successful enqueue;
    input_wait_event(100) replaces the fixed 100 ms vTaskDelay in the awake
    loop, returning at once when an event is queued. Idle period unchanged.
    - net_sleep() parks the kbd task first and returns false (no sleep, no
    wake/RTS state touched) if the input queue is non-empty; modes_run()
    re-arms the awake window and goes back to the loop top.
    - ui_wake_status_refresh() (two modem round trips, 5 s timeouts) no longer
    runs ahead of the first frame after wake: the awake edge sets a pending
    flag and the refre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
    [input.c, input.h, modes.c, net.cpp, net.h, rail.c, ui.c, ui.h]
2026-10-10 OTA: on-demand deltas generated by the relay, cached under fw-cache/ for 7 days (owner, 9 Oct 2026) -- D12
    Relay: on an admin push, when the device runs an older *published* build
    with no pre-published delta, firmware.delta_on_demand() fetches both full
    images from the bucket, verifies them against the index, builds the same
    detools sequential patch tools/fwpub.py makes (0.08 s for a 1.36 MB image),
    round-trips it, and uploads fw-cache/<target16>/from-<base16>.dz with
    if_generation_match=0 and psz/osha/base/img metadata. A public HEAD finds
    an existing object first; a 412 on upload uses the winner's object. Any
    failure or a 60 s budget overrun logs and pushes the full image. The
    preview endp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
    [config.py, firmware.py, test_firmware.py, test_firmware_delta_cache.py]
2026-10-10 Soracom SIM enrolment from the admin UI (owner, 9 Oct 2026) -- relay, infra, web
    Relay: app/soracom.py holds the Soracom API client and the group/Beam/set_group
    calls that tools/soracom_beam.py made (the tool is now a thin CLI over it).
    Super-admin routes: GET /api/admin/soracom/sims (lists the account's SIMs with
    their Beam-group enrolment; configured:false when no key), POST
    /api/admin/soracom/sims/{imsi}/enrol (ensures the pager-beam group with the
    Beam MQTT entry point, sets the SIM's group), POST /api/admin/soracom/enrol-all.
    Settings SORACOM_AUTH_KEY_ID / SORACOM_AUTH_KEY / SORACOM_BEAM_GROUP /
    SORACOM_BEAM_DESTINATION. MSISDN never returned; key redacted from errors;
    httpx request log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
    [config.py, logging_config.py, soracom.py, soracom_beam.py, test_soracom_admin.py]
2026-10-10 Web: family admins can push firmware -- FirmwareUpdateDialog/useNewestBuild take an admin|family scope; /family/devices and /devices/[id] use /api/family/firmware and /api/family/devices/{id}/ota (ow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
2026-10-10 Web: responsive layout for phones (owner, 9 Oct 2026) -- hamburger Drawer below md, full-screen dialogs on xs, scrolling tables with low-priority columns hidden below md, dvh chat thread height, wrap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
2026-10-10 Relay: family admins get full device control -- /api/family/firmware, /devices/{id}/ota, /apn-presets, /devices/{id}/apn mirror the super routes with the in-family check (owner, 9 Oct 2026); OTA_DESI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
2026-10-10 Web: device label is the name, id is a caption -- add-device dialogs drop the id field (relay issues it), pencil-edit label dialog on device tables and device page via PATCH /{admin,family}/devices/{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
2026-10-10 Web: bridge pairing checklist in the app README's order (permissions before Pair), shows the relay URL to type (9 Oct 2026)
2026-10-10 bridge-android: first-run fixes -- pair shows the relay's 409/422 detail, a 4xx event batch is dropped instead of blocking the queue, Relay URL defaults to BuildConfig.DEFAULT_RELAY_URL (kid-pager.we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
2026-10-10 bridge-android: default relay URL is the canonical https://kidpager.sps-by-the-numbers.com (owner, 9 Oct 2026)
2026-10-10 Relay: device ids are machine-issued (pgr- + 8 hex, collision-checked) and label is editable via PATCH /{admin,family}/devices/{id} (1..32 bytes; pager picks it up at the next rotate) (owner, 9 Oct 2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
    [device_ids.py, pager_client.py, provision.py, test_device_ids.py]
2026-10-10 tools/e2e_v2: take the issued device id from the create response (ids are relay-issued since 248702e)
    [e2e_v2.py]
2026-10-10 Bridge: heartbeat re-derives caps.gchat from listenerBound (a phone paired before notification access no longer drops Chat events forever); Hosting rewrites /bridge/** to the relay so the phone uses 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
    [test_bridge_chat_events.py]
2026-10-10 Web: refresh the FCM push token on every load when permission is already granted -- tokens went stale because only the Enable button ever registered one (found on the first real alert push, 9 Oct 202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
2026-10-10 ADDRESS_BOOK_DESIGN: contact rename does propagate (cfg.sms rederive; book bump for relay-number owners) -- stale gap note replaced, test asserts the cfg.sms push (10 Oct 2026)
    [test_book.py]
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2026-10-10 Relay: WhatsApp DMs ride the Google Chat path keyed by conversation id (LID or phone JID); dropped_bad_conv for malformed ids; WhatsApp is no longer an SMS 'via' channel (BRIDGE_WHATSAPP_LID_DESIGN /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
    [inbound_text.py, sms_text.py, test_whatsapp.py]
2026-10-10 Relay: address book adds anyone, delivery is policy (BOOK_ADD_ANYONE B1-B4, owner decision 10 Oct 2026) -- add creates the contact + owner marker, p[] retired, refused send to an added entry replies 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
    [alerts.py, book.py, devcfg.py, firebase_test_utils.py, ingest.py, test_alerts.py, test_book.py, test_cleanup_orphans.py]
2026-10-10 Hosting: /chat/view/** rewrite before the /chat/** catch-all (the admin monitor view rendered as a thread with alias 'view'); firmware: battery ceiling 5000 mV (USB rail ~4.5 V was rejected and the 3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
    [battstat.c, modes.c, modes.h]
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2026-10-10 docs: TASK_ulp_keyboard_eval -- ULP I2C keyboard polling evaluated (pins IO9/IO10 do not qualify for RTC I2C, 544 B RTC slow mem left, rail dominates); recommend shortening the awake window first (10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
2026-10-11 Relay: an online /status with no ota_t/ota_st clears the stored OTA group (otaTarget/State/Pct/Err) -- the device holds no job (PROTOCOL §5.1), so a cancelled download no longer sticks at "Downloadin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
    update_status() merged only non-None fields, so fields the device stopped
    sending kept their last value forever. update_status(clear=...) deletes the
    named fields when absent.
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2026-10-14 PINGREQ handoff + scratch/keepalive-probe (ESP-IDF probe + Orange Pi MQTTS capture broker): the Sequans sent PINGREQ every ~60 s at keepalive 60 under eDRX + light sleep on Soracom direct (11 Oct 202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
2026-10-15 PINGREQ probe results + docs: the Sequans sends PINGREQ at any keepalive; AT&T's NAT drops idle flows between 240 and 360 s (pings at 60/240, silent black-holed flow at 360 x2 and 480, no RST, no URC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
2026-10-15 Firmware: per-carrier MQTT keepalive/liveness ping (Soracom 1200/840 s, others 480/240 s, was 300 s ping past AT&T's NAT cut); accel recovery ladder -- a failed INT1_SRC read still steps the shake de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
2026-10-15 mkassets: --lang sc renders the real GB2312 (6763) + Big5 level 1 (5401) hanzi from the stdlib codecs instead of the first 6763 codepoints from U+4E00 (which stopped at U+6749 and missed 57 % of GB23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
2026-10-17 Remove Wi-Fi as a feature (owner, 16 Oct 2026): firmware drops wifi_sta/wificred/wifi_policy/xport_wifi, the wifi/wifisleeptest console commands and the Wi-Fi/lwip/esp-tls/mqtt components (debug buil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
2026-10-17 hardware/carrier: route both boards (Freerouting via pcbnew DSN/SES), DRC-fix pass -- NC-pin nets, 1.7 mm Walter pads, edge keep-outs, courtyard and BOM-attribute sync; panel fully routed (silk warni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
2026-10-17 hardware/carrier: front light is the GDEY029T94-FL03 (6-pin flex -> FH34SRJ-6S on the panel board, anode/cathode over a 10-way SH cable, 33R 1206 + Q4 PWM drive replaces the NSI45020), front-light bu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
2026-10-19 Manually review and fix carrier board schematic
    The initial product of clause was mostly okay electrically
    but impossible to read. This is a fully redone version
    that has all circuits reverified with some modifications.
2026-10-19 Fix some small errors and clean up BOM
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2026-10-21 Replace JP1 with 0402 0R link, shrink SW1/SW2 to KMR2 and MSK12C02
    JP1 (solder jumper) becomes R39, a fitted 0402 0R on the auto-boot line:
    pull it to disable auto boot. SW1 is now a C&K KMR221GLFS (4.2 x 2.8 x
    1.3 mm, C72443) and SW2 a Shou Han MSK12C02 top-knob slide switch
    (C431540). Footprints swapped in the PCB with nets preserved (SW1 pads
    now carry FL_BTN/GND). Adds the JLCPCB design rules file.
2026-10-21 Carrier board v0.1: fully routed, DRC clean against JLCPCB rules
    Fable cleaned up the initial hand-placed design: closed the outline,
    placed the switches, charger and remaining passives, routed every net
    (GND as pours plus stitching vias) and brought the board to zero DRC
    errors against pager-carrier.kicad_dru. Only the parked test points
    remain unconnected.
2026-10-22 Carrier v0.2c WIP: 2-layer re-layout, full Walter width, headers on the right edge
    Work in progress, not DRC-complete. The board is re-laid out on the real tin
    geometry measured from the owner's assembly STEP (inner corner R13.2 at
    (81.69, 69.35); walls y 56.1/113.3) instead of the estimated R19 arc:
    - Outline x 74.3..115, y 57.4..108.4, stepped at the WiFi keepout line (106.3)
    over the Walter; SIM notch replaced by a 2 mm pin-eject hole at (86.25, 93.2).
    - All six cable headers face +X on the right edge (J2, J1, J7, J3, J4, J5).
    - USB bridge (U1/U2), auto-reset cluster and BRG_3V3 caps on the bottom
    inside the Walter shadow; U2 below U1 so its TXD/RXD pads face U1's.
    - Hand-routed 2-la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
2026-10-22 Carrier v0.2c WIP: cassette screw holes, top-actuated SW2, wider board, panel schematic fixes
    Work in progress for the 3D-printed display cassette; routing is DRC-clean
    (0 errors) with 14 signal links and 3 ground islands left for hand finishing
    (list in HANDOFF-v0.2.md).
    Carrier:
    - H1-H3 M2 cassette screw holes (2.2 mm NPTH, 4.5 mm copper-free annulus on
    both layers via footprint rule areas + per-hole DRC rules) at (77.4, 60.9),
    (111.2, 59.95), (111.2, 105.85); schematic symbols in the core sheet.
    - SW2 power switch -> C&K JS102011SAQN top-actuated SPDT (LCSC C221660),
    travel along X; top strip is now J6, SW1, SW2 (x 80.0..108.5).
    - Board widened to x 120.5 so the right-side holes fi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
2026-10-22 Carrier: USB-C model upright again, refill pours, owner's VBUS_DET tracks to 0.127 mm
    The regenerated board had lost the -90 X rotation on the GCT USB-C model
    (an in-place model edit through the Python API does not persist), so the
    exported STEP showed the port lying down. Pours refilled after the owner's
    test-point and VBUS_DET edits; ten 0.1 mm segments widened to the JLC
    minimum. DRC: 0 errors, 18 open links left for hand finishing.
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2026-10-22 Carrier: top-biased re-route (via cost 20, B.Cu trace cost x2.2), Freerouting variant 17 (15 open signal links, was 18)
    Six trials with Freerouting biased toward F.Cu and cheaper vias (pre-route base rebuilt from
    the owner's board, so the test points and the hand-routed VBUS_DET are kept
    as fixed items). Best variant installed; 0 DRC errors; remaining open links
    are listed in HANDOFF-v0.2.md for hand finishing. STEP re-exported.
2026-10-22 Carrier: prune redundant GND vias (pads already on the pour), morning summary in the handoff
    Each GND via with only short stubs to pads that the pour already touches was
    removed one at a time and kept only if the connectivity count did not grow.
    DRC 0 errors; open links unchanged.
2026-10-22 Carrier: grid-repair the test-point links the router skipped, stitch pour islands (unconnected 20 -> 9)
    The routing copy still detached test-point pads (a rule from when they were
    parked off-board), so TP7-TP11 were never routed; pipeline fixed, the links
    closed with the grid repair, a zero-length stub cleaned, pour islands
    stitched. DRC 0 errors.
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2026-10-22 Carrier: three JLC-sized netclasses for the hand layout (Default 0.15, PWR 0.4, PWR_MED 0.25; via 0.5/0.3)
    - Default: 0.15 mm track / 0.15 mm clearance (JLC 2-layer floor is 0.127/0.127)
    - PWR (USB -> charger -> SYS -> switch -> Walter VIN, battery): 0.4 mm
    VBUS, Net-(U5-IN), SYS, SYS_SW, VBAT
    - PWR_MED (frontlight, haptic, ext LED, buck switch node): 0.25 mm
    FL_P, FL_N, Net-(Q2-S), J3 haptic pair, 3V3_AWK, EXT_LED, Net-(J4-Pin_1), Net-(U7-SW)
    - One via for everything: 0.5 mm / 0.3 mm drill (JLC 2-layer minimum), replacing 0.6/0.3;
    board min via diameter 0.5, annular 0.1; width list 0.15/0.2/0.25/0.4
    - DRC on the current board: 0 errors, 9 unconnected (unchanged)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
2026-10-22 Carrier: battery connector J7 -> JST SH SM02B-SRSS-TB (LCSC C160402)
    Replaces the 5.5 mm JST PH S2B-PH-SM4-TB, which sat above the display glass back.
    SH side-entry is 2.9 mm tall and matches J3/J4/J5. Schematic fields, board footprint
    (KiCad library model), VBAT stub re-hooked, pours refilled. ERC 0, DRC 0 errors,
    9 unconnected (unchanged). STEP re-exported. Handoff notes the J2 MPN/footprint mismatch.
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2026-10-24 Carrier: close the outline, tidy silkscreen, add GND pours (DRC 278 -> 28)
    - Edge.Cuts rebuilt as a single closed loop (right edge 113.15, SIM notch, 1 mm corners)
    - 0402/LGA parts moved to pager-carrier:*_NoSilk footprints (library copies without the
    silk outline), schematic fields updated; J6 silk box stops short of the shield pads;
    reference text re-placed or hidden; stale board texts removed
    - GND pours both layers (0.2 clearance, thermal reliefs), 3 stitching vias for the
    top-side GND groups that had no path to the plane; all GND connected
    - Remaining: 4 owner routing clearances, H1-H3 parked off-board, 2 unrouted nets
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2026-10-24 BOM: move six passives to JLC basic parts, fix connector LCSC codes (no footprint changes)
    Carrier: R32 2.2M -> 1M (C26083), C14 22nF -> 100nF (C1525), R1 22.1k -> 22k (C25768),
    R2 47.5k -> 47k (C25792); J1 LCSC C160407 (SM08B), J2 MPN/LCSC SM04B-SRSS-TB C160404
    to match its SH footprint.
    Panel: C11 4.7uF under basic code C19666, D1-D3 NSR0530 -> B5819W (C8598, SOD-123 as
    already on the board), R4 2.2R gets C22939.
    Board footprint fields updated to match. ERC clean on both.
2026-10-24 Panel: split the frontlight off the carrier cable (J2 -> 8-pin SH, new J5 2-pin), re-routed
    Schematic: J2 CARRIER is SM08B-SRSS-TB (C160407) on the same wires; new J5 FRONTLIGHT
    SM02B-SRSS-TB (C160402) takes FL_P (pin 1) and FL_N (pin 2), matching carrier J8.
    Board: J2 swapped with pins 1-8 in place, J5 at the bottom-left corner, R7 nudged,
    full Freerouting pass (0 unrouted), GND pours refilled.
    Known: 25 tracks below the 0.2 mm minimum width, J5 mounting pads 0.2 mm too close to
    the bottom edge; owner finishing by hand.
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2026-10-25 Panel: solder-jumper FL polarity, front-light ZIFs at the measured tail offsets
    - R1/R2/R3/R5 0R links replaced by JP1/JP2 (SolderJumper 3-pad, 1-2 bridged =
    straight, cut + bridge 2-3 = swapped); no BOM lines, zero height
    - J3 (FL03) at J1.x-15.5 in the edge row, J4 (Orient) at J1.x-10.8 one row inboard,
    both on J1's pad-24 side per the Good Display and Orient drawings (the 19 Oct
    placement had FL-A on the pin-1 side)
    - jumper block links only; FL_P/FL_N from J5 and the ZIF-to-jumper runs left unrouted
    - owner's in-progress hand placement otherwise untouched
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2026-10-25 v0.2 boards release candidate
    This has almost everything in both boards but we need
    a few part swaps.
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2026-10-26 Carrier: accelerometer -> MSKSEMI LIS2DW12TR-MS for Economic PCBA, JLC production files
    U4 ST LIS2DW12TR (C189624, JLC "Standard Only") -> MSKSEMI LIS2DW12TR-MS
    (C50385411, Economic and Standard). Same LGA-12 2x2 land pattern and pin-1
    corner, different pinout (new project symbol); owner rerouted U4. The part is
    an SC7A20-class die: WHO_AM_I 0x11, LIS3DH-style registers, I2C 0x18 with
    SDO/SA0 low. Firmware follow-ups: accept 0x11, set SDO_PU in reg 0x57.
    Also adds the ShouHan J6/SW2 footprints from the stock-part swap, the
    Fabrication Toolkit options and production outputs (carrier and panel), and
    the panel STEP. DRC 0 errors / 0 unconnected; ERC unchanged vs HEAD.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
2026-10-27 Panel: J1/J3 to SnapEDA FH34SRJ footprints (hold-downs at 2.5 mm, pin 1 per Hirose)
    JLC flagged J1/J3: the custom footprints put the MP pads at y=3.3
    (read the datasheet's 3.3 outer-edge span as centre-to-centre) and
    had pin 1 mirrored.
2026-10-27 Panel: J1/J3 paste + mask fixes, bottom GND test pad, regenerated JLC files
    SnapEDA FH34SRJ footprints had no F.Paste on the signal pads and a
    0.102 mm per-pad mask margin that merged every opening at 0.5 mm
    pitch (25 mask-bridge DRC errors). Signal pads now get paste
    (-0.025 margin, 0.25 mm wide per Hirose stencil) and use the board's
    0.05 mask margin.
    TP1: 1 mm GND pad on B.Cu (board-only) so B_Mask.gbs is not empty;
    JLC read the empty bottom mask as no solder mask.
2026-11-06 firmware: board variant layer for carrier v0.2 (autodetect by accel WHO_AM_I), UART0 console build
    board.c decides breadboard vs carrier v0.2 at boot from the accelerometer
    WHO_AM_I (0x33 LIS3DH breakout, 0x11 MSKSEMI LIS2DW12 clone), with an NVS
    override and the last good detection as fallback. On the carrier IO12/IO38/
    IO42 are no longer driven as display pins (they are FL_PWM and the charger
    status lines there). accel.c accepts the clone. sdkconfig.carrier builds a
    UART0-console image for the CP2102N port. Design and task notes in docs/.
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2026-11-06 firmware: carrier review fixes: no modem call before begin(), haptic alert waits for the rail bus, held light button is not an input wake, carrier-build default board, Setup-branch low-battery check
    Also: closed-loop OD_CLAMP form, SDO_PU read-modify-write, peripherals off before the RTS window, haptic standby never blocks the timer task, crate sign print. Note for the breadboard image: net_airplane_hold_modem now releases the IO45 pad hold before writing it (a latent airplane-mode bug), board_init adds one WHO_AM_I read at boot, and rail_init now runs after nvs_flash_init.
2026-11-06 firmware: drop modem-UART flow control before the shutdown restart (esp_restart hung on the dead CTS, RTC watchdog reset)
    Bench 6 Nov 2026: rst 0x10 (RTCWDT) before, rst 0xc (SW) on two runs after.
2026-11-07 Carrier: cost-reduction notes (4 Nov 2026) and ignore the carrier build dirs
    hardware/carrier/COST-REDUCTION-NOTES.md: exploration only, no schematic
    change; the Tier 2 swap table and the per-unit cost scenarios. .gitignore:
    firmware/build-carrier/ and firmware/build-carrier-dbg/ (the UART0-console
    images built with -B).
2026-11-07 Carrier: cost-reduction part swaps in the schematic (6 Nov 2026)
    Changes 1-8 from COST-REDUCTION-NOTES.md, schematic and footprint
    assignments only; the PCB is untouched and still needs an update from
    the schematic plus re-routing.
    - U7 TPS62840DLCR -> TPS62842DGRR (HVSSOP-8, C2873354), R38 267k -> 51k
    - U1 CP2102N -> CH343P (C2846043): VDD5 on VBUS with C1 10 uF 25 V 0805,
    V3 and VIO on BRG_3V3, VBUS sense direct (R1/R2/C2 removed), no RST
    (R3 removed), DTR/RTS to the UMH3N auto-reset as before
    - C6/C7 100 uF -> 22 uF 25 V 0805 (C45783)
    - R27 604R -> 620R (C4961), ISET 484 mA
    - SW1 KMR221GLFS -> TS-1187A-S16 (C42420254), pads 1-2 FL_BTN, 3-4 GND
    - Q2 SI1308EDL -> AO3400A SOT-23 (C20917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
2026-11-12 Carrier: layout in progress, H4 locating-pin NPTH, mounting holes removed, buzzer footprint
    - H4: board-only 1.10 mm NPTH at (111.55, 61.09) for the faceplate v2 locating pin
    - H1-H3 removed from the schematic (no longer used)
    - PKMCS0909E4000-R1 buzzer footprint + 3D model from EasyEDA
2026-11-12 Carrier: restore R/C/L values lost in 00604d1
    00604d1 ("Clean schematic...") reset the Value field of all 53 passives to the
    generic R/C/L in both sheets and the PCB. Restored from 5fc61fb; every part's
    LCSC number and footprint is unchanged since then. Value fields only.
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2026-11-13 fix pcb/sch uuid misalignment.
2026-11-13 Work through final DRC and silkscreen issues
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
