awong-dev/pager/(notices)

Notices in the files:
docs/DEVICE_PLAN.md:
changes one partition, not the firmware; an IME dictionary (§5.3) lands in the same partition. Licence: OFL 1.1, shipped alongside.
